epsa-team/Vulcanix-v1.0/SU - Suspension/SU_A1100 (Rear Upright Assy)/Photos/Montage 2.JPG

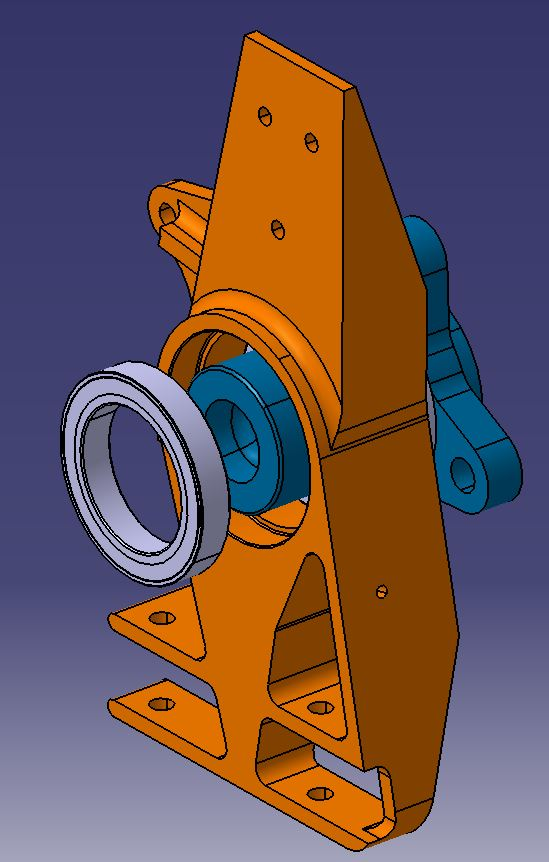
SU - Suspension/SU_A1100 (Rear Upright Assy)/Photos/Montage 2.JPG
