epsa-team/Vulcanix-v1.0/BR - Brake System/readme.txt

Déposez ici vos pièces.
Respectez la nomenclature !!!!!
