epsa-team/Vulcanix-v1.0/ZZ - Autres/Design event - Dossier Monoh/Support documents/Differential support.docx

DIFFERENTIAL

# Drive ratio

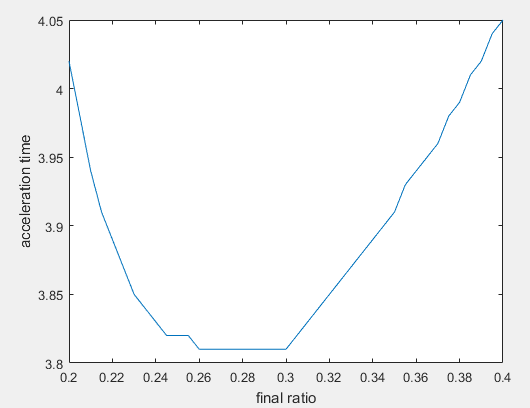
[picture p41: figure]

Figure 1: Acceleration model used to determine the optimum drive ratio

Optimum dive ratio: 0.2955 → Pinion: 13; Cog-Wheel: 44

# Dimensioning

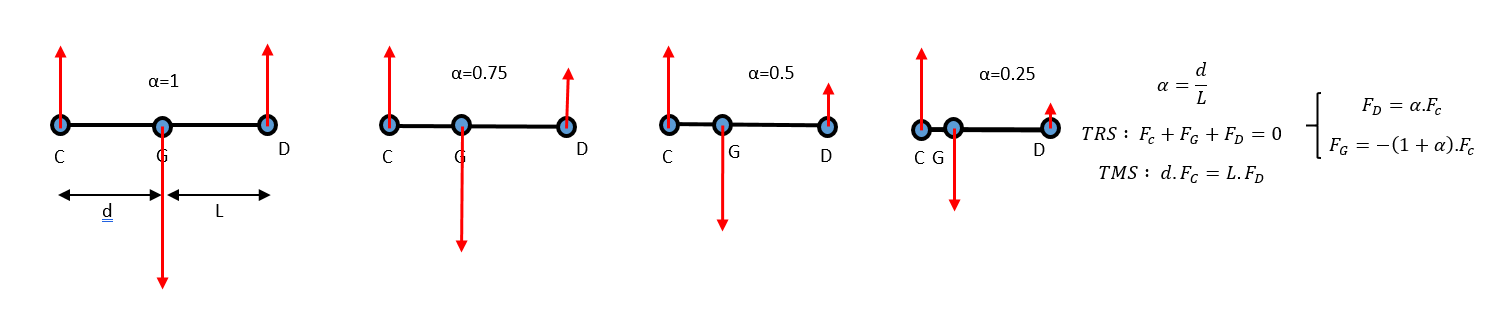
[picture p42: figure]

Figure 2: Influence of the position of the elements of the differential assembly

Load cases :

- Maximum torque load obtained through engine data: 59N.m, 28 000N on the gear.
- Car lift by the push bar

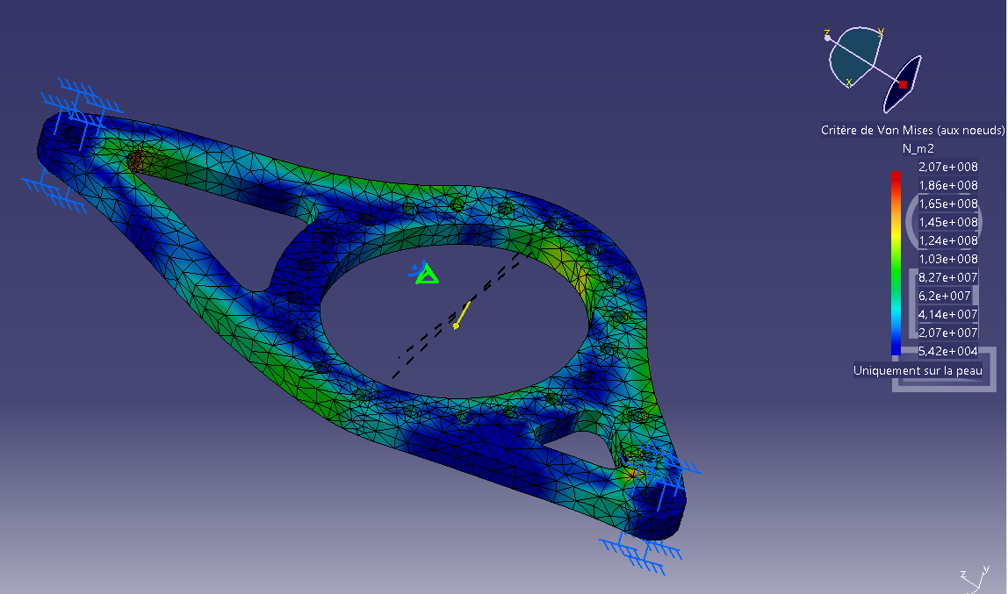
[picture p43: figure]

Figure 3: FEA on left eccentric housing

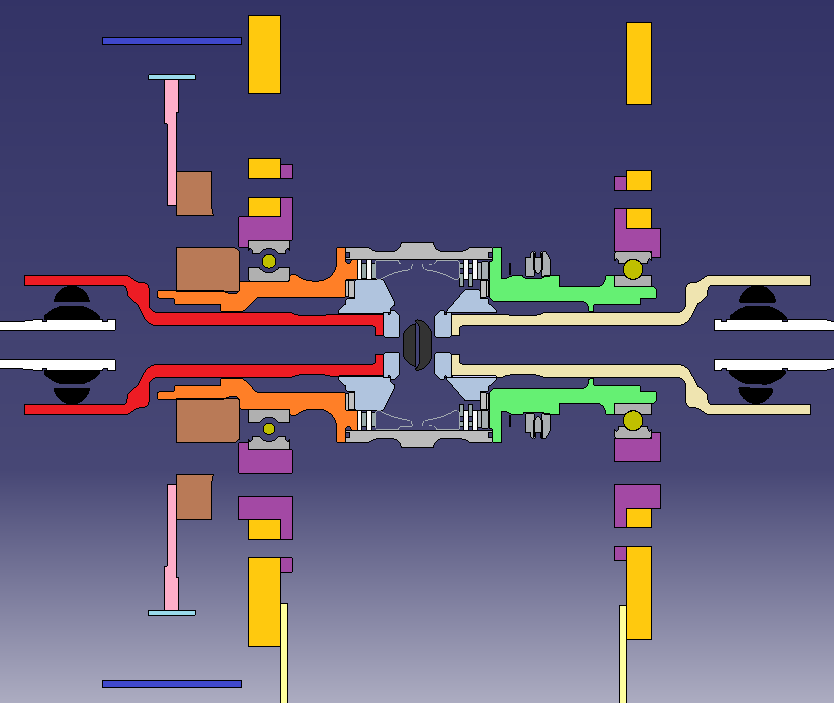
[picture p44: figure]

Figure 4: Section of the differential mounting

# Configurations

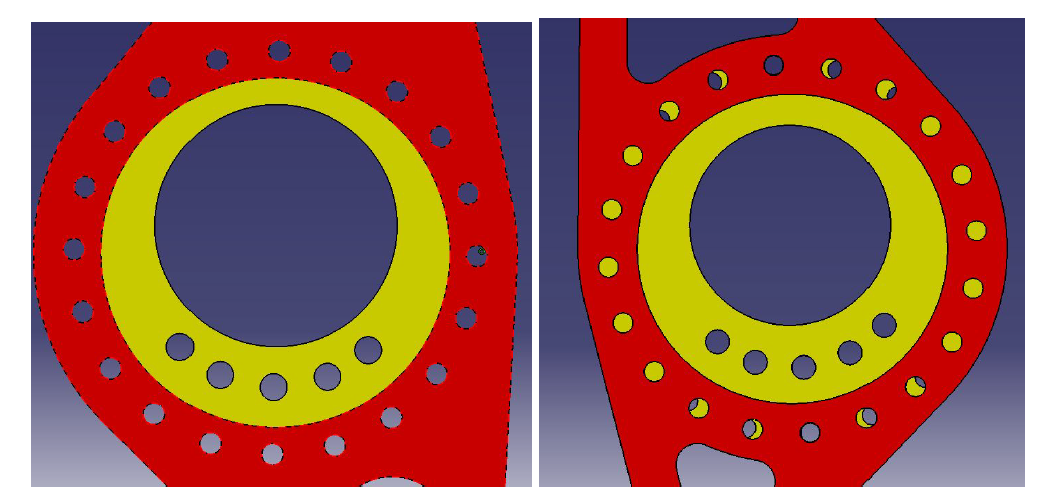
[picture p45: figure]

Figure 1: View of the eccentric in its housing

- This geometry offers 180 configurations

# Appendix

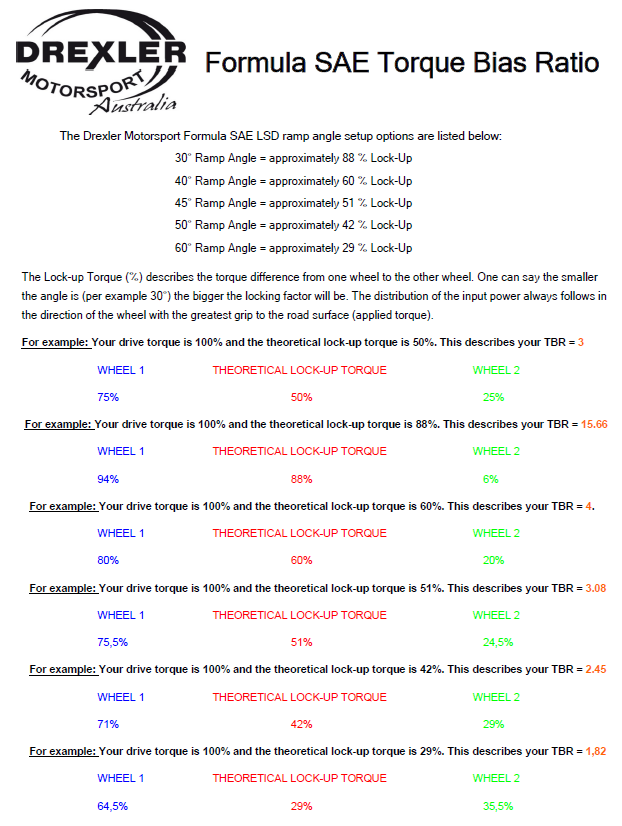
[picture p46: figure]
