epsa-team/Vulcanix-v1.0/ZZ - Autres/Design event - Dossier Monoh/Support documents/Wheel design Support.docx

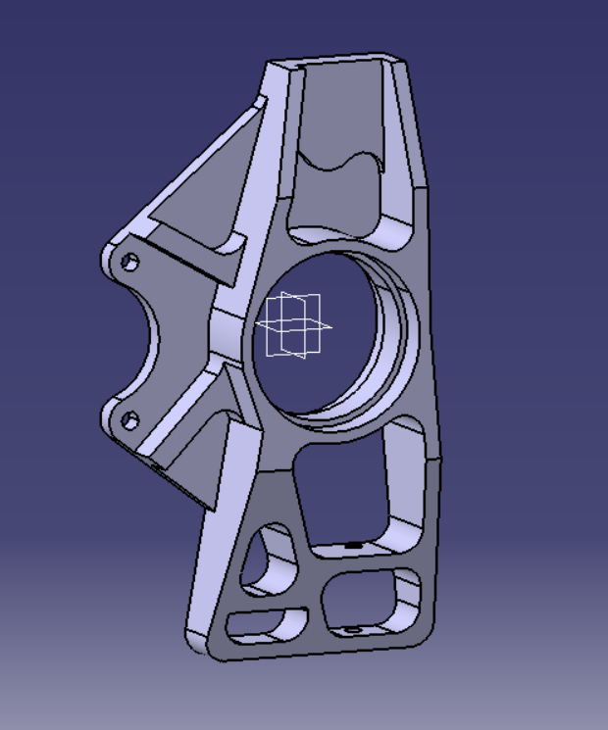
[picture p62: figure]

WHEEL DESIGN

Figure 1: Early design of the wheel assembly

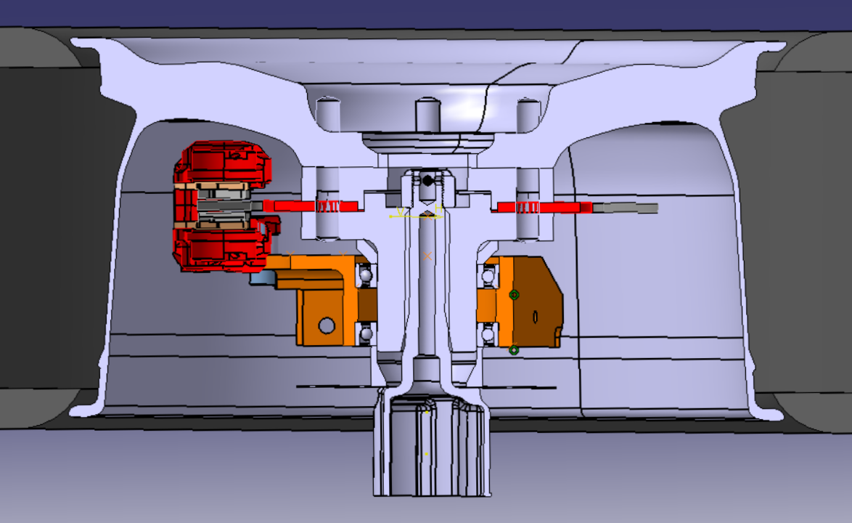
[picture p63: figure]
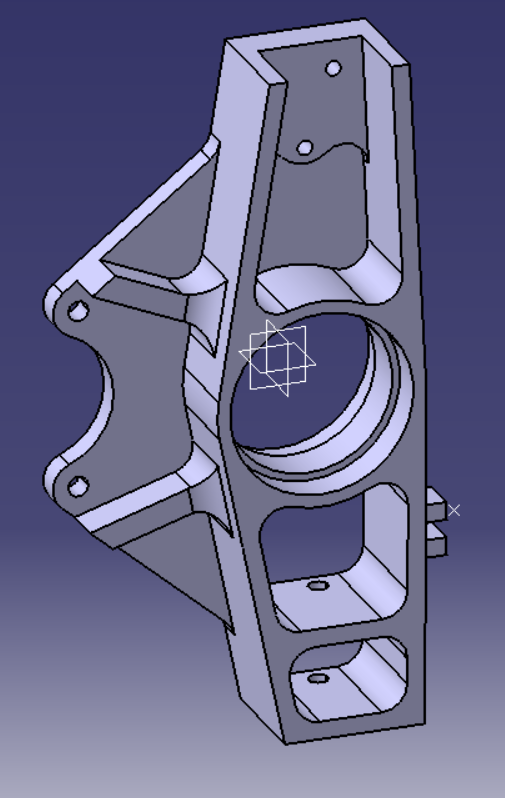
[picture p64: figure]
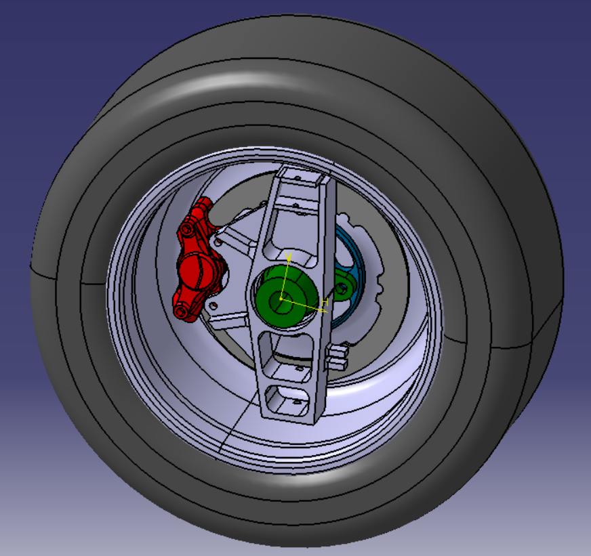
[picture p65: figure]
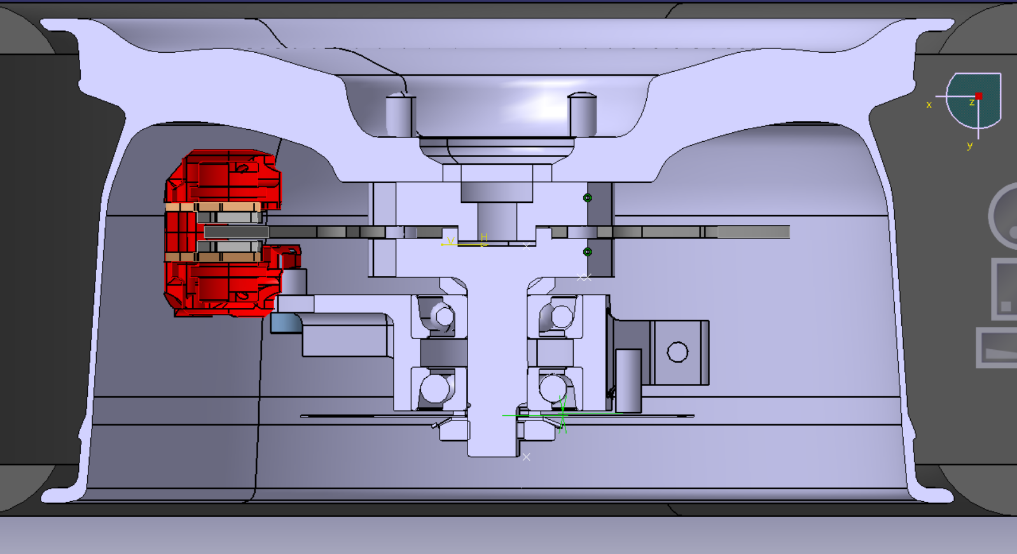
[picture p66: figure]
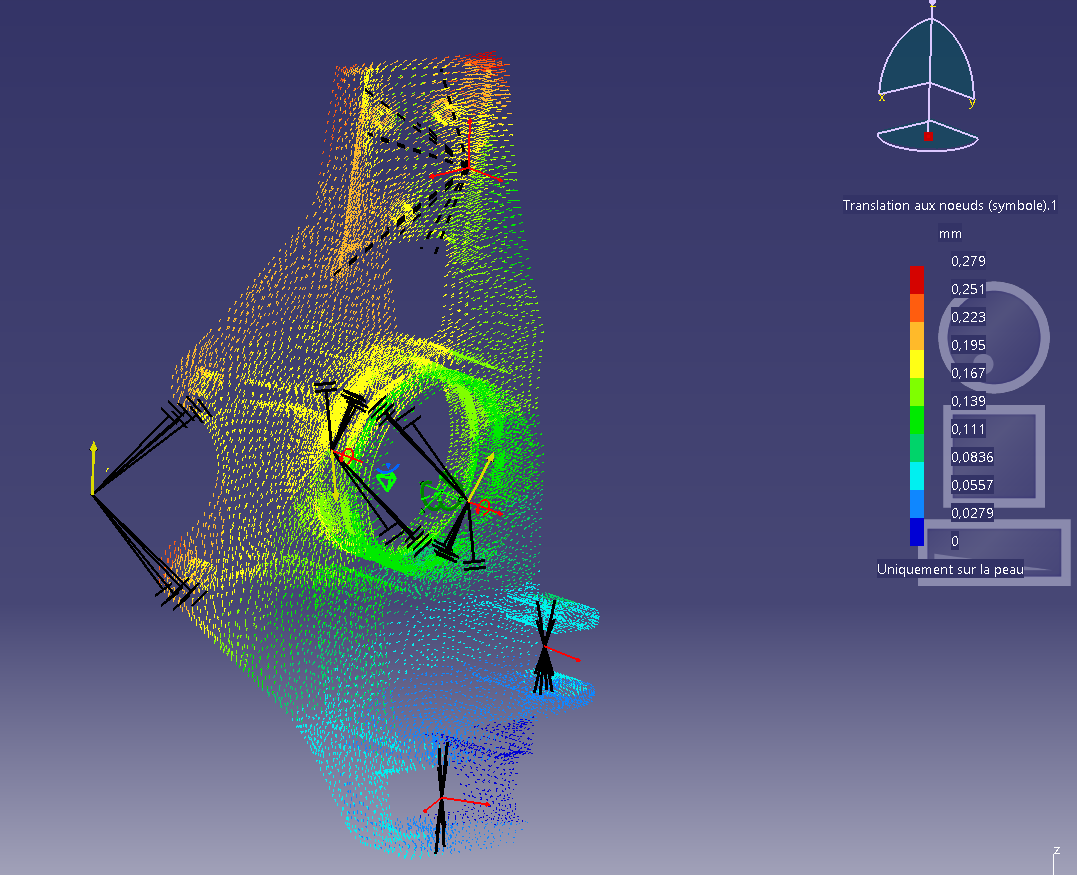
[picture p67: figure]

Figure 3: FEA analysis of front upright – 2G braking

Figure 2: Rear and front wheel section
