epsa-team/Vulcanix-v1.0/ZZ - Autres/Design event - Dossier Monoh/Support documents/Non font work/design-tires.docx

Tire study

1) Gui interface

The data from the TTC (tire test consortium) are studied thanks to a GUI interface:


2) Data treatment with 94” Pacejka formula

This offers more smooth datas, easier to use:
