epsa-team/Vulcanix-v1.0/ZZ - Autres/Design event - Dossier Monoh/Support documents/Non font work/transmission-secondaire-1.docx

Drexler limited slip differential

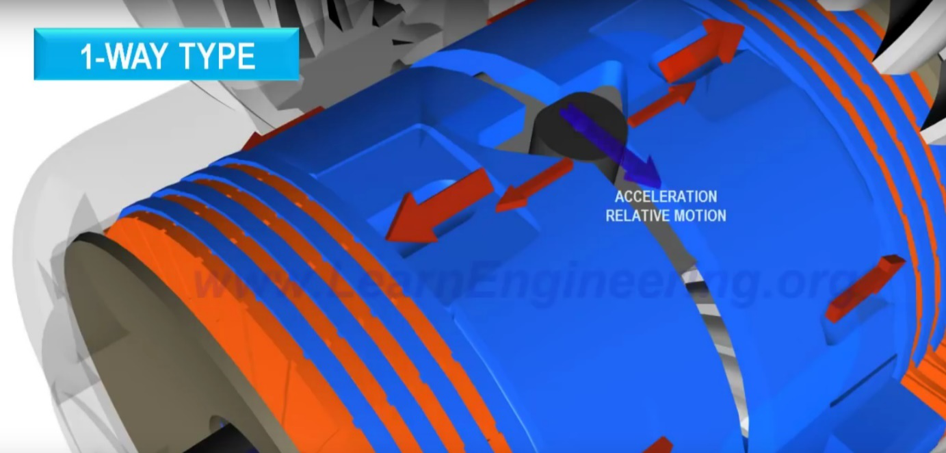
[picture p82: figure]

Efforts on Eccentric carriers

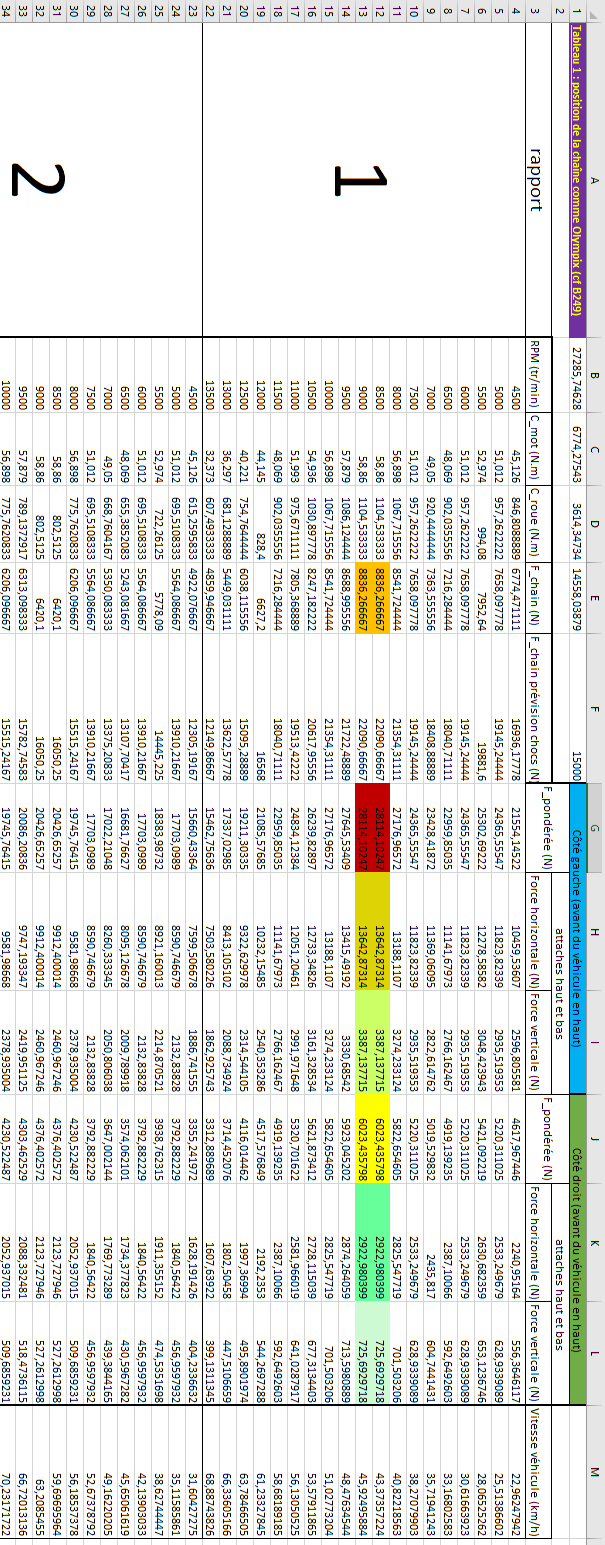
[picture p83: figure]
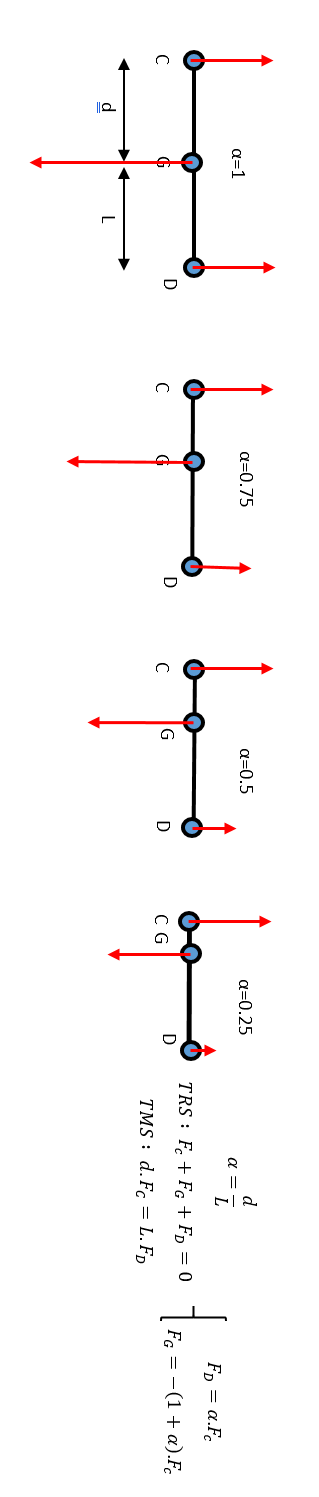
[picture p84: figure]

Finite Elements on left eccentric

Material : aluminium 2017 T4

Re = 260 MPa


Thickness : 14mm

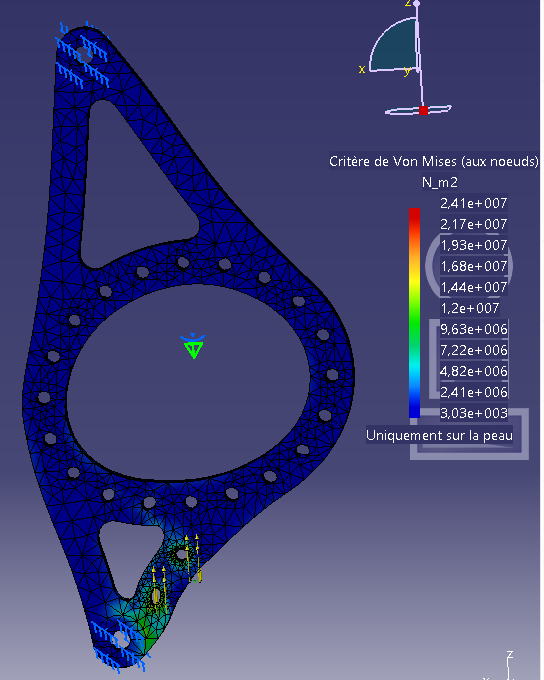
[picture p85: figure]

Carrying the car

Finite Elements on right eccentric

Material : aluminium 2017 T4

Re = 260 MPa

Thickness : 11mm

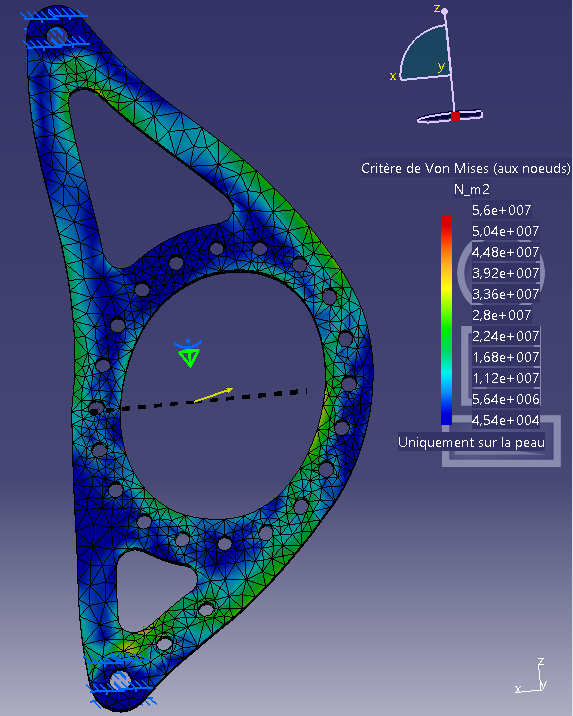
[picture p86: figure]
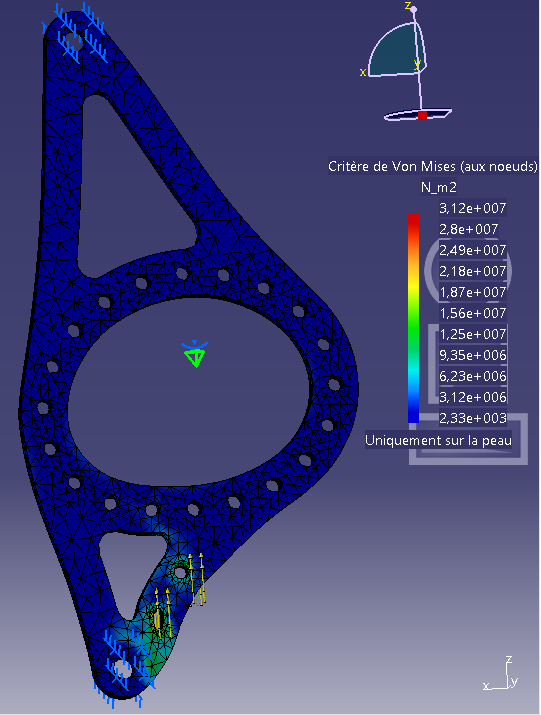
[picture p87: figure]

Carrying the car

Chain tension


Basic configuration Vulcanix configuration

N=(18*20)/(pgcd(18,20))=180

Pgcd (fr) = hcf (eng)

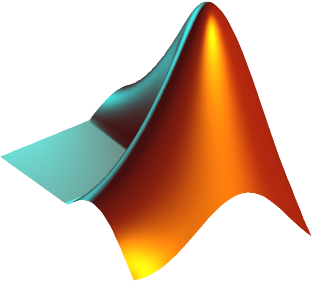
[picture p88: figure]
Résultat de recherche d'images pour "matlab logo"

Final Ratio


0.2955

FR = 13x44 → 0.2955

Axle shafts (length calculation)

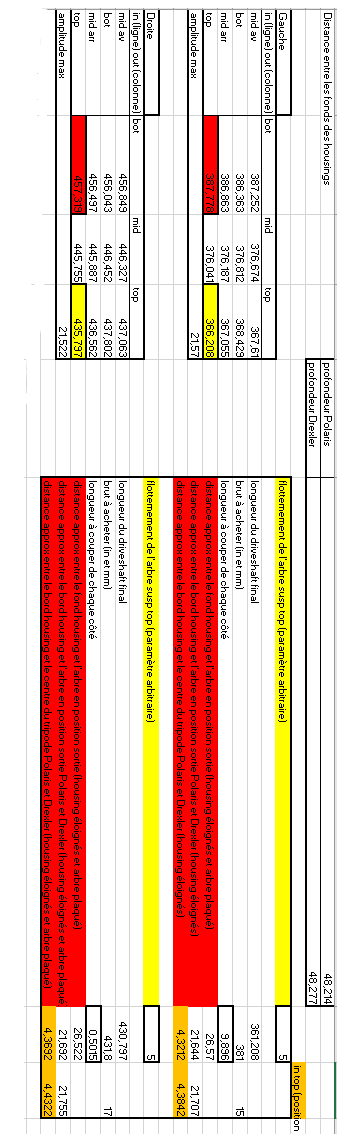
[picture p89: figure]

Axle shafts

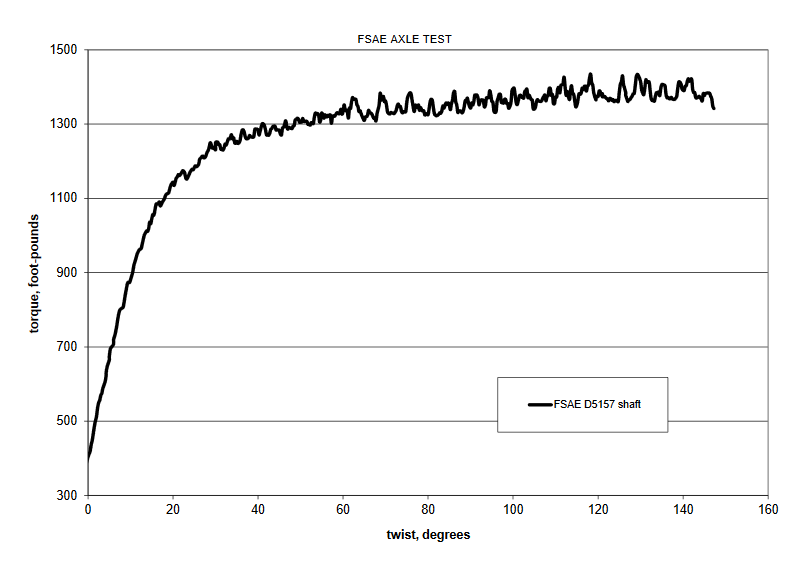
[picture p90: figure]

15in (left)

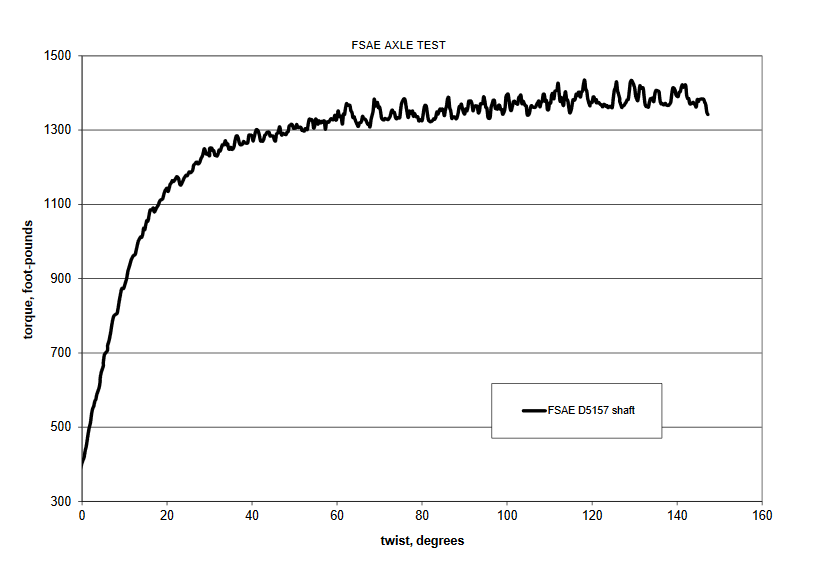
[picture p91: figure]

17in (right)

Left ball bearing (6011-2RS1)

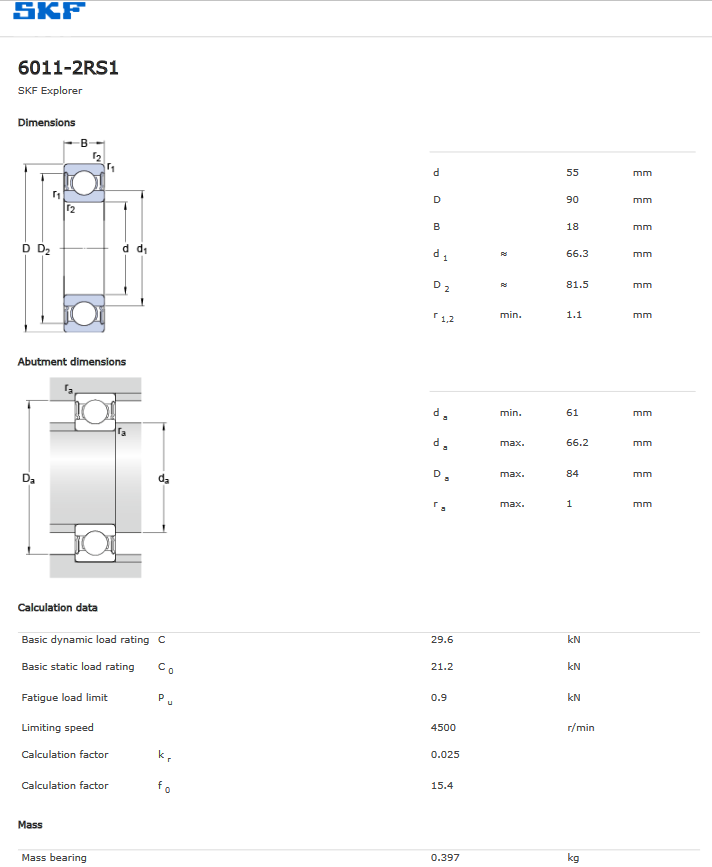
[picture p92: figure]

Right ball bearing (6010-2RS1)

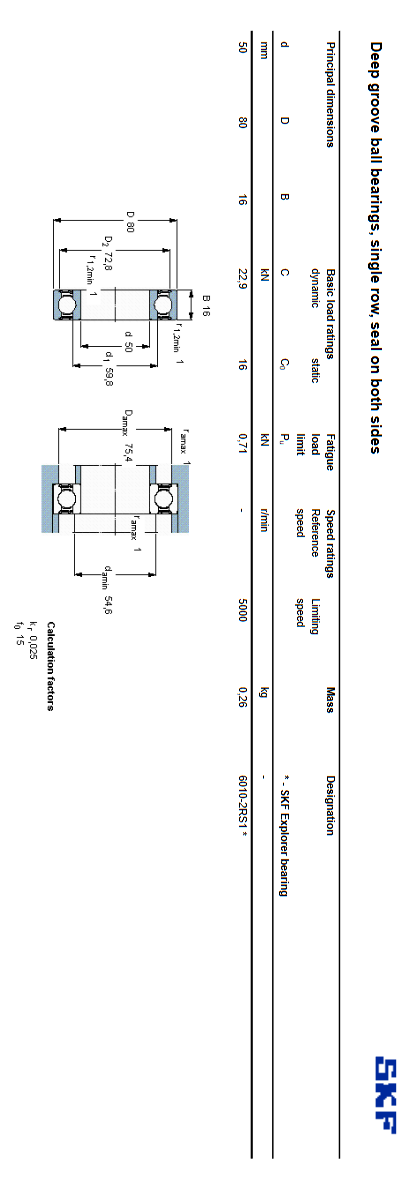
[picture p93: figure]

Sectional view
