epsa-team/Vulcanix-v1.0/ZZ - Autres/Design event - Dossier Monoh/Support documents/Differential support.pdf

## DIFFERENTIAL

## Drive ratio

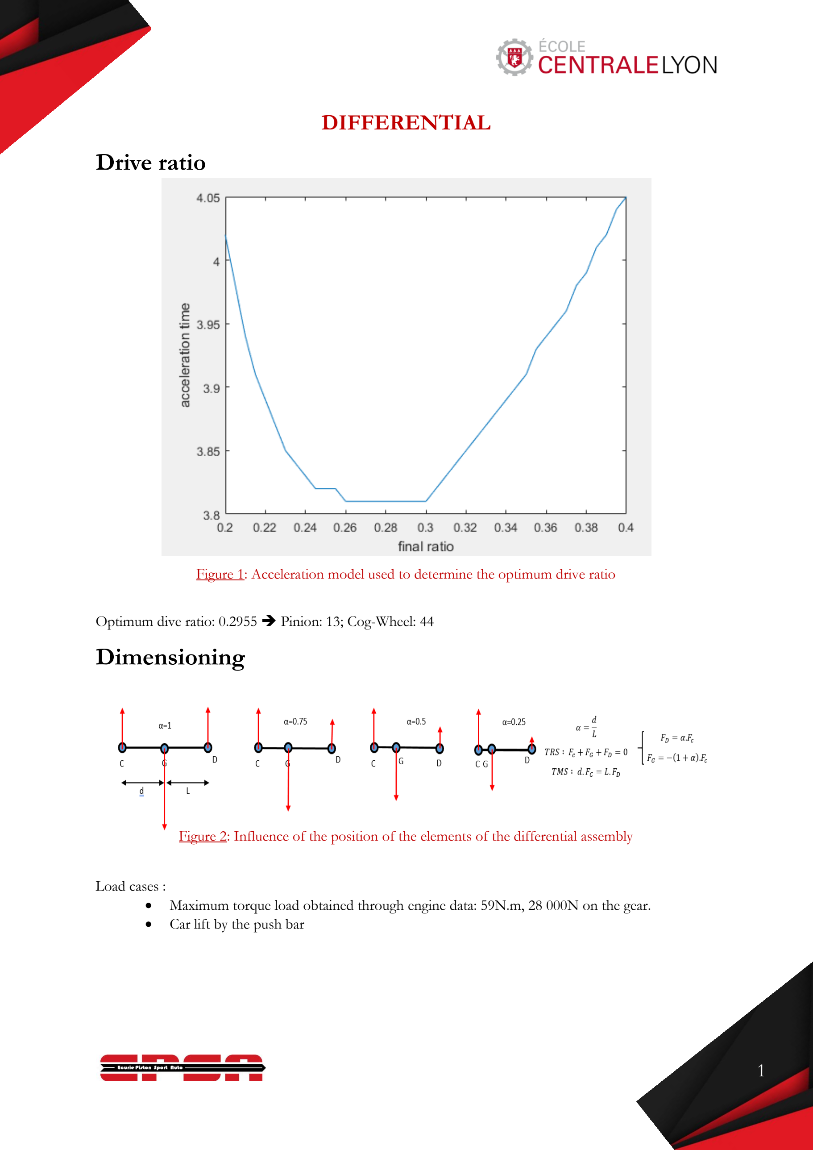
[picture p104: page 1]

Optimum dive ratio: 0.2955 ➔ Pinion: 13; Cog-Wheel: 44

## Dimensioning

Load cases :
- Maximum torque load obtained through engine data: 59N.m, 28 000N on the gear.
- Car lift by the push bar

Figure 2: Influence of the position of the elements of the differential assembly

Figure 1: Acceleration model used to determine the optimum drive ratio

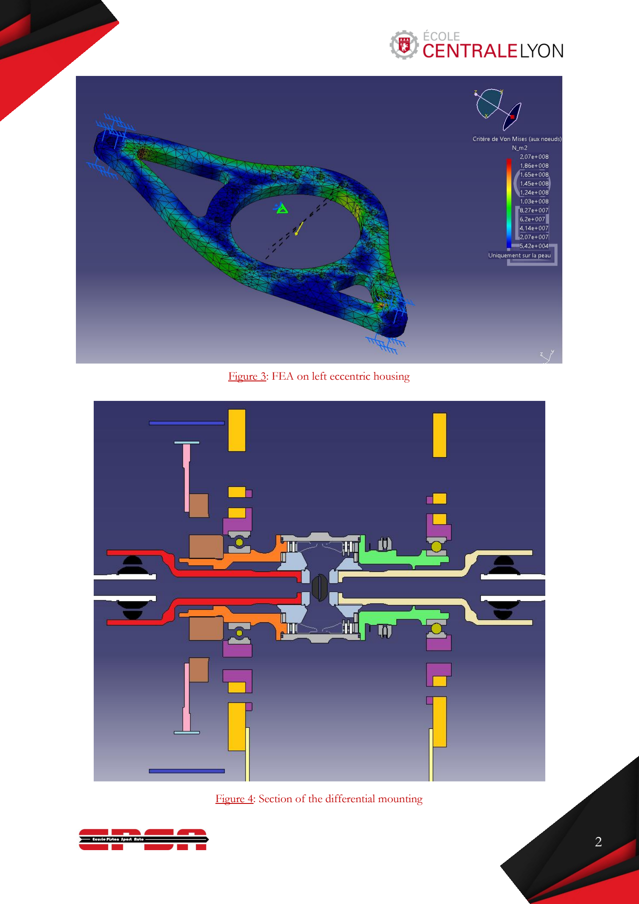
[picture p105: page 2]

Figure 3: FEA on left eccentric housing

Figure 4: Section of the differential mounting

## Configurations

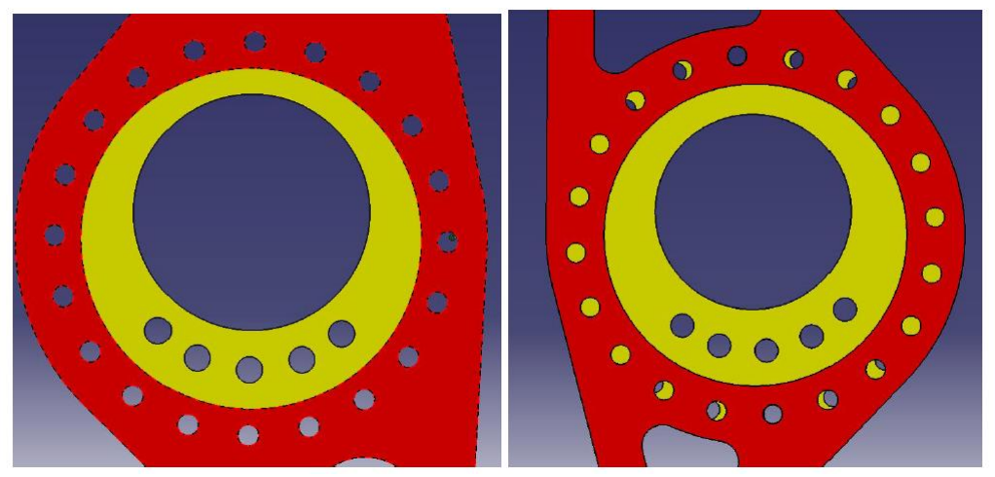
[picture p106: figure]

- This geometry offers 180 configurations

Figure 1: View of the eccentric in its housing

## Appendix

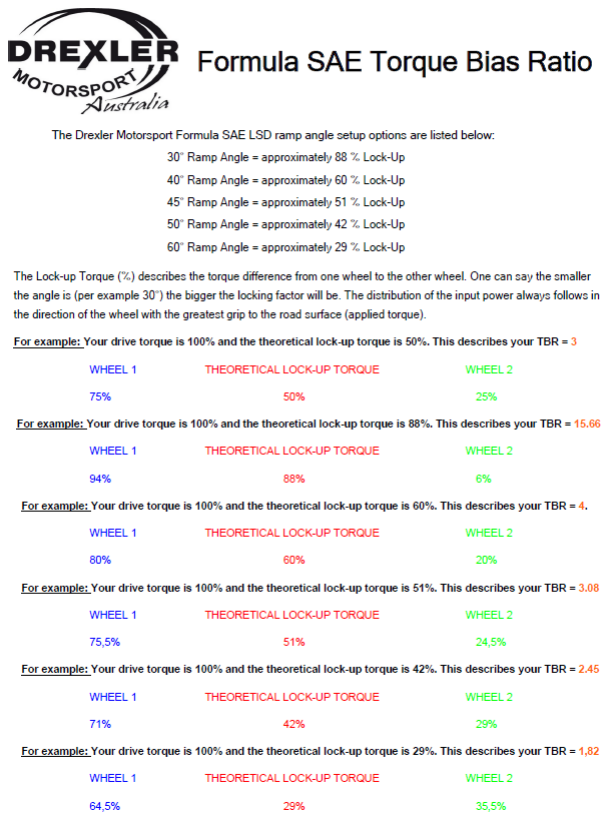
[picture p107: figure]
