epsa-team/Vulcanix-v1.0/ZZ - Autres/Design event - Dossier Monoh/Support documents/Wheel design Support.pdf

## WHEEL DESIGN

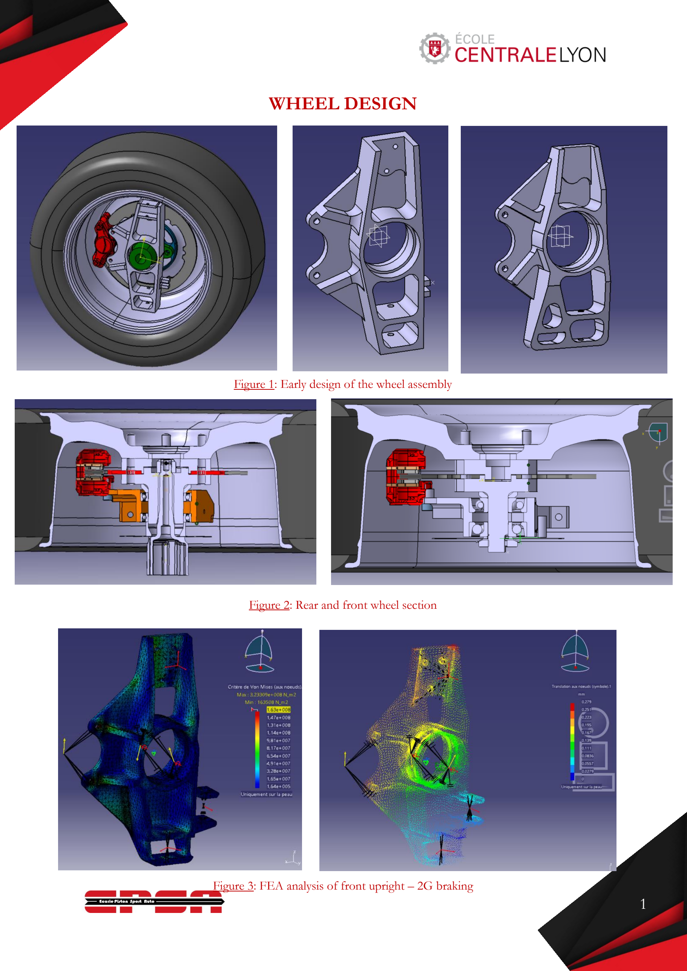
[picture p125: page 1]

1

Figure 1: Early design of the wheel assembly

Figure 2: Rear and front wheel section

Figure 3: FEA analysis of front upright – 2G braking
