epsa-team/Vulcanix-v1.0/ZZ - Autres/Design event - Dossier Monoh/mass repartition.xlsx

Sheet: GLOBAL
BUDGET MASSIQUE GLOBAL
S1 LASMECA | 57.7 | 58
S2 MOTORISATION INSTRUMENTEE | 89 | 89.955
S3 CHASSIS EQUIPEE ET PACK AERO | 53 | 56.765
S4 SEISM | 11.5 | 12
AUTRE | 9 | 15
MASSE TOTALE (kg) | 220.2 | 231.72

Sheet: LASMECA
BUDGET MASSIQUE S1: LASMECA
Amortisseurs | 4 | 4
Barre anti roulis | 2.5
Triangles | 6 | 3
Système de freinage | 4 | 4
Roue équipée | 9 | 10
Pneus | 19.4 | 19.4
Jantes | 9.8 | 13.6
Direction | 3 | 4
MASSE TOTALE (kg) | 57.7 | 58

Sheet: CHASSIS EQUIPE ET AERO
BUDGET MASSIQUE S3: CHASSIS EQUIPE ET PACK AERO
Châssis tubulaire | 35 | 41
Equipements | 5
Paroi pare feu | 3 | 4.765
Fond plat | 3 | 3.5
Plaque anti intrusion | 1 | 1.5
Carrosserie | 6 | 6
MASSE TOTALE (kg) | 53 | 56.765

Sheet: MOTORISATION INSTRUMENTEE
BUDGET MASSIQUE S2: MOTORISATION INSTRUMENTEE
Admission | 3 | 3
Echappement | 5 | 5.955
Moteur | 60 | 60
Système de lubrification | 3 | 3
Circuit de carburant | 3 | 3
Refroidissement | 6 | 6
Différentiel | 2 | 2
Arbres de transmission | 2 | 2
Autres éléments de transmission secondaire | 5 | 5
MASSE TOTALE (kg) | 89 | 89.955
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
