epsa-team/Vulcanix-v1.0/ZZ - Autres/Design event - Dossier Monoh/Support documents/Suspension geometry support.docx

SUSPENSION GEOMETRY

# Model

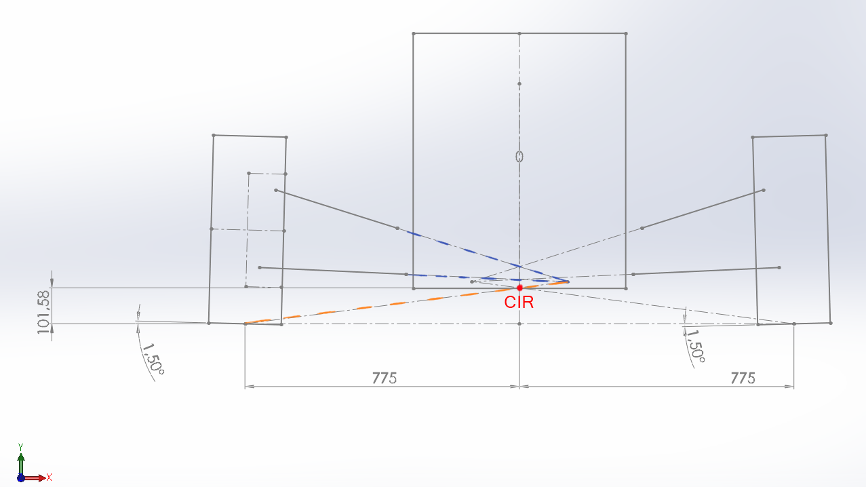
[picture p126: figure]

Figure 1: 2D model for A-Arms geometry early design

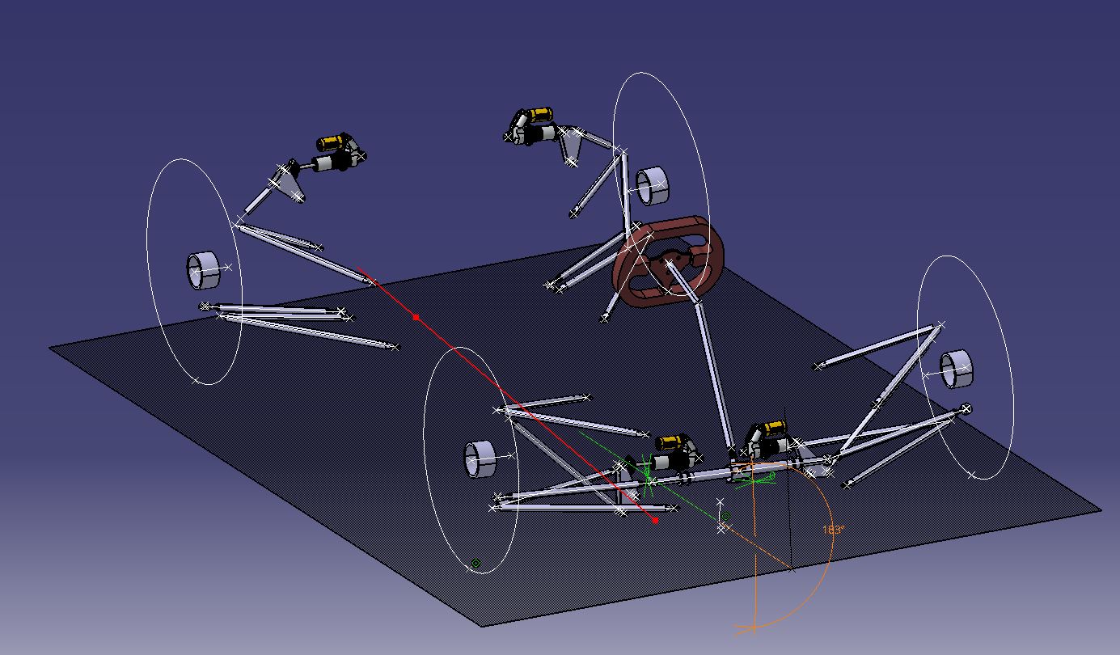
[picture p127: figure]

Figure 2: 3D model for suspension design

# Results

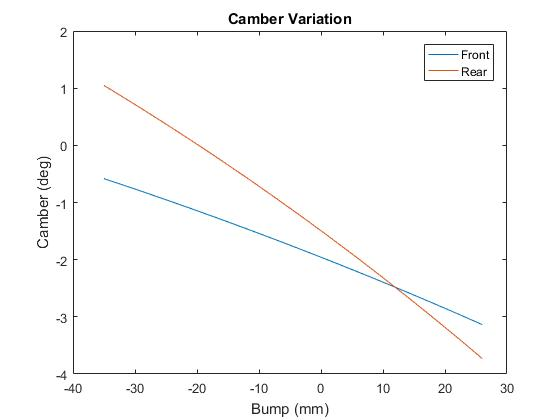
[picture p128: figure]
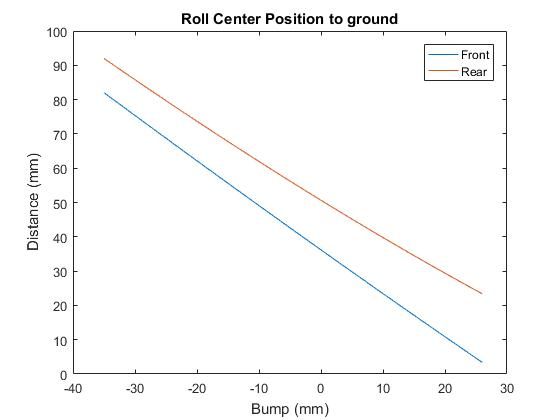
[picture p129: figure]
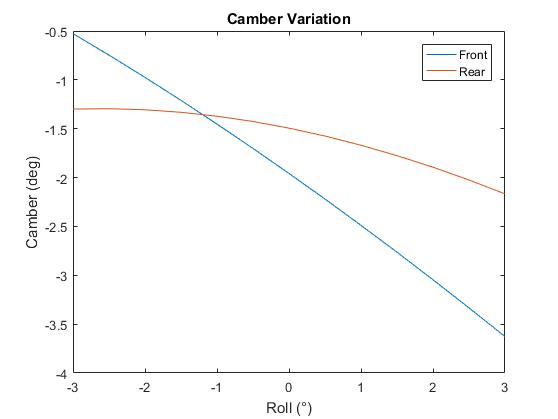
[picture p130: figure]
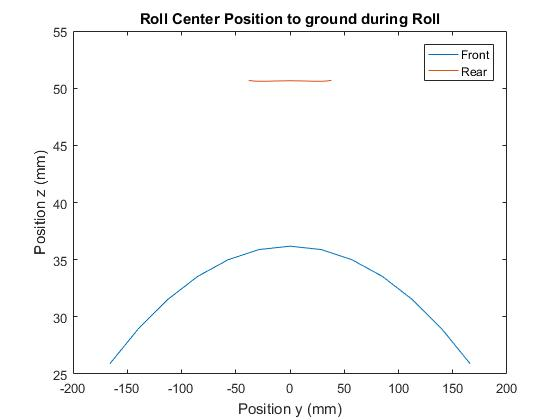
[picture p131: figure]
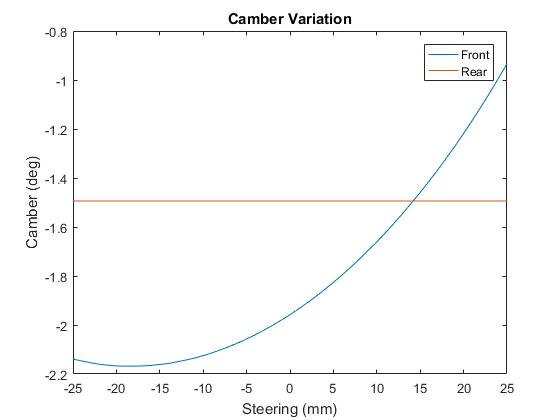
[picture p132: figure]
