epsa-team/Vulcanix-v1.0/BB - Essais/Fiches d'essai/fiche_départ_essai.pptx

Carrossage : …… mm

Raideur : …… lbs/in

Comp | BV
| HV
Rebond | BV
| HV

Comp | BV
| HV
Rebond | BV
| HV

Raideur : …… lbs/in

Carrossage : …… mm

…… cm

…… cm

…… cm

…… cm

Pression : ……. bar

Pression : ……. bar

Pression : ……. bar

Pression : ……. bar

…… cm

…… cm

…… cm

…… cm

Carrossage : …… mm

Carrossage : …… mm
