epsa-team/Vulcanix-v1.0/ZZ - Autres/Design event - Dossier Monoh/Support documents/Suspension geometry support.pdf

## SUSPENSION GEOMETRY

## Model

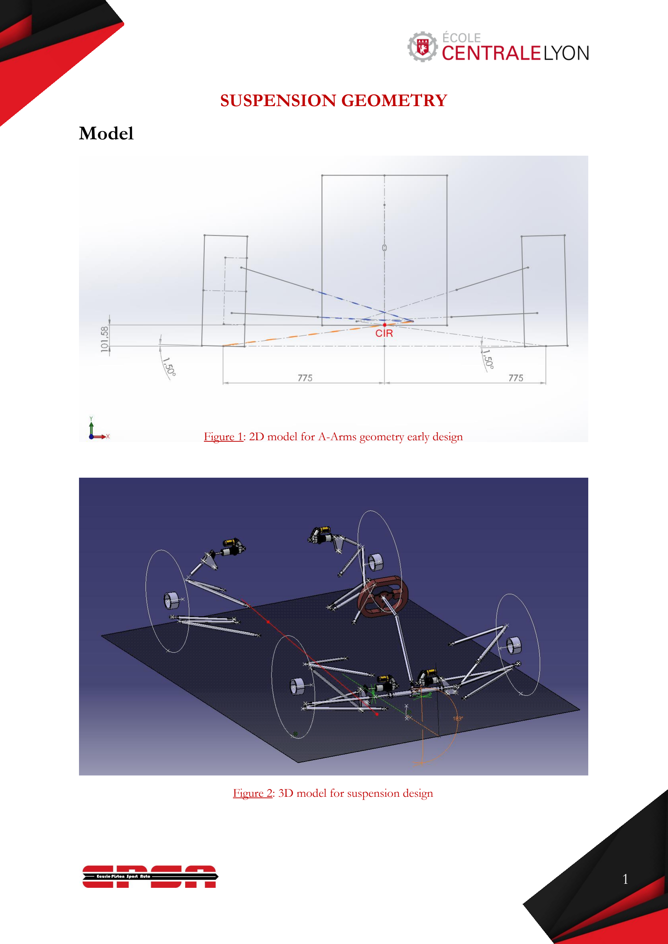
[picture p140: page 1]

Figure 1: 2D model for A-Arms geometry early design

Figure 2: 3D model for suspension design

## Results

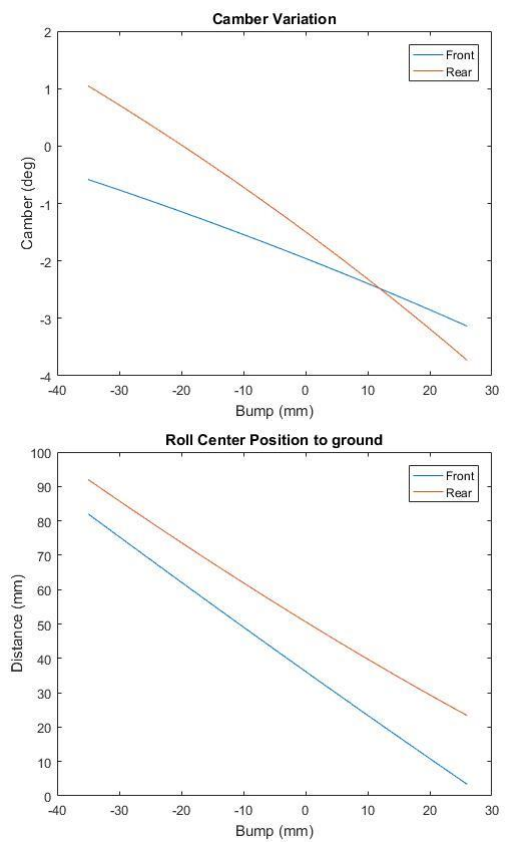
[picture p141: figure]

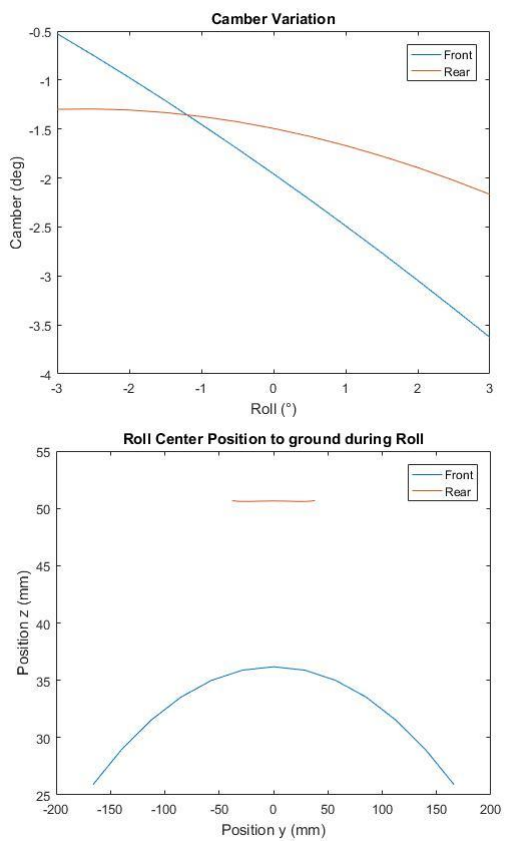
[picture p142: figure]

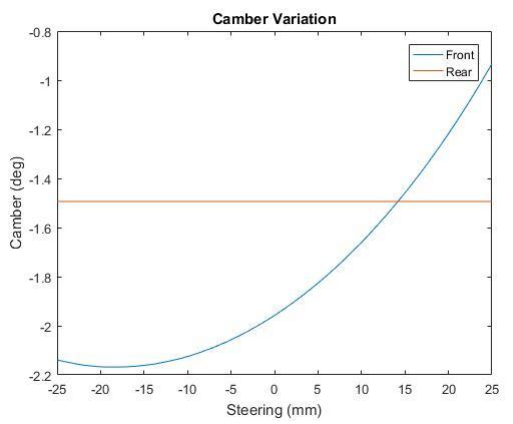
[picture p143: figure]
