epsa-team/Vulcanix-v1.0/EL - Electrical/connecteurs/Connecteur_8pins_boite_avant.png

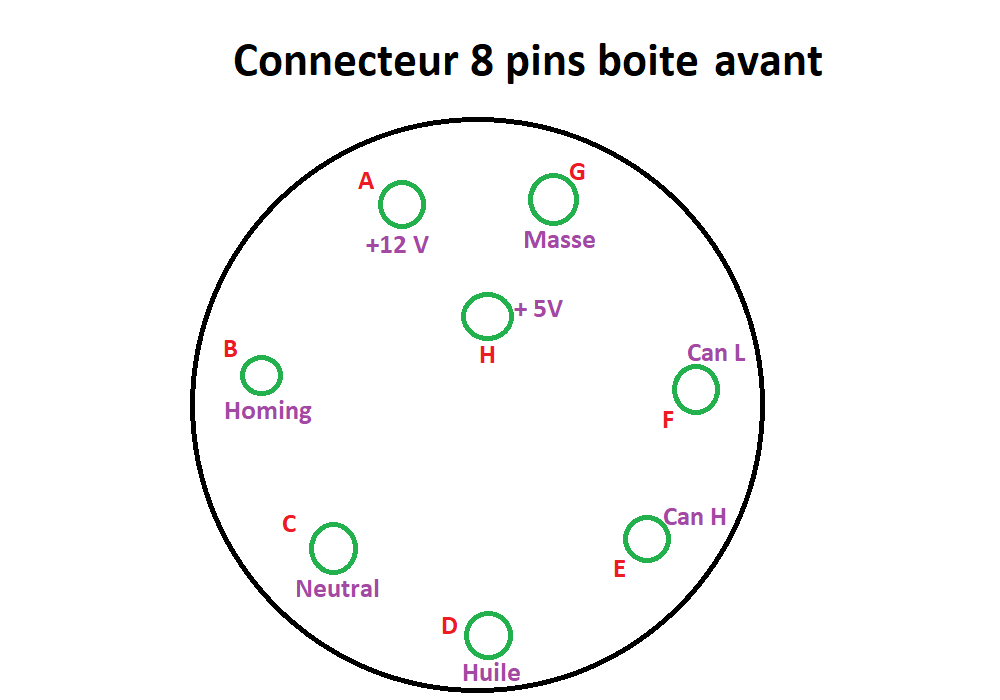
EL - Electrical/connecteurs/Connecteur_8pins_boite_avant.png
