epsa-team/Vulcanix-v1.0/EN - Engine & Powertrain/Carter d'huile/reference_photo/rsz_img_0775.jpg

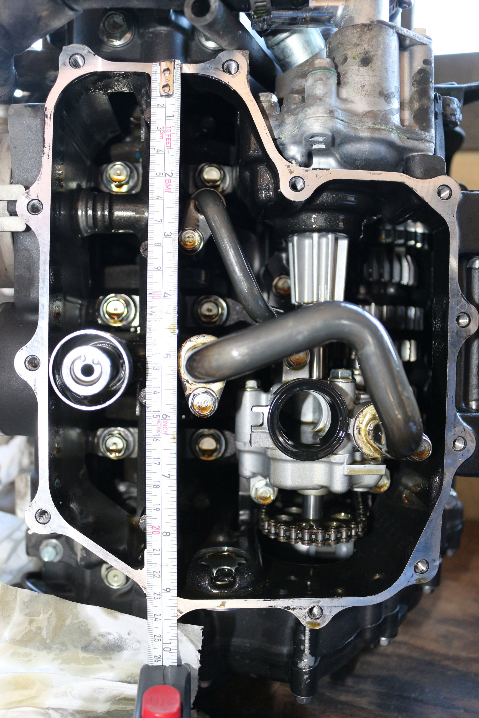
EN - Engine & Powertrain/Carter d'huile/reference_photo/rsz_img_0775.jpg
