epsa-team/Vulcanix-v1.0/EN - Engine & Powertrain/EN_A0900 (Differential Assy)/image porte excentrique droit.png

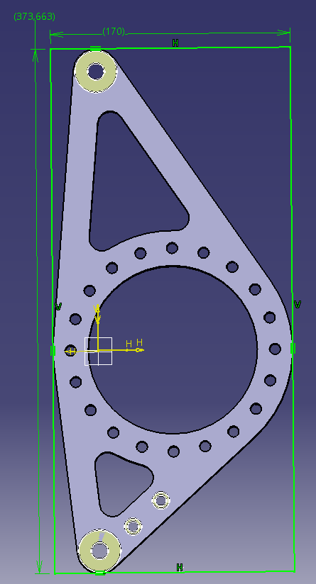
EN - Engine & Powertrain/EN_A0900 (Differential Assy)/image porte excentrique droit.png
