epsa-team/Vulcanix-v1.0/EN - Engine & Powertrain/EN_A0900 (Differential Assy)/image porte excentrique gauche.png

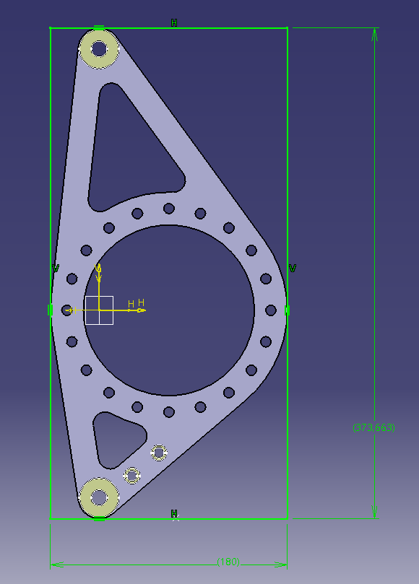
EN - Engine & Powertrain/EN_A0900 (Differential Assy)/image porte excentrique gauche.png
