epsa-team/Vulcanix-v1.0/FR - Frame & Body/FR_A0300 (Pedal Assy)/Images/Position pied bout de course.PNG

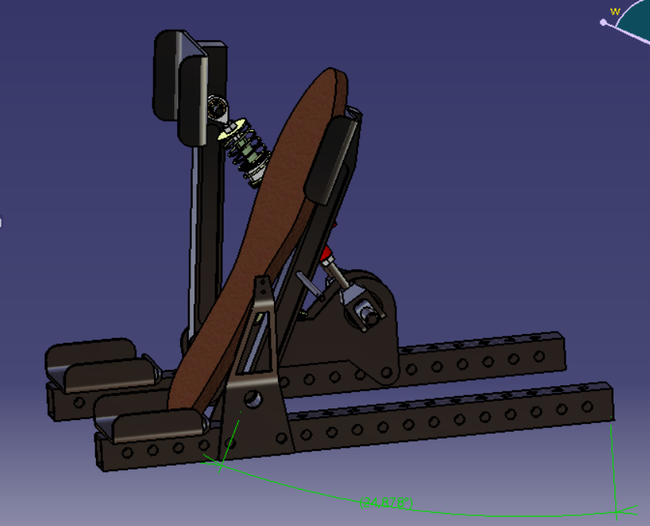
FR - Frame & Body/FR_A0300 (Pedal Assy)/Images/Position pied bout de course.PNG
