epsa-team/Vulcanix-v1.0/FR - Frame & Body/FR_A0300 (Pedal Assy)/Images/Position pied.PNG

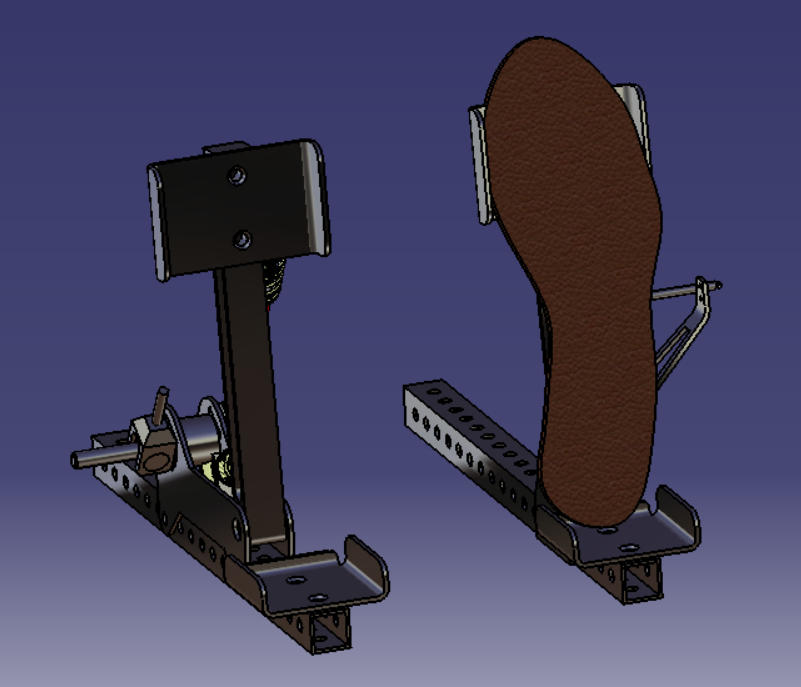
FR - Frame & Body/FR_A0300 (Pedal Assy)/Images/Position pied.PNG
