epsa-team/Vulcanix-v1.0/FR - Frame & Body/FR_A0700 (Body)/Autocollants/81.png

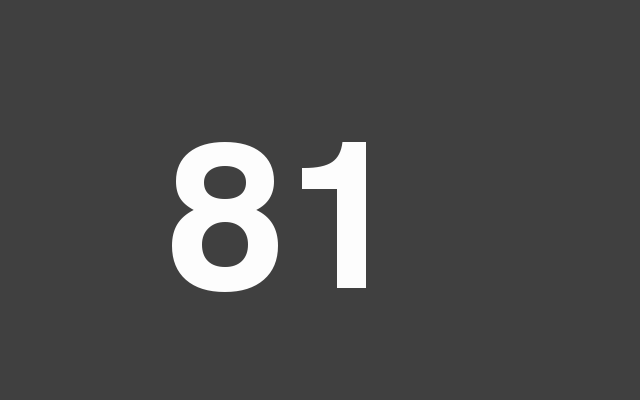
FR - Frame & Body/FR_A0700 (Body)/Autocollants/81.png
