epsa-team/Vulcanix-v1.0/FR - Frame & Body/FR_A0700 (Body)/Autocollants/ECL.png

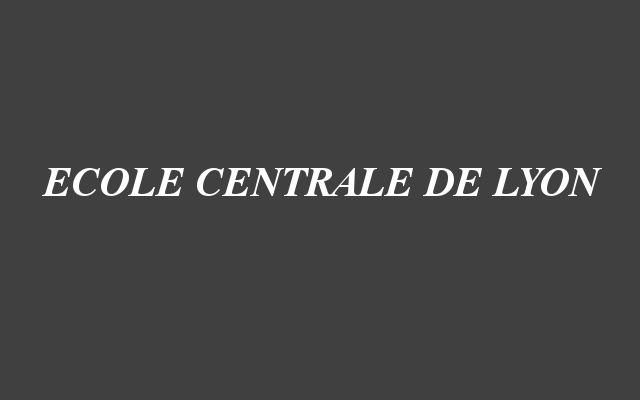
FR - Frame & Body/FR_A0700 (Body)/Autocollants/ECL.png
