epsa-team/Vulcanix-v1.0/FR - Frame & Body/FR_A0700 (Body)/Autocollants/vulcanix.png

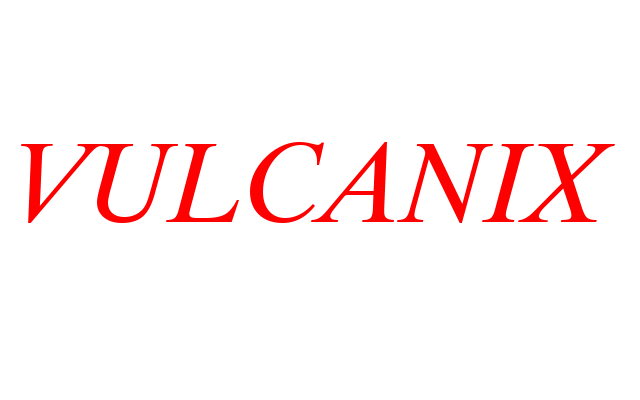
FR - Frame & Body/FR_A0700 (Body)/Autocollants/vulcanix.png
