epsa-team/Vulcanix-v1.0/SU - Suspension/entretoise/entretoise_8x6.jpg

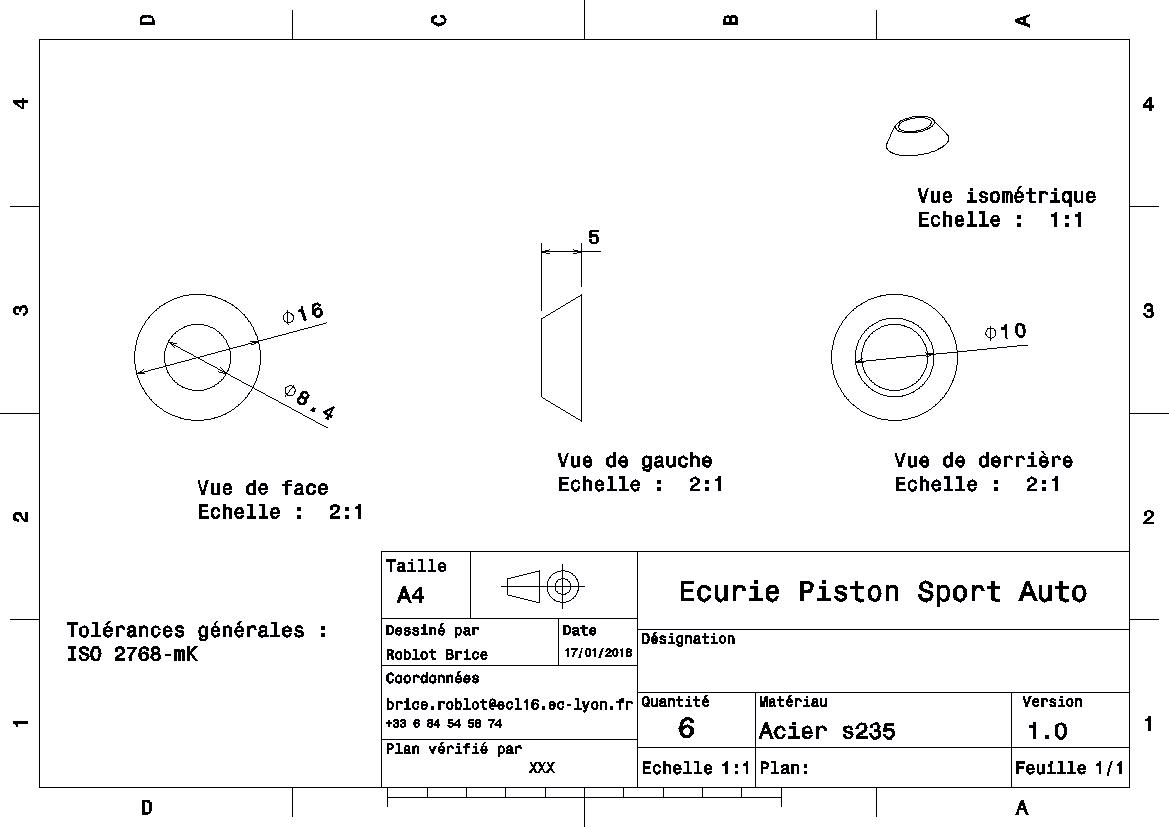
SU - Suspension/entretoise/entretoise_8x6.jpg
