epsa-team/Vulcanix-v1.0/SU - Suspension/SU_A1000 (Front Upright Assy)/FEA/Capture d’écran (78).png

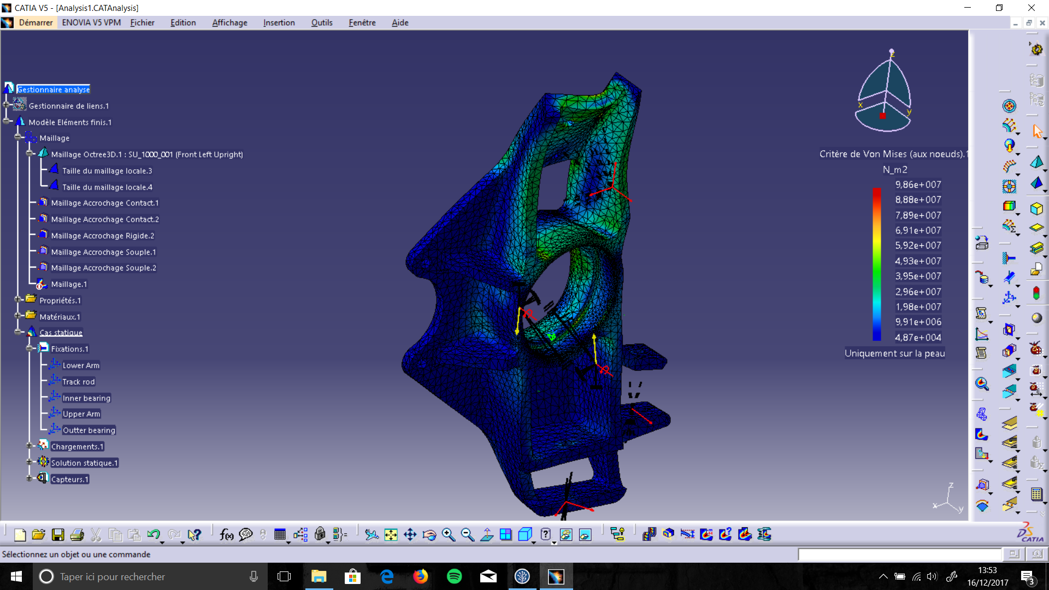
SU - Suspension/SU_A1000 (Front Upright Assy)/FEA/Capture d’écran (78).png
