epsa-team/Vulcanix-v1.0/SU - Suspension/SU_A1000 (Front Upright Assy)/FEA/Freinage 1G+Virage 1G.png

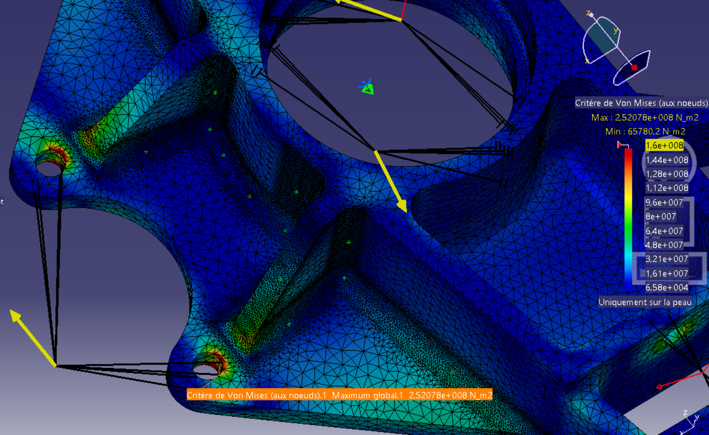
SU - Suspension/SU_A1000 (Front Upright Assy)/FEA/Freinage 1G+Virage 1G.png
