epsa-team/Vulcanix-v1.0/SU - Suspension/SU_A1000 (Front Upright Assy)/FEA/Freinage 2G (2).png

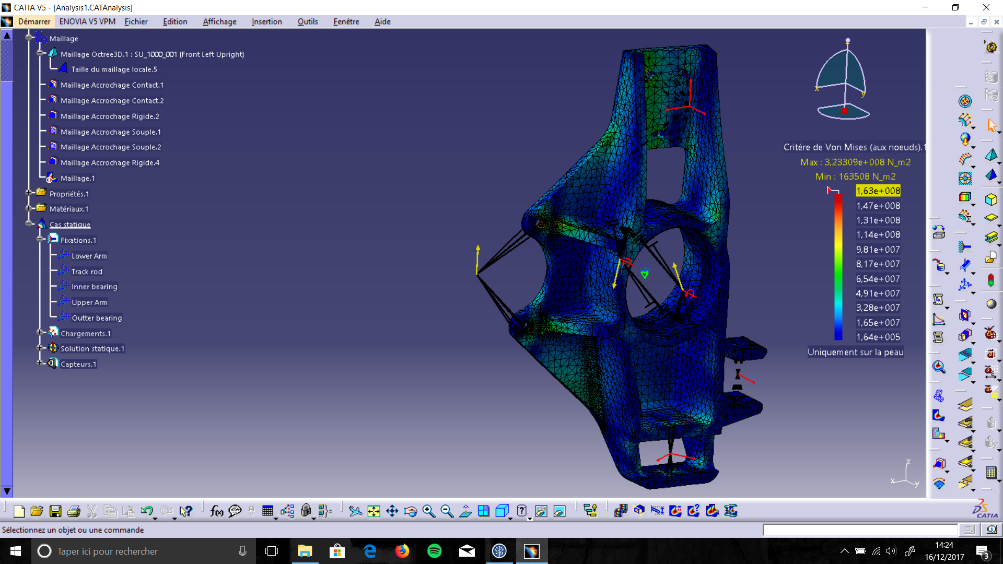
SU - Suspension/SU_A1000 (Front Upright Assy)/FEA/Freinage 2G (2).png
