epsa-team/Vulcanix-v1.0/SU - Suspension/SU_A1000 (Front Upright Assy)/FEA/Virage 2G affiné.png

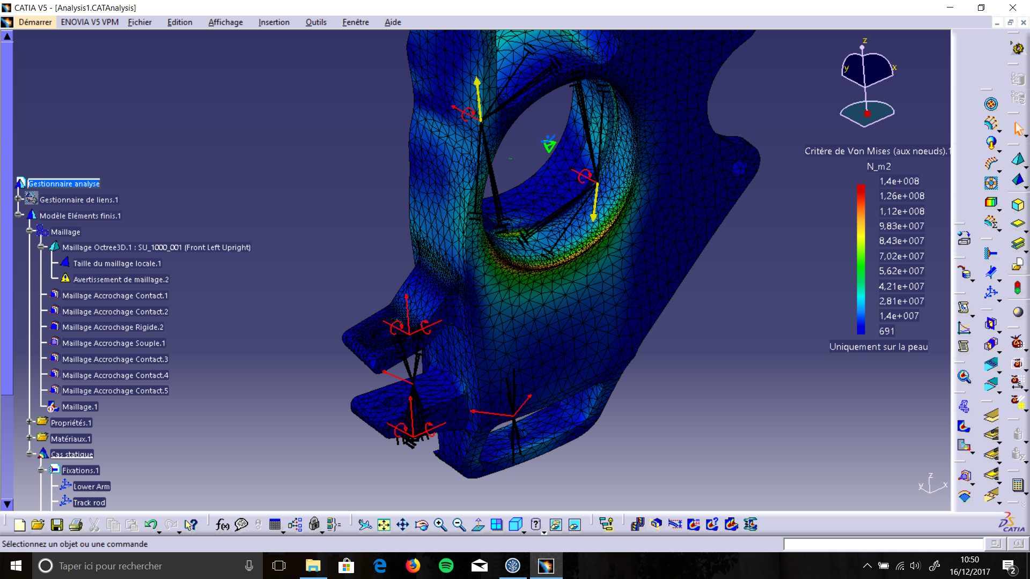
SU - Suspension/SU_A1000 (Front Upright Assy)/FEA/Virage 2G affiné.png
