epsa-team/Vulcanix-v1.0/SU - Suspension/SU_A1000 (Front Upright Assy)/FEA/Virage 2G.png

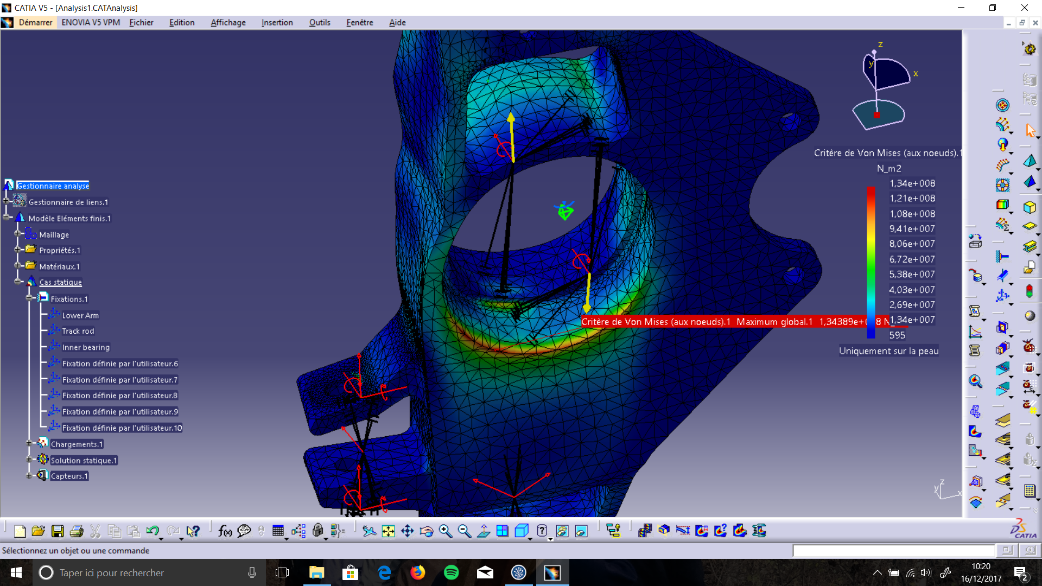
SU - Suspension/SU_A1000 (Front Upright Assy)/FEA/Virage 2G.png
