epsa-team/Vulcanix-v1.0/SU - Suspension/SU_A1100 (Rear Upright Assy)/FEA/Accel 0.77g (2).png

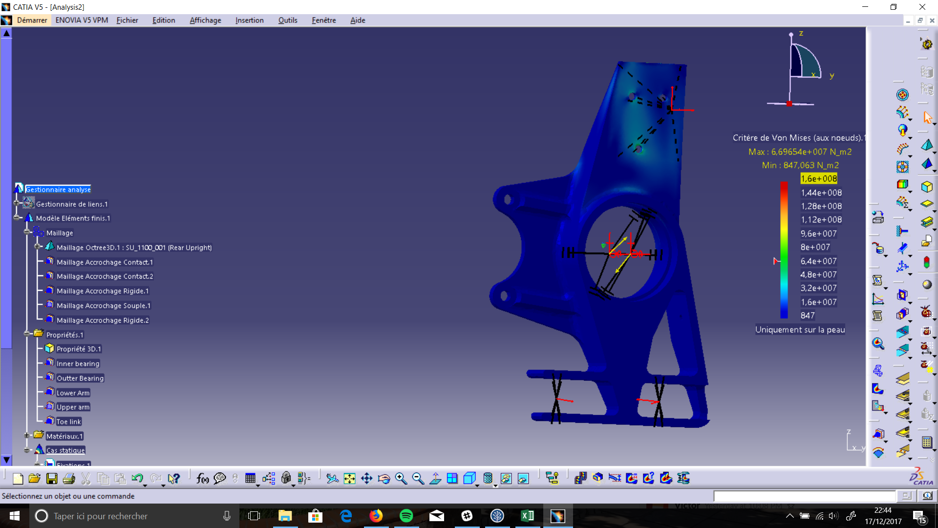
SU - Suspension/SU_A1100 (Rear Upright Assy)/FEA/Accel 0.77g (2).png
