epsa-team/Vulcanix-v1.0/SU - Suspension/SU_A1100 (Rear Upright Assy)/FEA/Entretoise roulement sous précharge 1 tonne.png

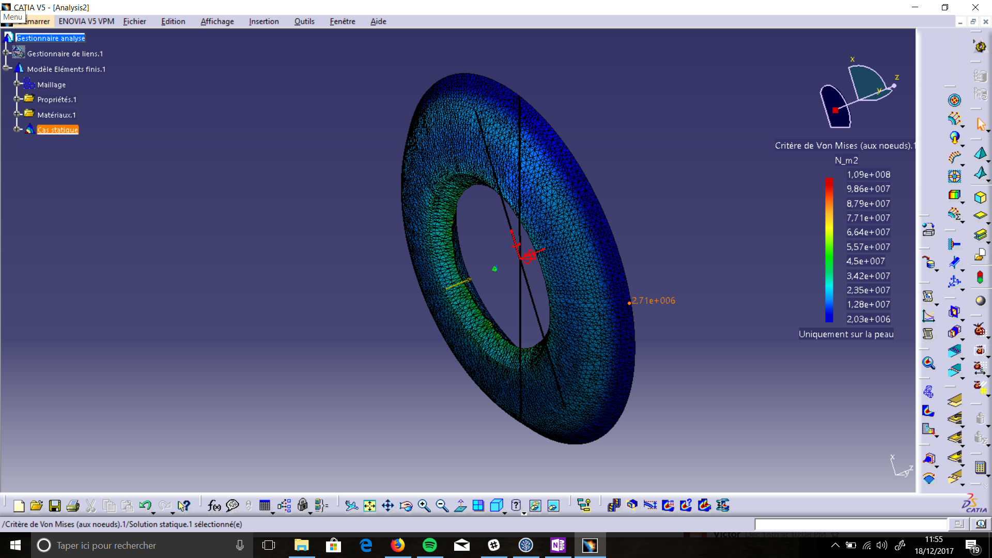
SU - Suspension/SU_A1100 (Rear Upright Assy)/FEA/Entretoise roulement sous précharge 1 tonne.png
