epsa-team/Vulcanix-v1.0/SU - Suspension/SU_A1100 (Rear Upright Assy)/FEA/Freinage 1G + virage 1G (4).png

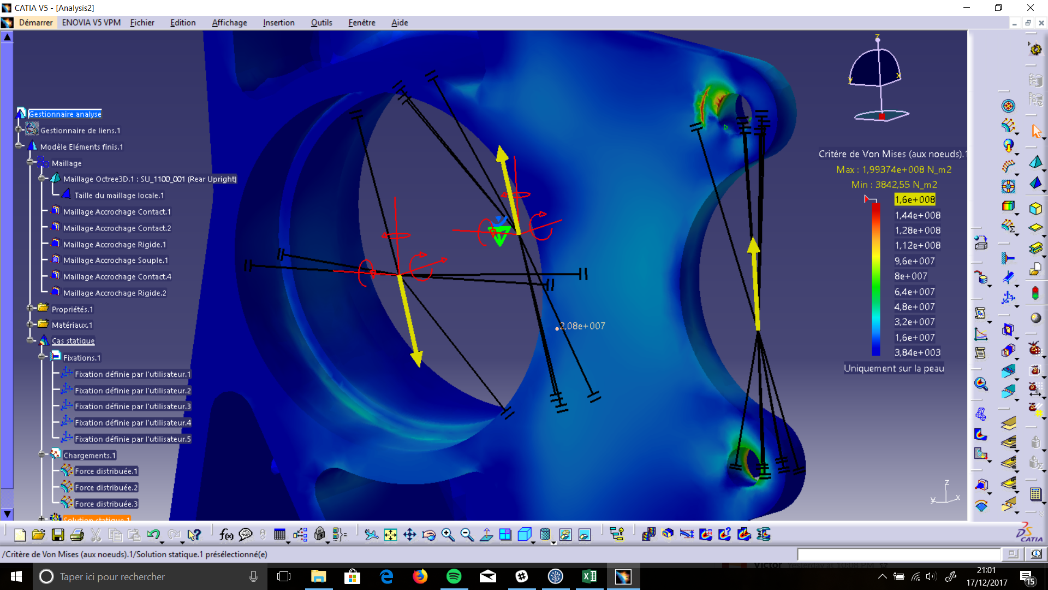
SU - Suspension/SU_A1100 (Rear Upright Assy)/FEA/Freinage 1G + virage 1G (4).png
