epsa-team/Vulcanix-v1.0/SU - Suspension/SU_A1100 (Rear Upright Assy)/FEA/Tripod Housing Spacer précharge 1tonne (2).png

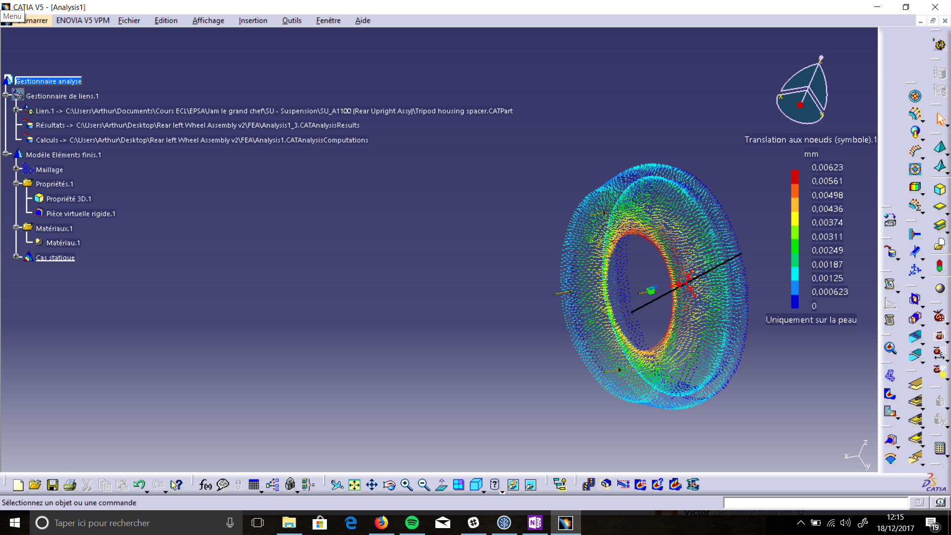
SU - Suspension/SU_A1100 (Rear Upright Assy)/FEA/Tripod Housing Spacer précharge 1tonne (2).png
