epsa-team/Vulcanix-v1.0/SU - Suspension/SU_A1100 (Rear Upright Assy)/FEA/Virage 2G avec roulement rotulé.png

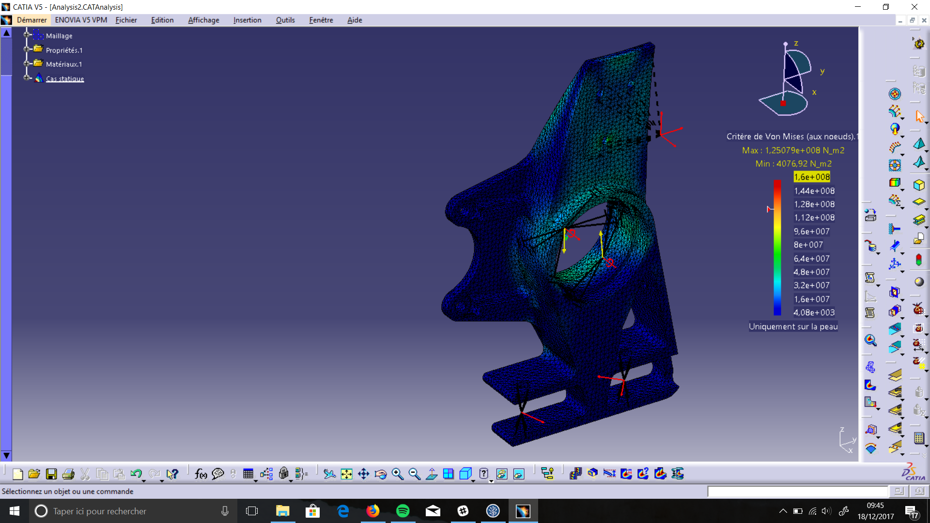
SU - Suspension/SU_A1100 (Rear Upright Assy)/FEA/Virage 2G avec roulement rotulé.png
