epsa-team/Vulcanix-v1.0/ZZ - Autres/Design event - Dossier Monoh/Support documents/Impression/affiche_cycle_en_V.jpg

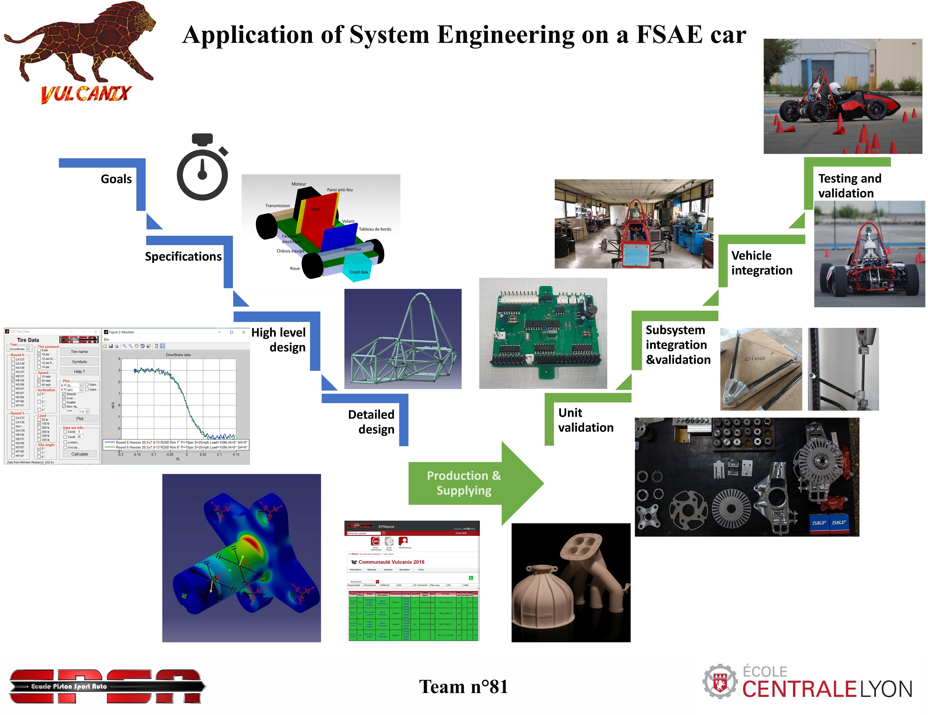
ZZ - Autres/Design event - Dossier Monoh/Support documents/Impression/affiche_cycle_en_V.jpg
