epsa-team/Vulcanix-v1.0/Cost Report/Real case/Cost_avec_modif_steering.xlsx

Sheet: Table of Contents
Table of contents
for: | Ecole Centrale de Lyon
 | Car # 81
Cost Summary
BOM
Brake System
Engine and Drivetrain
Frame & Body
Electrical
Miscellaneous, Finish and Assembly
Steering System
Suspension System
Wheels, Wheel Bearings and Tires

Sheet: Cost Summary
Cost Summary Basics
for: | Ecole Centrale de Lyon
 | #REF!
Area Totals |  | Materials | Processes | Fasteners | Tooling | Total
 | Brake System | #REF! | #REF! | #REF! | #REF! | #REF!
 | Engine & Drivetrain | #REF! | #REF! | #REF! | #REF! | #REF!
 | Frame & Body | #REF! | #REF! | #REF! | #REF! | #REF!
 | Electrical | #REF! | #REF! | #REF! | #REF! | #REF!
 | Miscellaneous, Finish & Assembly | #REF! | #REF! | #REF! | #REF! | #REF!
 | Steering System | #REF! | #REF! | #REF! | #REF! | #REF!
 | Suspension System | #REF! | #REF! | #REF! | #REF! | #REF!
 | Wheels, Wheel Bearings & Tires | #REF! | #REF! | #REF! | #REF! | #REF!
 | Total Vehicle | #REF! | #REF! | #REF! | #REF! | #REF!
Composition for total vehicle:

Sheet: ST 01001
University | Ecole Centrale de Lyon |  |  |  | Back to BOM |  |  |  | Car # | 81 |  | Part Cost | $7.97
System | Steering System |  |  |  |  |  |  |  |  |  |  | Qty | 1
Assembly | Steering Rack |  |  |  |  |  |  |  | FileLink1
Part | Rack pinion |  |  |  |  |  |  |  | FileLink2 |  |  | Extended Cost | $7.97
P/N Base | ST 01001 |  |  |  |  |  |  |  | FileLink3
Suffix | AA
Details | Bought part, cost as made
ItemOrder | Material | Use | UnitCost | Size1 | Unit1 | Size2 | Unit2 | Area Name | Area | Length | Density | Quantity | Sub Total
10 | Steel, Mild (per kg) | Stock for the pinion | $2.25 | 0.462 | kg |  |  | Circular area diam. 31mm | 0.000754385 | 0.078 | 7850 | 1 | $1.04
 |  |  |  |  |  |  |  |  |  |  |  | Sub Total | $1.04
ItemOrder | Process | Use | UnitCost | Unit | Quantity | Multiplier | Mult. Val. | Sub Total
10 | Machining Setup, Install and remove | Installation of the item 10 | $1.30 | Unit | 1 |  |  | $1.30
20 | Machining | Machining the pinion | $0.04 | cm^3 | 14.4957408 | Material - Steel | 3 | $1.74
30 | Broach, External | For the splines | $0.50 | cm | 2.2 |  |  | $1.10
40 | Machining Setup, Change | To machin the other side | $0.65 | Unit | 1 |  |  | $0.65
50 | Machining | Machining of the other side | $0.04 | cm^3 | 5.80 | Material - Steel | 3 | $0.70
60 | Machining Setup, Install and remove | Installation for the water jet cut | $1.30 | Unit | 1 |  |  | $1.30
70 | Waterjet Cut | For the pinion | $0.01 | cm | 14.45 |  |  | $0.14
 |  |  |  |  |  |  | Sub Total | $6.93

Sheet: ST 01002
University | Ecole Centrale de Lyon |  |  |  | Back to BOM |  |  |  | Car # | 81 |  | Part Cost | $6.04
System | Steering System |  |  |  |  |  |  |  |  |  |  | Qty | 1
Assembly | Steering Rack |  |  |  |  |  |  |  | FileLink1
Part | Rack |  |  |  |  |  |  |  | FileLink2 |  |  | Extended Cost | $6.04
P/N Base | ST 01002 |  |  |  |  |  |  |  | FileLink3
Suffix | AA
Details | Bought part, cost as made
ItemOrder | Material | Use | UnitCost | Size1 | Unit1 | Size2 | Unit2 | Area Name | Area | Length | Density | Quantity | Sub Total
10 | Steel, Mild (per kg) | Stock for the rack | $2.25 | 0.544 | kg |  |  | Circular area diam. 31mm | 0.000176625 | 0.392 | 7850 | 1 | $1.22
 |  |  |  |  |  |  |  |  |  |  |  | Sub Total | $1.22
ItemOrder | Process | Use | UnitCost | Unit | Quantity | Multiplier | Mult. Val. | Sub Total
10 | Machining Setup, Install and remove | Installation of the item 10 | $1.30 | Unit | 1 |  |  | $1.30
20 | Machining | Machining one end | $0.04 | cm^3 | 0.9047808 | Material - Steel | 3 | $0.11
30 | Threading, External (machining) | Thread at one end | $0.10 | cm | 2 |  |  | $0.20
40 | Machining Setup, Change | To machin the other end | $0.65 | Unit | 1 |  |  | $0.65
50 | Machining | Machining the other end | $0.04 | cm^3 | 0.9047808 | Material - Steel | 3 | $0.11
60 | Threading, External (machining) | Thread at the other end | $0.10 | cm | 2 |  |  | $0.20
70 | Machining Setup, Install and remove | Installation on a CNC machin for the gear tooth | $1.30 | Unit | 1 |  |  | $1.30
80 | Machining | Machining the gear tooth | $0.04 | cm^3 | 7.9158 | Material - Steel | 3 | $0.95
 |  |  |  |  |  |  | Sub Total | $4.82

Sheet: ST 01003
University | Ecole Centrale de Lyon |  |  |  | Back to BOM |  |  |  | Car # | 81 |  | Part Cost | $2.57
System | Steering System |  |  |  |  |  |  |  |  |  |  | Qty | 1
Assembly | Steering Rack |  |  |  |  |  |  |  | FileLink1
Part | Upper Pinion housing |  |  |  |  |  |  |  | FileLink2 |  |  | Extended Cost | $2.57
P/N Base | ST 01003 |  |  |  |  |  |  |  | FileLink3
Suffix | AA
Details | Bought part, cost as made
ItemOrder | Material | Use | UnitCost | Size1 | Unit1 | Size2 | Unit2 | Area Name | Area | Length | Density | Quantity | Sub Total
10 | Aluminum, Normal | Stock for the part | $4.20 | 0.055 | kg |  |  | Rectangular area | 0.00225 | 0.009 | 2712 | 1 | $0.23
20 | Paint |  | $10.00 | 0.0028 | m^2 |  |  |  |  |  |  |  | $0.03
 |  |  |  |  |  |  |  |  |  |  |  | Sub Total | $0.26
ItemOrder | Process | Use | UnitCost | Unit | Quantity | Multiplier | Mult. Val. | Sub Total
10 | Machining Setup, Install and remove | Installation of the item 10 | $1.30 | Unit | 1 |  |  | $1.30
20 | Machining | Machining of the first face | $0.04 | cm^3 | 7.5 | Material - Aluminium | 1 | $0.30
30 | Machining Setup, Change | To machin the other side | $0.65 | Unit | 1 |  |  | $0.65
40 | Machining | Machining of the second face | $0.04 | cm^3 | 1.5 | Material - Aluminium | 1 | $0.06
50 | Aerosol Apply | To apply black paint | $5.25 | m^2 | 0.0028 |  |  | $0.01
 |  |  |  |  |  |  | Sub Total | $2.31

Sheet: ST 01004
University | Ecole Centrale de Lyon |  |  |  | Back to BOM |  |  |  | Car # | 81 |  | Part Cost | $6.26
System | Steering System |  |  |  |  |  |  |  |  |  |  | Qty | 1
Assembly | Steering Rack |  |  |  |  |  |  |  | FileLink1
Part | Lower Pinion housing |  |  |  |  |  |  |  | FileLink2 |  |  | Extended Cost | $6.26
P/N Base | ST 01004 |  |  |  |  |  |  |  | FileLink3
Suffix | AA
Details | Bought part, cost as made
ItemOrder | Material | Use | UnitCost | Size1 | Unit1 | Size2 | Unit2 | Area Name | Area | Length | Density | Quantity | Sub Total
10 | Aluminum, Normal | Stock for the part | $4.20 | 0.231 | kg |  |  | Rectangular area | 0.0025 | 0.034 | 2712 | 1 | $0.97
20 | Paint |  | $10.00 | 0.01 | m^2 |  |  |  |  |  |  |  | $0.08
 |  |  |  |  |  |  |  |  |  |  |  | Sub Total | $1.05
ItemOrder | Process | Use | UnitCost | Unit | Quantity | Multiplier | Mult. Val. | Sub Total
10 | Machining Setup, Install and remove | Installation of the item 10 | $1.30 | Unit | 1 |  |  | $1.30
20 | Machining | Machining of the first face | $0.04 | cm^3 | 25.0165608 | Material - Aluminium | 1 | $1.00
30 | Threading, Internal (machining) | For the 4 holes | $0.10 | cm | 6 |  |  | $0.60
40 | Machining Setup, Change | To machin the other side | $0.65 | Unit | 1 |  |  | $0.65
50 | Machining | Machining of the second face | $0.04 | cm^3 | 21.3 | Material - Aluminium | 1 | $0.85
60 | Machining Setup, Change | To machin the other side | $0.65 | Unit | 1 |  |  | $0.65
70 | Machining | Machining of a beveal | $0.04 | cm^3 | 3.75 | Material - Aluminium | 1 | $0.15
80 | Aerosol Apply | To apply black paint | $5.25 | m^2 | 0.01 |  |  | $0.04
 |  |  |  |  |  |  | Sub Total | $5.20

Sheet: ST 01005
University | Ecole Centrale de Lyon |  |  |  | Back to BOM |  |  |  | Car # | 81 |  | Part Cost | $2.35
System | Steering System |  |  |  |  |  |  |  |  |  |  | Qty | 2
Assembly | Steering Rack |  |  |  |  |  |  |  | FileLink1
Part | Rack housing support |  |  |  |  |  |  |  | FileLink2 |  |  | Extended Cost | $4.70
P/N Base | ST 01005 |  |  |  |  |  |  |  | FileLink3
Suffix | AA
Details | Bought part, cost as made
ItemOrder | Material | Use | UnitCost | Size1 | Unit1 | Size2 | Unit2 | Area Name | Area | Length | Density | Quantity | Sub Total
10 | Aluminum, Normal | Stock for the part | $4.20 | 0.088 | kg |  |  | Circular area 33mm diameter | 0.0008553006 | 0.038 | 2712 | 1 | $0.37
20 | Paint |  | $10.00 | 0.00494 | m^2 |  |  |  |  |  |  |  | $0.05
 |  |  |  |  |  |  |  |  |  |  |  | Sub Total | $0.42
ItemOrder | Process | Use | UnitCost | Unit | Quantity | Multiplier | Mult. Val. | Sub Total
10 | Machining Setup, Install and remove | Installation of the item 10 | $1.30 | Unit | 1 | 2 parts made from a single setup | 0.5 | $0.65
20 | Machining | First machining | $0.04 | cm^3 | 20.6905776 | Material - Aluminium | 1 | $0.83
30 | Machining Setup, Change | To machin the other side | $0.65 | Unit | 1 | 2 parts made from a single setup | 0.5 | $0.33
40 | Machining | for the other side | $0.04 | cm^3 | 2.565 | Material - Aluminium | 1 | $0.10
50 | Aerosol Apply | To apply black paint | $5.25 | m^2 | 0.00494 |  |  | $0.03
 |  |  |  |  |  |  | Sub Total | $1.93

Sheet: ST 01006
University | Ecole Centrale de Lyon |  |  |  | Back to BOM |  |  |  | Car # | 81 |  | Part Cost | $1.92
System | Steering System |  |  |  |  |  |  |  |  |  |  | Qty | 2
Assembly | Steering Rack |  |  |  |  |  |  |  | FileLink1
Part | Tie rod Braces |  |  |  |  |  |  |  | FileLink2 |  |  | Extended Cost | $3.84
P/N Base | ST 01006 |  |  |  |  |  |  |  | FileLink3
Suffix | AA
Details | Bought part, cost as made
ItemOrder | Material | Use | UnitCost | Size1 | Unit1 | Size2 | Unit2 | Area Name | Area | Length | Density | Quantity | Sub Total
10 | Aluminum, Normal | Stock for the part | $2.25 | 0.038 | kg |  |  | Circular area 26mm diameter | 0.0016 | 0.003 | 7850 | 1 | $0.08
20 | Paint |  | $10.00 | 0.0016 | m^2 |  |  |  |  |  |  |  | $0.02
 |  |  |  |  |  |  |  |  |  |  |  | Sub Total | $0.10
ItemOrder | Process | Use | UnitCost | Unit | Quantity | Multiplier | Mult. Val. | Sub Total
10 | Machining Setup, Install and remove | Installation of the item 10 | $1.30 | Unit | 1 | 2 parts made from a single setup | 0.5 | $0.65
20 | laser cut | First machining | $0.01 | cm | 22 | Material - steel | 3 | $0.66
30 | Sheet metal bends |  | $0.25 | bend | 2 |  |  | $0.50
40 | Aerosol Apply | To apply red paint | $5.25 | m^2 | 0.00128 |  |  | $0.01
 |  |  |  |  |  |  | Sub Total | $1.82

Sheet: ST 01007
University | Ecole Centrale de Lyon |  |  |  | Back to BOM |  |  |  | Car # | 81 |  | Part Cost | $3.85
System | Steering System |  |  |  |  |  |  |  |  |  |  | Qty | 1
Assembly | Steering Rack |  |  |  |  |  |  |  | FileLink1
Part | Rack housing |  |  |  |  |  |  |  | FileLink2 |  |  | Extended Cost | $3.85
P/N Base | ST 01007 |  |  |  |  |  |  |  | FileLink3
Suffix | AA
Details | Bought part, cost as made
ItemOrder | Material | Use | UnitCost | Size1 | Unit1 | Size2 | Unit2 | Area Name | Area | Length | Density | Quantity | Sub Total
10 | Carbon Fiber, 1 Ply | Stock | $4.20 | 0.050 | kg |  |  | Tube diam. 72 x 3 mm | 6.91e-05 | 0.268 | 2712 | 1 | $0.21
20 | Paint |  | $10.00 | 0.00968 | cm^2 |  |  |  |  |  |  |  | $0.10
 |  |  |  |  |  |  |  |  |  |  |  | Sub Total | $0.31
ItemOrder | Process | Use | UnitCost | Unit | Quantity | Multiplier | Mult. Val. | Sub Total
10 | Machining Setup, Install and remove | Installation of the item 10 | $1.30 | Unit |  |  |  | $1.30
20 | Drilled holes < 25.4 mm dia. | For the two holes | $0.35 | hole | 2 |  |  | $0.70
30 | Machining | For the opening | $0.04 | cm^3 | 3.5 | Material - Aluminium | 1 | $0.14
40 | Machining Setup, Change | To drill the last hole | $0.65 | Unit | 1 |  |  | $0.65
50 | Drilled hole < 50.8 mm dia. |  | $0.70 | hole | 1 |  |  | $0.70
60 | Aerosol Apply | To apply black paint | $5.25 | m^2 | 0.00968 |  |  | $0.05
 |  |  |  |  |  |  | Sub Total | $3.54

Sheet: ST 01008
University | Ecole Centrale de Lyon |  |  |  | Back to BOM |  |  |  | Car # | 81 |  | Part Cost | $1.58
System | Steering System | Drawing : | FileLink1 |  |  |  |  |  |  |  |  | Qty | 4
Assembly | Steering Rack |  |  |  |  |  |  |  | FileLink1
Part | Steering Brackets tie |  |  |  |  |  |  |  | FileLink2 |  |  | Extended Cost | $6.34
P/N Base | ST 01008 |  |  |  |  |  |  |  | FileLink3
Suffix | AA
Details | To fix the steering rack
ItemOrder | Material | Use | UnitCost | Size1 | Unit1 | Size2 | Unit2 | Area Name | Area | Length | Density | Quantity | Sub Total
10 | Aluminum, Normal | Stock for the part | $4.20 | 0.031 | kg |  |  | Rectangular area | 0.000256 | 0.045 | 2712 | 1 | $0.13
 |  |  |  |  |  |  |  |  |  |  |  | Sub Total | $0.13
ItemOrder | Process | Use | UnitCost | Unit | Quantity | Multiplier | Mult. Val. | Sub Total
10 | Machining Setup, Install and remove | Installation of the item 10 | $1.30 | Unit | 1 | 4 parts made from a single setup | 0.25 | $0.33
20 | Machining | For the half circule | $0.04 | cm^3 | 6.6476256 | Material - Aluminium | 1 | $0.27
30 | Machining Setup, Change | To machin the two holes | $0.65 | Unit | 1 | 4 parts made from a single setup | 0.25 | $0.16
40 | Drilled holes < 25.4 mm dia. | For the two holes | $0.35 | hole | 2 |  |  | $0.70
 |  |  |  |  |  |  | Sub Total | $1.45

Sheet: ST 01008 Drawing
ST_01008

Sheet: ST 01009
University | Ecole Centrale de Lyon |  |  |  | Back to BOM |  |  |  | Car # | 81 |  | Part Cost | $1.60
System | Steering System | Drawing : | FileLink1 |  |  |  |  |  |  |  |  | Qty | 2
Assembly | Steering Rack |  |  |  |  |  |  |  | FileLink1
Part | Steering Brackets |  |  |  |  |  |  |  | FileLink2 |  |  | Extended Cost | $3.19
P/N Base | ST 01009 |  |  |  |  |  |  |  | FileLink3
Suffix | AA
Details | This part is welded to the frame
ItemOrder | Material | Use | UnitCost | Size1 | Unit1 | Size2 | Unit2 | Area Name | Area | Length | Density | Quantity | Sub Total
10 | Steel, Mild (per kg) | Stock for the part | $2.25 | 0.059 | kg |  |  | Rectangular area | 0.005 | 0.0015 | 7850 | 1 | $0.13
20 | Paint |  | $10.00 | 0.004 | m^2 |  |  |  |  |  |  |  | $0.04
 |  |  |  |  |  |  |  |  |  |  |  | Sub Total | $0.17
ItemOrder | Process | Use | UnitCost | Unit | Quantity | Multiplier | Mult. Val. | Sub Total
10 | Machining Setup, Install and remove | Installation of the item 10 for laser cut | $1.30 | Unit | 1 | 2 parts made from a single setup | 0.5 | $0.65
20 | Laser Cut |  | $0.01 | cm | 25.4 |  |  | $0.25
30 | Sheet metal bends |  | $0.25 | bend | 2 |  |  | $0.50
40 | Aerosol Apply | To apply red paint | $5.25 | m^2 | 0.004 |  |  | $0.02
 |  |  |  |  |  |  | Sub Total | $1.42

Sheet: ST 01009 Drawing
ST_01009

Sheet: ST 01010
University | Ecole Centrale de Lyon |  |  |  | Back to BOM |  |  |  | Car # | 81 |  | Part Cost | $7.62
System | Steering System |  |  |  |  |  |  |  |  |  |  | Qty | 1
Assembly | Steering Rack |  |  |  |  |  |  |  | FileLink1
Part | Rack protection |  |  |  |  |  |  |  | FileLink2 |  |  | Extended Cost | $7.62
P/N Base | ST 01010 |  |  |  |  |  |  |  | FileLink3
Suffix | AA
Details
ItemOrder | Material | Use | UnitCost | Size1 | Unit1 | Size2 | Unit2 | Area Name | Area | Length | Density | Quantity | Sub Total
10 | Aluminum, Normal | Stock for the part | $4.20 | 0.734 | kg |  |  | Rectangular area | 0.1804 | 0.0015 | 2712 | 1 | $3.08
 |  |  |  |  |  |  |  |  |  |  |  | Sub Total | $3.08
ItemOrder | Process | Use | UnitCost | Unit | Quantity | Multiplier | Mult. Val. | Sub Total
10 | Machining Setup, Install and remove | Installation of the item 10 for laser cut | $1.30 | Unit | 1 |  |  | $1.30
20 | Laser Cut |  | $0.01 | cm | 199 |  |  | $1.99
30 | Sheet metal bends |  | $0.25 | bend | 5 |  |  | $1.25
 |  |  |  |  |  |  | Sub Total | $4.54

Sheet: ST 01011
University | Ecole Centrale de Lyon |  |  |  | Back to BOM |  |  |  | Car # | 81 |  | Part Cost | $0.38
System | Steering System | Drawing : | FileLink1 |  |  |  |  |  |  |  |  | Qty | 4
Assembly | Steering Rack |  |  |  |  |  |  |  | FileLink1
Part | Rack protection Brackets |  |  |  |  |  |  |  | FileLink2 |  |  | Extended Cost | $1.52
P/N Base | ST 01011 |  |  |  |  |  |  |  | FileLink3
Suffix | AA
Details | This part is Welded on the frame
ItemOrder | Material | Use | UnitCost | Size1 | Unit1 | Size2 | Unit2 | Area Name | Area | Length | Density | Quantity | Sub Total
10 | Steel, Mild (per kg) | Stock for the part | $2.25 | 0.002 | kg |  |  | Rectangular area | 0.00018 | 0.0015 | 7850 | 1 | $0.004768875
20 | Paint |  | $10.00 | 0.00036 | m^2 |  |  |  |  |  |  |  | $0.0036
 |  |  |  |  |  |  |  |  |  |  |  | Sub Total | $0.01
ItemOrder | Process | Use | UnitCost | Unit | Quantity | Multiplier | Mult. Val. | Sub Total
10 | Machining Setup, Install and remove | Installation of the item 10 for laser cut | $1.30 | Unit | 1 | 4 parts made from a single setup | 0.25 | $0.33
20 | Laser Cut |  | $0.01 | cm | 4.56 |  |  | $0.05
30 | Aerosol Apply | To apply red paint | $5.25 | m^2 | 0.000144 |  |  | $0.000756
 |  |  |  |  |  |  | Sub Total | $0.37

Sheet: ST 01011 Drawing
ST 01011

Sheet: ST A0200
University | Ecole Centrale de Lyon |  |  | Back to BOM |  |  |  |  | Car # | 81 |  | Asm Cost | $75.46
System | Steering System |  |  |  |  |  |  |  |  |  |  | Qty | 1
Assembly | Steering Column assy |  |  |  |  |  |  |  | FileLink1
P/N Base | ST A0200 |  |  |  |  |  |  |  | FileLink2 |  |  | Extended Cost | $75.46
Suffix | AA |  |  |  |  |  |  |  | FileLink3
Details
ItemOrder | Part | Part Cost | Quantity | Sub Total
10 | Spline Coupler | $3.63 | 1 | $3.63
20 | Steering column | $2.11 | 1 | $2.11
30 | Steering Upper Shaft Pivot | $6.13 | 1 | $6.13
40 | Steering Bore | $9.11 | 1 | $9.11
50 | Steering Bore support | $1.46 | 2 | $2.93
 |  |  | Sub Total | $23.91
ItemOrder | Material | Use | UnitCost | Size1 | Unit1 | Size2 | Unit2 | Area Name | Area | Length | Density | Quantity | Sub Total
10 | Steering Column Universal Joint |  | $20.00 |  |  |  |  |  |  |  |  | 1 | $20.00
20 | Bearing, Ball, Radial | To guide part 30 in the part 40 | $9.79 | 37 | mm | 7 | mm |  |  |  |  | 2 | $19.58
 |  |  |  |  |  |  |  |  |  |  |  | Sub Total | $39.58
ItemOrder | Process | Use | UnitCost | Unit | Quantity | Multiplier | Mult. Val. | Sub Total
10 | Machining Setup, Install and remove | Setup for tne material 10 | $1.30 | unit | 1 |  |  | $1.30
20 | Machining | Machining the material 10 | $0.04 | cm^3 | 5.65488 | Material - Steel | 3 | $0.68
30 | Weld | Welding between The part 10 and the part 20 | $0.15 | cm | 6.2 |  |  | $0.93
40 | Weld | Welding between the part 20 and the material 10 | $0.15 | cm | 6.2 |  |  | $0.93
50 | Weld | Welding between the part 30 and the material 10 | $0.15 | cm | 10 |  |  | $1.50
60 | Weld | Welding between the two part 50 and the frame | $0.15 | cm | 6.4 |  |  | $0.96
70 | Weld | Welding between the two part 50 and the part 40 | $0.15 | cm | 6.4 |  |  | $0.96
80 | Weld | Welding between the part 30 and Quick Release | $0.15 | cm | 8 |  |  | $1.20
90 | Assemble, 1 kg, Interference | Assembly of the first material 20 on the part 30 | $0.19 | unit | 1 |  |  | $0.19
100 | Assemble, 1 kg, Line-on-Line | Assembly of the steering column in the part 40 | $0.13 | unit | 1 | Assemble - Length > 0.5m | 1.25 | $0.16
110 | Assemble, 1 kg, Interference | Assembly of the second material 20 in the part 40 | $0.19 | unit | 1 |  |  | $0.19
120 | Assemble, 1 kg, Line-on-Line | To install the fastener 10 | $0.13 | unit | 1 |  |  | $0.13
 |  |  |  |  |  |  | Sub Total | $9.13
ItemOrder | Fastener | Use | UnitCost | Size1 | Unit1 | Size2 | Unit2 | Quantity | Sub Total
10 | Retaining Ring, External | To retain the material 20 on the part 30 | $0.18 | 30 | mm |  |  | 1 | $0.18
 |  |  |  |  |  |  |  | Sub Total | $0.18
ItemOrder | Tooling | Use | UnitCost | Unit | Quantity | PVF | FractionIncluded | Sub Total
10 | Welds - Welding Fixture | For the process 30, 2 point to weld | $500 | 1 | 2 | 3000 | 1 | $0.33
20 | Welds - Welding Fixture | For the process 40, 2 point per weld | $500 | 1 | 2 | 3000 | 1 | $0.33
30 | Welds - Welding Fixture | For the process 50, 2 point per weld | $500 | 1 | 2 | 3000 | 1 | $0.33
40 | Welds - Welding Fixture | For the process 60, 2 point per weld | $500 | 1 | 4 | 3000 | 1 | $0.67
50 | Welds - Welding Fixture | For the process 70, 2 point per weld | $500 | 1 | 4 | 3000 | 1 | $0.67
60 | Welds - Welding Fixture | For the process 80, 2 point per weld | $500 | 1 | 2 | 3000 | 1 | $0.33
 |  |  |  |  |  |  | Sub Total | $2.67

Sheet: ST 02001
University | Ecole Centrale de Lyon |  |  |  | Back to BOM |  |  |  | Car # | 81 |  | Part Cost | $3.63
System | Steering System |  |  |  |  |  |  |  |  |  |  | Qty | 1
Assembly | Steering Column assy |  |  |  |  |  |  |  | FileLink1
Part | Spline coupler |  |  |  |  |  |  |  | FileLink2 |  |  | Extended Cost | $3.63
P/N Base | ST 02001 |  |  |  |  |  |  |  | FileLink3
Suffix | AA
Details | Bought part, cost as made
ItemOrder | Material | Use | UnitCost | Size1 | Unit1 | Size2 | Unit2 | Area Name | Area | Length | Density | Quantity | Sub Total
10 | Steel, alloy (per kg) | Stock for spline coupler | $2.25 | 0.116 | kg |  |  | Circular section : diameter 24 | 0.000490875 | 0.030 | 7850 | 1 | $0.26
 |  |  |  |  |  |  |  |  |  |  |  | Sub Total | $0.26
ItemOrder | Process | Use | UnitCost | Unit | Quantity | Multiplier | Mult. Val. | Sub Total
10 | Machining Setup, Install and remove | Setup for tne material 20 | $1.30 | unit | 1 |  |  | $1.30
20 | Drilled holes < 25.4 mm dia. | Hole before the Broach | $0.35 | hole | 1 |  |  | $0.35
30 | Machining | Machining the spline | $0.04 | cm^3 | 1.8472608 | Material - Steel | 3 | $0.22
40 | Broach, Internal | For the splines in the spline coupler | $0.50 | cm | 1 |  |  | $1.50
 |  |  |  |  |  |  | Sub Total | $3.37

Sheet: ST 02002
University | Ecole Centrale de Lyon |  |  |  | Back to BOM |  |  |  | Car # | 81 |  | Part Cost | $2.11
System | Steering System |  |  |  |  |  |  |  |  |  |  | Qty | 1
Assembly | Steering Column assy |  |  |  |  |  |  |  | FileLink1
Part | Steering Column tube |  |  |  |  |  |  |  | FileLink2 |  |  | Extended Cost | $2.11
P/N Base | ST 02002 |  |  |  |  |  |  |  | FileLink3
Suffix | AA
Details | It is a tube, 20*1.5
ItemOrder | Material | Use | UnitCost | Size1 | Unit1 | Size2 | Unit2 | Area Name | Area | Length | Density | Quantity | Sub Total
10 | Steel, alloy (per kg) | Stock for column tube | $2.25 | 0.225 | kg |  |  | Circular area, diameter 20 | 0.0003487176 | 0.335 | 7850 | 1 | $0.51
 |  |  |  |  |  |  |  |  |  |  |  | Sub Total | $0.51
ItemOrder | Process | Use | UnitCost | Unit | Quantity | Multiplier | Mult. Val. | Sub Total
10 | Machining Setup, Install and remove | Setup | $1.30 | Unit | 1 |  |  | $1.30
20 | Tube cut | To cut the tube to the right lenght | $0.15 | cm | 2 |  |  | $0.30
 |  |  |  |  |  |  | Sub Total | $1.60

Sheet: ST 02003
University | Ecole Centrale de Lyon |  |  |  | Back to BOM |  |  |  | Car # | 81 |  | Part Cost | $6.13
System | Steering System | Drawing : | FileLink1 |  |  |  |  |  |  |  |  | Qty | 1
Assembly | Steering Column assy |  |  |  |  |  |  |  | FileLink1
Part | Steering Upper Shaft Pivot |  |  |  |  |  |  |  | FileLink2 |  |  | Extended Cost | $6.13
P/N Base | ST 02003 |  |  |  |  |  |  |  | FileLink3
Suffix | AA
Details
ItemOrder | Material | Use | UnitCost | Size1 | Unit1 | Size2 | Unit2 | Area Name | Area | Length | Density | Quantity | Sub Total
10 | Steel, alloy (per kg) | Stock the part | $2.25 | 0.360 | kg |  |  | Circular section : diameter 32mm | 0.0008042496 | 0.057 | 7850 | 1 | $0.81
 |  |  |  |  |  |  |  |  |  |  |  | Sub Total | $0.81
ItemOrder | Process | Use | UnitCost | Unit | Quantity | Multiplier | Mult. Val. | Sub Total
10 | Machining Setup, Install and remove | Setup for tne material 10 | $1.30 | unit | 1 |  |  | $1.30
20 | Machining | Machining of the left part | $0.04 | cm^3 | 20.5 | Material - Steel | 3 | $2.46
30 | Machining Setup, Change | To machin the other side | $0.65 | Unit | 1 |  |  | $0.65
40 | Machining | Machining of the right part | $0.04 | cm^3 | 7.6152384 | Material - Steel | 3 | $0.91
 |  |  |  |  |  |  | Sub Total | $5.32

Sheet: ST 02003 Drawing
ST 02003

Sheet: ST 02004
University | Ecole Centrale de Lyon |  |  |  | Back to BOM |  |  |  | Car # | 81 |  | Part Cost | $9.11
System | Steering System | Drawing : | FileLink1 |  |  |  |  |  |  |  |  | Qty | 1
Assembly | Steering Column Assy |  |  |  |  |  |  |  | FileLink1
Part | Steering Bore |  |  |  |  |  |  |  | FileLink2 |  |  | Extended Cost | $9.11
P/N Base | ST 02004 |  |  |  |  |  |  |  | FileLink3
Suffix | AA
Details
ItemOrder | Material | Use | UnitCost | Size1 | Unit1 | Size2 | Unit2 | Area Name | Area | Length | Density | Quantity | Sub Total
10 | Steel, alloy (per kg) | Stock for the part | $2.25 | 0.540 | kg |  |  | Circular section : diameter 48mm | 0.0018095616 | 0.038 | 7850 | 1 | $1.21
20 | Paint |  | $10.00 | 0.006 | m^2 |  |  |  | 0.0057 |  |  |  | $0.06
 |  |  |  |  |  |  |  |  |  |  |  | Sub Total | $1.27
ItemOrder | Process | Use | UnitCost | Unit | Quantity | Multiplier | Mult. Val. | Sub Total
10 | Machining Setup, Install and remove | Setup for tne material 10 | $1.30 | unit | 1 |  |  | $1.30
20 | Machining | Machining of the left shoulder | $0.04 | cm^3 | 33.6 | Material - Steel | 3 | $4.03
30 | Machining Setup, Change | To machin the other shoulder | $0.65 | Unit | 1 |  |  | $0.65
40 | Machining | Machining of the right shoulder | $0.04 | cm^3 | 15.2399016 | Material - Steel | 3 | $1.83
50 | Aerosol Apply | To apply red paint on the exterior | $5.25 | m^2 | 0.006 |  |  | $0.03
 |  |  |  |  |  |  | Sub Total | $7.84

Sheet: ST 02004 Drawing
ST 02004
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
