epsa-team/Vulcanix-v1.0/BR - Brake System/Cost/BR A0001.xlsx

Sheet: Instructions
Petite marche à suivre pour remplir cette merveille qu'est le cost
Etape 1 | Créer l'assemblage
Feuille Br Assembly : Feuille pour 1 assemblage du système BR. Pour un nouvel assemblage, créer un nouveau document à partir du template. 1 document Excel = 1 assemblage
Donner un nom clair à l'assemblage (et en anglais ^^) dans la ligne Assembly
Lui donner un code suivant la règle XX AYYYY dans la ligne P/N Base , avec XX le code de votre partie et YYYY le numéro de l'assemblage (c'est le même code que celui que vous avez dû utiliser sous CATIA)
Renommer l'onglet avec ce même code. Enregistrer le document Excel sous ce même nom.
Donner une brève description (en anglais) de l'assemblage dans la ligne Details
Renommer la zone où le code P/N Base est entré. Pour cela selectionner la cellule par un simple clic, cliquer ensuite dans le menu déroulant en haut à gauche indiquant le nom de la cellule (à côté de la barre de formule)
Renomme cette cellule du nom du code qu'elle comprend mais avec un _ comme séparateur : ex EL_A0001
Cette étape est importante pour créer des hyperliens ensuite
Renommer les cases quantité (cellule N3), et sous-totaux par respectivement code_de_l'assemblage_x avec x = q pour quantité, pa pour part, m pour material, f pour fastener, t pour tooling et p pour process
ex BR_A0001_q, …
Vérifier que la formule dans Asm Cost (cellule N2) renvoie aux noms corrects des cellules prcédentes. Sinon, faire les modifications nécessaires.
Etape 2 | Remplir les données de l'assemblage
Remplir la quantité, Material, Process, Fastener, Tooling. Dans le cas où une table n'est pas concernée (elle est restée vide), la supprimer complètement.
Consulter le tutoriel disponible sur GitHub, dans Vulcanix-v1.0/Cost Report, pour plus d'informations.
Etape 3 | Créer les parts
Feuille Br Part x : Feuille pour 1 part de l'assemblage. Pour faire une nouvelle part, créer un nouvel onglet à partir du template. 1 onglet = 1 part.
Dans la ligne Assembly, indiquer le nom de l'assemblage parent en mettant = puis en sélectionnant le bonne cellule de la page assemblies
Lui donner un nom en clair (et en anglais ^^) dans la ligne Part
Lui donner un code suivant la règle XX YYZZZ dans la ligne P/N Base , avec XX le code de votre partie et YY le numéro de l'assemblage et ZZZ le numéro de la part dans cet assemblage (même code que sous CATIA)
Renommer l'onglet avec ce même code.
Donner une brève description (en anglais) de la Part dans la ligne Details
Renommer la zone où le code P/N Base est entré. Pour cela selectionner la cellule par un simple clic, cliquer ensuite dans le menu déroulant en haut à gauche indiquant le nom de la cellule (à côté de la barre de formule)
Renommer cette cellule du nom du code qu'elle comprend mais avec un _ comme séparateur : ex BR_01001
Créer un lien vers l'assemblage : sélectionner la cellule, faites Ctrl+K, il apparait une fenetre, en référence de la cellule (A1 par défaut) indiquez le nom de la cellule renommé de l'assemblage (par ex BR_A0001)
Renommer les cases quantité (cellule N3), et sous-totaux de chaque part respectivement code_de_la_part_x avec x = q pour quantité, m pour material, f pour fastener, t pour tooling et p pour process
ex : BR_01001_q, …
Vérifier que la formule dans Part Cost (cellule N2) renvoie aux noms corrects des cellules prcédentes. Sinon, faire les modifications nécessaires.
Etape 4 | Remplir les données
Remplir la quantité (nombre d'occurrence de la pièce dans un seul assemblage).
Remplir les tables Material, Fastener, Process et Tooling. Dans le cas où une table n'est pas concernée (elle est restée vide), la supprimer complètement.
Ajouter une illustration de la part (photo propre sur fond blanc si possible, vue CATIA sinon) dans la plus basse définition possible svp, on est limité en taille de fichier
Etape 5 | Ajouter les plans
Faites une capture d'écran du plan de la part en question et coller l'image dans l'onglet "BR Drawing 1"
Au-dessus du plan écrire "Drawing part :" et dans la cellule d'à côté mettre le code de la Part en question
Ajouter un lien pour pouvoir revenir vers le détail de la Part sur cette cellule
Renommer la cellule avec le nouveau lien d_code_de_la_part, ex dBR_01001
Renommer l'onglet avec ce même code
Dans le détail de la part (onglet "BR Part x") écrire à côté de cellule File Link "Drawing" et mettre un lien vers la cellule surplombant le plan ayant le code d_code_de_la_part (ex dBR_01001)
Insérer un lien vers la Part sur le plan par clic droit sur l'image. Cible du lien vers la Part (ex EL_01001)
On peut faire 2 colonnes de plan pour des tailles différentes. La référence reste les plans en paysage.
Etape 6 | Inserer les Parts dans l'assemblage
Remplir dans l'assemblage les cellules nom / part cost et quantity pour chaque parts (toujours en dynamique, ne faites pas de copier coller svp)
Insérer un lien vers la part sur le nom de celle-ci. Pour cela :
sélectionner la cellule, faites Ctrl+K, apparait une fenetre, en référence de la cellule (A1 par défaut) indiquez le nom de la cellule renommé de la Part (par ex BR_01001)
Etape 7 | Remplir la BOM
Il s'agit de faire la nomenclature de votre partie dans l'onglet BOM
De manière générale la colonne description ne sera pas remplie
Commencez par l'assemblage (de couleur plus foncée)
Cellule ASM/PRT# mettre le code de l'assemblage
Laisser la cellule ASM vide
Mettre le nom de l'assemblage dans Component, avec un lien vers l'assemblage en question
Remplir les cellules Quantity, Material, Process, Fastener et Tooling cost. Pour ça :
il suffit de mettre = Code de la pièce _ x avec q pour quantité, m pour material, p pour process, f pour fastener, t pour tooling (vous aviez renommé les cellules avant)
Viennent ensuite les Parts. Pour chaque Part :
Code dans ASM/PRT# aligné à droite, nom de l'assemblage parent dans ASM, Nom de la part dans Component
Mettre un lien vers la part en question sur le nom de cette dernière
Remplir les cellules Quantity, Material, Process, Fastener et Tooling cost. Pour ça :
il suffit de mettre = Code de la pièce _ x avec q pour quantité, m pour material, p pour process, f pour fastener, t pour tooling (vous aviez renommé les cellules avant)
Pour la quantité des parts : mettre la quantité absolue sur la voiture !!! Du coup c'est quantité de l'assemblage * quantité de cette part dans l'assemblage
Pour toute question, contacter Raphaël Mounet ou Clément Marie par Messenger de préférence, par mail sinon.

Sheet: BOM
University | Ecole Centrale de Lyon |  |  |  |  |  |  |  |  |  |  | Total Vehicle Cost |  | #REF!
Competition Code | FSAEI
Year | 2018
Car # | 81 |  | The cost of assemlies on this chart should not include the cost of the parts in the assembly but only the materials, processes, fasteners and tooling in the assembly level.
Line Num. | Area of Commodity | Asm/Prt # | Rev. Lvl. | Asm | Component | Description | Unit Cost | Quantity | Material Cost | Process Cost | Fastener Cost | Tooling Cost | Total Cost | Details Page Number
 | Brake System | BR A0001 | AA |  | Front Brake Rotor |  | $89.74 | 2 | $84.71 | $4.42 | $0.61 | $0.00 | $179.49
 | Brake System | BR 01001 | AA | Front Brake Rotor | Brake Rotor |  | $3.39 | 2 | $1.47 | $1.92 | $0.00 | $0.00 | $6.78
 | Brake System | BR 01002 | AA | Front Brake Rotor | Brake Shrink Disc |  | $6.02 | 2 | $1.89 | $4.13 | $0.00 | $0.00 | $12.04
 | Brake System | BR 01003 | AA | Front Brake Rotor | Brake Bobbin |  | $1.51 | 12 | $0.04 | $1.48 | $0.00 | $0.00 | $18.17
 | Brake System | BR 01004 | AA | Front Brake Rotor | Brake Caliper Spacer |  | $0.28 | 4 | $0.04 | $0.24 | $0.00 | $0.00 | $1.13
 | Brake System |  | AA |  |  |  | $0.00 |  |  |  |  |  | $0.00
 | Brake System |  | AA |  |  |  | $0.00 |  |  |  |  |  | $0.00
 | Brake System |  | AA |  |  |  | $0.00 |  |  |  |  |  | $0.00
 | Brake System |  | AA |  |  |  | $0.00 |  |  |  |  |  | $0.00
 | Brake System |  | AA |  |  |  | $0.00 |  |  |  |  |  | $0.00
 | Brake System |  | AA |  |  |  | $0.00 |  |  |  |  |  | $0.00
 | Brake System |  |  |  | Area Total |  |  |  | $176.72 | $39.66 | $1.23 | $0.00 | $217.60

Sheet: BR A0001
University | Ecole Centrale de Lyon |  |  | Back to BOM |  |  |  |  | Car # | 81 |  | Asm Cost | $108.80
System | Brake System |  |  |  |  |  |  |  |  |  |  | Qty | 2
Assembly | Front Brake Rotor |  |  |  |  |  |  |  | FileLink1
P/N Base | BR A0001 |  |  |  |  |  |  |  | FileLink2 |  |  | Extended Cost | $217.60
Suffix | AA |  |  |  |  |  |  |  | FileLink3
Details | Front Brake Rotor assembly
ItemOrder | Part | Part Cost | Quantity | Sub Total
10 | Brake Rotor | $3.39 | 1 | $3.39
20 | Brake Shrink Disc | $6.02 | 1 | $6.02
30 | Brake Bobbin | $1.51 | 6 | $9.09
40 | Brake Caliper Spacer | $0.28 | 2 | $0.56
 |  |  | Sub Total | $19.06
ItemOrder | Material | Use | UnitCost | Size1 | Unit1 | Size2 | Unit2 | Area Name | Area | Length | Density | Quantity | Sub Total
10 | Brake Caliper, Beringer 2D1 | Brake Caliper (in reality Beringer 2P1A is used) | $83.00 |  | unit |  |  |  |  |  |  | 1.00 | $83.00
20 | Brake Pad, Iron or Steel Rotor | Brake Pad | $0.0002 | 4272.39 | mm^3 |  |  | Circular sector | 0.00142413 | 0.003 |  | 2.00 | $1.71
 |  |  |  |  |  |  |  |  |  |  |  | Sub Total | $84.71
ItemOrder | Process | Use | UnitCost | Unit | Quantity | Multiplier | Mult. Val. | Sub Total
10 | Assemble, 1kg, Line on Line | Line up Pad | $0.13 | unit | 2 |  |  | $0.26
20 | Assemble, 1kg, Loose | Insert Bobbins and Washer | $0.06 | unit | 6 |  |  | $0.36
30 | Assemble, 1kg, Line on Line | Assemble Brake Rotor and Shrink Disc | $0.13 | unit | 1 |  |  | $0.13
40 | Assemble, 1kg, Line on Line | Insert Retaining Ring | $0.13 | unit | 6 |  |  | $0.78
50 | Assemble, 1kg, Line on Line | Assemble Brake Rotor onto Hub | $0.13 | unit | 1 |  |  | $0.13
60 | Assemble, 1kg, Loose | Put Caliper and Spacer in place | $0.06 | unit | 1 |  |  | $0.06
70 | Ratchet <= 25.4 mm | Bolt Caliper and Spacer on Upright | $0.75 | unit | 2 |  |  | $1.50
80 | Safety Wire, Install | For Caliper Bolts locking device | $0.60 | unit | 2 |  |  | $1.20
 |  |  |  |  |  |  | Sub Total | $4.42
ItemOrder | Fastener | Use | UnitCost | Size1 | Unit1 | Size2 | Unit2 | Quantity | Sub Total
10 | Bolt,Grade 8.8 (SAE) | Bolt Caliper on Upright | $0.12 | 8 | mm | 30 | mm | 2 | $0.24
20 | Washer, Grade 8.8 (SAE 5) | Bolt Caliper on Upright | $0.01 | 8 | mm |  |  | 2 | $0.02
30 | Retaining Ring, External | Secure Brake Bobbin on Brake Rotor | $0.04 | 11.5 | mm |  |  | 6 | $0.24
40 | Washer, Grade 8.8 (SAE 5) | Shim between Brake Bobbin and Brake Rotor | $0.01 | 12 | mm |  |  | 12 | $0.12
 |  |  |  |  |  |  |  | Sub Total | $0.61

Sheet: BR 01001
University | Ecole Centrale de Lyon |  |  |  |  | Back to BOM |  |  | Car # | 81 |  | Part Cost | $3.39
System | Brake System |  | FileLink1 |  |  |  |  |  |  |  |  | Qty | 1
Assembly | Front Brake Rotor |  | FileLink2 |  |  |  |  |  | FileLink1
Part | Brake Rotor |  | FileLink3 |  |  |  |  |  | FileLink2 |  |  | Extended Cost | $3.39
P/N Base | BR 01001 |  |  |  |  |  |  |  | FileLink3
Suffix | AA
Details | Bought, cost as made
ItemOrder | Material | Use | UnitCost | Size1 | Unit1 | Size2 | Unit2 | Area Name | Area | Length | Density | Quantity | Sub Total
10 | Cast Iron (per kg) | Stock material for part | $1.00 | 1.467 | kg |  |  | Circle area, 230mm diameter | 0.042 | 0.004 | 7850 | 1.00 | $1.47
 |  |  |  |  |  |  |  |  |  |  |  | Sub Total | $1.47
ItemOrder | Process | Use | UnitCost | Unit | Quantity | Multiplier | Mult. Val. | Sub Total
10 | Machining Setup, Install and remove | Setup for laser cut | $1.30 | unit | 1 | 4 parts cut from a single machine setup | 0.25 | $0.33
20 | Laser Cut | Cutout shape | $0.01 | cm | 63.95 | Material - Cast Iron | 2.5 | $1.60
 |  |  |  |  |  |  | Sub Total | $1.92

Sheet: BR 01002
University | Ecole Centrale de Lyon |  |  |  |  | Back to BOM |  |  | Car # | 81 |  | Part Cost | $6.02
System | Brake System |  | FileLink1 | Drawing |  |  |  |  |  |  |  | Qty | 1
Assembly | Front Brake Rotor |  | FileLink2 |  |  |  |  |  | FileLink1
Part | Brake Shrink Disc |  | FileLink3 |  |  |  |  |  | FileLink2 |  |  | Extended Cost | $6.02
P/N Base | BR 01002 |  |  |  |  |  |  |  | FileLink3
Suffix | AA
Details | Allows brake rotor to be mounted floating
ItemOrder | Material | Use | UnitCost | Size1 | Unit1 | Size2 | Unit2 | Area Name | Area | Length | Density | Quantity | Sub Total
10 | Steel, Mild (per kg) | Stock material for part | $2.25 | 0.839 | kg |  |  | Circle Area, 164.95mm diameter | 0.02136950789 | 0.005 | 7850 | 1.00 | $1.89
 |  |  |  |  |  |  |  |  |  |  |  | Sub Total | $1.89
ItemOrder | Process | Use | UnitCost | Unit | Quantity | Multiplier | Mult. Val. | Sub Total
10 | Machining Setup, Install and remove | Setup for laser cutting | $1.30 | unit | 1 | 4 parts cut from a single machine setup | 0.25 | $0.33
20 | Laser Cut | Cutout shape | $0.01 | cm | 126.9 | Material - Steel | 3 | $3.81
 |  |  |  |  |  |  | Sub Total | $4.13

Sheet: BR 01003
University | Ecole Centrale de Lyon |  |  |  |  | Back to BOM |  |  | Car # | 81 |  | Part Cost | $1.51
System | Brake System |  | FileLink1 |  |  |  |  |  |  |  |  | Qty | 6
Assembly | Front Brake Rotor |  | FileLink2 |  |  |  |  |  | FileLink1
Part | Brake Bobbin |  | FileLink3 |  |  |  |  |  | FileLink2 |  |  | Extended Cost | $9.09
P/N Base | BR 01003 |  |  |  |  |  |  |  | FileLink3
Suffix | AA
Details | Bobbins between Brake Rotor and Brake Shrink Disc
ItemOrder | Material | Use | UnitCost | Size1 | Unit1 | Size2 | Unit2 | Area Name | Area | Length | Density | Quantity | Sub Total
10 | Steel, Mild (per kg) | Material for Bobbin | $2.25 | 0.016 | kg |  |  | Circle Area, 17mm diameter | 0.00022698 | 0.009 | 7850 | 1.00 | $0.04
 |  |  |  |  |  |  |  |  |  |  |  | Sub Total | $0.04
ItemOrder | Process | Use | UnitCost | Unit | Quantity | Multiplier | Mult. Val. | Sub Total
10 | Machining Setup, Install and remove | Setup for machining | $1.30 | unit | 1 |  |  | $1.30
20 | Machining |  | $0.04 | cm^3 | 1.486 | Material - Steel | 3 | $0.18
 |  |  |  |  |  |  | Sub Total | $1.48

Sheet: BR 01004
University | Ecole Centrale de Lyon |  |  |  |  | Back to BOM |  |  | Car # | 81 |  | Part Cost | $0.28
System | Brake System |  | FileLink1 | Drawing |  |  |  |  |  |  |  | Qty | 2
Assembly | Front Brake Rotor |  | FileLink2 |  |  |  |  |  | FileLink1
Part | Brake Caliper Spacer |  | FileLink3 |  |  |  |  |  | FileLink2 |  |  | Extended Cost | $0.56
P/N Base | BR 01004 |  |  |  |  |  |  |  | FileLink3
Suffix | AA
Details | Spacer between Caliper and Upright
ItemOrder | Material | Use | UnitCost | Size1 | Unit1 | Size2 | Unit2 | Area Name | Area | Length | Density | Quantity | Sub Total
10 | Steel, Mild (per kg) | Stock material for caliper spacer | $2.25 | 0.0178 | kg |  |  | Circular, 17mm diameter | 0.0002269800692 | 0.010 | 7850 | 1.00 | $0.04
 |  |  |  |  |  |  |  |  |  |  |  | Sub Total | $0.04
ItemOrder | Process | Use | UnitCost | Unit | Quantity | Multiplier | Mult. Val. | Sub Total
10 | Machining Setup, Install and remove | Setup for laser cut | $1.30 | unit | 1 | 8 parts cut from a single machine setup | 0.125 | $0.16
20 | Laser Cut | Cutout shape | $0.01 | cm | 2.639 | Material - Steel | 3 | $0.08
 |  |  |  |  |  |  | Sub Total | $0.24

Sheet: dBR 01002
Drawing part : | BR 01002

Sheet: dBR 01004
Drawing part : | BR 01004
