epsa-team/Vulcanix-v1.0/BR - Brake System/Cost/BR A0003.xlsx

Sheet: Instructions
Petite marche à suivre pour remplir cette merveille qu'est le cost
Etape 1 | Créer l'assemblage
Feuille Br Assembly : Feuille pour 1 assemblage du système BR. Pour un nouvel assemblage, créer un nouveau document à partir du template. 1 document Excel = 1 assemblage
Donner un nom clair à l'assemblage (et en anglais ^^) dans la ligne Assembly
Lui donner un code suivant la règle XX AYYYY dans la ligne P/N Base , avec XX le code de votre partie et YYYY le numéro de l'assemblage (c'est le même code que celui que vous avez dû utiliser sous CATIA)
Renommer l'onglet avec ce même code. Enregistrer le document Excel sous ce même nom.
Donner une brève description (en anglais) de l'assemblage dans la ligne Details
Renommer la zone où le code P/N Base est entré. Pour cela selectionner la cellule par un simple clic, cliquer ensuite dans le menu déroulant en haut à gauche indiquant le nom de la cellule (à côté de la barre de formule)
Renomme cette cellule du nom du code qu'elle comprend mais avec un _ comme séparateur : ex EL_A0001
Cette étape est importante pour créer des hyperliens ensuite
Renommer les cases quantité (cellule N3), et sous-totaux par respectivement code_de_l'assemblage_x avec x = q pour quantité, pa pour part, m pour material, f pour fastener, t pour tooling et p pour process
ex BR_A0001_q, …
Vérifier que la formule dans Asm Cost (cellule N2) renvoie aux noms corrects des cellules prcédentes. Sinon, faire les modifications nécessaires.
Etape 2 | Remplir les données de l'assemblage
Remplir la quantité, Material, Process, Fastener, Tooling. Dans le cas où une table n'est pas concernée (elle est restée vide), la supprimer complètement.
Consulter le tutoriel disponible sur GitHub, dans Vulcanix-v1.0/Cost Report, pour plus d'informations.
Etape 3 | Créer les parts
Feuille Br Part x : Feuille pour 1 part de l'assemblage. Pour faire une nouvelle part, créer un nouvel onglet à partir du template. 1 onglet = 1 part.
Dans la ligne Assembly, indiquer le nom de l'assemblage parent en mettant = puis en sélectionnant le bonne cellule de la page assemblies
Lui donner un nom en clair (et en anglais ^^) dans la ligne Part
Lui donner un code suivant la règle XX YYZZZ dans la ligne P/N Base , avec XX le code de votre partie et YY le numéro de l'assemblage et ZZZ le numéro de la part dans cet assemblage (même code que sous CATIA)
Renommer l'onglet avec ce même code.
Donner une brève description (en anglais) de la Part dans la ligne Details
Renommer la zone où le code P/N Base est entré. Pour cela selectionner la cellule par un simple clic, cliquer ensuite dans le menu déroulant en haut à gauche indiquant le nom de la cellule (à côté de la barre de formule)
Renommer cette cellule du nom du code qu'elle comprend mais avec un _ comme séparateur : ex BR_01001
Créer un lien vers l'assemblage : sélectionner la cellule, faites Ctrl+K, il apparait une fenetre, en référence de la cellule (A1 par défaut) indiquez le nom de la cellule renommé de l'assemblage (par ex BR_A0001)
Renommer les cases quantité (cellule N3), et sous-totaux de chaque part respectivement code_de_la_part_x avec x = q pour quantité, m pour material, f pour fastener, t pour tooling et p pour process
ex : BR_01001_q, …
Vérifier que la formule dans Part Cost (cellule N2) renvoie aux noms corrects des cellules prcédentes. Sinon, faire les modifications nécessaires.
Etape 4 | Remplir les données
Remplir la quantité (nombre d'occurrence de la pièce dans un seul assemblage).
Remplir les tables Material, Fastener, Process et Tooling. Dans le cas où une table n'est pas concernée (elle est restée vide), la supprimer complètement.
Ajouter une illustration de la part (photo propre sur fond blanc si possible, vue CATIA sinon) dans la plus basse définition possible svp, on est limité en taille de fichier
Etape 5 | Ajouter les plans
Faites une capture d'écran du plan de la part en question et coller l'image dans l'onglet "BR Drawing 1"
Au-dessus du plan écrire "Drawing part :" et dans la cellule d'à côté mettre le code de la Part en question
Ajouter un lien pour pouvoir revenir vers le détail de la Part sur cette cellule
Renommer la cellule avec le nouveau lien d_code_de_la_part, ex dBR_01001
Renommer l'onglet avec ce même code
Dans le détail de la part (onglet "BR Part x") écrire à côté de cellule File Link "Drawing" et mettre un lien vers la cellule surplombant le plan ayant le code d_code_de_la_part (ex dBR_01001)
Insérer un lien vers la Part sur le plan par clic droit sur l'image. Cible du lien vers la Part (ex EL_01001)
On peut faire 2 colonnes de plan pour des tailles différentes. La référence reste les plans en paysage.
Etape 6 | Inserer les Parts dans l'assemblage
Remplir dans l'assemblage les cellules nom / part cost et quantity pour chaque parts (toujours en dynamique, ne faites pas de copier coller svp)
Insérer un lien vers la part sur le nom de celle-ci. Pour cela :
sélectionner la cellule, faites Ctrl+K, apparait une fenetre, en référence de la cellule (A1 par défaut) indiquez le nom de la cellule renommé de la Part (par ex BR_01001)
Etape 7 | Remplir la BOM
Il s'agit de faire la nomenclature de votre partie dans l'onglet BOM
De manière générale la colonne description ne sera pas remplie
Commencez par l'assemblage (de couleur plus foncée)
Cellule ASM/PRT# mettre le code de l'assemblage
Laisser la cellule ASM vide
Mettre le nom de l'assemblage dans Component, avec un lien vers l'assemblage en question
Remplir les cellules Quantity, Material, Process, Fastener et Tooling cost. Pour ça :
il suffit de mettre = Code de la pièce _ x avec q pour quantité, m pour material, p pour process, f pour fastener, t pour tooling (vous aviez renommé les cellules avant)
Viennent ensuite les Parts. Pour chaque Part :
Code dans ASM/PRT# aligné à droite, nom de l'assemblage parent dans ASM, Nom de la part dans Component
Mettre un lien vers la part en question sur le nom de cette dernière
Remplir les cellules Quantity, Material, Process, Fastener et Tooling cost. Pour ça :
il suffit de mettre = Code de la pièce _ x avec q pour quantité, m pour material, p pour process, f pour fastener, t pour tooling (vous aviez renommé les cellules avant)
Pour la quantité des parts : mettre la quantité absolue sur la voiture !!! Du coup c'est quantité de l'assemblage * quantité de cette part dans l'assemblage
Pour toute question, contacter Raphaël Mounet ou Clément Marie par Messenger de préférence, par mail sinon.

Sheet: BOM
University | Ecole Centrale de Lyon |  |  |  |  |  |  |  |  |  |  | Total Vehicle Cost |  | #REF!
Competition Code | FSAEI
Year | 2018
Car # | 81 |  | The cost of assemlies on this chart should not include the cost of the parts in the assembly but only the materials, processes, fasteners and tooling in the assembly level.
Line Num. | Area of Commodity | Asm/Prt # | Rev. Lvl. | Asm | Component | Description | Unit Cost | Quantity | Material Cost | Process Cost | Fastener Cost | Tooling Cost | Total Cost | Details Page Number
 | Brake System | BR A0003 | AA |  | Brake Circuit Assembly |  | $792.11 | 1 | $746.74 | $41.73 | $2.97 | $0.67 | $792.11
 | Brake System | BR 03001 | AA | Brake Circuit Assembly | Hydraulic Fluid Reservoir Mount |  | $1.07 | 1 | $0.03 | $1.03 | $0.00 | $0.00 | $1.07
 | Brake System | BR 03002 | AA | Brake Circuit Assembly | Distribution Tee Mount |  | $1.01 | 1 | $0.03 | $0.98 | $0.00 | $0.00 | $1.01
 | Brake System | BR 03003 | AA | Brake Circuit Assembly | Internal Spacer |  | $0.73 | 2 | $0.02 | $0.70 | $0.00 | $0.00 | $1.45
 | Brake System | BR 03004 | AA | Brake Circuit Assembly | External Spacer |  | $0.67 | 2 | $0.01 | $0.66 | $0.00 | $0.00 | $1.33
 | Brake System |  | AA |  |  |  | $0.00 |  |  |  |  |  | $0.00
 | Brake System |  | AA |  |  |  | $0.00 |  |  |  |  |  | $0.00
 | Brake System |  | AA |  |  |  | $0.00 |  |  |  |  |  | $0.00
 | Brake System |  | AA |  |  |  | $0.00 |  |  |  |  |  | $0.00
 | Brake System |  | AA |  |  |  | $0.00 |  |  |  |  |  | $0.00
 | Brake System |  | AA |  |  |  | $0.00 |  |  |  |  |  | $0.00
 | Brake System |  |  |  | Area Total |  |  |  | $746.86 | $46.47 | $2.97 | $0.67 | $796.97

Sheet: BR A0003
University | Ecole Centrale de Lyon |  |  | Back to BOM |  |  |  |  | Car # | 81 |  | Asm Cost | $796.30
System | Brake System |  |  |  |  |  |  |  |  |  |  | Qty | 1
Assembly | Brake Circuit Assembly |  |  |  |  |  |  |  | FileLink1
P/N Base | BR A0003 |  |  |  |  |  |  |  | FileLink2 |  |  | Extended Cost | $796.30
Suffix | AA |  |  |  |  |  |  |  | FileLink3
Details | Brake line assembly
ItemOrder | Part | Part Cost | Quantity | Sub Total
10 | Hydraulic Fluid Reservoir Mount | $1.07 | 1 | $1.07
20 | Distribution Tee Mount | $1.01 | 1 | $1.01
30 | Internal Spacer | $0.73 | 2 | $1.45
40 | External Spacer | $0.67 | 2 | $1.33
 |  |  | Sub Total | $4.86
ItemOrder | Material | Use | UnitCost | Size1 | Unit1 | Size2 | Unit2 | Area Name | Area | Length | Density | Quantity | Sub Total
10 | Master Cylinder, AP, CP7855 | Master cylinder | $174.50 |  |  |  |  |  |  |  |  | 2.00 | $349.00
20 | Balance Bar, Tilton 72-250 | Balance bar | $30.00 |  |  |  |  |  |  |  |  | 1.00 | $30.00
30 | Hydraulic Fluid Reservoir, Remote (Plastic) | Fluid reservoir | $5.00 |  |  |  |  |  |  |  |  | 2.00 | $10.00
40 | Brake Light Pressure Switch Banjo Bolt | Brake light switch | $8.00 |  |  |  |  |  |  |  |  | 1.00 | $8.00
50 | Hose, Low Pressure, Stainless Steel Baided Outer (per m) | Brake line - GOODRIDGE's braking hose 6003 serie | $17.90 | 6.45 | mm |  |  |  |  |  |  | 6.00 | $107.42
60 | Hose, Rubber (per m) | Brake line - Hose between Master Cylinder and Fluid Reservoir | $2.16 | 12 | mm |  |  |  |  |  |  | 0.50 | $1.08
70 | Adapter/L.P./Union//Aluminum/Anodized | Brake line - AN7 to AN6 | $2.42 | 11.1125 | mm | 9.525 | mm |  |  |  |  | 2.00 | $4.83
80 | Adapter/L.P./Union//Aluminum/Anodized | Brake line - AN6 right to AN6 left | $2.32 | 9.525 | mm | 9.525 | mm |  |  |  |  | 2.00 | $4.64
90 | Fitting/L.P./Straight/Aluminum/Anodized | Brake line - GOODRIDGE's braking hose AN6 end | $6.49 | 9.525 | mm |  |  |  |  |  |  | 6.00 | $38.96
100 | Fitting/L.P./Elbow/45 deg./Aluminum/Anodized | Brake line - GOODRIDGE's braking hose AN6 end | $17.42 | 9.525 | mm |  |  |  |  |  |  | 2.00 | $34.84
110 | Adapter/L.P./Union//Aluminum/Anodized | Brake line - AN6 to 10mm | $2.35 | 9.525 | mm | 10 | mm |  |  |  |  | 6.00 | $14.10
120 | Adapter/L.P./Female Flare Tee//Brass | Brake line - Splitter Tee in 10mm | $4.02 | 10 | mm | 10 | mm |  |  |  |  | 2.00 | $8.04
130 | Banjo Fitting, 45 Deg., Steel | Brake line | $26.25 | 10 | mm |  |  |  |  |  |  | 4.00 | $105.00
140 | Banjo Bolt, Steel | Brake line | $6.80 | 10 | mm |  |  |  |  |  |  | 4.00 | $27.20
150 | Crush Washer | Brake line | $0.28 | 6 | mm |  |  |  |  |  |  | 12.00 | $3.38
160 | Fluid, Oil | Braking fluid | $0.22 | 0.3 | L |  |  |  |  |  |  | 1.00 | $0.22
170 | Paint | Protect steel tab from rust | $0.02 | 0.0024 | m^2 |  |  |  |  |  |  | 1.00 | $0.02
 |  |  |  |  |  |  |  |  |  |  |  | Sub Total | $746.74
ItemOrder | Process | Use | UnitCost | Unit | Quantity | Multiplier | Mult. Val. | Sub Total
10 | Weld | Welding the Hydraulic Fluid Reservoir Mount | $0.15 | cm | 5.6 |  |  | $0.84
20 | Weld | Welding the Distribution Tee Mount | $0.15 | cm | 4.6 |  |  | $0.69
30 | Aerosol Apply | Painting for the Mounts | $5.25 | m^2 | 0.0024 |  |  | $0.01
40 | Assemble, 1kg, Loose | Positioning the Balance Bar on the Brake Pedal Supports | $0.06 | unit | 1 |  |  | $0.06
50 | Hand, Loose <= 6.35mm | Fixing the Master Cylinder on the Balance Bar | $0.25 | unit | 2 |  |  | $0.50
60 | Assemble, 1kg, Loose | Positioning the M6 Bolt through the Master Cylinder bearings, the Internal Spacers, the External Spacers and the Brake Pedal | $0.06 | unit | 1 |  |  | $0.06
70 | Ratchet <= 6,35mm | Fixing the Bolt to the Master Cylinder Bearings (through the Brake Pedal) | $0.50 | unit | 1 |  |  | $0.50
80 | Reaction Tool <= 6.35mm | Fixing the Bolt to the Master Cylinder Bearings (through the Brake Pedal) | $0.25 | unit | 1 |  |  | $0.25
90 | Assemble, 1kg, Loose | Positioning the Hydraulic Fluid Reservoirs on the Hydraulic Fluid Reservoir Mount | $0.06 | unit | 1 |  |  | $0.06
100 | Ratchet <= 6.35mm | Fixing the Hydraulic Fluid Reservoir on the Hydraulic Fluid Reservoir Mount | $0.50 | unit | 2 |  |  | $1.00
110 | Reaction Tool <= 6.35mm | Fixing the Hydraulic Fluid Reservoir on the Hydraulic Fluid Reservoir Mount | $0.25 | unit | 2 |  |  | $0.50
120 | Assemble, 1kg, Loose | Positioning Distribution Tee and Washer on Distribution Tee Mount | $0.06 | unit | 1 |  |  | $0.06
130 | Ratchet <= 6.35mm | Fixing Distribution Tee and Washer on Distribution Tee Mount | $0.50 | unit | 1 |  |  | $0.50
140 | Reaction Tool <= 6.35mm | Fixing Distribution Tee and Washer on Distribution Tee Mount | $0.25 | unit | 1 |  |  | $0.25
150 | Assemble, 1kg, Line-on-Line | Positioning Adapter (AN7 to AN6) on Master Cylinders | $0.13 | unit | 2 |  |  | $0.26
160 | Ratchet <= 25.4mm | Fixing Adapter (AN7 to AN6) on Master Cylinder | $0.75 | unit | 2 |  |  | $1.50
170 | Assemble, 1kg, Line-on-Line | Positioning Adapter (AN6 right to AN6 left) on Master Cylinder | $0.13 | unit | 2 |  |  | $0.26
180 | Ratchet <= 25.4mm | Fixing Adapter (AN6 right to AN6 left) on Master Cylinder | $0.75 | unit | 2 |  |  | $1.50
190 | Cut (scissors, knife) | Cut Rubber Hose between Hydraulic Fluid Reservoir and Master Cylinder | $0.06 | cm | 1.2 | Repeat - 2 | 2 | $0.14
200 | Saw or tubing cuts | Cut Steel Hose between Master Cylinder and Distribution Tee | $0.40 | cm | 0.645 | Repeat - 2 | 2 | $0.52
210 | Saw or tubing cuts | Cut Steel Hose between Distribution Tee and Caliper | $0.40 | cm | 0.645 | Repeat - 4 | 4 | $1.03
220 | Saw or tubing cuts | Cut Steel Hose between Distribution Tees | $0.40 | cm | 0.645 |  |  | $0.26
230 | Hand, Tight <= 6.35mm | Put the hose in the Banjos and in the Adapters | $0.50 | unit | 12 |  |  | $6.00
240 | Wrench <= 25.4mm | Tighten the Banjos and the Adapters | $1.50 | unit | 12 |  |  | $18.00
250 | Reaction Tool <= 25.4mm | Tighten the Banjos and the Adapters | $0.25 | unit | 12 |  |  | $3.00
260 | Hand, Loose <= 25.4mm | Put Hose between Hydraulic Fluid Reservoir and Master Cylinder | $0.50 | unit | 4 |  |  | $2.00
270 | Install Tie Wrap (Zip Tie, Cable Clamp) | Install clamps on the frame and the A-Arms | $0.09 | unit | 22 |  |  | $1.98
 |  |  |  |  |  |  | Sub Total | $41.73
ItemOrder | Fastener | Use | UnitCost | Size1 | Unit1 | Size2 | Unit2 | Quantity | Sub Total
10 | Bolt, Grade 12.9 | Fixing the M6 Bolt to the Master Cylinder Bearings (through the Brake Pedal) | $0.53 | 6 | mm | 110 | mm | 1 | $0.53
20 | Washer, Grade 12.9 | Fixing the M6 Bolt to the Master Cylinder Bearings (through the Brake Pedal) | $0.02 |  |  |  |  | 2 | $0.04
30 | Nut, Grade 12.9 | Fixing the M6 Bolt to the Master Cylinder Bearings (through the Brake Pedal) | $0.05 | 6 | mm |  |  | 1 | $0.05
40 | Bolt, Grade 8,8 (SAE 5) | Fixing Hydraulic Fluid Reservoir to Hydraulic Fluid Reservoir Mount | $0.18 | 6 | mm | 70 | mm | 1 | $0.18
50 | Nut, Grade 8.8 (SAE 5) | Fixing Hydraulic Fluid Reservoir to Hydraulic Fluid Reservoir Mount | $0.03 | 6 | mm |  |  | 3 | $0.09
60 | Bolt, Grade 8.8 (SAE 5) | Fixing Distribution Tee to Distribution Tee Mount | $0.04 | 6 | mm | 20 | mm | 1 | $0.04
70 | Washer, Grade 8.8 (SAE 5) | Fixing Distribution Tee to Distribution Tee Mount | $0.01 |  |  |  |  | 2 | $0.02
80 | Nut, Grade 8.8 (SAE 5) | Fixing Distribution Tee to Distribution Tee Mount | $0.03 | 6 | mm |  |  | 1 | $0.03
90 | Hose Clamp, Worm Drive | Between Hydraulic Fluid Reservoir and Rubber Hose | $0.55 | 13 | mm |  |  | 2 | $1.10
100 | Tie Wrap | Fix the brake line and the Distribution Tee on the frame | $0.04 |  |  |  |  | 22 | $0.88
 |  |  |  |  |  |  |  | Sub Total | $2.97
ItemOrder | Tooling | Use | UnitCost | Unit | Quantity | PVF | FractionIncluded | Sub Total
10 | Welds - Welding Fixture | Weld the Hydraulic Fluid Reservoir Mount and the Distribution Tee Mount to the frame | 500 | point | 4 | 3000 | 1 | $0.67
 |  |  |  |  |  |  | Sub Total | $0.67

Sheet: BR 03001
University | Ecole Centrale de Lyon |  |  |  |  | Back to BOM |  |  | Car # | 81 |  | Part Cost | $1.07
System | Brake System |  | FileLink1 | Drawing |  |  |  |  |  |  |  | Qty | 1
Assembly | Brake Circuit Assembly |  | FileLink2 |  |  |  |  |  | FileLink1
Part | Hydraulic Fluid Reservoir Mount |  | FileLink3 |  |  |  |  |  | FileLink2 |  |  | Extended Cost | $1.07
P/N Base | BR 03001 |  |  |  |  |  |  |  | FileLink3
Suffix | AA
Details
ItemOrder | Material | Use | UnitCost | Size1 | Unit1 | Size2 | Unit2 | Area Name | Area | Length | Density | Quantity | Sub Total
10 | Steel, Mild |  | $2.25 | 0.014 | kg |  |  | Rectangular area, 40x30mm | 0.001 | 0.0015 | 7850 | 1.00 | $0.03
 |  |  |  |  |  |  |  |  |  |  |  | Sub Total | $0.03
ItemOrder | Process | Use | UnitCost | Unit | Quantity | Multiplier | Mult. Val. | Sub Total
10 | Machining Setup, Install and remove | Setup for laser cut | $1.30 | unit | 1 | 2 parts made from a single machine setup | 0.5 | $0.65
20 | Laser Cut |  | $0.01 | cm | 12.795 | Material - Steel | 3 | $0.38
 |  |  |  |  |  |  | Sub Total | $1.03

Sheet: dBR 03001
Drawing part : | BR 03001

Sheet: BR 03002
University | Ecole Centrale de Lyon |  |  |  |  | Back to BOM |  |  | Car # | 81 |  | Part Cost | $1.01
System | Brake System |  | FileLink1 | Drawing |  |  |  |  |  |  |  | Qty | 1
Assembly | Brake Circuit Assembly |  | FileLink2 |  |  |  |  |  | FileLink1
Part | Distribution Tee Mount |  | FileLink3 |  |  |  |  |  | FileLink2 |  |  | Extended Cost | $1.01
P/N Base | BR 03002 |  |  |  |  |  |  |  | FileLink3
Suffix | AA
Details
ItemOrder | Material | Use | UnitCost | Size1 | Unit1 | Size2 | Unit2 | Area Name | Area | Length | Density | Quantity | Sub Total
10 | Steel, Mild |  | $2.25 | 0.012 | kg |  |  | Rectangular area, 40x25mm | 0.001 | 0.0015 | 7850 | 1.00 | $0.03
 |  |  |  |  |  |  |  |  |  |  |  | Sub Total | $0.03
ItemOrder | Process | Use | UnitCost | Unit | Quantity | Multiplier | Mult. Val. | Sub Total
10 | Machining Setup, Install and remove | Setup for laser cut | $1.30 | unit | 1 | 2 parts made from a single machine setup | 0.5 | $0.65
20 | Laser Cut |  | $0.01 | cm | 11.047 | Material - Steel | 3 | $0.33
 |  |  |  |  |  |  | Sub Total | $0.98

Sheet: dBR 03002
Drawing part : | BR 03002

Sheet: BR 03003
University | Ecole Centrale de Lyon |  |  |  |  | Back to BOM |  |  | Car # | 81 |  | Part Cost | $0.73
System | Brake System |  | FileLink1 | Drawing |  |  |  |  |  |  |  | Qty | 2
Assembly | Brake Circuit Assembly |  | FileLink2 |  |  |  |  |  | FileLink1
Part | Internal Spacer |  | FileLink3 |  |  |  |  |  | FileLink2 |  |  | Extended Cost | $1.45
P/N Base | BR 03003 |  |  |  |  |  |  |  | FileLink3
Suffix | AA
Details | Internal Spacer next to the Master Cylinders
ItemOrder | Material | Use | UnitCost | Size1 | Unit1 | Size2 | Unit2 | Area Name | Area | Length | Density | Quantity | Sub Total
10 | Steel, Alloy |  | $2.25 | 0.010 | kg |  |  |  | 9.5e-05 | 0.014 | 7850 | 1.00 | $0.02
 |  |  |  |  |  |  |  |  |  |  |  | Sub Total | $0.02
ItemOrder | Process | Use | UnitCost | Unit | Quantity | Multiplier | Mult. Val. | Sub Total
10 | Machining Setup, Install and remove |  | $1.30 | unit | 1 | 2 parts cut from a single machine setup | 0.5 | $0.65
20 | Machining |  | $0.04 | cm^3 | 0.432 | Material - Steel | 3 | $0.05
 |  |  |  |  |  |  | Sub Total | $0.70

Sheet: dBR 03003
Drawing Part : | BR 03003

Sheet: BR 03004
University | Ecole Centrale de Lyon |  |  |  |  | Back to BOM |  |  | Car # | 81 |  | Part Cost | $0.67
System | Brake System |  | FileLink1 | Drawing |  |  |  |  |  |  |  | Qty | 2
Assembly | Brake Circuit Assembly |  | FileLink2 |  |  |  |  |  | FileLink1
Part | External Spacer |  | FileLink3 |  |  |  |  |  | FileLink2 |  |  | Extended Cost | $1.33
P/N Base | BR 03004 |  |  |  |  |  |  |  | FileLink3
Suffix | AA
Details | External Spacer next to the Master Cylinders
ItemOrder | Material | Use | UnitCost | Size1 | Unit1 | Size2 | Unit2 | Area Name | Area | Length | Density | Quantity | Sub Total
10 | Steel, Alloy |  | $2.25 | 0.00223725 | kg |  |  |  | 9.5e-05 | 0.003 | 7850 | 1.00 | $0.01
 |  |  |  |  |  |  |  |  |  |  |  | Sub Total | $0.01
ItemOrder | Process | Use | UnitCost | Unit | Quantity | Multiplier | Mult. Val. | Sub Total
10 | Machining Setup, Install and remove |  | $1.30 | unit | 1 | 2 parts cut from a single machine setup | 0.5 | $0.65
20 | Machining |  | $0.04 | cm^3 | 0.097 | Material - Steel | 3 | $0.01
 |  |  |  |  |  |  | Sub Total | $0.66

Sheet: dBR 03004
Drawing Part : | BR 03004
