epsa-team/Vulcanix-v1.0/BR - Brake System/Cost/Cost_BR_CME.xlsx

Sheet: BOM
University | Ecole Centrale de Lyon |  |  |  |  |  |  |  |  |  |  | Total Vehicle Cost |  | #REF!
Competition Code | FSAEI
Year | 2018
Car # | 81 |  | The cost of assemlies on this chart should not include the cost of the parts in the assembly but only the materials, processes, fasteners and tooling in the assembly level.
Line Num. | Area of Commodity | Asm/Prt # | Rev. Lvl. | Asm | Component | Description | Unit Cost | Quantity | Material Cost | Process Cost | Fastener Cost | Tooling Cost | Total Cost | Details Page Number
 | Brake System | BR A0100 | AA |  | Front Brake Rotor |  | $89.74 | 2 | $84.71 | $4.42 | $0.61 | $0.00 | $179.49
 | Brake System | BR 01001 | AA | Front Brake Rotor | Brake Rotor |  | $3.39 | 2 | $1.47 | $1.92 | $0.00 | $0.00 | $6.78
 | Brake System | BR 01002 | AA | Front Brake Rotor | Brake Shrink Disc |  | $6.02 | 2 | $1.89 | $4.13 | $0.00 | $0.00 | $12.04
 | Brake System | BR 01003 | AA | Front Brake Rotor | Brake Bobbin |  | $0.27 | 12 | $0.04 | $0.23 | $0.00 | $0.00 | $3.22
 | Brake System | BR 01004 | AA | Front Brake Rotor | Brake Caliper Spacer |  | $0.28 | 4 | $0.04 | $0.24 | $0.00 | $0.00 | $1.13
 | Brake System | BR A0200 | AA |  | Rear Brake Rotor |  | $89.74 | 2 | $84.71 | $4.42 | $0.61 | $0.00 | $179.49
 | Brake System | BR 02001 | AA | Rear Brake Rotor | Brake Rotor |  | $3.39 | 2 | $1.47 | $1.92 | $0.00 | $0.00 | $6.78
 | Brake System | BR 02002 | AA | Rear Brake Rotor | Brake Shrink Disc |  | $6.15 | 2 | $1.89 | $4.27 | $0.00 | $0.00 | $12.31
 | Brake System | BR 02003 | AA | Rear Brake Rotor | Brake Bobbin |  | $0.27 | 12 | $0.04 | $0.23 | $0.00 | $0.00 | $3.22
 | Brake System | BR 02004 | AA | Rear Brake Rotor | Brake Caliper Spacer |  | $0.28 | 4 | $0.04 | $0.24 | $0.00 | $0.00 | $1.13
 | Brake System | BR A0300 | AA |  | Brake Circuit Assembly |  | $699.63 | 1 | $655.03 | $40.97 | $2.97 | $0.67 | $699.63
 | Brake System | BR 03001 | AA | Brake Circuit Assembly | Hydraulic Fluid Reservoir Mount |  | $1.72 | 1 | $0.03 | $1.68 | $0.00 | $0.00 | $1.72
 | Brake System | BR 03002 | AA | Brake Circuit Assembly | Distribution Tee Mount |  | $1.66 | 1 | $0.03 | $1.63 | $0.00 | $0.00 | $1.66
 | Brake System | BR 03003 | AA | Brake Circuit Assembly | Internal Spacer |  | $0.73 | 2 | $0.02 | $0.70 | $0.00 | $0.00 | $1.45
 | Brake System | BR 03004 | AA | Brake Circuit Assembly | External Spacer |  | $0.67 | 2 | $0.01 | $0.66 | $0.00 | $0.00 | $1.33
 | Brake System |  |  |  | Area Total |  |  |  | $1008.59 | $96.70 | $5.42 | $0.67 | $1111.37

Sheet: BR A0001
University | Ecole Centrale de Lyon |  |  | Back to BOM |  |  |  |  | Car # | 81 |  | Asm Cost | $101.33
System | Brake System |  |  |  |  |  |  |  |  |  |  | Qty | 2
Assembly | Front Brake Rotor |  |  |  |  |  |  |  | FileLink1
P/N Base | BR A0100 |  |  |  |  |  |  |  | FileLink2 |  |  | Extended Cost | $202.65
Suffix | AA |  |  |  |  |  |  |  | FileLink3
Details | Front Brake Rotor assembly
ItemOrder | Part | Part Cost | Quantity | Sub Total
10 | Brake Rotor | $3.39 | 1 | $3.39
20 | Brake Shrink Disc | $6.02 | 1 | $6.02
30 | Brake Bobbin | $0.27 | 6 | $1.61
40 | Brake Caliper Spacer | $0.28 | 2 | $0.56
 |  |  | Sub Total | $11.58
ItemOrder | Material | Use | UnitCost | Size1 | Unit1 | Size2 | Unit2 | Area Name | Area | Length | Density | Quantity | Sub Total
10 | Brake Caliper, Beringer 2D1 | Brake Caliper (in reality Beringer 2P1A is used) | $83.00 |  | unit |  |  |  |  |  |  | 1 | $83.00
20 | Brake Pad, Iron or Steel Rotor | Brake Pad | $0.0002 | 4272.39 | mm^3 |  |  | Circular sector | 0.00142413 | 0.003 |  | 2 | $1.71
 |  |  |  |  |  |  |  |  |  |  |  | Sub Total | $84.71
ItemOrder | Process | Use | UnitCost | Unit | Quantity | Multiplier | Mult. Val. | Sub Total
10 | Assemble, 1kg, Line on Line | Line up Pad | $0.13 | unit | 2 |  |  | $0.26
20 | Assemble, 1kg, Loose | Insert Bobbins and Washer | $0.06 | unit | 6 |  |  | $0.36
30 | Assemble, 1kg, Line on Line | Assemble Brake Rotor and Shrink Disc | $0.13 | unit | 1 |  |  | $0.13
40 | Assemble, 1kg, Line on Line | Insert Retaining Ring | $0.13 | unit | 6 |  |  | $0.78
50 | Assemble, 1kg, Line on Line | Assemble Brake Rotor onto Hub | $0.13 | unit | 1 |  |  | $0.13
60 | Assemble, 1kg, Loose | Put Caliper and Spacer in place | $0.06 | unit | 1 |  |  | $0.06
70 | Ratchet <= 25.4 mm | Bolt Caliper and Spacer on Upright | $0.75 | unit | 2 |  |  | $1.50
80 | Safety Wire, Install | For Caliper Bolts locking device | $0.60 | unit | 2 |  |  | $1.20
 |  |  |  |  |  |  | Sub Total | $4.42
ItemOrder | Fastener | Use | UnitCost | Size1 | Unit1 | Size2 | Unit2 | Quantity | Sub Total
10 | Bolt,Grade 8.8 (SAE) | Bolt Caliper on Upright | $0.12 | 8 | mm | 30 | mm | 2 | $0.24
20 | Washer, Grade 8.8 (SAE 5) | Bolt Caliper on Upright | $0.01 | 8 | mm |  |  | 2 | $0.02
30 | Retaining Ring, External | Secure Brake Bobbin on Brake Rotor | $0.04 | 11.5 | mm |  |  | 6 | $0.24
40 | Washer, Grade 8.8 (SAE 5) | Shim between Brake Bobbin and Brake Rotor | $0.01 | 12 | mm |  |  | 12 | $0.12
 |  |  |  |  |  |  |  | Sub Total | $0.61

Sheet: BR 01001
University | Ecole Centrale de Lyon |  |  |  |  | Back to BOM |  |  | Car # | 81 |  | Part Cost | $3.39
System | Brake System |  | FileLink1 |  |  |  |  |  |  |  |  | Qty | 1
Assembly | Front Brake Rotor |  | FileLink2 |  |  |  |  |  | FileLink1
Part | Brake Rotor |  | FileLink3 |  |  |  |  |  | FileLink2 |  |  | Extended Cost | $3.39
P/N Base | BR 01001 |  |  |  |  |  |  |  | FileLink3
Suffix | AA
Details | Bought, cost as made
ItemOrder | Material | Use | UnitCost | Size1 | Unit1 | Size2 | Unit2 | Area Name | Area | Length | Density | Quantity | Sub Total
10 | Cast Iron (per kg) | Stock material for part | $1.00 | 1.467 | kg |  |  | Circle area, 230mm diameter | 0.042 | 0.004 | 7850 | 1 | $1.47
 |  |  |  |  |  |  |  |  |  |  |  | Sub Total | $1.47
ItemOrder | Process | Use | UnitCost | Unit | Quantity | Multiplier | Mult. Val. | Sub Total
10 | Machining Setup, Install and remove | Setup for laser cut | $1.30 | unit | 1 | 4 parts cut from a single machine setup | 0.25 | $0.33
20 | Laser Cut | Cutout shape | $0.01 | cm | 63.95 | Material - Cast Iron | 2.5 | $1.60
 |  |  |  |  |  |  | Sub Total | $1.92

Sheet: BR 01002
University | Ecole Centrale de Lyon |  |  |  |  | Back to BOM |  |  | Car # | 81 |  | Part Cost | $6.02
System | Brake System |  | FileLink1 | Drawing |  |  |  |  |  |  |  | Qty | 1
Assembly | Front Brake Rotor |  | FileLink2 |  |  |  |  |  | FileLink1
Part | Brake Shrink Disc |  | FileLink3 |  |  |  |  |  | FileLink2 |  |  | Extended Cost | $6.02
P/N Base | BR 01002 |  |  |  |  |  |  |  | FileLink3
Suffix | AA
Details | Allows brake rotor to be mounted floating
ItemOrder | Material | Use | UnitCost | Size1 | Unit1 | Size2 | Unit2 | Area Name | Area | Length | Density | Quantity | Sub Total
10 | Steel, Mild (per kg) | Stock material for part | $2.25 | 0.839 | kg |  |  | Circle Area, 164.95mm diameter | 0.02136950789 | 0.005 | 7850 | 1 | $1.89
 |  |  |  |  |  |  |  |  |  |  |  | Sub Total | $1.89
ItemOrder | Process | Use | UnitCost | Unit | Quantity | Multiplier | Mult. Val. | Sub Total
10 | Machining Setup, Install and remove | Setup for laser cutting | $1.30 | unit | 1 | 4 parts cut from a single machine setup | 0.25 | $0.33
20 | Laser Cut | Cutout shape | $0.01 | cm | 126.9 | Material - Steel | 3 | $3.81
 |  |  |  |  |  |  | Sub Total | $4.13

Sheet: dBR 01002
Drawing part : | BR 01002

Sheet: BR 01003
University | Ecole Centrale de Lyon |  |  |  |  | Back to BOM |  |  | Car # | 81 |  | Part Cost | $0.27
System | Brake System |  | FileLink1 |  |  |  |  |  |  |  |  | Qty | 6
Assembly | Front Brake Rotor |  | FileLink2 |  |  |  |  |  | FileLink1
Part | Brake Bobbin |  | FileLink3 |  |  |  |  |  | FileLink2 |  |  | Extended Cost | $1.61
P/N Base | BR 01003 |  |  |  |  |  |  |  | FileLink3
Suffix | AA
Details | Bobbins between Brake Rotor and Brake Shrink Disc
ItemOrder | Material | Use | UnitCost | Size1 | Unit1 | Size2 | Unit2 | Area Name | Area | Length | Density | Quantity | Sub Total
10 | Steel, Mild (per kg) | Material for Bobbin | $2.25 | 0.016 | kg |  |  | Circle Area, 17mm diameter | 0.00022698 | 0.009 | 7850 | 1 | $0.04
 |  |  |  |  |  |  |  |  |  |  |  | Sub Total | $0.04
ItemOrder | Process | Use | UnitCost | Unit | Quantity | Multiplier | Mult. Val. | Sub Total
10 | Machining Setup, Install and remove | Setup for machining | $1.30 | unit | 1 | 24 parts made from one machining setup | 0.04 | $0.05
20 | Machining |  | $0.04 | cm^3 | 1.486 | Material - Steel | 3 | $0.18
 |  |  |  |  |  |  | Sub Total | $0.23

Sheet: BR 01004
University | Ecole Centrale de Lyon |  |  |  |  | Back to BOM |  |  | Car # | 81 |  | Part Cost | $0.28
System | Brake System |  | FileLink1 | Drawing |  |  |  |  |  |  |  | Qty | 2
Assembly | Front Brake Rotor |  | FileLink2 |  |  |  |  |  | FileLink1
Part | Brake Caliper Spacer |  | FileLink3 |  |  |  |  |  | FileLink2 |  |  | Extended Cost | $0.56
P/N Base | BR 01004 |  |  |  |  |  |  |  | FileLink3
Suffix | AA
Details | Spacer between Caliper and Upright
ItemOrder | Material | Use | UnitCost | Size1 | Unit1 | Size2 | Unit2 | Area Name | Area | Length | Density | Quantity | Sub Total
10 | Steel, Mild (per kg) | Stock material for caliper spacer | $2.25 | 0.018 | kg |  |  | Circular, 17mm diameter | 0.0002269800692 | 0.010 | 7850 | 1 | $0.04
 |  |  |  |  |  |  |  |  |  |  |  | Sub Total | $0.04
ItemOrder | Process | Use | UnitCost | Unit | Quantity | Multiplier | Mult. Val. | Sub Total
10 | Machining Setup, Install and remove | Setup for laser cut | $1.30 | unit | 1 | 8 parts cut from a single machine setup | 0.125 | $0.16
20 | Laser Cut | Cutout shape | $0.01 | cm | 2.639 | Material - Steel | 3 | $0.08
 |  |  |  |  |  |  | Sub Total | $0.24

Sheet: dBR 01004
Drawing part : | BR 01004

Sheet: BR A0002
University | Ecole Centrale de Lyon |  |  | Back to BOM |  |  |  |  | Car # | 81 |  | Asm Cost | $101.46
System | Brake System |  |  |  |  |  |  |  |  |  |  | Qty | 2
Assembly | Rear Brake Rotor |  |  |  |  |  |  |  | FileLink1
P/N Base | BR A0200 |  |  |  |  |  |  |  | FileLink2 |  |  | Extended Cost | $202.92
Suffix | AA |  |  |  |  |  |  |  | FileLink3
Details | Rear Brake Rotor assembly
ItemOrder | Part | Part Cost | Quantity | Sub Total
10 | Brake Rotor | $3.39 | 1 | $3.39
20 | Brake Shrink Disc | $6.15 | 1 | $6.15
30 | Brake Bobbin | $0.27 | 6 | $1.61
40 | Brake Caliper Spacer | $0.28 | 2 | $0.56
 |  |  | Sub Total | $11.72
ItemOrder | Material | Use | UnitCost | Size1 | Unit1 | Size2 | Unit2 | Area Name | Area | Length | Density | Quantity | Sub Total
10 | Brake Caliper, Beringer 2D1 | Brake Caliper (in reality Beringer 2P1A is used) | $83.00 |  | unit |  |  |  |  |  |  | 1 | $83.00
20 | Brake Pad, Iron or Steel Rotor | Brake Pad | $0.0002 | 4272.39 | mm^3 |  |  | Circular sector | 0.00142413 | 0.003 |  | 2 | $1.71
 |  |  |  |  |  |  |  |  |  |  |  | Sub Total | $84.71
ItemOrder | Process | Use | UnitCost | Unit | Quantity | Multiplier | Mult. Val. | Sub Total
10 | Assemble, 1kg, Line on Line | Line up Pad | $0.13 | unit | 2 |  |  | $0.26
> | Assemble, 1kg, Loose | Insert Bobbins and Washer | $0.06 | unit | 6 |  |  | $0.36
30 | Assemble, 1kg, Line on Line | Assemble Brake Rotor and Shrink Disc | $0.13 | unit | 1 |  |  | $0.13
40 | Assemble, 1kg, Line on Line | Insert Retaining Ring | $0.13 | unit | 6 |  |  | $0.78
50 | Assemble, 1kg, Line on Line | Assemble Brake Rotor onto Hub | $0.13 | unit | 1 |  |  | $0.13
60 | Assemble, 1kg, Loose | Put Caliper and Spacer in place | $0.06 | unit | 1 |  |  | $0.06
70 | Ratchet <= 25.4 mm | Bolt Caliper and Spacer on Upright | $0.75 | unit | 2 |  |  | $1.50
80 | Safety Wire, Install | For Caliper Bolts locking device | $0.60 | unit | 2 |  |  | $1.20
 |  |  |  |  |  |  | Sub Total | $4.42
ItemOrder | Fastener | Use | UnitCost | Size1 | Unit1 | Size2 | Unit2 | Quantity | Sub Total
10 | Bolt,Grade 8.8 (SAE) | Bolt Caliper on Upright | $0.12 | 8 | mm | 30 | mm | 2 | $0.24
20 | Washer, Grade 8.8 (SAE 5) | Bolt Caliper on Upright | $0.01 | 8 | mm |  |  | 2 | $0.02
30 | Retaining Ring, External | Secure Brake Bobbin on Brake Rotor | $0.04 | 11.5 | mm |  |  | 6 | $0.24
40 | Washer, Grade 8.8 (SAE 5) | Shim between Brake Bobbin and Brake Rotor | $0.01 | 12 | mm |  |  | 12 | $0.12
 |  |  |  |  |  |  |  | Sub Total | $0.61

Sheet: BR 02001
University | Ecole Centrale de Lyon |  |  |  |  | Back to BOM |  |  | Car # | 81 |  | Part Cost | $3.39
System | Brake System |  | FileLink1 |  |  |  |  |  |  |  |  | Qty | 1
Assembly | Rear Brake Rotor |  | FileLink2 |  |  |  |  |  | FileLink1
Part | Brake Rotor |  | FileLink3 |  |  |  |  |  | FileLink2 |  |  | Extended Cost | $3.39
P/N Base | BR 02001 |  |  |  |  |  |  |  | FileLink3
Suffix | AA
Details | Bought, cost as made
ItemOrder | Material | Use | UnitCost | Size1 | Unit1 | Size2 | Unit2 | Area Name | Area | Length | Density | Quantity | Sub Total
10 | Cast Iron (per kg) | Stock material for part | $1.00 | 1.467 | kg |  |  | Circle area, 230mm diameter | 0.042 | 0.004 | 7850 | 1 | $1.47
 |  |  |  |  |  |  |  |  |  |  |  | Sub Total | $1.47
ItemOrder | Process | Use | UnitCost | Unit | Quantity | Multiplier | Mult. Val. | Sub Total
10 | Machining Setup, Install and remove | Setup for laser cut | $1.30 | unit | 1 | 4 parts cut from a single machine setup | 0.25 | $0.33
20 | Laser Cut | Cutout shape | $0.01 | cm | 63.95 | Material - Cast Iron | 2.5 | $1.60
 |  |  |  |  |  |  | Sub Total | $1.92

Sheet: BR 02002
University | Ecole Centrale de Lyon |  |  |  |  | Back to BOM |  |  | Car # | 81 |  | Part Cost | $6.15
System | Brake System |  | FileLink1 | Drawing |  |  |  |  |  |  |  | Qty | 1
Assembly | Rear Brake Rotor |  | FileLink2 |  |  |  |  |  | FileLink1
Part | Brake Shrink Disc |  | FileLink3 |  |  |  |  |  | FileLink2 |  |  | Extended Cost | $6.15
P/N Base | BR 02002 |  |  |  |  |  |  |  | FileLink3
Suffix | AA
Details | Allows brake rotor to be mounted floating
ItemOrder | Material | Use | UnitCost | Size1 | Unit1 | Size2 | Unit2 | Area Name | Area | Length | Density | Quantity | Sub Total
10 | Steel, Mild (per kg) | Stock material for part | $2.25 | 0.839 | kg |  |  | Circle Area, 164.95mm diameter | 0.02136950789 | 0.005 | 7850 | 1 | $1.89
 |  |  |  |  |  |  |  |  |  |  |  | Sub Total | $1.89
ItemOrder | Process | Use | UnitCost | Unit | Quantity | Multiplier | Mult. Val. | Sub Total
10 | Machining Setup, Install and remove | Setup for laser cutting | $1.30 | unit | 1 | 4 parts cut from a single machine setup | 0.25 | $0.33
20 | Laser Cut | Cutout shape | $0.01 | cm | 131.4 | Material - Steel | 3 | $3.94
 |  |  |  |  |  |  | Sub Total | $4.27

Sheet: dBR 02002
Drawing part : | BR 02002

Sheet: BR 02003
University | Ecole Centrale de Lyon |  |  |  |  | Back to BOM |  |  | Car # | 81 |  | Part Cost | $0.27
System | Brake System |  | FileLink1 |  |  |  |  |  |  |  |  | Qty | 6
Assembly | Rear Brake Rotor |  | FileLink2 |  |  |  |  |  | FileLink1
Part | Brake Bobbin |  | FileLink3 |  |  |  |  |  | FileLink2 |  |  | Extended Cost | $1.61
P/N Base | BR 02003 |  |  |  |  |  |  |  | FileLink3
Suffix | AA
Details | Bobbins between Brake Rotor and Brake Shrink Disc
ItemOrder | Material | Use | UnitCost | Size1 | Unit1 | Size2 | Unit2 | Area Name | Area | Length | Density | Quantity | Sub Total
10 | Steel, Mild (per kg) | Material for Bobbin | $2.25 | 0.016 | kg |  |  | Circle Area, 17mm diameter | 0.00022698 | 0.009 | 7850 | 1 | $0.04
 |  |  |  |  |  |  |  |  |  |  |  | Sub Total | $0.04
ItemOrder | Process | Use | UnitCost | Unit | Quantity | Multiplier | Mult. Val. | Sub Total
10 | Machining Setup, Install and remove | Setup for machining | $1.30 | unit | 1 | 24 parts made from one machining setup | 0.04 | $0.05
20 | Machining |  | $0.04 | cm^3 | 1.486 | Material - Steel | 3 | $0.18
 |  |  |  |  |  |  | Sub Total | $0.23

Sheet: BR 02004
University | Ecole Centrale de Lyon |  |  |  |  | Back to BOM |  |  | Car # | 81 |  | Part Cost | $0.28
System | Brake System |  | FileLink1 | Drawing |  |  |  |  |  |  |  | Qty | 2
Assembly | Rear Brake Rotor |  | FileLink2 |  |  |  |  |  | FileLink1
Part | Brake Caliper Spacer |  | FileLink3 |  |  |  |  |  | FileLink2 |  |  | Extended Cost | $0.56
P/N Base | BR 02004 |  |  |  |  |  |  |  | FileLink3
Suffix | AA
Details | Spacer between Caliper and Upright
ItemOrder | Material | Use | UnitCost | Size1 | Unit1 | Size2 | Unit2 | Area Name | Area | Length | Density | Quantity | Sub Total
10 | Steel, Mild (per kg) | Stock material for caliper spacer | $2.25 | 0.018 | kg |  |  | Circular, 17mm diameter | 0.0002269800692 | 0.010 | 7850 | 1 | $0.04
 |  |  |  |  |  |  |  |  |  |  |  | Sub Total | $0.04
ItemOrder | Process | Use | UnitCost | Unit | Quantity | Multiplier | Mult. Val. | Sub Total
10 | Machining Setup, Install and remove | Setup for laser cut | $1.30 | unit | 1 | 8 parts cut from a single machine setup | 0.125 | $0.16
20 | Laser Cut | Cutout shape | $0.01 | cm | 2.639 | Material - Steel | 3 | $0.08
 |  |  |  |  |  |  | Sub Total | $0.24

Sheet: dBR 02004
Drawing part : | BR 02004

Sheet: BR A0003
University | Ecole Centrale de Lyon |  |  | Back to BOM |  |  |  |  | Car # | 81 |  | Asm Cost | $705.13
System | Brake System |  |  |  |  |  |  |  |  |  |  | Qty | 1
Assembly | Brake Circuit Assembly |  |  |  |  |  |  |  | FileLink1
P/N Base | BR A0300 |  |  |  |  |  |  |  | FileLink2 |  |  | Extended Cost | $705.13
Suffix | AA |  |  |  |  |  |  |  | FileLink3
Details | Brake line assembly
ItemOrder | Part | Part Cost | Quantity | Sub Total
10 | Hydraulic Fluid Reservoir Mount | $1.72 | 1 | $1.72
20 | Distribution Tee Mount | $1.66 | 1 | $1.66
30 | Internal Spacer | $0.73 | 2 | $1.45
40 | External Spacer | $0.67 | 2 | $1.33
 |  |  | Sub Total | $6.16
ItemOrder | Material | Use | UnitCost | Size1 | Unit1 | Size2 | Unit2 | Area Name | Area | Length | Density | Quantity | Sub Total
10 | Master Cylinder, AP, CP7855 | Master cylinder | $174.50 |  |  |  |  |  |  |  |  | 2 | $349.00
20 | Balance Bar, Tilton 72-250 | Balance bar | $30.00 |  |  |  |  |  |  |  |  | 1 | $30.00
30 | Hydraulic Fluid Reservoir, Remote (Plastic) | Fluid reservoir | $5.00 |  |  |  |  |  |  |  |  | 2 | $10.00
40 | Brake Light Pressure Switch Banjo Bolt | Brake light switch | $8.00 |  |  |  |  |  |  |  |  | 1 | $8.00
50 | Hose, High Pressure, Stainless Steel Braided Outer | Brake line - GOODRIDGE's braking hose 6003 serie | $13.22 | 6.45 | mm |  |  |  |  |  |  | 4.8 | $63.46
60 | Hose, Rubber (per m) | Brake line - Hose between Master Cylinder and Fluid Reservoir | $2.16 | 12 | mm |  |  |  |  |  |  | 0.5 | $1.08
70 | Adapter/L.P./Union//Aluminum/Anodized | Brake line - AN7 to AN6 | $2.42 | 11.11 | mm | 9.53 | mm |  |  |  |  | 2 | $4.83
80 | Adapter/L.P./Union//Aluminum/Anodized | Brake line - AN6 right to AN6 left | $2.32 | 9.53 | mm | 9.53 | mm |  |  |  |  | 2 | $4.64
90 | Fitting/L.P./Straight/Aluminum/Anodized | Brake line - GOODRIDGE's braking hose AN6 end | $6.49 | 9.53 | mm |  |  |  |  |  |  | 6 | $38.96
100 | Fitting/L.P./Elbow/45 deg./Aluminum/Anodized | Brake line - GOODRIDGE's braking hose AN6 end | $17.42 | 9.53 | mm |  |  |  |  |  |  | 2 | $34.84
110 | Adapter/L.P./Union//Aluminum/Anodized | Brake line - AN6 to 10mm | $2.35 | 9.53 | mm | 10 | mm |  |  |  |  | 6 | $14.10
120 | Adapter/L.P./Female Flare Tee//Brass | Brake line - Splitter Tee | $3.67 | 10 | mm | 6.45 | mm |  |  |  |  | 2 | $7.33
130 | Banjo Fitting, 45 Deg., Steel | Brake line | $16.93 | 6.45 | mm |  |  |  |  |  |  | 4 | $67.73
140 | Banjo Bolt, Steel | Brake line | $4.39 | 6.45 | mm |  |  |  |  |  |  | 4 | $17.54
150 | Crush Washer | Brake line | $0.28 | 6 | mm |  |  |  |  |  |  | 12 | $3.38
160 | Fluid, Oil | Braking fluid | $0.11 | 0.15 | L |  |  |  |  |  |  | 1 | $0.11
170 | Paint | Protect steel tab from rust | $10.00 | 0.0024 | m^2 |  |  |  |  |  |  | 0.0024 | $0.02
 |  |  |  |  |  |  |  |  |  |  |  | Sub Total | $655.03
ItemOrder | Process | Use | UnitCost | Unit | Quantity | Multiplier | Mult. Val. | Sub Total
10 | Weld | Welding the Hydraulic Fluid Reservoir Mount | $0.15 | cm | 2.8 |  |  | $0.42
20 | Weld | Welding the Distribution Tee Mount | $0.15 | cm | 2.3 |  |  | $0.34
30 | Aerosol Apply | Painting for the Mounts | $5.25 | m^2 | 0.0024 |  |  | $0.01
40 | Assemble, 1kg, Loose | Positioning the Balance Bar on the Brake Pedal Supports | $0.06 | unit | 1 |  |  | $0.06
50 | Hand, Loose <= 6.35mm | Fixing the Master Cylinder on the Balance Bar | $0.25 | unit | 2 |  |  | $0.50
60 | Assemble, 1kg, Loose | Positioning the M6 Bolt through the Master Cylinder bearings, the Internal Spacers, the External Spacers and the Brake Pedal | $0.06 | unit | 1 |  |  | $0.06
70 | Ratchet <= 6,35mm | Fixing the Bolt to the Master Cylinder Bearings (through the Brake Pedal) | $0.50 | unit | 1 |  |  | $0.50
80 | Reaction Tool <= 6.35mm | Fixing the Bolt to the Master Cylinder Bearings (through the Brake Pedal) | $0.25 | unit | 1 |  |  | $0.25
90 | Assemble, 1kg, Loose | Positioning the Hydraulic Fluid Reservoirs on the Hydraulic Fluid Reservoir Mount | $0.06 | unit | 1 |  |  | $0.06
100 | Ratchet <= 6.35mm | Fixing the Hydraulic Fluid Reservoir on the Hydraulic Fluid Reservoir Mount | $0.50 | unit | 2 |  |  | $1.00
110 | Reaction Tool <= 6.35mm | Fixing the Hydraulic Fluid Reservoir on the Hydraulic Fluid Reservoir Mount | $0.25 | unit | 2 |  |  | $0.50
120 | Assemble, 1kg, Loose | Positioning Distribution Tee and Washer on Distribution Tee Mount | $0.06 | unit | 1 |  |  | $0.06
130 | Ratchet <= 6.35mm | Fixing Distribution Tee and Washer on Distribution Tee Mount | $0.50 | unit | 1 |  |  | $0.50
140 | Reaction Tool <= 6.35mm | Fixing Distribution Tee and Washer on Distribution Tee Mount | $0.25 | unit | 1 |  |  | $0.25
150 | Assemble, 1kg, Line-on-Line | Positioning Adapter (AN7 to AN6) on Master Cylinders | $0.13 | unit | 2 |  |  | $0.26
160 | Ratchet <= 25.4mm | Fixing Adapter (AN7 to AN6) on Master Cylinder | $0.75 | unit | 2 |  |  | $1.50
170 | Assemble, 1kg, Line-on-Line | Positioning Adapter (AN6 right to AN6 left) on Master Cylinder | $0.13 | unit | 2 |  |  | $0.26
180 | Ratchet <= 25.4mm | Fixing Adapter (AN6 right to AN6 left) on Master Cylinder | $0.75 | unit | 2 |  |  | $1.50
190 | Cut (scissors, knife) | Cut Rubber Hose between Hydraulic Fluid Reservoir and Master Cylinder | $0.06 | cm | 1.2 | Repeat - 2 | 2 | $0.14
200 | Saw or tubing cuts | Cut Steel Hose between Master Cylinder and Distribution Tee | $0.40 | cm | 0.645 | Repeat - 2 | 2 | $0.52
210 | Saw or tubing cuts | Cut Steel Hose between Distribution Tee and Caliper | $0.40 | cm | 0.645 | Repeat - 4 | 4 | $1.03
220 | Saw or tubing cuts | Cut Steel Hose between Distribution Tees | $0.40 | cm | 0.645 |  |  | $0.26
230 | Hand, Tight <= 6.35mm | Put the hose in the Banjos and in the Adapters | $0.50 | unit | 12 |  |  | $6.00
240 | Wrench <= 25.4mm | Tighten the Banjos and the Adapters | $1.50 | unit | 12 |  |  | $18.00
250 | Reaction Tool <= 25.4mm | Tighten the Banjos and the Adapters | $0.25 | unit | 12 |  |  | $3.00
260 | Hand, Loose <= 25.4mm | Put Hose between Hydraulic Fluid Reservoir and Master Cylinder | $0.50 | unit | 4 |  |  | $2.00
270 | Install Tie Wrap (Zip Tie, Cable Clamp) | Install clamps on the frame and the A-Arms | $0.09 | unit | 22 |  |  | $1.98
 |  |  |  |  |  |  | Sub Total | $40.97
ItemOrder | Fastener | Use | UnitCost | Size1 | Unit1 | Size2 | Unit2 | Quantity | Sub Total
10 | Bolt, Grade 12.9 | Fixing the M6 Bolt to the Master Cylinder Bearings (through the Brake Pedal) | $0.53 | 6 | mm | 110 | mm | 1 | $0.53
20 | Washer, Grade 12.9 | Fixing the M6 Bolt to the Master Cylinder Bearings (through the Brake Pedal) | $0.02 |  |  |  |  | 2 | $0.04
30 | Nut, Grade 12.9 | Fixing the M6 Bolt to the Master Cylinder Bearings (through the Brake Pedal) | $0.05 | 6 | mm |  |  | 1 | $0.05
40 | Bolt, Grade 8,8 (SAE 5) | Fixing Hydraulic Fluid Reservoir to Hydraulic Fluid Reservoir Mount | $0.18 | 6 | mm | 70 | mm | 1 | $0.18
50 | Nut, Grade 8.8 (SAE 5) | Fixing Hydraulic Fluid Reservoir to Hydraulic Fluid Reservoir Mount | $0.03 | 6 | mm |  |  | 3 | $0.09
60 | Bolt, Grade 8.8 (SAE 5) | Fixing Distribution Tee to Distribution Tee Mount | $0.04 | 6 | mm | 20 | mm | 1 | $0.04
70 | Washer, Grade 8.8 (SAE 5) | Fixing Distribution Tee to Distribution Tee Mount | $0.01 |  |  |  |  | 2 | $0.02
80 | Nut, Grade 8.8 (SAE 5) | Fixing Distribution Tee to Distribution Tee Mount | $0.03 | 6 | mm |  |  | 1 | $0.03
90 | Hose Clamp, Worm Drive | Between Hydraulic Fluid Reservoir and Rubber Hose | $0.55 | 13 | mm |  |  | 2 | $1.10
100 | Tie Wrap | Fix the brake line and the Distribution Tee on the frame | $0.04 |  |  |  |  | 22 | $0.88
 |  |  |  |  |  |  |  | Sub Total | $2.97
ItemOrder | Tooling | Use | UnitCost | Unit | Quantity | PVF | FractionIncluded | Sub Total
10 | Welds - Welding Fixture | Weld the Hydraulic Fluid Reservoir Mount and the Distribution Tee Mount to the frame | 500 | point | 4 | 3000 | 1 | $0.67
 |  |  |  |  |  |  | Sub Total | $0.67

Sheet: BR 03001
University | Ecole Centrale de Lyon |  |  |  |  | Back to BOM |  |  | Car # | 81 |  | Part Cost | $1.72
System | Brake System |  | FileLink1 | Drawing |  |  |  |  |  |  |  | Qty | 1
Assembly | Brake Circuit Assembly |  | FileLink2 |  |  |  |  |  | FileLink1
Part | Hydraulic Fluid Reservoir Mount |  | FileLink3 |  |  |  |  |  | FileLink2 |  |  | Extended Cost | $1.72
P/N Base | BR 03001 |  |  |  |  |  |  |  | FileLink3
Suffix | AA
Details
ItemOrder | Material | Use | UnitCost | Size1 | Unit1 | Size2 | Unit2 | Area Name | Area | Length | Density | Quantity | Sub Total
10 | Steel, Mild |  | $2.25 | 0.014 | kg |  |  | Rectangular area, 40x30mm | 0.0012 | 0.0015 | 7850 | 1 | $0.03
 |  |  |  |  |  |  |  |  |  |  |  | Sub Total | $0.03
ItemOrder | Process | Use | UnitCost | Unit | Quantity | Multiplier | Mult. Val. | Sub Total
10 | Machining Setup, Install and remove | Setup for laser cut | $1.30 | unit | 1 |  | 1 | $1.30
20 | Laser Cut |  | $0.01 | cm | 12.795 | Material - Steel | 3 | $0.38
 |  |  |  |  |  |  | Sub Total | $1.68

Sheet: dBR 03001
Drawing part : | BR 03001

Sheet: BR 03002
University | Ecole Centrale de Lyon |  |  |  |  | Back to BOM |  |  | Car # | 81 |  | Part Cost | $1.66
System | Brake System |  | FileLink1 | Drawing |  |  |  |  |  |  |  | Qty | 1
Assembly | Brake Circuit Assembly |  | FileLink2 |  |  |  |  |  | FileLink1
Part | Distribution Tee Mount |  | FileLink3 |  |  |  |  |  | FileLink2 |  |  | Extended Cost | $1.66
P/N Base | BR 03002 |  |  |  |  |  |  |  | FileLink3
Suffix | AA
Details
ItemOrder | Material | Use | UnitCost | Size1 | Unit1 | Size2 | Unit2 | Area Name | Area | Length | Density | Quantity | Sub Total
10 | Steel, Mild |  | $2.25 | 0.012 | kg |  |  | Rectangular area, 40x25mm | 0.001 | 0.0015 | 7850 | 1.00 | $0.03
 |  |  |  |  |  |  |  |  |  |  |  | Sub Total | $0.03
ItemOrder | Process | Use | UnitCost | Unit | Quantity | Multiplier | Mult. Val. | Sub Total
10 | Machining Setup, Install and remove | Setup for laser cut | $1.30 | unit | 1 |  | 1 | $1.30
20 | Laser Cut |  | $0.01 | cm | 11.047 | Material - Steel | 3 | $0.33
 |  |  |  |  |  |  | Sub Total | $1.63

Sheet: dBR 03002
Drawing part : | BR 03002

Sheet: BR 03003
University | Ecole Centrale de Lyon |  |  |  |  | Back to BOM |  |  | Car # | 81 |  | Part Cost | $0.73
System | Brake System |  | FileLink1 | Drawing |  |  |  |  |  |  |  | Qty | 2
Assembly | Brake Circuit Assembly |  | FileLink2 |  |  |  |  |  | FileLink1
Part | Internal Spacer |  | FileLink3 |  |  |  |  |  | FileLink2 |  |  | Extended Cost | $1.45
P/N Base | BR 03003 |  |  |  |  |  |  |  | FileLink3
Suffix | AA
Details | Internal Spacer next to the Master Cylinders
ItemOrder | Material | Use | UnitCost | Size1 | Unit1 | Size2 | Unit2 | Area Name | Area | Length | Density | Quantity | Sub Total
10 | Steel, Alloy |  | $2.25 | 0.010 | kg |  |  |  | 9.5e-05 | 0.014 | 7850 | 1 | $0.02
 |  |  |  |  |  |  |  |  |  |  |  | Sub Total | $0.02
ItemOrder | Process | Use | UnitCost | Unit | Quantity | Multiplier | Mult. Val. | Sub Total
10 | Machining Setup, Install and remove |  | $1.30 | unit | 1 | 2 parts cut from a single machine setup | 0.5 | $0.65
20 | Machining |  | $0.04 | cm^3 | 0.432 | Material - Steel | 3 | $0.05
 |  |  |  |  |  |  | Sub Total | $0.70

Sheet: dBR 03003
Drawing Part : | BR 03003

Sheet: BR 03004
University | Ecole Centrale de Lyon |  |  |  |  | Back to BOM |  |  | Car # | 81 |  | Part Cost | $0.67
System | Brake System |  | FileLink1 | Drawing |  |  |  |  |  |  |  | Qty | 2
Assembly | Brake Circuit Assembly |  | FileLink2 |  |  |  |  |  | FileLink1
Part | External Spacer |  | FileLink3 |  |  |  |  |  | FileLink2 |  |  | Extended Cost | $1.33
P/N Base | BR 03004 |  |  |  |  |  |  |  | FileLink3
Suffix | AA
Details | External Spacer next to the Master Cylinders
ItemOrder | Material | Use | UnitCost | Size1 | Unit1 | Size2 | Unit2 | Area Name | Area | Length | Density | Quantity | Sub Total
10 | Steel, Alloy |  | $2.25 | 0.00223725 | kg |  |  |  | 9.5e-05 | 0.003 | 7850 | 1 | $0.01
 |  |  |  |  |  |  |  |  |  |  |  | Sub Total | $0.01
ItemOrder | Process | Use | UnitCost | Unit | Quantity | Multiplier | Mult. Val. | Sub Total
10 | Machining Setup, Install and remove |  | $1.30 | unit | 1 | 2 parts cut from a single machine setup | 0.5 | $0.65
20 | Machining |  | $0.04 | cm^3 | 0.097 | Material - Steel | 3 | $0.01
 |  |  |  |  |  |  | Sub Total | $0.66

Sheet: dBR 03004
Drawing Part : | BR 03004
