epsa-team/Vulcanix-v1.0/Cost Report/Cost final/081_EcoleCentraleDeLyon_FSAEI_CR_BOM.xlsx

Sheet: Table of Contents
Table of contents
for: | Ecole Centrale de Lyon
 | Car # 81
Cost Summary |  | 3
BOM |  | 5
Brake System |  | 11
Engine and Drivetrain |  | 36
Frame & Body |  | 158
Electrical |  | 238
Miscellaneous, Finish and Assembly |  | 268
Steering System |  | 299
Suspension System |  | 339
Wheels, Wheel Bearings and Tires |  | 488

Sheet: Cost Summary
Cost Summary Basics
for: | Ecole Centrale de Lyon
 | 81
Area Totals |  | Materials | Processes | Fasteners | Tooling | Total
 | Brake System | $1008.59 | $96.70 | $5.42 | $0.67 | $1111.37
 | Engine & Drivetrain | $2652.40 | $1465.86 | $54.23 | $32.70 | $4205.19
 | Frame & Body | $476.00 | $1709.98 | $85.03 | $196.21 | $2467.22
 | Electrical | $1603.70 | $320.54 | $2.73 | $5.33 | $1932.30
 | Miscellaneous, Finish & Assembly | $101.75 | $173.21 | $6.95 | $12.53 | $294.44
 | Steering System | $166.39 | $170.60 | $2.20 | $3.33 | $342.53
 | Suspension System | $1865.80 | $924.03 | $12.84 | $14.67 | $2817.33
 | Wheels, Wheel Bearings & Tires | $1636.97 | $306.75 | $23.45 | $0.00 | $1967.17
 | Total Vehicle | $9511.59 | $5167.68 | $192.84 | $265.45 | $15137.55
Composition for total vehicle:

Sheet: BOM
University | Ecole Centrale de Lyon |  |  |  |  |  |  |  |  |  |  | Total Vehicle Cost |  | 15137.55
Competition Code | FSAEI
Year | 2018
Car # | 81 |  | The cost of assemlies on this chart should not include the cost of the parts in the assembly but only the materials, processes, fasteners and tooling in the assembly level.
Line Num. | Area of Commodity | Asm/Prt # | Rev. Lvl. | Asm | Component | Description | Unit Cost | Quantity | Material Cost | Process Cost | Fastener Cost | Tooling Cost | Total Cost | Details Page Number
 | Brake System | BR A0100 | AA |  | Front Brake Rotor |  | $89.74 | 2 | $84.71 | $4.42 | $0.61 | $0.00 | $179.49 | 12
 | Brake System | BR 01001 | AA | Front Brake Rotor | Brake Rotor |  | $3.39 | 2 | $1.47 | $1.92 | $0.00 | $0.00 | $6.78 | 13
 | Brake System | BR 01002 | AA | Front Brake Rotor | Brake Shrink Disc |  | $6.02 | 2 | $1.89 | $4.13 | $0.00 | $0.00 | $12.04 | 14
 | Brake System | BR 01003 | AA | Front Brake Rotor | Brake Bobbin |  | $0.27 | 12 | $0.04 | $0.23 | $0.00 | $0.00 | $3.22 | 16
 | Brake System | BR 01004 | AA | Front Brake Rotor | Brake Caliper Spacer |  | $0.28 | 4 | $0.04 | $0.24 | $0.00 | $0.00 | $1.13 | 17
 | Brake System | BR A0200 | AA |  | Rear Brake Rotor |  | $89.74 | 2 | $84.71 | $4.42 | $0.61 | $0.00 | $179.49 | 19
 | Brake System | BR 02001 | AA | Rear Brake Rotor | Brake Rotor |  | $3.39 | 2 | $1.47 | $1.92 | $0.00 | $0.00 | $6.78 | 20
 | Brake System | BR 02002 | AA | Rear Brake Rotor | Brake Shrink Disc |  | $6.15 | 2 | $1.89 | $4.27 | $0.00 | $0.00 | $12.31 | 21
 | Brake System | BR 02003 | AA | Rear Brake Rotor | Brake Bobbin |  | $0.27 | 12 | $0.04 | $0.23 | $0.00 | $0.00 | $3.22 | 23
 | Brake System | BR 02004 | AA | Rear Brake Rotor | Brake Caliper Spacer |  | $0.28 | 4 | $0.04 | $0.24 | $0.00 | $0.00 | $1.13 | 24
 | Brake System | BR A0300 | AA |  | Brake Circuit Assembly |  | $699.63 | 1 | $655.03 | $40.97 | $2.97 | $0.67 | $699.63 | 26
 | Brake System | BR 03001 | AA | Brake Circuit Assembly | Hydraulic Fluid Reservoir Mount |  | $1.72 | 1 | $0.03 | $1.68 | $0.00 | $0.00 | $1.72 | 28
 | Brake System | BR 03002 | AA | Brake Circuit Assembly | Distribution Tee Mount |  | $1.66 | 1 | $0.03 | $1.63 | $0.00 | $0.00 | $1.66 | 30
 | Brake System | BR 03003 | AA | Brake Circuit Assembly | Internal Spacer |  | $0.73 | 2 | $0.02 | $0.70 | $0.00 | $0.00 | $1.45 | 32
 | Brake System | BR 03004 | AA | Brake Circuit Assembly | External Spacer |  | $0.67 | 2 | $0.01 | $0.66 | $0.00 | $0.00 | $1.33 | 34
 | Brake System |  |  |  | Area Total |  |  |  | $1008.59 | $96.70 | $5.42 | $0.67 | $1111.37
 | Engine & Drivetrain | EN A0100 | AA |  | Engine |  | $1582.99 | 1 | 1500.213344 | 76.37798285 | 5.735020272 | 0.6666666667 | $1582.99 | 37
 | Engine & Drivetrain | EN 01001 | AA | Engine | Flat Sump |  | $38.78 | 1 | $10.57 | $26.04 | $0.00 | $2.17 | $38.78 | 38
 | Engine & Drivetrain | EN 01002 | AA | Engine | Rear tab |  | $1.42 | 2 | $0.20 | $1.21 | $0.00 | $0.00 | $2.83 | 39
 | Engine & Drivetrain | EN 01003 | AA | Engine | Rear tube |  | $1.30 | 2 | $0.14 | $1.15 | $0.00 | $0.00 | $2.59 | 41
 | Engine and Drivetrain | EN A0200 | AA |  | Exhaust System |  | $100.73 | 1 | $6.00 | $92.69 | $1.04 | $1.00 | $100.73 | 43
 | Engine and Drivetrain | EN 02001 | AA | Exhaust System | Exhaust Tip |  | $4.35 | 4 | $0.64 | $3.71 | $0.00 | $0.00 | $17.41 | 45
 | Engine and Drivetrain | EN 02002 | AA | Exhaust System | Exhaust Flange |  | $1.75 | 4 | $0.35 | $1.40 | $0.00 | $0.00 | $7.00 | 47
 | Engine and Drivetrain | EN 02003 | AA | Exhaust System | Exhaust headers |  | $109.43 | 1 | $1.65 | $100.12 | $0.00 | $7.67 | $109.43 | 49
 | Engine and Drivetrain | EN 02004 | AA | Exhaust System | Primary collector |  | $20.23 | 2 | $0.29 | $18.44 | $0.00 | $1.50 | $40.46 | 50
 | Engine and Drivetrain | EN 02005 | AA | Exhaust System | Primary collector tubing |  | $1.22 | 2 | $0.59 | $0.63 | $0.00 | $0.00 | $2.44 | 51
 | Engine and Drivetrain | EN 02006 | AA | Exhaust System | Secondary collector |  | $22.47 | 1 | $0.39 | $20.58 | $0.00 | $1.50 | $22.47 | 52
 | Engine and Drivetrain | EN 02007 | AA | Exhaust System | Secondary collector tubing |  | $12.90 | 1 | $0.51 | $11.72 | $0.00 | $0.67 | $12.90 | 53
 | Engine and Drivetrain | EN 02008 | AA | Exhaust System | Muffler |  | $40.14 | 1 | $24.12 | $16.02 | $0.00 | $0.00 | $40.14 | 54
 | Engine and Drivetrain | EN 02009 | AA | Exhaust System | Muffler Collar |  | $6.21 | 1 | $5.56 | $0.62 | $0.00 | $0.04 | $6.21 | 55
 | Engine and Drivetrain | EN 02010 | AA | Exhaust System | Spacer |  | $2.23 | 1 | $0.15 | $2.08 | $0.00 | $0.00 | $2.23 | 56
 | Engine and Drivetrain | EN A0300 | AA |  | Air Intake System |  | $95.20 | 1 | $26.45 | $62.64 | $5.44 | $0.67 | $95.20 | 57
 | Engine and Drivetrain | EN 03001 | AA | Air Intake System | Upper plenum |  | $12.59 | 1 | $1.15 | $11.43 | $0.00 | $0.00 | $12.59 | 59
 | Engine and Drivetrain | EN 03002 | AA | Air Intake System | Plenum plate |  | $3.68 | 1 | $0.59 | $3.09 | $0.00 | $0.00 | $3.68 | 60
 | Engine and Drivetrain | EN 03003 | AA | Air Intake System | Intake manifold |  | $18.14 | 1 | $1.65 | $16.49 | $0.00 | $0.00 | $18.14 | 62
 | Engine and Drivetrain | EN 03004 | AA | Air Intake System | Left frame bracket |  | $1.69 | 1 | $0.04 | $1.65 | $0.00 | $0.00 | $1.69 | 63
 | Engine and Drivetrain | EN 03005 | AA | Air Intake System | Right frame bracket |  | $1.76 | 1 | $0.05 | $1.71 | $0.00 | $0.00 | $1.76 | 65
 | Engine and Drivetrain | EN 03006 | AA | Air Intake System | PAIR plate |  | $1.32 | 2 | $0.08 | $1.24 | $0.00 | $0.00 | $2.63 | 67
 | Engine and Drivetrain | EN 03007 | AA | Air Intake System | Motor bracket |  | $4.18 | 1 | $0.29 | $3.89 | $0.00 | $0.00 | $4.18 | 69
 | Engine and Drivetrain | EN 03008 | AA | Air Intake System | Intake bracket |  | $0.73 | 2 | $0.004768875 | $0.73 | $0.00 | $0.00 | $1.46 | 71
 | Engine and Drivetrain | EN A0400 | AA |  | Throttle Body |  | $130.01 | 1 | $119.80 | $9.19 | $1.02 | $0.00 | $130.01 | 73
 | Engine and Drivetrain | EN 04001 | AA | Throttle Body | Throttle Frange |  | $5.18 | 1 | $0.73 | $4.45 | $0.00 | $0.00 | $5.18 | 75
 | Engine and Drivetrain | EN 04002 | AA | Throttle Body | Restrictor |  | $5.73 | 1 | $1.58 | $4.15 | $0.00 | $0.00 | $5.73 | 76
 | Engine and Drivetrain | EN 04003 | AA | Throttle Body | Throttle Housing |  | $4.27 | 1 | $0.84 | $3.43 | $0.00 | $0.00 | $4.27 | 77
 | Engine and Drivetrain | EN 04004 | AA | Throttle Body | Throttle Axle |  | $2.73 | 1 | $0.06 | $2.67 | $0.00 | $0.00 | $2.73 | 78
 | Engine and Drivetrain | EN 04005 | AA | Throttle Body | TPS Axle |  | $2.71 | 1 | $0.04 | $2.67 | $0.00 | $0.00 | $2.71 | 79
 | Engine and Drivetrain | EN 04006 | AA | Throttle Body | Cable Housing |  | $3.57 | 1 | $0.17 | $3.40 | $0.00 | $0.00 | $3.57 | 80
 | Engine and Drivetrain | EN 04007 | AA | Throttle Body | Axle Stop |  | $2.04 | 1 | $0.26 | $1.78 | $0.00 | $0.00 | $2.04 | 81
 | Engine and Drivetrain | EN 04008 | AA | Throttle Body | Ram Pipe |  | $12.51 | 1 | $4.01 | $8.50 | $0.00 | $0.00 | $12.51 | 82
 | Engine and Drivetrain | EN 04009 | AA | Throttle Body | Throttle Plate |  | $1.49 | 1 | $0.07 | $1.42 | $0.00 | $0.00 | $1.49 | 83
 | Engine and Drivetrain | EN A0500 | AA |  | Fuel Tank Assembly |  | $38.53 | 1 | $24.86 | $10.46 | $1.88 | $1.33 | $38.53 | 84
 | Engine and Drivetrain | EN 05001 | AA | Fuel Tank Assembly | Fuel Tank (with filler neck) |  | $103.67 | 1 | $19.85 | $82.15 | $0.00 | $1.67 | $103.67 | 85
 | Engine and Drivetrain | EN 05002 | AA | Fuel Tank Assembly | Filler Cap |  | $31.68 | 1 | $24.42 | $7.26 | $0.00 | $0.00 | $31.68 | 87
 | Engine and Drivetrain | EN 05003 | AA | Fuel Tank Assembly | Filler Tube |  | $18.36 | 1 | $4.06 | $10.78 | $2.52 | $1.00 | $18.36 | 88
 | Engine and Drivetrain | EN 05004 | AA | Fuel Tank Assembly | Lateral tab |  | $1.74 | 2 | $0.03 | $1.71 | $0.00 | $0.00 | $3.48 | 89
 | Engine and Drivetrain | EN 05005 | AA | Fuel Tank Assembly | Rear tab |  | $1.88 | 2 | $0.05 | $1.83 | $0.00 | $0.00 | $3.77 | 91
 | Engine and Drivetrain | EN A0600 | AA |  | Fuel System |  | $328.33 | 1 | $283.83 | $43.14 | $0.69 | $0.67 | $328.33 | 93
 | Engine and Drivetrain | EN 06001 | AA | Fuel System | Fuel Rail |  | $7.64 | 1 | $0.47 | $4.84 | $0.00 | $2.33 | $7.64 | 95
 | Engine and Drivetrain | EN 06002 | AA | Fuel System | Fuel Pump Collar |  | $3.35 | 1 | $0.05 | $3.30 | $0.00 | $0.00 | $3.35 | 96
 | Engine and Drivetrain | EN 06003 | AA | Fuel System | Pressure Regulator Tab |  | $1.83 | 1 | $0.04 | $1.79 | $0.00 | $0.00 | $1.83 | 97
 | Engine and Drivetrain | EN 06004 | AA | Fuel System | Fuel Pump Tab |  | $1.55 | 1 | $0.01 | $1.54 | $0.00 | $0.00 | $1.55 | 99
 | Engine and Drivetrain | EN A0700 | AA |  | Overflow Bottles |  | $22.60 | 1 | $11.52 | $9.11 | $1.98 | $0.00 | $22.60 | 101
 | Engine and Drivetrain | EN A0800 | AA |  | Cooling System |  | $49.04 | 1 | $20.04 | $19.44 | $8.55 | $1.00 | $49.04 | 102
 | Engine and Drivetrain | EN 08001 | AA | Cooling System | Radiator |  | $102.86 | 1 | $17.94 | $84.92 | $0.00 | $0.00 | $102.86 | 103
 | Engine and Drivetrain | EN 08002 | AA | Cooling System | Radiator lateral upper tab |  | $1.79 | 1 | $0.05 | $1.74 | $0.00 | $0.00 | $1.79 | 106
 | Engine and Drivetrain | EN 08003 | AA | Cooling System | Radiator lateral lower tab |  | $2.53 | 1 | $0.26 | $2.26 | $0.00 | $0.00 | $2.53 | 108
 | Engine and Drivetrain | EN 08004 | AA | Cooling System | Radiator Back tab |  | $1.61 | 1 | $0.01 | $1.60 | $0.00 | $0.00 | $1.61 | 110
 | Engine and Drivetrain | EN 08005 | AA | Cooling System | Main Coolant Line |  | $38.16 | 1 | $12.26 | $21.10 | $4.80 | $0.00 | $38.16 | 112
 | Engine and Drivetrain | EN 08006 | AA | Cooling System | Fan |  | $30.77 | 1 | $30.00 | $0.37 | $0.40 | $0.00 | $30.77 | 113
 | Engine and Drivetrain | EN 08007 | AA | Cooling System | Expansion Tank |  | $22.73 | 1 | $3.02 | $17.71 | $0.00 | $2.00 | $22.73 | 114
 | Engine and Drivetrain | EN 08008 | AA | Cooling System | Expansion Tank tab |  | $1.54 | 1 | $0.02 | $1.53 | $0.00 | $0.00 | $1.54 | 115
 | Engine and Drivetrain | EN 08009 | AA | Cooling System | Lateral Tube |  | $3.15 | 1 | $1.80 | $1.35 | $0.00 | $0.00 | $3.15 | 117
 | Engine and Drivetrain | EN 08010 | AA | Cooling System | Secondary Coolant Line |  | $15.48 | 1 | $1.33 | $9.36 | $4.80 | $0.00 | $15.48 | 119
 | Engine & Drivetrain | EN A0900 | AA |  | Differential Assembly |  | $203.89 | 1 | $180.47 | $18.49 | $2.27 | $2.67 | $203.89 | 120
 | Engine & Drivetrain | EN 09001 | AA | Differential Assembly | Housing |  | $125.94 | 1 | $21.41 | $101.49 | $3.03 | $0.00 | $125.94 | 122
 | Engine & Drivetrain | EN 09002 | AA | Differential Assembly | Left Eccentric |  | $10.90 | 1 | $2.59 | $8.31 | $0.00 | $0.00 | $10.90 | 123
 | Engine & Drivetrain | EN 09003 | AA | Differential Assembly | Right Eccentric |  | $8.54 | 1 | $2.00 | $6.54 | $0.00 | $0.00 | $8.54 | 125
 | Engine & Drivetrain | EN 09004 | AA | Differential Assembly | Left Eccentric carrier |  | $23.96 | 1 | $7.75 | $16.20 | $0.00 | $0.00 | $23.96 | 127
 | Engine & Drivetrain | EN 09005 | AA | Differential Assembly | Right Eccentric carrier |  | $17.20 | 1 | $5.62 | $11.58 | $0.00 | $0.00 | $17.20 | 129
 | Engine & Drivetrain | EN 09006 | AA | Differential Assembly | Upper Eccentric Carrier bracket |  | $1.00 | 4 | $0.08 | $0.91 | $0.00 | $0.00 | $3.98 | 131
 | Engine & Drivetrain | EN 09007 | AA | Differential Assembly | Lower Eccentric Carrier bracket |  | $0.97 | 4 | $0.07 | $0.90 | $0.00 | $0.00 | $3.88 | 132
 | Engine & Drivetrain | EN 09008 | AA | Differential Assembly | Left Jacking Bar bracket |  | $2.20 | 1 | $0.15 | $2.05 | $0.00 | $0.00 | $2.20 | 135
 | Engine & Drivetrain | EN 09009 | AA | Differential Assembly | Right Jacking Bar bracket |  | $2.21 | 1 | $0.15 | $2.06 | $0.00 | $0.00 | $2.21 | 137
 | Engine & Drivetrain | EN A1000 | AA |  | Driveshaft |  | $223.03 | 1 | $200.00 | $15.54 | $7.49 | $0.00 | $223.03 | 139
 | Engine & Drivetrain | EN 10001 | AA | Driveshaft | Inboard tripod housing |  | $66.55 | 2 | $9.22 | $57.32 | $0.00 | $0.00 | $133.10 | 140
 | Engine & Drivetrain | EN 10002 | AA | Driveshaft | Outboard tripod housing |  | $72.28 | 2 | $9.63 | $62.65 | $0.00 | $0.00 | $144.55 | 141
 | Engine & Drivetrain | EN 10003 | AA | Driveshaft | Left Axle |  | $16.43 | 1 | $2.58 | $13.85 | $0.00 | $0.00 | $16.43 | 142
 | Engine & Drivetrain | EN 10004 | AA | Driveshaft | Right Axle |  | $17.34 | 1 | $2.93 | $14.41 | $0.00 | $0.00 | $17.34 | 144
 | Engine & Drivetrain | EN A1100 | AA |  | Chain Set |  | $25.14 | 1 | $2.18 | $17.71 | $2.58 | $2.67 | $25.14 | 146
 | Engine & Drivetrain | EN 11001 | AA | Chain Set | Front sprocket |  | $24.75 | 1 | $1.52 | $23.23 | $0.00 | $0.00 | $24.75 | 148
 | Engine & Drivetrain | EN 11002 | AA | Chain Set | Rear sprocket |  | $41.80 | 1 | $3.06 | $38.74 | $0.00 | $0.00 | $41.80 | 149
 | Engine & Drivetrain | EN 11003 | AA | Chain Set | Rear sprocket adaptor |  | $29.16 | 1 | $8.72 | $20.44 | $0.00 | $0.00 | $29.16 | 150
 | Engine & Drivetrain | EN 11004 | AA | Chain Set | Chain shield |  | $9.10 | 1 | $3.31 | $5.78 | $0.00 | $0.00 | $9.10 | 152
 | Engine & Drivetrain | EN 11005 | AA | Chain Set | Upper chainshield bracket |  | $1.71 | 1 | $0.04 | $1.67 | $0.00 | $0.00 | $1.71 | 154
 | Engine & Drivetrain | EN 11006 | AA | Chain Set | Lower chainshield bracket |  | $1.71 | 1 | $0.04 | $1.68 | $0.00 | $0.00 | $1.71 | 156
 | Engine and Drivetrain |  |  |  | Area Total |  |  |  | $2652.40 | $1465.86 | $54.23 | $32.70 | $4205.19
 | Frame and Body | FR A0100 | AA |  | Frame |  | $639.85 | 1 | $30.70 | $538.62 | $3.20 | $67.33 | $639.85 | 159
 | Frame and Body | FR 01001 | AA | Frame | Bend Round steel tubing |  | $23.75 | 1 | $12.80 | $10.95 | $0.00 | $0.00 | $23.75 | 160
 | Frame and Body | FR 01002 | AA | Frame | Straight round steel tubing |  | $256.01 | 1 | $70.76 | $185.25 | $0.00 | $0.00 | $256.01 | 161
 | Frame and Body | FR 01003 | AA | Frame | Ant-intrusion plate |  | $9.13 | 1 | $4.03 | $5.10 | $0.00 | $0.00 | $9.13 | 162
 | Frame and Body | FR 01004 | AA | Frame | Sleeved joint |  | $3.92 | 4 | $0.36 | $3.56 | $0.00 | $0.00 | $15.68 | 163
 | Frame and Body | FR A0200 | AA |  | Impact Attenuator |  | $11.52 | 1 | $0.00 | $8.06 | $3.45 | $0.00 | $11.52 | 165
 | Frame and Body | FR 02001 | AA | Impact Attenuator | Impact Attenuator |  | $35.19 | 1 | $7.01 | $28.19 | $0.00 | $0.00 | $35.19 | 166
 | Frame and Body | FR A0300 | AA |  | Pedal box |  | $52.47 | 1 | $18.92 | $25.47 | $5.08 | $3.00 | $52.47 | 167
 | Frame and Body | FR 03001 | AA | Pedal box | Rail |  | $3.11 | 2 | $0.84 | $2.27 | $0.00 | $0.00 | $6.22 | 169
 | Frame and Body | FR 03002 | AA | Pedal box | Brake pedal |  | $5.69 | 1 | $1.14 | $4.55 | $0.00 | $0.00 | $5.69 | 171
 | Frame and Body | FR 03003 | AA | Pedal box | Accelerator Pedal |  | $4.84 | 1 | $1.14 | $3.70 | $0.00 | $0.00 | $4.84 | 173
 | Frame and Body | FR 03004 | AA | Pedal box | Foot Top Support |  | $2.10 | 2 | $0.31 | $1.79 | $0.00 | $0.00 | $4.20 | 175
 | Frame and Body | FR 03005 | AA | Pedal box | Heel Support |  | $2.02 | 2 | $0.27 | $1.74 | $0.00 | $0.00 | $4.03 | 177
 | Frame and Body | FR 03006 | AA | Pedal box | Brake Pedal Support |  | $3.11 | 2 | $0.46 | $2.65 | $0.00 | $0.00 | $6.22 | 179
 | Frame and Body | FR 03007 | AA | Pedal box | Brake over-travel switch support |  | $1.97 | 1 | $0.07 | $1.90 | $0.00 | $0.00 | $1.97 | 181
 | Frame and Body | FR 03008 | AA | Pedal box | Accelerator pedal support |  | $2.00 | 2 | $0.25 | $1.75 | $0.00 | $0.00 | $3.99 | 183
 | Frame and Body | FR 03009 | AA | Pedal box | Cable Support |  | $4.21 | 1 | $0.12 | $4.09 | $0.00 | $0.00 | $4.21 | 185
 | Frame and Body | FR 03010 | AA | Pedal box | Rear Rail Mount |  | $0.86 | 4 | $0.05 | $0.81 | $0.00 | $0.00 | $3.44 | 187
 | Frame and Body | FR 03011 | AA | Pedal box | Front Rail Mount |  | $0.80 | 4 | $0.07 | $0.73 | $0.00 | $0.00 | $3.18 | 189
 | Frame and Body | FR 03012 | AA | Pedal box | Sheath for cable mount |  | $1.86 | 1 | $0.07 | $1.79 | $0.00 | $0.00 | $1.86 | 191
 | Frame and Body | FR A0400 | AA |  | Floor Pan |  | $19.19 | 1 | $0.12 | $15.12 | $0.62 | $3.33 | $19.19 | 193
 | Frame and Body | FR 04001 | AA | Floor Pan | Front Floor Pan Plate |  | $8.18 | 1 | $4.65 | $3.53 | $0.00 | $0.00 | $8.18 | 194
 | Frame and Body | FR 04002 | AA | Floor Pan | Back Floor Pan Plate |  | $20.07 | 1 | $14.85 | $5.22 | $0.00 | $0.00 | $20.07 | 196
 | Frame and Body | FR 04003 | AA | Floor Pan | Floor Pan Bracket |  | $0.51 | 10 | $0.02 | $0.48 | $0.00 | $0.00 | $5.06 | 198
 | Frame and Body | FR A0500 | AA |  | Clutch actuation system |  | $22.05 | 1 | $19.00 | $2.60 | $0.12 | $0.33 | $22.05 | 200
 | Frame and Body | FR 05001 | AA | Clutch actuation system | Lever Handle |  | $4.37 | 1 | $0.93 | $3.44 | $0.00 | $0.00 | $4.37 | 201
 | Frame and Body | FR 05002 | AA | Clutch actuation system | Handle padding |  | $7.40 | 1 | $0.33 | $0.40 | $0.00 | $6.67 | $7.40 | 203
 | Frame and Body | FR 05003 | AA | Clutch actuation system | Clutch mount |  | $2.37 | 1 | $0.10 | $2.28 | $0.00 | $0.00 | $2.37 | 204
 | Frame and Body | FR 05004 | AA | Clutch actuation system | Lever joint |  | $11.77 | 1 | $0.56 | $4.54 | $0.00 | $6.67 | $11.77 | 205
 | Frame and Body | FR 05005 | AA | Clutch actuation system | Actuation lever |  | $10.15 | 1 | $0.63 | $2.85 | $0.00 | $6.67 | $10.15 | 206
 | Frame and Body | FR A0600 | AA |  | Shifter |  | $111.59 | 1 | $42.48 | $26.22 | $0.41 | $42.48 | $111.59 | 207
 | Frame and Body | FR 06001 | AA | Shifter | Engine gear boxx drum gear |  | $12.69 | 1 | $0.54 | $12.15 | $0.00 | $0.00 | $12.69 | 209
 | Frame and Body | FR 06002 | AA | Shifter | Engine gear box shifting pinion shaft |  | $15.88 | 1 | $0.67 | $15.21 | $0.00 | $0.00 | $15.88 | 210
 | Frame and Body | FR 06003 | AA | Shifter | Engine gear box actator tab |  | $1.60 | 1 | $0.02 | $1.58 | $0.00 | $0.00 | $1.60 | 211
 | Frame and Body | FR 06004 | AA | Shifter | Front engine gearbox actuator mount |  | $2.82 | 1 | $0.03 | $2.79 | $0.00 | $0.00 | $2.82 | 212
 | Frame and Body | FR 06005 | AA | Shifter | Rear engine gearbox actuator mount |  | $2.56 | 1 | $0.02 | $2.54 | $0.00 | $0.00 | $2.56 | 214
 | Frame and Body | FR 06006 | AA | Shifter | Engine gearbox actuator coupling |  | $7.49 | 1 | $0.40 | $7.05 | $0.04 | $0.00 | $7.49 | 216
 | Frame and Body | FR A0700 | AA |  | Bodywork |  | $111.69 | 1 | $11.66 | $25.42 | $71.95 | $2.67 | $111.69 | 217
 | Frame and Body | FR 07001 | AA | Bodywork | Nose |  | $261.59 | 1 | $82.80 | $160.92 | $0.00 | $17.87 | $261.59 | 218
 | Frame and Body | FR 07002 | AA | Bodywork | Left Inlet |  | $110.33 | 1 | $28.20 | $76.13 | $0.00 | $6.00 | $110.33 | 220
 | Frame and Body | FR 07003 | AA | Bodywork | Right Inlet |  | $110.33 | 1 | $28.20 | $76.13 | $0.00 | $6.00 | $110.33 | 222
 | Frame and Body | FR 07004 | AA | Bodywork | Front Side plate |  | $86.63 | 2 | $12.96 | $69.40 | $0.00 | $4.27 | $173.25 | 224
 | Frame and Body | FR 07005 | AA | Bodywork | Back Side Plate |  | $150.71 | 2 | $27.00 | $114.38 | $0.00 | $9.33 | $301.43 | 226
 | Frame and Body | FR 07006 | AA | Bodywork | Back Inlet Bracket |  | $1.08 | 2 | $0.02 | $1.06 | $0.00 | $0.00 | $2.15 | 228
 | Frame and Body | FR 07007 | AA | Bodywork | Front Inlet Bracket |  | $1.08 | 2 | $0.02 | $1.06 | $0.00 | $0.00 | $2.16 | 230
 | Frame and Body | FR 07008 | AA | Bodywork | Nose Bracket |  | $0.74 | 4 | $0.02 | $0.72 | $0.00 | $0.00 | $2.95 | 232
 | Frame and Body | FR A0800 | AA |  | Gearshifting paddles |  | $8.84 | 1 | $4.00 | $4.68 | $0.16 | $0.00 | $8.84 | 234
 | Frame and Body | FR 08001 | AA | Gearshifting paddles | Paddles mount main part |  | $6.50 | 1 | $0.69 | $5.81 | $0.00 | $0.00 | $6.50 | 235
 | Frame and Body | FR 08002 | AA | Gearshifting paddles | Paddles rockers |  | $4.63 | 2 | $0.11 | $4.51 | $0.00 | $0.00 | $9.25 | 236
 | Frame and Body | FR 08003 | AA | Gearshifting paddles | Paddles |  | $4.03 | 2 | $0.84 | $3.20 | $0.00 | $0.00 | $8.07 | 237
 | Frame and Body |  |  |  | Area Total |  |  |  | $476.00 | $1709.98 | $85.03 | $196.21 | $2467.22
 | Electrical | EL A0100 | AA |  | Rear firewall instruments and wires |  | $1232.15 | 1 | $1130.85 | $97.45 | $1.85 | $2.00 | $1232.15 | 239
 | Electrical | EL 01001 | AA | Rear firewall instruments and wires | Fuse box bracket |  | $0.88 | 2 | $0.02 | $0.87 | $0.00 | $0.00 | $1.77 | 242
 | Electrical | EL 01002 | AA | Rear firewall instruments and wires | Ground bracket |  | $0.55 | 2 | $0.01 | $0.54 | $0.00 | $0.00 | $1.09 | 244
 | Electrical | EL 01003 | AA | Rear firewall instruments and wires | Break light bracket |  | $0.82 | 2 | $0.01 | $0.82 | $0.00 | $0.00 | $1.64 | 246
 | Electrical | EL 01004 | AA | Rear firewall instruments and wires | Master switch panel |  | $75.94 | 1 | $73.60 | $2.34 | $0.00 | $0.00 | $75.94 | 248
 | Electrical | EL 01005 | AA | Rear firewall instruments and wires | Master switch panel bracket |  | $0.83 | 2 | $0.01 | $0.82 | $0.00 | $0.00 | $1.65 | 249
 | Electrical | EL 01006 | AA | Rear firewall instruments and wires | Crash sensor bracket |  | $2.09 | 1 | $0.07 | $2.02 | $0.00 | $0.00 | $2.09 | 251
 | Electrical | EL A0200 | AA |  | Front vehicule electronics |  | $160.80 | 1 | $112.35 | $47.48 | $0.30 | $0.67 | $160.80 | 253
 | Electrical | EL 02001 | AA | Front vehicule electronics | Dashboard |  | $114.07 | 1 | $65.73 | $46.34 | $0.00 | $2.00 | $114.07 | 255
 | Electrical | EL 02002 | AA | Front vehicule electronics | Dashboard control electronics |  | $234.70 | 1 | $135.00 | $99.30 | $0.40 | $0.00 | $234.70 | 256
 | Electrical | EL 02003 | AA | Front vehicule electronics | Dashboard Tap |  | $1.85 | 1 | $0.01 | $1.84 | $0.00 | $0.00 | $1.85 | 257
 | Electrical | EL 02004 | AA | Front vehicule electronics | Ground bracket |  | $0.55 | 2 | $0.01 | $0.54 | $0.00 | $0.00 | $1.09 | 259
 | Electrical | EL A0300 | AA |  | Battery assembly |  | $89.55 | 1 | $84.52 | $4.19 | $0.18 | $0.67 | $89.55 | 261
 | Electrical | EL 03001 | AA | Battery assembly | Main battery mount |  | $4.83 | 1 | $0.97 | $3.86 | $0.00 | $0.00 | $4.83 | 262
 | Electrical | EL 03002 | AA | Battery assembly | Side battery mount |  | $3.66 | 2 | $0.26 | $3.40 | $0.00 | $0.00 | $7.31 | 264
 | Electrical | EL 03003 | AA | Battery assembly | Battery bracket |  | $0.59 | 3 | $0.01 | $0.58 | $0.00 | $0.00 | $1.76 | 266
 | Electrical |  |  |  | Area Total |  |  |  | $1603.70 | $320.54 | $2.73 | $5.33 | $1932.30
 | Miscellaneous, Finish & Assembly | MS A0100 | AA |  | Firewall |  | $55.47 | 1 | $0.29 | $42.62 | $3.23 | $9.33 | $55.47 | 269
 | Miscellaneous, Finish & Assembly | MS 01001 | AA | Firewall | Firewall Up |  | $9.27 | 1 | $4.95 | $4.31 | $0.00 | $0.00 | $9.27 | 271
 | Miscellaneous, Finish & Assembly | MS 01002 | AA | Firewall | Firewall Middle |  | $7.54 | 1 | $4.30 | $3.25 | $0.00 | $0.00 | $7.54 | 273
 | Miscellaneous, Finish & Assembly | MS 01003 | AA | Firewall | Firewall Bottom |  | $11.14 | 1 | $6.83 | $4.31 | $0.00 | $0.00 | $11.14 | 275
 | Miscellaneous, Finish & Assembly | MS 01004 | AA | Firewall | Firewall Upper Side |  | $3.17 | 2 | $1.24 | $1.93 | $0.00 | $0.00 | $6.34 | 277
 | Miscellaneous, Finish & Assembly | MS 01005 | AA | Firewall | Firewall Middle Side |  | $2.15 | 2 | $0.51 | $1.64 | $0.00 | $0.00 | $4.30 | 279
 | Miscellaneous, Finish & Assembly | MS 01006 | AA | Firewall | Firewall Lower Side |  | $4.08 | 2 | $1.99 | $2.09 | $0.00 | $0.00 | $8.15 | 281
 | Miscellaneous, Finish & Assembly | MS 01007 | AA | Firewall | Firewall Up Bracket |  | $0.62 | 4 | $0.01 | $0.61 | $0.00 | $0.00 | $2.47 | 283
 | Miscellaneous, Finish & Assembly | MS 01008 | AA | Firewall | Firewall Middle, Bottom and Sides Bracket |  | $0.38 | 24 | $0.01 | $0.37 | $0.00 | $0.00 | $9.10 | 285
 | Miscellaneous, Finish & Assembly | MS A0200 | AA |  | Driver's Safety |  | $0.78 | 1 | $0.00 | $0.62 | $0.16 | $0.00 | $0.78 | 287
 | Miscellaneous, Finish & Assembly | MS 02001 | AA | Driver's Safety | Rollbar padding |  | $3.92 | 2 | $1.10 | $2.82 | $0.00 | $0.00 | $7.84 | 288
 | Miscellaneous, Finish & Assembly | MS A0300 | AA |  | Head Restraint |  | $31.54 | 1 | $11.22 | $20.32 | $0.00 | $0.00 | $31.54 | 289
 | Miscellaneous, Finish & Assembly | MS A0400 | AA |  | Driver's seat |  | $4.74 | 1 | $0.04 | $2.80 | $0.56 | $1.33 | $4.74 | 290
 | Miscellaneous, Finish & Assembly | MS 04001 | AA | Driver's seat | Seat |  | $74.60 | 1 | $18.80 | $54.60 | $0.00 | $1.20 | $74.60 | 291
 | Miscellaneous, Finish & Assembly | MS 04002 | AA | Driver's seat | Rear seat bracket |  | $1.32 | 2 | $0.01 | $1.31 | $0.00 | $0.00 | $2.65 | 292
 | Miscellaneous, Finish & Assembly | MS 04003 | AA | Driver's seat | Front seat bracket |  | $1.19 | 2 | $0.02 | $1.17 | $0.00 | $0.00 | $2.37 | 294
 | Miscellaneous, Finish & Assembly | MS A0500 | AA |  | Harness |  | $53.65 | 1 | $45.06 | $4.92 | $3.00 | $0.67 | $53.65 | 296
 | Miscellaneous, Finish & Assembly | MS 05001 | AA | Harness | Harness bracket |  | $1.25 | 2 | $0.09 | $1.16 |  |  | $2.50 | 297
 | Miscellaneous, Finish & Assembly |  |  |  | Area Total |  |  |  | $101.75 | $173.21 | $6.95 | $12.53 | $294.44
 | Steering System | ST A0100 | AA |  | Steering Rack |  | $38.42 | 1 | $19.60 | $17.36 | $0.80 | $0.67 | $38.42 | 300
 | Steering System | ST 01001 | AA | Steering Rack | Rack pinion |  | $7.97 | 1 | $1.04 | $6.93 | $0.00 | $0.00 | $7.97 | 302
 | Steering System | ST 01002 | AA | Steering Rack | Rack |  | $6.04 | 1 | $1.22 | $4.82 | $0.00 | $0.00 | $6.04 | 303
 | Steering System | ST 01003 | AA | Steering Rack | Upper Pinion housing |  | $2.57 | 1 | $0.26 | $2.31 | $0.00 | $0.00 | $2.57 | 304
 | Steering System | ST 01004 | AA | Steering Rack | Lower Pinion housing |  | $6.26 | 1 | $1.05 | $5.20 | $0.00 | $0.00 | $6.26 | 305
 | Steering System | ST 01005 | AA | Steering Rack | Rack housing support |  | $2.35 | 2 | $0.42 | $1.93 | $0.00 | $0.00 | $4.70 | 306
 | Steering System | ST 01006 | AA | Steering Rack | Tie rod Braces |  | $2.39 | 2 | $0.30 | $2.09 | $0.00 | $0.00 | $4.78 | 307
 | Steering System | ST 01007 | AA | Steering Rack | Rack housing |  | $65.59 | 1 | $55.07 | $10.51 | $0.00 | $0.00 | $65.59 | 308
 | Steering System | ST 01008 | AA | Steering Rack | Steering Brackets tie |  | $1.58 | 4 | $0.13 | $1.45 | $0.00 | $0.00 | $6.34 | 309
 | Steering System | ST 01009 | AA | Steering Rack | Steering Brackets |  | $1.60 | 2 | $0.17 | $1.42 | $0.00 | $0.00 | $3.19 | 311
 | Steering System | ST 01010 | AA | Steering Rack | Rack protection |  | $7.62 | 1 | $3.08 | $4.54 | $0.00 | $0.00 | $7.62 | 313
 | Steering System | ST 01011 | AA | Steering Rack | Rack protection Brackets |  | $0.38 | 4 | $0.01 | $0.37 | $0.00 | $0.00 | $1.52 | 314
 | Steering System | ST A0200 | AA |  | Steering Column assy |  | $54.19 | 1 | $42.22 | $9.13 | $0.18 | $2.67 | $54.19 | 316
 | Steering System | ST 02001 | AA | Steering Column Assy | Spline coupler |  | $3.63 | 1 | $0.26 | $3.37 | $0.00 | $0.00 | $3.63 | 318
 | Steering System | ST 02002 | AA | Steering Column Assy | Steering Column tube |  | $2.11 | 1 | $0.51 | $1.60 | $0.00 | $0.00 | $2.11 | 319
 | Steering System | ST 02003 | AA | Steering Column Assy | Steering Upper Shaft Pivot |  | $6.29 | 1 | $0.81 | $5.48 | $0.00 | $0.00 | $6.29 | 320
 | Steering System | ST 02004 | AA | Steering Column Assy | Steering Bore |  | $9.26 | 1 | $1.27 | $7.99 | $0.00 | $0.00 | $9.26 | 322
 | Steering System | ST 02005 | AA | Steering Column Assy | Steering Bore Support |  | $1.46 | 2 | $0.35 | $1.12 | $0.00 | $0.00 | $2.93 | 323
 | Steering System | ST A0300 | AA |  | Quick Release |  | $1.74 | 1 | $1.24 | $0.32 | $0.18 | $0.00 | $1.74 | 325
 | Steering System | ST 03001 | AA | Quick Release | Quick Release Steel Sleeve |  | $12.88 | 1 | $1.08 | $11.80 | $0.00 | $0.00 | $12.88 | 326
 | Steering System | ST 03002 | AA | Quick Release | Quick Release Fixed Part |  | $15.47 | 1 | $2.48 | $12.99 | $0.00 | $0.00 | $15.47 | 327
 | Steering System | ST 03003 | AA | Quick Release | Quick Release Sliding Part |  | $12.94 | 1 | $1.77 | $11.17 | $0.00 | $0.00 | $12.94 | 328
 | Steering System | ST A0400 | AA |  | Steering Wheel Assy |  | $2.69 | 1 | $0.00 | $2.25 | $0.44 | $0.00 | $2.69 | 329
 | Steering System | ST 04001 | AA | Steering Wheel Assy | Steering Wheel |  | $16.34 | 1 | $3.78 | $12.56 | $0.00 | $0.00 | $16.34 | 330
 | Steering System | ST 04002 | AA | Steering Wheel Assy | Aluminium spacer |  | $3.07 | 1 | $0.62 | $2.45 | $0.00 | $0.00 | $3.07 | 331
 | Steering System | ST A0500 | AA |  | Steering rod |  | $8.55 | 2 | $3.88 | $4.37 | $0.31 | $0.00 | $17.10 | 333
 | Steering System | ST 05001 | AA | Steering rod | Steering rod tube |  | $9.79 | 2 | $8.70 | $1.09 | $0.00 | $0.00 | $19.58 | 334
 | Steering System | ST 05002 | AA | Steering rod | Steering rod insert |  | $2.31 | 2 | $0.29 | $2.02 | $0.00 | $0.00 | $4.63 | 335
 | Steering System | ST 05003 | AA | Steering rod | Spacer |  | $0.34 | 8 | $0.03 | $0.31 | $0.00 | $0.00 | $2.69 | 337
 | Steering System |  |  |  | Area Total |  |  |  | $166.39 | $170.60 | $2.20 | $3.33 | $342.53
 | Suspension & Shocks | SU A0100 | AA |  | Upper Front A-arm |  | $38.58 | 2 | $20.76 | $16.03 | $0.45 | $1.33 | $77.16 | 340
 | Suspension & Shocks | SU_01001 | AA | Upper Front A-arm | Upper Front Bearing Support |  | $15.09 | 2 | $2.70 | $12.39 | $0.00 | $0.00 | $30.18 | 342
 | Suspension & Shocks | SU_01002 | AA | Upper Front A-arm | Inner Bearing Support |  | $1.87 | 4 | $0.86 | $1.01 | $0.00 | $0.00 | $7.49 | 344
 | Suspension & Shocks | SU_01003 | AA | Upper Front A-arm | Upper Front A-arm tube (Front) Carbon Fiber Tube |  | $8.88 | 2 | $7.89 | $0.99 | $0.00 | $0.00 | $17.75 | 346
 | Suspension & Shocks | SU_01004 | AA | Upper Front A-arm | Upper Front A-arm tube (Back) Carbon Fiber Tube |  | $7.19 | 2 | $6.39 | $0.80 | $0.00 | $0.00 | $14.38 | 347
 | Suspension & Shocks | SU_01005 | AA | Upper Front A-arm | Spacer 1 |  | $0.99 | 4 | $0.04 | $0.95 | $0.00 | $0.00 | $3.96 | 348
 | Suspension & Shocks | SU_01006 | AA | Upper Front A-arm | Spacer 2 |  | $0.32 | 8 | $0.14 | $0.18 | $0.00 | $0.00 | $2.59 | 350
 | Suspension & Shocks | SU_01007 | AA | Upper Front A-arm | Outboard A-arm Insert |  | $0.48 | 4 | $0.08 | $0.40 | $0.00 | $0.00 | $1.91 | 352
 | Suspension & Shocks | SU_01008 | AA | Upper Front A-arm | Front up bracket |  | $1.39 | 2 | $0.15 | $1.25 | $0.00 | $0.00 | $2.79 | 355
 | Suspension & Shocks | SU_01009 | AA | Upper Front A-arm | Front down bracket |  | $1.36 | 2 | $0.15 | $1.21 | $0.00 | $0.00 | $2.72 | 357
 | Suspension & Shocks | SU_01010 | AA | Upper Front A-arm | Rear up bracket |  | $1.31 | 2 | $0.12 | $1.19 | $0.00 | $0.00 | $2.63 | 359
 | Suspension & Shocks | SU_01011 | AA | Upper Front A-arm | Rear down bracket |  | $1.33 | 2 | $0.14 | $1.19 | $0.00 | $0.00 | $2.66 | 361
 | Suspension & Shocks | SU A0200 | AA |  | Lower Front A-arm |  | $38.58 | 2 | $20.76 | $16.03 | $0.45 | $1.33 | $77.16 | 363
 | Suspension & Shocks | SU 02001 | AA | Lower Front A-arm | Lower Front Bearing Support |  | $9.11 | 2 | $4.20 | $4.91 | $0.00 | $0.00 | $18.23 | 365
 | Suspension & Shocks | SU 02002 | AA | Lower Front A-arm | Inner Bearing Support |  | $1.87 | 4 | $0.86 | $1.01 | $0.00 | $0.00 | $7.49 | 367
 | Suspension & Shocks | SU_02003 | AA | Lower Front A-arm | Lower Front A-arm tube (Front) Carbon Fiber Tube |  | $11.22 | 2 | $9.97 | $1.25 | $0.00 | $0.00 | $22.44 | 369
 | Suspension & Shocks | SU_02004 | AA | Lower Front A-arm | Lower Front A-arm tube (Back) Carbon Fiber Tube |  | $10.00 | 2 | $8.89 | $1.11 | $0.00 | $0.00 | $20.00 | 370
 | Suspension & Shocks | SU_02005 | AA | Lower Front A-arm | Spacer 1 |  | $0.91 | 4 | $0.03 | $0.88 | $0.00 | $0.00 | $3.63 | 371
 | Suspension & Shocks | SU_02006 | AA | Lower Front A-arm | Spacer 2 |  | $0.32 | 8 | $0.14 | $0.18 | $0.00 | $0.00 | $2.59 | 373
 | Suspension & Shocks | SU_02007 | AA | Lower Front A-arm | Outboard A-arm Insert |  | $0.48 | 4 | $0.08 | $0.40 | $0.00 | $0.00 | $1.91 | 375
 | Suspension & Shocks | SU_02008 | AA | Lower Front A-arm | Front up bracket |  | $1.39 | 2 | $0.12 | $1.26 | $0.00 | $0.00 | $2.77 | 377
 | Suspension & Shocks | SU_02009 | AA | Lower Front A-arm | Front down bracket |  | $1.44 | 2 | $0.16 | $1.27 | $0.00 | $0.00 | $2.87 | 379
 | Suspension & Shocks | SU_02010 | AA | Lower Front A-arm | Rear Up bracket |  | $1.33 | 2 | $0.10 | $1.24 | $0.00 | $0.00 | $2.66 | 381
 | Suspension & Shocks | SU_02011 | AA | Lower Front A-arm | Rear down bracket |  | $1.42 | 2 | $0.15 | $1.27 | $0.00 | $0.00 | $2.83 | 383
 | Suspension & Shocks | SU A0300 | AA |  | Upper Back A-arm |  | $38.58 | 2 | $20.76 | $16.03 | $0.45 | $1.33 | $77.16 | 385
 | Suspension & Shocks | SU 03001 | AA | Upper Back A-arm | Upper Back Bearing Support |  | $16.49 | 2 | $2.49 | $13.99 | $0.00 | $0.00 | $32.97 | 387
 | Suspension & Shocks | SU 03002 | AA | Upper Back A-arm | Inner Bearing Support |  | $1.87 | 4 | $0.86 | $1.01 | $0.00 | $0.00 | $7.49 | 389
 | Suspension & Shocks | SU 03003 | AA | Upper Back A-arm | Upper Back A-arm tube (Front) Carbon Fiber Tube |  | $10.88 | 2 | $9.67 | $1.21 | $0.00 | $0.00 | $21.75 | 391
 | Suspension & Shocks | SU 03004 | AA | Upper Back A-arm | Upper Back A-arm tube (Back) Carbon Fiber Tube |  | $4.34 | 2 | $3.86 | $0.48 | $0.00 | $0.00 | $8.69 | 392
 | Suspension & Shocks | SU 03005 | AA | Upper Back A-arm | Spacer 1 |  | $0.72 | 4 | $0.02 | $0.70 | $0.00 | $0.00 | $2.88 | 393
 | Suspension & Shocks | SU 03006 | AA | Upper Back A-arm | Spacer 2 |  | $0.32 | 8 | $0.14 | $0.18 | $0.00 | $0.00 | $2.59 | 395
 | Suspension & Shocks | SU 03007 | AA | Upper Back A-arm | Outboard A-arm Insert |  | $0.48 | 4 | $0.08 | $0.40 | $0.00 | $0.00 | $1.91 | 397
 | Suspension & Shocks | SU 03008 | AA | Upper Back A-arm | Front up bracket |  | $1.50 | 2 | $0.20 | $1.30 | $0.00 | $0.00 | $2.99 | 399
 | Suspension & Shocks | SU 03009 | AA | Upper Back A-arm | Front down bracket |  | $1.49 | 2 | $0.19 | $1.30 | $0.00 | $0.00 | $2.98 | 401
 | Suspension & Shocks | SU 03010 | AA | Upper Back A-arm | Rear up bracket |  | $1.27 | 2 | $0.07 | $1.19 | $0.00 | $0.00 | $2.54 | 403
 | Suspension & Shocks | SU 03011 | AA | Upper Back A-arm | Rear down bracket |  | $1.38 | 2 | $0.13 | $1.25 | $0.00 | $0.00 | $2.76 | 405
 | Suspension & Shocks | SU A0400 | AA |  | Lower Back A-arm |  | $38.58 | 2 | $20.76 | $16.03 | $0.45 | $1.33 | $77.16 | 407
 | Suspension & Shocks | SU 04001 | AA | Lower Back A-arm | Lower Back Bearing Support |  | $8.95 | 2 | $4.20 | $4.75 | $0.00 | $0.00 | $17.91 | 409
 | Suspension & Shocks | SU_04002 | AA | Lower Back A-arm | Inner Bearing Support |  | $1.87 | 4 | $0.86 | $1.01 | $0.00 | $0.00 | $7.49 | 411
 | Suspension & Shocks | SU_04003 | AA | Lower Back A-arm | Lower Back A-arm tube (Front) Carbon Fiber Tube |  | $12.03 | 2 | $10.70 | $1.34 | $0.00 | $0.00 | $24.07 | 413
 | Suspension & Shocks | SU_04004 | AA | Lower Back A-arm | Lower Back A-arm tube (Back) Carbon Fiber Tube |  | $7.41 | 2 | $6.58 | $0.82 | $0.00 | $0.00 | $14.82 | 414
 | Suspension & Shocks | SU_04005 | AA | Lower Back A-arm | Spacer 1 |  | $1.63 | 4 | $0.03 | $1.60 | $0.00 | $0.00 | $6.51 | 415
 | Suspension & Shocks | SU_04006 | AA | Lower Back A-arm | Spacer 2 |  | $0.81 | 8 | $0.14 | $0.66 | $0.00 | $0.00 | $6.44 | 417
 | Suspension & Shocks | SU_04007 | AA | Lower Back A-arm | Outboard A-arm Insert |  | $0.48 | 4 | $0.08 | $0.40 | $0.00 | $0.00 | $1.91 | 419
 | Suspension & Shocks | SU 04008 | AA | Lower Back A-arm | Front up bracket |  | $1.39 | 2 | $0.13 | $1.26 | $0.00 | $0.00 | $2.78 | 421
 | Suspension & Shocks | SU 04009 | AA | Lower Back A-arm | Front down bracket |  | $1.38 | 2 | $0.13 | $1.25 | $0.00 | $0.00 | $2.76 | 423
 | Suspension & Shocks | SU 04010 | AA | Lower Back A-arm | Rear up bracket |  | $1.81 | 2 | $0.30 | $1.52 | $0.00 | $0.00 | $3.63 | 425
 | Suspension & Shocks | SU 04011 | AA | Lower Back A-arm | Rear down bracket |  | $1.90 | 2 | $0.36 | $1.54 | $0.00 | $0.00 | $3.80 | 427
 | Suspension & Shocks | SU A0500 | AA |  | Front suspension |  | $332.70 | 2 | $330.04 | $2.12 | $0.20 | $0.33 | $665.39 | 429
 | Suspension & Shocks | SU 05001 | AA | Front suspension | Shock Front Bracket |  | $5.92 | 2 | $0.39 | $5.54 | $0.00 | $0.00 | $11.85 | 430
 | Suspension & Shocks | SU A0600 | AA |  | Front Bell Crank |  | $2.27 | 2 | $0.09 | $1.59 | $0.25 | $0.33 | $4.54 | 432
 | Suspension & Shocks | SU 06001 | AA | Front Bell Cranck | Rocker bushing |  | $1.37 | 4 | $0.05 | $1.32 | $0.00 | $0.00 | $5.48 | 433
 | Suspension & Shocks | SU 06002 | AA | Front Bell Cranck | Rocker spacer |  | $1.54 | 2 | $0.05 | $1.49 | $0.00 | $0.00 | $3.09 | 434
 | Suspension & Shocks | SU 06003 | AA | Front Bell Cranck | Sheets of metal for rocker |  | $0.88 | 4 | $0.40 | $0.48 | $0.00 | $0.00 | $3.53 | 435
 | Suspension & Shocks | SU 06004 | AA | Front Bell Cranck | Front rocker mount |  | $2.27 | 4 | $0.11 | $2.16 | $0.00 | $0.00 | $9.08 | 437
 | Suspension & Shocks | SU A0700 | AA |  | Rear suspension |  | $335.02 | 2 | $330.04 | $4.24 | $0.41 | $0.33 | $670.04 | 439
 | Suspension & Shocks | SU 07001 | AA | Rear suspension | Shock rear Bracket |  | $5.92 | 2 | $0.39 | $5.54 | $0.00 | $0.00 | $11.85 | 441
 | Suspension & Shocks | SU A0800 | AA |  | Rear Bell Cranck |  | $4.82 | 2 | $0.20 | $3.50 | $0.12 | $1.00 | $9.64 | 441
 | Suspension & Shocks | SU 08001 | AA | Rear Bell Cranck | Rocker bushing |  | $1.37 | 4 | $0.05 | $1.32 | $0.00 | $0.00 | $5.48 | 442
 | Suspension & Shocks | SU 08002 | AA | Rear Bell Cranck | Sheets of metal for rocker |  | $2.06 | 4 | $0.34 | $1.72 | $0.00 | $0.00 | $8.26 | 443
 | Suspension & Shocks | SU 08003 | AA | Rear Bell Cranck | Rear rocker mount |  | $3.38 | 2 | $0.82 | $2.56 | $0.00 | $0.00 | $6.76 | 444
 | Suspension & Shocks | SU A0900 | AA |  | Rear Tie rod |  | $13.66 | 2 | $5.00 | $8.10 | $0.56 | $0.00 | $27.31 | 446
 | Suspension & Shocks | SU 09001 | AA | Rear Tie rod | Tie rod tube |  | $9.07 | 2 | $8.06 | $1.01 | $0.00 | $0.00 | $18.14 | 447
 | Suspension & Shocks | SU 09002 | AA | Rear Tie rod | Tie rod insert |  | $1.58 | 4 | $0.29 | $1.29 | $0.00 | $0.00 | $6.33 | 448
 | Suspension & Shocks | SU 09003 | AA | Rear Tie rod | Spacer 1 |  | $0.24 | 4 | $0.06 | $0.18 | $0.00 | $0.00 | $0.96 | 450
 | Suspension & Shocks | SU 09004 | AA | Rear Tie rod | Spacer 2 |  | $1.06 | 4 | $0.11 | $0.95 | $0.00 | $0.00 | $4.25 | 452
 | Suspension & Shocks | SU A1000 | AA |  | Front Uprights |  | $16.48 | 2 | $0.00 | $15.46 | $1.02 | $0.00 | $32.96 | 454
 | Suspension & Shocks | SU 10001 | AA | Front Uprights | Front Upright |  | $106.19 | 2 | $28.70 | $77.48 | $0.00 | $0.00 | $212.37 | 455
 | Suspension & Shocks | SU 10002 | AA | Front Uprights | Upper Arm Wedge |  | $2.51 | 2 | $0.22 | $2.29 | $0.00 | $0.00 | $5.01 | 457
 | Suspension & Shocks | SU 10003 | AA | Front Uprights | Upper Arm Bracket |  | $18.68 | 2 | $2.78 | $15.90 | $0.00 | $0.00 | $37.36 | 459
 | Suspension & Shocks | SU 10004 | AA | Front Uprights | Speed Sensor Bracket |  | $0.84 | 2 | $0.02 | $0.81 | $0.00 | $0.00 | $1.67 | 461
 | Suspension & Shocks | SU 10005 | AA | Front Uprights | Camber adjustment shim |  | $0.43 | 30 | $0.06 | $0.36 | $0.00 | $0.00 | $12.81 | 463
 | Suspension & Shocks | SU A1100 | AA |  | Rear Uprights |  | $17.41 | 2 | $0.00 | $16.33 | $1.08 | $0.00 | $34.82 | 465
 | Suspension & Shocks | SU 11001 | AA | Rear Uprights | Rear Upright |  | $106.52 | 2 | $25.84 | $80.68 | $0.00 | $0.00 | $213.04 | 466
 | Suspension & Shocks | SU 11002 | AA | Rear Uprights | Upper Arm Bracket |  | $21.19 | 2 | $3.31 | $17.89 | $0.00 | $0.00 | $42.39 | 469
 | Suspension & Shocks | SU 11003 | AA | Rear Uprights | Speed Sensor Bracket |  | $0.83 | 2 | $0.02 | $0.80 | $0.00 | $0.00 | $1.65 | 471
 | Suspension & Shocks | SU 11004 | AA | Rear Uprights | Camber adjustment shim |  | $0.42 | 30 | $0.07 | $0.35 | $0.00 | $0.00 | $12.74 | 473
 | Suspension & Shocks | SU A1200 | AA |  | Front Pullrod |  | $9.85 | 2 | $5.00 | $4.37 | $0.49 | $0.00 | $19.70 | 475
 | Suspension & Shocks | SU 12001 | AA | Front Pullrod | Pullrod tube |  | $9.07 | 2 | $8.06 | $1.01 | $0.00 | $0.00 | $18.14 | 476
 | Suspension & Shocks | SU 12002 | AA | Front Pullrod | Pullrod insert |  | $1.58 | 4 | $0.29 | $1.29 | $0.00 | $0.00 | $6.33 | 477
 | Suspension & Shocks | SU 12003 | AA | Front Pullrod | Spacer 1 |  | $0.35 | 4 | $0.02 | $0.33 | $0.00 | $0.00 | $1.39 | 479
 | Suspension & Shocks | SU 12004 | AA | Front Pullrod | Spacer 2 |  | $0.36 | 4 | $0.02 | $0.34 | $0.00 | $0.00 | $1.46 | 481
 | Suspension & Shocks | SU A1300 | AA |  | Rear Pushrod |  | $9.46 | 2 | $5.00 | $3.97 | $0.49 | $0.00 | $18.91 | 483
 | Suspension & Shocks | SU 13001 | AA | Rear Pushrod | Steel cylinder for pushrod |  | $1.45 | 2 | $0.10 | $1.35 | $0.00 | $0.00 | $2.90 | 484
 | Suspension & Shocks | SU 13002 | AA | Rear Pushrod | Spacer |  | $0.36 | 8 | $0.02 | $0.34 | $0.00 | $0.00 | $2.91 | 486
 | Suspension & Shocks |  |  |  | Area Total |  |  |  | $1865.80 | $924.03 | $12.84 | $14.67 | $2817.33
 | Wheels, Wheel Bearings and Tires | WT A0100 | AA |  | Wheel Assembly |  | $175.23 | 4 | $170.00 | $3.63 | $1.60 | $0.00 | $700.92 | 489
 | Wheels, Wheel Bearings and Tires | WT A0200 | AA |  | Front Hubs |  | $249.36 | 2 | $243.47 | $1.63 | $4.26 | $0.00 | $498.73 | 490
 | Wheels, Wheel Bearings and Tires | WT 02001 | AA | Front Hubs | Front Hub |  | $64.16 | 2 | $13.75 | $50.41 | $0.00 | $0.00 | $128.32 | 491
 | Wheels, Wheel Bearings and Tires | WT 02002 | AA | Front Hubs | Wheel bearing spacer |  | $2.62 | 2 | $0.24 | $2.38 | $0.00 | $0.00 | $5.24 | 493
 | Wheels, Wheel Bearings and Tires | WT 02003 | AA | Front Hubs | Front Wheel Spacer |  | $20.68 | 2 | $3.63 | $17.05 | $0.00 | $0.00 | $41.35 | 495
 | Wheels, Wheel Bearings and Tires | WT 02004 | AA | Front Hubs | Speed sensor spacer |  | $0.95 | 2 | $0.05 | $0.90 | $0.00 | $0.00 | $1.90 | 497
 | Wheels, Wheel Bearings and Tires | WT 02005 | AA | Front Hubs | Speed Sensor Disc |  | $3.97 | 2 | $0.45 | $3.52 | $0.00 | $0.00 | $7.94 | 499
 | Wheels, Wheel Bearings and Tires | WT A0300 | AA |  | Rear Hubs |  | $205.24 | 2 | $199.53 | $1.44 | $4.26 | $0.00 | $410.47 | 501
 | Wheels, Wheel Bearings and Tires | WT 03001 | AA | Rear Hubs | Rear Hub |  | $52.73 | 2 | $12.06 | $40.67 | $0.00 | $0.00 | $105.46 | 502
 | Wheels, Wheel Bearings and Tires | WT 03002 | AA | Rear Hubs | Wheel bearing spacer |  | $3.97 | 2 | $0.67 | $3.30 | $0.00 | $0.00 | $7.94 | 504
 | Wheels, Wheel Bearings and Tires | WT 03003 | AA | Rear Hubs | Rear Wheel Spacer |  | $22.32 | 2 | $3.63 | $18.69 | $0.00 | $0.00 | $44.63 | 506
 | Wheels, Wheel Bearings and Tires | WT 03004 | AA | Rear Hubs | Tripod housing spacer |  | $3.90 | 2 | $0.66 | $3.24 | $0.00 | $0.00 | $7.81 | 508
 | Wheels, Wheel Bearings and Tires | WT 03005 | AA | Rear Hubs | Speed Sensor Disc |  | $3.23 | 2 | $0.35 | $2.88 | $0.00 | $0.00 | $6.45 | 510
 | Wheels, Wheel Bearings and Tires |  |  |  | Area Total |  |  |  | $1636.97 | $306.75 | $23.45 | $0.00 | $1967.17
