epsa-team/Vulcanix-v1.0/Cost Report/Cost final/FSAE_Cost_eBOM_Template.xls

Sheet: Cost Summary
Cost Summary Basics
for: | Ecole Centrale de Lyon
 | Car # 027
Area Totals |  | Materials | Processes | Fasteners | Tooling | Total
 | Brake System | $0.00 | $0.00 | $0.00 | $0.00 | $0.00
 | Engine & Drivetrain | $0.00 | $0.00 | $0.00 | $0.00 | $0.00
 | Frame & Body | $0.00 | $0.00 | $0.00 | $0.00 | $0.00
 | Instruments & Wiring | $0.00 | $0.00 | $0.00 | $0.00 | $0.00
 | Miscellaneous, Fit & Finish | $0.00 | $0.00 | $0.00 | $0.00 | $0.00
 | Steering System | $0.00 | $0.00 | $0.00 | $0.00 | $0.00
 | Suspension & Shocks | $0.00 | $0.00 | $0.00 | $0.00 | $0.00
 | Wheels & Tires | $0.00 | $0.00 | $0.00 | $0.00 | $0.00
 | Total Vehicle | $0.00 | $0.00 | $0.00 | $0.00 | $0.00
Composition for total vehicle:

Sheet: BOM
University | Ecole Centrale de Lyon |  |  |  |  |  |  |  |  |  |  | Total Vehicle Cost |  | 0.00
Competition Code | FSAEM
Year | 10
Car # | 027 |  | The cost of assemlies on this chart should not include the cost of the parts in the assembly but only the materials, processes, fasteners and tooling in the assembly level.
Line Num. | Area of Commodity | Asm/Prt # | Rev. Lvl. | Asm | Component | Description | Unit Cost | Quantity | Material Cost | Process Cost | Fastener Cost | Tooling Cost | Total Cost | Details Page Number
1 | Brake System | A0001 | AA |  | Brake Discs |  | 0.00 |  |  |  |  |  | 0.00
2 | Brake System | 00004 | AA | Brake Discs | Disks |  | 0.00 |  |  |  |  |  | 0.00
3 | Brake System | 00002 | AA | Brake Discs | Keys |  | 0.00 |  |  |  |  |  | 0.00
4 | Brake System | A0002 | AA |  | Brake Fluid |  | 0.00 |  |  |  |  |  | 0.00
5 | Brake System | 00003 | AA | Brake Fluid | Brake Fluid |  | 0.00 |  |  |  |  |  | 0.00
6 | Brake System | A0003 | AA |  | Brake Line |  | 0.00 |  |  |  |  |  | 0.00
7 | Brake System | 00004 | AA | Brake Line | Brake Line - Flexible |  | 0.00 |  |  |  |  |  | 0.00
8 | Brake System | 00005 | AA | Brake Line | Brake Line - Rigid |  | 0.00 |  |  |  |  |  | 0.00
9 | Brake System | A0004 | AA |  | Brake Master Cylinder |  | 0.00 |  |  |  |  |  | 0.00
10 | Brake System | 00006 | AA | Brake Master Cylinder | Brake Master Cylinder |  | 0.00 |  |  |  |  |  | 0.00
11 | Brake System | A0005 | AA |  | Proportioning Valve |  | 0.00 |  |  |  |  |  | 0.00
12 | Brake System | 00007 | AA | Proportioning Valve | Proportioning Valve |  | 0.00 |  |  |  |  |  | 0.00
13 | Brake System | A0006 | AA |  | Balance Bar |  | 0.00 |  |  |  |  |  | 0.00
14 | Brake System | 00008 | AA | Balance Bar | Balance Bar |  | 0.00 |  |  |  |  |  | 0.00
15 | Brake System | A0007 | AA |  | Brake Pads |  | 0.00 |  |  |  |  |  | 0.00
16 | Brake System | 00009 | AA | Brake Pads | Brake Pads |  | 0.00 |  |  |  |  |  | 0.00
17 | Brake System | A0008 | AA |  | Calipers |  | 0.00 |  |  |  |  |  | 0.00
 | Brake System |  |  |  | Area Total |  |  |  | 0.00 | 0.00 | 0.00 | 0.00 | 0.00
 | Engine & Drivetrain | A0001 | AA |  | Engine |  | 0.00 |  |  |  |  |  | 0.00
 | Engine & Drivetrain | A0004 | AA |  | Exhaust Manifold |  | 0.00 |  |  |  |  |  | 0.00
 | Engine & Drivetrain | A0005 | AA |  | Muffler |  | 0.00 |  |  |  |  |  | 0.00
 | Engine & Drivetrain | A0006 | AA |  | Intake Manifold |  | 0.00 |  |  |  |  |  | 0.00
 | Engine & Drivetrain | A0007 | AA |  | Restrictor |  | 0.00 |  |  |  |  |  | 0.00
 | Engine & Drivetrain | A0008 | AA |  | Air Filter |  | 0.00 |  |  |  |  |  | 0.00
 | Engine & Drivetrain | A0009 | AA |  | Turbo/Supercharger |  | 0.00 |  |  |  |  |  | 0.00
 | Engine & Drivetrain | A0010 | AA |  | Carburetor / Throttle Body |  | 0.00 |  |  |  |  |  | 0.00
 | Engine & Drivetrain | A0011 | AA |  | Engine Mounts |  | 0.00 |  |  |  |  |  | 0.00
 | Engine & Drivetrain | A0014 | AA |  | Fuel Injectors |  | 0.00 |  |  |  |  |  | 0.00
 | Engine & Drivetrain | A0015 | AA |  | Fuel Tank |  | 0.00 |  |  |  |  |  | 0.00
 | Engine & Drivetrain | A0016 | AA |  | Fuel Pump |  | 0.00 |  |  |  |  |  | 0.00
 | Engine & Drivetrain | A0017 | AA |  | Fuel Pressure Regulator |  | 0.00 |  |  |  |  |  | 0.00
 | Engine & Drivetrain | A0018 | AA |  | Fuel Filter |  | 0.00 |  |  |  |  |  | 0.00
 | Engine & Drivetrain | 00001 | AA | Fuel Filter | Filter |  | 0.00 |  |  |  |  |  | 0.00
 | Engine & Drivetrain | 00002 | AA | Fuel Filter | Filter Mount |  | 0.00 |  |  |  |  |  | 0.00
 | Engine & Drivetrain | 00003 | AA | Fuel Filter | Fittings |  | 0.00 |  |  |  |  |  | 0.00
 | Engine & Drivetrain | A0019 | AA |  | Fuel Lines / Rails |  | 0.00 |  |  |  |  |  | 0.00
 | Engine & Drivetrain | A0020 | AA |  | Fuel Vent / Check Valve |  | 0.00 |  |  |  |  |  | 0.00
 | Engine & Drivetrain | A0021 | AA |  | Radiator |  | 0.00 |  |  |  |  |  | 0.00
 | Engine & Drivetrain | A0022 | AA |  | Coolant |  | 0.00 |  |  |  |  |  | 0.00
 | Engine & Drivetrain | A0023 | AA |  | Overflow Bottles |  | 0.00 |  |  |  |  |  | 0.00
 | Engine & Drivetrain | A0024 | AA |  | Coolant Lines |  | 0.00 |  |  |  |  |  | 0.00
 | Engine & Drivetrain | A0025 | AA |  | Radiator Fans |  | 0.00 |  |  |  |  |  | 0.00
 | Engine & Drivetrain | A0026 | AA |  | Hose Clamps |  | 0.00 |  |  |  |  |  | 0.00
 | Engine & Drivetrain | A0027 | AA |  | Oil Cooler |  | 0.00 |  |  |  |  |  | 0.00
 | Engine & Drivetrain | A0028 | AA |  | Chain / Belt |  | 0.00 |  |  |  |  |  | 0.00
 | Engine & Drivetrain | A0029 | AA |  | Ignition Coil / Wires |  | 0.00 |  |  |  |  |  | 0.00
 | Engine & Drivetrain | A0030 | AA |  | Axles |  | 0.00 |  |  |  |  |  | 0.00
 | Engine & Drivetrain | A0031 | AA |  | Differential Mounts |  | 0.00 |  |  |  |  |  | 0.00
 | Engine & Drivetrain | A0032 | AA |  | Sprocket / Pulleys |  | 0.00 |  |  |  |  |  | 0.00
 | Engine & Drivetrain | A0034 | AA |  | Differential |  | 0.00 |  |  |  |  |  | 0.00
 | Engine & Drivetrain | 00008 | AA | Differential | Differential Bearings |  | 0.00 |  |  |  |  |  | 0.00
 | Engine & Drivetrain | 00009 | AA | Differential | Differential Internals |  | 0.00 |  |  |  |  |  | 0.00
 | Engine & Drivetrain | 00010 | AA | Differential | Differential End Cap -LH |  | 0.00 |  |  |  |  |  | 0.00
 | Engine & Drivetrain | 00011 | AA | Differential | Differential End Cap - RH |  | 0.00 |  |  |  |  |  | 0.00
 | Engine & Drivetrain | 00012 | AA | Differential | Differential Housing |  | 0.00 |  |  |  |  |  | 0.00
 | Engine & Drivetrain | A0035 | AA |  | CV Joints / U Joints |  | 0.00 |  |  |  |  |  | 0.00
 | Engine & Drivetrain | A0036 | AA |  | Shields |  | 0.00 |  |  |  |  |  | 0.00
 | Engine & Drivetrain | A0037 | AA |  | Engine and Diff Oil |  | 0.00 |  |  |  |  |  | 0.00
 | Engine & Drivetrain |  |  |  | Area Total |  |  |  | 0.00 | 0.00 | 0.00 | 0.00 | 0.00
 | Frame & Body | A0001 | AA |  | Pedals |  | 0.00 |  |  |  |  |  | 0.00
 | Frame & Body | A0002 | AA |  | Shifter |  | 0.00 |  |  |  |  |  | 0.00
 | Frame & Body | A0003 | AA |  | Thottle Controls |  | 0.00 |  |  |  |  |  | 0.00
 | Frame & Body | A0004 | AA |  | Frame |  | 0.00 |  |  |  |  |  | 0.00
 | Frame & Body | A0007 | AA |  | Body |  | 0.00 |  |  |  |  |  | 0.00
 | Frame & Body | A0011 | AA |  | Floor Pan |  | 0.00 |  |  |  |  |  | 0.00
 | Frame & Body | A0012 | AA |  | Clutch |  | 0.00 |  |  |  |  |  | 0.00
 | Frame & Body | A0013 | AA |  | Aerodynamic Wing (if used) |  | 0.00 |  |  |  |  |  | 0.00
 | Frame & Body | A0014 | AA |  | Shifter Cable / Linkage |  | 0.00 |  |  |  |  |  | 0.00
 | Frame & Body |  |  |  | Area Total |  |  |  | 0.00 | 0.00 | 0.00 | 0.00 | 0.00
 | Electrical | A0001 | AA |  | Tachometer |  | 0.00 |  |  |  |  |  | 0.00
 | Electrical | A0002 | AA |  | ECM / Engine Electronics |  | 0.00 |  |  |  |  |  | 0.00
 | Electrical | A0003 | AA |  | Wire Harness / Connectors |  | 0.00 |  |  |  |  |  | 0.00
 | Electrical | A0004 | AA |  | Oil Pressure Gage / Light |  | 0.00 |  |  |  |  |  | 0.00
 | Electrical | A0005 | AA |  | Dash Panel |  | 0.00 |  |  |  |  |  | 0.00
 | Electrical | A0006 | AA |  | Kill Switch |  | 0.00 |  |  |  |  |  | 0.00
 | Electrical | A0007 | AA |  | Fuses |  | 0.00 |  |  |  |  |  | 0.00
 | Electrical | A0008 | AA |  | Water Temperature Gage |  | 0.00 |  |  |  |  |  | 0.00
 | Electrical | A0009 | AA |  | Brake Light Bulb |  | 0.00 |  |  |  |  |  | 0.00
 | Electrical | A0010 | AA |  | Solenoids |  | 0.00 |  |  |  |  |  | 0.00
 | Electrical | A0011 | AA |  | Indicator Lights |  | 0.00 |  |  |  |  |  | 0.00
 | Electrical | A0012 | AA |  | Battery |  | 0.00 |  |  |  |  |  | 0.00
 | Electrical | A0013 | AA |  | Relays |  | 0.00 |  |  |  |  |  | 0.00
 | Electrical | A0014 | AA |  | Starter Button |  | 0.00 |  |  |  |  |  | 0.00
 | Instruments & Wiring |  |  |  | Area Total |  |  |  | 0.00 | 0.00 | 0.00 | 0.00 | 0.00
 | Miscellaneous, Fit & Finish | A0001 | AA |  | Seats |  | 0.00 |  |  |  |  |  | 0.00
 | Miscellaneous, Fit & Finish | A0002 | AA |  | On-Board Fire Suppression Sys. |  | 0.00 |  |  |  |  |  | 0.00
 | Miscellaneous, Fit & Finish | A0003 | AA |  | Safety Harness |  | 0.00 |  |  |  |  |  | 0.00
 | Miscellaneous, Fit & Finish | A0004 | AA |  | Paint - Frame |  | 0.00 |  |  |  |  |  | 0.00
 | Miscellaneous, Fit & Finish | A0005 | AA |  | Paint - Body |  | 0.00 |  |  |  |  |  | 0.00
 | Miscellaneous, Fit & Finish | A0006 | AA |  | Brake Light Housing |  | 0.00 |  |  |  |  |  | 0.00
 | Miscellaneous, Fit & Finish | A0007 | AA |  | Fire Wall |  | 0.00 |  |  |  |  |  | 0.00
 | Miscellaneous, Fit & Finish | A0008 | AA |  | Mirrors (See 3.4.3.2) |  | 0.00 |  |  |  |  |  | 0.00
 | Miscellaneous, Fit & Finish | A0009 | AA |  | Safety Shields |  | 0.00 |  |  |  |  |  | 0.00
 | Miscellaneous, Fit & Finish | A0010 | AA |  | Headrest / Restraints |  | 0.00 |  |  |  |  |  | 0.00
 | Miscellaneous, Fit & Finish |  |  |  | Area Total |  |  |  | 0.00 | 0.00 | 0.00 | 0.00 | 0.00
 | Steering System | A0001 | AA |  | Steering Rack & Pinion |  | 0.00 |  |  |  |  |  | 0.00
 | Steering System | A0002 | AA |  | Tie Rods |  | 0.00 |  |  |  |  |  | 0.00
 | Steering System | A0003 | AA |  | Steering Column & Shaft |  | 0.00 |  |  |  |  |  | 0.00
 | Steering System | A0004 | AA |  | Steering Wheel |  | 0.00 |  |  |  |  |  | 0.00
 | Steering System | A0005 | AA |  | Steering Wheel Quick Release |  | 0.00 |  |  |  |  |  | 0.00
 | Steering System | A0006 | AA |  | Steering Rod Ends & Clevis |  | 0.00 |  |  |  |  |  | 0.00
 | Steering System |  |  |  | Area Total |  |  |  | 0.00 | 0.00 | 0.00 | 0.00 | 0.00
 | Suspension | A0001 | AA |  | Dampers |  | 0.00 |  |  |  |  |  | 0.00
 | Suspension | A0002 | AA |  | Springs |  | 0.00 |  |  |  |  |  | 0.00
 | Suspension | A0003 | AA |  | Suspension Mechanism |  | 0.00 |  |  |  |  |  | 0.00
 | Suspension | A0004 | AA |  | Pushrods / Pullrods |  | 0.00 |  |  |  |  |  | 0.00
 | Suspension | A0005 | AA |  | Front A-Arms or Equivalent |  | 0.00 |  |  |  |  |  | 0.00
 | Suspension | A0006 | AA |  | Rear A-Arms or Equivalent |  | 0.00 |  |  |  |  |  | 0.00
 | Suspension | A0007 | AA |  | Bell Cranks |  | 0.00 |  |  |  |  |  | 0.00
 | Suspension | A0008 | AA |  | Front Uprights |  | 0.00 |  |  |  |  |  | 0.00
 | Suspension | A0009 | AA |  | Rear Uprights |  | 0.00 |  |  |  |  |  | 0.00
 | Suspension | A0010 | AA |  | Rod Ends |  | 0.00 |  |  |  |  |  | 0.00
 | Suspension & Shocks |  |  |  | Area Total |  |  |  | 0.00 | 0.00 | 0.00 | 0.00 | 0.00
 | Wheels & Tires | A0001 | AA |  | Wheels |  | 0.00 |  |  |  |  |  | 0.00
 | Wheels & Tires | A0002 | AA |  | Lug Nuts |  | 0.00 |  |  |  |  |  | 0.00
 | Wheels & Tires | A0003 | AA |  | Tires |  | 0.00 |  |  |  |  |  | 0.00
 | Wheels & Tires | A0004 | AA |  | Valve Stems |  | 0.00 |  |  |  |  |  | 0.00
 | Wheels & Tires | A0005 | AA |  | Wheel Weights |  | 0.00 |  |  |  |  |  | 0.00
 | Wheels & Tires | A0006 | AA |  | Wheel Bearings |  | 0.00 |  |  |  |  |  | 0.00
 | Wheels & Tires | A0007 | AA |  | Wheel Studs |  | 0.00 |  |  |  |  |  | 0.00
 | Wheels & Tires | A0008 | AA |  | Rear Hubs |  | 0.00 |  |  |  |  |  | 0.00
 | Wheels & Tires | A0009 | AA |  | Front Hubs |  | 0.00 |  |  |  |  |  | 0.00
 | Wheels & Tires |  |  |  | Area Total |  |  |  | 0.00 | 0.00 | 0.00 | 0.00 | 0.00
 | Vehicle Total |  |  |  | Total |  |  |  | 0.00 | 0.00 | 0.00 | 0.00 | 0.00
