epsa-team/Vulcanix-v1.0/EL - Electrical/Cost/Cost_EL.xlsx

Sheet: BOM
University | Ecole Centrale de Lyon |  |  |  |  |  |  |  |  |  |  | Total Vehicle Cost |  | #REF!
Competition Code | FSAEI
Year | 2018
Car # | 81 |  | The cost of assemlies on this chart should not include the cost of the parts in the assembly but only the materials, processes, fasteners and tooling in the assembly level.
Line Num. | Area of Commodity | Asm/Prt # | Rev. Lvl. | Asm | Component | Description | Unit Cost | Quantity | Material Cost | Process Cost | Fastener Cost | Tooling Cost | Total Cost | Details Page Number
 | Electrical | EL A0100 | AA |  | Rear firewall instruments and wires |  | $1232.15 | 1 | $1130.85 | $97.45 | $1.85 | $2.00 | $1232.15
 | Electrical | EL 01001 | AA | Rear firewall instruments and wires | Fuse box bracket |  | $0.88 | 2 | $0.02 | $0.87 | $0.00 | $0.00 | $1.77
 | Electrical | EL 01002 | AA | Rear firewall instruments and wires | Ground bracket |  | $0.55 | 2 | $0.01 | $0.54 | $0.00 | $0.00 | $1.09
 | Electrical | EL 01003 | AA | Rear firewall instruments and wires | Break light bracket |  | $0.82 | 2 | $0.01 | $0.82 | $0.00 | $0.00 | $1.64
 | Electrical | EL 01004 | AA | Rear firewall instruments and wires | Master switch panel |  | $75.94 | 1 | $73.60 | $2.34 | $0.00 | $0.00 | $75.94
 | Electrical | EL 01005 | AA | Rear firewall instruments and wires | Master switch panel bracket |  | $0.83 | 2 | $0.01 | $0.82 | $0.00 | $0.00 | $1.65
 | Electrical | EL 01006 | AA | Rear firewall instruments and wires | Crash sensor bracket |  | $2.09 | 1 | $0.07 | $2.02 | $0.00 | $0.00 | $2.09
 | Electrical | EL A0200 | AA |  | Front vehicule electronics |  | $160.80 | 1 | $112.35 | $47.48 | $0.30 | $0.67 | $160.80
 | Electrical | EL 02001 | AA | Front vehicule electronics | Dashboard |  | $114.07 | 1 | $65.73 | $46.34 | $0.00 | $2.00 | $114.07
 | Electrical | EL 02002 | AA | Front vehicule electronics | Dashboard control electronics |  | $234.70 | 1 | $135.00 | $99.30 | $0.40 | $0.00 | $234.70
 | Electrical | EL 02003 | AA | Front vehicule electronics | Dashboard Tap |  | $1.85 | 1 | $0.01 | $1.84 | $0.00 | $0.00 | $1.85
 | Electrical | EL 02004 | AA | Front vehicule electronics | Ground bracket |  | $0.55 | 2 | $0.01 | $0.54 | $0.00 | $0.00 | $1.09
 | Electrical | EL A0300 | AA |  | Battery assembly |  | $89.55 | 1 | $84.52 | $4.19 | $0.18 | $0.67 | $89.55
 | Electrical | EL 03001 | AA | Battery assembly | Main battery mount |  | $4.83 | 1 | $0.97 | $3.86 | $0.00 | $0.00 | $4.83
 | Electrical | EL 03002 | AA | Battery assembly | Side battery mount |  | $3.66 | 2 | $0.26 | $3.40 | $0.00 | $0.00 | $7.31
 | Electrical | EL 03003 | AA | Battery assembly | Battery bracket |  | $0.59 | 3 | $0.01 | $0.58 | $0.00 | $0.00 | $1.76
 | Electrical |  |  |  | Area Total |  |  |  | $1603.70 | $320.54 | $2.73 | $5.33 | $1932.30

Sheet: EL_A0100
University | Ecole Centrale de Lyon |  |  | Back to BOM |  |  |  |  | Car # | 81 |  | Asm Cost | $1316.34
System | Electrical |  |  |  |  |  |  |  |  |  |  | Qty | 1
Assembly | Rear firewall instruments and wires |  |  |  |  |  |  |  | FileLink1
P/N Base | EL A0100 |  |  |  |  |  |  |  | FileLink2 |  |  | Extended Cost | $1316.34
Suffix | AA |  |  |  |  |  |  |  | FileLink3
Details
ItemOrder | Part | Part Cost | Quantity | Sub Total
10 | Fuse box bracket | $0.88 | 2 | $1.77
20 | Ground bracket | $0.55 | 2 | $1.09
30 | Break light bracket | $0.82 | 2 | $1.64
40 | Master switch panel | $75.94 | 1 | $75.94
50 | Master switch panel bracket | $0.83 | 2 | $1.65
60 | Crash sensor bracket | $2.09 | 1 | $2.09
 |  |  | Sub Total | $84.18
ItemOrder | Material | Use | UnitCost | Size1 | Unit1 | Size2 | Unit2 | Area Name | Area | Length | Density | Quantity | Sub Total
10 | ECU, DTA, S80 Pro | DTA | $850.00 |  | unit |  |  |  |  |  |  | 1.00 | $850.00
20 | Sensor, Air Temperature | IAT sensor | $4.00 |  | unit |  |  |  |  |  |  | 1.00 | $4.00
30 | Sensor, Angular position | TPS | $4.00 |  | unit |  |  |  |  |  |  | 1.00 | $4.00
40 | Sensor, Hall effect | Rear wheels speed sensors | $4.00 |  | unit |  |  |  |  |  |  | 2.00 | $8.00
50 | Sensor, Hall effect | Camshaft position sensor | $4.00 |  | unit |  |  |  |  |  |  | 1.00 | $4.00
60 | Sensor, Hall effect | Crankshaft position sensor | $4.00 |  | unit |  |  |  |  |  |  | 1.00 | $4.00
70 | Sensor, Manifold Absolute Pressure (MAP) |  | $4.00 |  | unit |  |  |  |  |  |  | 1.00 | $4.00
80 | Sensor, Temperature | ECT | $8.00 |  | unit |  |  |  |  |  |  | 1.00 | $8.00
90 | Sensor, Two state position | Neutral switch | $4.00 |  | unit |  |  |  |  |  |  | 1.00 | $4.00
100 | Sensor, Two state position | Crash sensor | $4.00 |  | unit |  |  |  |  |  |  | 1.00 | $4.00
110 | Sensor, Fluid pressure | Oil pressure sensor | $4.00 |  | unit |  |  |  |  |  |  | 1.00 | $4.00
120 | Sensor, Wide band air fuel ratio |  | $35.00 |  | unit |  |  |  |  |  |  | 1.00 | $35.00
130 | Connector, Aerospace quality | gearmotor box control | $1.00 |  | pin |  |  |  |  |  |  | 8.00 | $8.00
140 | Connector, Aerospace quality | Firewall interface - 22 pins | $1.00 |  | pin |  |  |  |  |  |  | 22.00 | $22.00
150 | Connector, Computer Type | DB-9 connector for ECU control | $1.00 |  | pin |  |  |  |  |  |  | 9.00 | $9.00
160 | Connector, OEM Quality | TPS - 3 wires | $0.05 |  | pin |  |  |  |  |  |  | 3.00 | $0.15
170 | Connector, OEM Quality | Oil pressure sensor - 2 wires | $0.05 |  | pin |  |  |  |  |  |  | 2.00 | $0.10
180 | Connector, OEM Quality | Neutral switch - 1 wire | $0.05 |  | pin |  |  |  |  |  |  | 1.00 | $0.05
190 | Connector, OEM Quality | ECT - 2 wires | $0.05 |  | pin |  |  |  |  |  |  | 2.00 | $0.10
200 | Connector, OEM Quality | Lambda sensor - 2x3 wires | $0.05 |  | pin |  |  |  |  |  |  | 6.00 | $0.30
210 | Connector, OEM Quality | Camshaft position sensor - 2 wires | $0.05 |  | pin |  |  |  |  |  |  | 2.00 | $0.10
220 | Connector, OEM Quality | Crankshaft position sensor - 2 wires | $0.05 |  | pin |  |  |  |  |  |  | 2.00 | $0.10
230 | Connector, OEM Quality | ECU - 38 wires | $0.05 |  | pin |  |  |  |  |  |  | 38.00 | $1.90
240 | Connector, OEM Quality | Fan - 2 wires | $0.05 |  | pin |  |  |  |  |  |  | 2.00 | $0.10
250 | Connector, OEM Quality | Ignition coils - 2x4 wires | $0.05 |  | pin |  |  |  |  |  |  | 8.00 | $0.40
260 | Connector, OEM Quality | Fuel injection - 2x4 wires | $0.05 |  | pin |  |  |  |  |  |  | 8.00 | $0.40
270 | Connector, OEM Quality | Crash sensor - 2 wires | $0.05 |  | pin |  |  |  |  |  |  | 2.00 | $0.10
280 | Connector, OEM Quality | MAP & IAT - 4 wires | $0.05 |  | pin |  |  |  |  |  |  | 4.00 | $0.20
290 | Connector, High Power, >2Amps | Regulator input - 3 wires | $2.00 |  | pin |  |  |  |  |  |  | 3.00 | $6.00
300 | Connector, High Power, >2Amps | Regulator output - 2 wires | $2.00 |  | pin |  |  |  |  |  |  | 2.00 | $4.00
310 | Connector, High Power, >2Amps | Starter motor - 1 wire | $2.00 |  | pin |  |  |  |  |  |  | 1.00 | $2.00
320 | Connector, High Power, >2Amps | Gearmotor box supply - 2 wires | $2.00 |  | pin |  |  |  |  |  |  | 2.00 | $4.00
330 | Connector, Single wire | Fuel pump | $0.05 |  | wire |  |  |  |  |  |  | 2.00 | $0.10
340 | Connector, Single wire | Break light | $0.05 |  | wire |  |  |  |  |  |  | 6.00 | $0.30
350 | Connector, Single wire | Connection to frame's ground | $0.05 |  | wire |  |  |  |  |  |  | 4.00 | $0.20
360 | Fuse box | 4 relays, 8 fuses -> 32 pins | $0.25 |  | pin |  |  |  |  |  |  | 32.00 | $8.00
370 | Relay, power | Starter motor, ECU, fuel pump, fan, gearmotor | $4.00 |  | unit |  |  |  |  |  |  | 5.00 | $20.00
380 | Fuse, power |  | $1.00 |  | unit |  |  |  |  |  |  | 8.00 | $8.00
390 | Fuse box | 250A fuse handler | $0.25 |  | unit |  |  |  |  |  |  | 2.00 | $0.50
400 | Fuse, power | 250A fuse | $1.00 |  | unit |  |  |  |  |  |  | 1.00 | $1.00
410 | Wire, signal |  | $1.00 |  | m |  |  |  |  |  |  | 35.00 | $35.00
420 | Wire sleeving, split |  | $0.50 |  | m |  |  |  |  |  |  | 1.50 | $0.75
430 | Wire, Power |  | $3.00 |  | m |  |  |  |  |  |  | 10.00 | $30.00
440 | Heat Shrink Tubing |  | $0.50 |  | m |  |  |  |  |  |  | 4.00 | $2.00
450 | Switch, Kill | Master switch | $3.00 |  | unit |  |  |  |  |  |  | 1.00 | $3.00
460 | Chassis Control Module, Baseline Enclosure | Gearmotor box | $25.00 |  | unit |  |  |  |  |  |  | 1.00 | $25.00
470 | Chassis Control Module, +Automatic Shifter | Gearmotor box | $5.00 |  | unit |  |  |  |  |  |  | 1.00 | $5.00
 |  |  |  |  |  |  |  |  |  |  |  | Sub Total | $1130.85
ItemOrder | Process | Use | UnitCost | Unit | Quantity | Multiplier | Mult. Val. | Sub Total
10 | Weld | Brackets welding | $0.15 | cm | 15 |  |  | $2.25
20 | Aerosol apply | Brackets painting | $5.25 | m^2 | 0.00838 |  |  | $0.04
30 | Aerosol apply | Gearmotor box painting | $5.25 | m^2 | 7.92e-05 |  |  | $0.0004158
40 | Assemble, 1kg, Loose | Assemble Master switch panel on brackets | $0.06 | unit | 1 |  |  | $0.06
50 | Assemble, 3kg, Loose | Assemble ECU on vehicle | $0.19 | unit | 1 |  |  | $0.19
60 | Assemble, 1kg, Loose | Lambda sensor | $0.06 | unit | 1 |  |  | $0.06
70 | Assemble, 1kg, Loose | Assemble fuse box on fuse box brackets | $0.06 | unit | 1 |  |  | $0.06
80 | Cut wire | Cut sensor to appropriate length | $0.08 | unit | 104 |  |  | $8.32
90 | Strip wire | Strip wire ends | $0.08 | unit | 208 |  |  | $16.64
100 | Cut (scissors, knife) | Cut heat shrink tubing | $0.06 | cm | 1 | repeat 15 | 15 | $0.90
110 | Shrink tube | Install and route wiring harness | $0.15 | cm | 30 |  |  | $4.50
120 | Connector assembly, crimp |  | $0.36 | contact | 108 |  |  | $38.88
130 | Connector Install, Circular, Bayonet |  | $0.11 | unit | 5 |  |  | $0.55
140 | Taping Wire Bundle |  | $0.04 | cm | 300 |  |  | $12.00
150 | Wire Dressing (install and route) |  | $1.00 | m | 4 |  |  | $4.00
160 | Ratchet <= 6.35 mm |  | $0.50 | unit | 12 |  |  | $6.00
170 | Reaction Tool <= 6.35 mm |  | $0.25 | unit | 12 |  |  | $3.00
 |  |  |  |  |  |  | Sub Total | $97.45
ItemOrder | Fastener | Use | UnitCost | Size1 | Unit1 | Size2 | Unit2 | Quantity | Sub Total
10 | Bolt,Grade 8.8 (SAE) | Regulator redressor | $0.04 | 3 | mm | 15 | mm | 3 | $0.12
20 | Washer, Grade 8.8 (SAE 5) | Regulator redressor | $0.01 | 3 | mm |  |  | 3 | $0.03
30 | Nut, Grade 8.8 (SAE 5) | Regulator redressor | $0.01 | 3 | mm |  |  | 3 | $0.03
40 | Bolt,Grade 8.8 (SAE) | Fuse box | $0.04 | 4 | mm | 15 | mm | 2 | $0.08
50 | Washer, Grade 8.8 (SAE 5) | Fuse box | $0.02 | 4 | mm |  |  | 2 | $0.04
60 | Nut, Grade 8.8 (SAE 5) | Fuse box | $0.01 | 4 | mm |  |  | 2 | $0.02
70 | Bolt,Grade 8.8 (SAE) | Master switch brackets | $0.04 | 4 | mm | 15 | mm | 2 | $0.08
80 | Washer, Grade 8.8 (SAE 5) | Master switch brackets | $0.02 | 4 | mm |  |  | 2 | $0.04
90 | Nut, Grade 8.8 (SAE 5) | Master switch brackets | $0.01 | 4 | mm |  |  | 2 | $0.02
100 | Bolt,Grade 8.8 (SAE) | Master switch | $0.04 | 4 | mm | 15 | mm | 2 | $0.08
110 | Washer, Grade 8.8 (SAE 5) | Master switch | $0.02 | 4 | mm |  |  | 2 | $0.04
120 | Nut, Grade 8.8 (SAE 5) | Master switch | $0.01 | 4 | mm |  |  | 2 | $0.02
130 | Bolt,Grade 8.8 (SAE) | M3 on ground brackets | $0.04 | 4 | mm | 15 | mm | 3 | $0.12
140 | Washer, Grade 8.8 (SAE 5) | M3 on ground brackets | $0.02 | 4 | mm |  |  | 3 | $0.06
150 | Nut, Grade 8.8 (SAE 5) | M3 on ground brackets | $0.01 | 4 | mm |  |  | 3 | $0.03
160 | Bolt,Grade 8.8 (SAE) | Crash sensor | $0.04 | 3 | mm | 15 | mm | 2 | $0.08
170 | Washer, Grade 8.8 (SAE 5) | Crash sensor | $0.02 | 3 | mm |  |  | 2 | $0.04
180 | Nut, Grade 8.8 (SAE 5) | Crash sensor | $0.01 | 3 | mm |  |  | 2 | $0.02
190 | Hook and Loop, Hook Side (Velcro) | For ECU and motogear box | $0.003 | 60 | cm^2 |  |  | 1 | $0.18
200 | Hook and Loop, Loop Side (Velcro) | For ECU and motogear box | $0.002 | 60 | cm^2 |  |  | 1 | $0.12
210 | Tie wrap | For harness routing | $0.04 | 1 | unit |  |  | 15 | $0.60
 |  |  |  |  |  |  |  | Sub Total | $1.85
ItemOrder | Tooling | Use | UnitCost | Unit | Quantity | PVF | FractionIncluded | Sub Total
10 | Welds - Welding Fixture | Brackets welding | $500.00 | point | 12 | 3000 | 1 | $2.00
 |  |  |  |  |  |  | Sub Total | $2.00

Sheet: EL_01001
University | Ecole Centrale de Lyon |  |  |  |  | Back to BOM |  |  | Car # | 81 |  | Part Cost | $0.88
System | Electrical |  | FileLink1 | Drawing |  |  |  |  |  |  |  | Qty | 2
Assembly | Rear firewall instruments and wires |  | FileLink2 |  |  |  |  |  | FileLink1
Part | Fuse box bracket |  | FileLink3 |  |  |  |  |  | FileLink2 |  |  | Extended Cost | $1.77
P/N Base | EL 01001 |  |  |  |  |  |  |  | FileLink3
Suffix | AA
Details
ItemOrder | Material | Use | UnitCost | Size1 | Unit1 | Size2 | Unit2 | Area Name | Area | Length | Density | Quantity | Sub Total
10 | Steel, mild | Stock material for part | $2.25 | 0.007 | kg |  |  | Rectangular | 0.000312 | 0.003 | 7850 | 1 | $0.02
 |  |  |  |  |  |  |  |  |  |  |  | Sub Total | $0.02
ItemOrder | Process | Use | UnitCost | Unit | Quantity | Multiplier | Mult. Val. | Sub Total
10 | Machining Setup, Install and remove | Setup for laser cutting | $1.30 | unit | 1 | 2 parts cut from a single machine setup | 0.5 | $0.65
20 | Laser Cut | Cutout shape | $0.01 | cm | 7.23 | Material - Steel | 3 | $0.22
 |  |  |  |  |  |  | Sub Total | $0.87

Sheet: dEL_01001
Drawing part : | EL 01001

Sheet: EL_01002
University | Ecole Centrale de Lyon |  |  |  |  | Back to BOM |  |  | Car # | 81 |  | Part Cost | $0.55
System | Electrical |  | FileLink1 | Drawing |  |  |  |  |  |  |  | Qty | 2
Assembly | Rear firewall instruments and wires |  | FileLink2 |  |  |  |  |  | FileLink1
Part | Ground bracket |  | FileLink3 |  |  |  |  |  | FileLink2 |  |  | Extended Cost | $1.09
P/N Base | EL 01002 |  |  |  |  |  |  |  | FileLink3
Suffix | AA
Details
ItemOrder | Material | Use | UnitCost | Size1 | Unit1 | Size2 | Unit2 | Area Name | Area | Length | Density | Quantity | Sub Total
10 | Steel, mild | Stock material for part | $2.25 | 0.002 | kg |  |  | Rectangular | 0.000195 | 0.002 | 7850 | 1 | $0.01
 |  |  |  |  |  |  |  |  |  |  |  | Sub Total | $0.01
ItemOrder | Process | Use | UnitCost | Unit | Quantity | Multiplier | Mult. Val. | Sub Total
10 | Machining Setup, Install and remove | Setup for laser cutting | $1.30 | unit | 1 | 3 parts cut from a single machine setup | 0.33 | $0.43
20 | Laser Cut | Cutout shape | $0.01 | cm | 3.6 | Material - Steel | 3 | $0.11
 |  |  |  |  |  |  | Sub Total | $0.54

Sheet: dEL_01002
Drawing part : | EL 01002

Sheet: EL_01003
University | Ecole Centrale de Lyon |  |  |  |  | Back to BOM |  |  | Car # | 81 |  | Part Cost | $0.82
System | Electrical |  | FileLink1 | Drawing |  |  |  |  |  |  |  | Qty | 2
Assembly | Rear firewall instruments and wires |  | FileLink2 |  |  |  |  |  | FileLink1
Part | Break light bracket |  | FileLink3 |  |  |  |  |  | FileLink2 |  |  | Extended Cost | $1.64
P/N Base | EL 01003 |  |  |  |  |  |  |  | FileLink3
Suffix | AA
Details
ItemOrder | Material | Use | UnitCost | Size1 | Unit1 | Size2 | Unit2 | Area Name | Area | Length | Density | Quantity | Sub Total
10 | Steel, mild | Stock material for part | $2.25 | 0.002531625 | kg |  |  | Rectangular | 0.000215 | 0.002 | 7850 | 1 | $0.01
 |  |  |  |  |  |  |  |  |  |  |  | Sub Total | $0.01
ItemOrder | Process | Use | UnitCost | Unit | Quantity | Multiplier | Mult. Val. | Sub Total
10 | Machining Setup, Install and remove | Setup for laser cutting | $1.30 | unit | 1 | 2 parts cut from a single machine setup | 0.5 | $0.65
20 | Laser Cut | Cutout shape | $0.01 | cm | 5.5 | Material - Steel | 3 | $0.17
 |  |  |  |  |  |  | Sub Total | $0.82

Sheet: dEL_01003
Drawing part : | EL 01003

Sheet: EL_01004
University | Ecole Centrale de Lyon |  |  |  |  | Back to BOM |  |  | Car # | 81 |  | Part Cost | $75.94
System | Electrical |  | FileLink1 |  |  |  |  |  |  |  |  | Qty | 1
Assembly | Rear firewall instruments and wires |  | FileLink2 |  |  |  |  |  | FileLink1
Part | Master switch panel |  | FileLink3 |  |  |  |  |  | FileLink2 |  |  | Extended Cost | $75.94
P/N Base | EL 01004 |  |  |  |  |  |  |  | FileLink3
Suffix | AA
Details
ItemOrder | Material | Use | UnitCost | Size1 | Unit1 | Size2 | Unit2 | Area Name | Area | Length | Density | Quantity | Sub Total
10 | Carbon Fiber Reinf Carbon | Stock material for part | $0.0092 | 8000 | mm^3 |  |  |  |  |  |  | 1 | $73.60
 |  |  |  |  |  |  |  |  |  |  |  | Sub Total | $73.60
ItemOrder | Process | Use | UnitCost | Unit | Quantity | Multiplier | Mult. Val. | Sub Total
10 | Machining Setup, Install and remove | Setup for laser cutting | $1.30 | unit | 1 |  |  | $1.30
20 | Laser Cut | Cutout shape | $0.01 | cm | 52.2 | Material - Composite | 2 | $1.04
 |  |  |  |  |  |  | Sub Total | $2.34

Sheet: EL_01005
University | Ecole Centrale de Lyon |  |  |  |  | Back to BOM |  |  | Car # | 81 |  | Part Cost | $0.83
System | Electrical |  | FileLink1 | Drawing |  |  |  |  |  |  |  | Qty | 2
Assembly | Rear firewall instruments and wires |  | FileLink2 |  |  |  |  |  | FileLink1
Part | Master switch panel bracket |  | FileLink3 |  |  |  |  |  | FileLink2 |  |  | Extended Cost | $1.65
P/N Base | EL 01005 |  |  |  |  |  |  |  | FileLink3
Suffix | AA
Details
ItemOrder | Material | Use | UnitCost | Size1 | Unit1 | Size2 | Unit2 | Area Name | Area | Length | Density | Quantity | Sub Total
10 | Steel, mild | Stock material for part | $2.25 | 0.003 | kg |  |  | Rectangular | 0.000216 | 0.002 | 7850 | 1 | $0.01
 |  |  |  |  |  |  |  |  |  |  |  | Sub Total | $0.01
ItemOrder | Process | Use | UnitCost | Unit | Quantity | Multiplier | Mult. Val. | Sub Total
10 | Machining Setup, Install and remove | Setup for laser cutting | $1.30 | unit | 1 | 2 parts cut from a single machine setup | 0.5 | $0.65
20 | Laser Cut | Cutout shape | $0.01 | cm | 5.66 | Material - Steel | 3 | $0.17
 |  |  |  |  |  |  | Sub Total | $0.82

Sheet: dEL_01005
Drawing part : | EL 01005

Sheet: EL_01006
University | Ecole Centrale de Lyon |  |  |  |  | Back to BOM |  |  | Car # | 81 |  | Part Cost | $2.09
System | Electrical |  | FileLink1 | Drawing |  |  |  |  |  |  |  | Qty | 1
Assembly | Rear firewall instruments and wires |  | FileLink2 |  |  |  |  |  | FileLink1
Part | Crash sensor bracket |  | FileLink3 |  |  |  |  |  | FileLink2 |  |  | Extended Cost | $2.09
P/N Base | EL 01006 |  |  |  |  |  |  |  | FileLink3
Suffix | AA
Details
ItemOrder | Material | Use | UnitCost | Size1 | Unit1 | Size2 | Unit2 | Area Name | Area | Length | Density | Quantity | Sub Total
10 | Steel, mild | Stock material for part | $2.25 | 0.03 | kg |  |  | Rectangular | 0.002538 | 0.002 | 7850 | 1 | $0.07
 |  |  |  |  |  |  |  |  |  |  |  | Sub Total | $0.07
ItemOrder | Process | Use | UnitCost | Unit | Quantity | Multiplier | Mult. Val. | Sub Total
10 | Machining Setup, Install and remove | Setup for laser cutting | $1.30 | unit | 1 |  |  | $1.30
20 | Laser Cut | Cutout shape | $0.01 | cm | 24 | Material - Steel | 3 | $0.72
 |  |  |  |  |  |  | Sub Total | $2.02

Sheet: dEL_01006
Drawing part : | EL 01006

Sheet: EL A0200
University | Ecole Centrale de Lyon |  |  | Back to BOM |  |  |  |  | Car # | 81 |  | Asm Cost | $512.51
System | Electrical |  |  |  |  |  |  |  |  |  |  | Qty | 1
Assembly | Front vehicule electronics |  |  |  |  |  |  |  | FileLink1
P/N Base | EL A0200 |  |  |  |  |  |  |  | FileLink2 |  |  | Extended Cost | $512.51
Suffix | AA |  |  |  |  |  |  |  | FileLink3
Details | Dashboard assembly, dashboard control electronics and front harness
ItemOrder | Part | Part Cost | Quantity | Sub Total
10 | Dashboard | $114.07 | 1 | $114.07
20 | Dashboard control electronics | $234.70 | 1 | $234.70
30 | Dashboard Tap | $1.85 | 1 | $1.85
40 | Ground bracket | $0.55 | 2 | $1.09
 |  |  | Sub Total | $351.71
ItemOrder | Material | Use | UnitCost | Size1 | Unit1 | Size2 | Unit2 | Area Name | Area | Length | Density | Quantity | Sub Total
10 | Lamp, LED | RPM counter | $0.50 | 1 | unit |  |  |  |  |  |  | 10.00 | $5.00
20 | Display, 7 Segment | Water temperature | $1.00 | 1 | unit |  |  |  |  |  |  | 3.00 | $3.00
30 | Display, 7 Segment | Gear | $1.00 | 1 | unit |  |  |  |  |  |  | 1.00 | $1.00
40 | Lamp, LED | Oil temperature alert | $1.00 | 1 | unit |  |  |  |  |  |  | 1.00 | $1.00
50 | Lamp, LED | Shift light | $1.00 | 1 | unit |  |  |  |  |  |  | 1.00 | $1.00
60 | Lamp, LED | Fan light | $1.00 | 1 | unit |  |  |  |  |  |  | 1.00 | $1.00
70 | Lamp, LED | Neutral light | $1.00 | 1 | unit |  |  |  |  |  |  | 1.00 | $1.00
80 | Lamp, LED | Contact light | $1.00 | 1 | unit |  |  |  |  |  |  | 1.00 | $1.00
90 | Switch, Toggle | Data logger switch | $1.00 | 1 | unit |  |  |  |  |  |  | 1.00 | $1.00
100 | Switch, Pushbutton | Launch control button | $1.00 | 1 | unit |  |  |  |  |  |  | 1.00 | $1.00
110 | Switch, Toggle | Wet/Dry switch | $1.00 | 1 | unit |  |  |  |  |  |  | 1.00 | $1.00
120 | Switch, Toggle | Traction control switch | $1.00 | 1 | unit |  |  |  |  |  |  | 1.00 | $1.00
130 | Switch, Pushbutton | Homing shifter | $1.00 | 1 | unit |  |  |  |  |  |  | 1.00 | $1.00
140 | Switch, Toggle | Fan switch | $1.00 | 1 | unit |  |  |  |  |  |  | 1.00 | $1.00
150 | Switch, Toggle | Contact switch | $1.00 | 1 | unit |  |  |  |  |  |  | 1.00 | $1.00
160 | Switch, Pushbutton | Start button | $1.00 | 1 | unit |  |  |  |  |  |  | 1.00 | $1.00
170 | Switch, Kill | Circuit breaker | $3.00 | 1 | unit |  |  |  |  |  |  | 1.00 | $3.00
180 | Connector, Aerospace Quality | Firewall connexion 1 | $1.00 | 1 | pin |  |  |  |  |  |  | 16.00 | $16.00
190 | Connector, Aerospace Quality | Firewall connexion 2 | $1.00 | 1 | pin |  |  |  |  |  |  | 5.00 | $5.00
200 | Connector, Single Wire | Ground ring | $0.05 | 1 | unit |  |  |  |  |  |  | 2.00 | $0.10
210 | Connector, Single Wire | Break over travel switch spades | $0.05 | 1 | unit |  |  |  |  |  |  | 2.00 | $0.10
220 | Wire, Signal |  | $1.00 | 1 | m |  |  |  |  |  |  | 46.00 | $46.00
230 | Wire, Power |  | $3.00 | 1 | m |  |  |  |  |  |  | 3.00 | $9.00
240 | Connector, OEM quality | Shift pads | $0.05 | 1 | pin |  |  |  |  |  |  | 3.00 | $0.15
250 | Switch, Kill | Break over travel switch | $3.00 | 1 | unit |  |  |  |  |  |  | 1.00 | $3.00
260 | Sensor, Hall effect | Front wheels speed sensors | $4.00 | 1 | unit |  |  |  |  |  |  | 2.00 | $8.00
 |  |  |  |  |  |  |  |  |  |  |  | Sub Total | $112.35
ItemOrder | Process | Use | UnitCost | Unit | Quantity | Multiplier | Mult. Val. | Sub Total
10 | Weld | Weld taps in frame | $0.15 | cm | 1.8 |  |  | $0.27
 | Cut wire |  | $0.08 | unit | 53 |  |  | $4.24
 | Strip wire |  | $0.08 | unit | 106 |  |  | $8.48
 | Connector assembly, crimp | Firewall connexion | $0.36 | contact | 21 |  |  | $7.56
 | Connector Install, Circular, Bayonet |  | $0.11 | unit | 3 |  |  | $0.33
 | Wire Dressing (install and route) |  | $1.00 | m | 4 |  |  | $4.00
 | Cut (scissors, knife) | Cut heat shrink tubing | $0.06 | cm | 1 | repeat 35 | 35 | $2.10
 | Shrink tube |  | $0.15 | cm | 30 |  |  | $4.50
 | Taping wire bundle |  | $0.04 | cm | 400 |  |  | $16.00
 |  |  |  |  |  |  | Sub Total | $47.48
ItemOrder | Fastener | Use | UnitCost | Size1 | Unit1 | Size2 | Unit2 | Quantity | Sub Total
10 | Bolt, Grade 8.8 (SAE 5) | Bolts to fix the dislays and leds | $0.03 | 3 | mm |  |  | 6 | $0.18
20 | Nut, Grade 8.8 (SAE 5) | Nuts to fix the dislays and leds | $0.02 | 3 | mm |  |  | 6 | $0.12
 |  |  |  |  |  |  |  | Sub Total | $0.30
ItemOrder | Tooling | Use | UnitCost | Unit | Quantity | PVF | FractionIncluded | Sub Total
10 | Welds - Welding fixture | Material to weld the tabs | $500.00 | point | 4 | 3000 | 1 | $0.67
 |  |  |  |  |  |  | Sub Total | $0.67

Sheet: EL 02001
University | Ecole Centrale de Lyon |  |  |  |  | Back to BOM |  |  | Car # | 81 |  | Part Cost | $114.07
System | Electrical |  | FileLink1 |  |  |  |  |  |  |  |  | Qty | 1
Assembly | Front vehicule electronics |  | FileLink2 |  |  |  |  |  | FileLink1
Part | Dashboard |  | FileLink3 |  |  |  |  |  | FileLink2 |  |  | Extended Cost | $114.07
P/N Base | EL 02001 |  |  |  |  |  |  |  | FileLink3
Suffix | AA
Details | Dashboard support
ItemOrder | Material | Use | UnitCost | Size1 | Unit1 | Size2 | Unit2 | Area Name | Area | Length | Density | Quantity | Sub Total
10 | Carbon Fiber, 1 Ply | Dashboard composite | $200.00 | 0.33 | kg |  |  | rectangle | 0.052 | 0.004 | 1580 | 1.00 | $65.73
 |  |  |  |  |  |  |  |  |  |  |  | Sub Total | $65.73
ItemOrder | Process | Use | UnitCost | Unit | Quantity | Multiplier | Mult. Val. | Sub Total
10 | Cut (sicssors, knife) | Carbon fiber cutting | $0.06 | cm | 218 | Material - Composite | 2 | $26.16
20 | Lamination, Manual | Lamination of the ply | $35.00 | m² | 0.041 | Material - Composite | 2 | $2.87
30 | Resin application, Manual | Resin application on the ply | $5.00 | m² | 0.041 |  | 2 | $0.41
40 | Vacuum form |  | $10.00 | m² | 0.041 |  |  | $0.41
50 | Cure, Room Temperature | Curing | $10.00 | m² | 0.041 |  |  | $0.41
60 | Machining Setup, Install and remove | Setup for dashboard cuting | $1.30 | Unit | 1 |  |  | $1.30
70 | Waterjet Cut | Cutting the outer profile and the holes | $0.01 | cm | 218 |  |  | $2.18
80 | Drilled hols <25,4mm dia. | Drilling fasteners hole | $0.35 | hole | 36 |  |  | $12.60
 |  |  |  |  |  |  | Sub Total | $46.34
ItemOrder | Tooling | Use | UnitCost | Unit | Quantity | PVF | FracIncld | Sub Total
10 | Lamination - Flat Panel Tool | Mold for all plates | $1500.00 | m² | 4 | 3000 | 1 | $2.00
 |  |  |  |  |  |  | Sub Total | $2.00

Sheet: EL 02002
University | Ecole Centrale de Lyon |  |  |  |  | Back to BOM |  |  | Car # | 81 |  | Part Cost | $234.70
System | Electrical |  | FileLink1 |  |  |  |  |  |  |  |  | Qty | 1
Assembly | Front vehicule electronics |  | FileLink2 |  |  |  |  |  | FileLink1
Part | Dashboard control electronics |  | FileLink3 |  |  |  |  |  | FileLink2 |  |  | Extended Cost | $234.70
P/N Base | EL 02002 |  |  |  |  |  |  |  | FileLink3
Suffix | AA
Details | Embedded electronics and wire connections to dashboard control
ItemOrder | Material | Use | UnitCost | Size1 | Unit1 | Size2 | Unit2 | Area Name | Area | Length | Density | Quantity | Sub Total
10 | Wire, Signal | Electronic board communication | $1.00 | 1 | m |  |  |  |  |  |  | 32.00 | $32.00
20 | Wire, Power | Electronic board power | $3.00 | 1 | m |  |  |  |  |  |  | 2.00 | $6.00
30 | Chassis Control Module, +Dashboard | Student made electronic board | $20.00 |  | unit |  |  |  |  |  |  | 1.00 | $20.00
40 | Connector, Aerospace Quality | Signal connection with dashboard | $1.00 |  | pin |  |  |  |  |  |  | 32.00 | $32.00
50 | Connector, Aerospace Quality | Power connection with dashboard | $1.00 |  | pin |  |  |  |  |  |  | 2.00 | $2.00
60 | Connector, Aerospace Quality | Signal connection with rear vehicle electronics | $1.00 |  | pin |  |  |  |  |  |  | 8.00 | $8.00
70 | Connector, Aerospace Quality | Power connection with rear vehicle electronics | $1.00 |  | pin |  |  |  |  |  |  | 8.00 | $8.00
80 | Connector, Aerospace Quality | Connection with Break Over Travel switch | $1.00 |  | pin |  |  |  |  |  |  | 2.00 | $2.00
90 | Chassis Control Module, Baseline Enclosure | Electronic board box | $25.00 |  | unit |  |  |  |  |  |  | 1.00 | $25.00
 |  |  |  |  |  |  |  |  |  |  |  | Sub Total | $135.00
ItemOrder | Process | Use | UnitCost | Unit | Quantity | Multiplier | Mult. Val. | Sub Total
10 | Cut Wire | Cut wires in correct size | $0.08 | unit | 40 |  |  | $3.20
20 | Strip Wire | Strip wire ends | $0.08 | unit | 80 |  |  | $6.40
30 | Crimp Wire | Crip wires | $0.17 | unit | 80 |  |  | $13.60
40 | Connector Assembly, Crimp | Crimp Molex and Souriau connectors | $0.36 | unit | 80 |  |  | $28.80
50 | Lay Wire - Control | Lay control wires | $0.02 | m | 40 |  |  | $0.80
60 | Connector Install, Square, Friction | Molex connector install | $0.14 | unit | 40 |  |  | $5.60
70 | Wire Dressing (Install and route) | Wires instalation | $1.00 | m | 40 |  |  | $40.00
80 | Install Tie Wrap (Zip Tie, Cable Clamp) | Tie wrap instalation | $0.09 | unit | 10 |  |  | $0.90
 |  |  |  |  |  |  | Sub Total | $99.30
ItemOrder | Fastener | Use | UnitCost | Size1 | Unit1 | Size2 | Unit2 | Quantity | Sub Total
10 | Install Tie Wrap (Zip Tie, Cable Clamp) | Wires | $0.04 |  |  |  |  | 10 | $0.40
 |  |  |  |  |  |  |  | Sub Total | $0.40

Sheet: EL 02003
University | Ecole Centrale de Lyon |  |  |  |  | Back to BOM |  |  | Car # | 81 |  | Part Cost | $1.85
System | Electrical |  | FileLink1 | Drawing |  |  |  |  |  |  |  | Qty | 1
Assembly | Front vehicule electronics |  | FileLink2 |  |  |  |  |  | FileLink1
Part | Dashboard Tap |  | FileLink3 |  |  |  |  |  | FileLink2 |  |  | Extended Cost | $1.85
P/N Base | EL 02003 |  |  |  |  |  |  |  | FileLink3
Suffix | AA
Details | Attachement to frame tap
ItemOrder | Material | Use | UnitCost | Size1 | Unit1 | Size2 | Unit2 | Area Name | Area | Length | Density | Quantity | Sub Total
10 | Steel, Mild | Material for part | $2.25 | 0.004 | kg |  |  | rectangle | 0.052 | 0.004 | 1580 | 1.00 | $0.01
 |  |  |  |  |  |  |  |  |  |  |  | Sub Total | $0.01
ItemOrder | Process | Use | UnitCost | Unit | Quantity | Multiplier | Mult. Val. | Sub Total
10 | Machining Setup, Install and remove | Laser cut setup | $1.30 | unit | 1 |  | 1 | $1.30
20 | Laser Cut | Cutout shape | $0.01 | cm | 29.5 |  | 1 | $0.29
20 | Sheet metal bends | Part bend | $0.25 | unit | 1.0 |  | 1 | $0.25
 |  |  |  |  |  |  | Sub Total | $1.84

Sheet: dEL 02003
Drawing part : | EL 02003

Sheet: EL_02004
University | Ecole Centrale de Lyon |  |  |  |  | Back to BOM |  |  | Car # | 81 |  | Part Cost | $0.55
System | Electrical |  | FileLink1 | Drawing |  |  |  |  |  |  |  | Qty | 2
Assembly | Front vehicule electronics |  | FileLink2 |  |  |  |  |  | FileLink1
Part | Ground bracket |  | FileLink3 |  |  |  |  |  | FileLink2 |  |  | Extended Cost | $1.09
P/N Base | EL 02004 |  |  |  |  |  |  |  | FileLink3
Suffix | AA
Details
ItemOrder | Material | Use | UnitCost | Size1 | Unit1 | Size2 | Unit2 | Area Name | Area | Length | Density | Quantity | Sub Total
10 | Steel, mild | Stock material for part | $2.25 | 0.002 | kg |  |  | Rectangular | 0.000195 | 0.002 | 7850 | 1 | $0.01
 |  |  |  |  |  |  |  |  |  |  |  | Sub Total | $0.01
ItemOrder | Process | Use | UnitCost | Unit | Quantity | Multiplier | Mult. Val. | Sub Total
10 | Machining Setup, Install and remove | Setup for laser cutting | $1.30 | unit | 1 | 3 parts cut from a single machine setup | 0.33 | $0.43
20 | Laser Cut | Cutout shape | $0.01 | cm | 3.6 | Material - Steel | 3 | $0.11
 |  |  |  |  |  |  | Sub Total | $0.54

Sheet: dEL 02004
Drawing part : | EL 02004

Sheet: EL_A0300
University | Ecole Centrale de Lyon |  |  | Back to BOM |  |  |  |  | Car # | 81 |  | Asm Cost | $103.45
System | Electrical |  |  |  |  |  |  |  |  |  |  | Qty | 1
Assembly | Battery assembly |  |  |  |  |  |  |  | FileLink1
P/N Base | EL A0300 |  |  |  |  |  |  |  | FileLink2 |  |  | Extended Cost | $103.45
Suffix | AA |  |  |  |  |  |  |  | FileLink3
Details | Li-Ion battery assembly
ItemOrder | Part | Part Cost | Quantity | Sub Total
10 | Main battery mount | $4.83 | 1 | $4.83
20 | Side battery mount | $3.66 | 2 | $7.31
30 | Battery bracket | $0.59 | 3 | $1.76
 |  |  | Sub Total | $13.90
ItemOrder | Material | Use | UnitCost | Size1 | Unit1 | Size2 | Unit2 | Area Name | Area | Length | Density | Quantity | Sub Total
10 | Battery, Advanced chemistry (Li-Ion) | Starter battery LiFePo4 | $65.00 | 1.3 | kg |  |  |  |  |  |  | 1.00 | $84.50
20 | Paint | Brackets painting | $10.00 | 0.0005 | m^2 |  |  |  |  |  |  | 3.00 | $0.01
 |  |  |  |  |  |  |  |  |  |  |  | Sub Total | $84.52
ItemOrder | Process | Use | UnitCost | Unit | Quantity | Multiplier | Mult. Val. | Sub Total
10 | Weld | Tabs welding on frame | $0.15 | cm |  |  |  | $0.00
20 | Aerosol apply | Tabs painting | $5.25 | m^2 |  |  |  | $0.00
30 | Assemble, 1kg, Loose | Side to main battery mount | $0.25 | unit | 2 |  |  | $0.50
40 | Riveting | Side mounts to main mount | $0.25 | unit | 8 |  |  | $2.00
50 | Assemble, 1kg, Line-on-line | Insert Battery in bracket | $0.13 | unit | 1 |  |  | $0.13
60 | Assemble, 1kg, Loose | Insert battery mount on backet | $0.06 | unit | 1 |  |  | $0.06
70 | Ratchet <= 6.35 mm | Insert battery mount on bracket | $0.50 |  | 2 |  |  | $1.00
80 | Reaction tool <= 6.35mm | Insert battery mount on bracket | $0.25 |  | 2 |  |  | $0.50
 |  |  |  |  |  |  | Sub Total | $4.19
ItemOrder | Fastener | Use | UnitCost | Size1 | Unit1 | Size2 | Unit2 | Quantity | Sub Total
10 | Bolt,Grade 8.8 (SAE 5) | M6 for battery mount on tab | $0.04 | 6 | mm | 20 | mm | 2 | $0.08
20 | Nut, Grade 8.8 (SAE 5) | M6 for battery mount on tab | $0.03 | 6 | mm |  |  | 2 | $0.06
30 | Washer, Grade 8.8 (SAE 5) | M6 for battery mount on tab | $0.01 | 6 | mm |  |  | 4 | $0.04
 |  |  |  |  |  |  |  | Sub Total | $0.18
ItemOrder | Tooling | Use | UnitCost | Unit | Quantity | PVF | FractionIncluded | Sub Total
10 | Welds - Welding Fixture | Brackets welding on frame | $500.00 | point | 4 | 3000 | 1 | $0.67
 |  |  |  |  |  |  | Sub Total | $0.67

Sheet: EL_03001
University | Ecole Centrale de Lyon |  |  |  |  | Back to BOM |  |  | Car # | 81 |  | Part Cost | $4.83
System | Electrical |  | FileLink1 | Drawing |  |  |  |  |  |  |  | Qty | 1
Assembly | Battery assembly |  | FileLink2 |  |  |  |  |  | FileLink1
Part | Main battery mount |  | FileLink3 |  |  |  |  |  | FileLink2 |  |  | Extended Cost | $4.83
P/N Base | EL 03001 |  |  |  |  |  |  |  | FileLink3
Suffix | AA
Details | To carry the battery
ItemOrder | Material | Use | UnitCost | Size1 | Unit1 | Size2 | Unit2 | Area Name | Area | Length | Density | Quantity | Sub Total
10 | Aluminium, Normal |  | $4.20 | 0.231 | kg |  |  | Rectangular area, 265x161mm | 0.0427 | 0.002 | 2712 | 1.00 | $0.97
 |  |  |  |  |  |  |  |  |  |  |  | Sub Total | $0.97
ItemOrder | Process | Use | UnitCost | Unit | Quantity | Multiplier | Mult. Val. | Sub Total
10 | Machining Setup, Install and remove | Setup for laser cutting | $1.30 | unit | 1 |  | 1 | $1.30
20 | Laser Cut | Cutout shape | $0.01 | cm | 185.68 |  | 1 | $1.86
30 | Sheet metal bends |  | $0.35 | bend | 2 |  | 1 | $0.70
 |  |  |  |  |  |  | Sub Total | $3.86

Sheet: dEL_03001
Drawing part : | EL 03001

Sheet: EL_03002
University | Ecole Centrale de Lyon |  |  |  |  | Back to BOM |  |  | Car # | 81 |  | Part Cost | $3.66
System | Electrical |  | FileLink1 | Drawing |  |  |  |  |  |  |  | Qty | 2
Assembly | Battery assembly |  | FileLink2 |  |  |  |  |  | FileLink1
Part | Side battery mount |  | FileLink3 |  |  |  |  |  | FileLink2 |  |  | Extended Cost | $7.31
P/N Base | EL 03002 |  |  |  |  |  |  |  | FileLink3
Suffix | AA
Details | To carry the battery
ItemOrder | Material | Use | UnitCost | Size1 | Unit1 | Size2 | Unit2 | Area Name | Area | Length | Density | Quantity | Sub Total
10 | Aluminium, Normal |  | $4.20 | 0.061 | kg |  |  | Rectangular area, 112x100mm | 0.0112 | 0.002 | 2712 | 1.00 | $0.26
 |  |  |  |  |  |  |  |  |  |  |  | Sub Total | $0.26
ItemOrder | Process | Use | UnitCost | Unit | Quantity | Multiplier | Mult. Val. | Sub Total
10 | Machining Setup, Install and remove |  | $1.30 | unit | 1 |  |  | $1.30
20 | Laser Cut | Cutout shape | $0.01 | cm | 70.02 |  |  | $0.70
30 | Sheet metal design |  | $0.35 | bend | 4 |  |  | $1.40
 |  |  |  |  |  |  | Sub Total | $3.40
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
