epsa-team/Vulcanix-v1.0/EN - Engine & Powertrain/Cost/cost_drivetrain.xlsx

Sheet: Instructions
Petite marche à suivre pour remplir cette merveille qu'est le cost
Etape 1 | Créer l'assemblage
Feuille EN Assembly : Feuille pour 1 assemblage du système EN. Pour un nouvel assemblage, créer un nouveau document à partir du template. 1 document Excel = 1 assemblage
Donner un nom clair à l'assemblage (et en anglais ^^) dans la ligne Assembly
Lui donner un code suivant la règle XX AYYYY dans la ligne P/N Base , avec XX le code de votre partie et YYYY le numéro de l'assemblage (c'est le même code que celui que vous avez dû utiliser sous CATIA)
Renommer l'onglet avec ce même code. Enregistrer le document Excel sous ce même nom.
Donner une brève description (en anglais) de l'assemblage dans la ligne Details
Renommer la zone où le code P/N Base est entré. Pour cela selectionner la cellule par un simple clic, cliquer ensuite dans le menu déroulant en haut à gauche indiquant le nom de la cellule (à côté de la barre de formule)
Renomme cette cellule du nom du code qu'elle comprend mais avec un _ comme séparateur : ex EN_A0001
Cette étape est importante pour créer des hyperliens ensuite
Renommer les cases quantité (cellule N3), et sous-totaux par respectivement code_de_l'assemblage_x avec x = q pour quantité, pa pour part, m pour material, f pour fastener, t pour tooling et p pour process
ex EN_A0001_q, …
Vérifier que la formule dans Asm Cost (cellule N2) renvoie aux noms corrects des cellules prcédentes. Sinon, faire les modifications nécessaires.
Etape 2 | Remplir les données de l'assemblage
Remplir la quantité, Material, Process, Fastener, Tooling. Dans le cas où une table n'est pas concernée (elle est restée vide), la supprimer complètement.
Consulter le tutoriel disponible sur GitHub, dans Vulcanix-v1.0/Cost Report, pour plus d'informations sur cette étape.
Etape 3 | Créer les parts
Feuille EN Part x : Feuille pour 1 part de l'assemblage. Pour faire une nouvelle part, créer un nouvel onglet à partir du template. 1 onglet = 1 part.
Dans la ligne Assembly, indiquer le nom de l'assemblage parent en mettant = puis en sélectionnant le bonne cellule de la page assemblies
Lui donner un nom en clair (et en anglais ^^) dans la ligne Part
Lui donner un code suivant la règle XX YYZZZ dans la ligne P/N Base , avec XX le code de votre partie et YY le numéro de l'assemblage et ZZZ le numéro de la part dans cet assemblage (même code que sous CATIA)
Renommer l'onglet avec ce même code.
Donner une brève description (en anglais) de la Part dans la ligne Details
Renommer la zone où le code P/N Base est entré. Pour cela selectionner la cellule par un simple clic, cliquer ensuite dans le menu déroulant en haut à gauche indiquant le nom de la cellule (à côté de la barre de formule)
Renommer cette cellule du nom du code qu'elle comprend mais avec un _ comme séparateur : ex EN_01001
Créer un lien vers l'assemblage : sélectionner la cellule, faites Ctrl+K, il apparait une fenetre, en référence de la cellule (A1 par défaut) indiquez le nom de la cellule renommé de l'assemblage (par ex EN_A0001)
Renommer les cases quantité (cellule N3), et sous-totaux de chaque part respectivement code_de_la_part_x avec x = q pour quantité, m pour material, f pour fastener, t pour tooling et p pour process
ex : EN_01001_q, …
Vérifier que la formule dans Part Cost (cellule N2) renvoie aux noms corrects des cellules prcédentes. Sinon, faire les modifications nécessaires.
Etape 4 | Remplir les données
Remplir la quantité (nombre d'occurrence de la pièce dans un seul assemblage).
Remplir les tables Material, Fastener, Process et Tooling. Dans le cas où une table n'est pas concernée (elle est restée vide), la supprimer complètement.
Ajouter une illustration de la part (photo propre sur fond blanc si possible, vue CATIA sinon) dans la plus basse définition possible svp, on est limité en taille de fichier
Etape 5 | Ajouter les plans
Faites une capture d'écran du plan de la part en question et coller l'image dans l'onglet "EN Drawing 1"
Au-dessus du plan écrire "Drawing part :" et dans la cellule d'à côté mettre le code de la Part en question
Ajouter un lien pour pouvoir revenir vers le détail de la Part sur cette cellule
Renommer la cellule avec le nouveau lien d_code_de_la_part, ex dEN_01001
Renommer l'onglet avec ce même code
Dans le détail de la part (onglet "EN Part x") écrire à côté de cellule File Link "Drawing" et mettre un lien vers la cellule surplombant le plan ayant le code d_code_de_la_part (ex dEN_01001)
Insérer un lien vers la Part sur le plan par clic droit sur l'image. Cible du lien vers la Part (ex EN_01001)
On peut faire 2 colonnes de plan pour des tailles différentes. La référence reste les plans en paysage.
Etape 6 | Inserer les Parts dans l'assemblage
Remplir dans l'assemblage les cellules nom / part cost et quantity pour chaque parts (toujours en dynamique, ne faites pas de copier coller svp)
Insérer un lien vers la part sur le nom de celle-ci. Pour cela :
sélectionner la cellule, faites Ctrl+K, apparait une fenetre, en référence de la cellule (A1 par défaut) indiquez le nom de la cellule renommé de la Part (par ex EN_01001)
Etape 7 | Remplir la BOM
Il s'agit de faire la nomenclature de votre partie dans l'onglet BOM
De manière générale la colonne description ne sera pas remplie
Commencez par l'assemblage (de couleur plus foncée)
Cellule ASM/PRT# mettre le code de l'assemblage
Laisser la cellule ASM vide
Mettre le nom de l'assemblage dans Component, avec un lien vers l'assemblage en question
Remplir les cellules Quantity, Material, Process, Fastener et Tooling cost. Pour ça :
il suffit de mettre = Code de la pièce _ x avec q pour quantité, m pour material, p pour process, f pour fastener, t pour tooling (vous aviez renommé les cellules avant)
Viennent ensuite les Parts. Pour chaque Part :
Code dans ASM/PRT# aligné à droite, nom de l'assemblage parent dans ASM, Nom de la part dans Component
Mettre un lien vers la part en question sur le nom de cette dernière
Remplir les cellules Quantity, Material, Process, Fastener et Tooling cost. Pour ça :
il suffit de mettre = Code de la pièce _ x avec q pour quantité, m pour material, p pour process, f pour fastener, t pour tooling (vous aviez renommé les cellules avant)
Pour la quantité des parts : mettre la quantité absolue sur la voiture !!! Du coup c'est quantité de l'assemblage * quantité de cette part dans l'assemblage
Pour toute question, contacter Raphaël Mounet ou Clément Marie par Messenger de préférence, par mail sinon.

Sheet: BOM
University | Ecole Centrale de Lyon |  |  |  |  |  |  |  |  |  |  | Total Vehicle Cost |  | #REF!
Competition Code | FSAEI
Year | 2018
Car # | 81 |  | The cost of assemlies on this chart should not include the cost of the parts in the assembly but only the materials, processes, fasteners and tooling in the assembly level.
Line Num. | Area of Commodity | Asm/Prt # | Rev. Lvl. | Asm | Component | Description | Unit Cost | Quantity | Material Cost | Process Cost | Fastener Cost | Tooling Cost | Total Cost | Details Page Number
 | Engine & Drivetrain | #NAME? | AA |  | Nom de l'assemblage 1 |  | #NAME? | #NAME? | #NAME? | #NAME? | #NAME? | #NAME? | #NAME?
 | Engine & Drivetrain | #NAME? | AA | Nom de l'assemblage 1 | Housing |  | #NAME? | #NAME? | #NAME? | #NAME? | #NAME? | #NAME? | #NAME?
 | Engine & Drivetrain |  | AA |  |  |  | $0.00 |  |  |  |  |  | $0.00
 | Engine & Drivetrain |  | AA |  |  |  | $0.00 |  |  |  |  |  | $0.00
 | Engine & Drivetrain |  | AA |  |  |  | $0.00 |  |  |  |  |  | $0.00
 | Engine & Drivetrain |  | AA |  |  |  | $0.00 |  |  |  |  |  | $0.00
 | Engine & Drivetrain |  | AA |  |  |  | $0.00 |  |  |  |  |  | $0.00
 | Engine & Drivetrain |  | AA |  |  |  | $0.00 |  |  |  |  |  | $0.00
 | Engine & Drivetrain |  | AA |  |  |  | $0.00 |  |  |  |  |  | $0.00
 | Engine & Drivetrain |  | AA |  |  |  | $0.00 |  |  |  |  |  | $0.00
 | Engine & Drivetrain |  | AA |  |  |  | $0.00 |  |  |  |  |  | $0.00
 | Engine & Drivetrain |  |  |  | Area Total |  |  |  | #NAME? | #NAME? | #NAME? | #NAME? | #NAME?

Sheet: EN_A0900
University | Ecole Centrale de Lyon |  |  | Back to BOM |  |  |  |  | Car # | 81 |  | Asm Cost | $402.70
System | Engine & Drivetrain |  |  |  |  |  |  |  |  |  |  | Qty | 1
Assembly | Differential Assembly |  |  |  |  |  |  |  | FileLink1
P/N Base | EN_A0900 |  |  |  |  |  |  |  | FileLink2 |  |  | Extended Cost | $402.70
Suffix | AA |  |  |  |  |  |  |  | FileLink3
Details | Differential housing and mounting assembly
ItemOrder | Part | Part Cost | Quantity | Sub Total
10 | Housing | $125.94 | 1 | $125.94
20 | Left Eccentric | $10.90 | 1 | $10.90
30 | Right Eccentric | $8.54 | 1 | $8.54
40 | Left Eccentric Carrier | $23.96 | 1 | $23.96
50 | Right Eccentric Carrier | $17.20 | 1 | $17.20
60 | Upper Eccentric Carrier bracket | $1.00 | 4 | $3.98
70 | Lower Eccentric Carrier bracket | $0.97 | 4 | $3.88
80 | Left Jacking Bar bracket | $2.20 | 1 | $2.20
90 | Right Jacking Bar bracket | $2.21 | 1 | $2.21
 |  |  | Sub Total | $198.81
ItemOrder | Material | Use | UnitCost | Size1 | Unit1 | Size2 | Unit2 | Area Name | Area | Length | Density | Quantity | Sub Total
20 | Bearing, Ball, Deep groove | Left differential bearing | $38.18 | 90 | mm | 18 | mm |  |  |  |  | 1 | $38.18
10 | Bearing, Ball, Deep groove | Right differential bearing | $32.00 | 80 | mm | 16 | mm |  |  |  |  | 1 | $32.00
30 | Paint | Paint the brackets | $10.00 | 0.024 | m^2 |  |  |  |  |  |  | 1 | $0.24
40 | Fluid, Oil | Differential oil | $0.75 | 0.06 | litre |  |  |  |  |  |  | 1 | $0.04
50 | Differential Internals, Limited Slip, Salisbury or Powerflow or Clutch Style |  | $110.00 | 1 | unit |  |  |  |  |  |  | 1 | $110.00
 |  |  |  |  |  |  |  |  |  |  |  | Sub Total | $180.47
ItemOrder | Process | Use | UnitCost | Unit | Quantity | Multiplier | Mult. Val. | Sub Total
10 | Weld | Weld tabs to frame | $0.15 | cm | 56.54 |  | 1 | $8.48
20 | Aerosol apply | Paint the tabs | $5.25 | m^2 | 0.024 |  | 1 | $0.13
30 | Assemble, 3 kg, Interference | Assemble the housing | $0.56 | unit | 2 |  | 1 | $1.12
40 | Assemble, 1 kg, Interference | Assemble the right bearing and eccentric | $0.19 | unit | 1 |  | 1 | $0.19
50 | Assemble, 1 kg, Interference | Assemble the left bearing and eccentric | $0.19 | unit | 1 |  | 1 | $0.19
60 | Assemble, 1 kg, Interference | Assemble the bearing carriers and the bearings | $0.19 | unit | 2 |  | 1 | $0.38
70 | Ratchet <= 6,35mm | Bolt the bearing carriers to eccentric | $0.50 | unit | 4 |  | 1 | $2.00
80 | Reaction Tool <=6,35mm | Bolt the bearing carriers to eccentric | $0.25 | unit | 4 |  | 1 | $1.00
90 | Assemble, 3kg, Line-on-Line | Put the bearing carriers and tabs in place | $0.38 | unit | 2 |  | 1 | $0.76
100 | Assemble, 1kg, Loose | Put two washers on bolt | $0.06 | unit | 4 |  | 1 | $0.24
110 | Ratchet <=25,4mm | Bolt the left bearing carrier to tabs | $0.75 | unit | 2 |  | 1 | $1.50
120 | Reaction Tool <=25,4mm | Bolt the left bearing carrier to tabs | $0.25 | unit | 2 |  | 1 | $0.50
130 | Ratchet <=25,4mm | Bolt the right bearing carrier to tabs | $0.75 | unit | 2 |  | 1 | $1.50
140 | Reaction Tool <=25,4mm | Bolt the right bearing carrier to tabs | $0.25 | unit | 2 |  | 1 | $0.50
 |  |  |  |  |  |  | Sub Total | $18.49
ItemOrder | Fastener | Use | UnitCost | Size1 | Unit1 | Size2 | Unit2 | Quantity | Sub Total
10 | Bolt, Grade 8,8 (SAE 5) | Assemble left bearing carrier and tabs | $0.53 | 12 | mm | 50 | mm | 2 | $1.05
20 | Nut, Grade 8,8 (SAE 5) | Assemble left bearing carrier and tabs | $0.10 | 12 | mm |  |  | 2 | $0.20
30 | Bolt, Grade 8,8 (SAE 5) | Blocking left bearing carrier and left eccentric | $0.12 | 8 | mm | 30 | mm | 2 | $0.24
40 | Nut, Grade 8,8 (SAE 5) | Blocking left bearing carrier and left eccentric | $0.04 | 8 | mm |  |  | 2 | $0.09
50 | Washer, Grade 8,8 (SAE 5) | Blocking eccentric | $0.01 |  | unit |  |  | 4 | $0.04
60 | Bolt, Grade 8,8 (SAE 5) | Assemble right bearing carrier and tabs | $0.12 | 8 | mm | 30 | mm | 2 | $0.24
70 | Nut, Grade 8,8 (SAE 5) | Assemble right bearing carrier and tabs | $0.04 | 8 | mm |  |  | 2 | $0.09
80 | Bolt, Grade 8,8 (SAE 5) | Blocking right bearing carrier and right eccentric | $0.12 | 8 | mm | 30 | mm | 2 | $0.24
90 | Nut, Grade 8,8 (SAE 5) | Blocking right bearing carrier and right eccentric | $0.04 | 8 | mm |  |  | 2 | $0.09
 |  |  |  |  |  |  |  | Sub Total | $2.27
ItemOrder | Tooling | Use | UnitCost | Unit | Quantity | PVF | FractionIncluded | Sub Total
10 | Welds - Welding Fixture | Weld tabs to frame | $500.00 | point | 16 | 3000 | 1 | $2.67
 |  |  |  |  |  |  | Sub Total | $2.67

Sheet: EN_0900_001
University | Ecole Centrale de Lyon |  |  |  |  | Back to BOM |  |  | Car # | 81 |  | Part Cost | $125.94
System | Engine & Drivetrain |  | FileLink1 | Drawing |  |  |  |  |  |  |  | Qty | 1
Assembly | Differential |  | FileLink2 |  |  |  |  |  | FileLink1
Part | Housing |  | FileLink3 |  |  |  |  |  | FileLink2 |  |  | Extended Cost | $125.94
P/N Base | EN_0900_001 |  |  |  |  |  |  |  | FileLink3
Suffix | AA
Details | Bought, cost as made
ItemOrder | Material | Use | UnitCost | Size1 | Unit1 | Size2 | Unit2 | Area Name | Area | Length | Density | Quantity | Sub Total
10 | Aluminium, Premium |  | $4.20 | 1.906 | kg |  |  | Round 102mm diam. | 0.008171282492 | 0.086 | 2712 | 1 | $8.00
20 | Aluminium, Premium |  | $4.20 | 1.396 | kg |  |  | Round 102mm diam. | 0.008171282492 | 0.063 | 2712 | 1 | $5.86
30 | Aluminium, Premium |  | $4.20 | 1.773 | kg |  |  | Round 102mm diam. | 0.008171282492 | 0.080 | 2712 | 1 | $7.45
40 | Seal, O-Ring, Elastomer |  | $0.05 |  | unit |  |  |  |  |  |  | 2 | $0.10
 |  |  |  |  |  |  |  |  |  |  |  | Sub Total | $21.41
ItemOrder | Process | Use | UnitCost | Unit | Quantity | Multiplier | Mult. Val. | Sub Total
10 | Machining Setup, Install and remove | Setup and removal | $1.30 | unit | 1 |  | 1 | $1.30
20 | Machining | Machining | $0.04 | cm^3 | 623 | Material-Aluminium | 1 | $24.92
30 | Tapping holes | Tapping lateral holes | $0.35 | hole | 24 |  | 1 | $8.40
40 | Tapping holes | Tapping central holes | $0.35 | hole | 3 |  | 1 | $1.05
50 | Machining Setup, Install and remove | Setup and removal | $1.30 | unit | 1 |  | 1 | $1.30
60 | Machining | Machining | $0.04 | cm^3 | 426 | Material-Aluminium | 1 | $17.04
70 | Drilled holes < 25.4 mm dia. | Hole for the diff. Housing | $0.35 | hole | 12 |  | 1 | $4.20
80 | Broach, External | Broach the housing cover | $0.50 | cm | 3.5 |  | 1 | $1.75
90 | Machining Setup, Install and remove | Setup and removal | $1.30 | unit | 1 |  | 1 | $1.30
100 | Machining | Machining | $0.04 | cm^3 | 538 | Material-Aluminium | 1 | $21.52
110 | Drilled holes < 25.4 mm dia. | Hole for the diff. Cover | $0.35 | hole | 12 |  | 1 | $4.20
120 | Assemble, 1 kg, Line-on-Line | Assemble the three parts | $0.13 | unit | 2 |  | 1 | $0.26
130 | Ratchet <= 6.35 mm | Assemble the three parts | $0.50 | unit | 24 |  | 1 | $12.00
140 | Ratchet <= 25.4 mm | Bolt the drain | $0.75 | unit | 3 |  | 1 | $2.25
 |  |  |  |  |  |  | Sub Total | $101.49
ItemOrder | Fastener | Use | UnitCost | Size1 | Unit1 | Size2 | Unit2 | Quantity | Sub Total
10 | Bolt, Grade 12.9 | Assembly of the three parts | $0.06 | 6 | mm | 14 | mm | 24 | $1.35
20 | Washer, Grade 12.9 |  | $0.02 |  | unit |  |  | 24 | $0.48
30 | Bolt, Grade 10.9 (SAE 8) |  | $0.07 | 8 | mm | 8 | mm | 3 | $0.20
40 | Washer, Crush |  | $0.34 | 8 | mm |  |  | 3 | $1.01
 |  |  |  |  |  |  |  | Sub Total | $3.03

Sheet: EN_0900_002
University | Ecole Centrale de Lyon |  |  |  |  | Back to BOM |  |  | Car # | 81 |  | Part Cost | $10.90
System | Engine & Drivetrain |  | FileLink1 | Drawing |  |  |  |  |  |  |  | Qty | 1
Assembly | Differential |  | FileLink2 |  |  |  |  |  | FileLink1
Part | Left Eccentric |  | FileLink3 |  |  |  |  |  | FileLink2 |  |  | Extended Cost | $10.90
P/N Base | EN_0900_002 |  |  |  |  |  |  |  | FileLink3
Suffix | AA
Details
ItemOrder | Material | Use | UnitCost | Size1 | Unit1 | Size2 | Unit2 | Area Name | Area | Length | Density | Quantity | Sub Total
10 | Plastic, Polyoxymethylene (POM) |  | $3.30 | 0.786 | kg |  |  | 175mm diam | 0.02405281875 | 0.023 | 1420 | 1 | $2.59
 |  |  |  |  |  |  |  |  |  |  |  | Sub Total | $2.59
ItemOrder | Process | Use | UnitCost | Unit | Quantity | Multiplier | Mult. Val. | Sub Total
10 | Machining Setup, Install and remove | Setup for machining | $1.30 | Unit | 1 |  |  | $1.30
20 | Machining | Holes | $0.04 | cm^3 | 350.61 | Material - Plastic | 0.5 | $7.01
 |  |  |  |  |  |  | Sub Total | $8.31

Sheet: EN_0900_002 Drawing
EN_0900_002

Sheet: EN_0900_003
University | Ecole Centrale de Lyon |  |  |  |  | Back to BOM |  |  | Car # | 81 |  | Part Cost | $8.54
System | Engine & Drivetrain |  | FileLink1 | Drawing |  |  |  |  |  |  |  | Qty | 1
Assembly | Differential |  | FileLink2 |  |  |  |  |  | FileLink1
Part | Right Eccentric |  | FileLink3 |  |  |  |  |  | FileLink2 |  |  | Extended Cost | $8.54
P/N Base | EN_0900_003 |  |  |  |  |  |  |  | FileLink3
Suffix | AA
Details
ItemOrder | Material | Use | UnitCost | Size1 | Unit1 | Size2 | Unit2 | Area Name | Area | Length | Density | Quantity | Sub Total
10 | Plastic, Polyoxymethylene (POM) |  | $3.30 | 0.607 | kg |  |  | 165mm diam | 0.021382465 | 0.020 | 1420 | 1 | $2.00
 |  |  |  |  |  |  |  |  |  |  |  | Sub Total | $2.00
ItemOrder | Process | Use | UnitCost | Unit | Quantity | Multiplier | Mult. Val. | Sub Total
10 | Machining Setup, Install and remove | Setup for machining | $1.30 | Unit | 1 |  |  | $1.30
20 | Machining | Holes | $0.04 | cm^3 | 261.75 | Material - Plastic | 0.5 | $5.24
 |  |  |  |  |  |  | Sub Total | $6.54

Sheet: EN_0900_003 Drawing
EN_0900_003

Sheet: EN_0900_004
University | Ecole Centrale de Lyon |  |  |  |  | Back to BOM |  |  | Car # | 81 |  | Part Cost | $23.96
System | Engine & Drivetrain |  | FileLink1 | Drawing |  |  |  |  |  |  |  | Qty | 1
Assembly | Differential |  | FileLink2 |  |  |  |  |  | FileLink1
Part | Left Eccentric carrier |  | FileLink3 |  |  |  |  |  | FileLink2 |  |  | Extended Cost | $23.96
P/N Base | EN_0900_004 |  |  |  |  |  |  |  | FileLink3
Suffix | AA |  |  |  |  |  |  |  |  |  |  |  |  | 373.663
Details
ItemOrder | Material | Use | UnitCost | Size1 | Unit1 | Size2 | Unit2 | Area Name | Area | Length | Density | Quantity | Sub Total
10 | Aluminium, Premium | Material for the left bearing carrier | $4.20 | 1.846 | kg |  |  | Rectangular area 374x130 mm | 0.04862 | 0.014 | 2712 | 1 | $7.75
 |  |  |  |  |  |  |  |  |  |  |  | Sub Total | $7.75
ItemOrder | Process | Use | UnitCost | Unit | Quantity | Multiplier | Mult. Val. | Sub Total
10 | Machining Setup, Install and remove | Setup and removal of the machining of the right bearing carrier | $1.30 | Unit | 1 |  |  | $1.30
20 | Machining | Shaping of the differential bearing carrier | $0.04 | cm^3 | 372.58 | Material - Aluminium | 1 | $14.90
 |  |  |  |  |  |  | Sub Total | $16.20

Sheet: EN_0900_004 Drawing
EN_0900_004

Sheet: EN_0900_005
University | Ecole Centrale de Lyon |  |  |  |  | Back to BOM |  |  | Car # | 81 |  | Part Cost | $17.20
System | Engine & Drivetrain |  | FileLink1 | Drawing |  |  |  |  |  |  |  | Qty | 1
Assembly | Differential |  | FileLink2 |  |  |  |  |  | FileLink1
Part | Right Eccentric carrier |  | FileLink3 |  |  |  |  |  | FileLink2 |  |  | Extended Cost | $17.20
P/N Base | EN_0900_005 |  |  |  |  |  |  |  | FileLink3
Suffix | AA
Details
ItemOrder | Material | Use | UnitCost | Size1 | Unit1 | Size2 | Unit2 | Area Name | Area | Length | Density | Quantity | Sub Total
10 | Aluminium, Premium | Material for the left bearing carrier | $4.20 | 1.339 | kg |  |  | Rectangular area 374x120 mm | 0.04488 | 0.011 | 2712 | 1 | $5.62
 |  |  |  |  |  |  |  |  |  |  |  | Sub Total | $5.62
ItemOrder | Process | Use | UnitCost | Unit | Quantity | Multiplier | Mult. Val. | Sub Total
10 | Machining Setup, Install and remove | Setup and removal of the machining of the right bearing carrier | $1.30 | Unit | 1 |  |  | $1.30
20 | Machining | Shaping of the differential bearing carrier | $0.04 | cm^3 | 256.88 | Material - Aluminium | 1 | $10.28
 |  |  |  |  |  |  | Sub Total | $11.58

Sheet: EN_0900_005 Drawing
EN_0900_005

Sheet: EN_0900_006
University | Ecole Centrale de Lyon |  |  |  |  | Back to BOM |  |  | Car # | 81 |  | Part Cost | $1.00
System | Engine & Drivetrain |  | FileLink1 | Drawing |  |  |  |  |  |  |  | Qty | 4
Assembly | Differential |  | FileLink2 |  |  |  |  |  | FileLink1
Part | Upper Eccentric Carrier bracket |  | FileLink3 |  |  |  |  |  | FileLink2 |  |  | Extended Cost | $3.98
P/N Base | EN_0900_006 |  |  |  |  |  |  |  | FileLink3
Suffix | AA
Details
ItemOrder | Material | Use | UnitCost | Size1 | Unit1 | Size2 | Unit2 | Area Name | Area | Length | Density | Quantity | Sub Total
10 | Steel, Mild | Material for the bracket | $2.25 | 0.037 | kg |  |  | Rectangular area 46x34 mm | 0.001564 | 0.003 | 7850 | 1 | $0.08
 |  |  |  |  |  |  |  |  |  |  |  | Sub Total | $0.08
ItemOrder | Process | Use | UnitCost | Unit | Quantity | Multiplier | Mult. Val. | Sub Total
10 | Machining Setup, Install and remove | Setup for machining | $1.30 | Unit | 1 | 4 parts cut from a single machine setup | 0.25 | $0.33
20 | Laser Cut | Shaping of the brackets and holes | $0.01 | cm | 19.6 | Material, Steel | 3 | $0.59
 |  |  |  |  |  |  | Sub Total | $0.91

Sheet: EN_0900_006 Drawing
EN_0900_006

Sheet: EN_0900_007
University | Ecole Centrale de Lyon |  |  |  |  | Back to BOM |  |  | Car # | 81 |  | Part Cost | $0.97
System | Engine & Drivetrain |  | FileLink1 | Drawing |  |  |  |  |  |  |  | Qty | 4
Assembly | Differential |  | FileLink2 |  |  |  |  |  | FileLink1
Part | Lower Eccentric Carrier bracket |  | FileLink3 |  |  |  |  |  | FileLink2 |  |  | Extended Cost | $3.88
P/N Base | EN_0900_007 |  |  |  |  |  |  |  | FileLink3
Suffix | AA
Details
ItemOrder | Material | Use | UnitCost | Size1 | Unit1 | Size2 | Unit2 | Area Name | Area | Length | Density | Quantity | Sub Total
10 | Steel, Mild | Material for the bracket | $2.25 | 0.031 | kg |  |  | Rectangular area 46x29 mm | 0.001334 | 0.003 | 7850 | 1 | $0.07
 |  |  |  |  |  |  |  |  |  |  |  | Sub Total | $0.07
ItemOrder | Process | Use | UnitCost | Unit | Quantity | Multiplier | Mult. Val. | Sub Total
10 | Machining Setup, Install and remove | Setup for machining | $1.30 | Unit | 1 | 4 parts cut from a single machine setup | 0.25 | $0.33
20 | Laser Cut | Shaping of the brackets and holes | $0.01 | cm | 19.12 | Material, Steel | 3 | $0.57
 |  |  |  |  |  |  | Sub Total | $0.90

Sheet: EN_0900_007 Drawing
EN_0900_007

Sheet: EN_0900_008
University | Ecole Centrale de Lyon |  |  |  |  | Back to BOM |  |  | Car # | 81 |  | Part Cost | $2.20
System | Engine & Drivetrain |  | FileLink1 | Drawing |  |  |  |  |  |  |  | Qty | 1
Assembly | Differential |  | FileLink2 |  |  |  |  |  | FileLink1
Part | Left Jacking Bar bracket |  | FileLink3 |  |  |  |  |  | FileLink2 |  |  | Extended Cost | $2.20
P/N Base | EN_0900_008 |  |  |  |  |  |  |  | FileLink3
Suffix | AA
Details
ItemOrder | Material | Use | UnitCost | Size1 | Unit1 | Size2 | Unit2 | Area Name | Area | Length | Density | Quantity | Sub Total
10 | Steel, Mild | Material for the bracket | $2.25 | 0.066 | kg |  |  | Rectangular area 60x47 mm | 0.00282 | 0.003 | 7850 | 1 | $0.15
 |  |  |  |  |  |  |  |  |  |  |  | Sub Total | $0.15
ItemOrder | Process | Use | UnitCost | Unit | Quantity | Multiplier | Mult. Val. | Sub Total
10 | Machining Setup, Install and remove | Setup for machining | $1.30 | Unit | 1 |  |  | $1.30
20 | Laser Cut | Shaping of the brackets and holes | $0.01 | cm | 25.09 | Material, Steel | 3 | $0.75
 |  |  |  |  |  |  | Sub Total | $2.05

Sheet: EN_0900_008 Drawing
EN_0900_008

Sheet: EN_0900_009
University | Ecole Centrale de Lyon |  |  |  |  | Back to BOM |  |  | Car # | 81 |  | Part Cost | $2.21
System | Engine & Drivetrain |  | FileLink1 | Drawing |  |  |  |  |  |  |  | Qty | 1
Assembly | Differential |  | FileLink2 |  |  |  |  |  | FileLink1
Part | Right Jacking Bar bracket |  | FileLink3 |  |  |  |  |  | FileLink2 |  |  | Extended Cost | $2.21
P/N Base | EN_0900_009 |  |  |  |  |  |  |  | FileLink3
Suffix | AA
Details
ItemOrder | Material | Use | UnitCost | Size1 | Unit1 | Size2 | Unit2 | Area Name | Area | Length | Density | Quantity | Sub Total
10 | Steel, Mild | Material for the bracket | $2.25 | 0.068 | kg |  |  | Rectangular area 61x47 mm | 0.002867 | 0.003 | 7850 | 1 | $0.15
 |  |  |  |  |  |  |  |  |  |  |  | Sub Total | $0.15
ItemOrder | Process | Use | UnitCost | Unit | Quantity | Multiplier | Mult. Val. | Sub Total
10 | Machining Setup, Install and remove | Setup for machining | $1.30 | Unit | 1 |  |  | $1.30
20 | Laser Cut | Shaping of the brackets and holes | $0.01 | cm | 25.37 | Material, Steel | 3 | $0.76
 |  |  |  |  |  |  | Sub Total | $2.06

Sheet: EN_0900_009 Drawing
EN_0900_009

Sheet: EN_A1000
University | Ecole Centrale de Lyon |  |  | Back to BOM |  |  |  |  | Car # | 81 |  | Asm Cost | $534.45
System | Engine & Drivetrain |  |  |  |  |  |  |  |  |  |  | Qty | 1
Assembly | Differential Assembly |  |  |  |  |  |  |  | FileLink1
P/N Base | EN_A1000 |  |  |  |  |  |  |  | FileLink2 |  |  | Extended Cost | $534.45
Suffix | AA |  |  |  |  |  |  |  | FileLink3
Details | Driveshaft
ItemOrder | Part | Part Cost | Quantity | Sub Total
10 | Inboard tripod housing | $66.55 | 2 | $133.10
20 | Outboard tripod housing | $72.28 | 2 | $144.55
30 | Left axle | $16.43 | 1 | $16.43
40 | Right axle | $17.34 | 1 | $17.34
 |  |  | Sub Total | $311.42
ItemOrder | Material | Use | UnitCost | Size1 | Unit1 | Size2 | Unit2 | Area Name | Area | Length | Density | Quantity | Sub Total
10 | Constant Velocity Joint, Tripod | Tripods | $45.00 |  | unit |  |  |  |  |  |  | 4 | $180.00
20 | Constant Velocity Joint, Boot | Boots for driveshatfts | $5.00 |  | unit |  |  |  |  |  |  | 4 | $20.00
 |  |  |  |  |  |  |  |  |  |  |  | Sub Total | $200.00
ItemOrder | Process | Use | UnitCost | Unit | Quantity | Multiplier | Mult. Val. | Sub Total
10 | Assemble, 3 kg, Interference | Assemble a tripod housing and the differential | $0.56 | unit | 2 |  | 1 | $1.12
20 | Wrench <= 25,4 mm | Fasten the differential and the tripod housing | $1.50 | unit | 2 |  | 1 | $3.00
30 | Assemble, 1 kg, Interference | Assemble a boot and an axle | $0.19 | unit | 4 |  | 1 | $0.76
40 | Assemble, 1 kg, Interference | Assemble an axle and a snap ring | $0.19 | unit | 4 |  | 1 | $0.76
50 | Assemble, 1 kg, Line-on-Line | Assemble a tripod and an axle | $0.13 | unit | 4 |  | 1 | $0.52
60 | Assemble, 1 kg, Interference | Assemble an axle and a snap ring | $0.19 | unit | 4 |  | 1 | $0.76
70 | Assemble, 3 kg, Loose | Assemble an axle and a tripod housing | $0.19 | unit | 4 |  | 1 | $0.76
80 | Assemble, 1 kg, Interference | Assemble a boot and a tripod housing | $0.19 | unit | 4 |  | 1 | $0.76
90 | Assemble, 3 kg, Interference | Assemble a tripod housing and a hub | $0.56 | unit | 2 |  | 1 | $1.12
100 | Assemble, 3 kg, Interference | Assemble a hose clamp and an axle | $0.56 | unit | 4 |  | 1 | $2.24
110 | Assemble, 3 kg, Interference | Assemble a hose clamp and a tripod housing | $0.56 | unit | 4 |  | 1 | $2.24
120 | Ratchet <= 25,4 mm | Bolt tripod housing to hub | $0.75 | unit | 2 |  | 1 | $1.50
 |  |  |  |  |  |  | Sub Total | $15.54
ItemOrder | Fastener | Use | UnitCost | Size1 | Unit1 | Size2 | Unit2 | Quantity | Sub Total
10 | Retaining Ring, External | Snap ring for retaining the tripods | $0.09 | 20 | mm |  |  | 8 | $0.74
20 | Hose Clamp, Worm Drive | Fasten the boot | $0.79 | 72.466 | mm |  |  | 4 | $3.16
30 | Hose Clamp, Worm Drive | Fasten the boot | $0.61 | 27.788 | mm |  |  | 4 | $2.44
40 | Bolt, Grade 8,8 (SAE 5) | Assemble the tripod housing to the differential | $0.08 | 8 | mm | 20 | mm | 2 | $0.16
50 | Nut, Grade 8.8 (SAE 5) | Fasten the tripod housing and the hub | $0.49 | 20 | mm |  |  | 2 | $0.98
 |  |  |  |  |  |  |  | Sub Total | $7.49

Sheet: EN_1000_001
University | Ecole Centrale de Lyon |  |  |  |  | Back to BOM |  |  | Car # | 81 |  | Part Cost | $66.55
System | Engine & Drivetrain |  | FileLink1 | Drawing |  |  |  |  |  |  |  | Qty | 2
Assembly | Driveshaft |  | FileLink2 |  |  |  |  |  | FileLink1
Part | Inboard tripod housing |  | FileLink3 |  |  |  |  |  | FileLink2 |  |  | Extended Cost | $133.10
P/N Base | EN_1000_001 |  |  |  |  |  |  |  | FileLink3
Suffix | AA
Details | Bought, cost as made
ItemOrder | Material | Use | UnitCost | Size1 | Unit1 | Size2 | Unit2 | Area Name | Area | Length | Density | Quantity | Sub Total
10 | Steel, Alloy | Material for the housing | $2.25 | 4.100 | kg |  |  | Round 65.5 mm diam. | 0.003369554471 | 0.155 | 7850 | 1 | $9.22
 |  |  |  |  |  |  |  |  |  |  |  | Sub Total | $9.22
ItemOrder | Process | Use | UnitCost | Unit | Quantity | Multiplier | Mult. Val. | Sub Total
10 | Machining Setup, Install and remove | Setup and removal of the machining of the tripod housing | $1.30 | Unit | 1 |  |  | $1.30
20 | Machining | Machining the ext shape of the tripod housing (turning) | $0.04 | cm^3 | 269.90 | Material - Steel | 3 | $32.39
30 | Machining Setup, Change | Changing of the machining of the tripod housing | $0.65 | Unit | 1 |  |  | $0.65
40 | Machining | Machining the int shape of the tripod housing (milling) | $0.04 | cm^3 | 175.85 | Material - Steel | 3 | $21.10
50 | Machining Setup, Change | Changing of the broach of the tripod housing | $0.65 | Unit | 1 |  |  | $0.65
60 | Broach, External | Broach of the tripod housing | $0.50 | cm | 2.47 |  |  | $1.24
 |  |  |  |  |  |  | Sub Total | $57.32

Sheet: EN_1000_002
University | Ecole Centrale de Lyon |  |  |  |  | Back to BOM |  |  | Car # | 81 |  | Part Cost | $72.28
System | Engine & Drivetrain |  | FileLink1 | Drawing |  |  |  |  |  |  |  | Qty | 2
Assembly | Driveshaft |  | FileLink2 |  |  |  |  |  | FileLink1
Part | Outboard tripod housing |  | FileLink3 |  |  |  |  |  | FileLink2 |  |  | Extended Cost | $144.55
P/N Base | EN_1000_002 |  |  |  |  |  |  |  | FileLink3
Suffix | AA
Details | Bought, cost as made
ItemOrder | Material | Use | UnitCost | Size1 | Unit1 | Size2 | Unit2 | Area Name | Area | Length | Density | Quantity | Sub Total
10 | Steel, Alloy | Material for the housing | $2.25 | 4.279 | kg |  |  | Round 65.5 mm diam. | 0.003369554471 | 0.162 | 7850 | 1 | $9.63
 |  |  |  |  |  |  |  |  |  |  |  | Sub Total | $9.63
ItemOrder | Process | Use | UnitCost | Unit | Quantity | Multiplier | Mult. Val. | Sub Total
10 | Machining Setup, Install and remove | Setup and removal of the machining of the tripod housing | $1.30 | Unit | 1 |  |  | $1.30
20 | Machining | Machining the ext shape of the tripod housing (turning) | $0.04 | cm^3 | 313.90 | Material - Steel | 3 | $37.67
30 | Machining Setup, Change | Changing of the machining of the tripod housing | $0.65 | Unit | 1 |  |  | $0.65
40 | Machining | Machining the int shape of the tripod housing (milling) | $0.04 | cm^3 | 161.94 | Material - Steel | 3 | $19.43
50 | Machining Setup, Change | Changing of the broach of the tripod housing | $0.65 | Unit | 1 |  |  | $0.65
60 | Broach, External | Broach of the tripod housing | $0.50 | cm | 5.89 |  |  | $2.95
70 | Machining Setup, Change | Setup and removal of the threading of the tripod housing | $0.65 | Unit | 1 |  |  | $0.65
80 | Threading, External (machining) | Threading of the tripod housing | $0.10 | cm | 1.8453 |  |  | $0.18
 |  |  |  |  |  |  | Sub Total | $62.65

Sheet: EN_1000_003
University | Ecole Centrale de Lyon |  |  |  |  | Back to BOM |  |  | Car # | 81 |  | Part Cost | $16.43
System | Engine & Drivetrain |  | FileLink1 | Drawing of the cut |  |  |  |  |  |  |  | Qty | 1
Assembly | Driveshaft |  | FileLink2 |  |  |  |  |  | FileLink1
Part | Left Axle |  | FileLink3 |  |  |  |  |  | FileLink2 |  |  | Extended Cost | $16.43
P/N Base | EN_1000_003 |  |  |  |  |  |  |  | FileLink3
Suffix | AA
Details | Bought, cost as made
ItemOrder | Material | Use | UnitCost | Size1 | Unit1 | Size2 | Unit2 | Area Name | Area | Length | Density | Quantity | Sub Total
10 | Steel, Alloy | Material for driveshaft | $2.25 | 1.147 | kg |  |  | Round 22,1 mm diam. | 0.000383596317 | 0.381 | 7850 | 1 | $2.58
 |  |  |  |  |  |  |  |  |  |  |  | Sub Total | $2.58
ItemOrder | Process | Use | UnitCost | Unit | Quantity | Multiplier | Mult. Val. | Sub Total
10 | Machining Setup, Install and remove | Setup and removal of the machining of the axle | $1.30 | Unit | 1 |  |  | $1.30
20 | Machining | Cut of the edge of the axle | $0.04 | cm^3 | 7.6 | Material-Steel | 3 | $0.91
30 | Machining Setup, Change | Setup and removal of the broach of the axle | $0.65 | Unit | 1 |  |  | $0.65
40 | Machining | Shaping of the int of the axle | $0.04 | cm^3 | 45.8 | Material-Steel | 3 | $5.49
50 | Machining Setup, Change | Setup and removal of the broach of the axle | $0.65 | Unit | 1 |  |  | $0.65
60 | Broach, External | Broach of the axle | $0.50 | cm | 9.6998 |  |  | $4.85
 |  |  |  |  |  |  | Sub Total | $13.85
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
