epsa-team/Vulcanix-v1.0/EN - Engine & Powertrain/Cost/Cost_EN_v2_CME.xlsx

Sheet: BOM
University | Ecole Centrale de Lyon |  |  |  |  |  |  |  |  |  |  | Total Vehicle Cost |  | #REF!
Competition Code | FSAEI
Year | 2018
Car # | 81 |  | The cost of assemlies on this chart should not include the cost of the parts in the assembly but only the materials, processes, fasteners and tooling in the assembly level.
Line Num. | Area of Commodity | Asm/Prt # | Rev. Lvl. | Asm | Component | Description | Unit Cost | Quantity | Material Cost | Process Cost | Fastener Cost | Tooling Cost | Total Cost | Details Page Number
 | Engine & Drivetrain | EN A0100 | AA |  | Engine |  | $1582.99 | 1 | 1500.213344 | 76.37798285 | 5.735020272 | 0.6666666667 | $1582.99
 | Engine & Drivetrain | EN 01001 | AA | Engine | Flat Sump |  | $38.78 | 1 | $10.57 | $26.04 | $0.00 | $2.17 | $38.78
 | Engine & Drivetrain | EN 01002 | AA | Engine | Rear tab |  | $1.42 | 2 | $0.20 | $1.21 | $0.00 | $0.00 | $2.83
 | Engine & Drivetrain | EN 01003 | AA | Engine | Rear tube |  | $1.30 | 2 | $0.14 | $1.15 | $0.00 | $0.00 | $2.59
 | Engine and Drivetrain | EN A0200 | AA |  | Exhaust System |  | $100.73 | 1 | $6.00 | $92.69 | $1.04 | $1.00 | $100.73
 | Engine and Drivetrain | EN 02001 | AA | Exhaust System | Exhaust Tip |  | $4.35 | 4 | $0.64 | $3.71 | $0.00 | $0.00 | $17.41
 | Engine and Drivetrain | EN 02002 | AA | Exhaust System | Exhaust Flange |  | $1.75 | 4 | $0.35 | $1.40 | $0.00 | $0.00 | $7.00
 | Engine and Drivetrain | EN 02003 | AA | Exhaust System | Exhaust headers |  | $109.43 | 1 | $1.65 | $100.12 | $0.00 | $7.67 | $109.43
 | Engine and Drivetrain | EN 02004 | AA | Exhaust System | Primary collector |  | $20.23 | 2 | $0.29 | $18.44 | $0.00 | $1.50 | $40.46
 | Engine and Drivetrain | EN 02005 | AA | Exhaust System | Primary collector tubing |  | $1.22 | 2 | $0.59 | $0.63 | $0.00 | $0.00 | $2.44
 | Engine and Drivetrain | EN 02006 | AA | Exhaust System | Secondary collector |  | $22.47 | 1 | $0.39 | $20.58 | $0.00 | $1.50 | $22.47
 | Engine and Drivetrain | EN 02007 | AA | Exhaust System | Secondary collector tubing |  | $12.90 | 1 | $0.51 | $11.72 | $0.00 | $0.67 | $12.90
 | Engine and Drivetrain | EN 02008 | AA | Exhaust System | Muffler |  | $40.14 | 1 | $24.12 | $16.02 | $0.00 | $0.00 | $40.14
 | Engine and Drivetrain | EN 02009 | AA | Exhaust System | Muffler Collar |  | $6.21 | 1 | $5.56 | $0.62 | $0.00 | $0.04 | $6.21
 | Engine and Drivetrain | EN 02010 | AA | Exhaust System | Spacer |  | $2.23 | 1 | $0.15 | $2.08 | $0.00 | $0.00 | $2.23
 | Engine and Drivetrain | EN A0300 | AA |  | Air Intake System |  | $95.20 | 1 | $26.45 | $62.64 | $5.44 | $0.67 | $95.20
 | Engine and Drivetrain | EN 03001 | AA | Air Intake System | Upper plenum |  | $12.59 | 1 | $1.15 | $11.43 | $0.00 | $0.00 | $12.59
 | Engine and Drivetrain | EN 03002 | AA | Air Intake System | Plenum plate |  | $3.68 | 1 | $0.59 | $3.09 | $0.00 | $0.00 | $3.68
 | Engine and Drivetrain | EN 03003 | AA | Air Intake System | Intake manifold |  | $18.14 | 1 | $1.65 | $16.49 | $0.00 | $0.00 | $18.14
 | Engine and Drivetrain | EN 03004 | AA | Air Intake System | Left frame bracket |  | $1.69 | 1 | $0.04 | $1.65 | $0.00 | $0.00 | $1.69
 | Engine and Drivetrain | EN 03005 | AA | Air Intake System | Right frame bracket |  | $1.76 | 1 | $0.05 | $1.71 | $0.00 | $0.00 | $1.76
 | Engine and Drivetrain | EN 03006 | AA | Air Intake System | PAIR plate |  | $1.32 | 2 | $0.08 | $1.24 | $0.00 | $0.00 | $2.63
 | Engine and Drivetrain | EN 03007 | AA | Air Intake System | Motor bracket |  | $4.18 | 1 | $0.29 | $3.89 | $0.00 | $0.00 | $4.18
 | Engine and Drivetrain | EN 03008 | AA | Air Intake System | Intake bracket |  | $0.73 | 2 | $0.004768875 | $0.73 | $0.00 | $0.00 | $1.46
 | Engine and Drivetrain | EN A0400 | AA |  | Throttle Body |  | $130.01 | 1 | $119.80 | $9.19 | $1.02 | $0.00 | $130.01
 | Engine and Drivetrain | EN 04001 | AA | Throttle Body | Throttle Frange |  | $5.18 | 1 | $0.73 | $4.45 | $0.00 | $0.00 | $5.18
 | Engine and Drivetrain | EN 04002 | AA | Throttle Body | Restrictor |  | $5.73 | 1 | $1.58 | $4.15 | $0.00 | $0.00 | $5.73
 | Engine and Drivetrain | EN 04003 | AA | Throttle Body | Throttle Housing |  | $4.27 | 1 | $0.84 | $3.43 | $0.00 | $0.00 | $4.27
 | Engine and Drivetrain | EN 04004 | AA | Throttle Body | Throttle Axle |  | $2.73 | 1 | $0.06 | $2.67 | $0.00 | $0.00 | $2.73
 | Engine and Drivetrain | EN 04005 | AA | Throttle Body | TPS Axle |  | $2.71 | 1 | $0.04 | $2.67 | $0.00 | $0.00 | $2.71
 | Engine and Drivetrain | EN 04006 | AA | Throttle Body | Cable Housing |  | $3.57 | 1 | $0.17 | $3.40 | $0.00 | $0.00 | $3.57
 | Engine and Drivetrain | EN 04007 | AA | Throttle Body | Axle Stop |  | $2.04 | 1 | $0.26 | $1.78 | $0.00 | $0.00 | $2.04
 | Engine and Drivetrain | EN 04008 | AA | Throttle Body | Ram Pipe |  | $12.51 | 1 | $4.01 | $8.50 | $0.00 | $0.00 | $12.51
 | Engine and Drivetrain | EN 04009 | AA | Throttle Body | Throttle Plate |  | $1.49 | 1 | $0.07 | $1.42 | $0.00 | $0.00 | $1.49
 | Engine and Drivetrain | EN A0500 | AA |  | Fuel Tank Assembly |  | $38.53 | 1 | $24.86 | $10.46 | $1.88 | $1.33 | $38.53
 | Engine and Drivetrain | EN 05001 | AA | Fuel Tank Assembly | Fuel Tank (with filler neck) |  | $103.67 | 1 | $19.85 | $82.15 | $0.00 | $1.67 | $103.67
 | Engine and Drivetrain | EN 05002 | AA | Fuel Tank Assembly | Filler Cap |  | $31.68 | 1 | $24.42 | $7.26 | $0.00 | $0.00 | $31.68
 | Engine and Drivetrain | EN 05003 | AA | Fuel Tank Assembly | Filler Tube |  | $18.36 | 1 | $4.06 | $10.78 | $2.52 | $1.00 | $18.36
 | Engine and Drivetrain | EN 05004 | AA | Fuel Tank Assembly | Lateral tab |  | $1.74 | 2 | $0.03 | $1.71 | $0.00 | $0.00 | $3.48
 | Engine and Drivetrain | EN 05005 | AA | Fuel Tank Assembly | Rear tab |  | $1.88 | 2 | $0.05 | $1.83 | $0.00 | $0.00 | $3.77
 | Engine and Drivetrain | EN A0600 | AA |  | Fuel System |  | $328.33 | 1 | $283.83 | $43.14 | $0.69 | $0.67 | $328.33
 | Engine and Drivetrain | EN 06001 | AA | Fuel System | Fuel Rail |  | $7.64 | 1 | $0.47 | $4.84 | $0.00 | $2.33 | $7.64
 | Engine and Drivetrain | EN 06002 | AA | Fuel System | Fuel Pump Collar |  | $3.35 | 1 | $0.05 | $3.30 | $0.00 | $0.00 | $3.35
 | Engine and Drivetrain | EN 06003 | AA | Fuel System | Pressure Regulator Tab |  | $1.83 | 1 | $0.04 | $1.79 | $0.00 | $0.00 | $1.83
 | Engine and Drivetrain | EN 06004 | AA | Fuel System | Fuel Pump Tab |  | $1.55 | 1 | $0.01 | $1.54 | $0.00 | $0.00 | $1.55
 | Engine and Drivetrain | EN A0700 | AA |  | Overflow Bottles |  | $22.60 | 1 | $11.52 | $9.11 | $1.98 | $0.00 | $22.60
 | Engine and Drivetrain | EN A0800 | AA |  | Cooling System |  | $49.04 | 1 | $20.04 | $19.44 | $8.55 | $1.00 | $49.04
 | Engine and Drivetrain | EN 08001 | AA | Cooling System | Radiator |  | $102.86 | 1 | $17.94 | $84.92 | $0.00 | $0.00 | $102.86
 | Engine and Drivetrain | EN 08002 | AA | Cooling System | Radiator lateral upper tab |  | $1.79 | 1 | $0.05 | $1.74 | $0.00 | $0.00 | $1.79
 | Engine and Drivetrain | EN 08003 | AA | Cooling System | Radiator lateral lower tab |  | $2.53 | 1 | $0.26 | $2.26 | $0.00 | $0.00 | $2.53
 | Engine and Drivetrain | EN 08004 | AA | Cooling System | Radiator Back tab |  | $1.61 | 1 | $0.01 | $1.60 | $0.00 | $0.00 | $1.61
 | Engine and Drivetrain | EN 08005 | AA | Cooling System | Main Coolant Line |  | $38.16 | 1 | $12.26 | $21.10 | $4.80 | $0.00 | $38.16
 | Engine and Drivetrain | EN 08006 | AA | Cooling System | Fan |  | $30.77 | 1 | $30.00 | $0.37 | $0.40 | $0.00 | $30.77
 | Engine and Drivetrain | EN 08007 | AA | Cooling System | Expansion Tank |  | $22.73 | 1 | $3.02 | $17.71 | $0.00 | $2.00 | $22.73
 | Engine and Drivetrain | EN 08008 | AA | Cooling System | Expansion Tank tab |  | $1.54 | 1 | $0.02 | $1.53 | $0.00 | $0.00 | $1.54
 | Engine and Drivetrain | EN 08009 | AA | Cooling System | Lateral Tube |  | $3.15 | 1 | $1.80 | $1.35 | $0.00 | $0.00 | $3.15
 | Engine and Drivetrain | EN 08010 | AA | Cooling System | Secondary Coolant Line |  | $15.48 | 1 | $1.33 | $9.36 | $4.80 | $0.00 | $15.48
 | Engine & Drivetrain | EN A0900 | AA |  | Differential Assembly |  | $203.89 | 1 | $180.47 | $18.49 | $2.27 | $2.67 | $203.89
 | Engine & Drivetrain | EN 09001 | AA | Differential Assembly | Housing |  | $125.94 | 1 | $21.41 | $101.49 | $3.03 | $0.00 | $125.94
 | Engine & Drivetrain | EN 09002 | AA | Differential Assembly | Left Eccentric |  | $10.90 | 1 | $2.59 | $8.31 | $0.00 | $0.00 | $10.90
 | Engine & Drivetrain | EN 09003 | AA | Differential Assembly | Right Eccentric |  | $8.54 | 1 | $2.00 | $6.54 | $0.00 | $0.00 | $8.54
 | Engine & Drivetrain | EN 09004 | AA | Differential Assembly | Left Eccentric carrier |  | $23.96 | 1 | $7.75 | $16.20 | $0.00 | $0.00 | $23.96
 | Engine & Drivetrain | EN 09005 | AA | Differential Assembly | Right Eccentric carrier |  | $17.20 | 1 | $5.62 | $11.58 | $0.00 | $0.00 | $17.20
 | Engine & Drivetrain | EN 09006 | AA | Differential Assembly | Upper Eccentric Carrier bracket |  | $1.00 | 4 | $0.08 | $0.91 | $0.00 | $0.00 | $3.98
 | Engine & Drivetrain | EN 09007 | AA | Differential Assembly | Lower Eccentric Carrier bracket |  | $0.97 | 4 | $0.07 | $0.90 | $0.00 | $0.00 | $3.88
 | Engine & Drivetrain | EN 09008 | AA | Differential Assembly | Left Jacking Bar bracket |  | $2.20 | 1 | $0.15 | $2.05 | $0.00 | $0.00 | $2.20
 | Engine & Drivetrain | EN 09009 | AA | Differential Assembly | Right Jacking Bar bracket |  | $2.21 | 1 | $0.15 | $2.06 | $0.00 | $0.00 | $2.21
 | Engine & Drivetrain | EN A1000 | AA |  | Driveshaft |  | $223.03 | 1 | $200.00 | $15.54 | $7.49 | $0.00 | $223.03
 | Engine & Drivetrain | EN 10001 | AA | Driveshaft | Inboard tripod housing |  | $66.55 | 2 | $9.22 | $57.32 | $0.00 | $0.00 | $133.10
 | Engine & Drivetrain | EN 10002 | AA | Driveshaft | Outboard tripod housing |  | $72.28 | 2 | $9.63 | $62.65 | $0.00 | $0.00 | $144.55
 | Engine & Drivetrain | EN 10003 | AA | Driveshaft | Left Axle |  | $16.43 | 1 | $2.58 | $13.85 | $0.00 | $0.00 | $16.43
 | Engine & Drivetrain | EN 10004 | AA | Driveshaft | Right Axle |  | $17.34 | 1 | $2.93 | $14.41 | $0.00 | $0.00 | $17.34
 | Engine & Drivetrain | EN A1100 | AA |  | Chain Set |  | $25.14 | 1 | $2.18 | $17.71 | $2.58 | $2.67 | $25.14
 | Engine & Drivetrain | EN 11001 | AA | Chain Set | Front sprocket |  | $24.75 | 1 | $1.52 | $23.23 | $0.00 | $0.00 | $24.75
 | Engine & Drivetrain | EN 11002 | AA | Chain Set | Rear sprocket |  | $41.80 | 1 | $3.06 | $38.74 | $0.00 | $0.00 | $41.80
 | Engine & Drivetrain | EN 11003 | AA | Chain Set | Rear sprocket adaptor |  | $29.16 | 1 | $8.72 | $20.44 | $0.00 | $0.00 | $29.16
 | Engine & Drivetrain | EN 11004 | AA | Chain Set | Chain shield |  | $9.10 | 1 | $3.31 | $5.78 | $0.00 | $0.00 | $9.10
 | Engine & Drivetrain | EN 11005 | AA | Chain Set | Upper chainshield bracket |  | $1.71 | 1 | $0.04 | $1.67 | $0.00 | $0.00 | $1.71
 | Engine & Drivetrain | EN 11006 | AA | Chain Set | Lower chainshield bracket |  | $1.71 | 1 | $0.04 | $1.68 | $0.00 | $0.00 | $1.71
 | Engine and Drivetrain |  |  |  | Area Total |  |  |  | $2652.40 | $1465.86 | $54.23 | $32.70 | $4205.19

Sheet: EN A0100
University | Ecole Centrale de Lyon |  | Back to BOM |  |  |  |  |  | Car # | 81 |  | Asm Cost | $1627.20
System | Engine & Drivetrain |  |  |  |  |  |  |  |  |  |  | Qty | 1
Assembly | Engine |  |  |  |  |  |  |  | FileLink1
P/N Base | EN A0100 |  |  |  |  |  |  |  | FileLink2 |  |  | Extended Cost | $1627.20
Suffix | AA |  |  |  |  |  |  |  | FileLink3
Details | Honda CBR 600 RR type PC40
ItemOrder | Part | Part Cost | Quantity | Sub Total
10 | Flat sump | $38.78 | 1 | $38.78
20 | Rear tab | $1.42 | 2 | $2.83
30 | Rear tube | $1.30 | 2 | $2.59
 |  |  | Sub Total | $44.21
ItemOrder | Material | Use | UnitCost | Size1 | Unit1 | Size2 | Unit2 | Area Name | Area | Length | Density | Quantity | Sub Total
10 | Engine and Transmission, Ultra High Performance (>10 HP/100 cc) | Honda CBR 600 RR - type PC40 | $2.50 | 599 | cc |  |  |  |  |  |  | 1 | 1497.50
20 | Fluid, oil | Engine Oil | $0.75 | 3.5 | L |  |  |  |  |  |  | 3.5 | $2.62
30 | Paint | Paint of the rear tabs | $10.00 | 0.003 | m^2 |  |  |  |  |  |  | 0.003 | $0.03
40 | Rubber | Sealing between oil sump and engine | $3.30 | 0.019 | kg |  |  |  | 0.017 | 0.001 | 1100 | 1 | $0.06
 |  |  |  |  |  |  |  |  |  |  |  | Sub Total | $1500.21
ItemOrder | Process | Use | UnitCost | Unit | Quantity | Multiplier | Mult. Val. | Sub Total
10 | Weld | Weld rear tabs to the frame | $0.15 | cm | 5.96 |  | 1 | $0.89
20 | Aerosol apply | Paint of the rear tabs | $5.25 | m^2 | 0.003 |  | 1 | $0.01
 | Cut (scissors, knife) | Sump seal rubber | $0.06 | cm | 166 |  | 1 | $9.96
30 | Assemble, >20 kg, Interference | Assemble engine in frame | $5.63 | Unit | 1 |  | 1 | $5.63
40 | Assemble, 1kg, Line-on-Line | Positioning of the rear tube | $0.13 | Unit | 1 |  | 1 | $0.13
50 | Ratchet <= 25,4mm | Tighten M12 rear bolts | $0.75 | Unit | 2 |  | 1 | $1.50
60 | Ratchet <= 25,4mm | Tighten M12 front bolts | $0.75 | Unit | 2 |  | 1 | $1.50
70 | Reaction tool, <=25,4mm | Tighten M12 front bolts | $0.25 | Unit | 2 |  | 1 | $0.50
80 | Assemble, 1 kg, Line-on-Line | Assemble Flat sump + rubber sealing | $0.12 | unit | 2 |  | 1 | $0.25
90 | Ratchet <= 6.35 mm | Tighten flat sump blots | $0.50 | unit | 12 |  | 1 | $6.00
100 | Engine first start, includes fuel |  | $50.00 | unit | 1 |  | 1 | $50.00
 |  |  |  |  |  |  | Sub Total | $76.38
ItemOrder | Fastener | Use | UnitCost | Size1 | Unit1 | Size2 | Unit2 | Quantity | Sub Total
10 | Bolt, Grade 8.8 (SAE 5) | Bolt engine to the rear tab | $1.05 | 12 | mm | 80 | mm | 2 | $2.10
20 | Washer, Grade 8.8 (SAE 5) | Bolt engine to the rear tab | $0.01 |  | unit |  |  | 2 | $0.02
20 | Bolt, Grade 8.8 (SAE 5) | Bolt engine to the front tubes | $1.40 | 12 | mm | 100 | mm | 2 | $2.80
30 | Nut, Grade 8.8 (SAE 5) | Bolt engine to the front tubes | $0.10 | 12 | mm |  |  | 2 | $0.20
40 | Washer, Grade 8.8 (SAE 5) | Bolt engine to the frame | $0.01 |  | unit |  |  | 6 | $0.06
50 | Bolt, Grade 8.8 (SAE 5) | Bolt the flat sump | $0.04 | 6 | mm | 15 | mm | 12 | $0.44
40 | Washer, Grade 8.8 (SAE 5) | Washer for the flat sump | $0.01 |  | unit |  |  | 12 | $0.12
 |  |  |  |  |  |  |  | Sub Total | $5.74
ItemOrder | Tooling | Use | UnitCost | Unit | Quantity | PVF | FractionIncluded | Sub Total
10 | Welds - Welding Fixture | Rear tabs welding | $500.00 | point | 4 | 3000 | 1 | $0.67
 |  |  |  |  |  |  | Sub Total | $0.67

Sheet: EN 01001
University | Ecole Centrale de Lyon |  |  |  | Back to BOM |  |  |  | Car # | 81 |  | Part Cost | $38.78
System | Engine & Drivetrain |  | FileLink1 |  |  |  |  |  |  |  |  | Qty | 1
Assembly | Engine |  | FileLink2 |  |  |  |  |  | FileLink1
Part | Flat Sump |  | FileLink3 |  |  |  |  |  | FileLink2 |  |  | Extended Cost | $38.78
P/N Base | EN 01001 |  |  |  |  |  |  |  | FileLink3
Suffix | AA
Details | Flat Sump, custom made
ItemOrder | Material | Use | UnitCost | Size1 | Unit1 | Size2 | Unit2 | Area Name | Area | Length | Density | Quantity | Sub Total
10 | Aluminum, Normal | Folded base - 5754 | $4.20 | 233 | mm | 276 | mm | Rectangular area, 233x276 mm | 0.064308 | 0.0025 | 2712 | 1 | $1.83
20 | Aluminum, Normal | Upper plate - 5754 | $4.20 | 250 | mm | 200 | mm | Rectangular area, 250x200 mm | 0.05 | 0.015 | 2712 | 1 | $8.54
30 | Aluminum, Normal | Transversal wall - 5754 | $4.20 | 168 | mm | 42 | mm | Rectangular area, 168x42 mm | 0.007056 | 0.0025 | 2712 | 1 | $0.20
40 | Aluminum, Normal | Upper rectangular plate - 5754 | $4.20 | 50 | mm | 30 | mm | Rectangular area, 60x30 mm | 0.0015 | 0.0025 | 2712 | 1 | $0.04
50 | Fitting, Weld-in, Male, Aluminum | For Dash6 connection | $1.85 | 8 | mm |  |  |  |  |  |  | 1 | $1.85
 |  |  |  |  |  |  |  |  |  |  |  | Sub Total | $10.57
ItemOrder | Process | Use | UnitCost | Unit | Quantity | Multiplier | Mult. Val. | Sub Total
10 | Machining Setup, installation and remove | Laser cut, upper plate | $1.30 | Unit | 1 |  |  | $1.30
20 | Laser cut | Upper plate | $0.01 | cm | 166 |  |  | $1.66
30 | Machining Setup, installation and remove | Laser cut folded base-wall | $1.30 | Unit | 1 |  |  | $1.30
40 | Laser cut | Laser cut folded base-wall | $0.01 | cm | 155 |  |  | $1.55
50 | Machining Setup, installation and remove | Laser cut transversal wall | $1.30 | Unit | 1 |  |  | $1.30
60 | Laser cut | Laser cut transversal wall | $0.01 | cm | 42 |  |  | $0.42
70 | Machining Setup, installation and remove | Laser cut upper rectangular plate | $1.30 | Unit | 1 |  |  | $1.30
80 | Laser cut | Laser cut upper rectangular plate | $0.01 | cm | 16 |  |  | $0.16
90 | Sheet metal bends | Fold base | $0.25 | Unit | 4 |  |  | $1.00
100 | Machining Setup, installation and remove | Install upper rectangular plate in drill | $1.30 | Unit | 1 |  |  | $1.30
110 | Drilled holes < 25.4 mm dia. | Drain valve hole - upper rectangular plate | $0.35 | Unit | 1 |  |  | $0.35
120 | Weld | Weld the 4 plates together + Dash 6 connection | $0.15 | cm | 96 |  |  | $14.40
 |  |  |  |  |  |  | Sub Total | $26.04
ItemOrder | Tooling | Use | UnitCost | Unit | Quantity | PVF | FracIncld | Sub Total
10 | Welds- Welding Fixture | Mounts Welding | $500.00 | point | 13 | 3000 | 1 | $2.17
 |  |  |  |  |  |  | Sub Total | $2.17

Sheet: EN 01002
University | Ecole Centrale de Lyon |  |  |  | Back to BOM |  |  |  | Car # | 81 |  | Part Cost | $1.42
System | Engine & Drivetrain |  | FileLink1 | Drawing |  |  |  |  |  |  |  | Qty | 2
Assembly | Engine |  | FileLink2 |  |  |  |  |  | FileLink1
Part | Rear tab |  | FileLink3 |  |  |  |  |  | FileLink2 |  |  | Extended Cost | $2.83
P/N Base | EN 01002 |  |  |  |  |  |  |  | FileLink3
Suffix | AA
Details | To attach the engine to the frame
ItemOrder | Material | Use | UnitCost | Size1 | Unit1 | Size2 | Unit2 | Area Name | Area | Length | Density | Quantity | Sub Total
10 | Steel, Mild |  | $2.25 | 0.090 | kg |  |  | Rectangular area, 60x32 mm | 0.00192 | 0.006 | 7850 | 1 | $0.20
 |  |  |  |  |  |  |  |  |  |  |  | Sub Total | $0.20
ItemOrder | Process | Use | UnitCost | Unit | Quantity | Multiplier | Mult. Val. | Sub Total
10 | Machining Setup, installation and remove | Setup for laser cut | $1.30 | Unit | 1 | 2 parts made from a single machine setup | 0.5 | $0.65
20 | Laser cut |  | $0.01 | cm | 18.8 | Material - Steel | 3 | $0.56
 |  |  |  |  |  |  | Sub Total | $1.21

Sheet: dEN 01002
Drawing Part : | EN 01002

Sheet: EN 01003
University | Ecole Centrale de Lyon |  |  |  | Back to BOM |  |  |  | Car # | 81 |  | Part Cost | $1.30
System | Engine & Drivetrain |  | FileLink1 | Drawing |  |  |  |  |  |  |  | Qty | 2
Assembly | Engine |  | FileLink2 |  |  |  |  |  | FileLink1
Part | Rear tube |  | FileLink3 |  |  |  |  |  | FileLink2 |  |  | Extended Cost | $2.59
P/N Base | EN 01003 |  |  |  |  |  |  |  | FileLink3
Suffix | AA
Details | To attach the engine to the frame
ItemOrder | Material | Use | UnitCost | Size1 | Unit1 | Size2 | Unit2 | Area Name | Area | Length | Density | Quantity | Sub Total
10 | Steel, Alloy |  | $2.25 | 0.063 | kg |  |  | Round area, 20mm diam. | 0.0002010619298 | 0.040 | 7850 | 1 | $0.14
 |  |  |  |  |  |  |  |  |  |  |  | Sub Total | $0.14
ItemOrder | Process | Use | UnitCost | Unit | Quantity | Multiplier | Mult. Val. | Sub Total
10 | Machining Setup, installation and remove |  | $1.30 | Unit | 1 | 2 parts made from a single machine setup | 0.5 | $0.65
20 | Machining | To 13mm diam. | $0.04 | cm^3 | 4.2 | Material - Steel | 3 | $0.50
 |  |  |  |  |  |  | Sub Total | $1.15

Sheet: dEN 01003
Drawing Part : | EN 01003

Sheet: EN A0200
University | Ecole Centrale de Lyon |  |  | Back to BOM |  |  |  |  | Car # | 81 |  | Asm Cost | $361.43
System | Engine and Drivetrain |  |  |  |  |  |  |  |  |  |  | Qty | 1
Assembly | Exhaust System |  |  |  |  |  |  |  | FileLink1
P/N Base | EN A0200 |  |  |  |  |  |  |  | FileLink2 |  |  | Extended Cost | $361.43
Suffix | AA |  |  |  |  |  |  |  | FileLink3
Details
ItemOrder | Part | Part Cost | Quantity | Sub Total
10 | Exhaust Tip | $4.35 | 4 | $17.41
20 | Exhaust Flange | $1.75 | 4 | $7.00
30 | Exhaust headers | $109.43 | 1 | $109.43
40 | Primary collector | $20.23 | 2 | $40.46
50 | Primary collector tubing | $1.22 | 2 | $2.44
60 | Secondary collector | $22.47 | 1 | $22.47
70 | Secondary collector tubing | $12.90 | 1 | $12.90
80 | Muffler | $40.14 | 1 | $40.14
90 | Muffler Collar | $6.21 | 1 | $6.21
100 | Spacer | $2.23 | 1 | $2.23
 |  |  | Sub Total | $260.70
ItemOrder | Material | Use | UnitCost | Size1 | Unit1 | Size2 | Unit2 | Area Name | Area | Length | Density | Quantity | Sub Total
10 | Spring, Compression (General) |  | $1.00 |  |  |  |  |  |  |  |  | 6 | $6.00
 |  |  |  |  |  |  |  |  |  |  |  | Sub Total | $6.00
ItemOrder | Process | Use | UnitCost | Unit | Quantity | Multiplier | Mult. Val. | Sub Total
10 | Assemble, 1 kg, Loose | Assemble flanges to primary collector | $0.06 | unit | 4 |  |  | $0.24
20 | Weld | Tips welding on headers | $0.15 | cm | 42.7 |  |  | $6.41
30 | Assemble, 1kg, Interference | Assemble headers to engine | $0.19 | unit | 1 |  |  | $0.19
40 | Ratchet <=25,4mm | Tighten header's nut | $0.75 | unit | 8 |  |  | $6.00
50 | Tube end preperation for welding | Preperation for primary collector welding | $0.75 | end | 4 |  |  | $3.00
60 | Weld - Round Tubing | Primary collector tubing welding on primary collector | $0.50 | cm | 8.4 |  |  | $4.21
70 | Assemble,1kg, Interference | Assemble primary collector to headers | $0.19 | unit | 2 |  |  | $0.38
80 | Tube end preperation for welding | Preperation for secondary collector welding | $0.75 | end | 2 |  |  | $1.50
90 | Weld - Round Tubing | Secondary collector tubing welding on collector | $0.50 | cm | 5.0 |  |  | $2.49
100 | Assemble, 1kg, Interference | Assemble secondary collector to primary tubing | $0.19 | unit | 1 |  |  | $0.19
110 | Assemble, 3kg, Line-on-Line | Assemble muffler to tubing | $0.38 | unit | 1 |  |  | $0.38
120 | Assemble, 1 kg, Loose | Assemble muffler mount | $0.06 | unit | 1 |  |  | $0.06
130 | Reaction Tool <= 6.35 mm | Tighten muffler mount nut | $0.25 | unit | 1 |  |  | $0.25
140 | Assemble, 1 kg, Line-on-Line | Assemble muffler collar, washers and spacer | $0.13 | unit | 3 |  |  | $0.39
160 | Ratchet <= 25.4 mm | Tighten muffler collar bolt | $0.75 | unit | 1 |  |  | $0.75
170 | Exhaust System Ceramic Coating |  | $25.00 | m | 2.65 |  |  | $66.25
 |  |  |  |  |  |  | Sub Total | $92.69
ItemOrder | Fastener | Use | UnitCost | Size1 | Unit1 | Size2 | Unit2 | Quantity | Sub Total
10 | Nut, Grade 8.8 (SAE 5) | Headers nuts | $0.04 | 8 | mm |  |  | 8 | $0.32
20 | Washer, Grade 8.8 (SAE 5) | Engine washers | $0.01 | 40 | mm |  |  | 4 | $0.04
30 | Steel Loop Straps, Rubber-Cushioned | Muffler mount on the frame tube | $0.31 | 30 | mm |  |  | 1 | $0.31
40 | Washer, Grade 8.8 (SAE 5) | Muffler collar washers | $0.01 | 8 | mm |  |  | 2 | $0.02
50 | Bolt, Grade 8.8 (SAE 5) | Muffler collar bolt | $0.32 | 8 | mm | 70 | mm | 1 | $0.32
60 | Nut, Grade 8.8 (SAE 5) | Muffler mount nut | $0.01 | 2 | mm |  |  | 1 | $0.01
70 | Bolt, Grade 8.8 (SAE 5) | Muffler mount bolt | $0.01 | 2 | mm | 30 | mm | 1 | $0.01
 |  |  |  |  |  |  |  | Sub Total | $1.04
ItemOrder | Tooling | Use | UnitCost | Unit | Quantity | PVF | FractionIncluded | Sub Total
10 | Welds - Welding Fixture |  | $500.00 | point | 6 | 3000 | 1 | $1.00
 |  |  |  |  |  |  | Sub Total | $1.00

Sheet: EN_02001
University | Ecole Centrale de Lyon |  |  |  |  | Back to BOM |  |  | Car # | 81 |  | Part Cost | $4.35
System | Engine and Drivetrain |  | FileLink1 | Drawing |  |  |  |  |  |  |  | Qty | 4
Assembly | Exhaust System |  | FileLink2 |  |  |  |  |  | FileLink1
Part | Exhaust Tip |  | FileLink3 |  |  |  |  |  | FileLink2 |  |  | Extended Cost | $17.41
P/N Base | EN 02001 |  |  |  |  |  |  |  | FileLink3
Suffix | AA
Details
ItemOrder | Material | Use | UnitCost | Size1 | Unit1 | Size2 | Unit2 | Area Name | Area | Length | Density | Quantity | Sub Total
10 | Steel, Mild (per kg) | Raw material | $2.25 | 0.285 | kg |  |  | Round 43mm diam. | 0.001452201204 | 0.025 | 7850 | 1 | $0.64
 |  |  |  |  |  |  |  |  |  |  |  | Sub Total | $0.64
ItemOrder | Process | Use | UnitCost | Unit | Quantity | Multiplier | Mult. Val. | Sub Total
10 | Machining Setup, Install and remove |  | $1.30 | unit | 0.25 | 4 parts made from a single machining setup |  | $0.33
20 | Machining | Inner machining | $0.04 | cm^3 | 20.5 | Material - Steel | 3 | $2.46
30 | Machining Setup, Change |  | $0.65 | unit | 0.25 | 4 parts made from a single machining change |  | $0.16
40 | Machining | Outside machining | $0.04 | cm^3 | 6.38 | Material - Steel | 3 | $0.77
 |  |  |  |  |  |  | Sub Total | $3.71

Sheet: dEN_02001
Drawing part : | EN 02001

Sheet: EN_02002
University | Ecole Centrale de Lyon |  |  |  |  | Back to BOM |  |  | Car # | 81 |  | Part Cost | $1.75
System | Engine and Drivetrain |  | FileLink1 | Drawing |  |  |  |  |  |  |  | Qty | 4
Assembly | Exhaust System |  | FileLink2 |  |  |  |  |  | FileLink1
Part | Exhaust Flange |  | FileLink3 |  |  |  |  |  | FileLink2 |  |  | Extended Cost | $7.00
P/N Base | EN 02002 |  |  |  |  |  |  |  | FileLink3
Suffix | AA
Details
ItemOrder | Material | Use | UnitCost | Size1 | Unit1 | Size2 | Unit2 | Area Name | Area | Length | Density | Quantity | Sub Total
10 | Steel, Mild (per kg) | Raw material | $2.25 | 0.157 | kg |  |  | Rectangular area 80 x 50mm | 0.004 | 0.005 | 7850 | 1 | $0.35
 |  |  |  |  |  |  |  |  |  |  |  | Sub Total | $0.35
ItemOrder | Process | Use | UnitCost | Unit | Quantity | Multiplier | Mult. Val. | Sub Total
10 | Machining Setup, Install and remove |  | $1.30 | unit | 0.25 | 4 parts made from a single machining setup |  | $0.33
20 | Laser Cut | Flange cut | $0.01 | cm | 35.8 | Material - Steel | 3 | $1.07
 |  |  |  |  |  |  | Sub Total | $1.40

Sheet: dEN_02002
Drawing part : | EN 02002

Sheet: EN_02003
University | Ecole Centrale de Lyon |  |  |  |  | Back to BOM |  |  | Car # | 81 |  | Part Cost | $109.43
System | Engine and Drivetrain |  | FileLink1 |  |  |  |  |  |  |  |  | Qty | 1
Assembly | Exhaust System |  | FileLink2 |  |  |  |  |  | FileLink1
Part | Exhaust headers |  | FileLink3 |  |  |  |  |  | FileLink2 |  |  | Extended Cost | $109.43
P/N Base | EN 02003 |  |  |  |  |  |  |  | FileLink3
Suffix | AA
Details | 4 headers in one part
ItemOrder | Material | Use | UnitCost | Size1 | Unit1 | Size2 | Unit2 | Area Name | Area | Length | Density | Quantity | Sub Total
10 | Steel, Stainless | Header material | $2.25 |  | kg |  |  | Round 34mm*1,2mm | 6.521946349e-05 | 1.430 | 7850 | 1 | $1.65
 |  |  |  |  |  |  |  |  |  |  |  | Sub Total | $1.65
ItemOrder | Process | Use | UnitCost | Unit | Quantity | Multiplier | Mult. Val. | Sub Total
10 | Tube cut |  | $0.15 | cm | 91.8 |  |  | $13.77
20 | Tube bends |  | $0.75 | bend | 17 |  |  | $12.75
30 | Tube end preperation for welding |  | $0.75 | end | 46 |  |  | $34.50
40 | Weld - Round Tubing |  | $0.50 | cm | 78.2 |  |  | $39.10
 |  |  |  |  |  |  | Sub Total | $100.12
ItemOrder | Tooling | Use | UnitCost | Unit | Quantity | PVF | FracIncld | Sub Total
10 | Welds - Welding Fixture |  | $500 | point | 46 | 3000 | 1 | $7.67
 |  |  |  |  |  |  | Sub Total | $7.67

Sheet: EN_02004
University | Ecole Centrale de Lyon |  |  |  |  | Back to BOM |  |  | Car # | 81 |  | Part Cost | $20.23
System | Engine and Drivetrain |  | FileLink1 |  |  |  |  |  |  |  |  | Qty | 2
Assembly | Exhaust System |  | FileLink2 |  |  |  |  |  | FileLink1
Part | Primary collector |  | FileLink3 |  |  |  |  |  | FileLink2 |  |  | Extended Cost | $40.46
P/N Base | EN 02004 |  |  |  |  |  |  |  | FileLink3
Suffix | AA
Details | 1 connector for each pair of headers
ItemOrder | Material | Use | UnitCost | Size1 | Unit1 | Size2 | Unit2 | Area Name | Area | Length | Density | Quantity | Sub Total
10 | Steel, Stainless | Collector material | $2.25 |  | kg |  |  | Round 34mm*1,2mm | 6.521946349e-05 | 0.205 | 7850 | 1 | $0.24
20 | Steel, Stainless | Collector material | $2.25 |  | kg |  |  | Round 42,1mm*1,5mm | 0.0001009629339 | 0.030 | 7850 | 1 | $0.05
 |  |  |  |  |  |  |  |  |  |  |  | Sub Total | $0.29
ItemOrder | Process | Use | UnitCost | Unit | Quantity | Multiplier | Mult. Val. | Sub Total
10 | Tube cut |  | $0.15 | cm | 24.6 |  |  | $3.69
20 | Tube end preperation for welding |  | $0.75 | end | 9 |  |  | $6.75
30 | Weld - Round Tubing |  | $0.50 | cm | 15.99746521 |  |  | $8.00
 |  |  |  |  |  |  | Sub Total | $18.44
ItemOrder | Tooling | Use | UnitCost | Unit | Quantity | PVF | FracIncld | Sub Total
10 | Welds - Welding Fixture |  | $500.00 | point | 9 | 3000 | 1 | $1.50
 |  |  |  |  |  |  | Sub Total | $1.50

Sheet: EN_02005
University | Ecole Centrale de Lyon |  |  |  |  | Back to BOM |  |  | Car # | 81 |  | Part Cost | $1.22
System | Engine and Drivetrain |  | FileLink1 |  |  |  |  |  |  |  |  | Qty | 2
Assembly | Exhaust System |  | FileLink2 |  |  |  |  |  | FileLink1
Part | Primary collector tubing |  | FileLink3 |  |  |  |  |  | FileLink2 |  |  | Extended Cost | $2.44
P/N Base | EN 02005 |  |  |  |  |  |  |  | FileLink3
Suffix | AA
Details | 2 primary collectors in 1 part
ItemOrder | Material | Use | UnitCost | Size1 | Unit1 | Size2 | Unit2 | Area Name | Area | Length | Density | Quantity | Sub Total
10 | Steel, Stainless | Tubing material | $2.25 |  | kg |  |  | Round 42,1mm*1,5mm | 0.0001009629339 | 0.33 | 7850 | 1 | $0.59
 |  |  |  |  |  |  |  |  |  |  |  | Sub Total | $0.59
ItemOrder | Process | Use | UnitCost | Unit | Quantity | Multiplier | Mult. Val. | Sub Total
10 | Tube cut |  | $0.15 | cm | 4.2 |  |  | $0.63
 |  |  |  |  |  |  | Sub Total | $0.63

Sheet: EN_02006
University | Ecole Centrale de Lyon |  |  |  |  | Back to BOM |  |  | Car # | 81 |  | Part Cost | $22.47
System | Engine and Drivetrain |  | FileLink1 |  |  |  |  |  |  |  |  | Qty | 1
Assembly | Exhaust System |  | FileLink2 |  |  |  |  |  | FileLink1
Part | Secondary collector |  | FileLink3 |  |  |  |  |  | FileLink2 |  |  | Extended Cost | $22.47
P/N Base | EN 02006 |  |  |  |  |  |  |  | FileLink3
Suffix | AA
Details
ItemOrder | Material | Use | UnitCost | Size1 | Unit1 | Size2 | Unit2 | Area Name | Area | Length | Density | Quantity | Sub Total
10 | Steel, Stainless | Collector material | $2.25 |  | kg |  |  | Round 42,1mm*1,5mm | 0.0001009629339 | 0.207 | 7850 | 1 | $0.37
20 | Steel, Stainless | Collector material | $2.25 |  | kg |  |  | Round 49,8mm*1,2mm | 9.500176184e-05 | 0.010 | 7850 | 1 | $0.02
 |  |  |  |  |  |  |  |  |  |  |  | Sub Total | $0.39
ItemOrder | Process | Use | UnitCost | Unit | Quantity | Multiplier | Mult. Val. | Sub Total
10 | Tube cut |  | $0.15 | cm | 30.24 |  |  | $4.54
20 | Tube end preperation for welding |  | $0.75 | end | 9 |  |  | $6.75
30 | Weld - Round Tubing |  | $0.50 | cm | 18.58845114 |  |  | $9.29
 |  |  |  |  |  |  | Sub Total | $20.58
ItemOrder | Tooling | Use | UnitCost | Unit | Quantity | PVF | FracIncld | Sub Total
10 | Welds - Welding Fixture |  | $500.00 | point | 9 | 3000 | 1 | $1.50
 |  |  |  |  |  |  | Sub Total | $1.50

Sheet: EN_02007
University | Ecole Centrale de Lyon |  |  |  |  | Back to BOM |  |  | Car # | 81 |  | Part Cost | $12.90
System | Engine and Drivetrain |  | FileLink1 |  |  |  |  |  |  |  |  | Qty | 1
Assembly | Exhaust System |  | FileLink2 |  |  |  |  |  | FileLink1
Part | Secondary collector tubing |  | FileLink3 |  |  |  |  |  | FileLink2 |  |  | Extended Cost | $12.90
P/N Base | EN 02007 |  |  |  |  |  |  |  | FileLink3
Suffix | AA
Details
ItemOrder | Material | Use | UnitCost | Size1 | Unit1 | Size2 | Unit2 | Area Name | Area | Length | Density | Quantity | Sub Total
10 | Steel, Stainless | Tubing material | $2.25 |  | kg |  |  | Round 49,8mm*1,2mm | 9.500176184e-05 | 0.306 | 7850 | 1 | $0.51
 |  |  |  |  |  |  |  |  |  |  |  | Sub Total | $0.51
ItemOrder | Process | Use | UnitCost | Unit | Quantity | Multiplier | Mult. Val. | Sub Total
10 | Tube cut |  | $0.15 | cut | 14.94 |  |  | $2.24
20 | Tube bends |  | $0.75 | bend | 2 |  |  | $1.50
30 | Tube end preperation for welding |  | $0.75 | end | 4 |  |  | $3.00
40 | Weld - Round Tubing |  | $0.50 | cm | 9.96 |  |  | $4.98
 |  |  |  |  |  |  | Sub Total | $11.72
ItemOrder | Tooling | Use | UnitCost | Unit | Quantity | PVF | FracIncld | Sub Total
10 | Welds - Welding Fixture |  | $500.00 | point | 4 | 3000 | 1 | $0.67
 |  |  |  |  |  |  | Sub Total | $0.67

Sheet: EN_02008
University | Ecole Centrale de Lyon |  |  |  |  | Back to BOM |  |  | Car # | 81 |  | Part Cost | $40.14
System | Engine and Drivetrain |  | FileLink1 |  |  |  |  |  |  |  |  | Qty | 1
Assembly | Exhaust System |  | FileLink2 |  |  |  |  |  | FileLink1
Part | Muffler |  | FileLink3 |  |  |  |  |  | FileLink2 |  |  | Extended Cost | $40.14
P/N Base | EN 02008 |  |  |  |  |  |  |  | FileLink3
Suffix | AA
Details | Cost as made
ItemOrder | Material | Use | UnitCost | Size1 | Unit1 | Size2 | Unit2 | Area Name | Area | Length | Density | Quantity | Sub Total
10 | Titanium (per kg) | Material for muffler body | $22.00 | 0.500 | kg |  |  | Rectangular area 0.5 x 0.4m | 0.200 |  | 4500 | 1 | $11.00
20 | Steel, Mild (per kg) |  | $2.25 | 0.500 | kg |  |  | Rectangular area 0.5 x 0.15m | 0.075 |  | 7850 | 1 | $1.12
30 | Muffler Batting |  | $0.003 | 4000 | cm^3 |  |  |  |  |  |  | 1 | $12.00
 |  |  |  |  |  |  |  |  |  |  |  | Sub Total | $24.12
ItemOrder | Process | Use | UnitCost | Unit | Quantity | Multiplier | Mult. Val. | Sub Total
10 | Sheet metal bends |  | $0.25 | bend | 2 |  |  | $0.50
20 | Sheet metal punching |  | $0.03 | cm^2 | 300 |  |  | $9.00
30 | Sheet metal stamping |  | $0.03 | cm^2 | 100 |  |  | $3.00
40 | Assemble, 1 kg, Line-on-Line |  | $0.13 | unit | 4 |  |  | $0.52
50 | Riveting |  | $0.25 | unit | 12 |  |  | $3.00
 |  |  |  |  |  |  | Sub Total | $16.02

Sheet: EN_02009
University | Ecole Centrale de Lyon |  |  |  |  | Back to BOM |  |  | Car # | 81 |  | Part Cost | $6.21
System | Engine and Drivetrain |  | FileLink1 |  |  |  |  |  |  |  |  | Qty | 1
Assembly | Exhaust System |  | FileLink2 |  |  |  |  |  | FileLink1
Part | Muffler Collar |  | FileLink3 |  |  |  |  |  | FileLink2 |  |  | Extended Cost | $6.21
P/N Base | EN 02009 |  |  |  |  |  |  |  | FileLink3
Suffix | AA
Details
ItemOrder | Material | Use | UnitCost | Size1 | Unit1 | Size2 | Unit2 | Area Name | Area | Length | Density | Quantity | Sub Total
10 | Carbon Fiber, 1 Ply | Collar material | $200.00 | 0.028 | kg |  |  |  |  |  | 1580 | 1 | $5.56
 |  |  |  |  |  |  |  |  |  |  |  | Sub Total | $5.56
ItemOrder | Process | Use | UnitCost | Unit | Quantity | Multiplier | Mult. Val. | Sub Total
10 | Lamination, Manual |  | $35.00 | m^2 | 0.0112 |  |  | $0.39
20 | Cure, Oven |  | $20.00 | m^2 | 0.0112 |  |  | $0.22
 |  |  |  |  |  |  | Sub Total | $0.62
ItemOrder | Tooling | Use | UnitCost | Unit | Quantity | PVF | FracIncld | Sub Total
10 | Lamination - Composite Tool |  | $10000 | m^2 | 0.0112 | 3000 | 1 | $0.04
 |  |  |  |  |  |  | Sub Total | $0.04

Sheet: EN_02010
University | Ecole Centrale de Lyon |  |  |  |  | Back to BOM |  |  | Car # | 81 |  | Part Cost | $2.23
System | Engine and Drivetrain |  | FileLink1 |  |  |  |  |  |  |  |  | Qty | 1
Assembly | Exhaust System |  | FileLink2 |  |  |  |  |  | FileLink1
Part | Spacer |  | FileLink3 |  |  |  |  |  | FileLink2 |  |  | Extended Cost | $2.23
P/N Base | EN 02010 |  |  |  |  |  |  |  | FileLink3
Suffix | AA
Details | Spacer between the muffler collar and the mount
ItemOrder | Material | Use | UnitCost | Size1 | Unit1 | Size2 | Unit2 | Area Name | Area | Length | Density | Quantity | Sub Total
10 | Steel, Mild | Spacer material | $2.25 | 0.066 | kg |  |  | Round 16mm diameter | 0.0002010619298 | 0.042 | 7850 | 1 | $0.15
 |  |  |  |  |  |  |  |  |  |  |  | Sub Total | $0.15
ItemOrder | Process | Use | UnitCost | Unit | Quantity | Multiplier | Mult. Val. | Sub Total
10 | Machining Setup, Install and remove |  | $1.30 | unit | 1 |  |  | $1.30
20 | Machining |  | $0.04 | cm^3 | 6.47 | Material - Steel | 3 | $0.78
 |  |  |  |  |  |  | Sub Total | $2.08

Sheet: EN_A0300
University | Ecole Centrale de Lyon |  |  | Back to BOM |  |  |  |  | Car # | 81 |  | Asm Cost | $141.32
System | Engine and Drivetrain |  |  |  |  |  |  |  |  |  |  | Qty | 1
Assembly | Air Intake System |  |  |  |  |  |  |  | FileLink1
P/N Base | EN A0300 |  |  |  |  |  |  |  | FileLink2 |  |  | Extended Cost | $141.32
Suffix | AA |  |  |  |  |  |  |  | FileLink3
Details | Air Intake Assembly
ItemOrder | Part | Part Cost | Quantity | Sub Total
10 | Upper plenum | $12.59 | 1 | $12.59
20 | Plenum plate | $3.68 | 1 | $3.68
30 | Intake manifold | $18.14 | 1 | $18.14
40 | Left frame bracket | $1.69 | 1 | $1.69
50 | Right frame bracket | $1.76 | 1 | $1.76
60 | PAIR plate | $1.32 | 2 | $2.63
70 | Motor bracket | $4.18 | 1 | $4.18
80 | Intake bracket | $0.73 | 2 | $1.46
 |  |  | Sub Total | $46.13
ItemOrder | Material | Use | UnitCost | Size1 | Unit1 | Size2 | Unit2 | Area Name | Area | Length | Density | Quantity | Sub Total
10 | Mount, Vibration-Damping, Sandwich | Isolation between throttle and chassis | $8.10 | 30 | mm |  |  |  |  |  |  | 2.00 | $16.20
20 | Sensor, Fluid Pressure & Temperature | Measure pressure and temperature inside of the plenum | $10.00 |  |  |  |  |  |  |  |  | 1.00 | $10.00
30 | Paint | Material for painting | $10.00 | 0.015 | m^2 |  |  |  |  |  |  | 1.00 | $0.15
30 | Seal, O-ring, Elastomer | Sealing between upper plenum and plenum plate | $0.05 |  |  |  |  |  |  |  |  | 1.00 | $0.05
40 | Seal, O-ring, Elastomer | Sealing between intake manifold and plenum plate | $0.05 |  |  |  |  |  |  |  |  | 1.00 | $0.05
 |  |  |  |  |  |  |  |  |  |  |  | Sub Total | $26.45
ItemOrder | Process | Use | UnitCost | Unit | Quantity | Multiplier | Mult. Val. | Sub Total
10 | Weld | Welding the intake brackets on the frame | $0.15 | cm | 7.1 |  |  | $1.06
20 | Aerosol apply | Paint the intake and frame brackets | $5.25 | m^2 | 0.015 |  |  | $0.08
30 | Assemble, 1 kg, Loose | Positionning the manifold seal on the manifold | $0.06 | unit | 1 |  |  | $0.06
40 | Assemble, 1 kg, Loose | Positionning the plenum plate on the manifold seal | $0.06 | unit | 1 |  |  | $0.06
50 | Wrench <= 6,35 mm | Fixing the plenum plate to the intake manifold | $1.00 | unit | 12 |  |  | $12.00
60 | Reaction Tool <= 6,35 mm | Fixing the plenum plate to the intake manifold | $0.25 | unit | 12 |  |  | $3.00
70 | Assemble, 1 kg, Loose | Inserting the pressure and temperature sensor | $0.01 | unit | 1 |  |  | $0.01
80 | Assemble, 1 kg, Loose | Positionning the plenum seal on the plenum plate | $0.01 | unit | 1 |  |  | $0.01
90 | Assemble, 1 kg, Loose | Positionning the plenum on the plenum seal | $0.01 | unit | 1 |  |  | $0.01
100 | Wrench <= 6,35 mm | Fixing the plenum to the plenum plate | $1.50 | unit | 12 |  |  | $18.00
110 | Reaction Tool <= 6,35 mm | Fixing the plenum to the plenum plate | $0.25 | unit | 12 |  |  | $3.00
120 | Assemble, 1 kg, Loose | Positionning the left and right frame bracket | $0.06 | unit | 2 |  |  | $0.12
130 | Wrench <= 25,4 mm | Fixing the left and right frame bracket on the plenum | $1.50 | unit | 2 |  |  | $3.00
140 | Reaction Tool <= 25,4 mm | Fixing the left and right frame bracket on the plenum | $0.25 | unit | 2 |  |  | $0.50
150 | Assemble, 1 kg, Loose | Positionning the motor bracket on the plenum plate | $0.06 | unit | 1 |  |  | $0.06
160 | Wrench <= 25,4 mm | Fixing the motor bracket to the plenum plate | $1.50 | unit | 2 |  |  | $3.00
170 | Reaction Tool <= 25,4 mm | Fixing the motor bracket to the plenum plate | $0.25 | unit | 2 |  |  | $0.50
180 | Assemble, 1 kg, Loose | Positionning the PAIR plates on the motor | $0.06 | unit | 2 |  |  | $0.12
190 | Assemble, 3 kg, Loose | Positionning the intake assembly on the motor | $0.19 | unit | 1 |  |  | $0.19
200 | Drilled holes < 25,4 mm dia. | Drilling holes inside the PAIR plates | $0.35 | unit | 2 |  |  | $0.70
210 | Assemble, 1 kg, Line-onLine | Positionning the PAIR plates on the motor bracket | $0.13 | unit | 2 |  |  | $0.26
220 | Wrench <= 25,4 mm | Fixing the PAIR plates to the motor bracket | $1.50 | unit | 2 |  |  | $3.00
230 | Reaction Tool <= 25,4 mm | Fixing the PAIR plates to the motor bracket | $0.25 | unit | 2 |  |  | $0.50
240 | Assemble, 3 kg, Loose | Positionning the intake assembly on the motor | $0.19 | unit | 1 |  |  | $0.19
250 | Wrench <= 25,4 mm | Fixing the PAIR plates to the motor | $1.50 | unit | 4 |  |  | $6.00
260 | Screwdriver > 1 Turn | Tightening the hose clamps on the intake manifold and the motor | $0.50 | unit | 4 |  |  | $2.00
270 | Assemble, 1 kg, Line-onLine | Positionning the frame brackets on the frame | $0.13 | unit | 2 |  |  | $0.26
280 | Sheet metal bends | Bending the frame brackets to align with the intake brackets | $0.25 | bend | 2 |  |  | $0.50
290 | Drilled holes < 25,4 mm dia. | Drilling holes inside the frame brackets | $0.35 | unit | 2 |  |  | $0.70
300 | Assemble, 1 kg, Line-onLine | Positionning Mount, Vibration-Damping, Sandwich | $0.13 | unit | 2 |  |  | $0.26
310 | Wrench <= 25,4 mm | Fixing the frame brackets on the frame | $1.50 | unit | 2 |  |  | $3.00
320 | Reaction Tool <= 25,4 mm | Fixing the frame brackets on the frame | $0.25 | unit | 2 |  |  | $0.50
 |  |  |  |  |  |  | Sub Total | $62.64
ItemOrder | Fastener | Use | UnitCost | Size1 | Unit1 | Size2 | Unit2 | Quantity | Sub Total
10 | Hose Clamp, Worm Drive | Tightening the intake pipes with the intake manifold | $0.69 | 48.5 | mm |  |  | 4 | $2.78
20 | Bolt, Grade 8.8 (SAE 5) | Fastening brackets and sensor | $0.05 | 6 | mm | 20 | mm | 9 | $0.43
30 | Bolt, Grade 8.8 (SAE 5) | Fastening plenum, plenum plate and intake manifold | $0.02 | 4 | mm | 16 | mm | 23 | $0.45
40 | Washer, Grade 8,8 (SAE 5) | Fastening brackets and sensor | $0.01 | 6 | mm |  |  | 9 | $0.09
50 | Washer, Grade 8,8 (SAE 5) | Fastening plenum, plenum plate and intake manifold | $0.01 | 4 | mm |  |  | 23 | $0.23
60 | Nut, Grade 8.8 (SAE 5) | Fastening brackets and sensor | $0.03 | 6 | mm |  |  | 18 | $0.54
70 | Nut, Grade 8.8 (SAE 5) | Fastening plenum, plenum plate and intake manifold | $0.02 | 4 | mm |  |  | 46 | $0.92
 |  |  |  |  |  |  |  | Sub Total | $5.44
ItemOrder | Tooling | Use | UnitCost | Unit | Quantity | PVF | FractionIncluded | Sub Total
10 | Welds - Welding Fixture | Intake brackets welding | $500.00 | point | 4 | 3000 | 1 | $0.67
 |  |  |  |  |  |  | Sub Total | $0.67

Sheet: EN_03001
University | Ecole Centrale de Lyon |  |  |  |  | Back to BOM |  |  | Car # | 81 |  | Part Cost | $12.59
System | Engine and Drivetrain |  | FileLink1 |  |  |  |  |  |  |  |  | Qty | 1
Assembly | Air Intake System |  | FileLink2 |  |  |  |  |  | FileLink1
Part | Upper plenum |  | FileLink3 |  |  |  |  |  | FileLink2 |  |  | Extended Cost | $12.59
P/N Base | EN 03001 |  |  |  |  |  |  |  | FileLink3
Suffix | AA
Details | Made by 3D printing
ItemOrder | Material | Use | UnitCost | Size1 | Unit1 | Size2 | Unit2 | Area Name | Area | Length | Density | Quantity | Sub Total
10 | Plastic, Nylon | Material for part | $3.30 | 0.35 | kg |  |  |  |  |  | 1140 | 1 | $1.15
 |  |  |  |  |  |  |  |  |  |  |  | Sub Total | $1.15
ItemOrder | Process | Use | UnitCost | Unit | Quantity | Multiplier | Mult. Val. | Sub Total
10 | Rapid Prototype - Plastic | Printing the upper plenum | $32.00 | kg | 0.345 |  |  | $11.04
20 | Aerosol Apply | Applying varnish inside the upper plenum | $5.25 | m^2 | 0.075 |  |  | $0.39
 |  |  |  |  |  |  | Sub Total | $11.43

Sheet: EN_03002
University | Ecole Centrale de Lyon |  |  |  |  | Back to BOM |  |  | Car # | 81 |  | Part Cost | $3.68
System | Engine and Drivetrain |  | FileLink1 | Drawing |  |  |  |  |  |  |  | Qty | 1
Assembly | Air Intake System |  | FileLink2 |  |  |  |  |  | FileLink1
Part | Plenum plate |  | FileLink3 |  |  |  |  |  | FileLink2 |  |  | Extended Cost | $3.68
P/N Base | EN 03002 |  |  |  |  |  |  |  | FileLink3
Suffix | AA
Details | Made by laser cutting
ItemOrder | Material | Use | UnitCost | Size1 | Unit1 | Size2 | Unit2 | Area Name | Area | Length | Density | Quantity | Sub Total
10 | Aluminium, Normal | Material for part | $4.20 | 0.140 | kg |  |  | Rectangular area 200x215 mm | 0.043 | 0.002 | 2712 | 1 | $0.59
 |  |  |  |  |  |  |  |  |  |  |  | Sub Total | $0.59
ItemOrder | Process | Use | UnitCost | Unit | Quantity | Multiplier | Mult. Val. | Sub Total
10 | Machinnig Setup, Install and remove | Setup for laser cutting | $1.30 | unit | 1 |  |  | $1.30
20 | Laser Cut | Producing the plenum plate | $0.01 | cm | 179.2 |  |  | $1.79
 |  |  |  |  |  |  | Sub Total | $3.09

Sheet: dEN_03002
Drawing part : | EN 03002
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
