epsa-team/Vulcanix-v1.0/EN - Engine & Powertrain/Cost/EN_A0300.xlsx

Sheet: Instructions
Petite marche à suivre pour remplir cette merveille qu'est le cost
Etape 1 | Créer l'assemblage
Feuille EN Assembly : Feuille pour 1 assemblage du système EN. Pour un nouvel assemblage, créer un nouveau document à partir du template. 1 document Excel = 1 assemblage
Donner un nom clair à l'assemblage (et en anglais ^^) dans la ligne Assembly
Lui donner un code suivant la règle XX AYYYY dans la ligne P/N Base , avec XX le code de votre partie et YYYY le numéro de l'assemblage (c'est le même code que celui que vous avez dû utiliser sous CATIA)
Renommer l'onglet avec ce même code. Enregistrer le document Excel sous ce même nom.
Donner une brève description (en anglais) de l'assemblage dans la ligne Details
Renommer la zone où le code P/N Base est entré. Pour cela selectionner la cellule par un simple clic, cliquer ensuite dans le menu déroulant en haut à gauche indiquant le nom de la cellule (à côté de la barre de formule)
Renomme cette cellule du nom du code qu'elle comprend mais avec un _ comme séparateur : ex EN_A0001
Cette étape est importante pour créer des hyperliens ensuite
Renommer les cases quantité (cellule N3), et sous-totaux par respectivement code_de_l'assemblage_x avec x = q pour quantité, pa pour part, m pour material, f pour fastener, t pour tooling et p pour process
ex EN_A0001_q, …
Vérifier que la formule dans Asm Cost (cellule N2) renvoie aux noms corrects des cellules prcédentes. Sinon, faire les modifications nécessaires.
Etape 2 | Remplir les données de l'assemblage
Remplir la quantité, Material, Process, Fastener, Tooling. Dans le cas où une table n'est pas concernée (elle est restée vide), la supprimer complètement.
Consulter le tutoriel disponible sur GitHub, dans Vulcanix-v1.0/Cost Report, pour plus d'informations sur cette étape.
Etape 3 | Créer les parts
Feuille EN Part x : Feuille pour 1 part de l'assemblage. Pour faire une nouvelle part, créer un nouvel onglet à partir du template. 1 onglet = 1 part.
Dans la ligne Assembly, indiquer le nom de l'assemblage parent en mettant = puis en sélectionnant le bonne cellule de la page assemblies
Lui donner un nom en clair (et en anglais ^^) dans la ligne Part
Lui donner un code suivant la règle XX YYZZZ dans la ligne P/N Base , avec XX le code de votre partie et YY le numéro de l'assemblage et ZZZ le numéro de la part dans cet assemblage (même code que sous CATIA)
Renommer l'onglet avec ce même code.
Donner une brève description (en anglais) de la Part dans la ligne Details
Renommer la zone où le code P/N Base est entré. Pour cela selectionner la cellule par un simple clic, cliquer ensuite dans le menu déroulant en haut à gauche indiquant le nom de la cellule (à côté de la barre de formule)
Renommer cette cellule du nom du code qu'elle comprend mais avec un _ comme séparateur : ex EN_01001
Créer un lien vers l'assemblage : sélectionner la cellule, faites Ctrl+K, il apparait une fenetre, en référence de la cellule (A1 par défaut) indiquez le nom de la cellule renommé de l'assemblage (par ex EN_A0001)
Renommer les cases quantité (cellule N3), et sous-totaux de chaque part respectivement code_de_la_part_x avec x = q pour quantité, m pour material, f pour fastener, t pour tooling et p pour process
ex : EN_01001_q, …
Vérifier que la formule dans Part Cost (cellule N2) renvoie aux noms corrects des cellules prcédentes. Sinon, faire les modifications nécessaires.
Etape 4 | Remplir les données
Remplir la quantité (nombre d'occurrence de la pièce dans un seul assemblage).
Remplir les tables Material, Fastener, Process et Tooling. Dans le cas où une table n'est pas concernée (elle est restée vide), la supprimer complètement.
Ajouter une illustration de la part (photo propre sur fond blanc si possible, vue CATIA sinon) dans la plus basse définition possible svp, on est limité en taille de fichier
Etape 5 | Ajouter les plans
Faites une capture d'écran du plan de la part en question et coller l'image dans l'onglet "EN Drawing 1"
Au-dessus du plan écrire "Drawing part :" et dans la cellule d'à côté mettre le code de la Part en question
Ajouter un lien pour pouvoir revenir vers le détail de la Part sur cette cellule
Renommer la cellule avec le nouveau lien d_code_de_la_part, ex dEN_01001
Renommer l'onglet avec ce même code
Dans le détail de la part (onglet "EN Part x") écrire à côté de cellule File Link "Drawing" et mettre un lien vers la cellule surplombant le plan ayant le code d_code_de_la_part (ex dEN_01001)
Insérer un lien vers la Part sur le plan par clic droit sur l'image. Cible du lien vers la Part (ex EN_01001)
On peut faire 2 colonnes de plan pour des tailles différentes. La référence reste les plans en paysage.
Etape 6 | Inserer les Parts dans l'assemblage
Remplir dans l'assemblage les cellules nom / part cost et quantity pour chaque parts (toujours en dynamique, ne faites pas de copier coller svp)
Insérer un lien vers la part sur le nom de celle-ci. Pour cela :
sélectionner la cellule, faites Ctrl+K, apparait une fenetre, en référence de la cellule (A1 par défaut) indiquez le nom de la cellule renommé de la Part (par ex EN_01001)
Etape 7 | Remplir la BOM
Il s'agit de faire la nomenclature de votre partie dans l'onglet BOM
De manière générale la colonne description ne sera pas remplie
Commencez par l'assemblage (de couleur plus foncée)
Cellule ASM/PRT# mettre le code de l'assemblage
Laisser la cellule ASM vide
Mettre le nom de l'assemblage dans Component, avec un lien vers l'assemblage en question
Remplir les cellules Quantity, Material, Process, Fastener et Tooling cost. Pour ça :
il suffit de mettre = Code de la pièce _ x avec q pour quantité, m pour material, p pour process, f pour fastener, t pour tooling (vous aviez renommé les cellules avant)
Viennent ensuite les Parts. Pour chaque Part :
Code dans ASM/PRT# aligné à droite, nom de l'assemblage parent dans ASM, Nom de la part dans Component
Mettre un lien vers la part en question sur le nom de cette dernière
Remplir les cellules Quantity, Material, Process, Fastener et Tooling cost. Pour ça :
il suffit de mettre = Code de la pièce _ x avec q pour quantité, m pour material, p pour process, f pour fastener, t pour tooling (vous aviez renommé les cellules avant)
Pour la quantité des parts : mettre la quantité absolue sur la voiture !!! Du coup c'est quantité de l'assemblage * quantité de cette part dans l'assemblage
Pour toute question, contacter Raphaël Mounet ou Clément Marie par Messenger de préférence, par mail sinon.

Sheet: BOM
University | Ecole Centrale de Lyon |  |  |  |  |  |  |  |  |  |  | Total Vehicle Cost |  | #REF!
Competition Code | FSAEI
Year | 2018
Car # | 81 |  | The cost of assemlies on this chart should not include the cost of the parts in the assembly but only the materials, processes, fasteners and tooling in the assembly level.
Line Num. | Area of Commodity | Asm/Prt # | Rev. Lvl. | Asm | Component | Description | Unit Cost | Quantity | Material Cost | Process Cost | Fastener Cost | Tooling Cost | Total Cost | Details Page Number
 | Engine and Drivetrain | EN_A0300 | AA |  | Air Intake System |  | $84.19 | 1 | $16.30 | $62.56 | $4.67 | $0.67 | $84.19
 | Engine and Drivetrain | EN_0300_001 | AA | Air Intake System | Upper plenum |  | $12.57 | 1 | $1.14 | $11.43 | $0.00 | $0.00 | $12.57
 | Engine and Drivetrain | EN_0300_002 | AA | Air Intake System | Plenum plate |  | $3.68 | 1 | $0.59 | $3.09 | $0.00 | $0.00 | $3.68
 | Engine and Drivetrain | EN_0300_003 | AA | Air Intake System | Intake manifold |  | $18.12 | 1 | $1.63 | $16.49 | $0.00 | $0.00 | $18.12
 | Engine and Drivetrain | EN_0300_009 | AA | Air Intake System | Left frame bracket |  | $1.69 | 1 | $0.04 | $1.65 | $0.00 | $0.00 | $1.69
 | Engine and Drivetrain | EN_0300_010 | AA | Air Intake System | Right frame bracket |  | $1.76 | 1 | $0.05 | $1.71 | $0.00 | $0.00 | $1.76
 | Engine and Drivetrain | EN_0300_011 | AA | Air Intake System | PAIR plate |  | $1.97 | 2 | $0.08 | $1.89 | $0.00 | $0.00 | $3.93
 | Engine and Drivetrain | EN_0300_012 | AA | Air Intake System | Motor bracket |  | $4.18 | 1 | $0.29 | $3.89 | $0.00 | $0.00 | $4.18
 | Engine and Drivetrain | EN_0300_013 | AA | Air Intake System | Intake bracket |  | $1.38 | 2 | $0.01 | $1.38 | $0.00 | $0.00 | $2.77
 | Engine and Drivetrain |  |  |  | Area Total |  |  |  | $20.20 | $107.35 | $4.67 | $0.67 | $132.89

Sheet: EN_A0300
University | Ecole Centrale de Lyon |  |  | Back to BOM |  |  |  |  | Car # | 81 |  | Asm Cost | $132.89
System | Engine and Drivetrain |  |  |  |  |  |  |  |  |  |  | Qty | 1
Assembly | Air Intake System |  |  |  |  |  |  |  | FileLink1
P/N Base | EN_A0300 |  |  |  |  |  |  |  | FileLink2 |  |  | Extended Cost | $132.89
Suffix | AA |  |  |  |  |  |  |  | FileLink3
Details | Air Intake Assembly
ItemOrder | Part | Part Cost | Quantity | Sub Total
10 | Upper plenum | $12.57 | 1 | $12.57
20 | Plenum plate | $3.68 | 1 | $3.68
30 | Intake manifold | $18.12 | 1 | $18.12
40 | Left frame bracket | $1.69 | 1 | $1.69
50 | Right frame bracket | $1.76 | 1 | $1.76
60 | PAIR plate | $1.97 | 2 | $3.93
70 | Motor bracket | $4.18 | 1 | $4.18
80 | Intake bracket | $1.38 | 2 | $2.77
 |  |  | Sub Total | $48.70
ItemOrder | Material | Use | UnitCost | Size1 | Unit1 | Size2 | Unit2 | Area Name | Area | Length | Density | Quantity | Sub Total
10 | Mount, Vibration-Damping, Sandwich | Isolation between throttle and chassis | $8.10 | 30 | mm |  |  |  |  |  |  | 2.00 | $16.20
20 | Seal, O-ring, Elastomer | Sealing between upper plenum and plenum plate | $0.05 |  |  |  |  |  |  |  |  | 1.00 | $0.05
30 | Seal, O-ring, Elastomer | Sealing between intake manifold and plenum plate | $0.05 |  |  |  |  |  |  |  |  | 1.00 | $0.05
 |  |  |  |  |  |  |  |  |  |  |  | Sub Total | $16.30
ItemOrder | Process | Use | UnitCost | Unit | Quantity | Multiplier | Mult. Val. | Sub Total
10 | Weld | Welding the intake brackets on the frame | $0.15 | cm | 7.1 |  |  | $1.06
20 | Asemble, 1 kg, Loose | Positionning the manifold seal on the manifold | $0.06 | unit | 1 |  |  | $0.06
30 | Asemble, 1 kg, Loose | Positionning the plenum plate on the manifold seal | $0.06 | unit | 1 |  |  | $0.06
40 | Wrench <= 6,35 mm | Fixing the plenum plate to the intake manifold | $1.00 | unit | 12 |  |  | $12.00
50 | Reaction Tool <= 6,35 mm | Fixing the plenum plate to the intake manifold | $0.25 | unit | 12 |  |  | $3.00
60 | Asemble, 1 kg, Loose | Positionning the plenum seal on the plenum plate | $0.01 | unit | 1 |  |  | $0.01
70 | Asemble, 1 kg, Loose | Positionning the plenum on the plenum seal | $0.01 | unit | 1 |  |  | $0.01
80 | Wrench <= 6,35 mm | Fixing the plenum to the plenum plate | $1.50 | unit | 12 |  |  | $18.00
90 | Reaction Tool <= 6,35 mm | Fixing the plenum to the plenum plate | $0.25 | unit | 12 |  |  | $3.00
100 | Asemble, 1 kg, Loose | Positionning the left and right frame bracket | $0.06 | unit | 2 |  |  | $0.12
110 | Wrench <= 25,4 mm | Fixing the left and right frame bracket on the plenum | $1.50 | unit | 2 |  |  | $3.00
120 | Reaction Tool <= 25,4 mm | Fixing the left and right frame bracket on the plenum | $0.25 | unit | 2 |  |  | $0.50
130 | Asemble, 1 kg, Loose | Positionning the motor bracket on the plenum plate | $0.06 | unit | 1 |  |  | $0.06
140 | Wrench <= 25,4 mm | Fixing the motor bracket to the plenum plate | $1.50 | unit | 2 |  |  | $3.00
150 | Reaction Tool <= 25,4 mm | Fixing the motor bracket to the plenum plate | $0.25 | unit | 2 |  |  | $0.50
160 | Asemble, 1 kg, Loose | Positionning the PAIR plates on the motor | $0.06 | unit | 2 |  |  | $0.12
170 | Asemble, 3 kg, Loose | Positionning the intake assembly on the motor | $0.19 | unit | 1 |  |  | $0.19
180 | Drilled holes < 25,4 mm dia. | Drilling holes inside the PAIR plates | $0.35 | unit | 2 |  |  | $0.70
190 | Asemble, 1 kg, Line-onLine | Positionning the PAIR plates on the motor bracket | $0.13 | unit | 2 |  |  | $0.26
200 | Wrench <= 25,4 mm | Fixing the PAIR plates to the motor bracket | $1.50 | unit | 2 |  |  | $3.00
210 | Reaction Tool <= 25,4 mm | Fixing the PAIR plates to the motor bracket | $0.25 | unit | 2 |  |  | $0.50
220 | Asemble, 3 kg, Loose | Positionning the intake assembly on the motor | $0.19 | unit | 1 |  |  | $0.19
230 | Wrench <= 25,4 mm | Fixing the PAIR plates to the motor | $1.50 | unit | 4 |  |  | $6.00
240 | Screwdriver > 1 Turn | Tightening the hose clamps on the intake manifold and the motor | $0.50 | unit | 4 |  |  | $2.00
250 | Asemble, 1 kg, Line-onLine | Positionning the frame brackets on the frame | $0.13 | unit | 2 |  |  | $0.26
260 | Sheet metal bends | Bending the frame brackets to align with the intake brackets | $0.25 | bend | 2 |  |  | $0.50
270 | Drilled holes < 25,4 mm dia. | Drilling holes inside the frame brackets | $0.35 | unit | 2 |  |  | $0.70
280 | Asemble, 1 kg, Line-onLine | Positionning Mount, Vibration-Damping, Sandwich | $0.13 | unit | 2 |  |  | $0.26
290 | Wrench <= 25,4 mm | Fixing the frame brackets on the frame | $1.50 | unit | 2 |  |  | $3.00
300 | Reaction Tool <= 25,4 mm | Fixing the frame brackets on the frame | $0.25 | unit | 2 |  |  | $0.50
 |  |  |  |  |  |  | Sub Total | $62.56
ItemOrder | Fastener | Use | UnitCost | Size1 | Unit1 | Size2 | Unit2 | Quantity | Sub Total
10 | Hose Clamp, Worm Drive | Tightening the intake pipes with the intake manifold | $0.69 | 48.5 | mm |  |  | 4 | $2.78
20 | Bolt, Grade 8.8 (SAE 5) | Fastening brackets | $0.05 | 6 | mm | 20 | mm | 8 | $0.39
30 | Bolt, Grade 8.8 (SAE 5) | Fastening plenum, plenum plate and intake manifold | $0.02 | 4 | mm | 16 | mm | 24 | $0.47
40 | Washer, Grade 8,8 (SAE 5) | Fastening brackets | $0.01 | 6 | mm |  |  | 8 | $0.08
50 | Washer, Grade 8,8 (SAE 5) | Fastening plenum, plenum plate and intake manifold | $0.01 | 4 | mm |  |  | 24 | $0.24
60 | Nut, Grade 8.8 (SAE 5) | Fastening brackets | $0.03 | 6 | mm |  |  | 8 | $0.24
70 | Nut, Grade 8.8 (SAE 5) | Fastening plenum, plenum plate and intake manifold | $0.02 | 4 | mm |  |  | 24 | $0.48
 |  |  |  |  |  |  |  | Sub Total | $4.67
ItemOrder | Tooling | Use | UnitCost | Unit | Quantity | PVF | FractionIncluded | Sub Total
10 | Welds - Welding Fixture | Intake brackets welding | $500.00 | point | 4 | 3000 | 1 | $0.67
 |  |  |  |  |  |  | Sub Total | $0.67

Sheet: EN_0300_001
University | Ecole Centrale de Lyon |  |  |  |  | Back to BOM |  |  | Car # | 81 |  | Part Cost | $12.57
System | Engine and Drivetrain |  | FileLink1 | Drawing |  |  |  |  |  |  |  | Qty | 1
Assembly | Air Intake System |  | FileLink2 |  |  |  |  |  | FileLink1
Part | Upper plenum |  | FileLink3 |  |  |  |  |  | FileLink2 |  |  | Extended Cost | $12.57
P/N Base | EN_0300_001 |  |  |  |  |  |  |  | FileLink3
Suffix | CD
Details | Made by 3D printing
ItemOrder | Material | Use | UnitCost | Size1 | Unit1 | Size2 | Unit2 | Area Name | Area | Length | Density | Quantity | Sub Total
10 | Plasti, Nylon | Material for part | $3.30 |  | kg |  |  |  |  |  | 1140 | 0.34 | $1.14
 |  |  |  |  |  |  |  |  |  |  |  | Sub Total | $1.14
ItemOrder | Process | Use | UnitCost | Unit | Quantity | Multiplier | Mult. Val. | Sub Total
10 | Rapid Prototype - Plastic | Printing the upper plenum | $32.00 | kg | 0.345 |  |  | $11.04
 | Aerosol Aplly | Applying varnish inside the upper plenum | $5.25 | m^2 | 0.075 |  |  | $0.39
 |  |  |  |  |  |  | Sub Total | $11.43

Sheet: EN_0300_002
University | Ecole Centrale de Lyon |  |  |  |  | Back to BOM |  |  | Car # | 81 |  | Part Cost | $3.68
System | Engine and Drivetrain |  | FileLink1 | Drawing |  |  |  |  |  |  |  | Qty | 1
Assembly | Air Intake System |  | FileLink2 |  |  |  |  |  | FileLink1
Part | Plenum plate |  | FileLink3 |  |  |  |  |  | FileLink2 |  |  | Extended Cost | $3.68
P/N Base | EN_0300_002 |  |  |  |  |  |  |  | FileLink3
Suffix | BA
Details | Made by laser cutting
ItemOrder | Material | Use | UnitCost | Size1 | Unit1 | Size2 | Unit2 | Area Name | Area | Length | Density | Quantity | Sub Total
10 | Aluminium, Normal | Material for part | $4.20 | 0.14 | kg |  |  | Rectangular area 200x215 mm | 0.043 | 0.002 | 2712 | 1.00 | $0.59
 |  |  |  |  |  |  |  |  |  |  |  | Sub Total | $0.59
ItemOrder | Process | Use | UnitCost | Unit | Quantity | Multiplier | Mult. Val. | Sub Total
10 | Machinnig Setup, Install and remove | Setup for laser cutting | $1.30 | unit | 1 |  |  | $1.30
20 | Laser Cut | Producing the plenum plate | $0.01 | cm | 179.1 |  |  | $1.79
 |  |  |  |  |  |  | Sub Total | $3.09
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
