epsa-team/Vulcanix-v1.0/EN - Engine & Powertrain/EN_A0400 (Fuel Tank)/mise en plan/FuelTankMain.igs

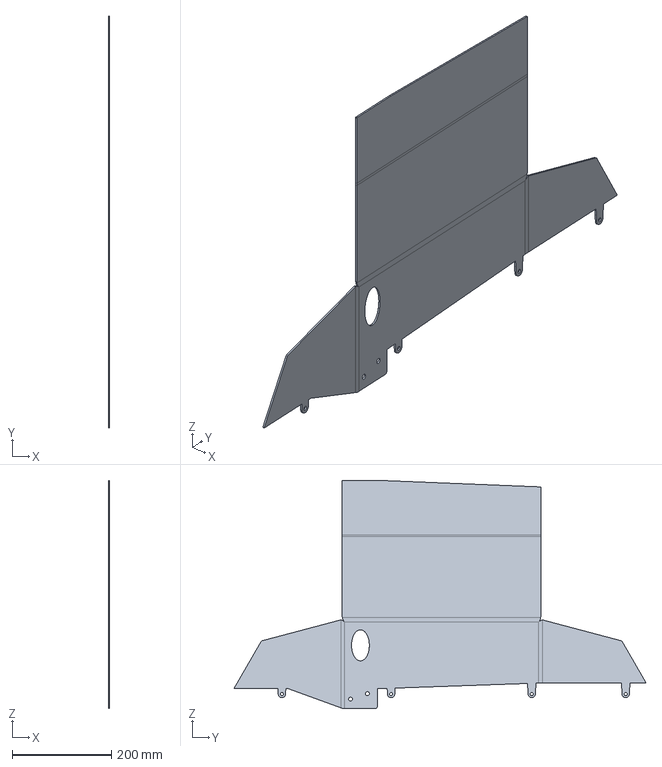
[picture p224: CAD file, 2018-03-07]
EN - Engine & Powertrain/EN_A0400 (Fuel Tank)/mise en plan/FuelTankMain.igs
2.50 x 832.1 x 460.6 mm
