epsa-team/Vulcanix-v1.0/FR - Frame & Body/FR_A0100 (Frame)/Prod/Tubes step/nouveau nom/201 (Main Hoop).stp

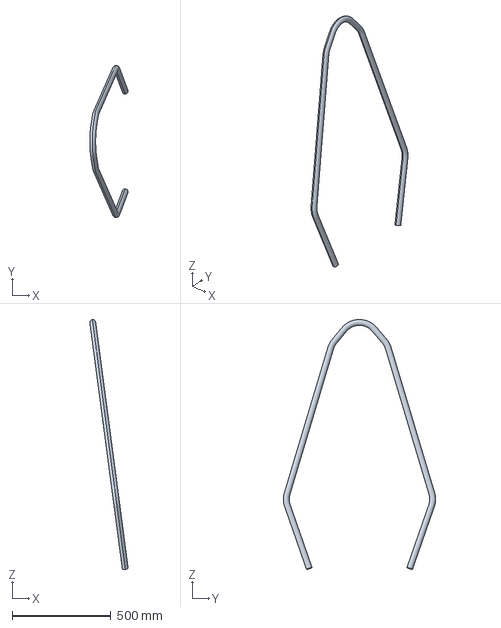
[picture p225: CAD file, 2018-01-11]
FR - Frame & Body/FR_A0100 (Frame)/Prod/Tubes step/nouveau nom/201 (Main Hoop).stp
193.9 x 769.9 x 1263.9 mm
