epsa-team/Vulcanix-v1.0/ZZ - Autres/Chapes/3mm/IGS/Bracket 105- Differential assy tube inf.igs

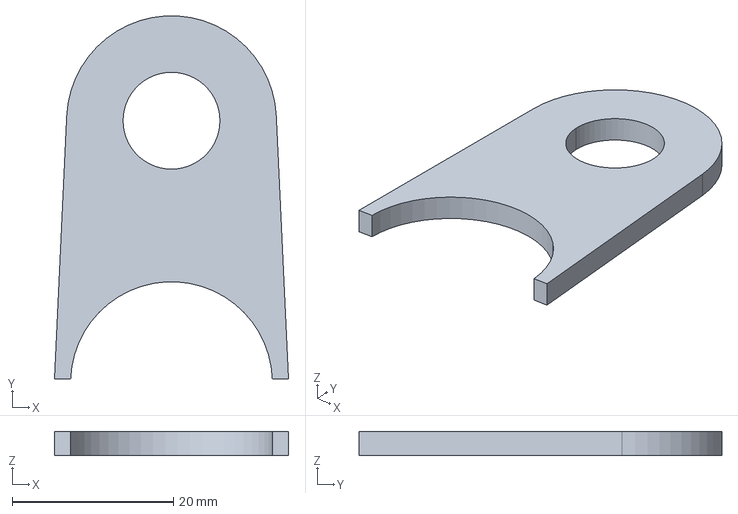
[picture p226: CAD file, 2018-01-14]
ZZ - Autres/Chapes/3mm/IGS/Bracket 105- Differential assy tube inf.igs
29.0 x 45.0 x 3.00 mm
