epsa-team/Vulcanix-v1.0/AA. Mise en plan/A verifier/AMS Expansion Tank/Fond Expansion Tank.igs

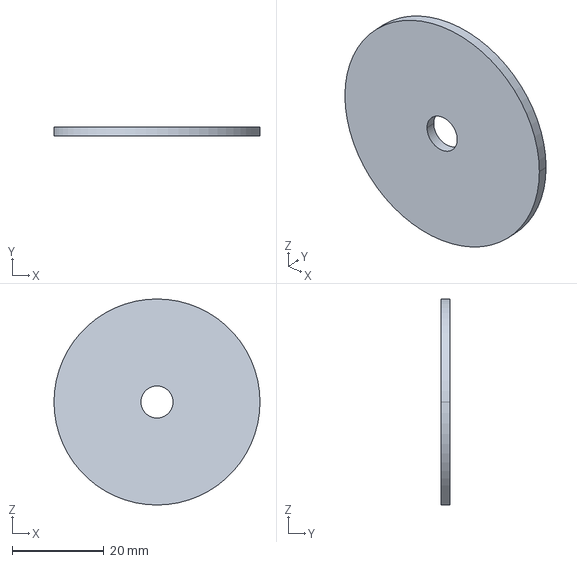
[picture p227: CAD file, 2018-03-11]
AA. Mise en plan/A verifier/AMS Expansion Tank/Fond Expansion Tank.igs
45.0 x 2.00 x 45.0 mm
