epsa-team/Vulcanix-v1.0/AA. Mise en plan/A verifier/Benjamin Fond plat/FR_0400_001_BA.igs

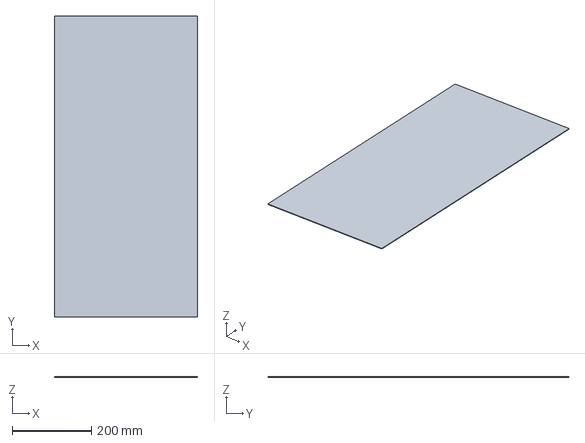
[picture p228: CAD file, 2018-06-12]
AA. Mise en plan/A verifier/Benjamin Fond plat/FR_0400_001_BA.igs
360.0 x 757.0 x 1.50 mm
