epsa-team/Vulcanix-v1.0/AA. Mise en plan/A verifier/Benjamin Pare-feu V2/Firewall BackTube.igs

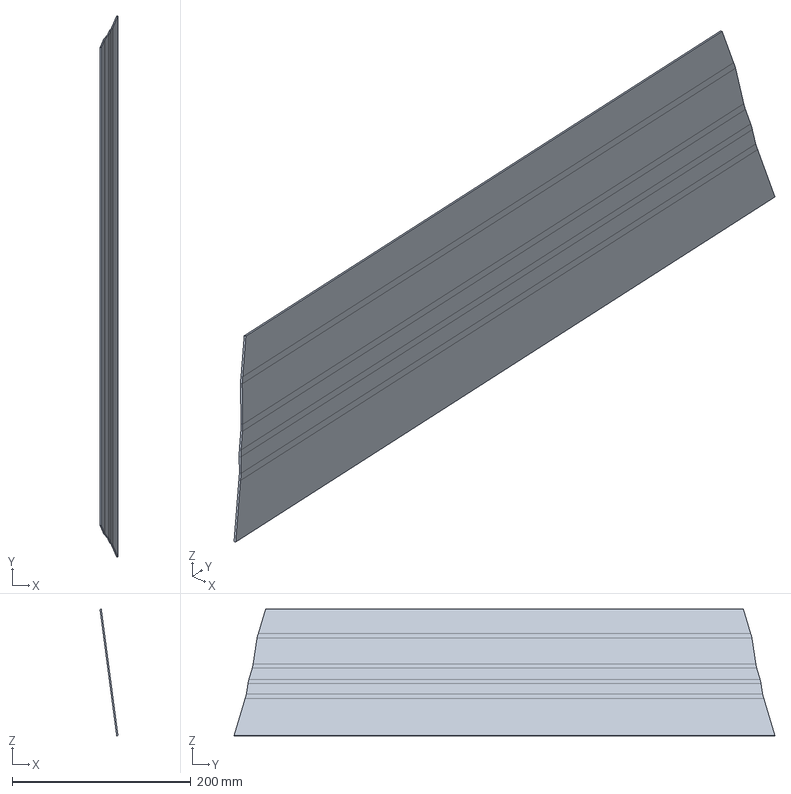
[picture p229: CAD file, 2018-06-13]
AA. Mise en plan/A verifier/Benjamin Pare-feu V2/Firewall BackTube.igs
20.1 x 604.5 x 141.5 mm
