epsa-team/Vulcanix-v1.0/AA. Mise en plan/A verifier/Benjamin Pédalier/FR_0300_009_BA.igs

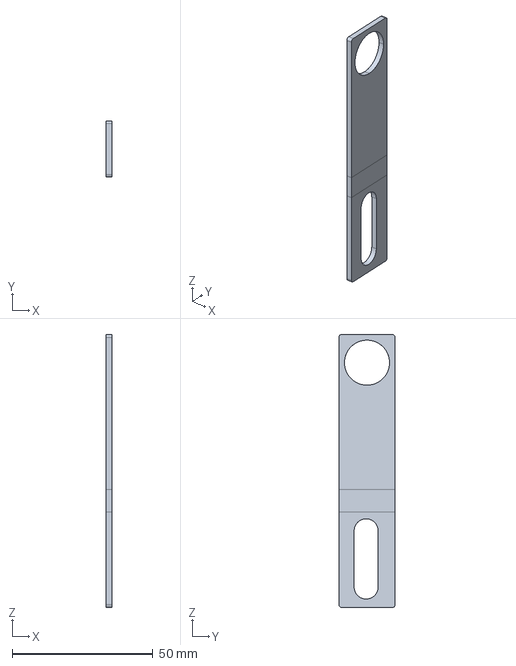
[picture p230: CAD file, 2018-03-11]
AA. Mise en plan/A verifier/Benjamin Pédalier/FR_0300_009_BA.igs
2.00 x 20.0 x 97.0 mm
