epsa-team/Vulcanix-v1.0/AA. Mise en plan/A verifier/Chainshield ADE/EN_1100_005 roule.igs

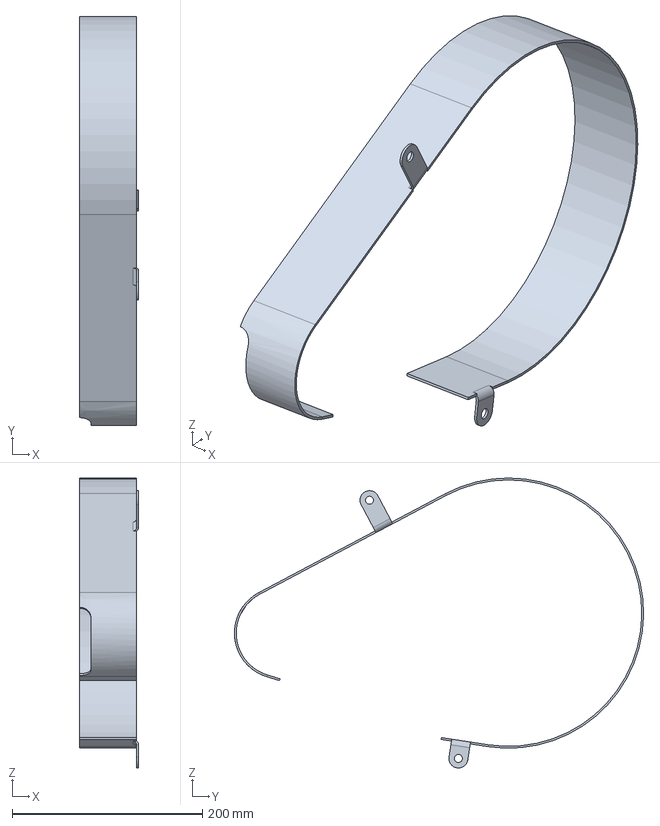
[picture p231: CAD file, 2018-03-22]
AA. Mise en plan/A verifier/Chainshield ADE/EN_1100_005 roule.igs
62.0 x 430.1 x 304.8 mm
