epsa-team/Vulcanix-v1.0/AA. Mise en plan/A verifier/VBS/a verifier/cache_cremaillere_grand_plie.igs

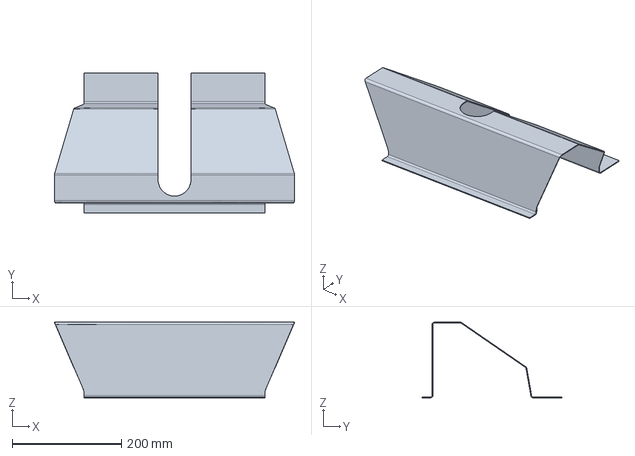
[picture p232: CAD file, 2018-06-25]
AA. Mise en plan/A verifier/VBS/a verifier/cache_cremaillere_grand_plie.igs
438.8 x 256.0 x 138.5 mm
