epsa-team/Vulcanix-v1.0/AA. Mise en plan/suivi commande/Alpentech/Insert_PM_Up_Rear.stp

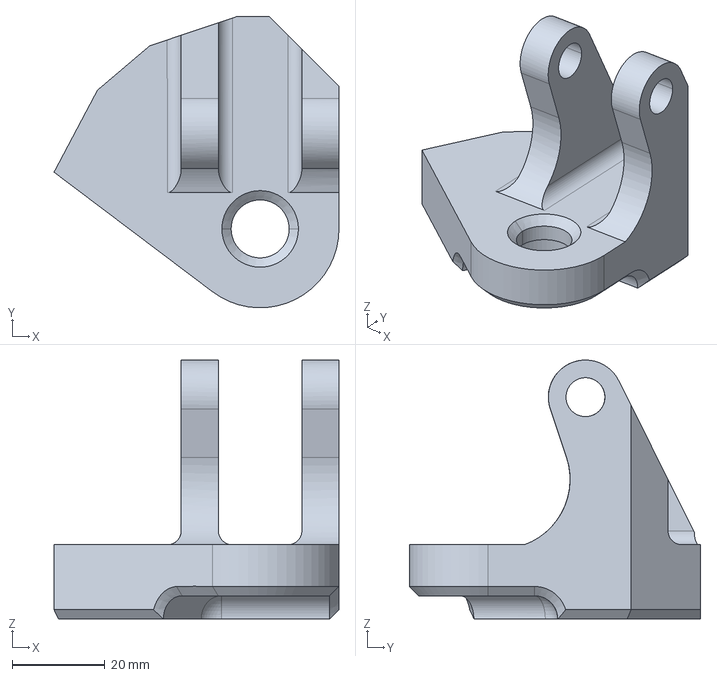
[picture p233: CAD file, 2018-03-12]
AA. Mise en plan/suivi commande/Alpentech/Insert_PM_Up_Rear.stp
61.4 x 62.8 x 55.8 mm
