epsa-team/Vulcanix-v1.0/AA. Mise en plan/suivi commande/La mache/usinage/EPSA usinage La Mache 1/18M_SU_0700_003.igs

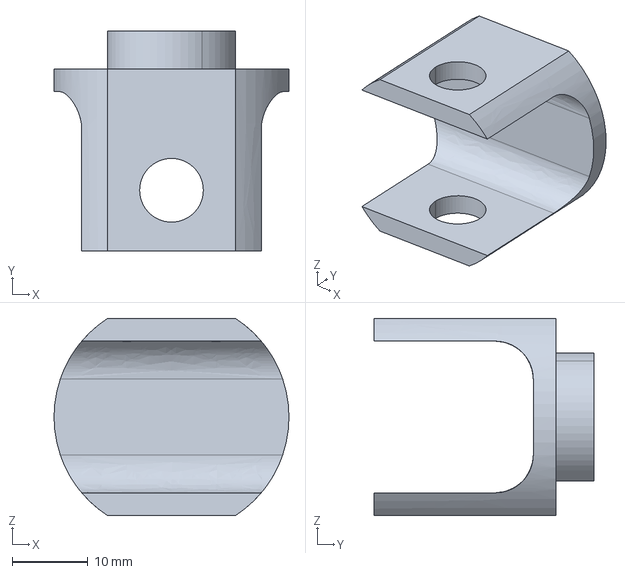
[picture p234: CAD file, 2018-03-02]
AA. Mise en plan/suivi commande/La mache/usinage/EPSA usinage La Mache 1/18M_SU_0700_003.igs
31.0 x 29.0 x 26.0 mm
