epsa-team/Vulcanix-v1.0/AA. Mise en plan/Verifie/Prod Boisard/Châssis/18B_FR_0100_002_AC (Sleeve Joint).igs

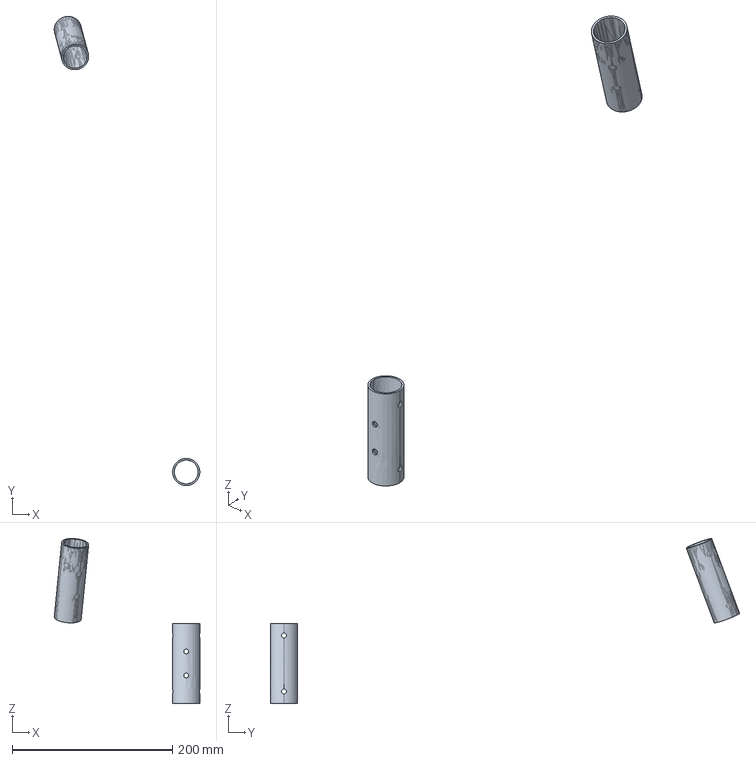
[picture p235: CAD file, 2018-03-11]
AA. Mise en plan/Verifie/Prod Boisard/Châssis/18B_FR_0100_002_AC (Sleeve Joint).igs
182.0 x 586.5 x 206.2 mm
