epsa-team/Vulcanix-v1.0/AA. Mise en plan/Verifie/Prod Boisard/Direction/SU_0900_002 (Inserts direction).igs

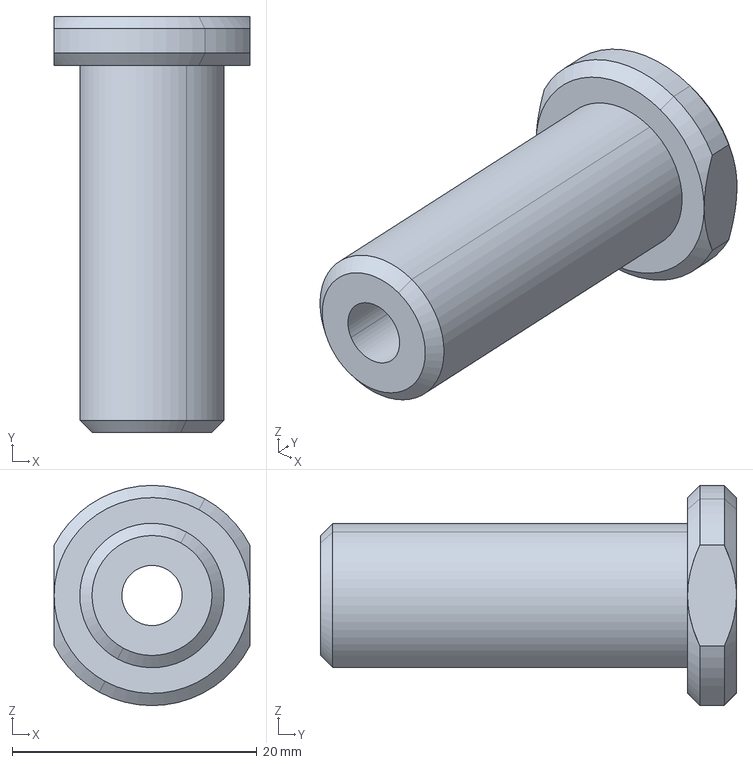
[picture p236: CAD file, 2018-05-24]
AA. Mise en plan/Verifie/Prod Boisard/Direction/SU_0900_002 (Inserts direction).igs
16.0 x 34.0 x 18.0 mm
