epsa-team/Vulcanix-v1.0/AA. Mise en plan/Verifie/Prod Boisard/Roues équipés/Coordonnées portes-moyeux/SU_1100_001 (Rear Upright).SLDPRT

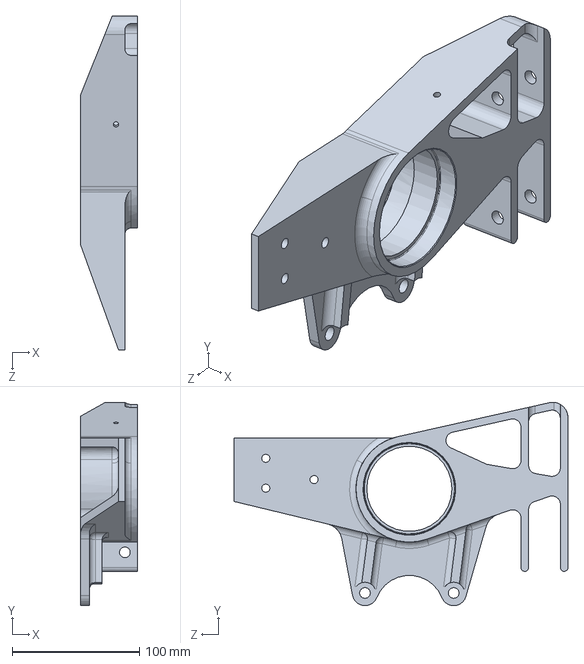
[picture p237: CAD file, 2018-05-24]
AA. Mise en plan/Verifie/Prod Boisard/Roues équipés/Coordonnées portes-moyeux/SU_1100_001 (Rear Upright).SLDPRT
45.0 x 160.0 x 262.9 mm
