epsa-team/Vulcanix-v1.0/AA. Mise en plan/Verifie/Prod Boisard/Roues équipés/WT_0300_005 (Tripod Housing Spacer).igs

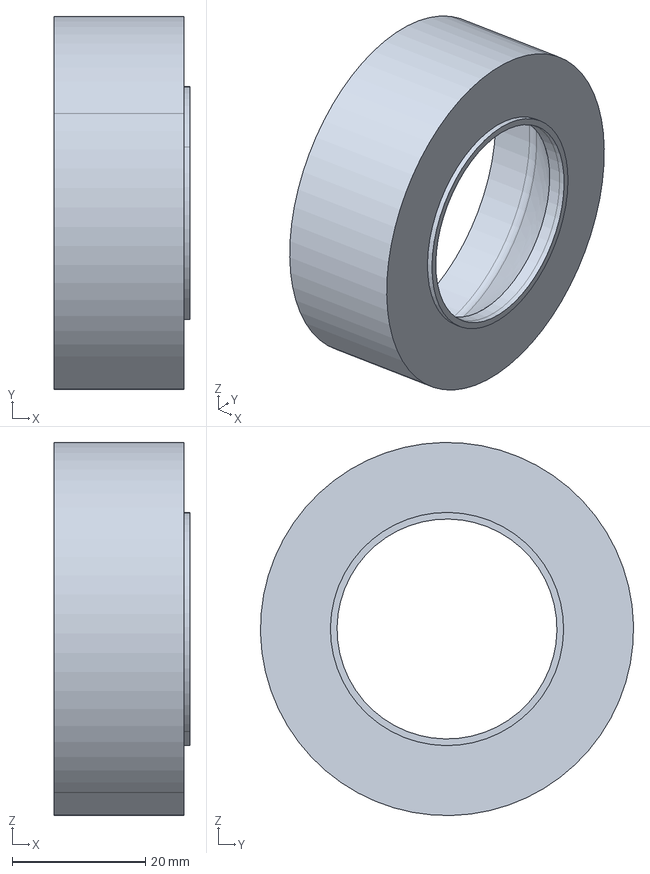
[picture p238: CAD file, 2018-02-07]
AA. Mise en plan/Verifie/Prod Boisard/Roues équipés/WT_0300_005 (Tripod Housing Spacer).igs
20.4 x 56.0 x 56.0 mm
