epsa-team/Vulcanix-v1.0/AA. Mise en plan/Verifie/Prod Boisard/Suspension/SU_1500_001 (Rear Pushrod).igs

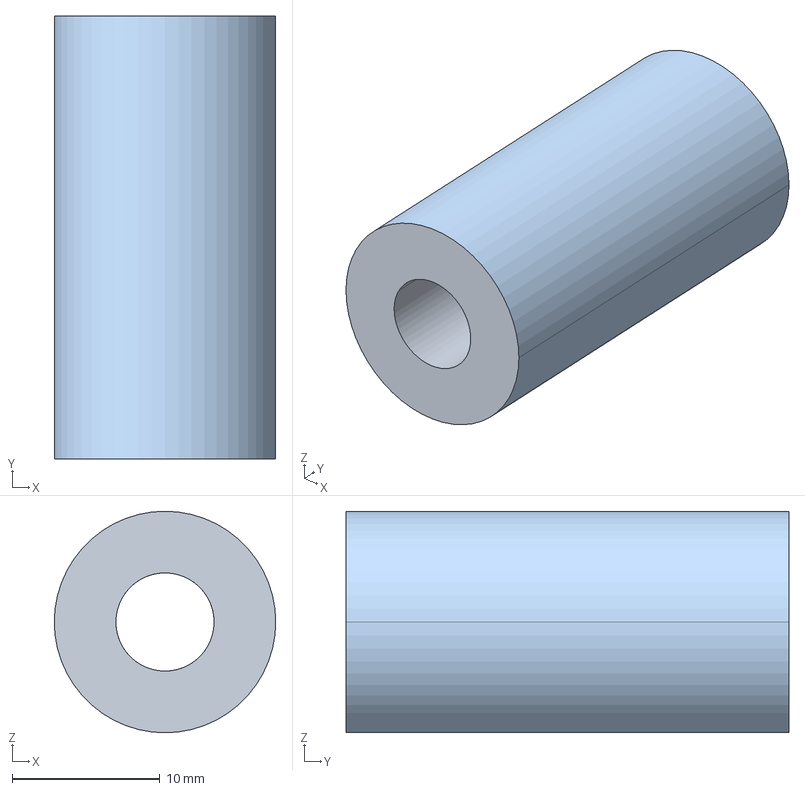
[picture p239: CAD file, 2018-03-12]
AA. Mise en plan/Verifie/Prod Boisard/Suspension/SU_1500_001 (Rear Pushrod).igs
15.0 x 30.0 x 15.0 mm
