epsa-team/Vulcanix-v1.0/AA. Mise en plan/Verifie/Prod Boisard/Transmission secondaire/EN_0900_006_AB (Porte excentrique gauche).igs

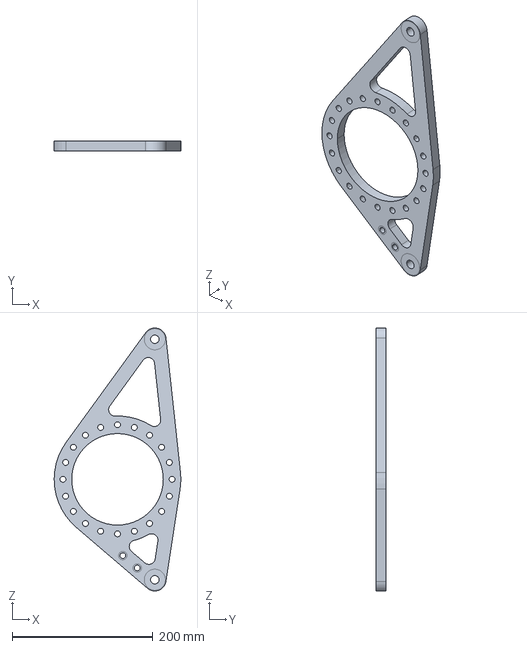
[picture p240: CAD file, 2018-03-11]
AA. Mise en plan/Verifie/Prod Boisard/Transmission secondaire/EN_0900_006_AB (Porte excentrique gauche).igs
180.0 x 14.0 x 373.7 mm
