epsa-team/Vulcanix-v1.0/AA. Mise en plan/Verifie/Prod Boisard/Triangles/SU_0100_020 (Insert Frame Side).igs

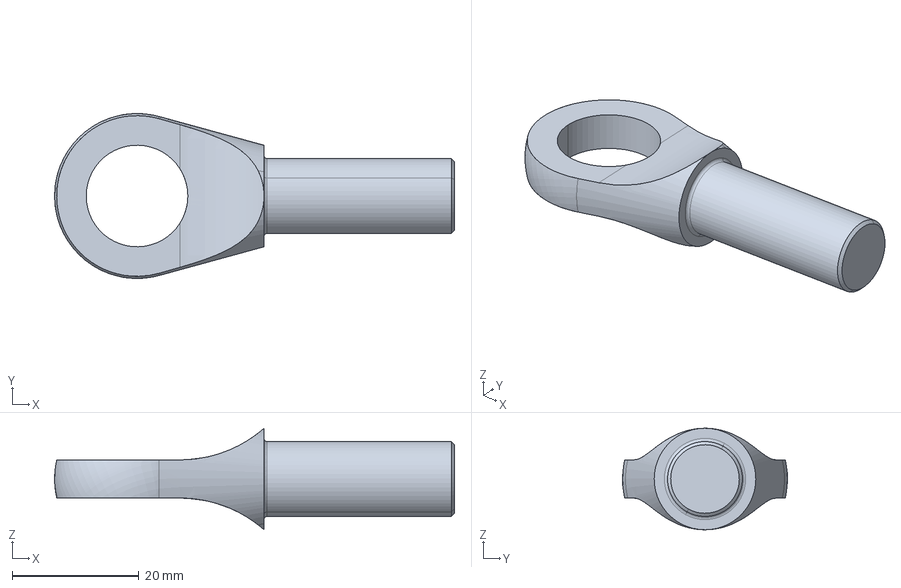
[picture p241: CAD file, 2018-03-11]
AA. Mise en plan/Verifie/Prod Boisard/Triangles/SU_0100_020 (Insert Frame Side).igs
63.0 x 26.0 x 16.0 mm
