epsa-team/Vulcanix-v1.0/EN - Engine & Powertrain/Carter d'huile/Cloison_Courte_carter_taraudee.igs

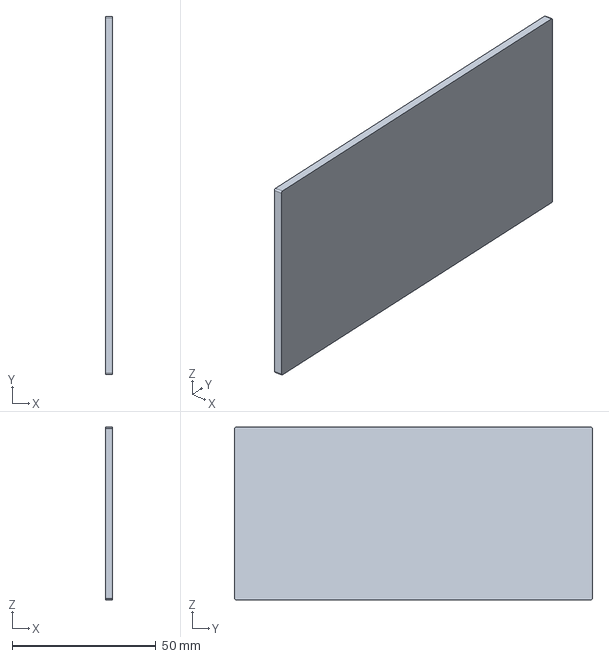
[picture p242: CAD file, 2018-03-07]
EN - Engine & Powertrain/Carter d'huile/Cloison_Courte_carter_taraudee.igs
2.50 x 124.5 x 60.0 mm
