epsa-team/Vulcanix-v1.0/EN - Engine & Powertrain/Carter d'huile/mise en plan/Plaque Soupape Secu.igs

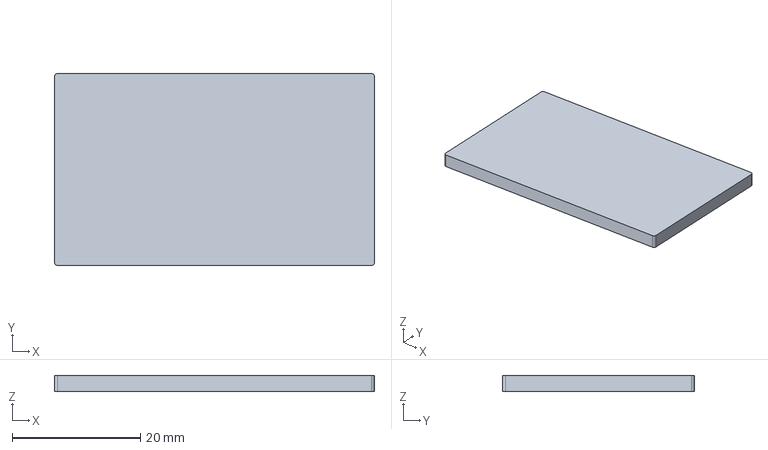
[picture p243: CAD file, 2018-03-11]
EN - Engine & Powertrain/Carter d'huile/mise en plan/Plaque Soupape Secu.igs
50.0 x 30.0 x 2.50 mm
