epsa-team/Vulcanix-v1.0/EN - Engine & Powertrain/carter/carter_v7.2/carter.igs

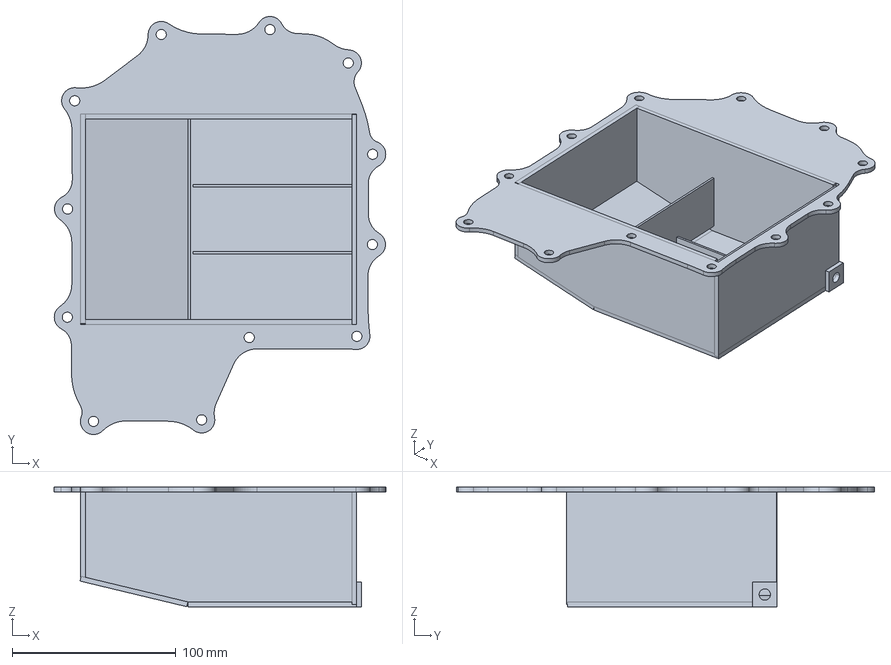
[picture p244: CAD file, 2017-12-11]
EN - Engine & Powertrain/carter/carter_v7.2/carter.igs
202.3 x 255.1 x 73.0 mm
