epsa-team/Vulcanix-v1.0/EN - Engine & Powertrain/EN_A0200 (Exhaust)/mise en plan/18M_EN_0200_009.igs

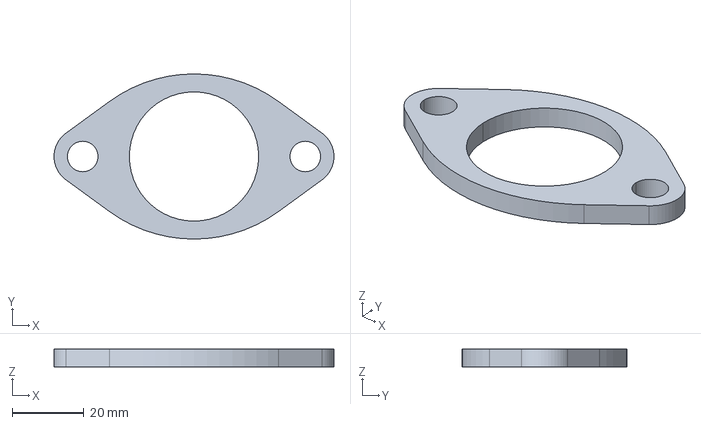
[picture p245: CAD file, 2018-02-08]
EN - Engine & Powertrain/EN_A0200 (Exhaust)/mise en plan/18M_EN_0200_009.igs
78.0 x 46.0 x 5.00 mm
