epsa-team/Vulcanix-v1.0/EN - Engine & Powertrain/EN_A0300 (Air intake)/Fichiers ARRK/Boite à air.stp

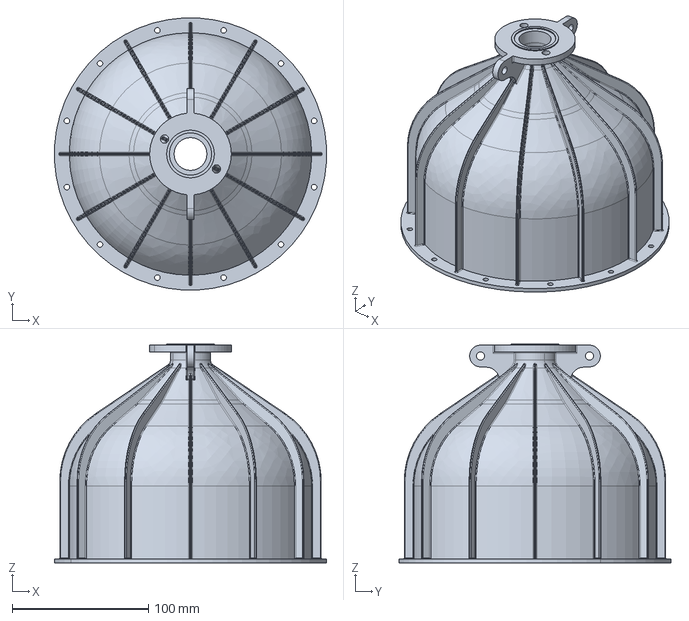
[picture p246: CAD file, 2018-02-07]
EN - Engine & Powertrain/EN_A0300 (Air intake)/Fichiers ARRK/Boite à air.stp
199.7 x 199.7 x 160.8 mm
