epsa-team/Vulcanix-v1.0/EN - Engine & Powertrain/EN_A0300 (Air intake)/Pièces fabriquées ou récupérées/EN_0300_010_AA.igs

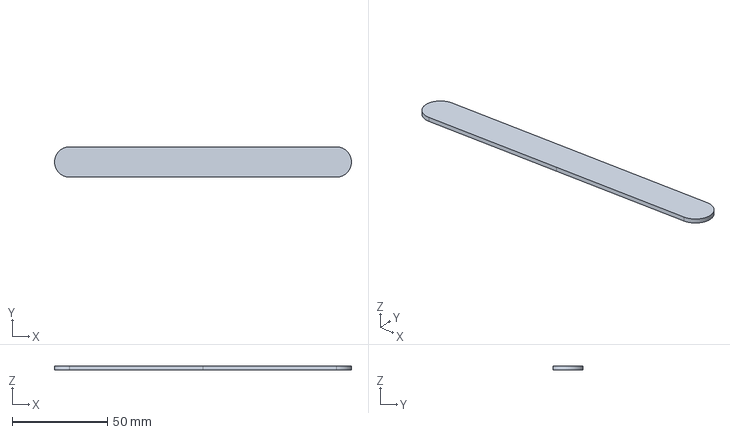
[picture p247: CAD file, 2018-02-08]
EN - Engine & Powertrain/EN_A0300 (Air intake)/Pièces fabriquées ou récupérées/EN_0300_010_AA.igs
156.0 x 16.0 x 2.00 mm
