epsa-team/Vulcanix-v1.0/EN - Engine & Powertrain/EN_A0400 (Fuel Tank)/mise en plan/fond de reservoir.igs

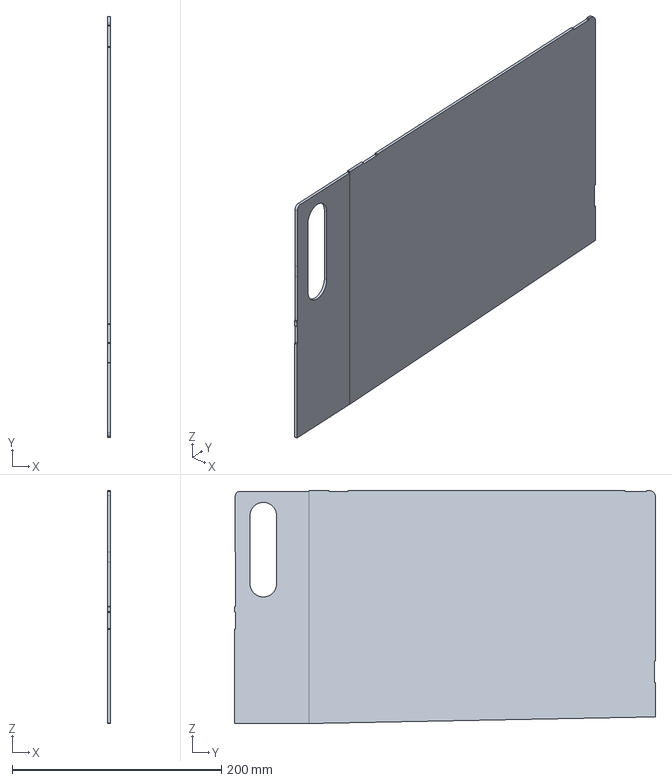
[picture p248: CAD file, 2018-03-11]
EN - Engine & Powertrain/EN_A0400 (Fuel Tank)/mise en plan/fond de reservoir.igs
2.50 x 402.4 x 222.5 mm
