epsa-team/Vulcanix-v1.0/EN - Engine & Powertrain/EN_A0900 (Differential Assy)/mise en plan/EN_0900_005.igs

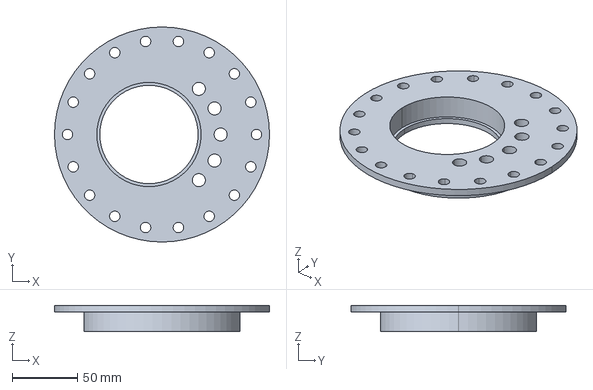
[picture p249: CAD file, 2018-02-04]
EN - Engine & Powertrain/EN_A0900 (Differential Assy)/mise en plan/EN_0900_005.igs
165.0 x 165.0 x 20.0 mm
