epsa-team/Vulcanix-v1.0/EN - Engine & Powertrain/EN_A0900 (Differential Assy)/porte excentrique gauche.igs

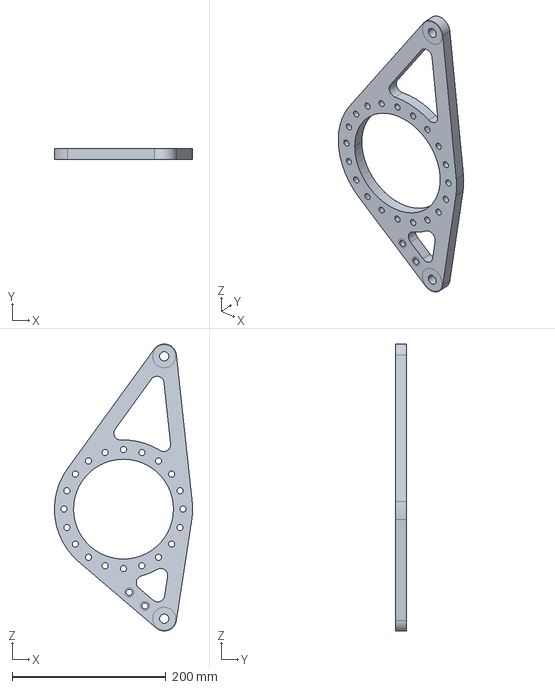
[picture p250: CAD file, 2017-12-20]
EN - Engine & Powertrain/EN_A0900 (Differential Assy)/porte excentrique gauche.igs
180.0 x 14.0 x 373.7 mm
