epsa-team/Vulcanix-v1.0/FR - Frame & Body/FR_A0100 (Frame)/Firewall V2/Firewall BackTube plie.igs

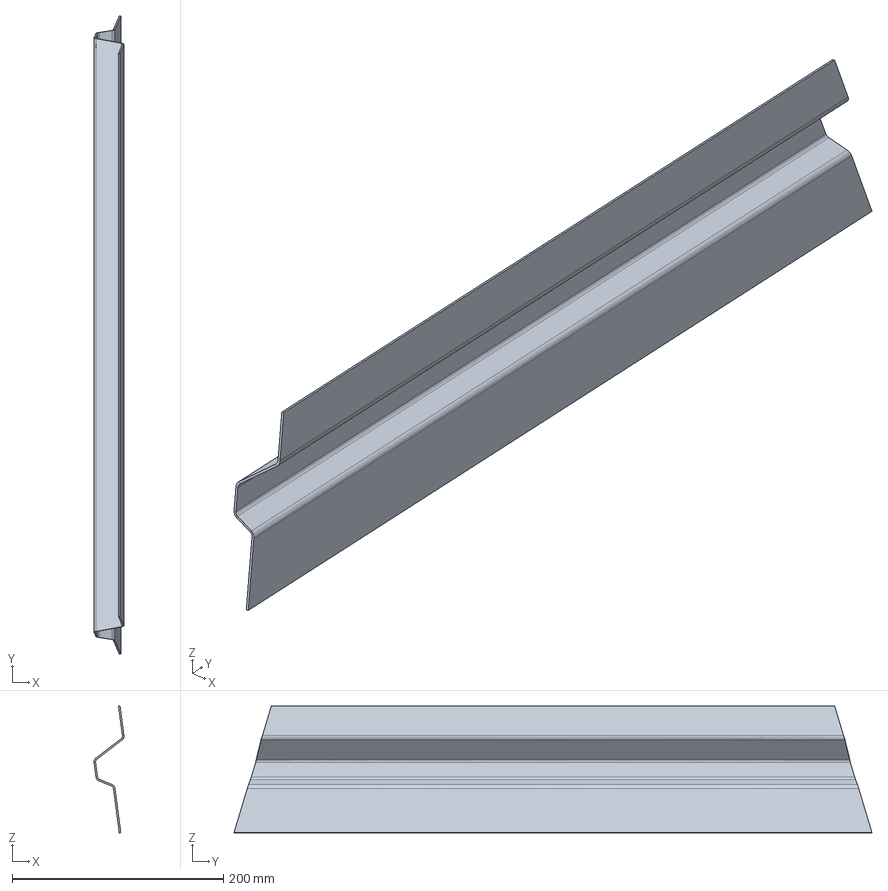
[picture p251: CAD file, 2018-06-25]
FR - Frame & Body/FR_A0100 (Frame)/Firewall V2/Firewall BackTube plie.igs
28.5 x 604.5 x 120.2 mm
