epsa-team/Vulcanix-v1.0/FR - Frame & Body/FR_A0100 (Frame)/Firewall V2/igs/Firewall Middle back.igs

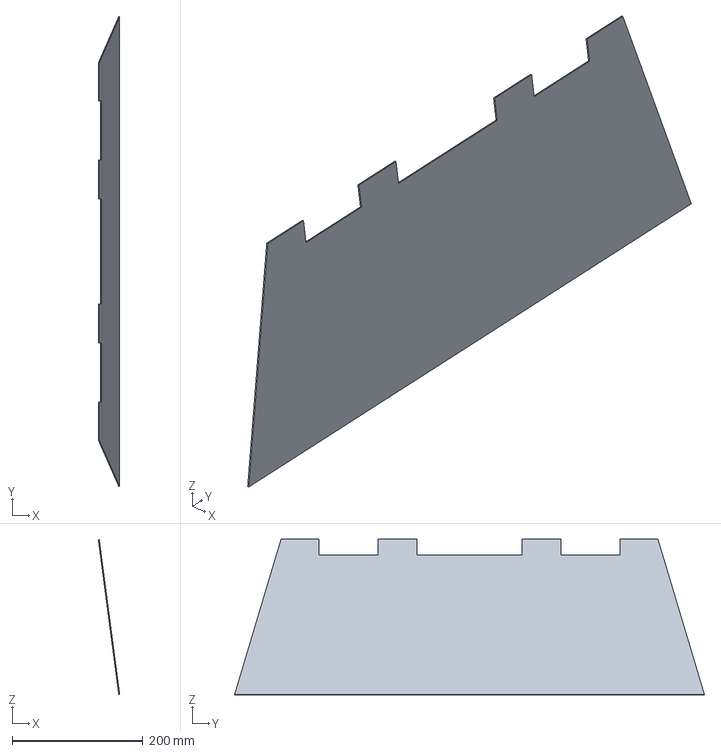
[picture p252: CAD file, 2018-06-12]
FR - Frame & Body/FR_A0100 (Frame)/Firewall V2/igs/Firewall Middle back.igs
32.8 x 717.7 x 237.6 mm
