epsa-team/Vulcanix-v1.0/FR - Frame & Body/FR_A0100 (Frame)/Mise en plan Firewall/Firewall bottom.igs

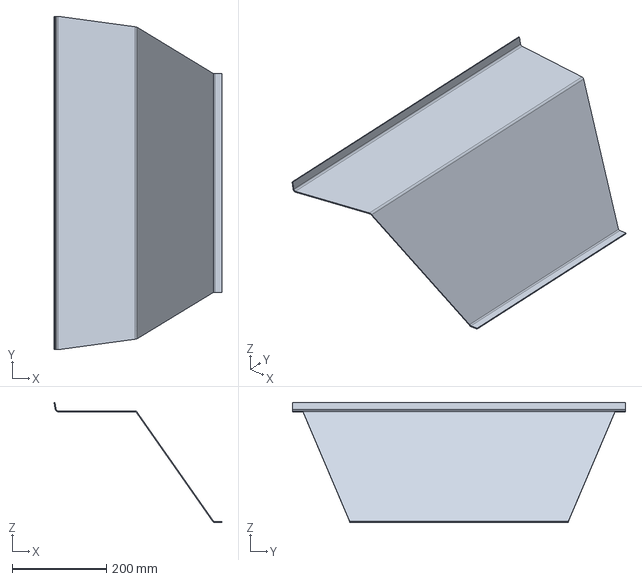
[picture p253: CAD file, 2018-01-31]
FR - Frame & Body/FR_A0100 (Frame)/Mise en plan Firewall/Firewall bottom.igs
356.2 x 707.0 x 255.1 mm
