epsa-team/Vulcanix-v1.0/FR - Frame & Body/FR_A0100 (Frame)/Prod/112.stp

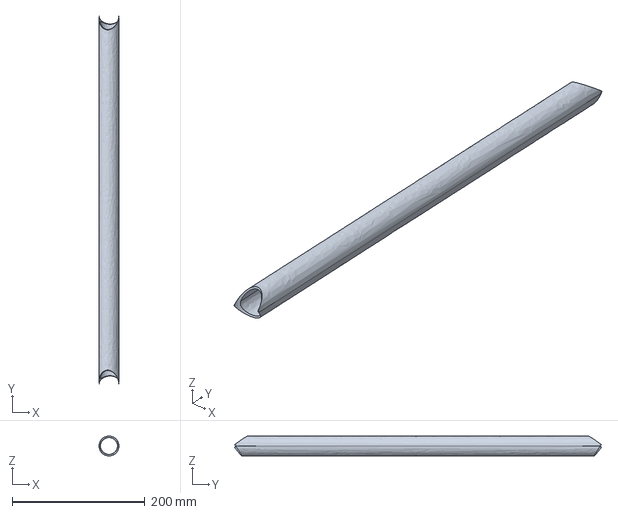
[picture p254: CAD file, 2018-02-08]
FR - Frame & Body/FR_A0100 (Frame)/Prod/112.stp
30.0 x 552.4 x 30.0 mm
