epsa-team/Vulcanix-v1.0/FR - Frame & Body/FR_A0100 (Frame)/Prod/Tubes step/direction/ST_1.stp

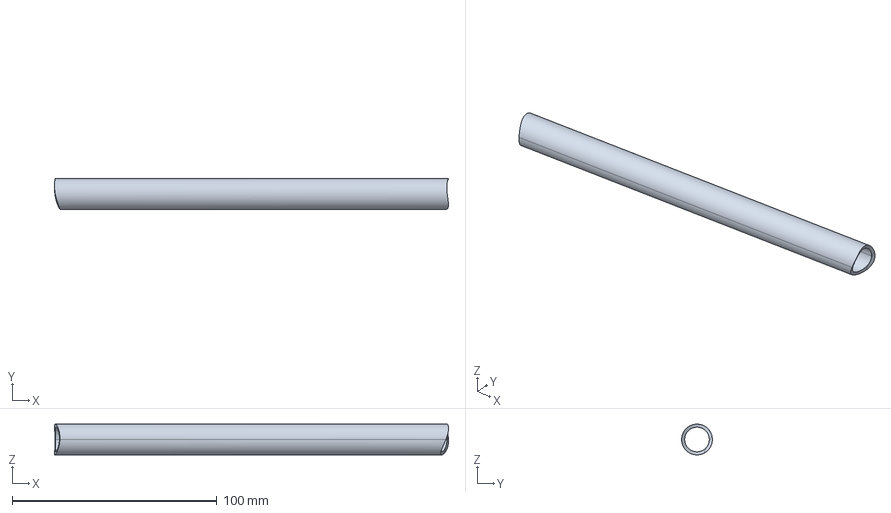
[picture p255: CAD file, 2017-12-21]
FR - Frame & Body/FR_A0100 (Frame)/Prod/Tubes step/direction/ST_1.stp
192.2 x 15.0 x 15.0 mm
