epsa-team/Vulcanix-v1.0/FR - Frame & Body/FR_A0100 (Frame)/Prod/Tubes step/HARNAIS.stp

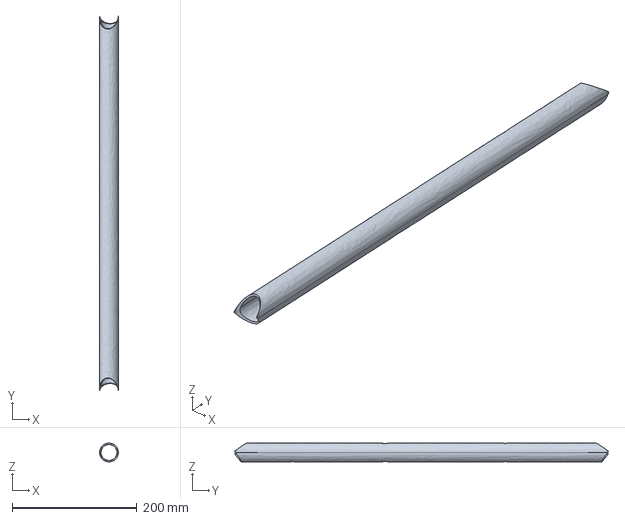
[picture p256: CAD file, 2018-05-24]
FR - Frame & Body/FR_A0100 (Frame)/Prod/Tubes step/HARNAIS.stp
30.0 x 598.8 x 30.0 mm
