epsa-team/Vulcanix-v1.0/FR - Frame & Body/FR_A0100 (Frame)/Prod/Tubes step/nouveau nom/15x1.5repare/114.stp

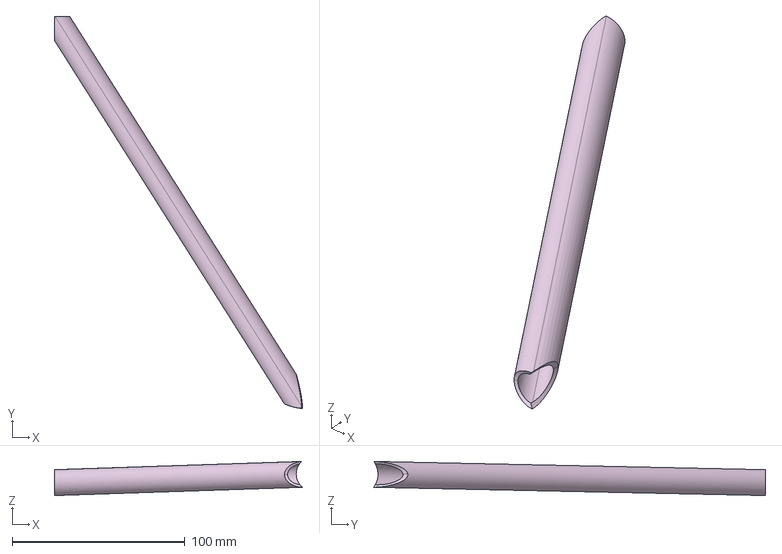
[picture p257: CAD file, 2018-02-08]
FR - Frame & Body/FR_A0100 (Frame)/Prod/Tubes step/nouveau nom/15x1.5repare/114.stp
143.7 x 227.1 x 19.8 mm
