epsa-team/Vulcanix-v1.0/FR - Frame & Body/FR_A0100 (Frame)/Prod/Tubes step/nouveau nom/202 biseau.stp

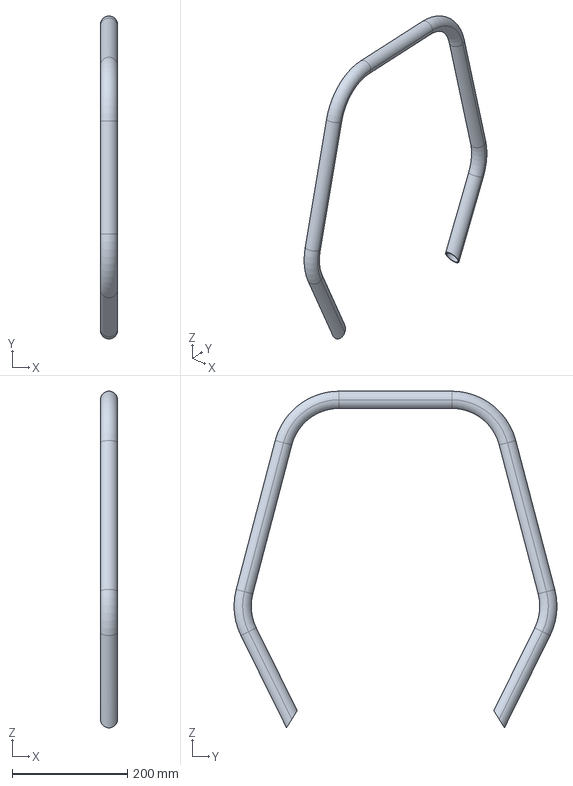
[picture p258: CAD file, 2018-01-17]
FR - Frame & Body/FR_A0100 (Frame)/Prod/Tubes step/nouveau nom/202 biseau.stp
30.0 x 561.1 x 585.0 mm
