epsa-team/Vulcanix-v1.0/FR - Frame & Body/FR_A0100 (Frame)/Prod/Tubes step/nouveau nom/20x1.5repare/55.stp

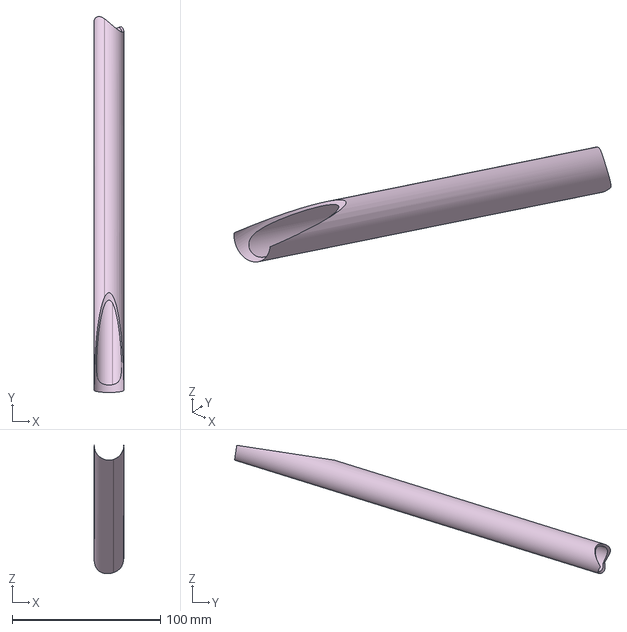
[picture p259: CAD file, 2018-02-08]
FR - Frame & Body/FR_A0100 (Frame)/Prod/Tubes step/nouveau nom/20x1.5repare/55.stp
20.0 x 253.3 x 86.5 mm
