epsa-team/Vulcanix-v1.0/FR - Frame & Body/FR_A0100 (Frame)/Prod/Tubes step/nouveau nom/25x1.5repare/59.stp

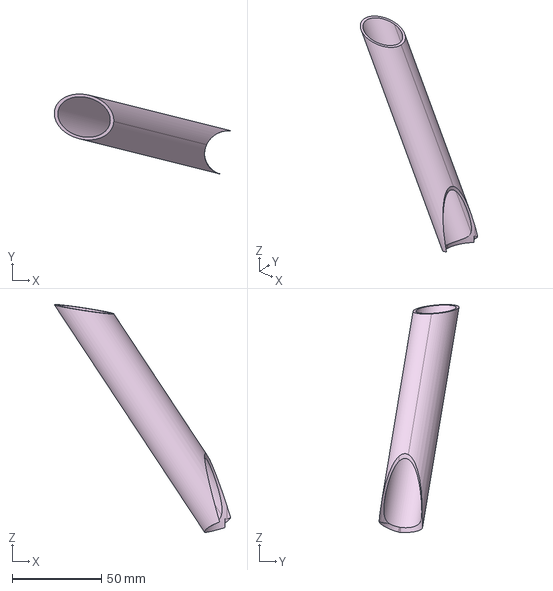
[picture p260: CAD file, 2018-02-08]
FR - Frame & Body/FR_A0100 (Frame)/Prod/Tubes step/nouveau nom/25x1.5repare/59.stp
98.7 x 44.7 x 127.5 mm
