epsa-team/Vulcanix-v1.0/FR - Frame & Body/FR_A0100 (Frame)/Prod/Tubes step/nouveau nom/30x1.5/106.stp

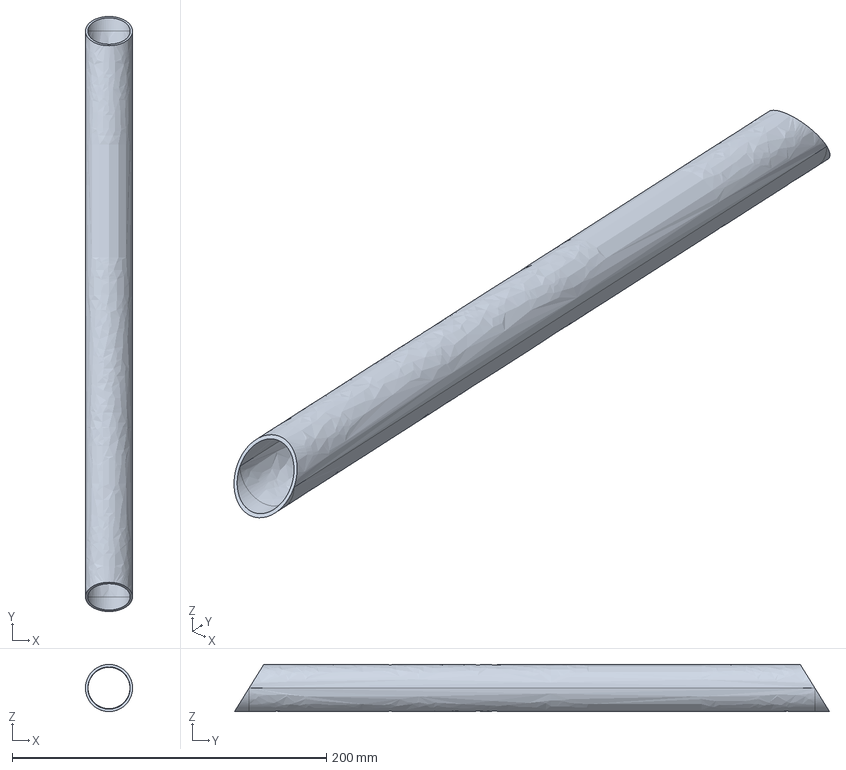
[picture p261: CAD file, 2018-01-17]
FR - Frame & Body/FR_A0100 (Frame)/Prod/Tubes step/nouveau nom/30x1.5/106.stp
30.0 x 378.6 x 30.0 mm
