epsa-team/Vulcanix-v1.0/FR - Frame & Body/FR_A0100 (Frame)/Prod/Tubes step/nouveau nom/30x1.5repare/25.stp

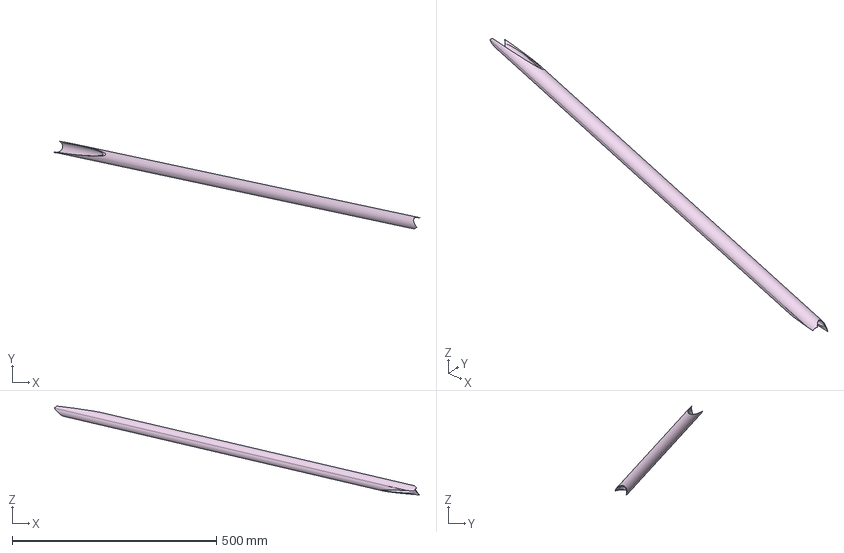
[picture p262: CAD file, 2018-02-08]
FR - Frame & Body/FR_A0100 (Frame)/Prod/Tubes step/nouveau nom/30x1.5repare/25.stp
892.8 x 214.7 x 217.6 mm
