epsa-team/Vulcanix-v1.0/FR - Frame & Body/FR_A0100 (Frame)/Prod/Tubes step/nouveau nom/Tube step EPSA v3.0/15x1.5repare/117.stp

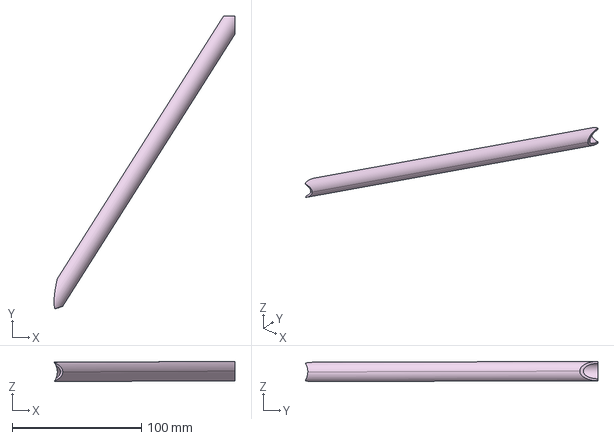
[picture p263: CAD file, 2018-02-08]
FR - Frame & Body/FR_A0100 (Frame)/Prod/Tubes step/nouveau nom/Tube step EPSA v3.0/15x1.5repare/117.stp
140.1 x 226.6 x 15.6 mm
