epsa-team/Vulcanix-v1.0/FR - Frame & Body/FR_A0100 (Frame)/Prod/Tubes step/nouveau nom/Tube step EPSA v3.0/20x1.5repare/SU_0510_002.stp

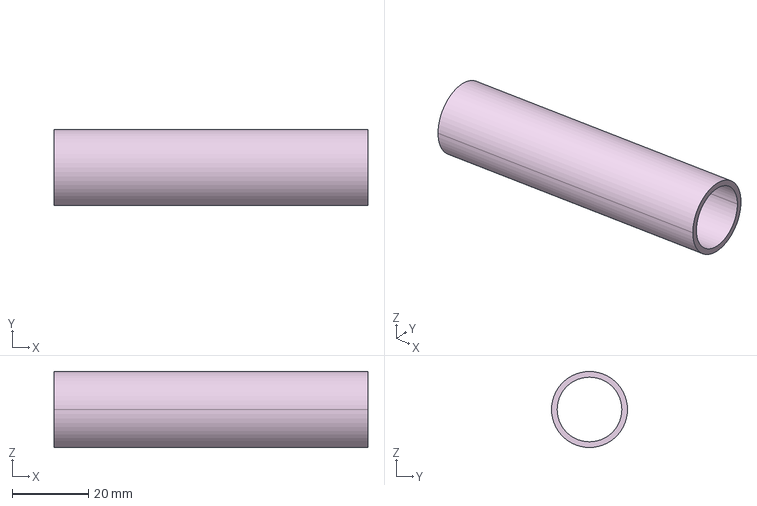
[picture p264: CAD file, 2018-02-08]
FR - Frame & Body/FR_A0100 (Frame)/Prod/Tubes step/nouveau nom/Tube step EPSA v3.0/20x1.5repare/SU_0510_002.stp
82.6 x 20.0 x 20.0 mm
