epsa-team/Vulcanix-v1.0/FR - Frame & Body/FR_A0100 (Frame)/Prod/Tubes step/nouveau nom/Tube step EPSA v3.0/25x1.5repare/41.stp

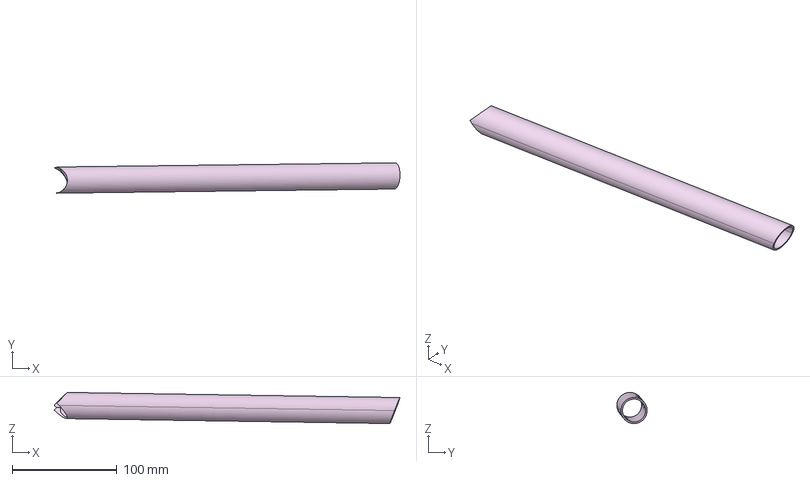
[picture p265: CAD file, 2018-02-08]
FR - Frame & Body/FR_A0100 (Frame)/Prod/Tubes step/nouveau nom/Tube step EPSA v3.0/25x1.5repare/41.stp
330.1 x 28.9 x 29.7 mm
