epsa-team/Vulcanix-v1.0/FR - Frame & Body/FR_A0100 (Frame)/Prod/Tubes step/nouveau nom/Tube step EPSA v3.0/30x1.5repare/27.stp

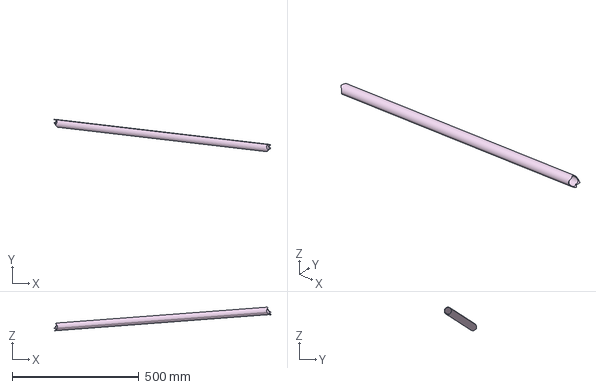
[picture p266: CAD file, 2018-02-08]
FR - Frame & Body/FR_A0100 (Frame)/Prod/Tubes step/nouveau nom/Tube step EPSA v3.0/30x1.5repare/27.stp
855.9 x 127.8 x 93.4 mm
