epsa-team/Vulcanix-v1.0/FR - Frame & Body/FR_A0200 (Impact Attenuator)/Standard Impact attenuator.stp

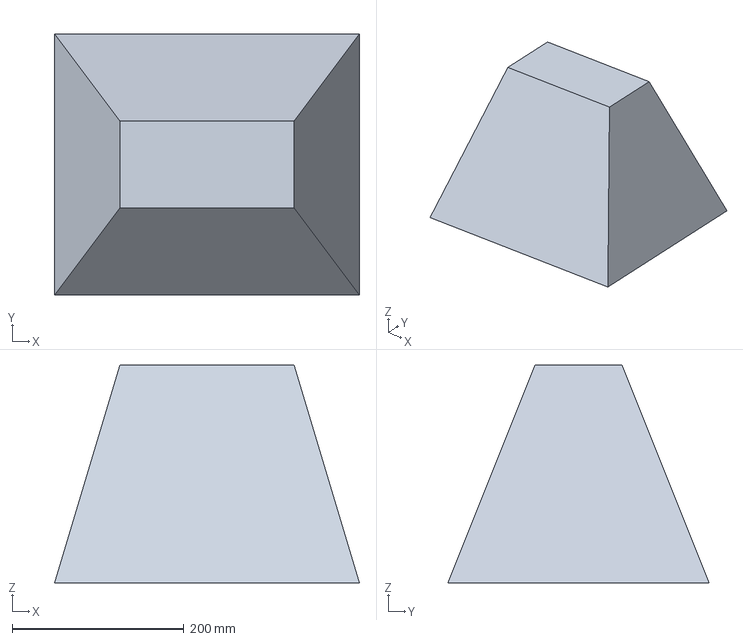
[picture p267: CAD file, 2017-11-16]
FR - Frame & Body/FR_A0200 (Impact Attenuator)/Standard Impact attenuator.stp
355.6 x 304.8 x 254.0 mm
