epsa-team/Vulcanix-v1.0/FR - Frame & Body/FR_A0300 (Pedal Assy)/Mise en plan/1 Usinage/FR_0300_000_BA.igs

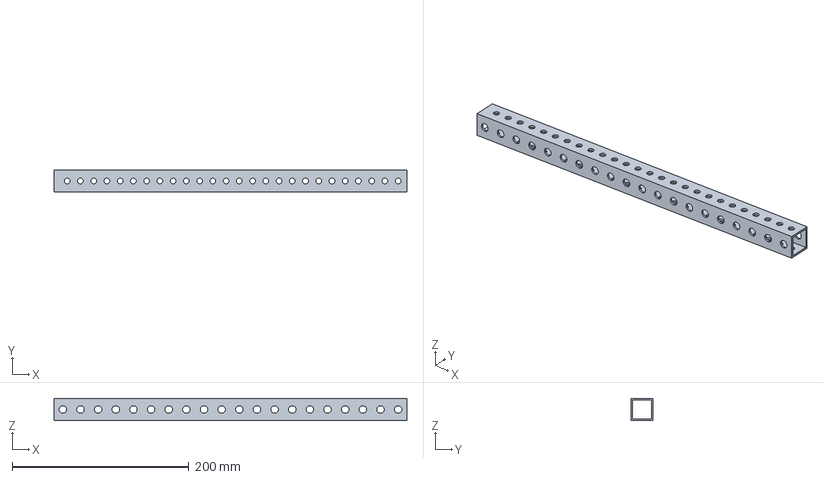
[picture p268: CAD file, 2018-02-04]
FR - Frame & Body/FR_A0300 (Pedal Assy)/Mise en plan/1 Usinage/FR_0300_000_BA.igs
400.0 x 25.0 x 25.0 mm
