epsa-team/Vulcanix-v1.0/FR - Frame & Body/FR_A0300 (Pedal Assy)/Mise en plan/2 Decoupe laser et pliage/FR_0300_003_BA.igs

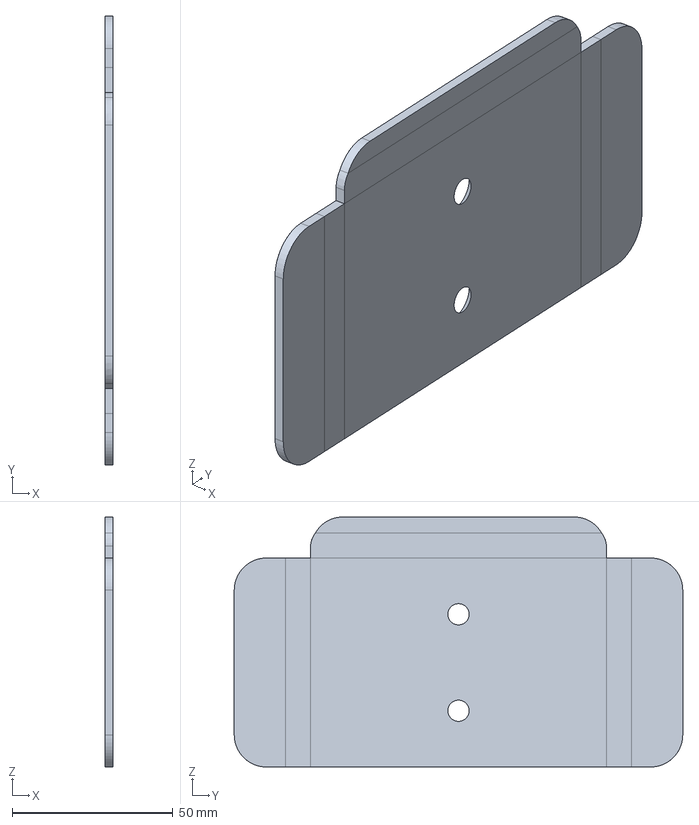
[picture p269: CAD file, 2018-03-11]
FR - Frame & Body/FR_A0300 (Pedal Assy)/Mise en plan/2 Decoupe laser et pliage/FR_0300_003_BA.igs
2.50 x 139.5 x 77.8 mm
