epsa-team/Vulcanix-v1.0/FR - Frame & Body/FR_A0700 (Body)/Fichiers step/ouie gauche.stp

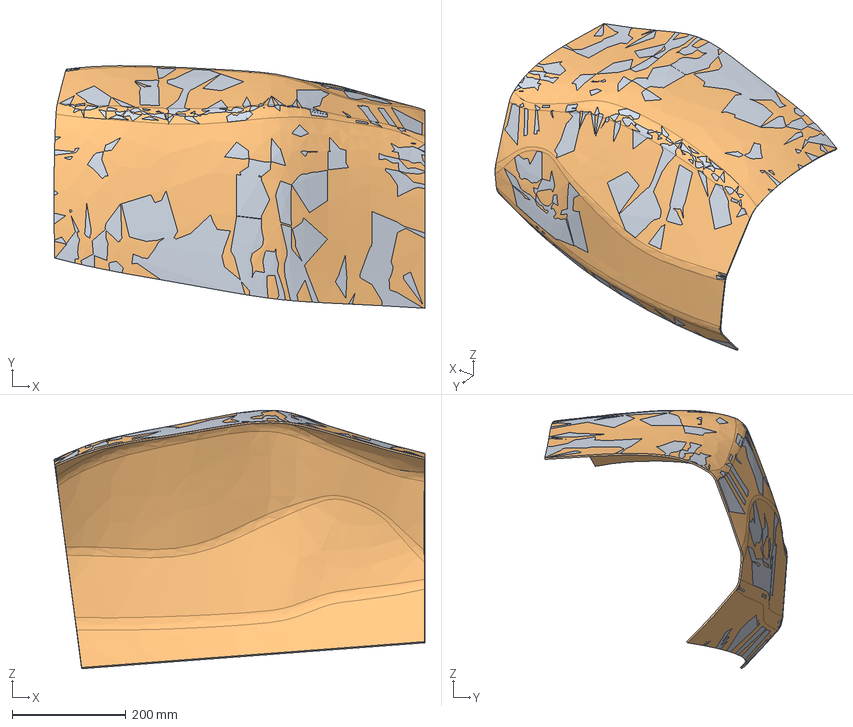
[picture p270: CAD file, 2018-03-26]
FR - Frame & Body/FR_A0700 (Body)/Fichiers step/ouie gauche.stp
651.5 x 425.9 x 453.9 mm
