epsa-team/Vulcanix-v1.0/Shape_952.stp

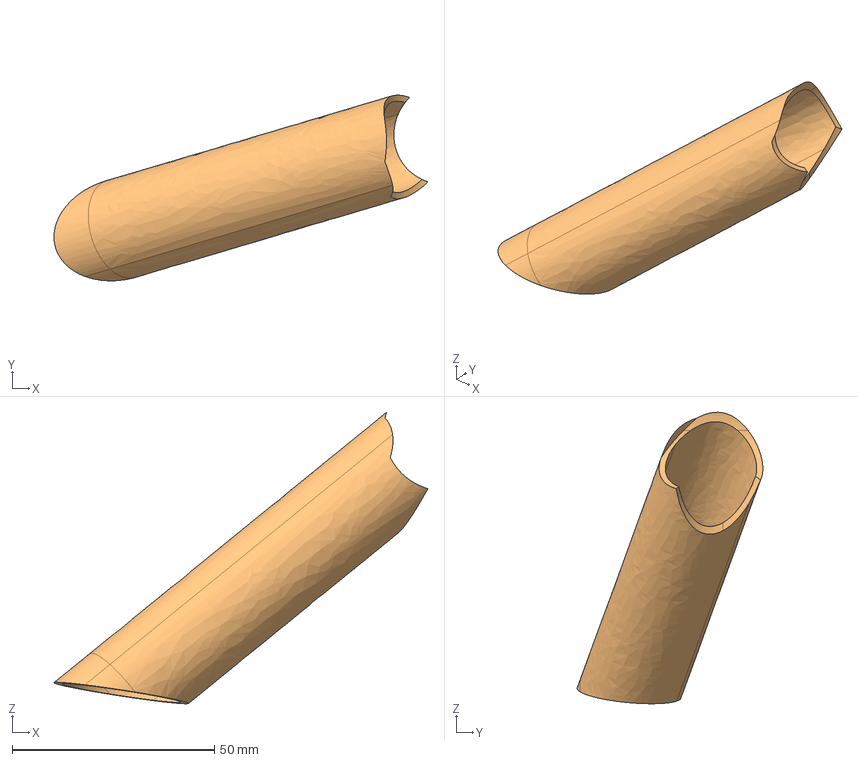
[picture p271: CAD file, 2018-02-08]
Shape_952.stp
92.5 x 45.9 x 72.1 mm
