epsa-team/Vulcanix-v1.0/ST - Steering System/ST_A0700 (Steering shaft pivot)/BEARING SKF/QR Shaft.STEP

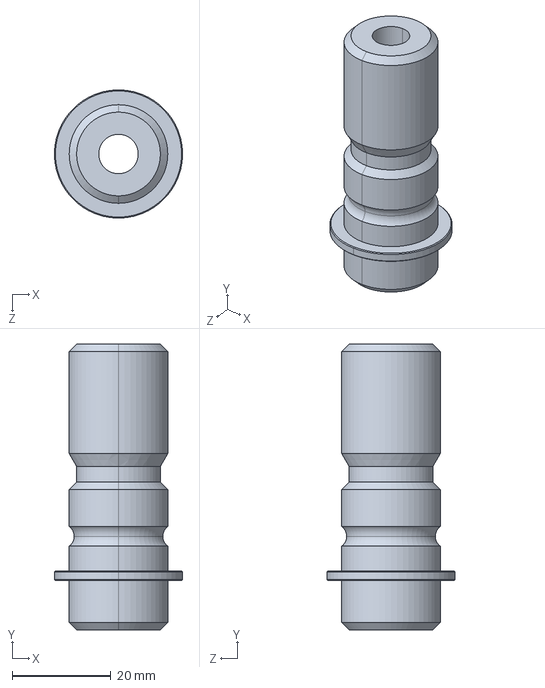
[picture p272: CAD file, 2017-12-05]
ST - Steering System/ST_A0700 (Steering shaft pivot)/BEARING SKF/QR Shaft.STEP
26.0 x 58.0 x 26.0 mm
