epsa-team/Vulcanix-v1.0/SU - Suspension/04 - 3D Printing/Front Left Upright.stl

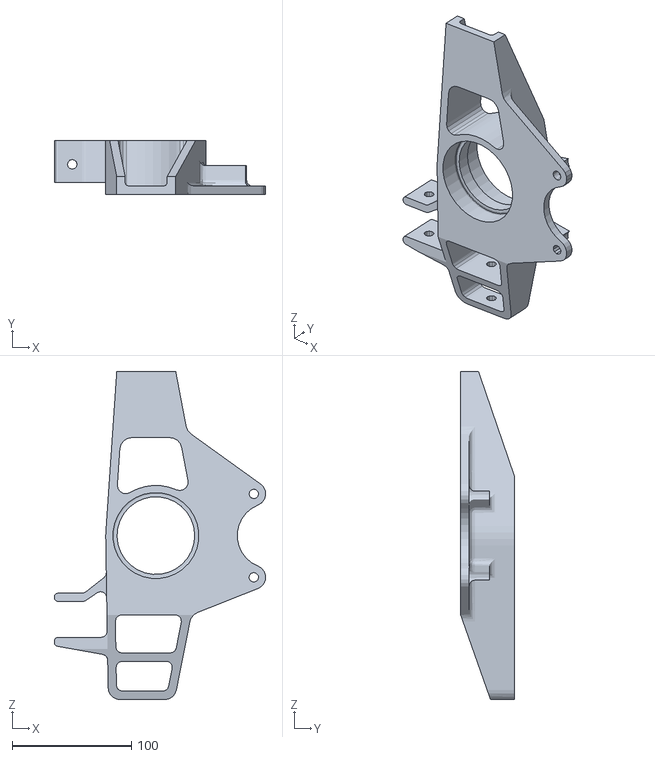
[picture p273: CAD file, 2017-12-07]
SU - Suspension/04 - 3D Printing/Front Left Upright.stl
176.9 x 45.0 x 274.6
