epsa-team/Vulcanix-v1.0/SU - Suspension/Chappe de LAS/Chape Liason au Sol EPSA/SU_0100 (Avant Sup)/IGS/SU_0100_009 (Avant Sup Arriere Inf).igs

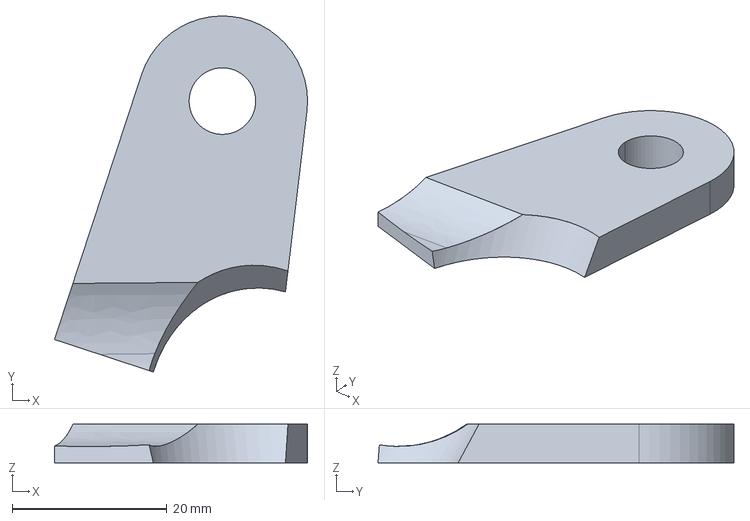
[picture p274: CAD file, 2018-02-12]
SU - Suspension/Chappe de LAS/Chape Liason au Sol EPSA/SU_0100 (Avant Sup)/IGS/SU_0100_009 (Avant Sup Arriere Inf).igs
32.7 x 46.0 x 5.00 mm
