epsa-team/Vulcanix-v1.0/SU - Suspension/Chappe de LAS/Chape Liason au Sol EPSA/SU_0200 (Avant Inf)/IGS/SU_0200_007 (Avant Inf Avant Inf).igs

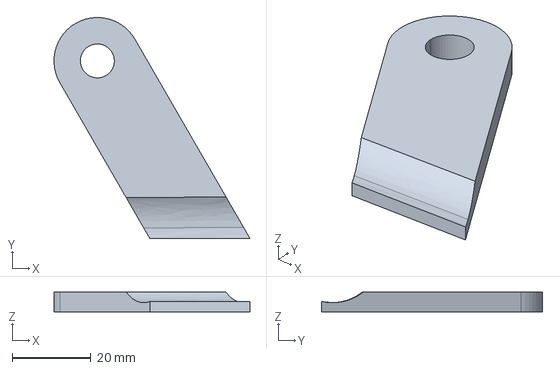
[picture p275: CAD file, 2018-02-12]
SU - Suspension/Chappe de LAS/Chape Liason au Sol EPSA/SU_0200 (Avant Inf)/IGS/SU_0200_007 (Avant Inf Avant Inf).igs
49.7 x 56.0 x 5.00 mm
