epsa-team/Vulcanix-v1.0/SU - Suspension/Chappe de LAS/Chape Liason au Sol EPSA/SU_0300 (Arriere Sup)/IGS/SU_0300_008 (Arriere Sup Avant Sup).igs

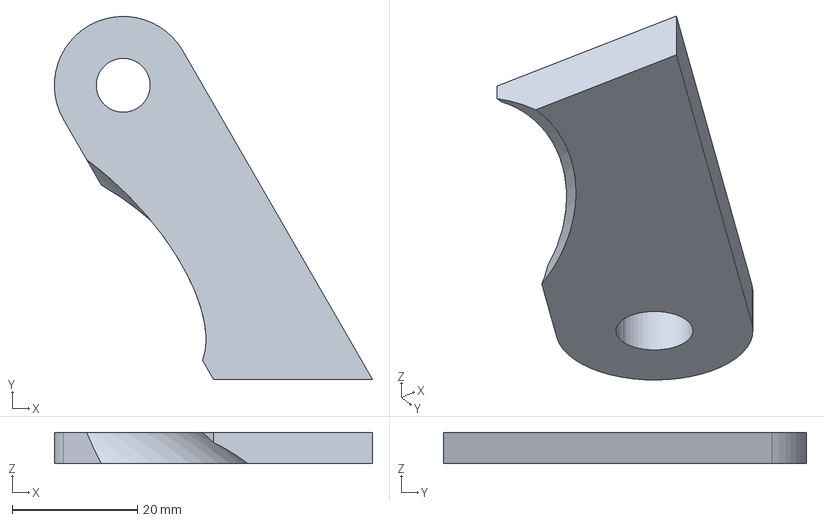
[picture p276: CAD file, 2018-02-12]
SU - Suspension/Chappe de LAS/Chape Liason au Sol EPSA/SU_0300 (Arriere Sup)/IGS/SU_0300_008 (Arriere Sup Avant Sup).igs
50.8 x 58.0 x 5.00 mm
