epsa-team/Vulcanix-v1.0/SU - Suspension/Chappe de LAS/Chape Liason au Sol EPSA/SU_0400 (Arriere Inf)/IGS/SU_0400_010 (Arriere Inf Arriere Sup).igs

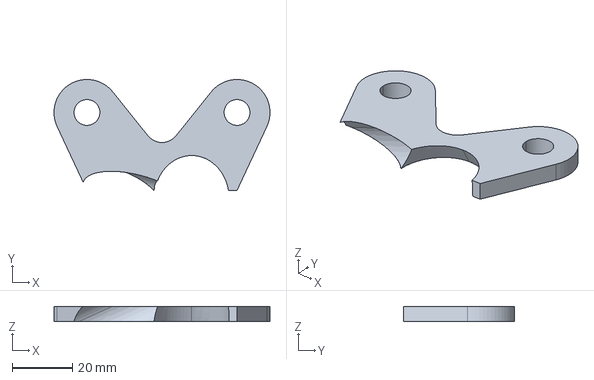
[picture p277: CAD file, 2018-02-12]
SU - Suspension/Chappe de LAS/Chape Liason au Sol EPSA/SU_0400 (Arriere Inf)/IGS/SU_0400_010 (Arriere Inf Arriere Sup).igs
72.0 x 37.0 x 5.00 mm
