epsa-team/Vulcanix-v1.0/SU - Suspension/Chappe de LAS/IGS/SU_0100 (Avant Sup)/SU_0100_012 (Avant Sup Avant SupD).igs

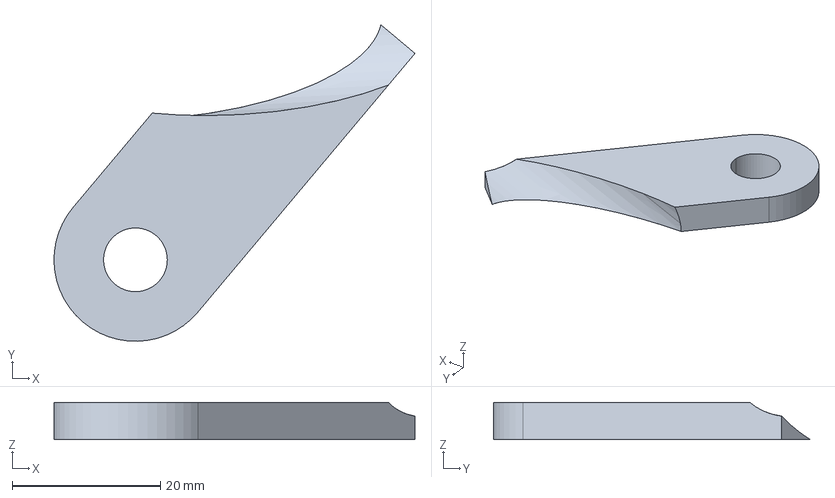
[picture p278: CAD file, 2018-03-05]
SU - Suspension/Chappe de LAS/IGS/SU_0100 (Avant Sup)/SU_0100_012 (Avant Sup Avant SupD).igs
48.7 x 42.7 x 5.00 mm
