epsa-team/Vulcanix-v1.0/SU - Suspension/Chappe de LAS/IGS/SU_0200 (Avant Inf)/SU_0200_013 (Avant inf Arriere InfD).igs

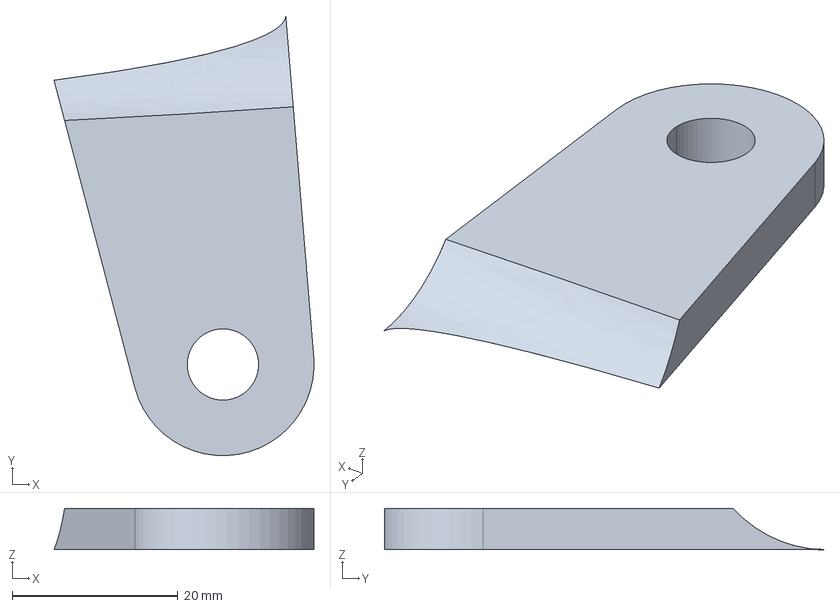
[picture p279: CAD file, 2018-03-05]
SU - Suspension/Chappe de LAS/IGS/SU_0200 (Avant Inf)/SU_0200_013 (Avant inf Arriere InfD).igs
31.4 x 53.0 x 5.00 mm
