epsa-team/Vulcanix-v1.0/SU - Suspension/Chappe de LAS/IGS/SU_0200_007 (Avant Inf Avant Inf).igs

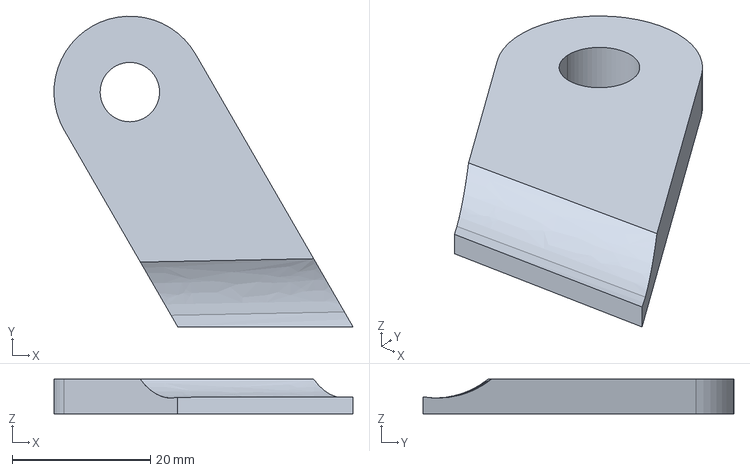
[picture p280: CAD file, 2018-02-09]
SU - Suspension/Chappe de LAS/IGS/SU_0200_007 (Avant Inf Avant Inf).igs
43.3 x 45.0 x 5.00 mm
