epsa-team/Vulcanix-v1.0/SU - Suspension/Chappe de LAS/IGS/SU_0300 (Arriere Sup)/SU_0300_011 (Arriere Sup Avant InfD).igs

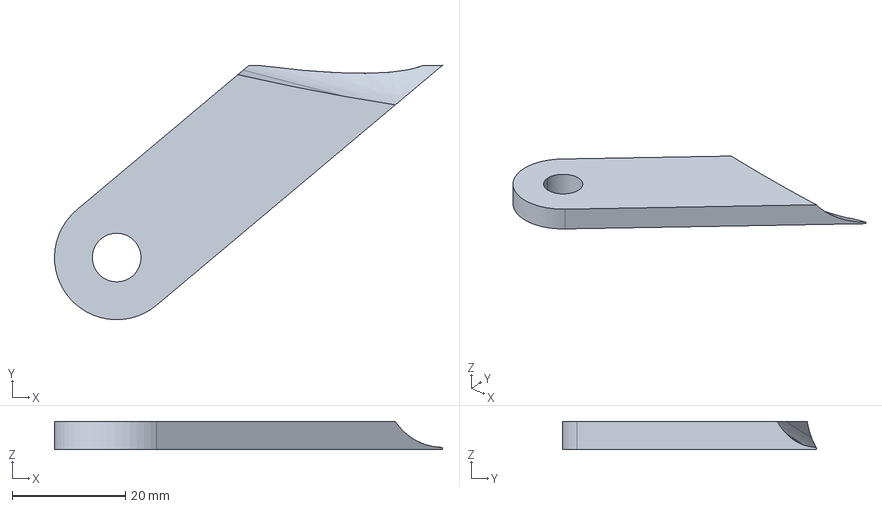
[picture p281: CAD file, 2018-03-05]
SU - Suspension/Chappe de LAS/IGS/SU_0300 (Arriere Sup)/SU_0300_011 (Arriere Sup Avant InfD).igs
68.6 x 45.0 x 5.00 mm
