epsa-team/Vulcanix-v1.0/SU - Suspension/Chappe de LAS/IGS/SU_0400 (Arriere Inf)/SU_0400_012 (Arriere Inf Avant SupD).igs

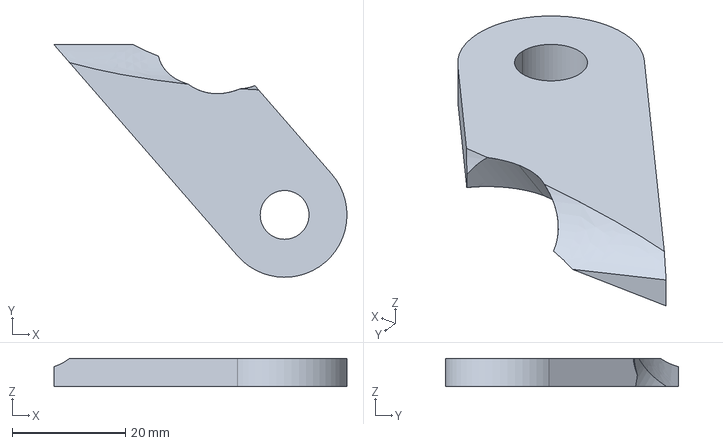
[picture p282: CAD file, 2018-03-05]
SU - Suspension/Chappe de LAS/IGS/SU_0400 (Arriere Inf)/SU_0400_012 (Arriere Inf Avant SupD).igs
51.7 x 41.0 x 5.00 mm
