epsa-team/Vulcanix-v1.0/SU - Suspension/Chappe de LAS/IGS/SU_0600 (Front Bell Crank)/SU_0600_004 (Front bell cranck arr).igs

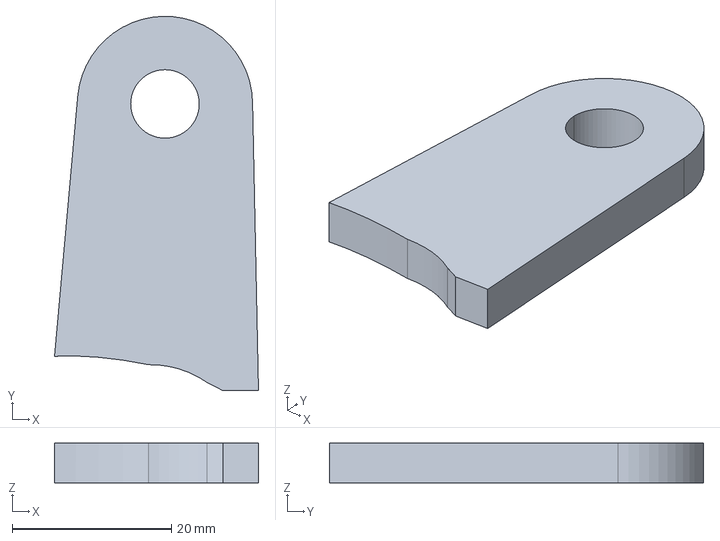
[picture p283: CAD file, 2018-05-24]
SU - Suspension/Chappe de LAS/IGS/SU_0600 (Front Bell Crank)/SU_0600_004 (Front bell cranck arr).igs
25.6 x 47.0 x 5.00 mm
