epsa-team/Vulcanix-v1.0/SU - Suspension/Chappe de LAS/IGS/SU_0800 (Rear Bell Cranck)/SU_0800_005_Bracket_Rear Bell CranckD.igs

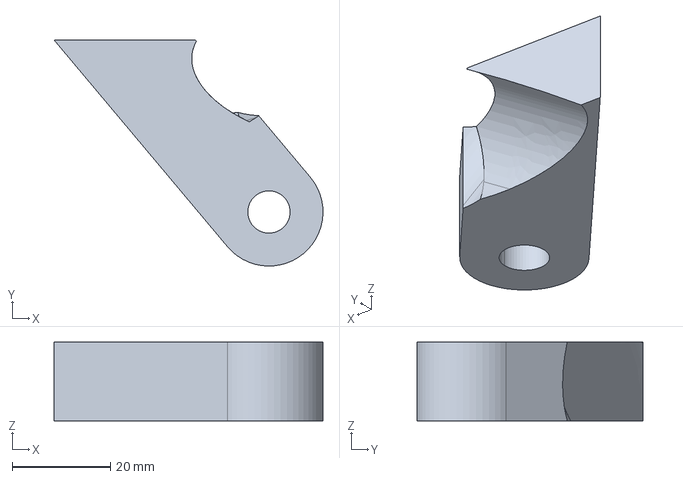
[picture p284: CAD file, 2018-05-24]
SU - Suspension/Chappe de LAS/IGS/SU_0800 (Rear Bell Cranck)/SU_0800_005_Bracket_Rear Bell CranckD.igs
54.7 x 46.0 x 16.0 mm
