epsa-team/Vulcanix-v1.0/SU - Suspension/Cost/07 - LASER CUT/Part4.DXF

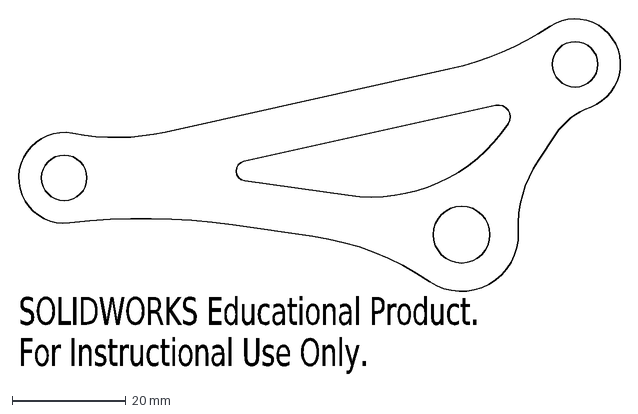
[picture p285: CAD file, 2017-12-07]
SU - Suspension/Cost/07 - LASER CUT/Part4.DXF
SOLIDWORKS Educational Product.
For Instructional Use Only.
