epsa-team/Vulcanix-v1.0/SU - Suspension/SU_A0100 (Upper front A-arms)/ins_avant_gauche_double.igs

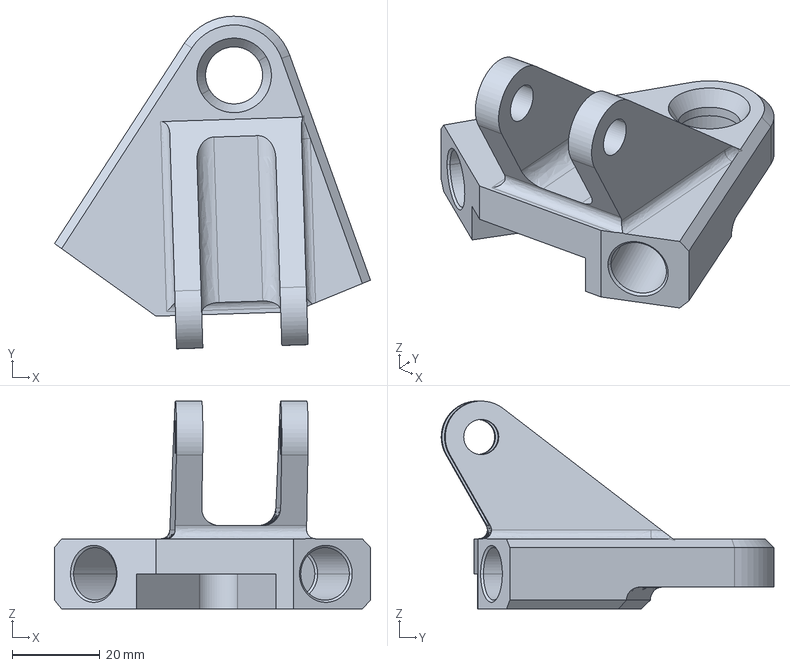
[picture p286: CAD file, 2018-01-11]
SU - Suspension/SU_A0100 (Upper front A-arms)/ins_avant_gauche_double.igs
72.0 x 75.8 x 47.4 mm
