epsa-team/Vulcanix-v1.0/SU - Suspension/SU_A1000 (Front Upright Assy)/Mises en plan/pour usinage/WT_0200_004 (Speed Sensor Spacer).igs

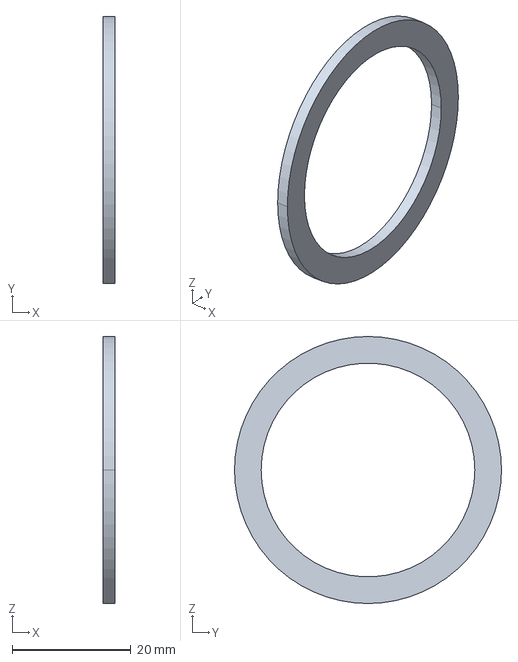
[picture p287: CAD file, 2018-02-08]
SU - Suspension/SU_A1000 (Front Upright Assy)/Mises en plan/pour usinage/WT_0200_004 (Speed Sensor Spacer).igs
2.00 x 45.0 x 45.0 mm
