epsa-team/Vulcanix-v1.0/SU - Suspension/SU_A1100 (Rear Upright Assy)/Mises en plan/pour usinage/fait/SU_1100_005 (Rear Speed Sensor Bracket).igs

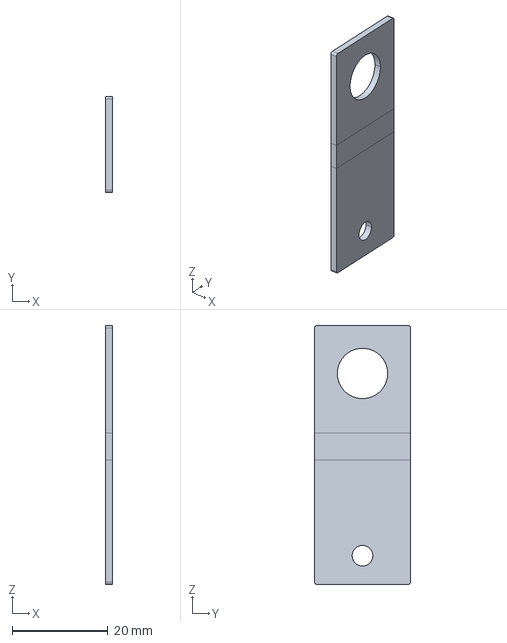
[picture p288: CAD file, 2018-01-31]
SU - Suspension/SU_A1100 (Rear Upright Assy)/Mises en plan/pour usinage/fait/SU_1100_005 (Rear Speed Sensor Bracket).igs
1.50 x 20.0 x 54.0 mm
