epsa-team/Vulcanix-v1.0/SU - Suspension/test en traction/piece pour EPSA/support.igs

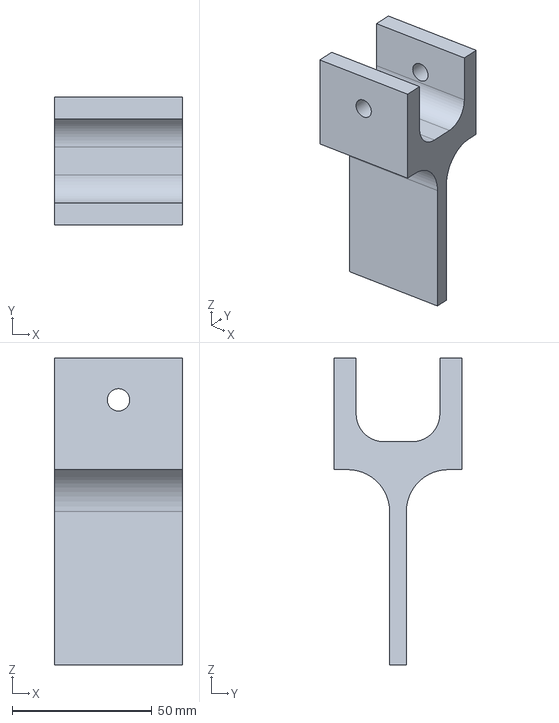
[picture p290: CAD file, 2017-12-05]
SU - Suspension/test en traction/piece pour EPSA/support.igs
46.0 x 46.0 x 110.0 mm
