epsa-team/Vulcanix-v1.0/visserie/M12/rondelle_M12.stp

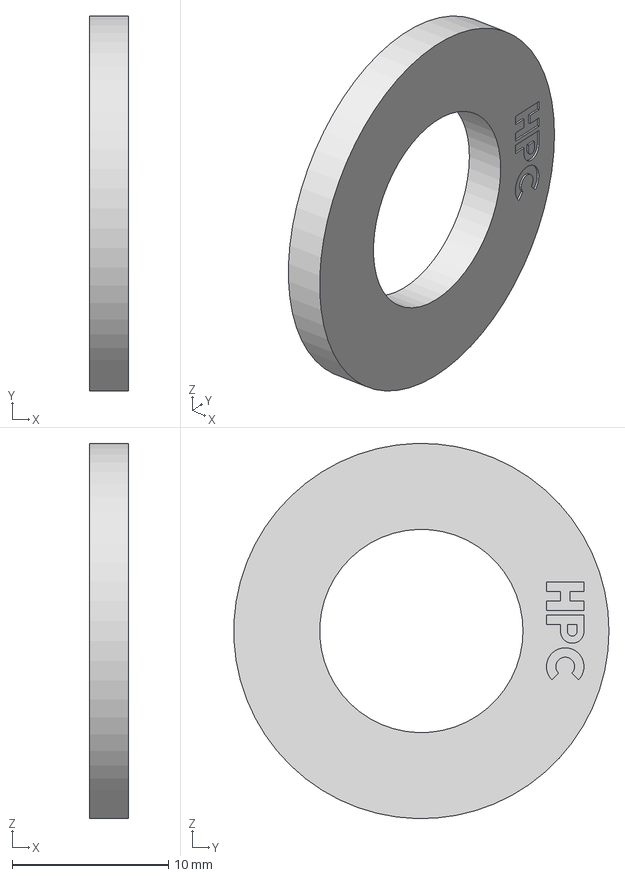
[picture p291: CAD file, 2017-12-09]
visserie/M12/rondelle_M12.stp
2.50 x 24.0 x 24.0 mm
