epsa-team/Vulcanix-v1.0/visserie/M4/HPC_HPCCHC412B/HPC_-_CHC4-12_B_2_14.stp

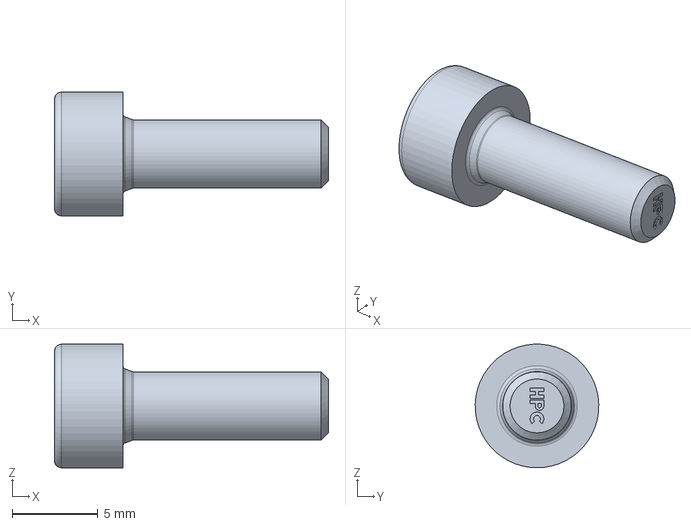
[picture p292: CAD file, 2017-12-09]
visserie/M4/HPC_HPCCHC412B/HPC_-_CHC4-12_B_2_14.stp
16.0 x 7.22 x 7.21 mm
