epsa-team/Vulcanix-v1.0/visserie/M6/Epaulé/31-520-6-40.stp

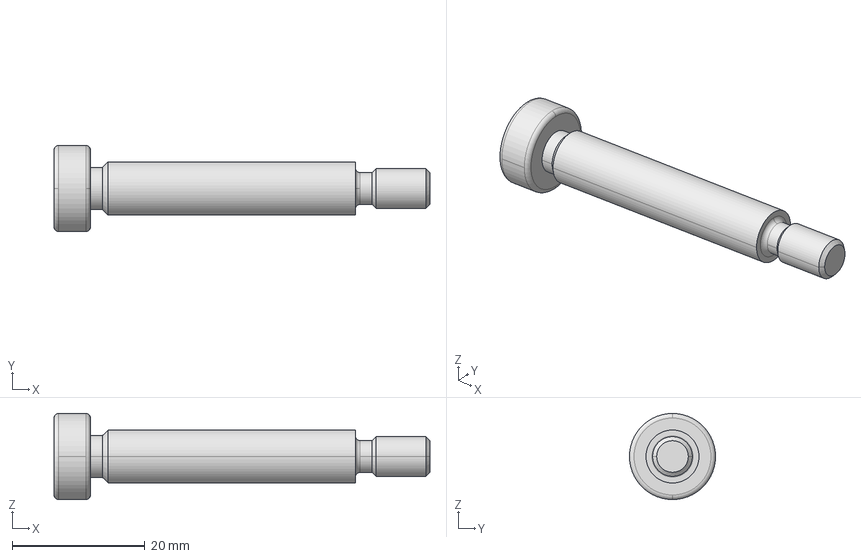
[picture p293: CAD file, 2018-01-09]
visserie/M6/Epaulé/31-520-6-40.stp
56.8 x 13.0 x 13.0 mm
