epsa-team/Vulcanix-v1.0/visserie/M6/vis_chc_M6_30.stp

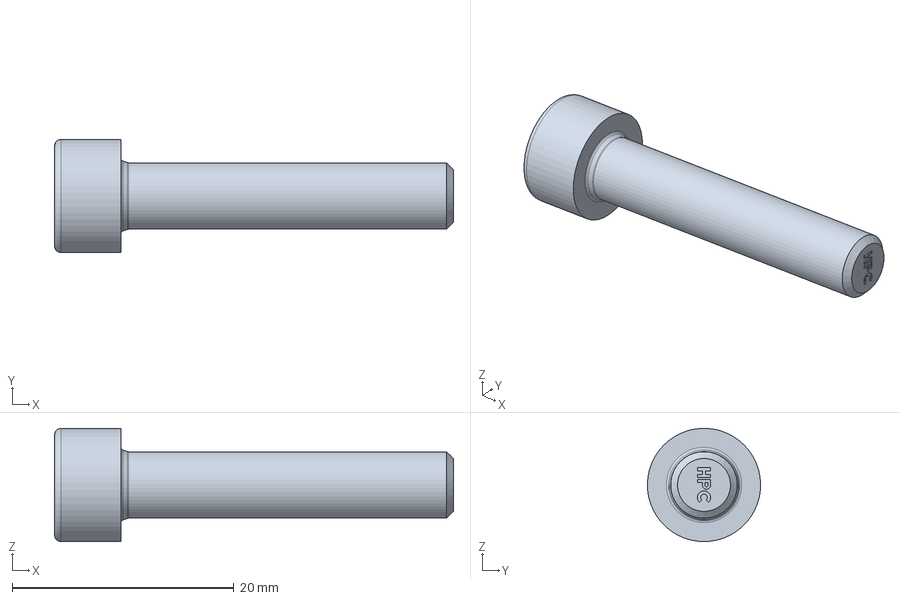
[picture p294: CAD file, 2017-12-09]
visserie/M6/vis_chc_M6_30.stp
36.0 x 10.2 x 10.2 mm
