epsa-team/Vulcanix-v1.0/visserie/M8/ecrou_M8_nilstop.stp

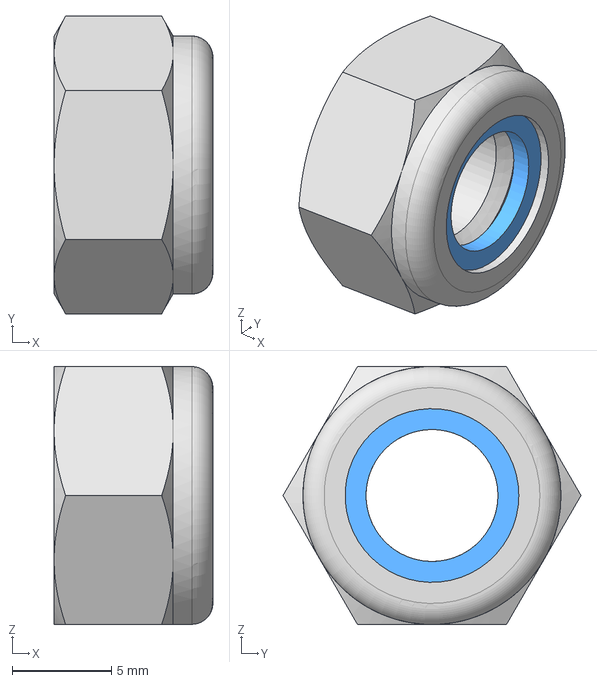
[picture p295: CAD file, 2017-12-09]
visserie/M8/ecrou_M8_nilstop.stp
8.00 x 15.0 x 13.0 mm
