epsa-team/Vulcanix-v1.0/visserie/M8/nouveau dossier/HPC_HPCFHC816SSB/HPC_-_FHC8-16_SS_B_2_14.stp

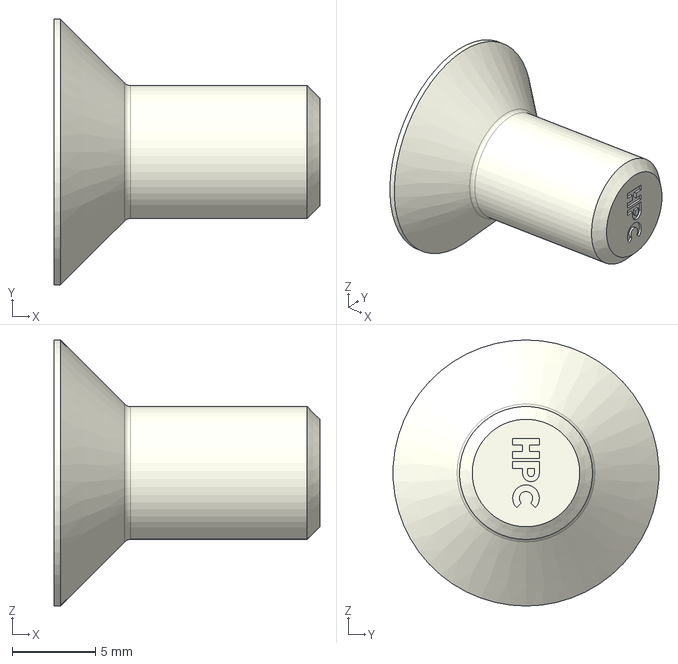
[picture p296: CAD file, 2017-12-09]
visserie/M8/nouveau dossier/HPC_HPCFHC816SSB/HPC_-_FHC8-16_SS_B_2_14.stp
16.0 x 16.0 x 16.0 mm
