epsa-team/Vulcanix-v1.0/ZZ - Autres/Chapes/1,5mm/23- appui de tete sup.igs

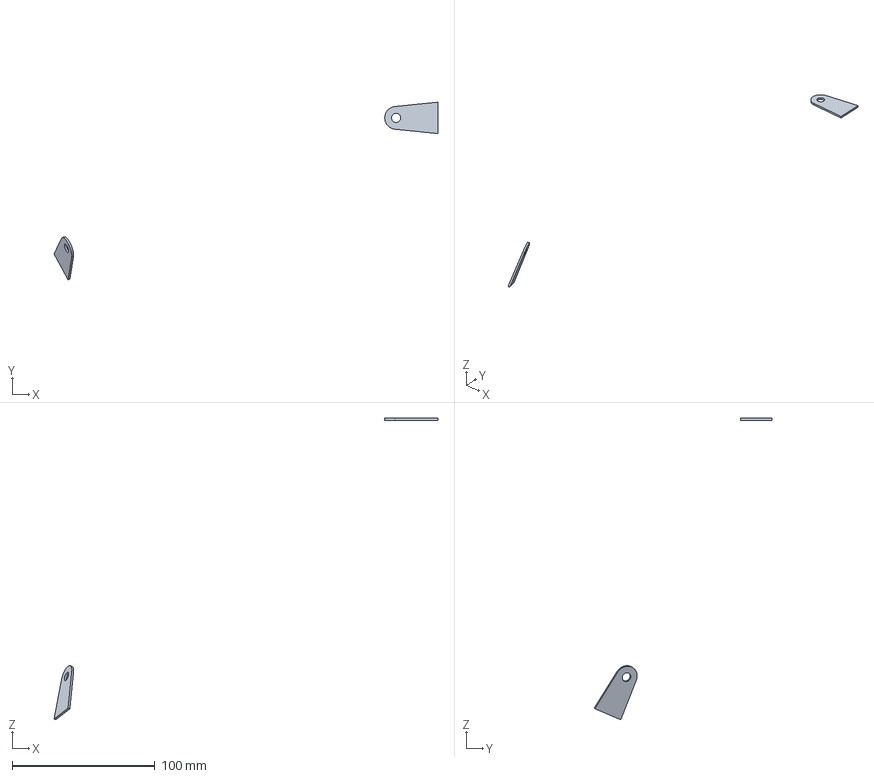
[picture p297: CAD file, 2018-01-09]
ZZ - Autres/Chapes/1,5mm/23- appui de tete sup.igs
268.7 x 124.3 x 211.0 mm
