epsa-team/Vulcanix-v1.0/ZZ - Autres/Chapes/1,5mm/IGS/Bracket_28_Universelle.igs

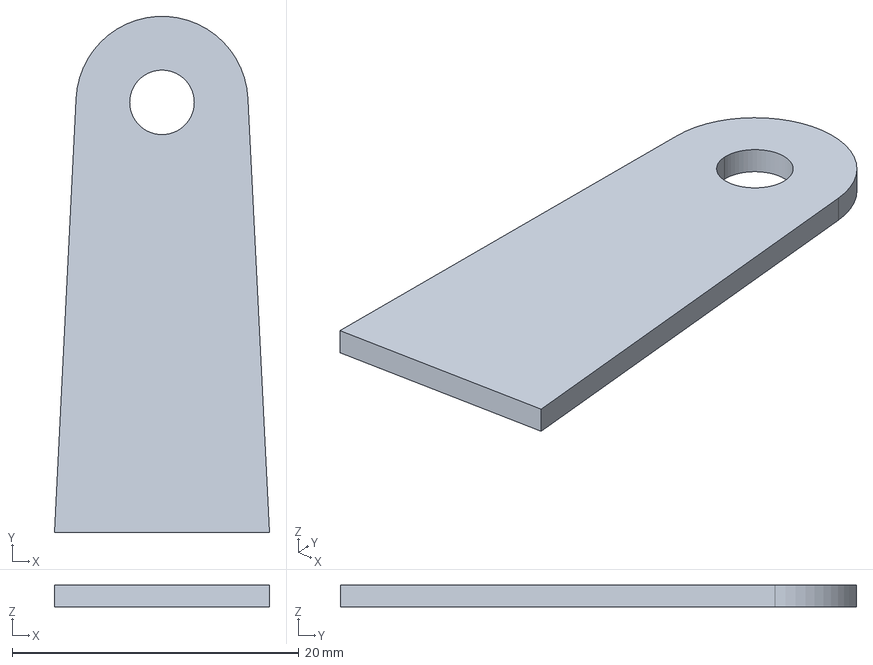
[picture p298: CAD file, 2018-03-24]
ZZ - Autres/Chapes/1,5mm/IGS/Bracket_28_Universelle.igs
15.0 x 36.0 x 1.50 mm
