epsa-team/Vulcanix-v1.0/ZZ - Autres/Chapes/3mm/Igs/Bracket_106_Chain shield sup.igs

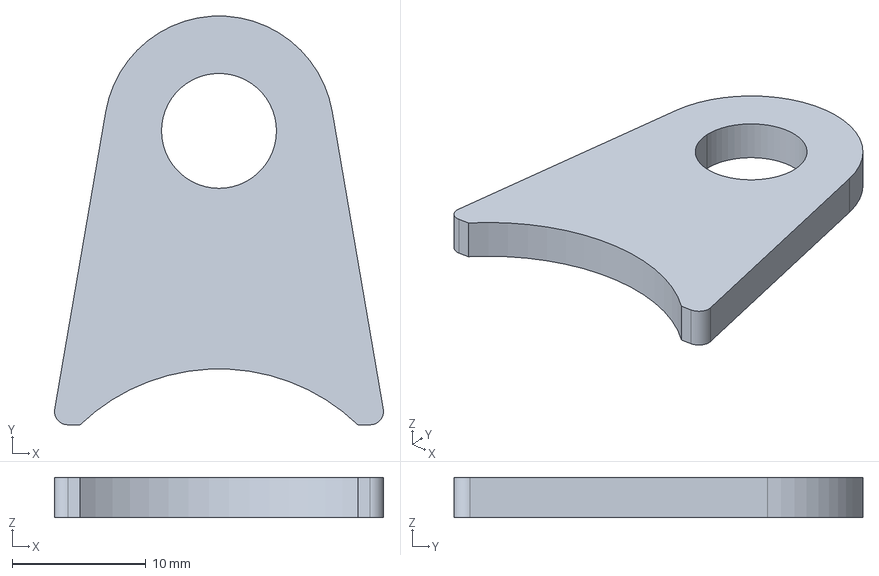
[picture p299: CAD file, 2018-02-25]
ZZ - Autres/Chapes/3mm/Igs/Bracket_106_Chain shield sup.igs
24.6 x 30.6 x 3.00 mm
