epsa-team/Vulcanix-v1.0/ZZ - Autres/Chapes/5mm/IGS/Bracket_201_Moteur.igs

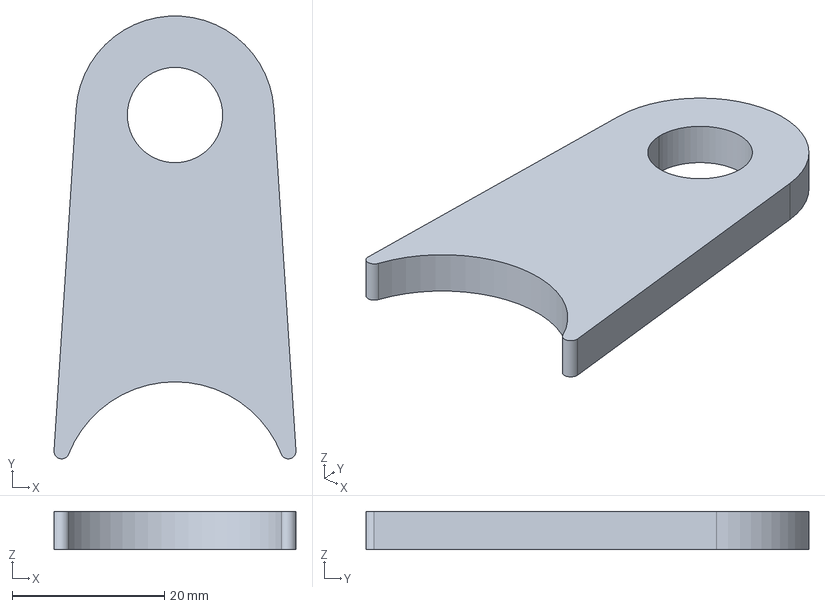
[picture p300: CAD file, 2018-02-25]
ZZ - Autres/Chapes/5mm/IGS/Bracket_201_Moteur.igs
31.7 x 58.1 x 5.00 mm
