epsa-team/Vulcanix-v1.0/ZZ - Autres/Chapes/Autres/poignee embrayage/18B_Bracket_304.igs

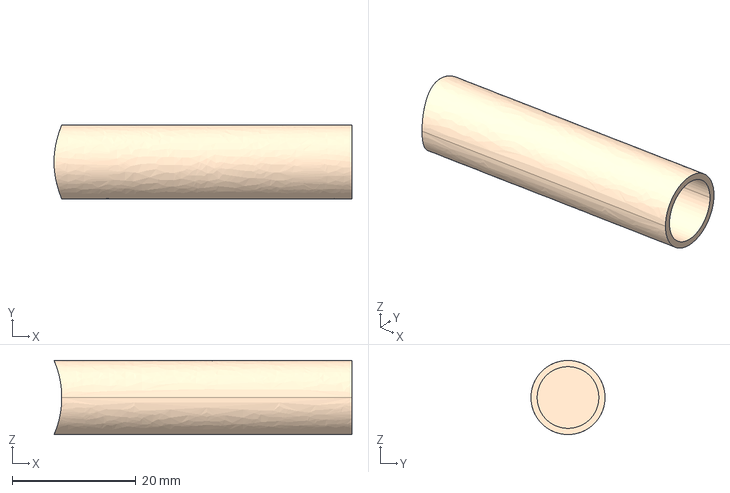
[picture p301: CAD file, 2018-01-10]
ZZ - Autres/Chapes/Autres/poignee embrayage/18B_Bracket_304.igs
48.3 x 12.0 x 12.0 mm
