epsa-team/Vulcanix-v1.0/ZZ - Autres/Chapes/Autres/Tube fixation moteur/Bracket_302_Tube fixation moteur.igs

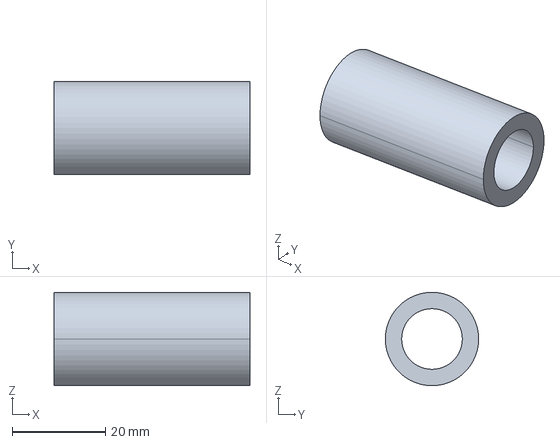
[picture p302: CAD file, 2018-03-07]
ZZ - Autres/Chapes/Autres/Tube fixation moteur/Bracket_302_Tube fixation moteur.igs
42.0 x 20.0 x 20.0 mm
