epsa-team/Vulcanix-v1.0/AA. Mise en plan/A verifier/AMS Expansion Tank/Radiateur Bracket.igs

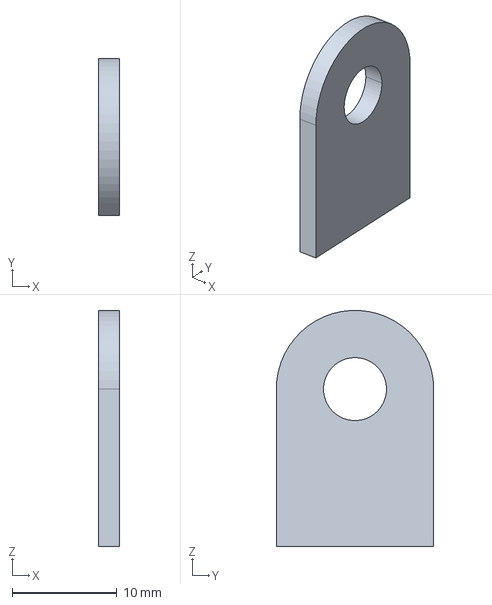
[picture p303: CAD file, 2018-03-11]
AA. Mise en plan/A verifier/AMS Expansion Tank/Radiateur Bracket.igs
2.00 x 15.0 x 22.5 mm
