epsa-team/Vulcanix-v1.0/AA. Mise en plan/A verifier/Benjamin Fond plat/FR_0400_002_BA.igs

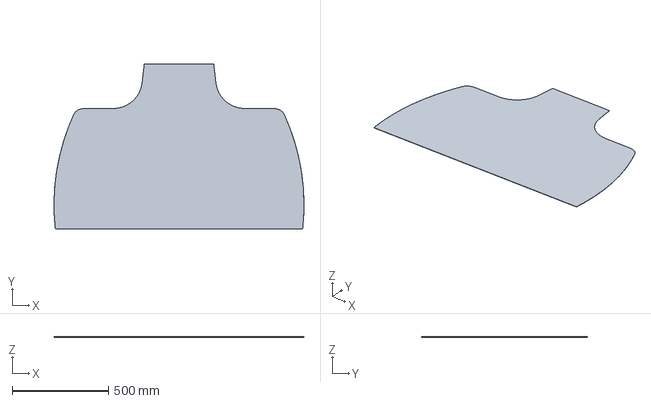
[picture p304: CAD file, 2018-06-12]
AA. Mise en plan/A verifier/Benjamin Fond plat/FR_0400_002_BA.igs
1296.4 x 857.4 x 1.50 mm
