epsa-team/Vulcanix-v1.0/AA. Mise en plan/A verifier/Benjamin Pare-feu V2/Firewall Bottom back.igs

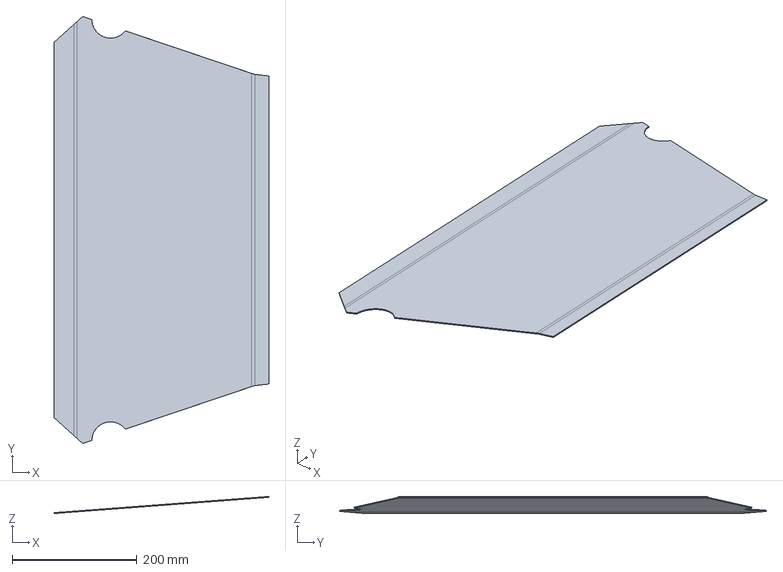
[picture p305: CAD file, 2018-06-12]
AA. Mise en plan/A verifier/Benjamin Pare-feu V2/Firewall Bottom back.igs
344.0 x 683.3 x 27.4 mm
