epsa-team/Vulcanix-v1.0/AA. Mise en plan/A verifier/Benjamin Pédalier/FR_0300_006_BA.igs

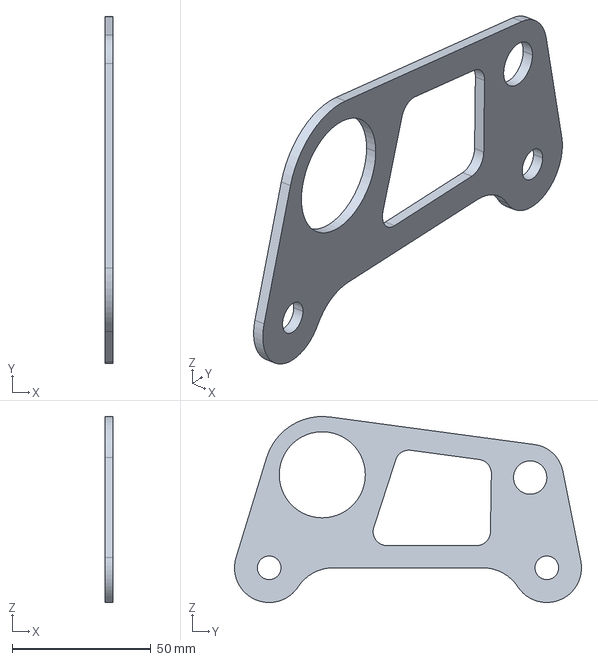
[picture p306: CAD file, 2018-02-25]
AA. Mise en plan/A verifier/Benjamin Pédalier/FR_0300_006_BA.igs
3.00 x 125.0 x 67.0 mm
