epsa-team/Vulcanix-v1.0/AA. Mise en plan/A verifier/Chainshield ADE/EN_1100_005.igs

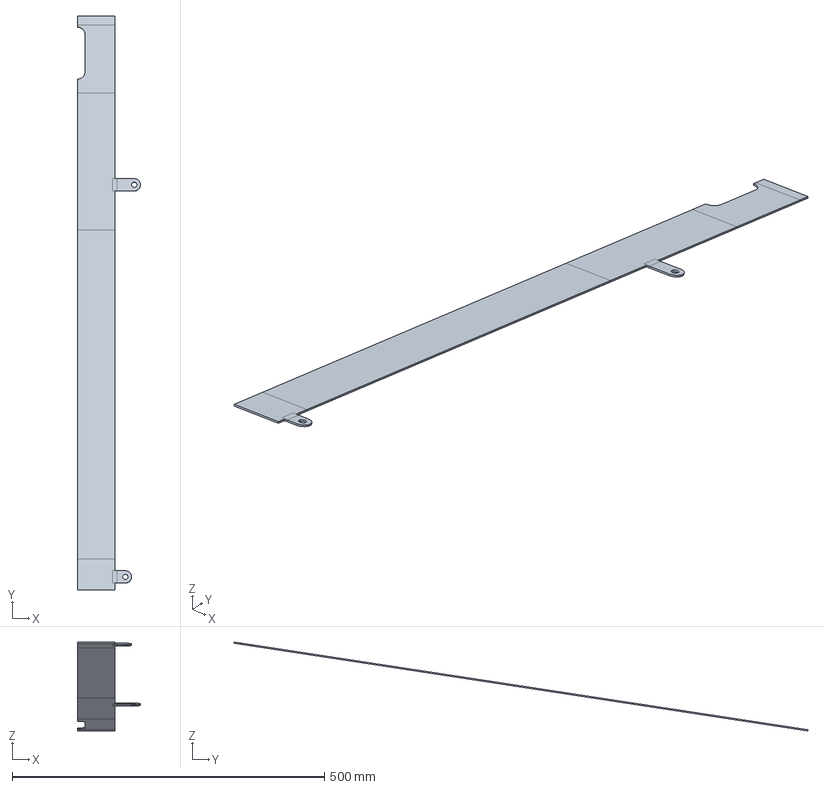
[picture p307: CAD file, 2018-03-11]
AA. Mise en plan/A verifier/Chainshield ADE/EN_1100_005.igs
100.8 x 919.7 x 142.5 mm
