epsa-team/Vulcanix-v1.0/AA. Mise en plan/A verifier/VBS/a verifier/cache_cremaillere_plie.igs

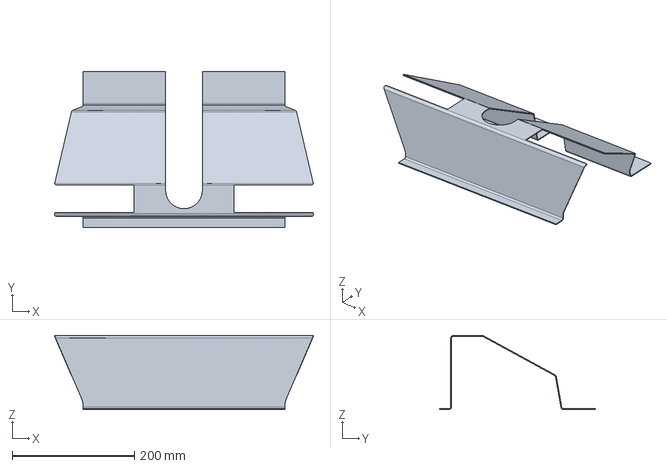
[picture p308: CAD file, 2018-06-25]
AA. Mise en plan/A verifier/VBS/a verifier/cache_cremaillere_plie.igs
424.1 x 256.0 x 121.5 mm
