epsa-team/Vulcanix-v1.0/AA. Mise en plan/suivi commande/Alpentech/Insert_PM_Lower_Front.stp

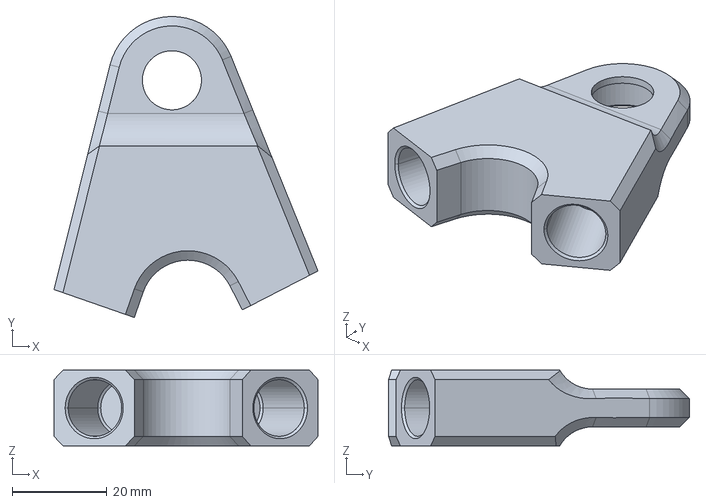
[picture p309: CAD file, 2018-03-12]
AA. Mise en plan/suivi commande/Alpentech/Insert_PM_Lower_Front.stp
55.8 x 63.7 x 16.0 mm
