epsa-team/Vulcanix-v1.0/AA. Mise en plan/Verifie/Prod Boisard/Direction/ST_0600_002 (Bloc serrage cremaillere).igs

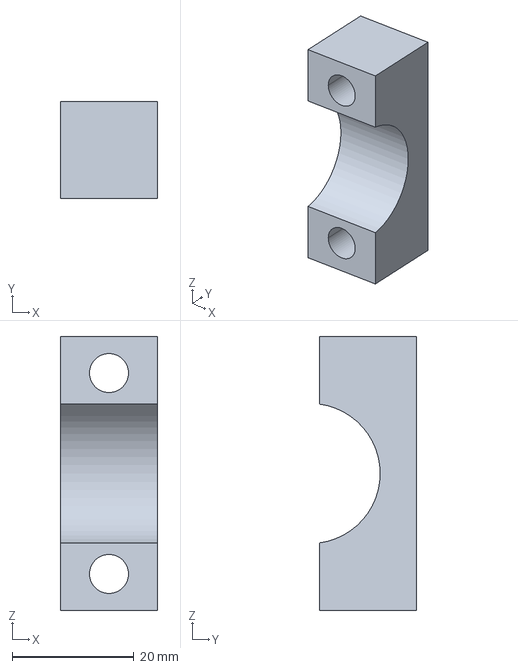
[picture p310: CAD file, 2018-03-11]
AA. Mise en plan/Verifie/Prod Boisard/Direction/ST_0600_002 (Bloc serrage cremaillere).igs
16.0 x 16.0 x 45.0 mm
