epsa-team/Vulcanix-v1.0/AA. Mise en plan/Verifie/Prod Boisard/Roues équipés/Coordonnées portes-moyeux/Porte moyeu avant usinage.SLDPRT

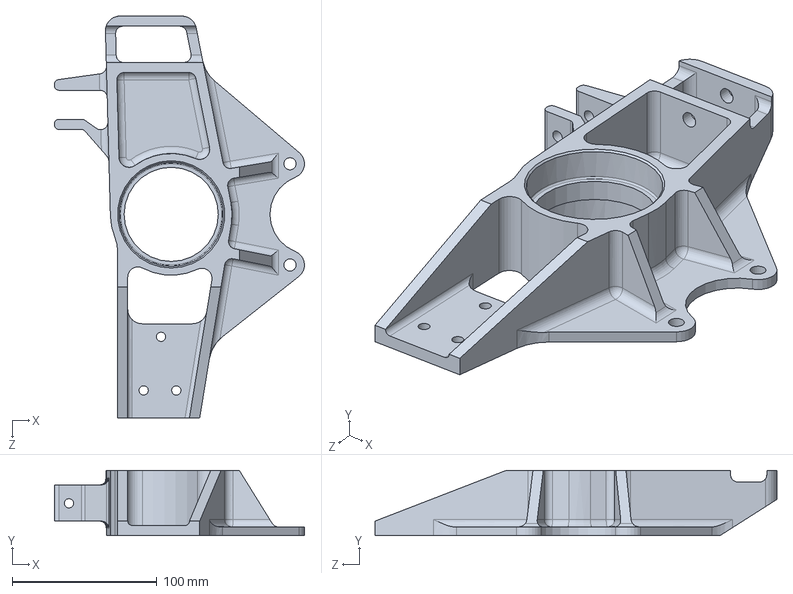
[picture p311: CAD file, 2018-05-24]
AA. Mise en plan/Verifie/Prod Boisard/Roues équipés/Coordonnées portes-moyeux/Porte moyeu avant usinage.SLDPRT
172.5 x 45.0 x 277.4 mm
