epsa-team/Vulcanix-v1.0/AA. Mise en plan/Verifie/Prod Boisard/Roues équipés/SU_1000_003 (Upper Arm Bracket).igs

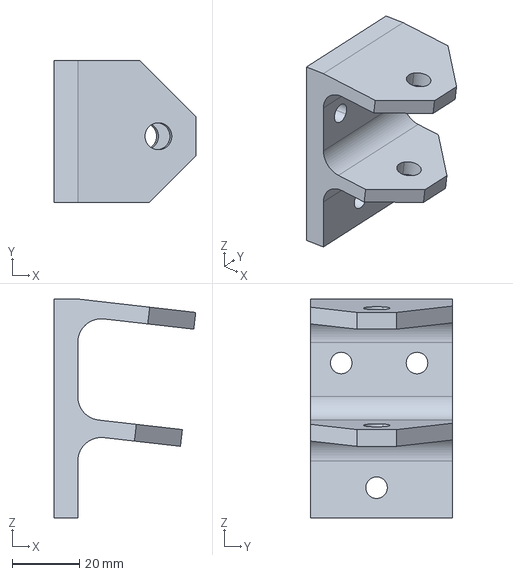
[picture p312: CAD file, 2018-02-06]
AA. Mise en plan/Verifie/Prod Boisard/Roues équipés/SU_1000_003 (Upper Arm Bracket).igs
42.0 x 42.0 x 65.0 mm
