epsa-team/Vulcanix-v1.0/AA. Mise en plan/Verifie/Prod Boisard/Transmission secondaire/EN_0900_007_AA (Porte excentrique droit).igs

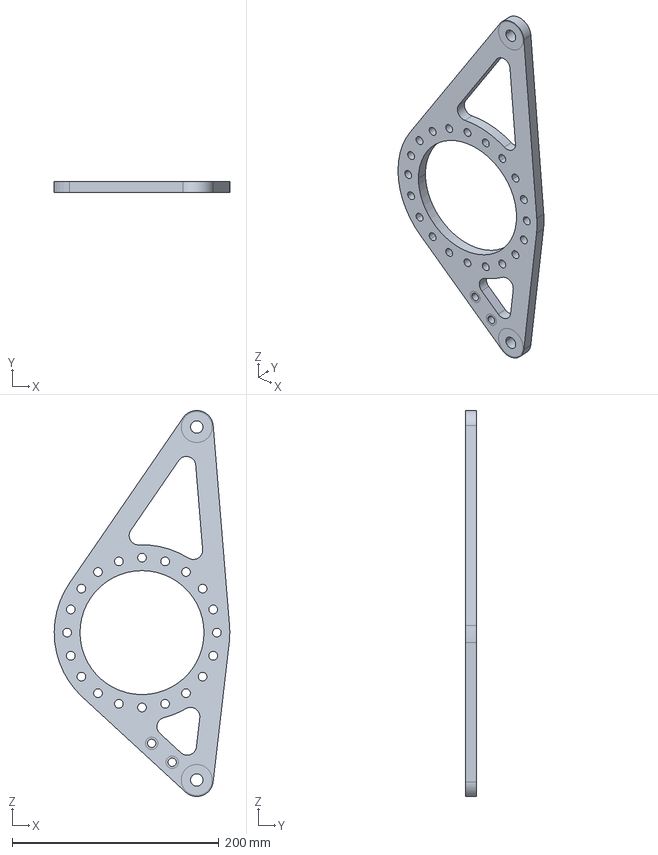
[picture p313: CAD file, 2018-03-11]
AA. Mise en plan/Verifie/Prod Boisard/Transmission secondaire/EN_0900_007_AA (Porte excentrique droit).igs
170.0 x 11.0 x 373.7 mm
