epsa-team/Vulcanix-v1.0/EN - Engine & Powertrain/Carter d'huile/mise en plan/Carter.igs

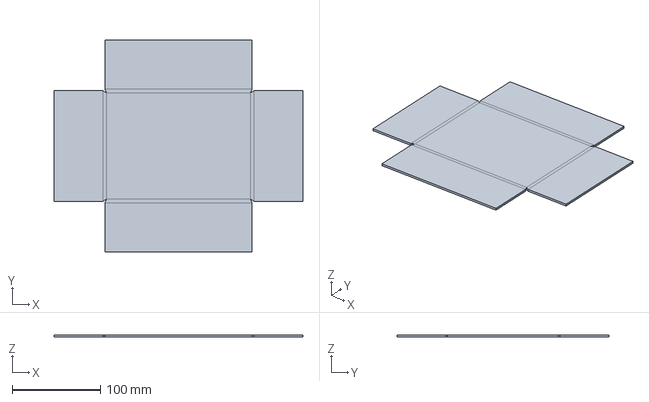
[picture p314: CAD file, 2018-03-11]
EN - Engine & Powertrain/Carter d'huile/mise en plan/Carter.igs
282.7 x 240.1 x 2.50 mm
