epsa-team/Vulcanix-v1.0/EN - Engine & Powertrain/Carter d'huile/Plan_joint_carter.dxf

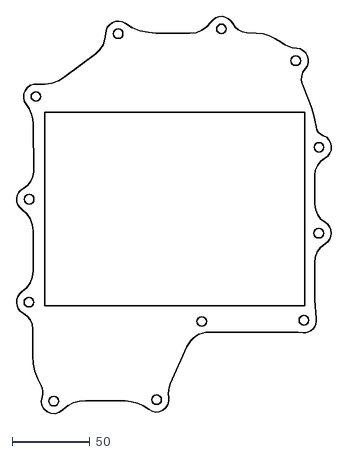
[picture p315: CAD file, 2018-03-07]
EN - Engine & Powertrain/Carter d'huile/Plan_joint_carter.dxf
202.6 x 256.0
