epsa-team/Vulcanix-v1.0/EN - Engine & Powertrain/carter/carter_v7.2/cloison_longi.igs

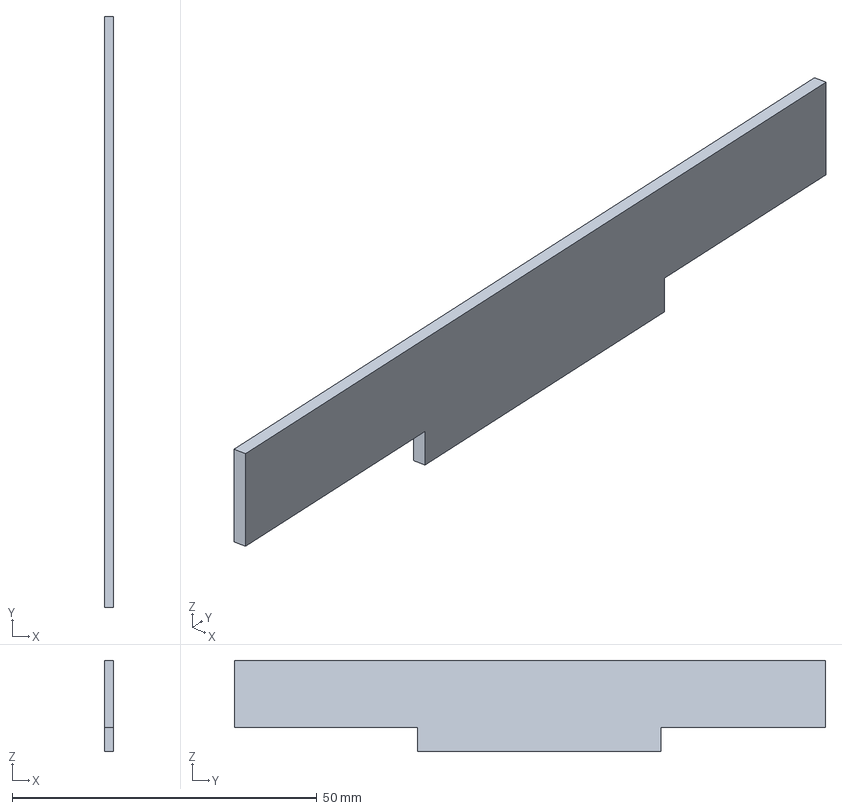
[picture p316: CAD file, 2017-12-11]
EN - Engine & Powertrain/carter/carter_v7.2/cloison_longi.igs
1.50 x 97.0 x 15.0 mm
