epsa-team/Vulcanix-v1.0/EN - Engine & Powertrain/EN_A0300 (Air intake)/Fichiers ARRK/Tubulures d'admission.stp

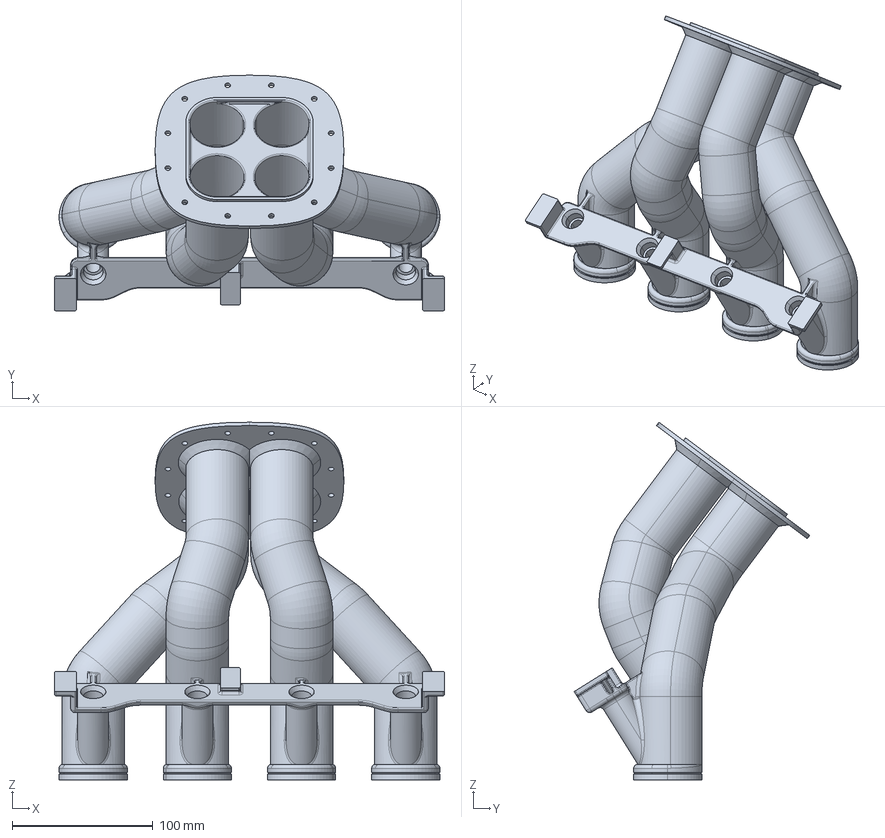
[picture p317: CAD file, 2018-02-07]
EN - Engine & Powertrain/EN_A0300 (Air intake)/Fichiers ARRK/Tubulures d'admission.stp
277.0 x 167.4 x 254.0 mm
