epsa-team/Vulcanix-v1.0/EN - Engine & Powertrain/EN_A0900 (Differential Assy)/mise en plan/EN_0900_004.igs

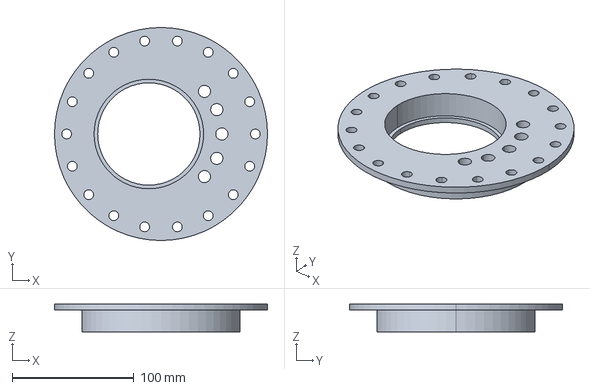
[picture p319: CAD file, 2018-02-04]
EN - Engine & Powertrain/EN_A0900 (Differential Assy)/mise en plan/EN_0900_004.igs
175.0 x 175.0 x 23.0 mm
