epsa-team/Vulcanix-v1.0/FR - Frame & Body/FR_A0100 (Frame)/Firewall V2/igs/Firewall Bottom side.igs

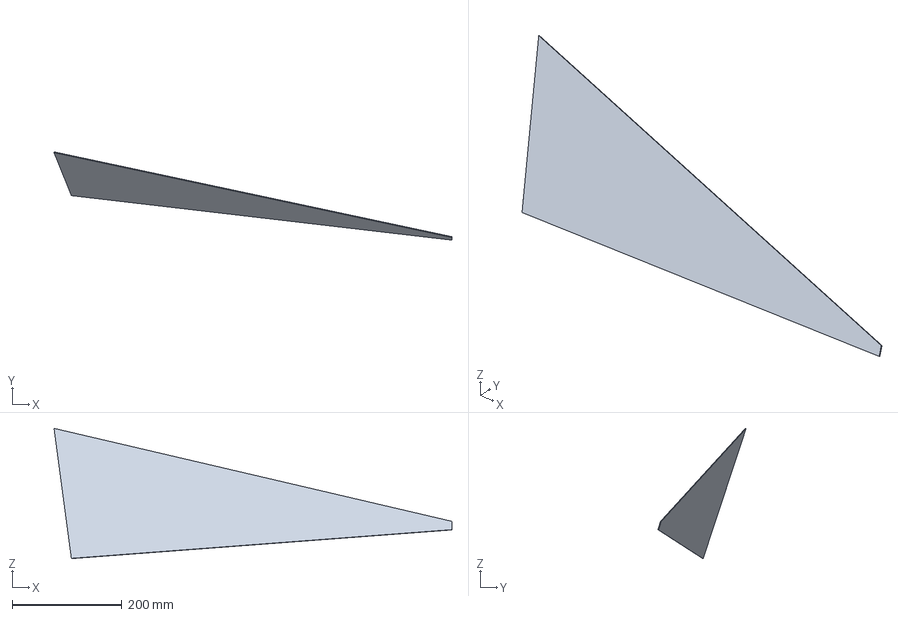
[picture p320: CAD file, 2018-06-12]
FR - Frame & Body/FR_A0100 (Frame)/Firewall V2/igs/Firewall Bottom side.igs
726.6 x 161.1 x 237.8 mm
