epsa-team/Vulcanix-v1.0/FR - Frame & Body/FR_A0100 (Frame)/Mise en plan Firewall/Firewall up.igs

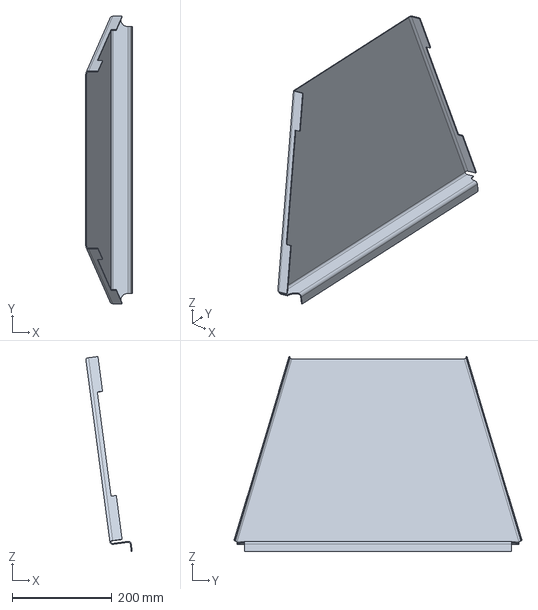
[picture p321: CAD file, 2018-01-31]
FR - Frame & Body/FR_A0100 (Frame)/Mise en plan Firewall/Firewall up.igs
93.3 x 577.0 x 391.3 mm
