epsa-team/Vulcanix-v1.0/FR - Frame & Body/FR_A0100 (Frame)/Prod/37.stp

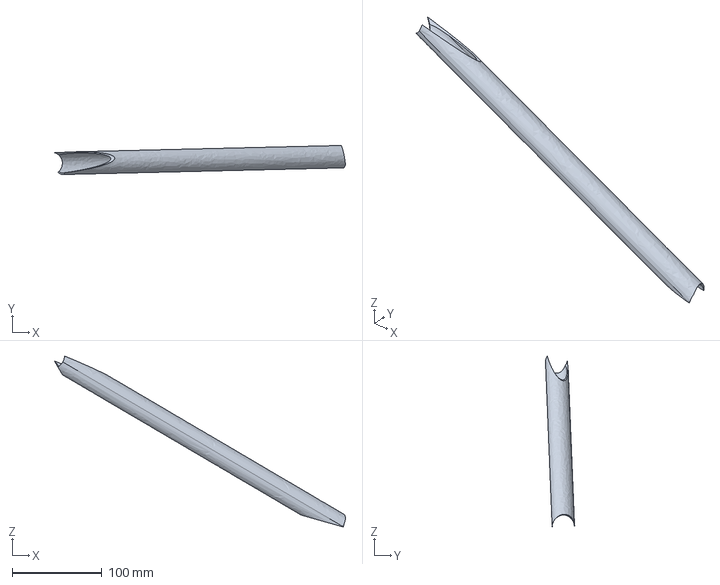
[picture p322: CAD file, 2018-02-08]
FR - Frame & Body/FR_A0100 (Frame)/Prod/37.stp
323.8 x 32.4 x 190.3 mm
