epsa-team/Vulcanix-v1.0/FR - Frame & Body/FR_A0100 (Frame)/Prod/Tubes step/nouveau nom/15x1.5repare/SU_0510_003_2.stp

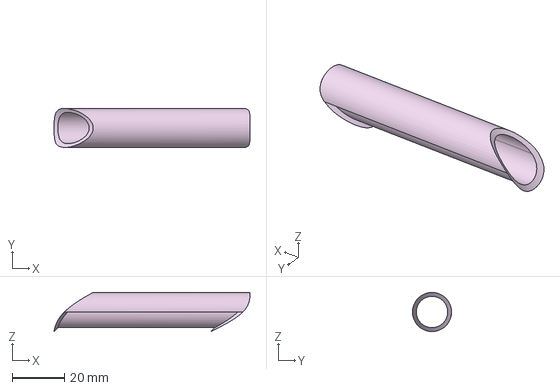
[picture p323: CAD file, 2018-02-08]
FR - Frame & Body/FR_A0100 (Frame)/Prod/Tubes step/nouveau nom/15x1.5repare/SU_0510_003_2.stp
75.1 x 15.0 x 15.0 mm
