epsa-team/Vulcanix-v1.0/FR - Frame & Body/FR_A0100 (Frame)/Prod/Tubes step/nouveau nom/201 biseau.stp

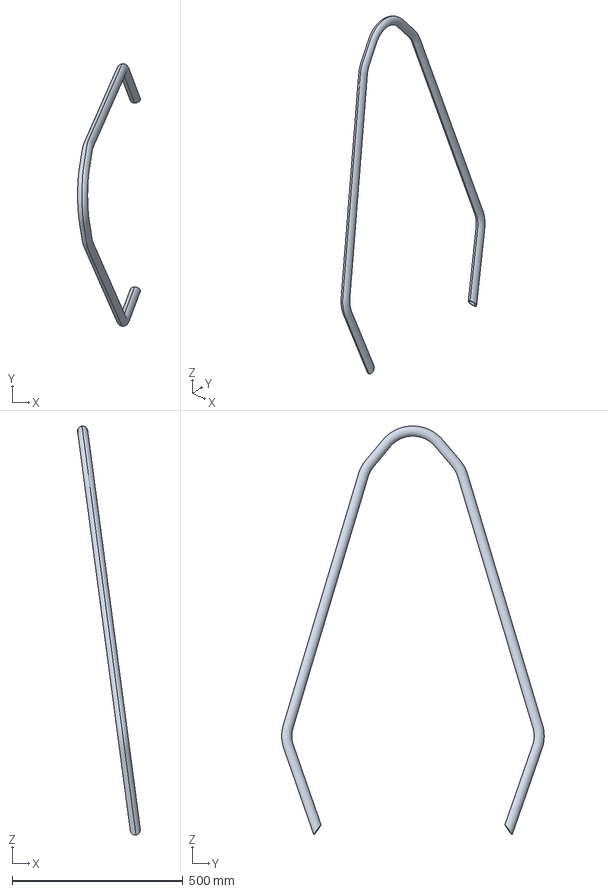
[picture p324: CAD file, 2018-01-17]
FR - Frame & Body/FR_A0100 (Frame)/Prod/Tubes step/nouveau nom/201 biseau.stp
184.1 x 769.9 x 1198.9 mm
