epsa-team/Vulcanix-v1.0/FR - Frame & Body/FR_A0100 (Frame)/Prod/Tubes step/nouveau nom/20x1.5repare/107.stp

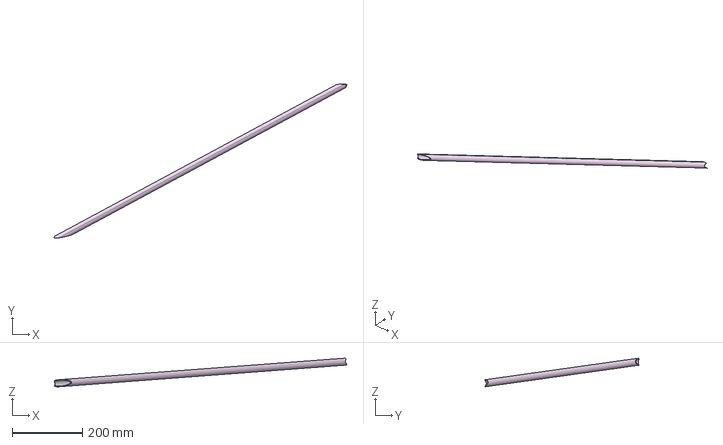
[picture p325: CAD file, 2018-02-08]
FR - Frame & Body/FR_A0100 (Frame)/Prod/Tubes step/nouveau nom/20x1.5repare/107.stp
831.5 x 437.1 x 81.2 mm
