epsa-team/Vulcanix-v1.0/FR - Frame & Body/FR_A0100 (Frame)/Prod/Tubes step/nouveau nom/30x1.5/111.stp

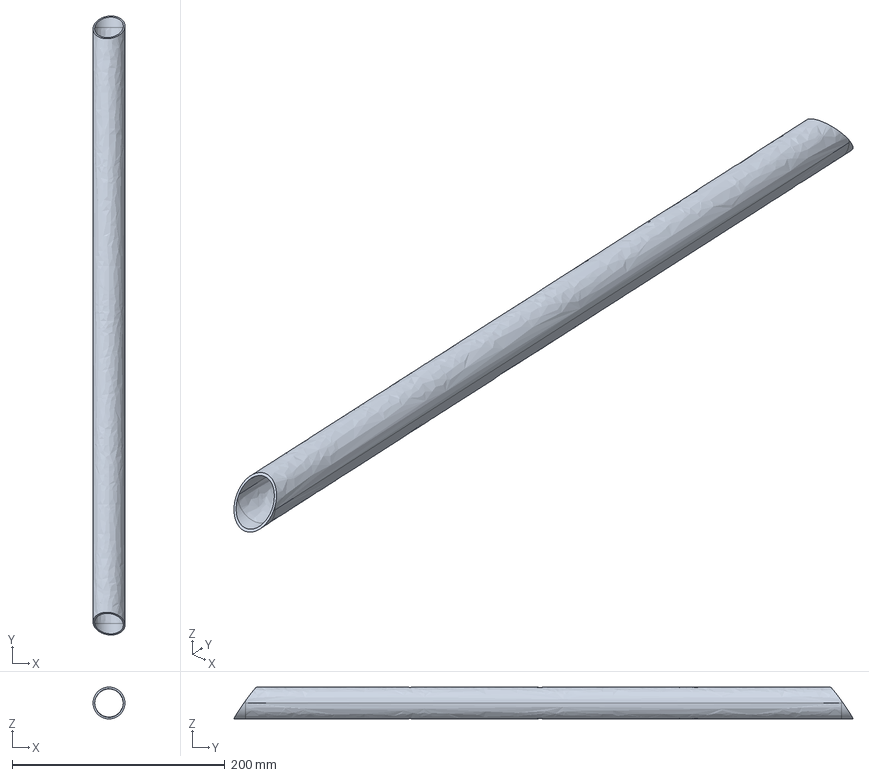
[picture p326: CAD file, 2018-01-17]
FR - Frame & Body/FR_A0100 (Frame)/Prod/Tubes step/nouveau nom/30x1.5/111.stp
30.0 x 581.4 x 30.0 mm
