epsa-team/Vulcanix-v1.0/FR - Frame & Body/FR_A0100 (Frame)/Prod/Tubes step/nouveau nom/30x1.5repare/24.stp

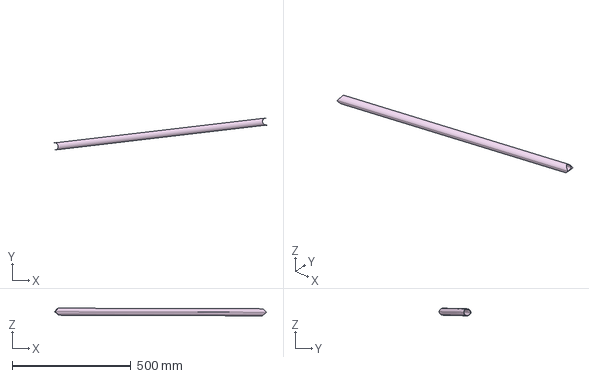
[picture p327: CAD file, 2018-02-08]
FR - Frame & Body/FR_A0100 (Frame)/Prod/Tubes step/nouveau nom/30x1.5repare/24.stp
894.5 x 134.6 x 32.6 mm
