epsa-team/Vulcanix-v1.0/FR - Frame & Body/FR_A0100 (Frame)/Prod/Tubes step/nouveau nom/Tube step EPSA v3.0/15x1.5repare/62.stp

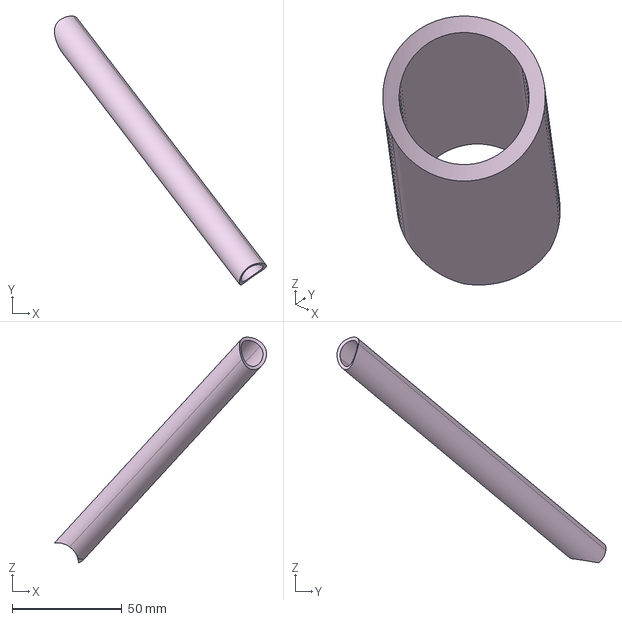
[picture p328: CAD file, 2018-02-08]
FR - Frame & Body/FR_A0100 (Frame)/Prod/Tubes step/nouveau nom/Tube step EPSA v3.0/15x1.5repare/62.stp
96.7 x 122.6 x 102.9 mm
