epsa-team/Vulcanix-v1.0/FR - Frame & Body/FR_A0300 (Pedal Assy)/Mise en plan/1 Usinage/FR_0300_001_BA.igs

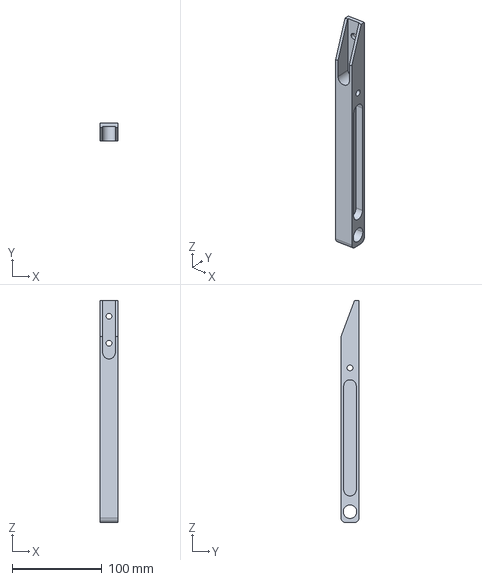
[picture p332: CAD file, 2018-02-04]
FR - Frame & Body/FR_A0300 (Pedal Assy)/Mise en plan/1 Usinage/FR_0300_001_BA.igs
20.0 x 20.0 x 247.0 mm
