epsa-team/Vulcanix-v1.0/FR - Frame & Body/FR_A0300 (Pedal Assy)/Mise en plan/2 Decoupe laser et pliage/FR_0300_004_BA.igs

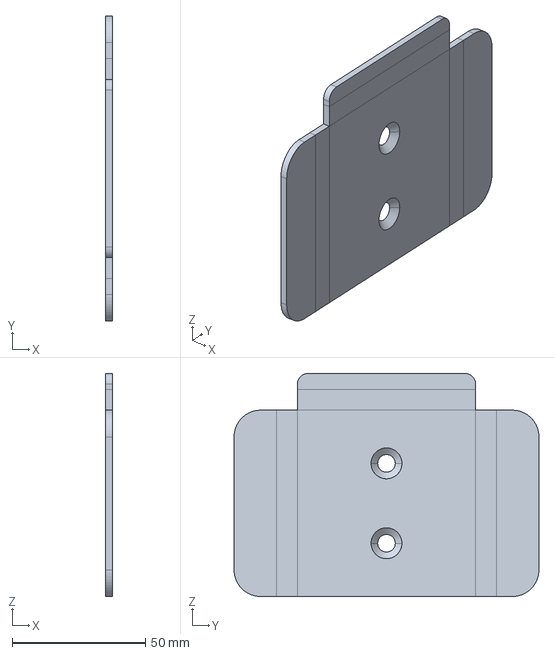
[picture p333: CAD file, 2018-03-11]
FR - Frame & Body/FR_A0300 (Pedal Assy)/Mise en plan/2 Decoupe laser et pliage/FR_0300_004_BA.igs
2.50 x 114.5 x 83.8 mm
