epsa-team/Vulcanix-v1.0/FR - Frame & Body/FR_A0700 (Body)/Fichiers step/Ouies droite et gauche.stp

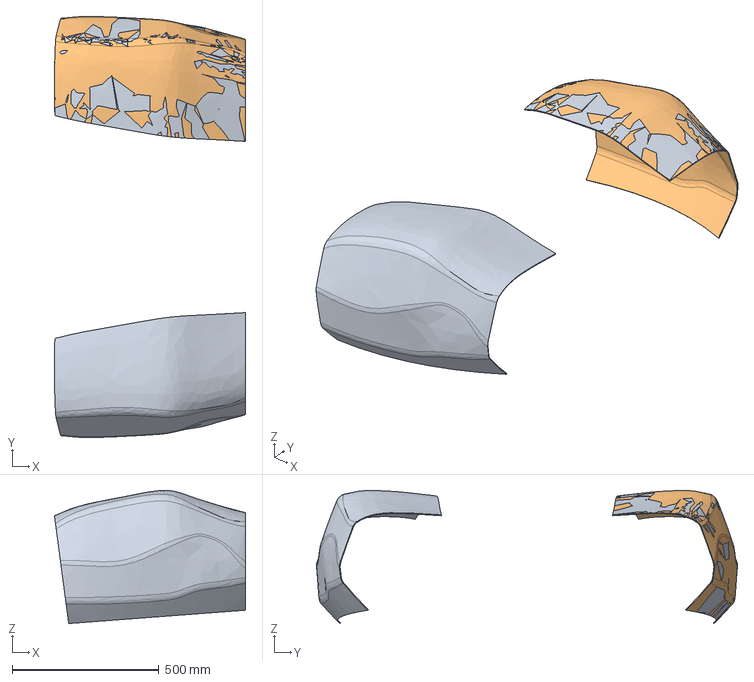
[picture p334: CAD file, 2018-03-26]
FR - Frame & Body/FR_A0700 (Body)/Fichiers step/Ouies droite et gauche.stp
651.5 x 1435.4 x 453.8 mm
