epsa-team/Vulcanix-v1.0/ST - Steering System/ST_A0700 (Steering shaft pivot)/BEARING SKF/HPC - G1-A-16_16 (0°).stp

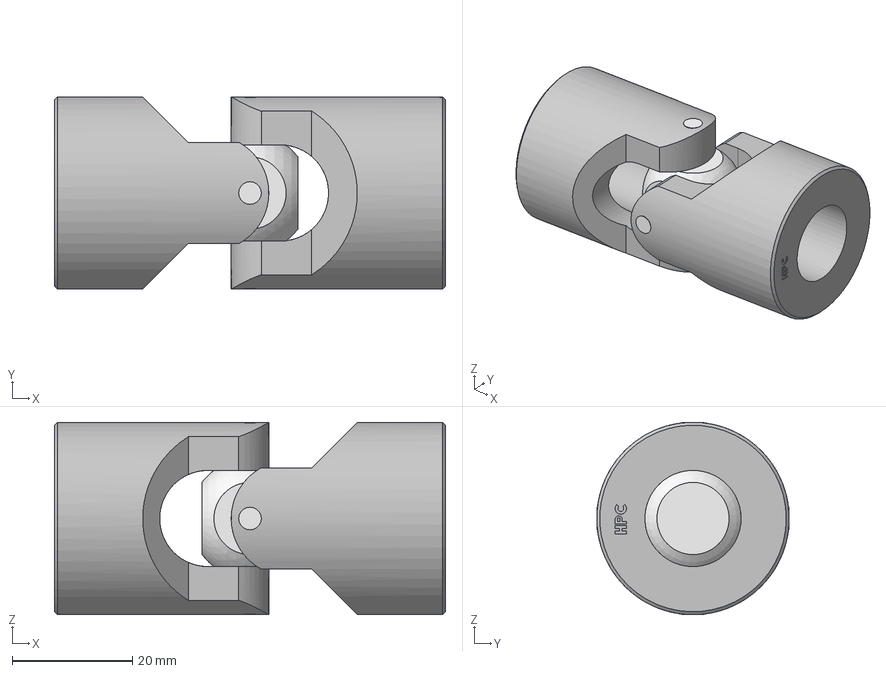
[picture p335: CAD file, 2017-12-05]
ST - Steering System/ST_A0700 (Steering shaft pivot)/BEARING SKF/HPC - G1-A-16_16 (0°).stp
65.0 x 32.0 x 32.0 mm
_HPC - G1-A-16/16 - Fork2
_hpc_G1-A-16/162
_HPC - G1-A-16/16 - Fork1
