epsa-team/Vulcanix-v1.0/SU - Suspension/04 - 3D Printing/UM2_Rear Left Upright.3mf

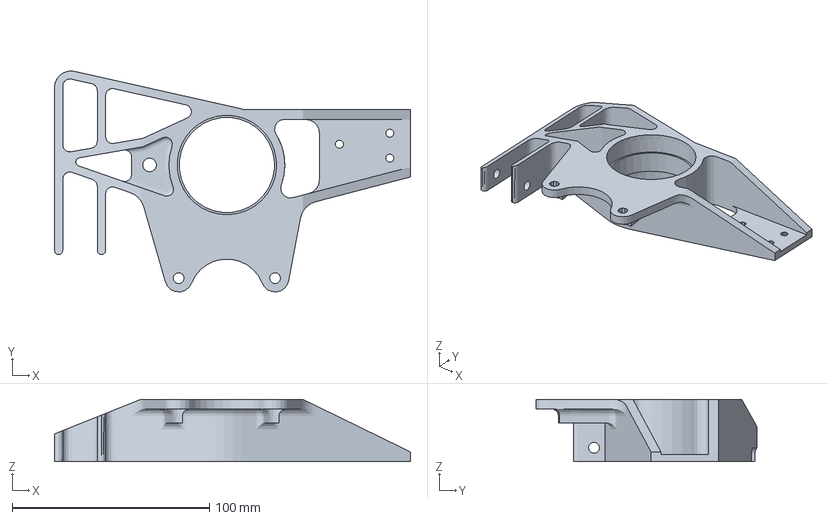
[picture p336: CAD file, 2017-12-07]
SU - Suspension/04 - 3D Printing/UM2_Rear Left Upright.3mf
180.5 x 112.0 x 31.5 mm
