epsa-team/Vulcanix-v1.0/SU - Suspension/Chappe de LAS/Chape Liason au Sol EPSA/SU_0100 (Avant Sup)/IGS/SU_0100_010 (Avant Sup Arriere Sup).igs

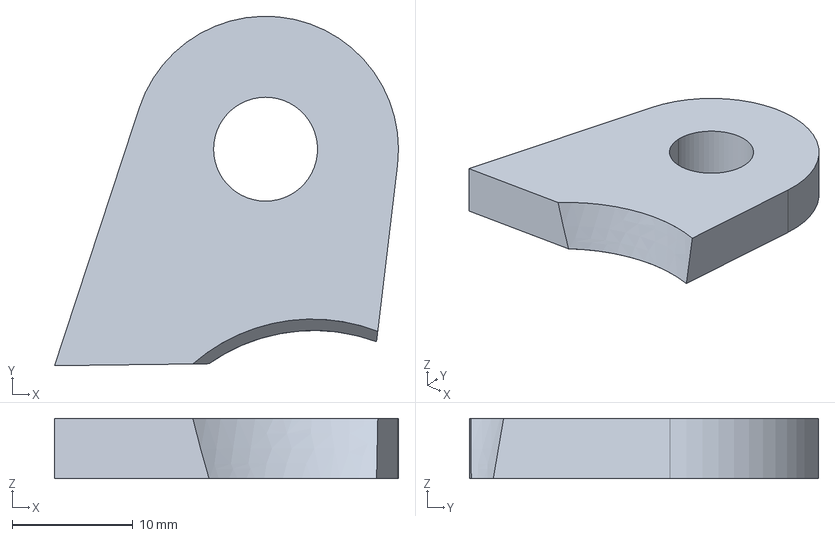
[picture p337: CAD file, 2018-02-12]
SU - Suspension/Chappe de LAS/Chape Liason au Sol EPSA/SU_0100 (Avant Sup)/IGS/SU_0100_010 (Avant Sup Arriere Sup).igs
28.5 x 28.9 x 5.00 mm
