epsa-team/Vulcanix-v1.0/SU - Suspension/Chappe de LAS/Chape Liason au Sol EPSA/SU_0200 (Avant Inf)/IGS/SU_0200_010 (Avant inf Arriere Sup).igs

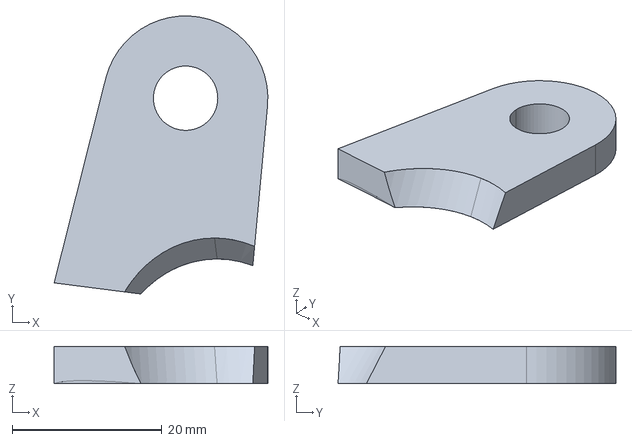
[picture p338: CAD file, 2018-02-12]
SU - Suspension/Chappe de LAS/Chape Liason au Sol EPSA/SU_0200 (Avant Inf)/IGS/SU_0200_010 (Avant inf Arriere Sup).igs
28.6 x 37.2 x 5.00 mm
