epsa-team/Vulcanix-v1.0/SU - Suspension/Chappe de LAS/IGS/SU_0100 (Avant Sup)/SU_0100_011 (Avant Sup Avant InfD).igs

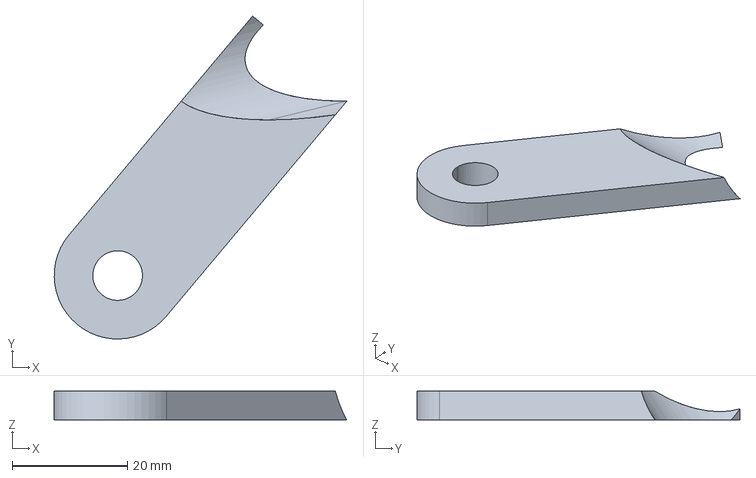
[picture p339: CAD file, 2018-03-05]
SU - Suspension/Chappe de LAS/IGS/SU_0100 (Avant Sup)/SU_0100_011 (Avant Sup Avant InfD).igs
50.7 x 56.0 x 5.00 mm
