epsa-team/Vulcanix-v1.0/SU - Suspension/Chappe de LAS/IGS/SU_0200 (Avant Inf)/SU_0200_012 (Avant Inf Avant SupD).igs

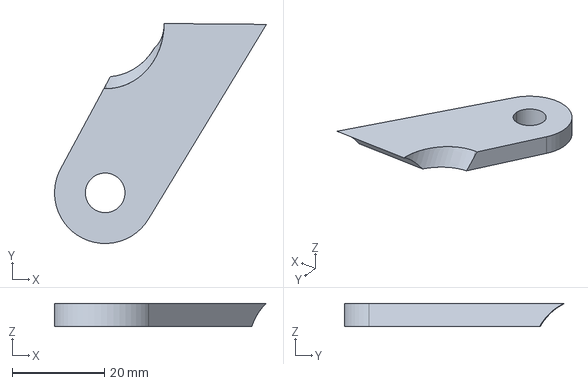
[picture p340: CAD file, 2018-03-05]
SU - Suspension/Chappe de LAS/IGS/SU_0200 (Avant Inf)/SU_0200_012 (Avant Inf Avant SupD).igs
46.0 x 47.8 x 5.00 mm
