epsa-team/Vulcanix-v1.0/SU - Suspension/Chappe de LAS/IGS/SU_0400 (Arriere Inf)/SU_0400_011 (Arriere Inf Avant InfD).igs

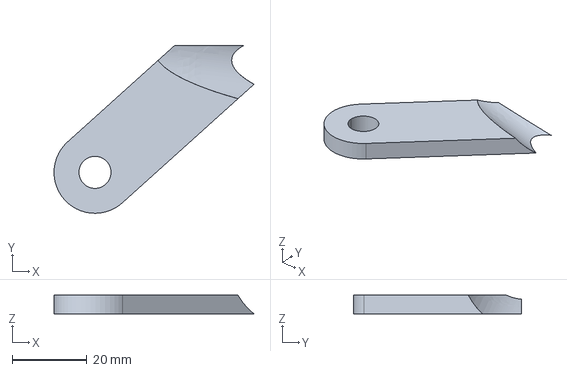
[picture p341: CAD file, 2018-03-05]
SU - Suspension/Chappe de LAS/IGS/SU_0400 (Arriere Inf)/SU_0400_011 (Arriere Inf Avant InfD).igs
53.7 x 45.0 x 5.00 mm
