epsa-team/Vulcanix-v1.0/SU - Suspension/Cost/07 - LASER CUT/SU_14001_FRONT ROCKER .SLDPRT

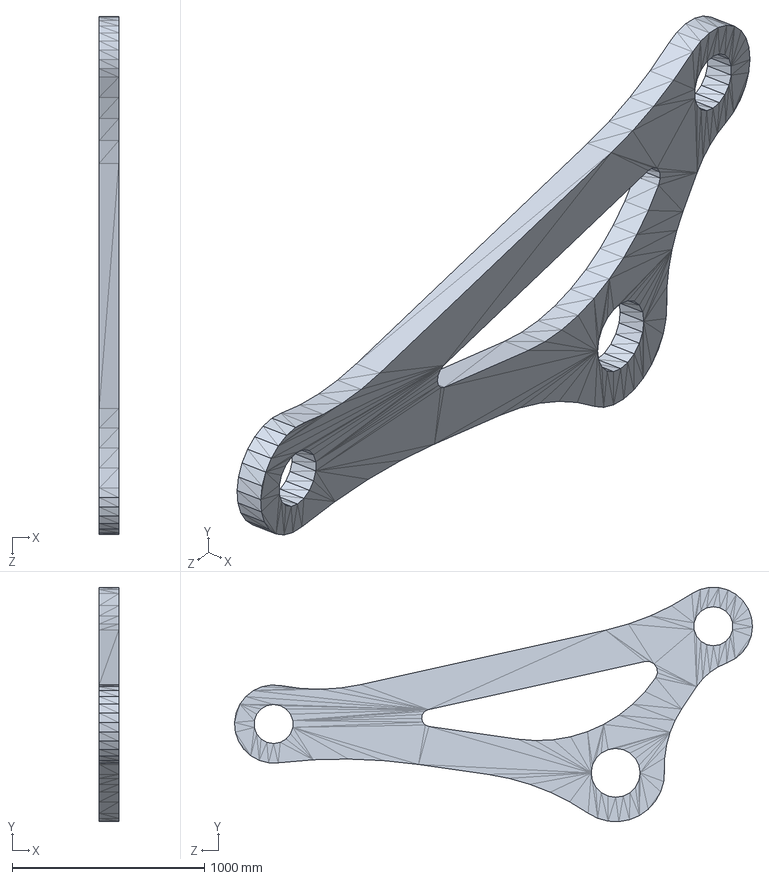
[picture p342: CAD file, 2017-12-07]
SU - Suspension/Cost/07 - LASER CUT/SU_14001_FRONT ROCKER .SLDPRT
101.6 x 1217.6 x 2692.2 mm
