epsa-team/Vulcanix-v1.0/SU - Suspension/SU_A1000 (Front Upright Assy)/Mises en plan/pour usinage/SU_1000_002_add (Upper Arm Wedge add alu).igs

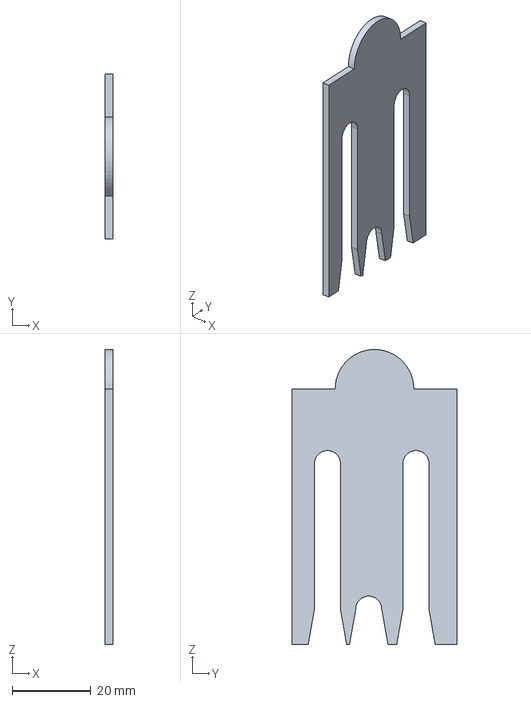
[picture p343: CAD file, 2018-02-07]
SU - Suspension/SU_A1000 (Front Upright Assy)/Mises en plan/pour usinage/SU_1000_002_add (Upper Arm Wedge add alu).igs
2.00 x 42.0 x 75.0 mm
