epsa-team/Vulcanix-v1.0/SU - Suspension/SU_A1100 (Rear Upright Assy)/Mises en plan/pour usinage/SU_1100_002_add (Upper Arm Wedge add).igs

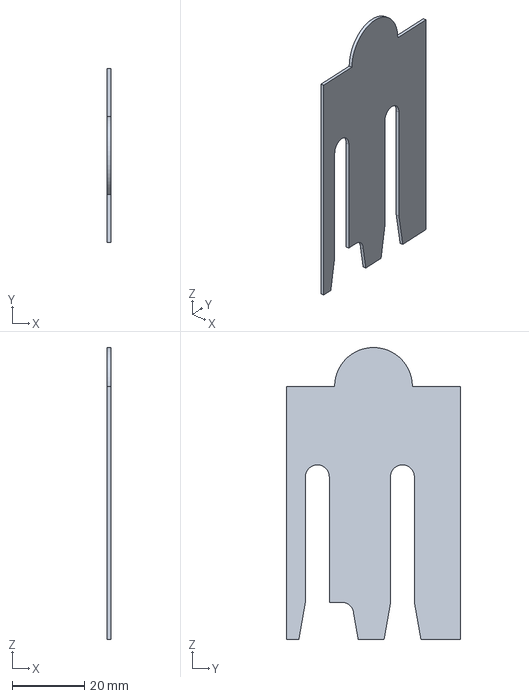
[picture p344: CAD file, 2018-02-07]
SU - Suspension/SU_A1100 (Rear Upright Assy)/Mises en plan/pour usinage/SU_1100_002_add (Upper Arm Wedge add).igs
1.00 x 48.0 x 80.8 mm
