epsa-team/Vulcanix-v1.0/SU - Suspension/test en traction/piece pour EPSA/Insert Triangle test traction simple.igs

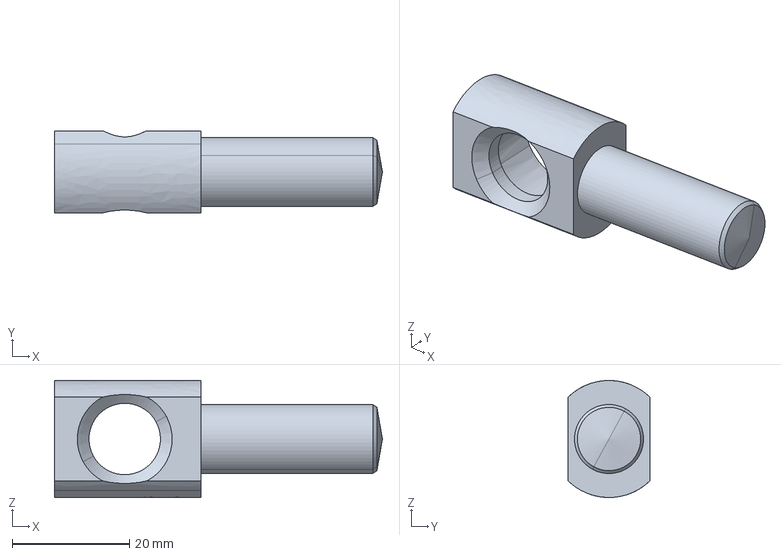
[picture p345: CAD file, 2017-12-05]
SU - Suspension/test en traction/piece pour EPSA/Insert Triangle test traction simple.igs
56.0 x 14.0 x 20.0 mm
