epsa-team/Vulcanix-v1.0/visserie/M12/vis_M12_80.stp

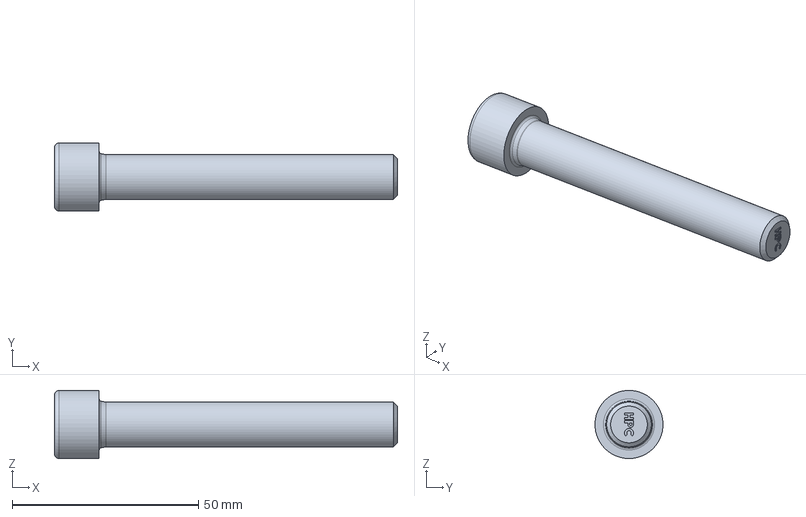
[picture p346: CAD file, 2017-12-09]
visserie/M12/vis_M12_80.stp
92.0 x 18.3 x 18.3 mm
