epsa-team/Vulcanix-v1.0/visserie/M6/vis_chc_M6_20.stp

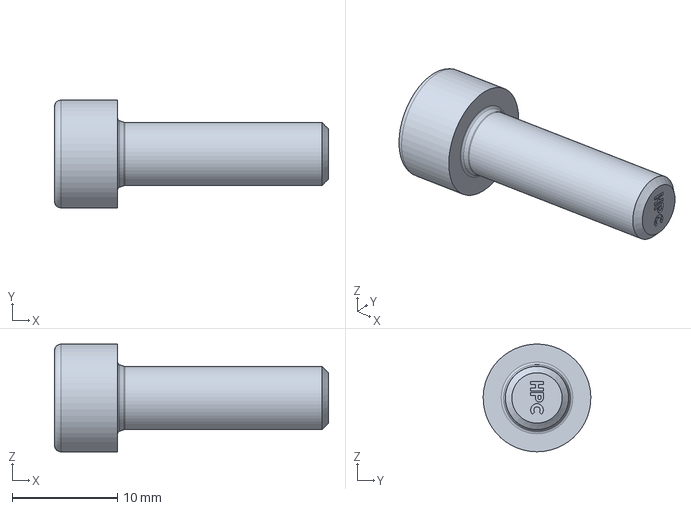
[picture p347: CAD file, 2017-12-09]
visserie/M6/vis_chc_M6_20.stp
26.0 x 10.2 x 10.2 mm
