epsa-team/Vulcanix-v1.0/visserie/M8/rondelle_M8.stp

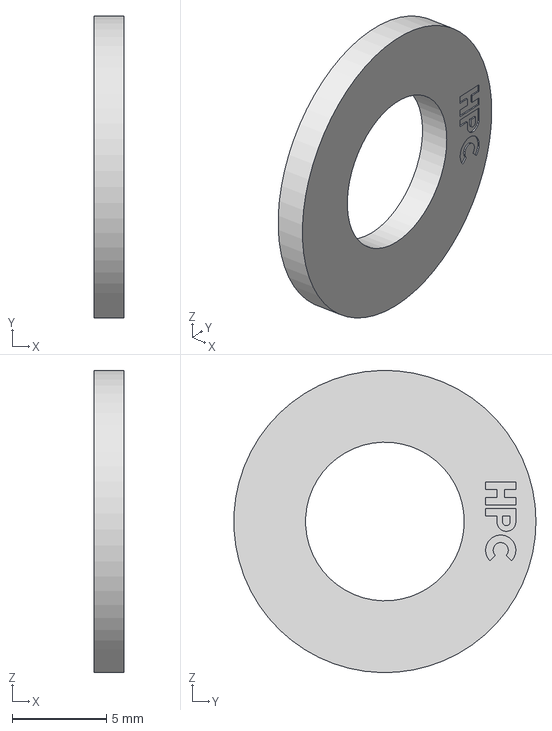
[picture p348: CAD file, 2017-12-09]
visserie/M8/rondelle_M8.stp
1.60 x 16.0 x 16.0 mm
