epsa-team/Vulcanix-v1.0/ZZ - Autres/Chapes/1,5mm/IGS/Bracket_27_Boitier carte avant.igs

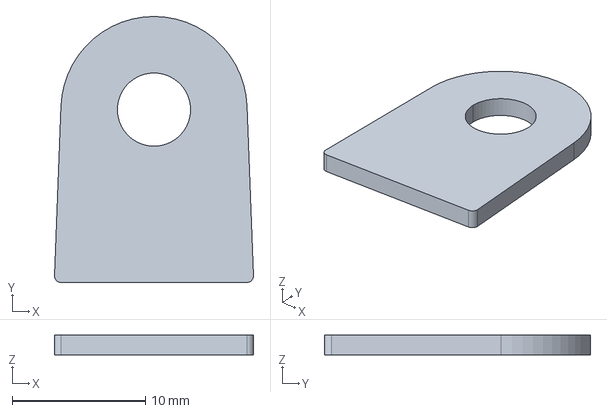
[picture p349: CAD file, 2018-03-12]
ZZ - Autres/Chapes/1,5mm/IGS/Bracket_27_Boitier carte avant.igs
15.0 x 20.0 x 1.50 mm
