epsa-team/Vulcanix-v1.0/ZZ - Autres/Chapes/3mm/Igs/Bracket_119_chain shield inf.igs

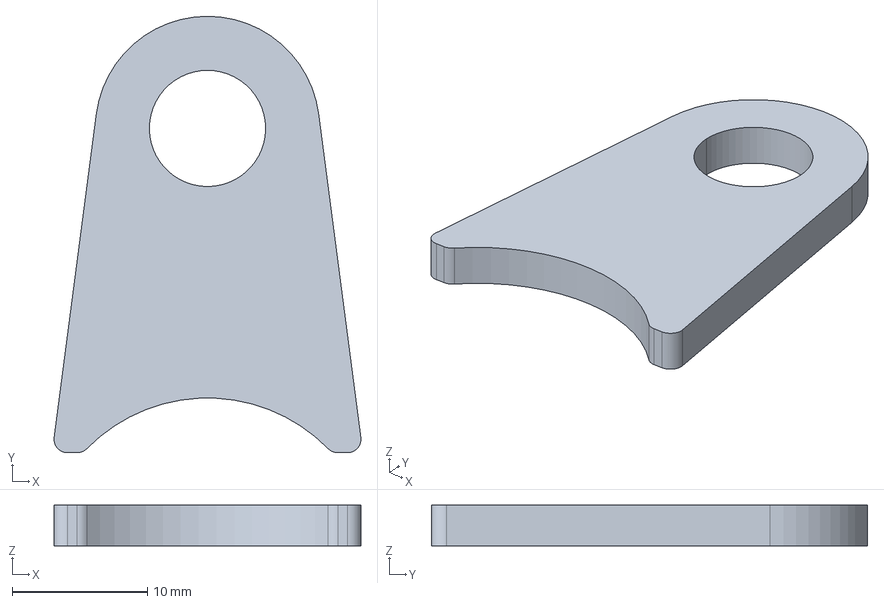
[picture p350: CAD file, 2018-02-25]
ZZ - Autres/Chapes/3mm/Igs/Bracket_119_chain shield inf.igs
22.7 x 32.3 x 3.00 mm
