epsa-team/Vulcanix-v1.0/AA. Mise en plan/A verifier/AMS Expansion Tank/Expansion Tank Bracket.igs

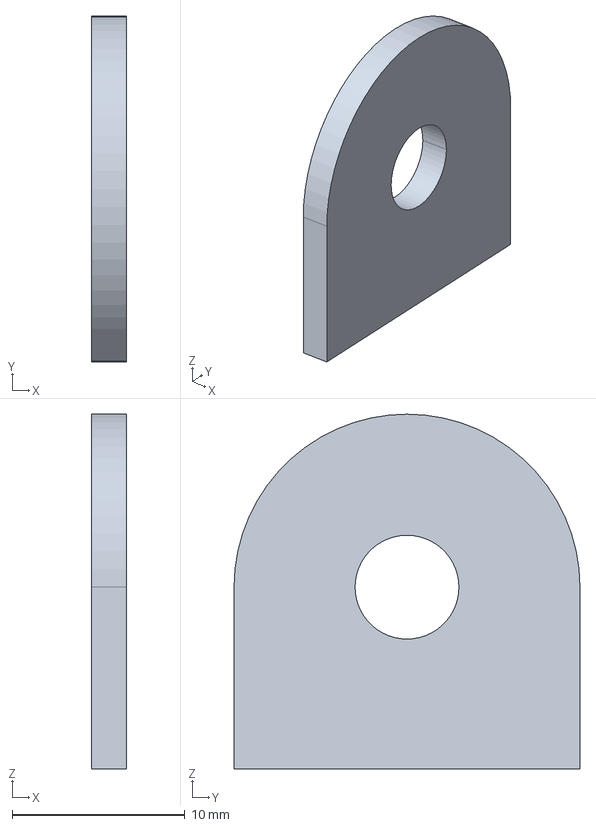
[picture p351: CAD file, 2018-03-11]
AA. Mise en plan/A verifier/AMS Expansion Tank/Expansion Tank Bracket.igs
2.00 x 20.0 x 20.5 mm
