epsa-team/Vulcanix-v1.0/AA. Mise en plan/A verifier/Benjamin Pare-feu V2/Firewall Middle side.igs

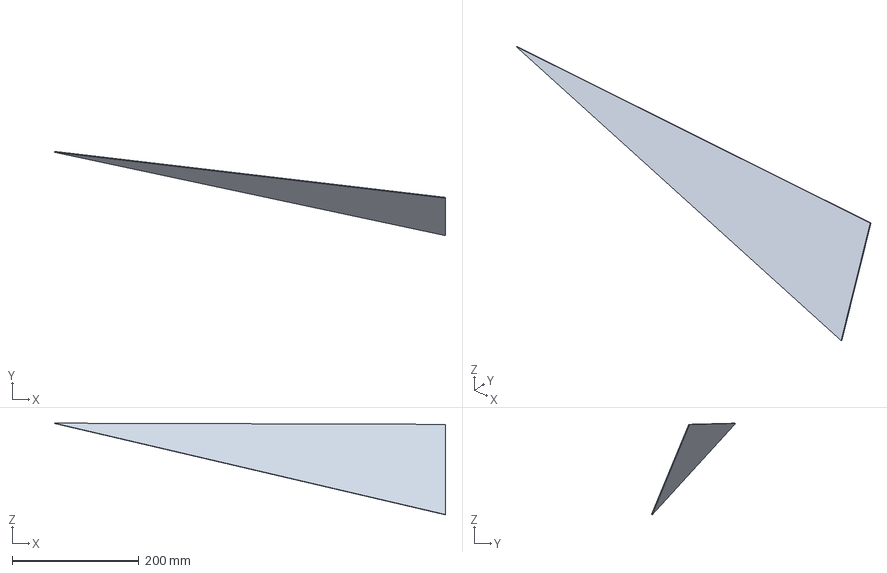
[picture p352: CAD file, 2018-06-12]
AA. Mise en plan/A verifier/Benjamin Pare-feu V2/Firewall Middle side.igs
617.2 x 133.0 x 144.8 mm
