epsa-team/Vulcanix-v1.0/AA. Mise en plan/A verifier/Benjamin Pédalier/FR_0300_004_BA.igs

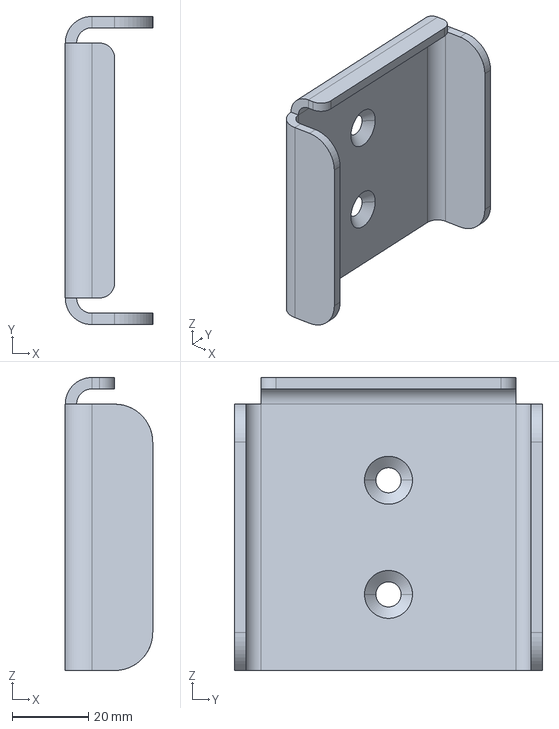
[picture p353: CAD file, 2018-02-25]
AA. Mise en plan/A verifier/Benjamin Pédalier/FR_0300_004_BA.igs
23.0 x 81.0 x 77.0 mm
