epsa-team/Vulcanix-v1.0/AA. Mise en plan/A verifier/VBS/a verifier/Grand_cache_cremaillere.igs

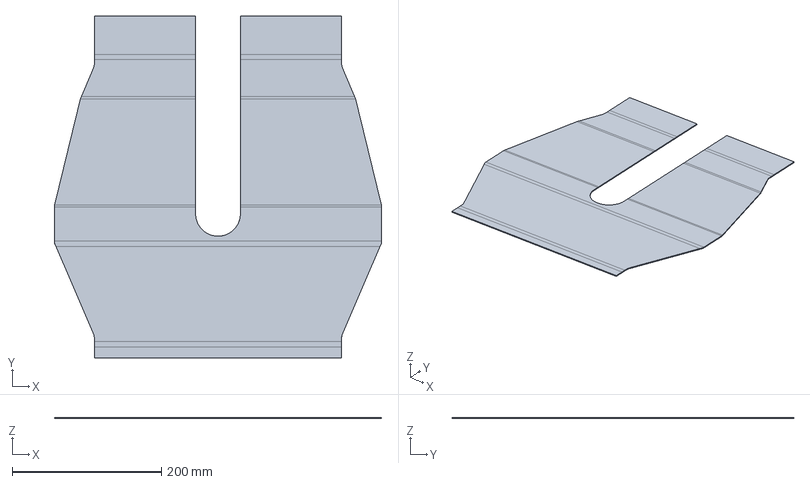
[picture p354: CAD file, 2018-06-13]
AA. Mise en plan/A verifier/VBS/a verifier/Grand_cache_cremaillere.igs
438.8 x 458.2 x 1.50 mm
