epsa-team/Vulcanix-v1.0/AA. Mise en plan/suivi commande/Alpentech/Insert_PM_Up_Front.stp

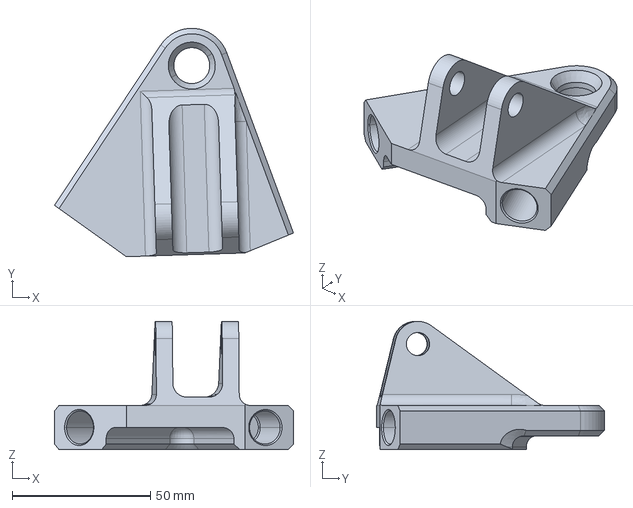
[picture p355: CAD file, 2018-03-12]
AA. Mise en plan/suivi commande/Alpentech/Insert_PM_Up_Front.stp
86.5 x 82.6 x 46.4 mm
