epsa-team/Vulcanix-v1.0/AA. Mise en plan/Verifie/Prod Boisard/Roues équipés/SU_1000_002 (Upper Arm Wedge).igs

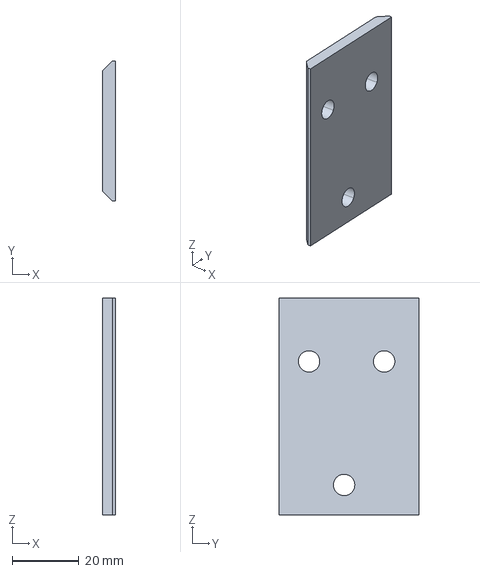
[picture p356: CAD file, 2018-02-06]
AA. Mise en plan/Verifie/Prod Boisard/Roues équipés/SU_1000_002 (Upper Arm Wedge).igs
4.00 x 42.0 x 65.0 mm
