epsa-team/Vulcanix-v1.0/(list of files, cad)

Other CAD files:
AA. Mise en plan/suivi commande/La mache/laser/On rattrape les bêtises de gameiro/WT_0300_007 (Rear Brake Hub).igs
EN - Engine & Powertrain/Carter d'huile/VFinale-Vulcanix/Cloison_Courte_carter.igs
FR - Frame & Body/FR_A0100 (Frame)/Prod/Tubes step/nouveau nom/30x2repare/112.stp
FR - Frame & Body/FR_A0100 (Frame)/Prod/Tubes step/nouveau nom/Tube step EPSA v3.0/30x2repare/112.stp
SU - Suspension/SU_A0200 (Lower front A-arms)/Mise en plan/SU_0200_007.igs
EN - Engine & Powertrain/Carter d'huile/VFinale-Vulcanix/Plaque Soupape Secu.igs
EN - Engine & Powertrain/EN_A0900 (Differential Assy)/porte excentrique droit.igs
FR - Frame & Body/FR_A0100 (Frame)/Prod/Tubes step/direction/ST_2.stp
FR - Frame & Body/FR_A0100 (Frame)/Prod/Tubes step/front_hoop_biseaute.stp
FR - Frame & Body/FR_A0100 (Frame)/Prod/Tubes step/nouveau nom/25x1.5repare/60.stp
FR - Frame & Body/FR_A0100 (Frame)/Prod/Tubes step/suspension/SU_0510_002.stp
SU - Suspension/Chappe de LAS/Chape Liason au Sol EPSA/SU_0300 (Arriere Sup)/IGS/SU_0300_007 (Arriere Sup Avant Inf).igs
SU - Suspension/Chappe de LAS/Chape Liason au Sol EPSA/SU_0400 (Arriere Inf)/IGS/SU_0400_008 (Arriere Inf Avant Sup).igs
SU - Suspension/Chappe de LAS/IGS/SU_0300 (Arriere Sup)/SU_0300_012 (Arriere Sup Avant SupD).igs
SU - Suspension/Chappe de LAS/IGS/SU_0600 (Front Bell Crank)/SU_0600_006 (Front bell cranck avantD).igs
SU - Suspension/Chappe de LAS/IGS/SU_0800 (Rear Bell Cranck)/SU_0800_004_Bracket_Rear Bell Cranck.igs
AA. Mise en plan/Verifie/Prod Boisard/Roues équipés/Coordonnées portes-moyeux/Porte moyeu arrière avec esquisse contours.SLDPRT
AA. Mise en plan/A verifier/Benjamin Pare-feu V2/Firewall Middle horizontal back.igs
AA. Mise en plan/A verifier/Benjamin Pare-feu V2/Firewall Top side.igs
AA. Mise en plan/A verifier/Benjamin Pare-feu V2/Firewall Up back.igs
AA. Mise en plan/A verifier/Benjamin Pare-feu/Firewall - middle side.igs
AA. Mise en plan/A verifier/Benjamin Pare-feu/Firewall - upper side.igs
AA. Mise en plan/A verifier/Benjamin Pare-feu/Firewall middle.igs
AA. Mise en plan/A verifier/Benjamin Pédalier/FR_0300_003_BA.igs
AA. Mise en plan/A verifier/Benjamin Pédalier/FR_0300_010_BA.igs
AA. Mise en plan/A verifier/VBS/a verifier/SU_0600_003.igs
AA. Mise en plan/A verifier/VBS/a verifier/SU_0800_003.igs
AA. Mise en plan/A verifier/VBS/a verifier/cache_cremaillere.igs
AA. Mise en plan/Verifie/Prod Boisard/Roues équipés/Coordonnées portes-moyeux/Face 1 Gros contours avec coordonnées usinage.SLDPRT
AA. Mise en plan/Verifie/Prod Boisard/Roues équipés/Coordonnées portes-moyeux/Porte moyeux arrière filaire avec coordonnées usinage.SLDPRT
AA. Mise en plan/Verifie/Prod Boisard/Roues équipés/SU_1000_001 (Front Left Upright).igs
AA. Mise en plan/Verifie/Prod Boisard/Roues équipés/SU_1000_004 (Brake Caliper Spacer).igs
AA. Mise en plan/Verifie/Prod Boisard/Roues équipés/SU_1100_001 (Rear Upright).igs
AA. Mise en plan/Verifie/Prod Boisard/Roues équipés/SU_1100_003 (Upper Arm Bracket).igs
AA. Mise en plan/Verifie/Prod Boisard/Roues équipés/WT_0200_001 (Front Hub).igs
AA. Mise en plan/Verifie/Prod Boisard/Roues équipés/WT_0200_003_Al (Front Wheel Spacer for Al Rim).igs
AA. Mise en plan/Verifie/Prod Boisard/Roues équipés/WT_0200_005 (Bearing Spacer).igs
AA. Mise en plan/Verifie/Prod Boisard/Roues équipés/WT_0300_001 (Rear Hub).igs
AA. Mise en plan/Verifie/Prod Boisard/Roues équipés/WT_0300_003_Al (Rear Wheel Spacer for Al Rim).igs
AA. Mise en plan/Verifie/Prod Boisard/Roues équipés/WT_0300_004 (Rear Bearing Spacer).igs
AA. Mise en plan/suivi commande/Alpentech/Insert_PM_Lower_Rear.stp
BR - Brake System/BR_0200_001 (Break Disc).CATPart
BR - Brake System/BR_0300_001 (Break Disc).CATPart
EL - Electrical/Boite.CATPart
EL - Electrical/Chapes/Bracket_Earth_batt.CATPart
EL - Electrical/Chapes/Bracket_Earth_ess.CATPart
EL - Electrical/Chapes/Bracket_Earth_ess_sym.CATPart
EL - Electrical/Chapes/Bracket_Earth_tab.CATPart
EL - Electrical/Chapes/bracket_Crash_Sensor.CATPart
EL - Electrical/Chapes/bracket_boitier_carte_haut.CATPart
EL - Electrical/Chapes/bracket_break_light.CATPart
EL - Electrical/Chapes/bracket_master_switch.CATPart
EL - Electrical/Chapes/bracket_power_distribution.CATPart
EL - Electrical/Chapes/bracket_rear_battery.CATPart
EL - Electrical/Chapes/bracket_right_battery.CATPart
EL - Electrical/Chapes/bruh.CATPart
EL - Electrical/EL_0100_001.CATPart
EL - Electrical/EL_0100_002.CATPart
EL - Electrical/EL_0100_003.CATPart
EL - Electrical/EL_0400_001_AA.CATPart
EL - Electrical/EL_A0200/EL_A0200.CATProduct
EL - Electrical/EL_A0200/EL_A0200_001_AA.CATPart
EL - Electrical/EL_A0200/EL_A0200_002_AA.CATPart
EL - Electrical/EL_A0200/EL_A0200_003_AA.CATPart
EL - Electrical/EL_A0300/1554H Box.CATPart
EL - Electrical/EL_A0300/1554H-T GASKET.CATPart
EL - Electrical/EL_A0300/1554H-T Lid.CATPart
EL - Electrical/EL_A0300/EL_0300_001.CATProduct
EL - Electrical/EL_A0300/EL_0300_002_AA.CATPart
EL - Electrical/EL_A0300/EL_0300_003_AA.CATPart
EL - Electrical/EL_A0300/EL_0300_004_AA.CATPart
EL - Electrical/EL_A0300/EL_0300_005_AA.CATPart
EL - Electrical/EL_A0300/EL_A0300.CATProduct
EL - Electrical/EL_A0300/IN-M4 (insert M4-0.7X5.75mm SS).CATPart
EL - Electrical/EL_A0300/IN100 (insert M3-0.5X5.75mm BRASS).CATPart
EL - Electrical/EL_A0300/SC576 (screw M4-0.7X 20mm PN).CATPart
EL - Electrical/EL_A0600/EL_0600_001.CATPart
EL - Electrical/EL_A0600/EL_0600_002.CATPart
EL - Electrical/EL_A0600/EL_0600_003.CATPart
EL - Electrical/EL_A0600/EL_A0600.CATProduct
EL - Electrical/EL_A0700/EL_0700_001.CATPart
EL - Electrical/EL_A0700/EL_0700_002.CATPart
EL - Electrical/EL_A0700/EL_0700_003.CATPart
EL - Electrical/EL_A0700/EL_A0700.CATProduct
EL - Electrical/Tableau de bord/Bouton poussoir Raz motored.CATPart
EL - Electrical/Tableau de bord/Bouton poussoir demarrage.CATPart
EL - Electrical/Tableau de bord/Bouton poussoir.CATPart
EL - Electrical/Tableau de bord/Compte-tour.CATProduct
EL - Electrical/Tableau de bord/LED bleu 5mm.CATPart
EL - Electrical/Tableau de bord/LED holder.CATPart
EL - Electrical/Tableau de bord/LED jaune 5mm.CATPart
EL - Electrical/Tableau de bord/LED rouge 5mm.CATPart
EL - Electrical/Tableau de bord/LED verte 5mm.CATPart
EL - Electrical/Tableau de bord/LED+support bleu.CATProduct
EL - Electrical/Tableau de bord/LED+support jaune.CATProduct
EL - Electrical/Tableau de bord/LED+suppport rouge.CATProduct
EL - Electrical/Tableau de bord/Part168.CATPart
EL - Electrical/Tableau de bord/Support_tdb.CATPart
EL - Electrical/Tableau de bord/Tableau de bord.CATProduct
EL - Electrical/Tableau de bord/afficheur Temp.CATPart
EL - Electrical/Tableau de bord/afficheur rapport.CATPart
EL - Electrical/Tableau de bord/bouton d'arret d'urgence.CATPart
EL - Electrical/Tableau de bord/chape tdb bas.CATPart
EL - Electrical/Tableau de bord/chape tdb haut.CATPart
EL - Electrical/Tableau de bord/derniere maquette/Dernier tdb.CATPart
EL - Electrical/Tableau de bord/inter bistable.CATPart
EL - Electrical/Tableau de bord/support LED compte-tour.CATPart
EL - Electrical/connecteurs/8STA-10.CATPart
EL - Electrical/connecteurs/8STA-12.CATPart
EL - Electrical/connecteurs/8STA-14.CATPart
EL - Electrical/connecteurs/8STA-16.CATPart
EL - Electrical/connecteurs/8STA-18.CATPart
EN - Engine & Powertrain/Carter d'huile/Carter_Vfinale.CATProduct
EN - Engine & Powertrain/Carter d'huile/Carter_huile_en_tole.CATProduct
EN - Engine & Powertrain/Carter d'huile/Cloison_Courte_carter.CATPart
EN - Engine & Powertrain/Carter d'huile/Cloison_Courte_carter_taraudee.CATPart
EN - Engine & Powertrain/Carter d'huile/Cloison_Inferieure_carter.CATPart
EN - Engine & Powertrain/Carter d'huile/Cloison_Longue_carter.CATPart
EN - Engine & Powertrain/Carter d'huile/Dessin_pour_commande.dwg
EN - Engine & Powertrain/Carter d'huile/Dessin_pour_commande.dxf
EN - Engine & Powertrain/Carter d'huile/Plaque Soupape Secu.CATPart
EN - Engine & Powertrain/Carter d'huile/Plaquette vidange.CATPart
EN - Engine & Powertrain/Carter d'huile/Positionnement_carter_huile.CATProduct
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
