epsa-team/Vulcanix-v1.0/AA. Mise en plan/A verifier/PTN/Readme.txt

Les plans pour le support de batterie.
Il manque un trait de symetrie pour le montant (j'ai pas réussi à l'ajouter)
Pour les perçages sur le support, il semble que les trous soient coniques (fraisés ?)
Je sais pas trop comment coter ca proprement, surtout que, de ce que j'ai compris, la pièce va etre decoupé laser...
Faites moi vos remarques :)
Merci !

PTN
