epsa-team/Vulcanix-v1.0/AA. Mise en plan/A verifier/AMS Expansion Tank/Expansion Tank Bracket.pdf

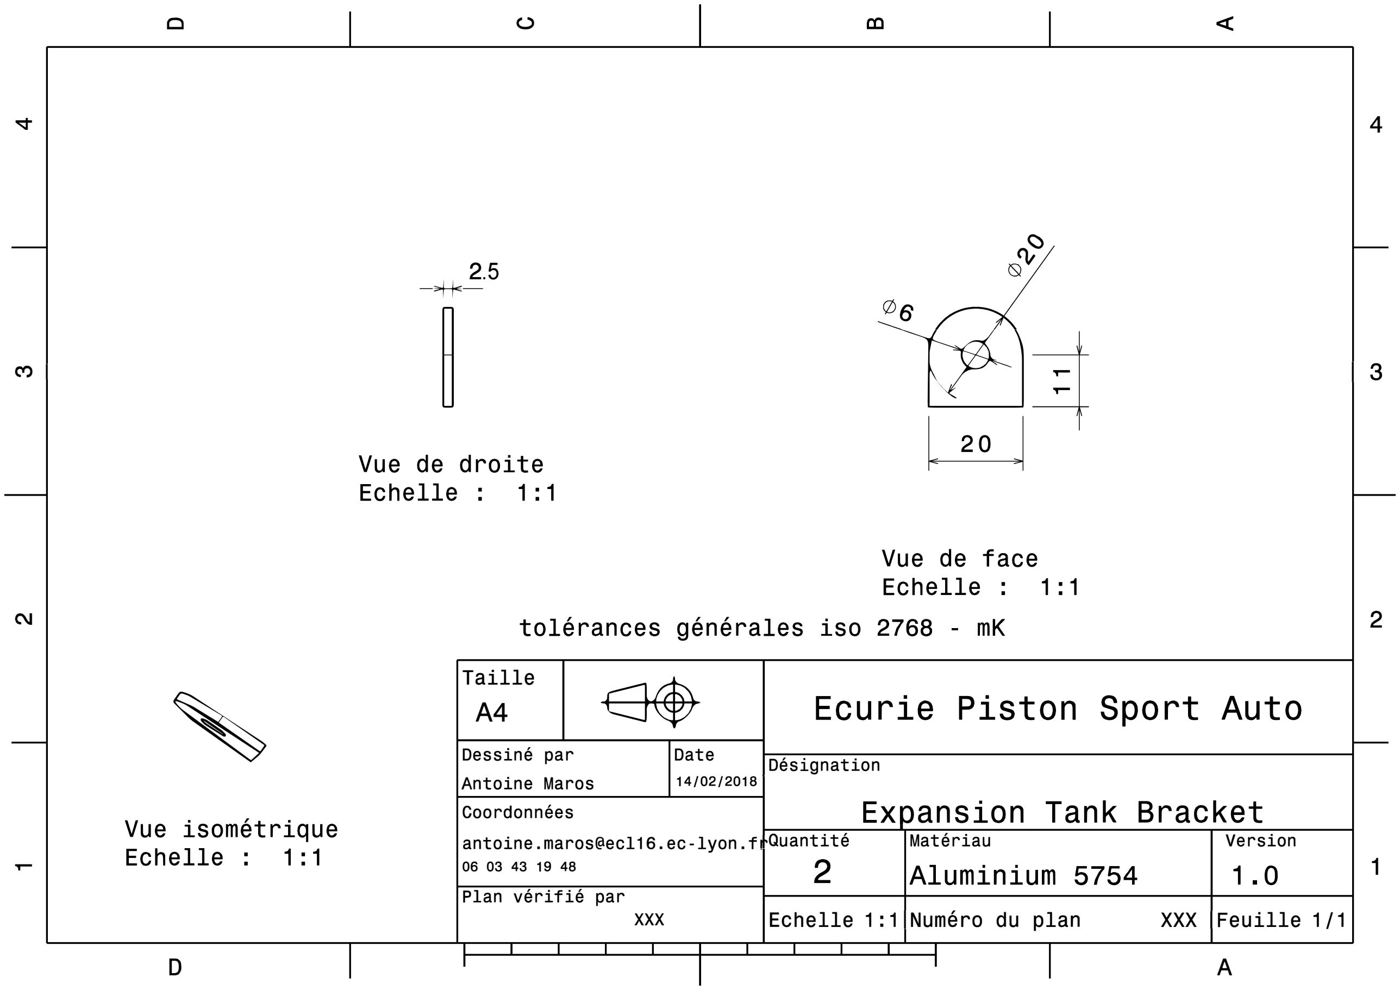
[picture p358: page 1]

v

Ml

C\I

T"""

0

Vue isométrique
Echelle : 1 : 1

D

(.)

* 2.5
1

Vue de droite
Echelle : 1 : 1

cc

<v

c:::,

0

# ltJ

Vue de face
Echelle : 1 : 1
tolérances générales iso 2768 - mK

<(

Taille
A4 | B$ | Ecurie Piston Sport Auto

Dessiné par
Antoine Maros
Coordonnées

Date D

' .

14/0212018 -

esignation

Exoansion Tank Bracket
antoine.maros@ecl16.ec-lyon.ftQuantité | Matériau | Version
06 03 43 19 48 | 2 | Aluminium 5754 | 1 . 0
Plan vérifié par
XXX | Echelle 1 :11Numéro du plan | XXX !Feuille 1/1

A

4

13

2

1
