epsa-team/Vulcanix-v1.0/AA. Mise en plan/A verifier/AMS Expansion Tank/Radiateur Bracket.pdf

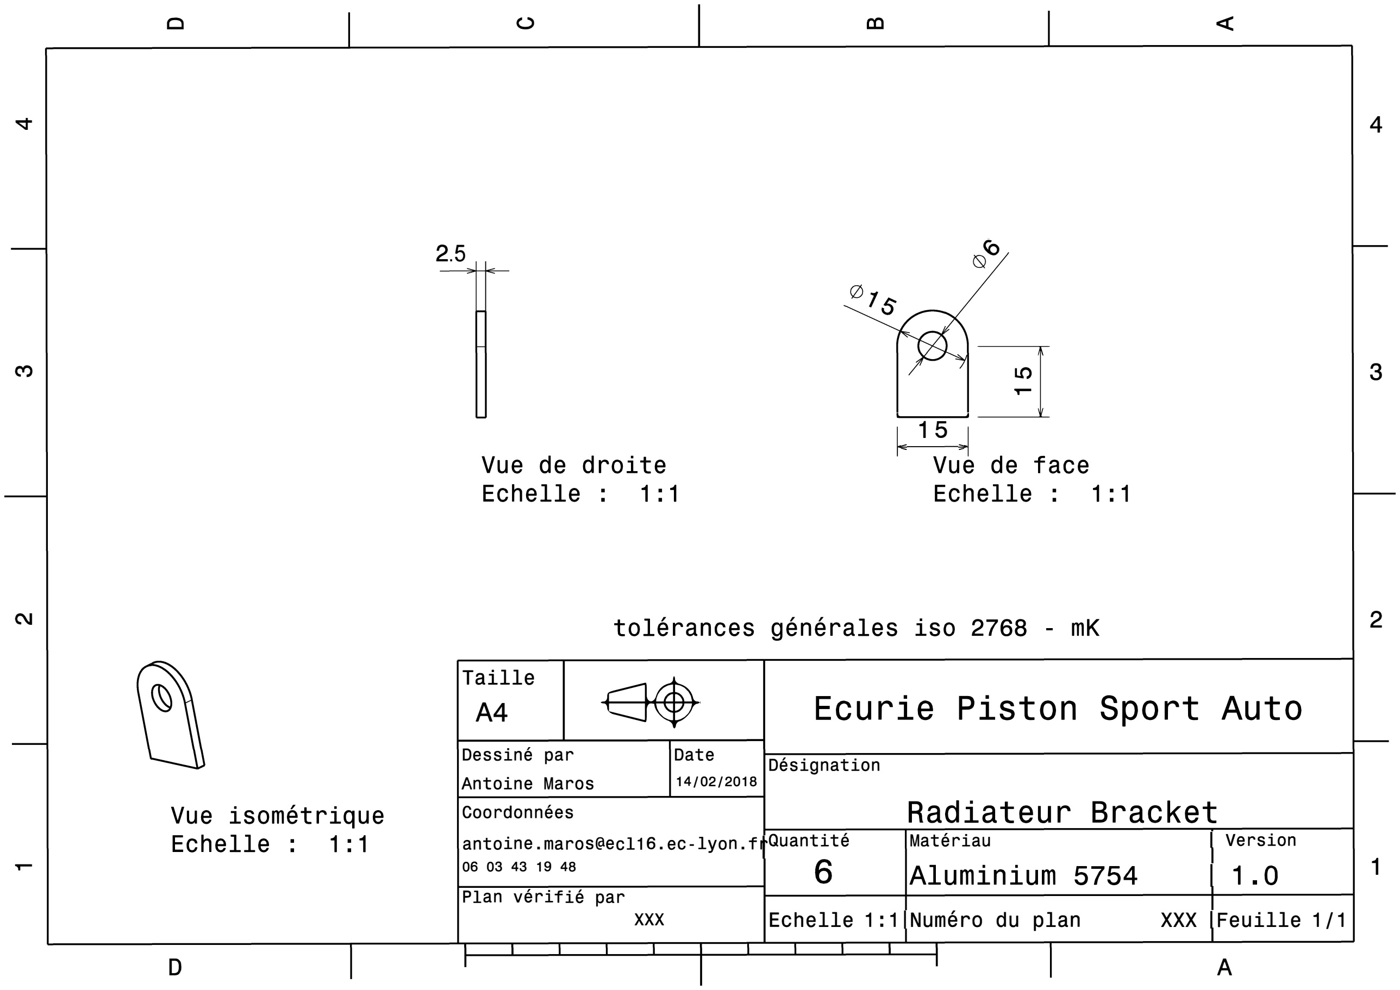
[picture p359: page 1]

v

C")

C\I

T"""

0

Vue isométrique
Echelle : 1 : 1

D

2.5

(.)

Vue de droite
Echelle : | 1 : 1
cc | <(

0

(o
....______, 3

IE 1 5 I Vue de face

Echelle : 1 : 1

tolérances générales iso 2768 - mK

Taille
A4

Dessiné par
Antoine Maros
Coordonnées

B$

Date

14/02/2018

## Ecurie Piston Sport Auto

Désignation

Radiateur Bracket
antoine.maros@ecl16.ec-lyon.ffQuantité | Matériau | I Version
06 03 43 19 48 Plan vérifié par XXX | Aluminium 5754 | 1 1 .O
Echelle 1 :11Numéro du plan | XXX !Feuille 1/1
| | A

4

3

2

1
