epsa-team/Vulcanix-v1.0/AA. Mise en plan/A verifier/Readme.txt

Déposer ici les plans que vous voulez faire vérifier, de préférence en CATdrawing.

N'oubliez pas de prévenir que vous avez déposé quelque chose.
