epsa-team/Vulcanix-v1.0/AA. Mise en plan/A verifier/AMS Expansion Tank/Fond Expansion Tank.pdf

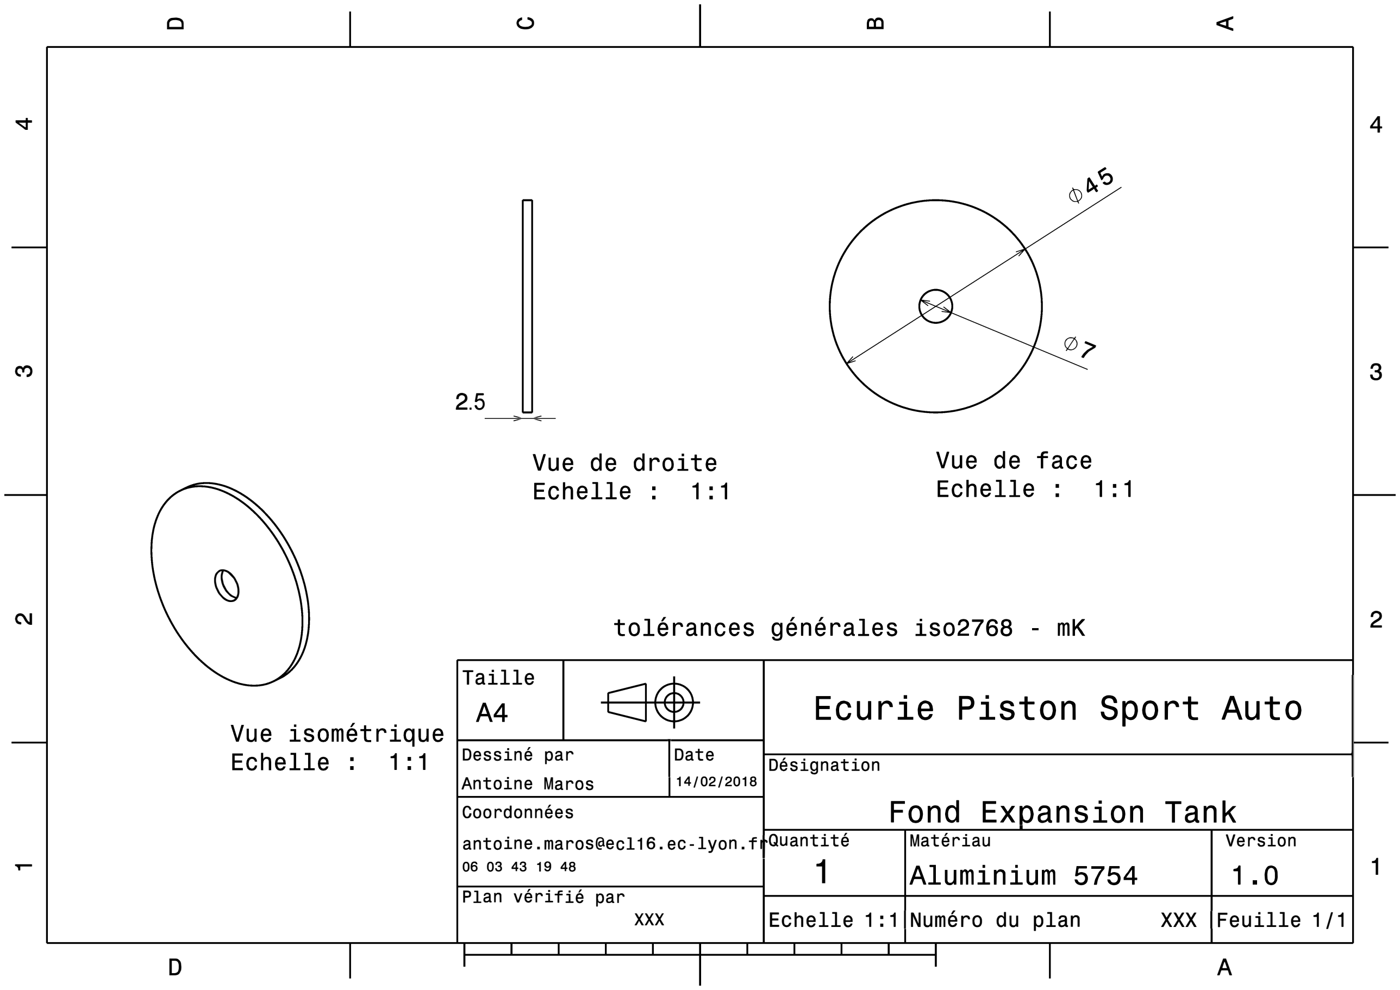
[picture p360: page 1]

0

v

C")

C\I

T"""

D

2.5

(.)

Vue de droite
Echelle : 1 : 1

cc

ot>c

0/

Vue de face
Echelle : 1 : 1

tolérances générales iso2768 - mK

<(

Taille

- 1 : 1 Dessiné par
Antoine M
I Date | 1

aras

D' esignation ·

14/02/2018

Ecurie Piston Sport Auto

Coordonnées | Fond Expansion Tank
antoine.maros@ecl16.ec-lyon.ff
Quantité | Matériau | Version
06 03 43 19 48 | Aluminium 5754 | 1 . 0
Plan vérifié par
XXX | Echelle 1 :11Numéro du plan | XXX !Feuille 1/1

A

4

3

2

1
