epsa-team/Vulcanix-v1.0/SU - Suspension/11 - Test ARB Optimus/MR_calculation.xlsx

Suspension |  |  |  |  | ARB
Position Suspension | Déplacement suspension | Position roue | Déplacement roue | MR | Position Suspension | Déplacement suspension | Angle ARB config milieu | Angle ARB config haute | Angle ARB config basse
145 | -25 | 176.493 | 30.593 | 1.22372 | 145 | -25 | 19.442 | 14.583 | x
152 | -18 | 168.609 | 22.709 | 1.261611111 | 152 | -18 | 13.565 | 11.508 | x
160 | -10 | 158.98 | 13.08 | 1.308 | 160 | -10 | 7.766 | 8.098 | 17.548
167 | -3 | 149.954 | 4.054 | 1.351333333 | 167 | -3 | 2.897 | 4.999 | 8.403
173 | 3 | 141.73 | -4.17 | 1.39 | 173 | 3 | 1.33 | 2.133 | 1.815
180 | 10 | 131.52 | -14.38 | 1.438 | 180 | 10 | 6.445 | 1.584 | 5.287
188 | 18 | 118.986 | -26.914 | 1.495222222 | 188 | 18 | 12.56 | 6.472 | 12.868
195 | 25 | 107.204 | -38.696 | 1.54784 | 195 | 25 | 17.955 | 11.32 | 18.761
