epsa-team/Vulcanix-v1.0/AA. Mise en plan/Verifie/Prod Boisard/Roues équipés/Coordonnées portes-moyeux/plan 1.JPG

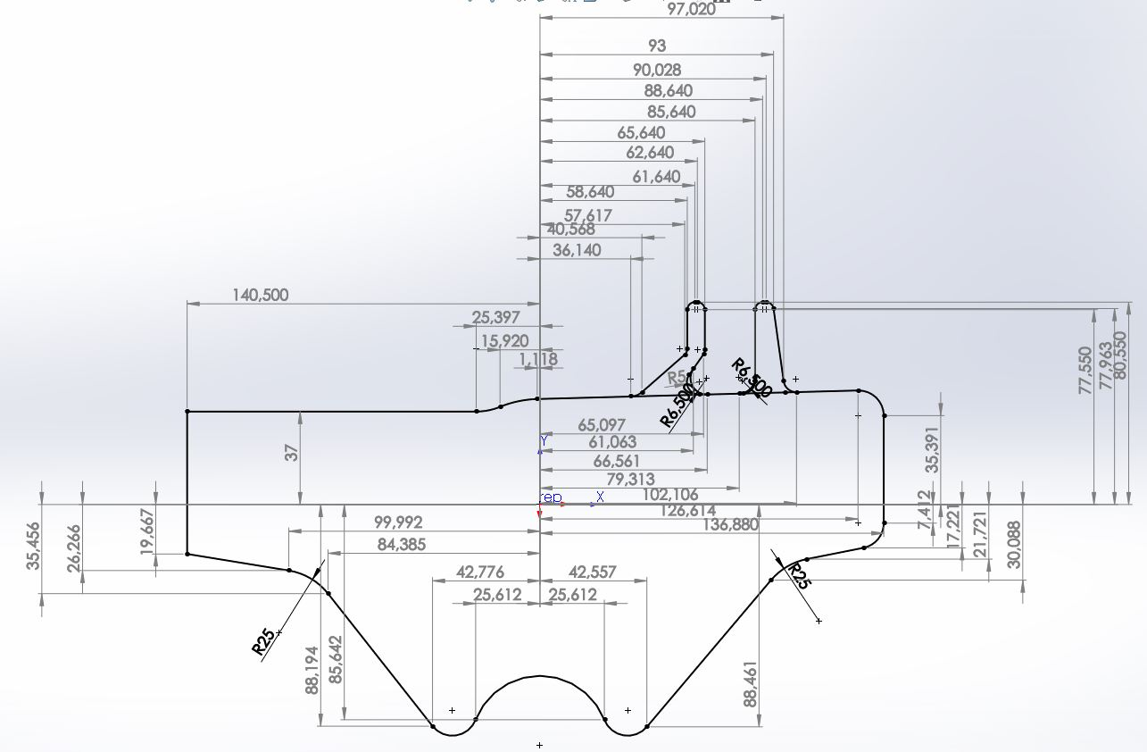
AA. Mise en plan/Verifie/Prod Boisard/Roues équipés/Coordonnées portes-moyeux/plan 1.JPG
