epsa-team/Vulcanix-v1.0/AA. Mise en plan/Verifie/Prod Boisard/Roues équipés/Coordonnées portes-moyeux/plaque frein pm avant 1.JPG

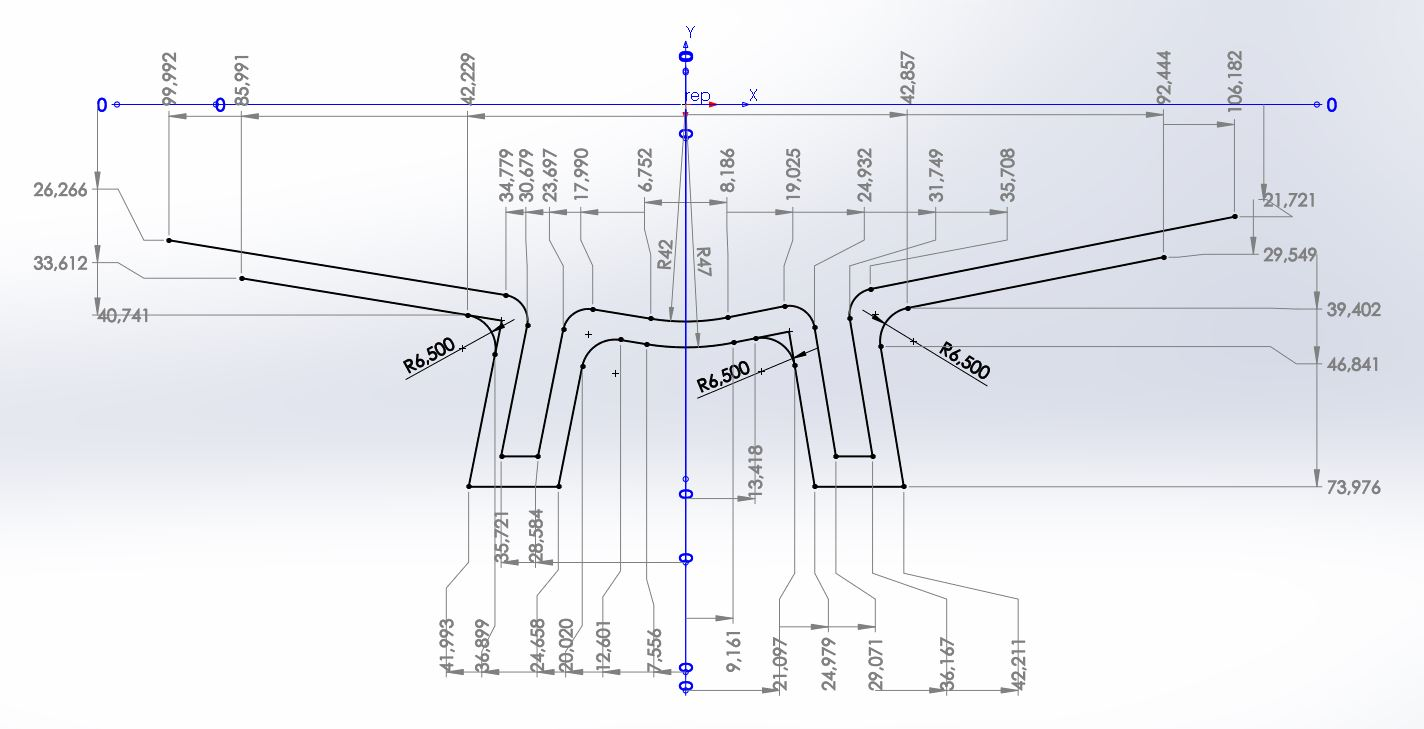
AA. Mise en plan/Verifie/Prod Boisard/Roues équipés/Coordonnées portes-moyeux/plaque frein pm avant 1.JPG
