epsa-team/Vulcanix-v1.0/SU - Suspension/09 - LAS automatique/Results/Figures matlab/Roll - MR.jpg

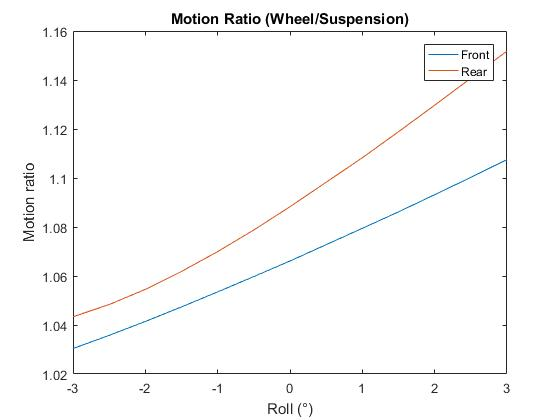
SU - Suspension/09 - LAS automatique/Results/Figures matlab/Roll - MR.jpg
