epsa-team/Vulcanix-v1.0/SU - Suspension/09 - LAS automatique/Results/Figures matlab/Steering - Wheel angle comparison - Touze.jpg

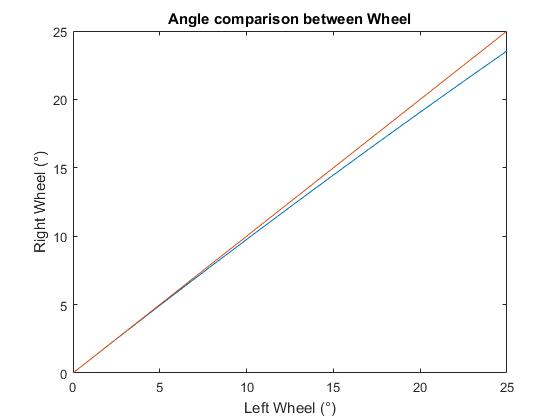
SU - Suspension/09 - LAS automatique/Results/Figures matlab/Steering - Wheel angle comparison - Touze.jpg
