epsa-team/Vulcanix-v1.0/SU - Suspension/test en traction/Courbes/35206658_1071776529641569_137333258621812736_n.jpg

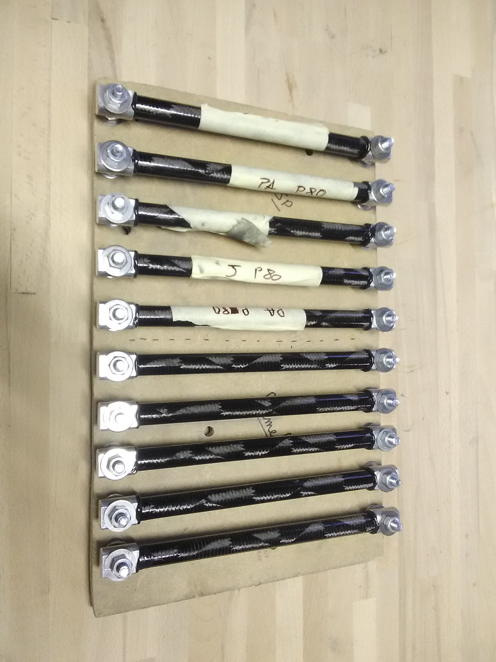
SU - Suspension/test en traction/Courbes/35206658_1071776529641569_137333258621812736_n.jpg
