epsa-team/Vulcanix-v1.0/SU - Suspension/test en traction/Courbes/A_arm_mounting.jpg

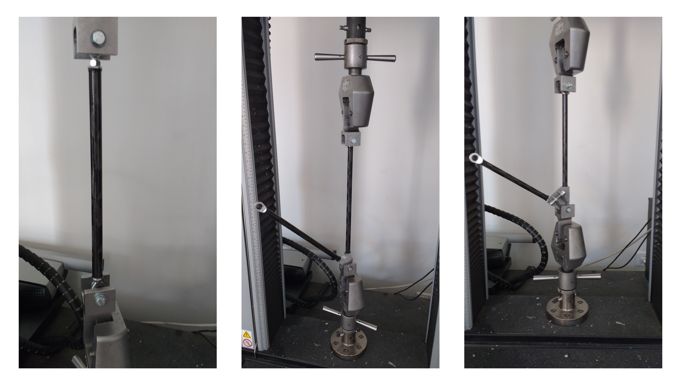
SU - Suspension/test en traction/Courbes/A_arm_mounting.jpg
