epsa-team/Vulcanix-v1.0/SU - Suspension/test en traction/Courbes/afeter_breaking_picture.jpg

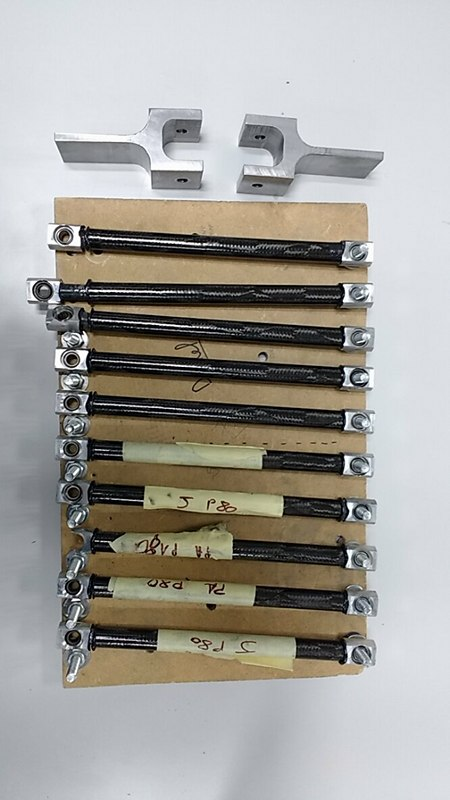
SU - Suspension/test en traction/Courbes/afeter_breaking_picture.jpg
