epsa-team/Vulcanix-v1.0/AA. Mise en plan/A verifier/18M_SU_0700_003.pdf

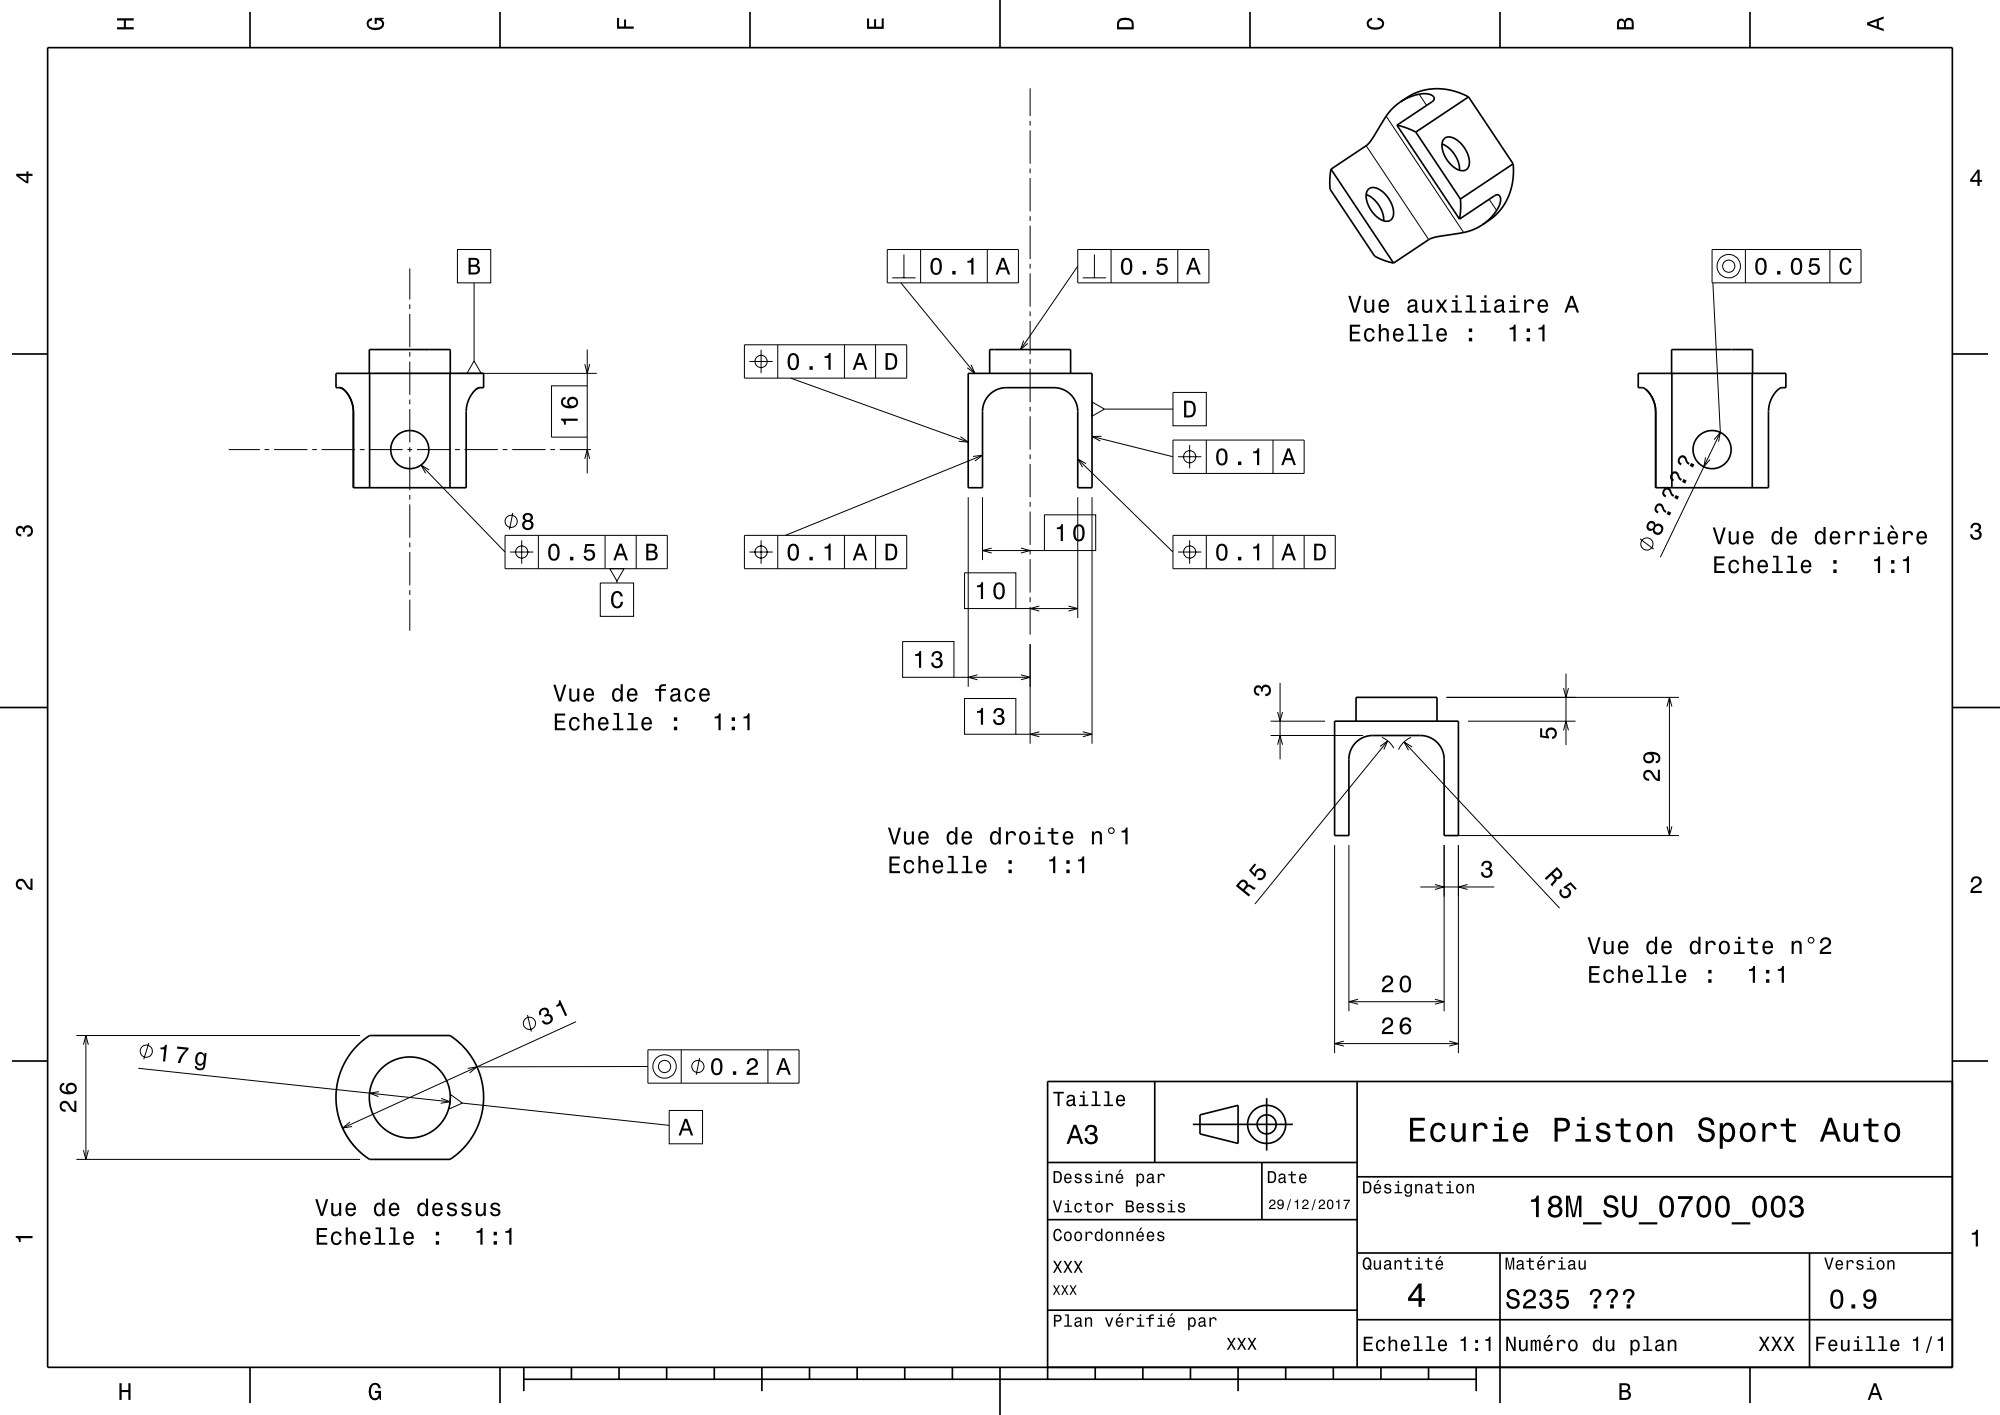
[picture p375: page 1]
