epsa-team/Vulcanix-v1.0/AA. Mise en plan/A verifier/18M_SU_0700_003_corr_arthur.pdf

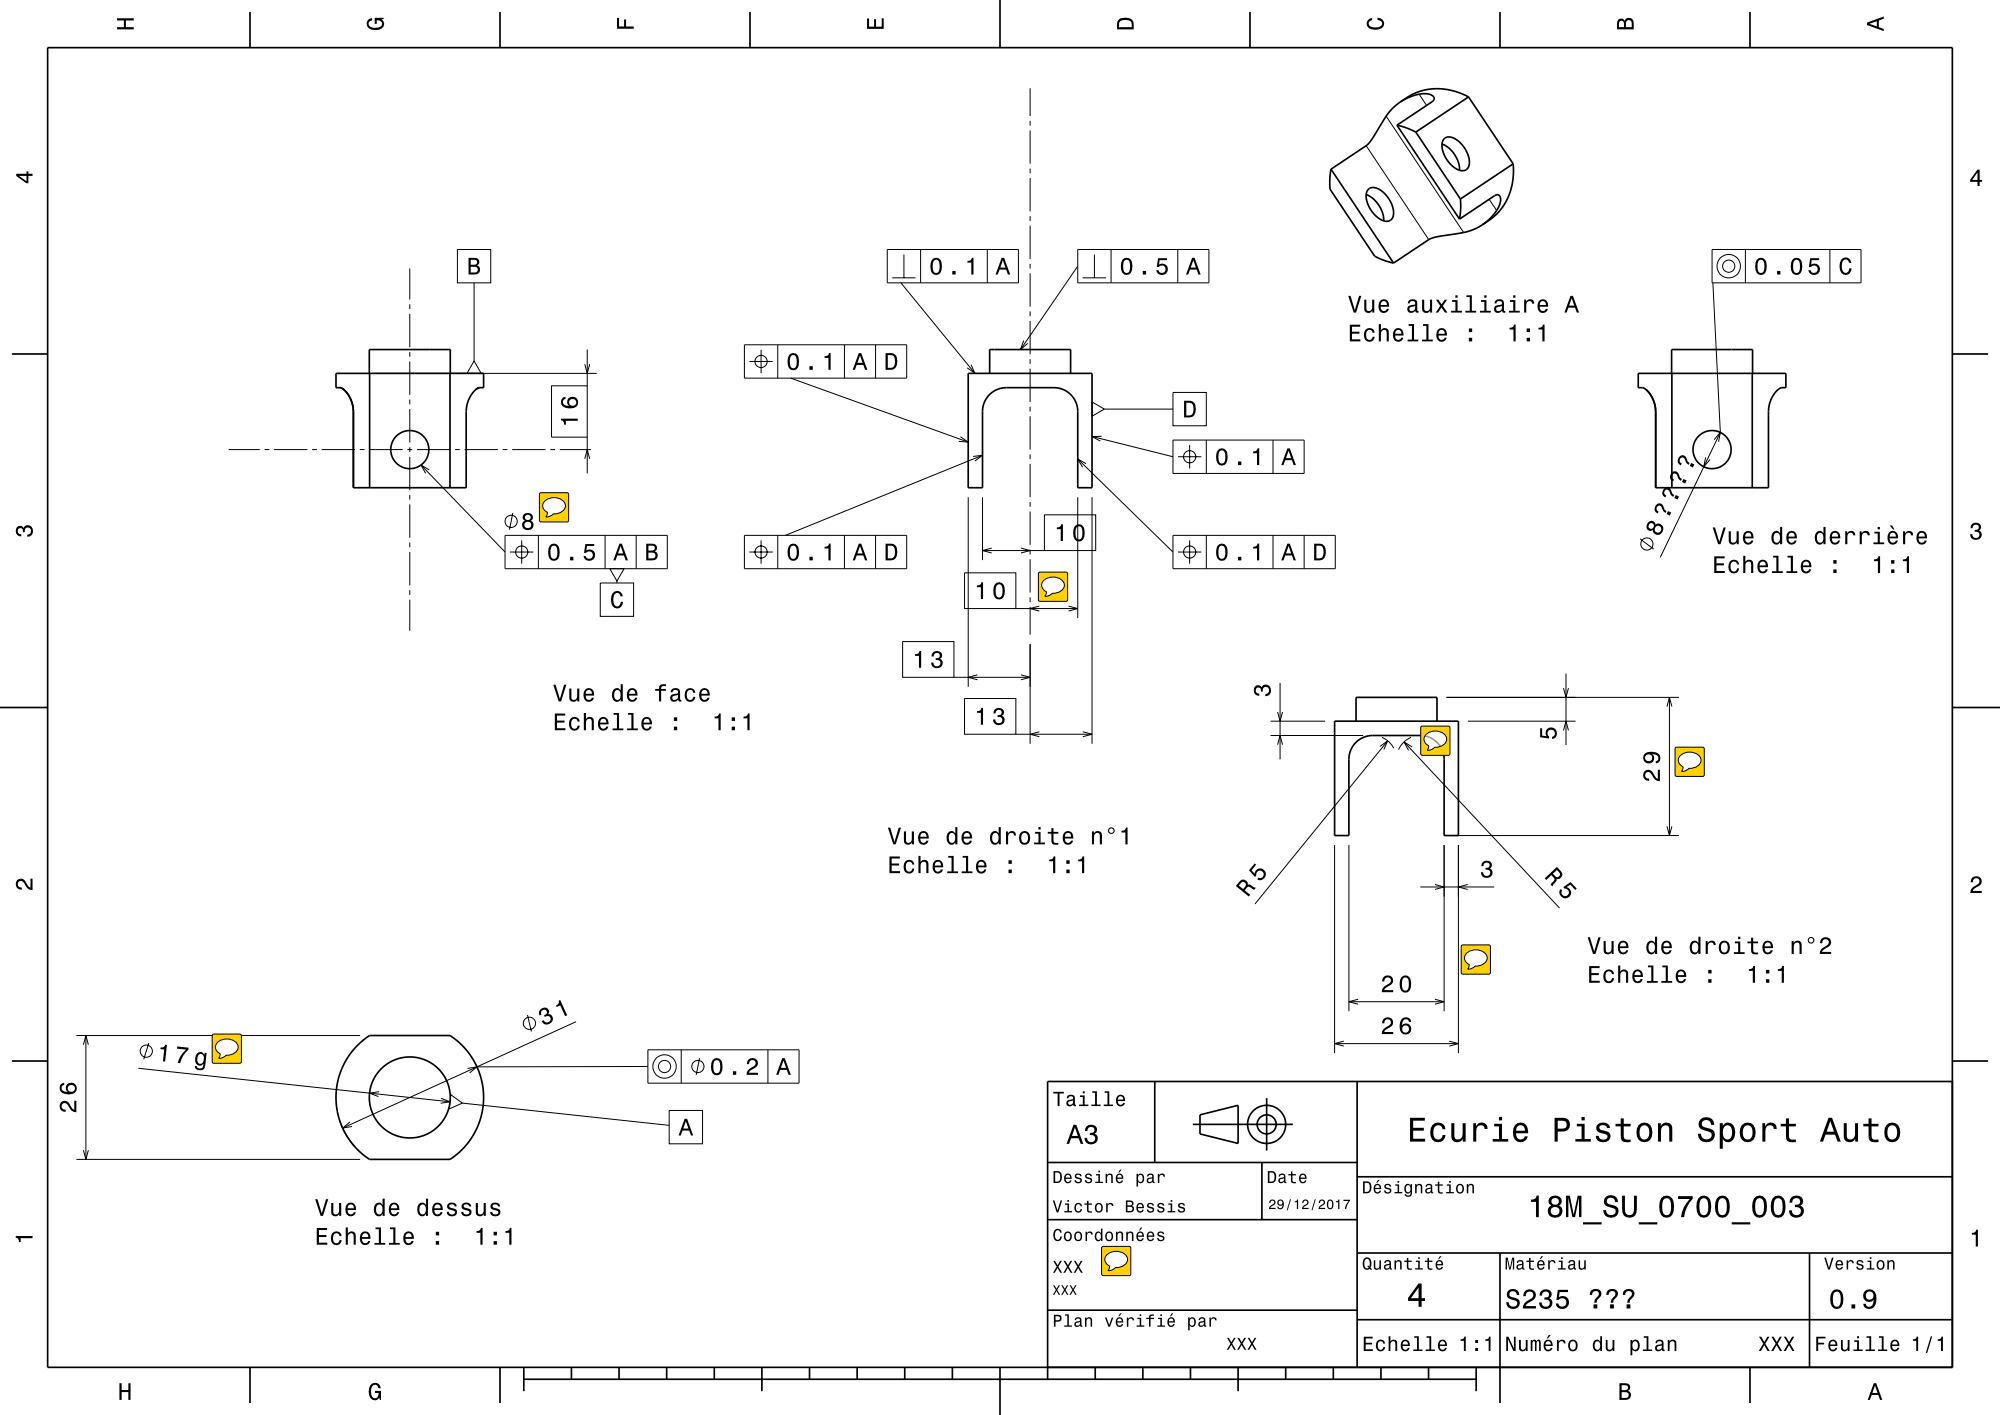
[picture p376: page 1]
