epsa-team/Vulcanix-v1.0/SU - Suspension/test en traction/plan_entretoise.pdf

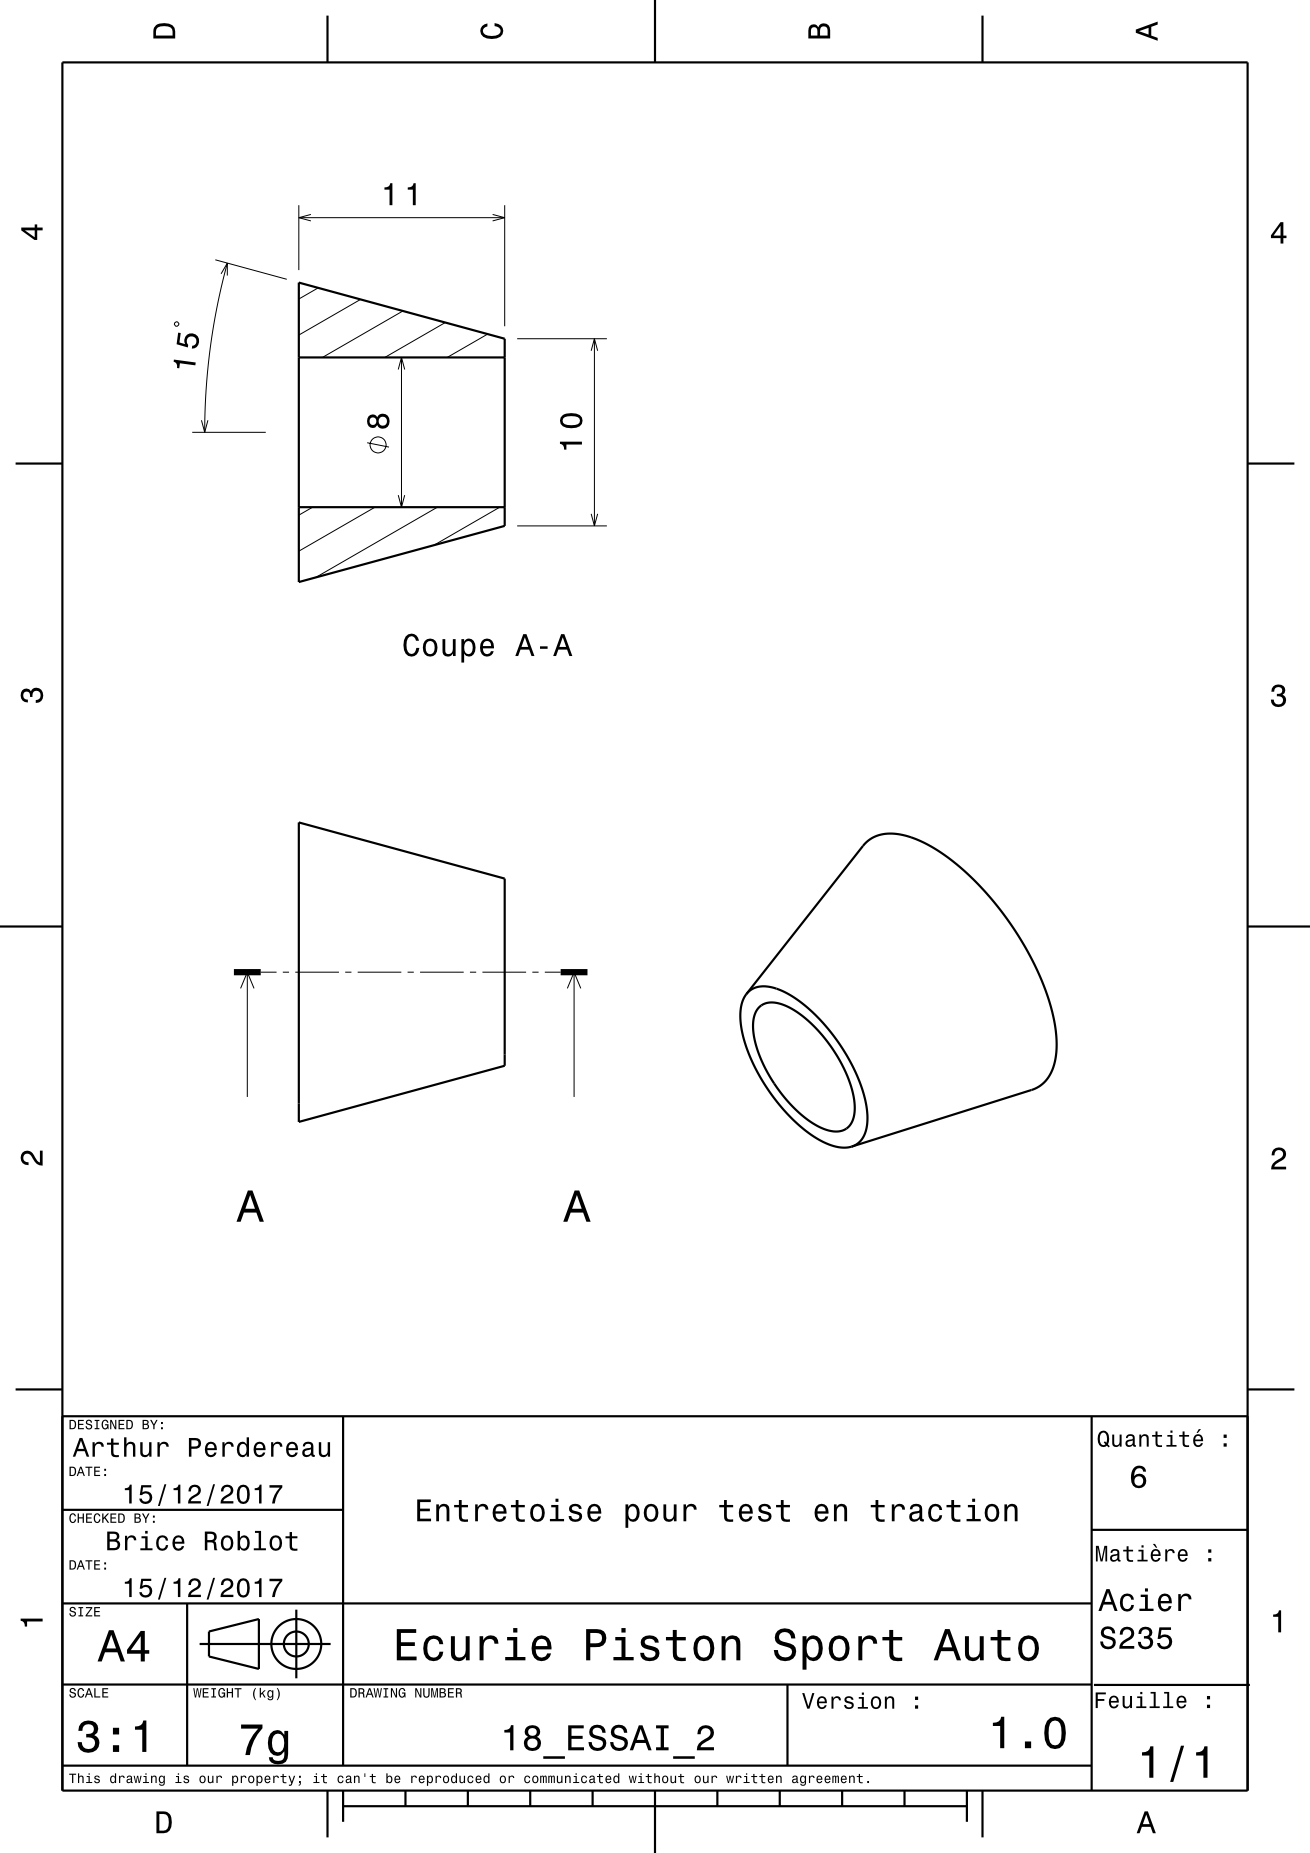
[picture p377: page 1]
