epsa-team/Vulcanix-v1.0/SU - Suspension/test en traction/plan_insert.pdf

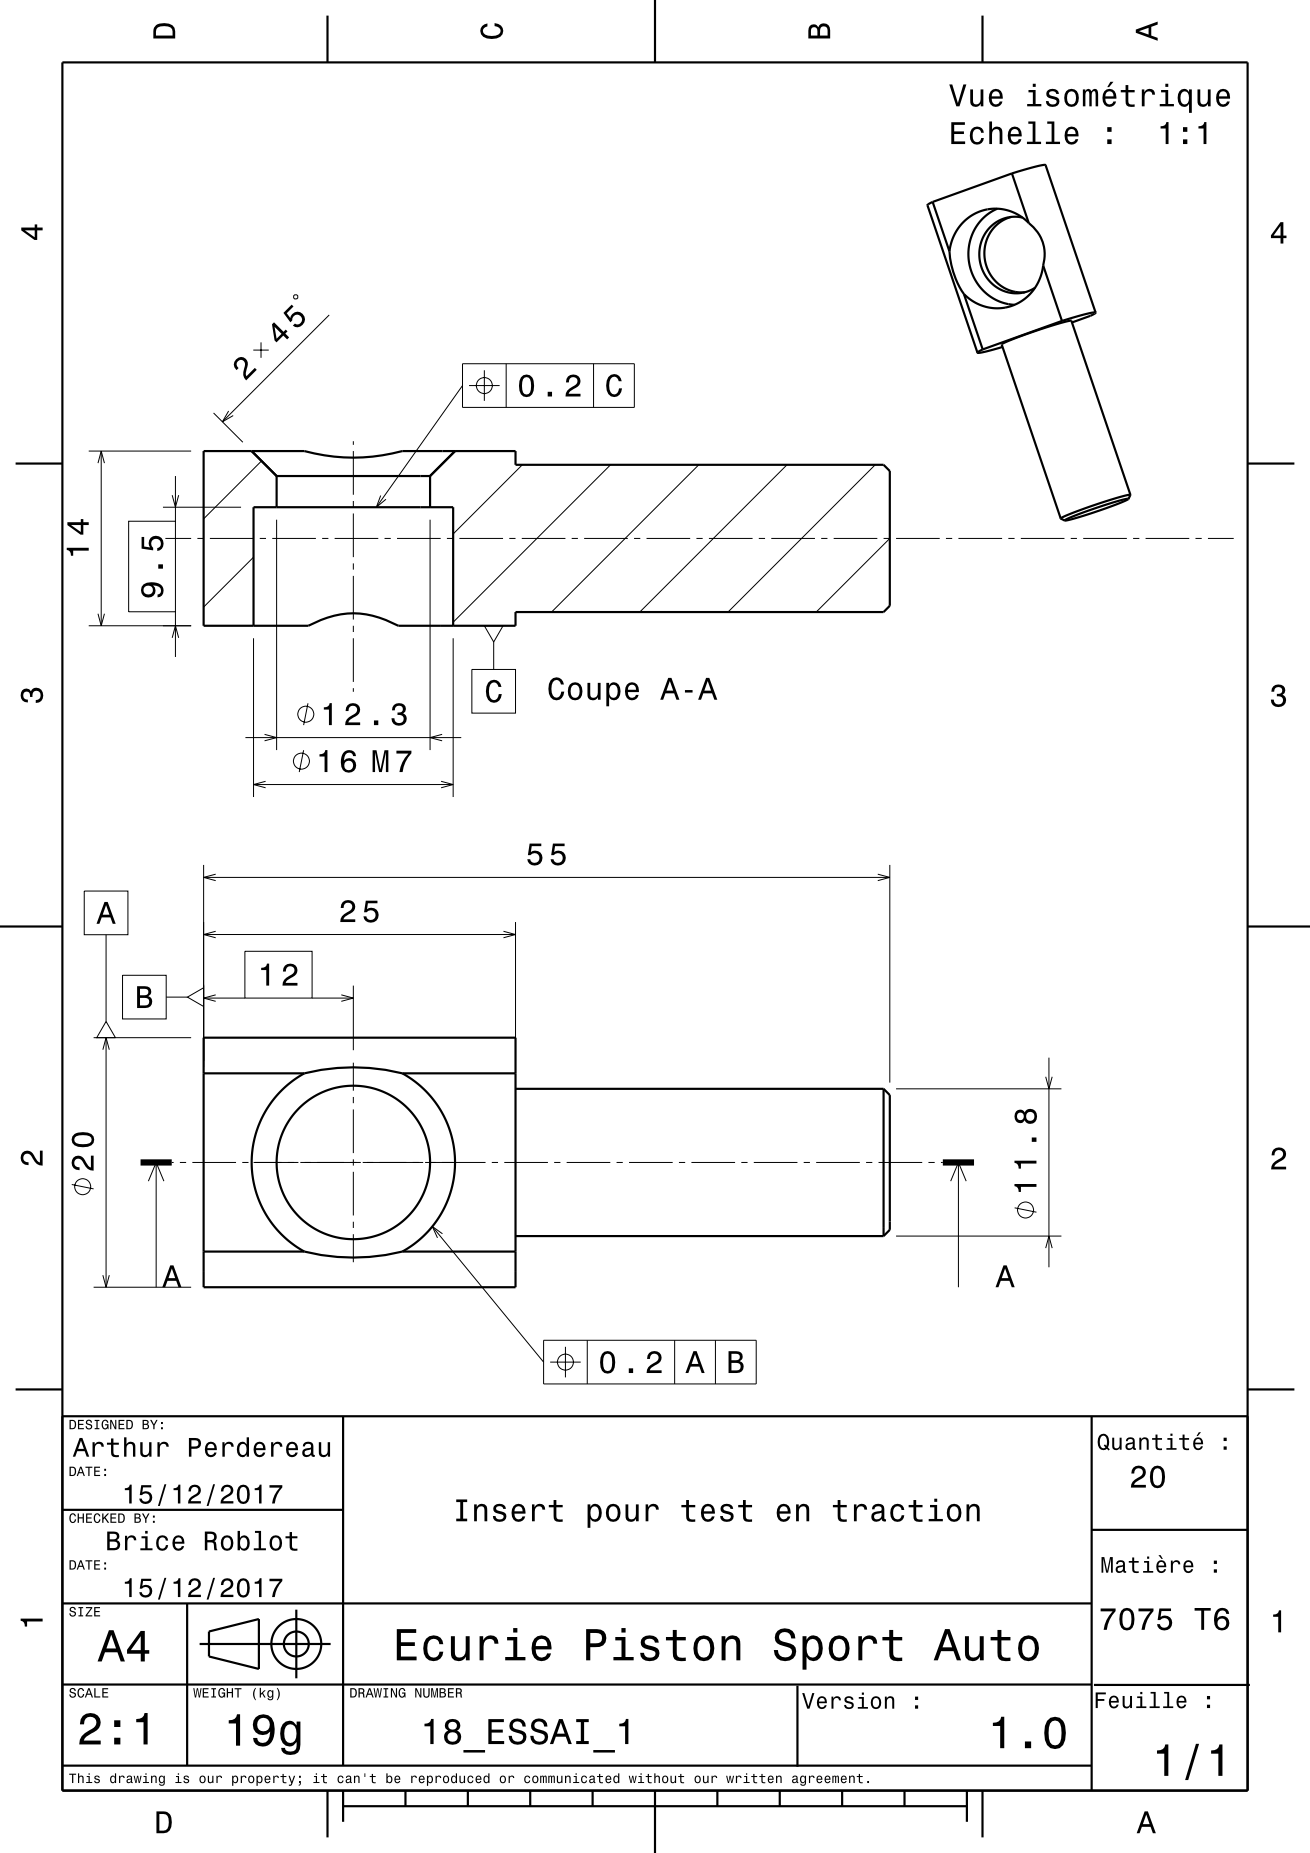
[picture p378: page 1]
