epsa-team/Vulcanix-v1.0/SU - Suspension/test en traction/plan_mors.pdf

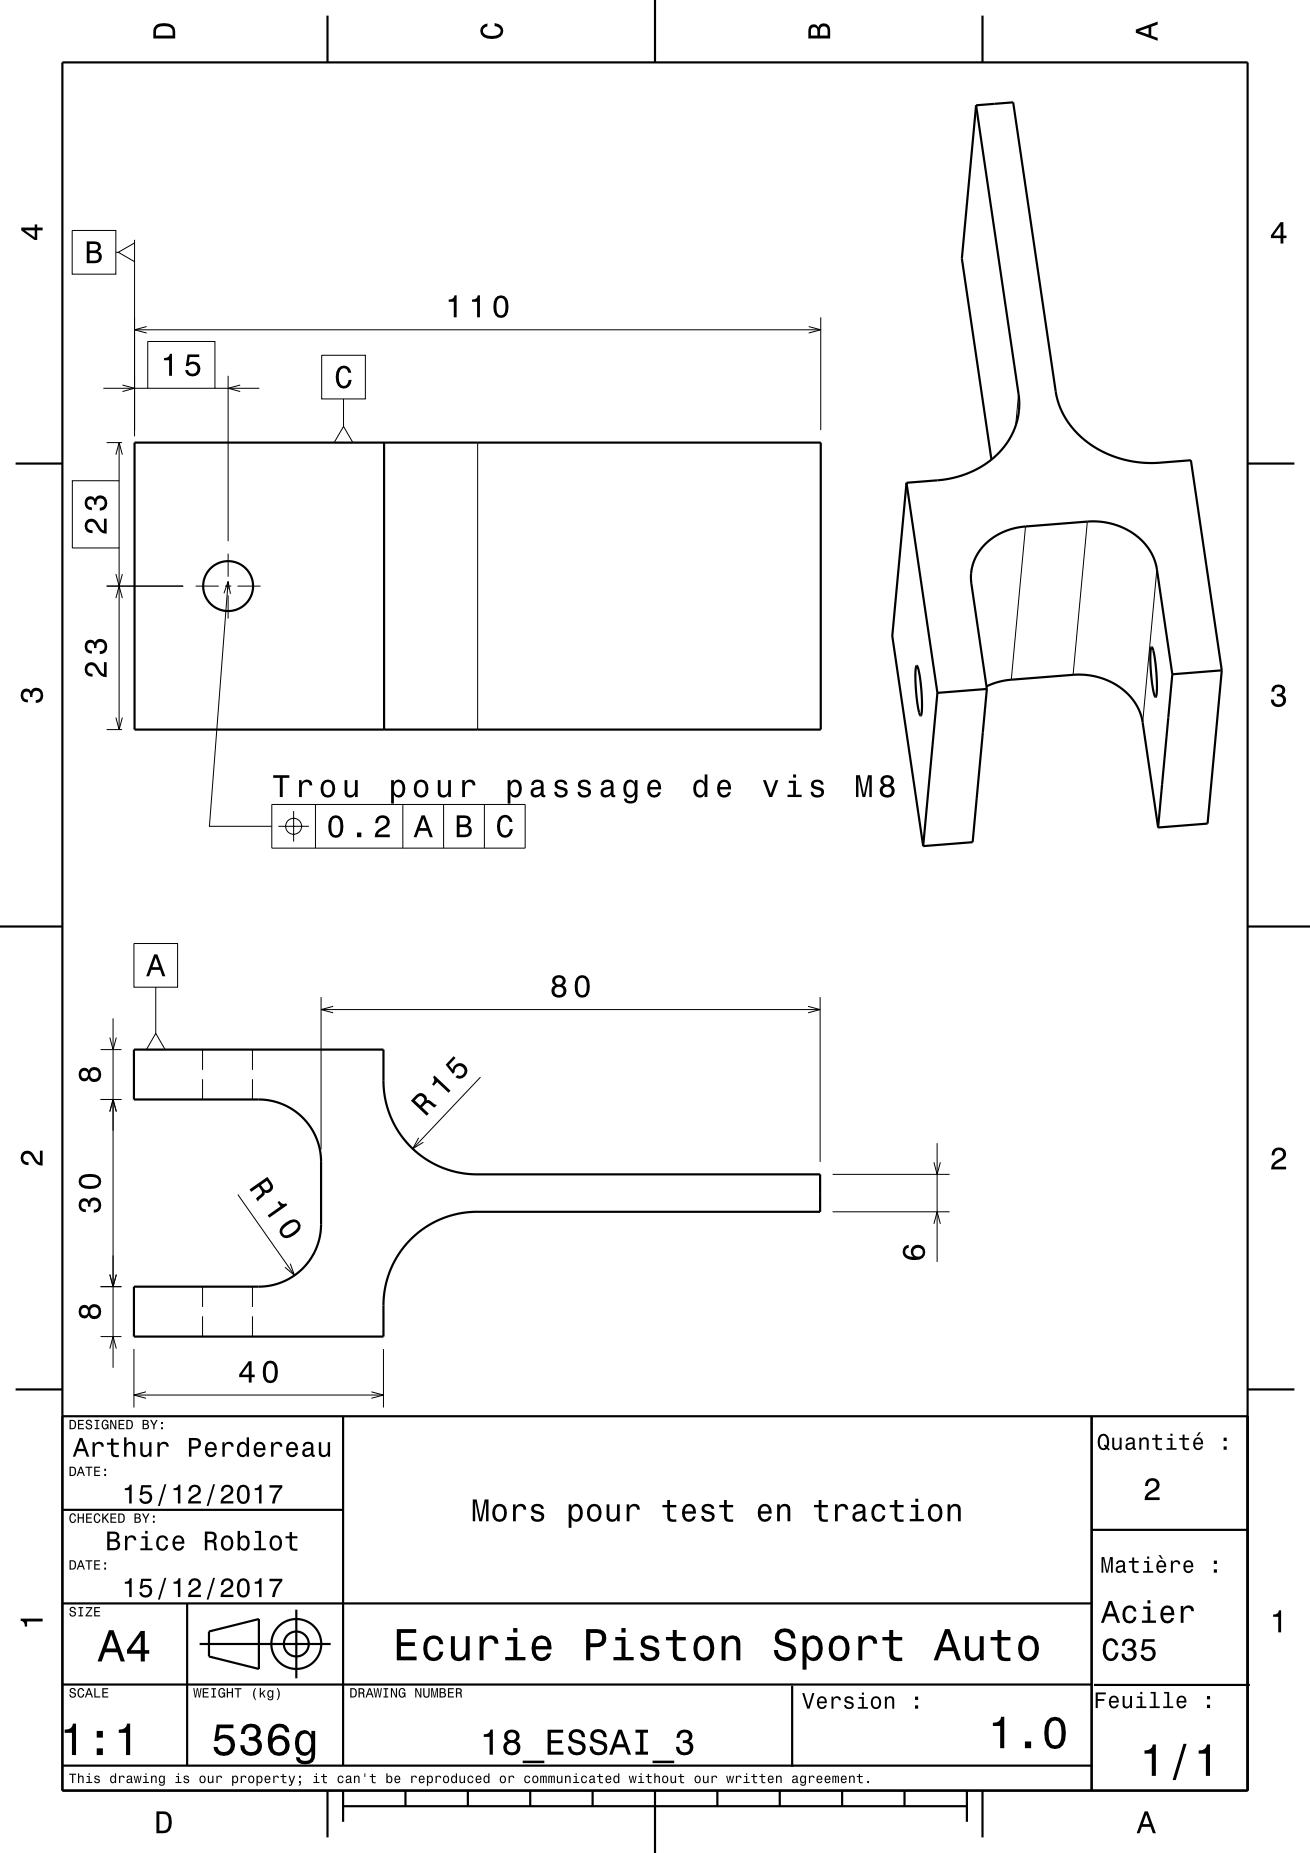
[picture p379: page 1]
