epsa-team/Vulcanix-v1.0/AA. Mise en plan/A verifier/Benjamin Pare-feu V2/Firewall Backtube.pdf

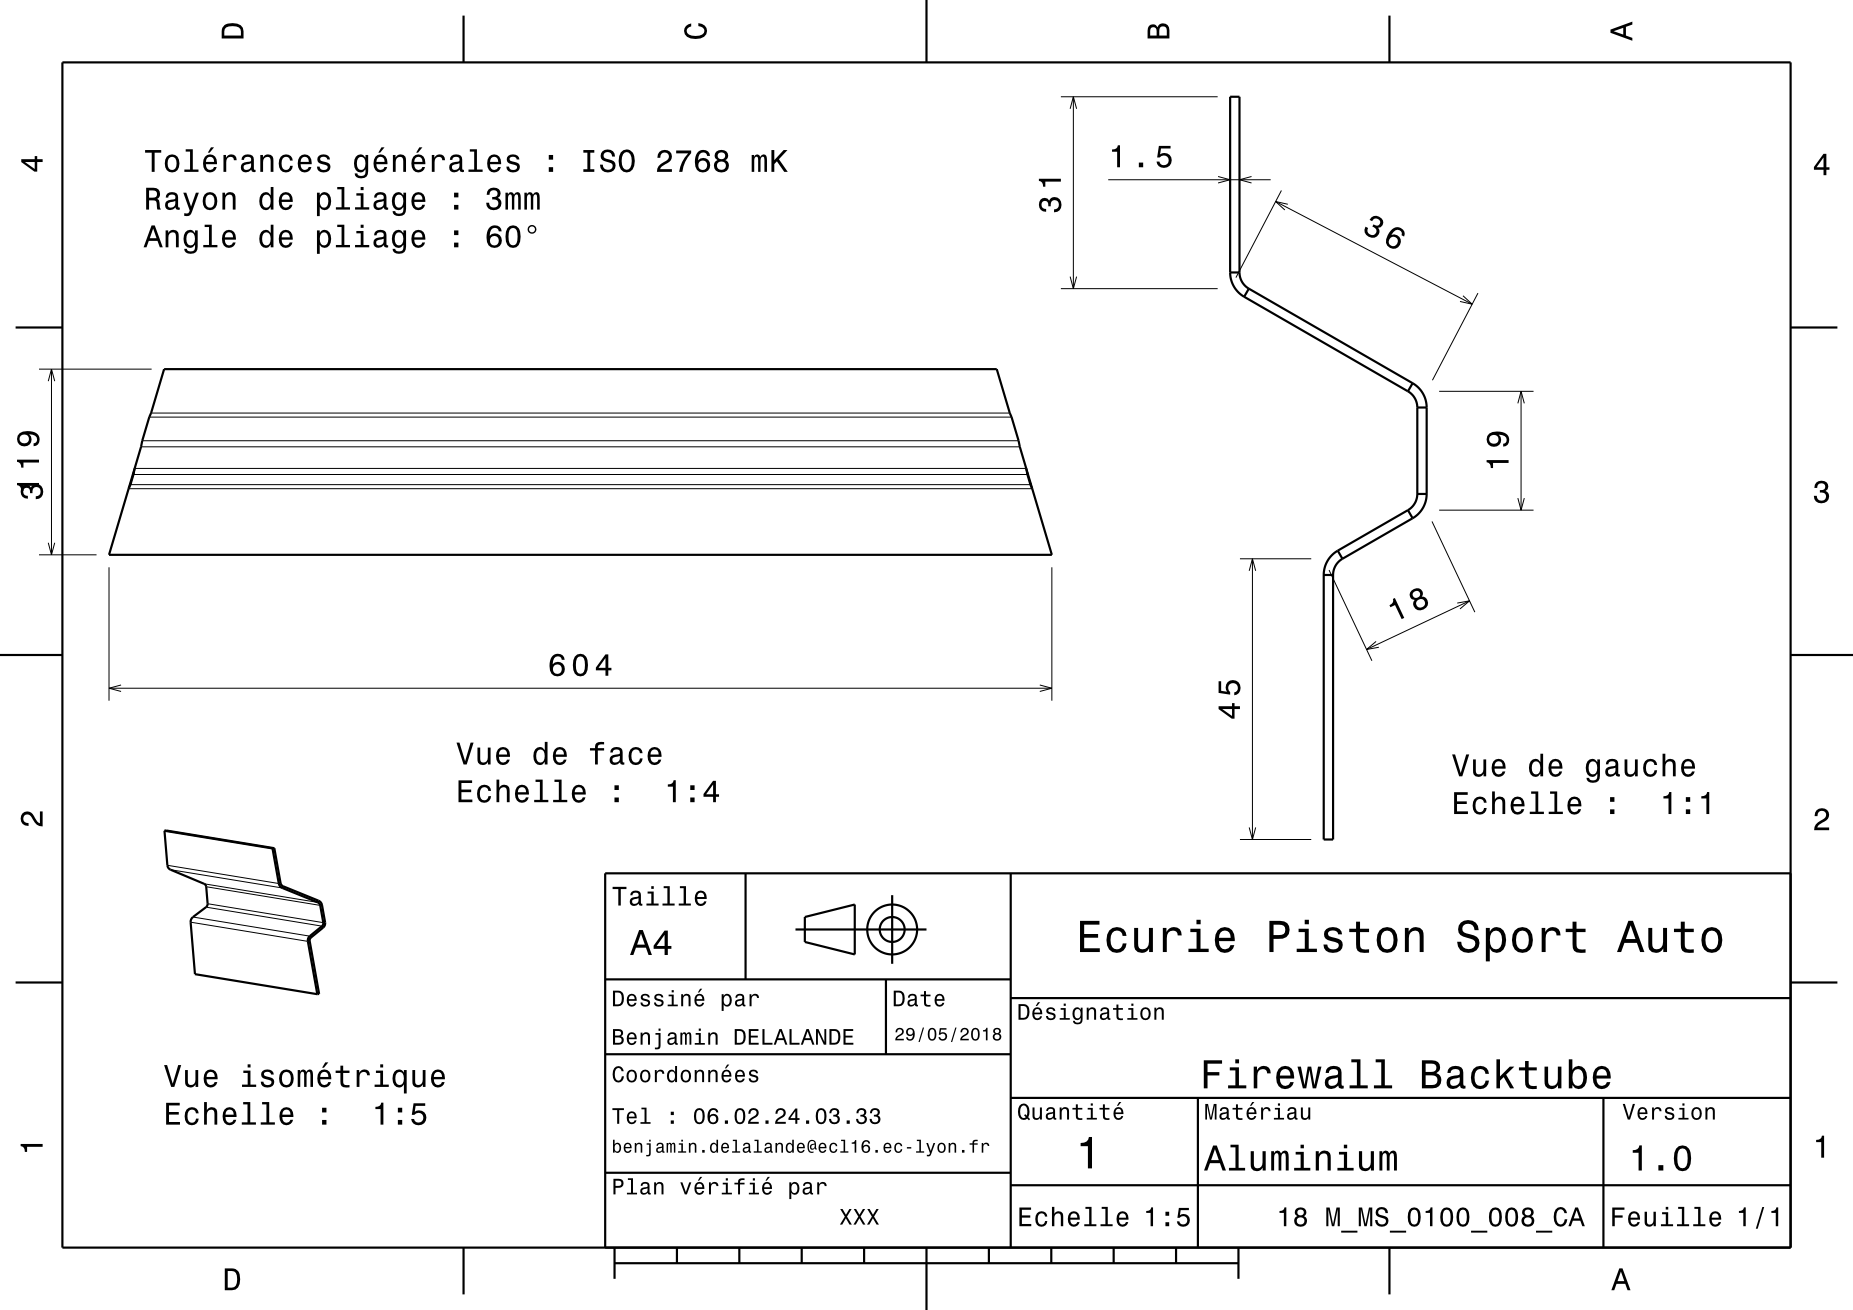
[picture p380: page 1]
