epsa-team/Vulcanix-v1.0/ZZ - Autres/Pushbar v3.0/Plans/Nomenclature_pushbar.pdf

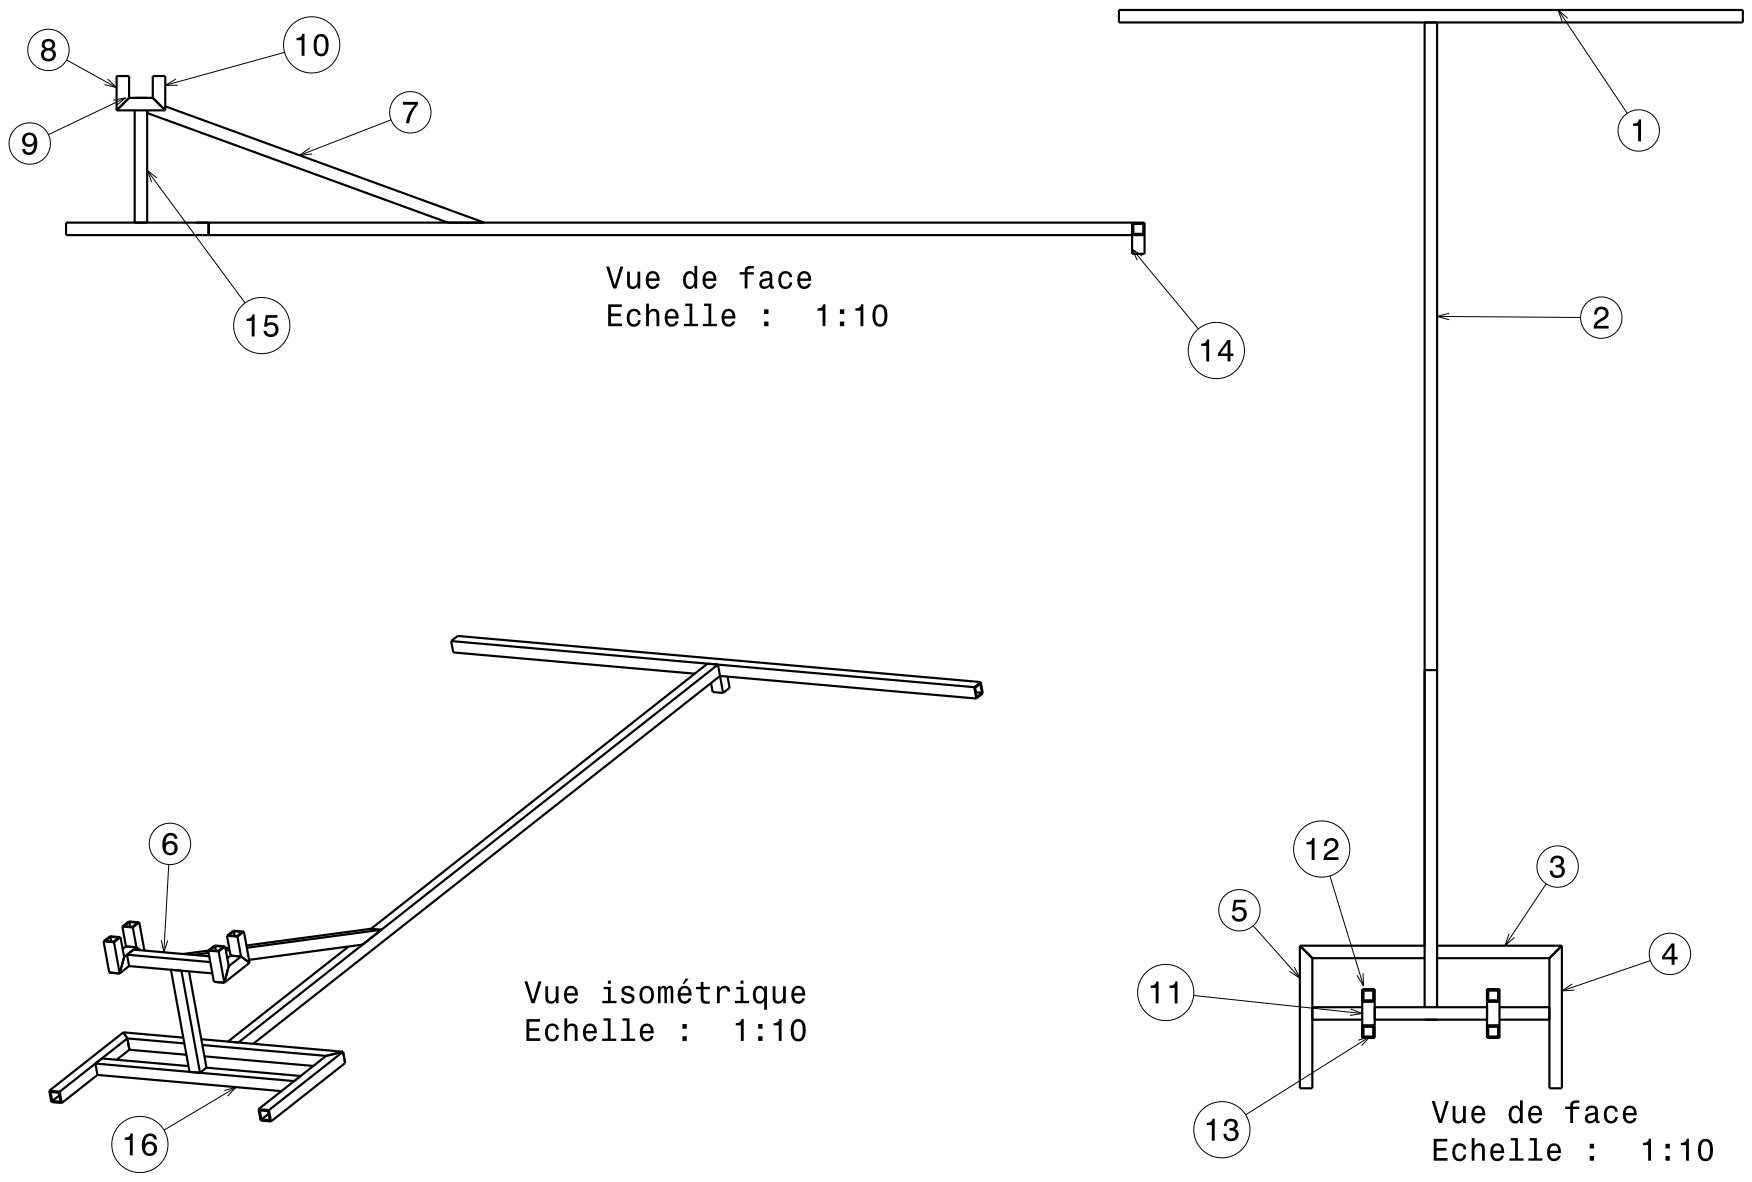
[picture p381: page 1]
