epsa-team/Vulcanix-v1.0/AA. Mise en plan/A verifier/Benjamin Fond plat/FR_0400_001_BA.pdf

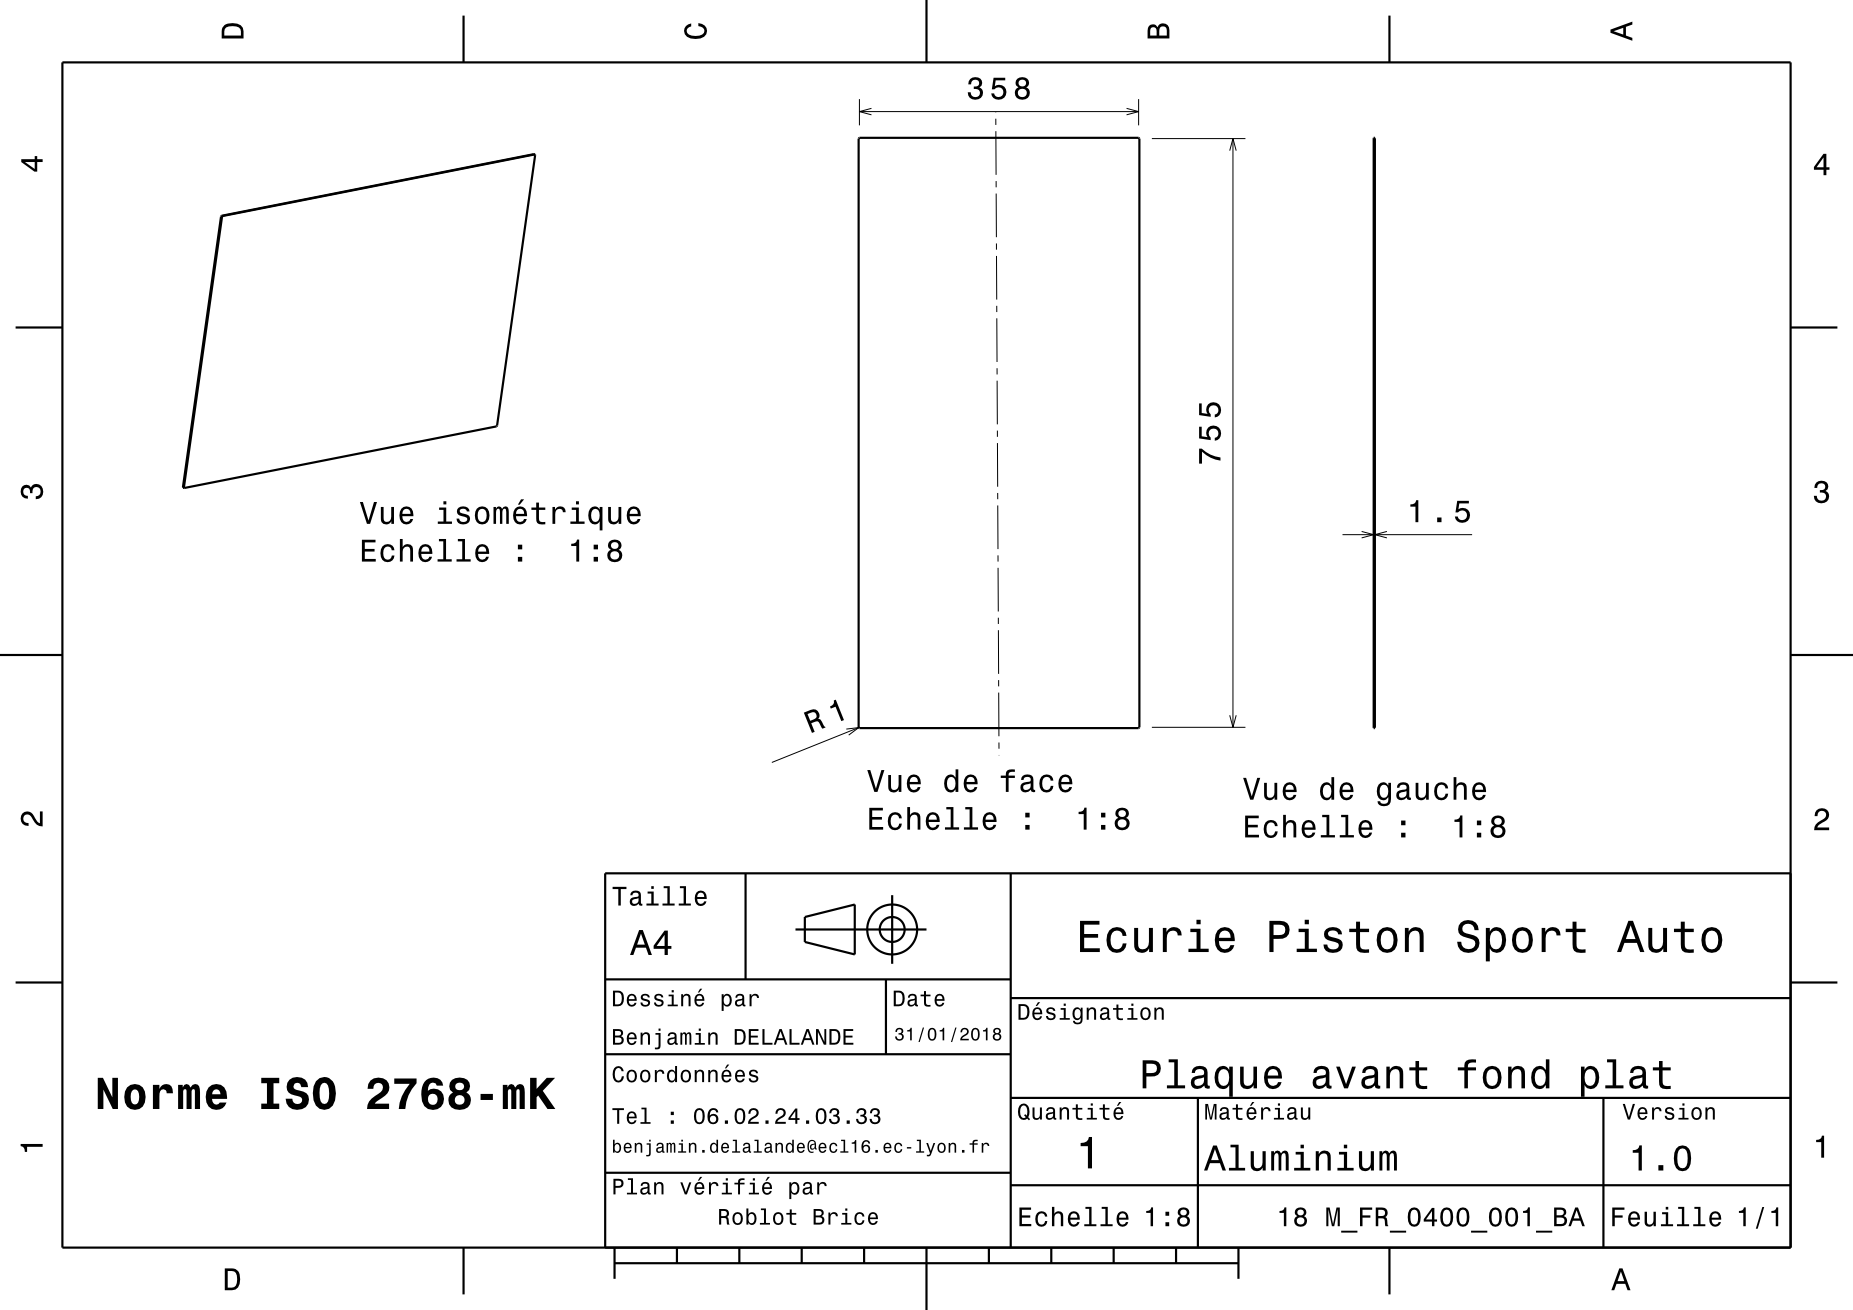
[picture p382: page 1]
