epsa-team/Vulcanix-v1.0/AA. Mise en plan/A verifier/Benjamin Fond plat/FR_0400_002_BA.pdf

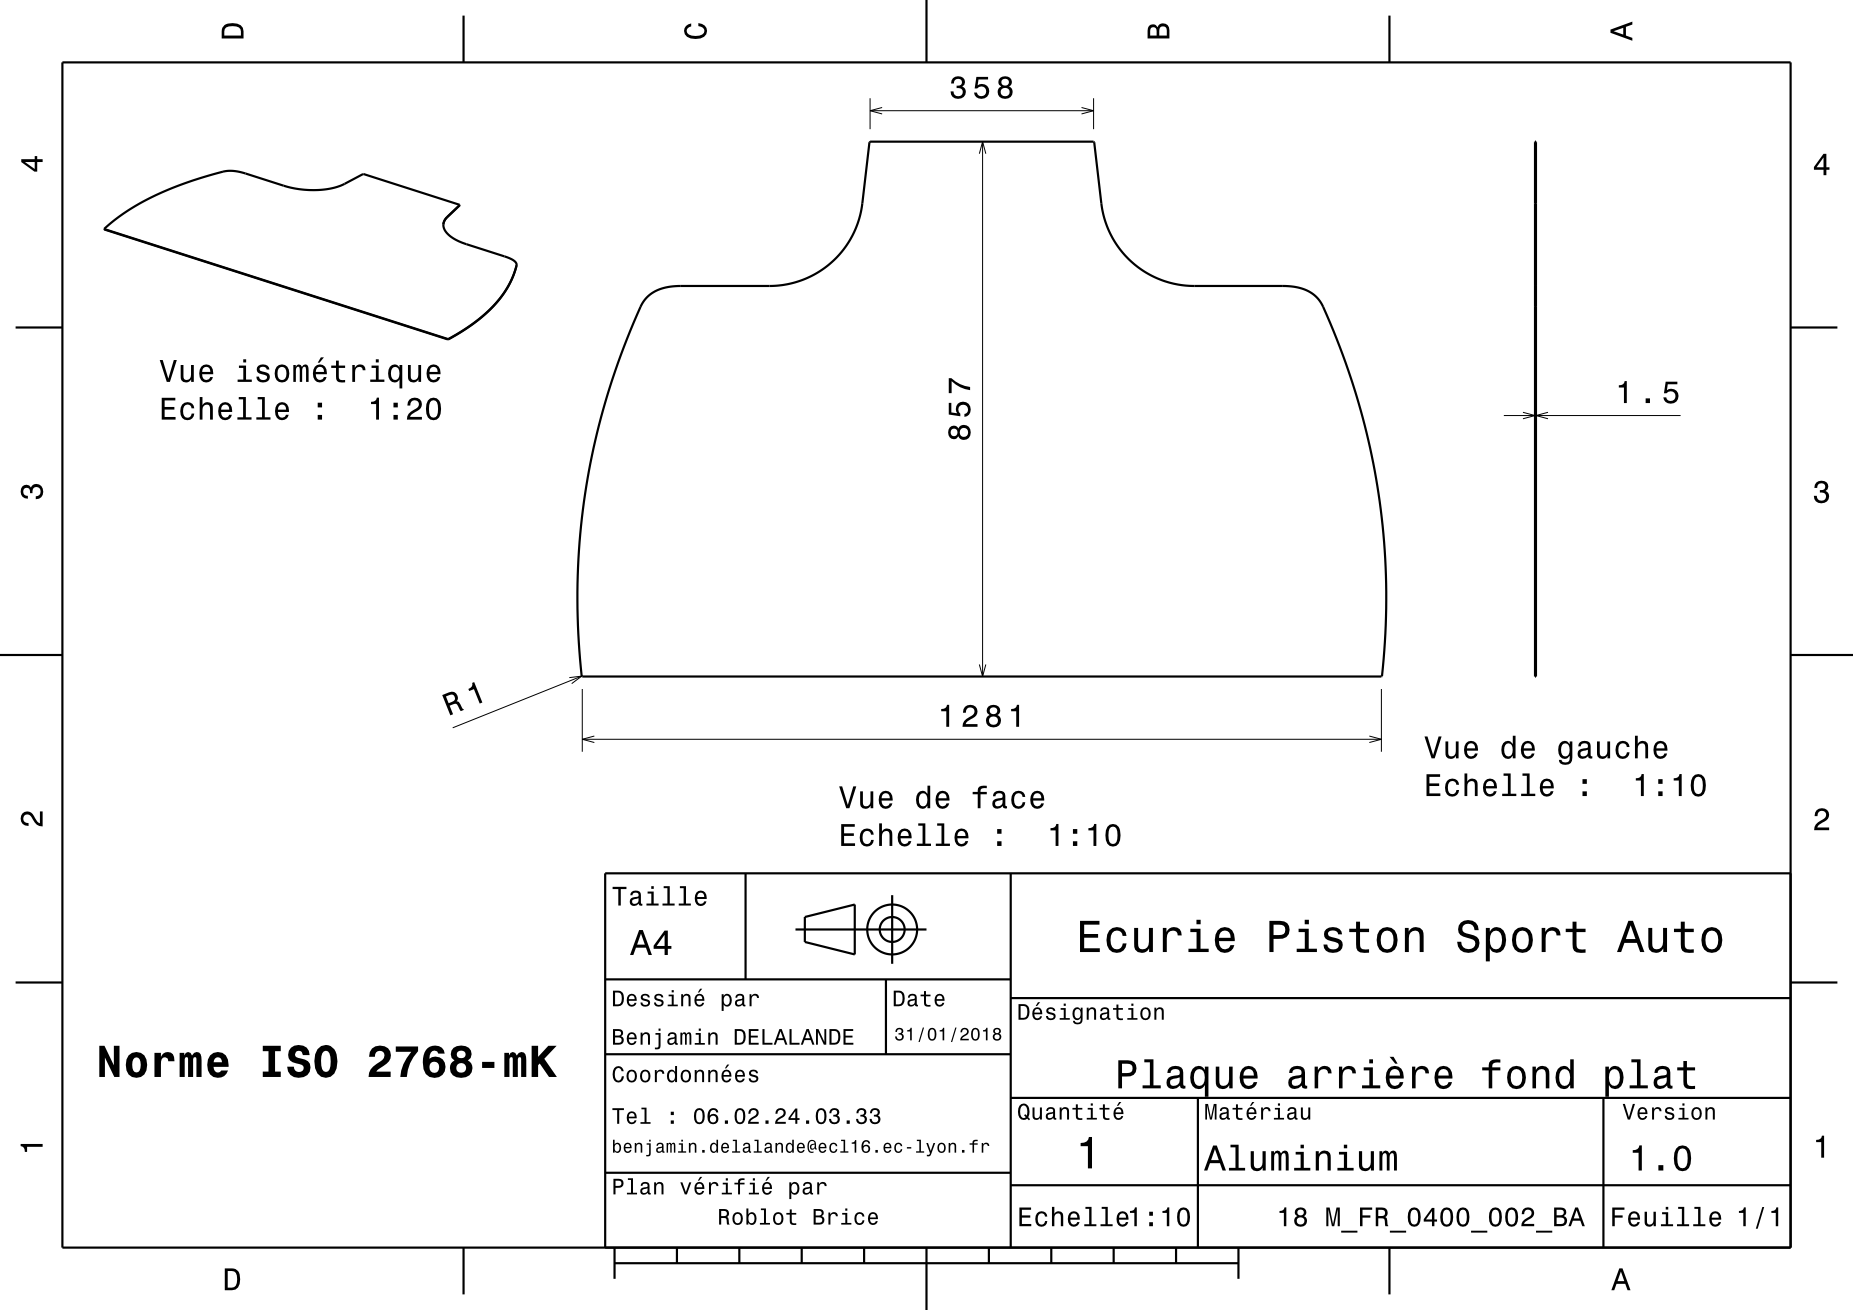
[picture p383: page 1]
