epsa-team/Vulcanix-v1.0/AA. Mise en plan/A verifier/Benjamin Pare-feu V2/Firewall Bottom back.pdf

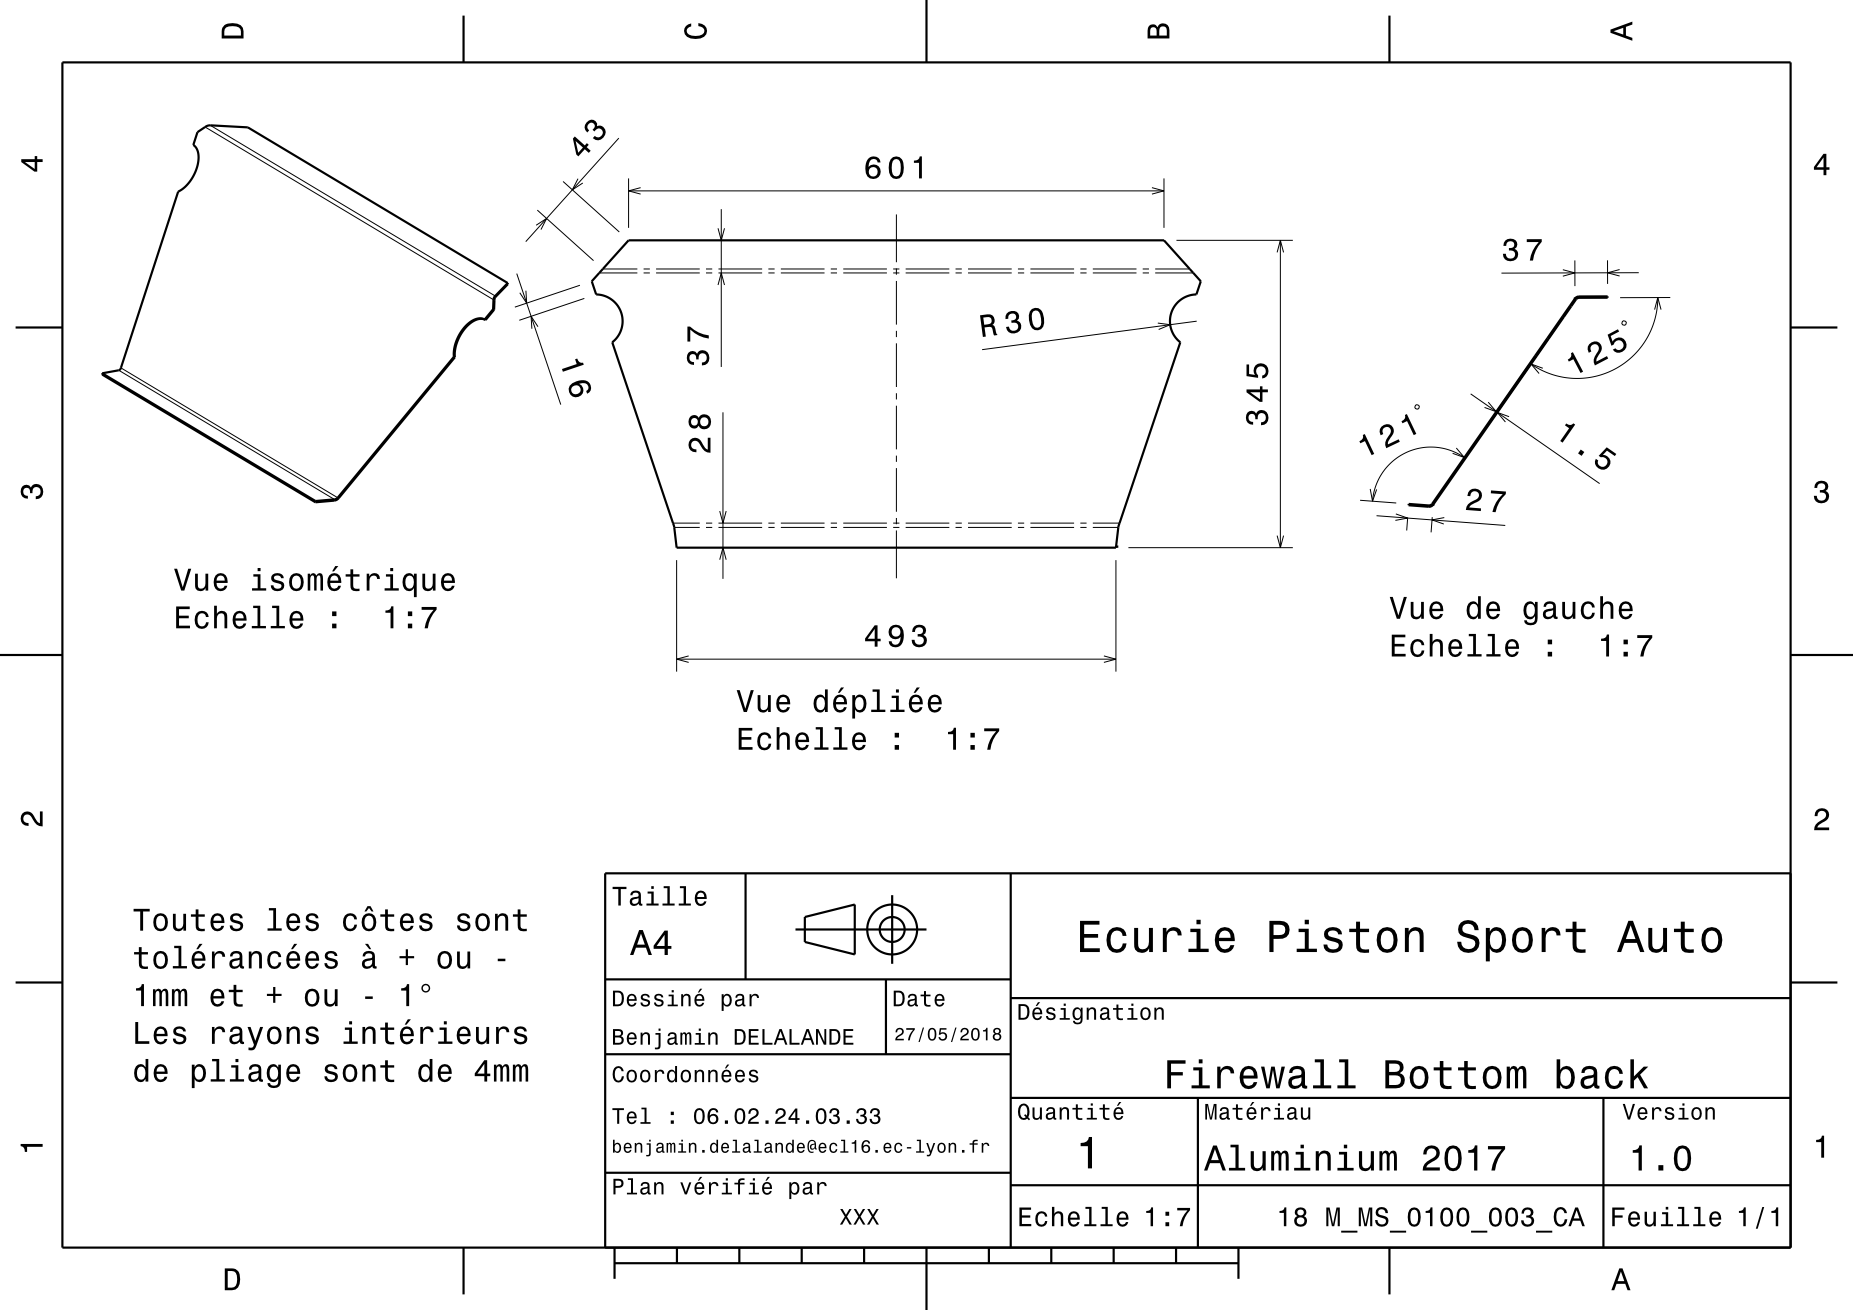
[picture p384: page 1]
