epsa-team/Vulcanix-v1.0/AA. Mise en plan/A verifier/Benjamin Pare-feu V2/Firewall Bottom Side.pdf

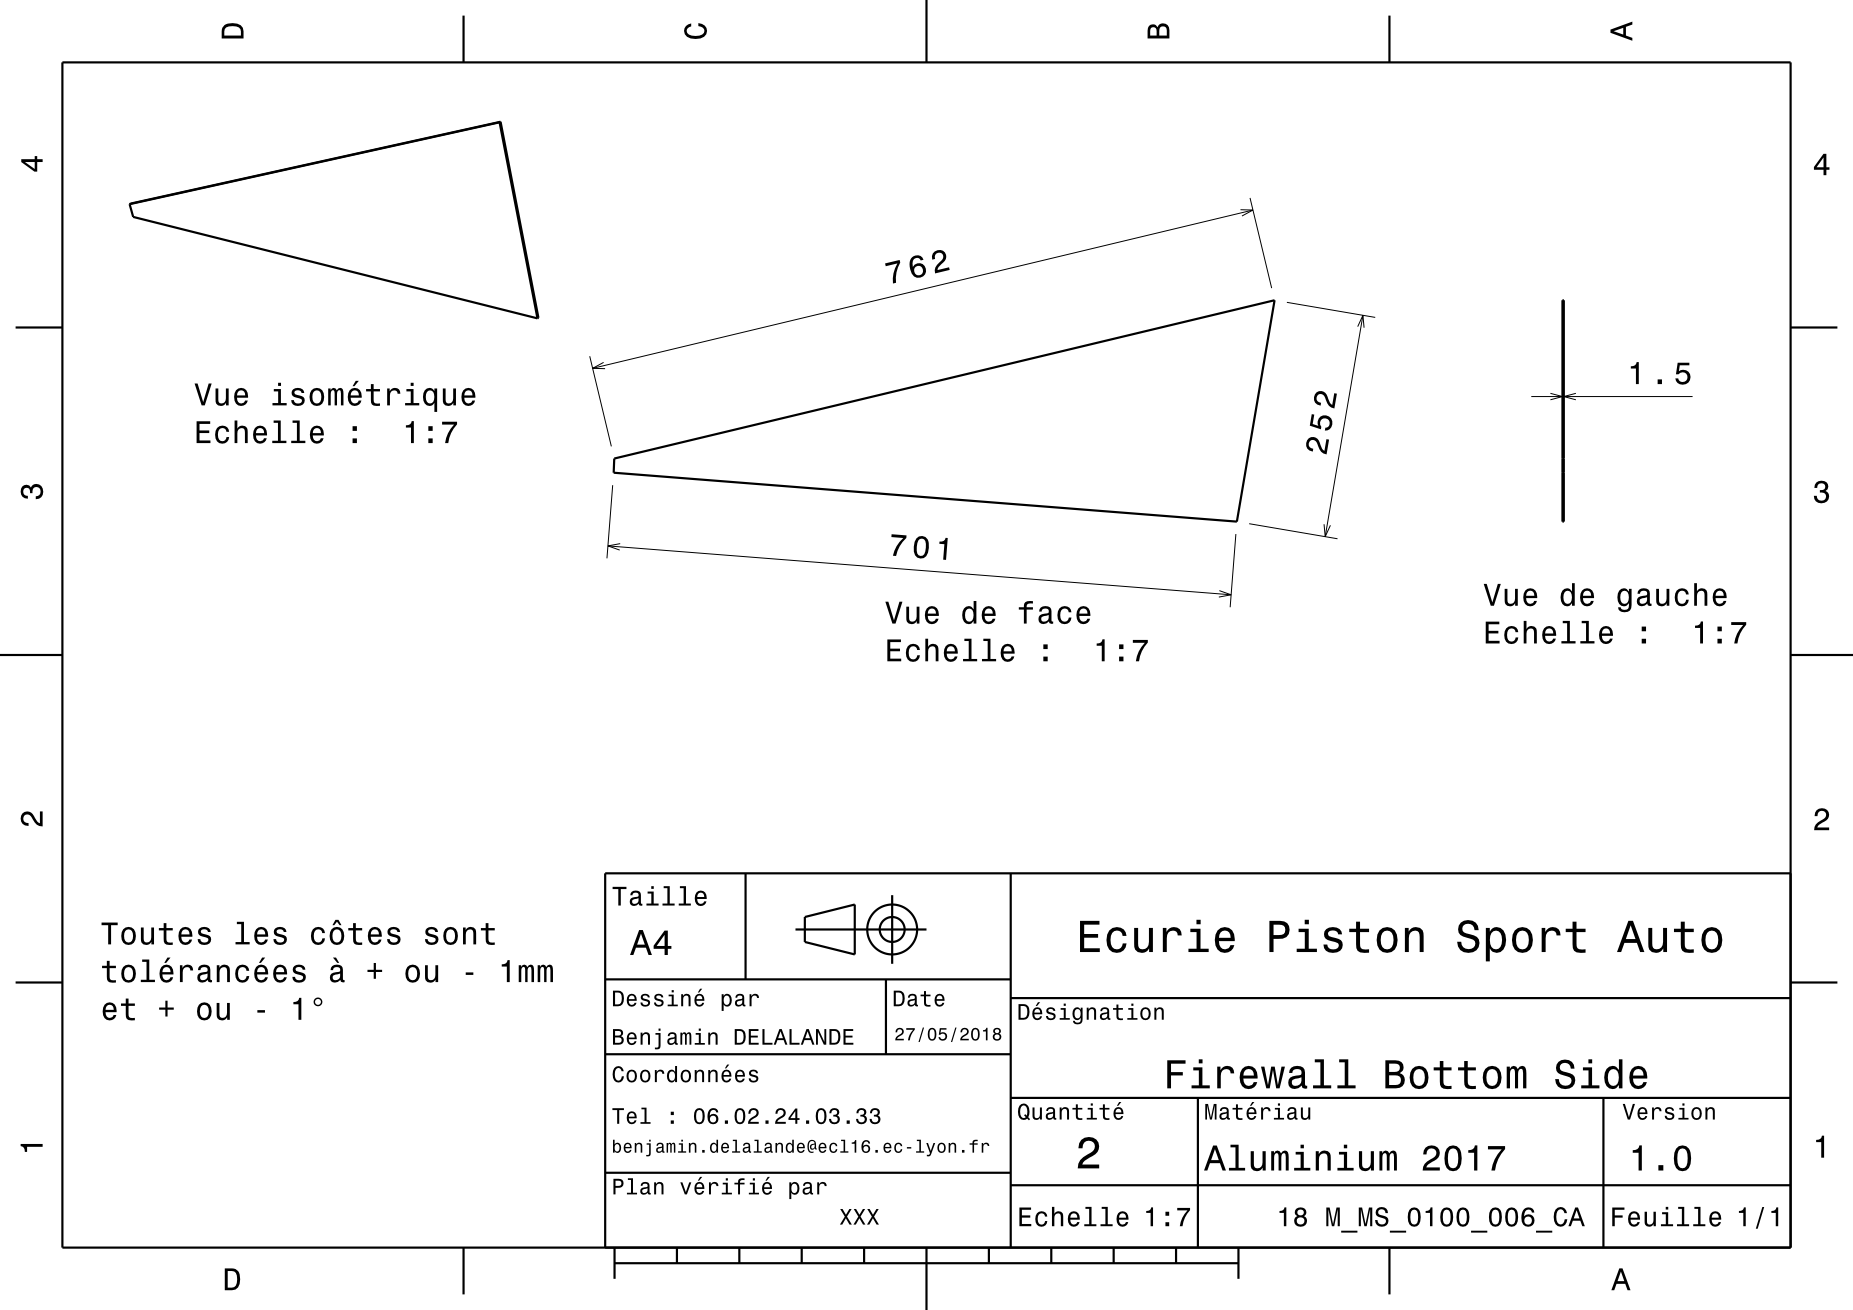
[picture p385: page 1]
