epsa-team/Vulcanix-v1.0/AA. Mise en plan/A verifier/Benjamin Pare-feu V2/Firewall Middle Horizontal back.pdf

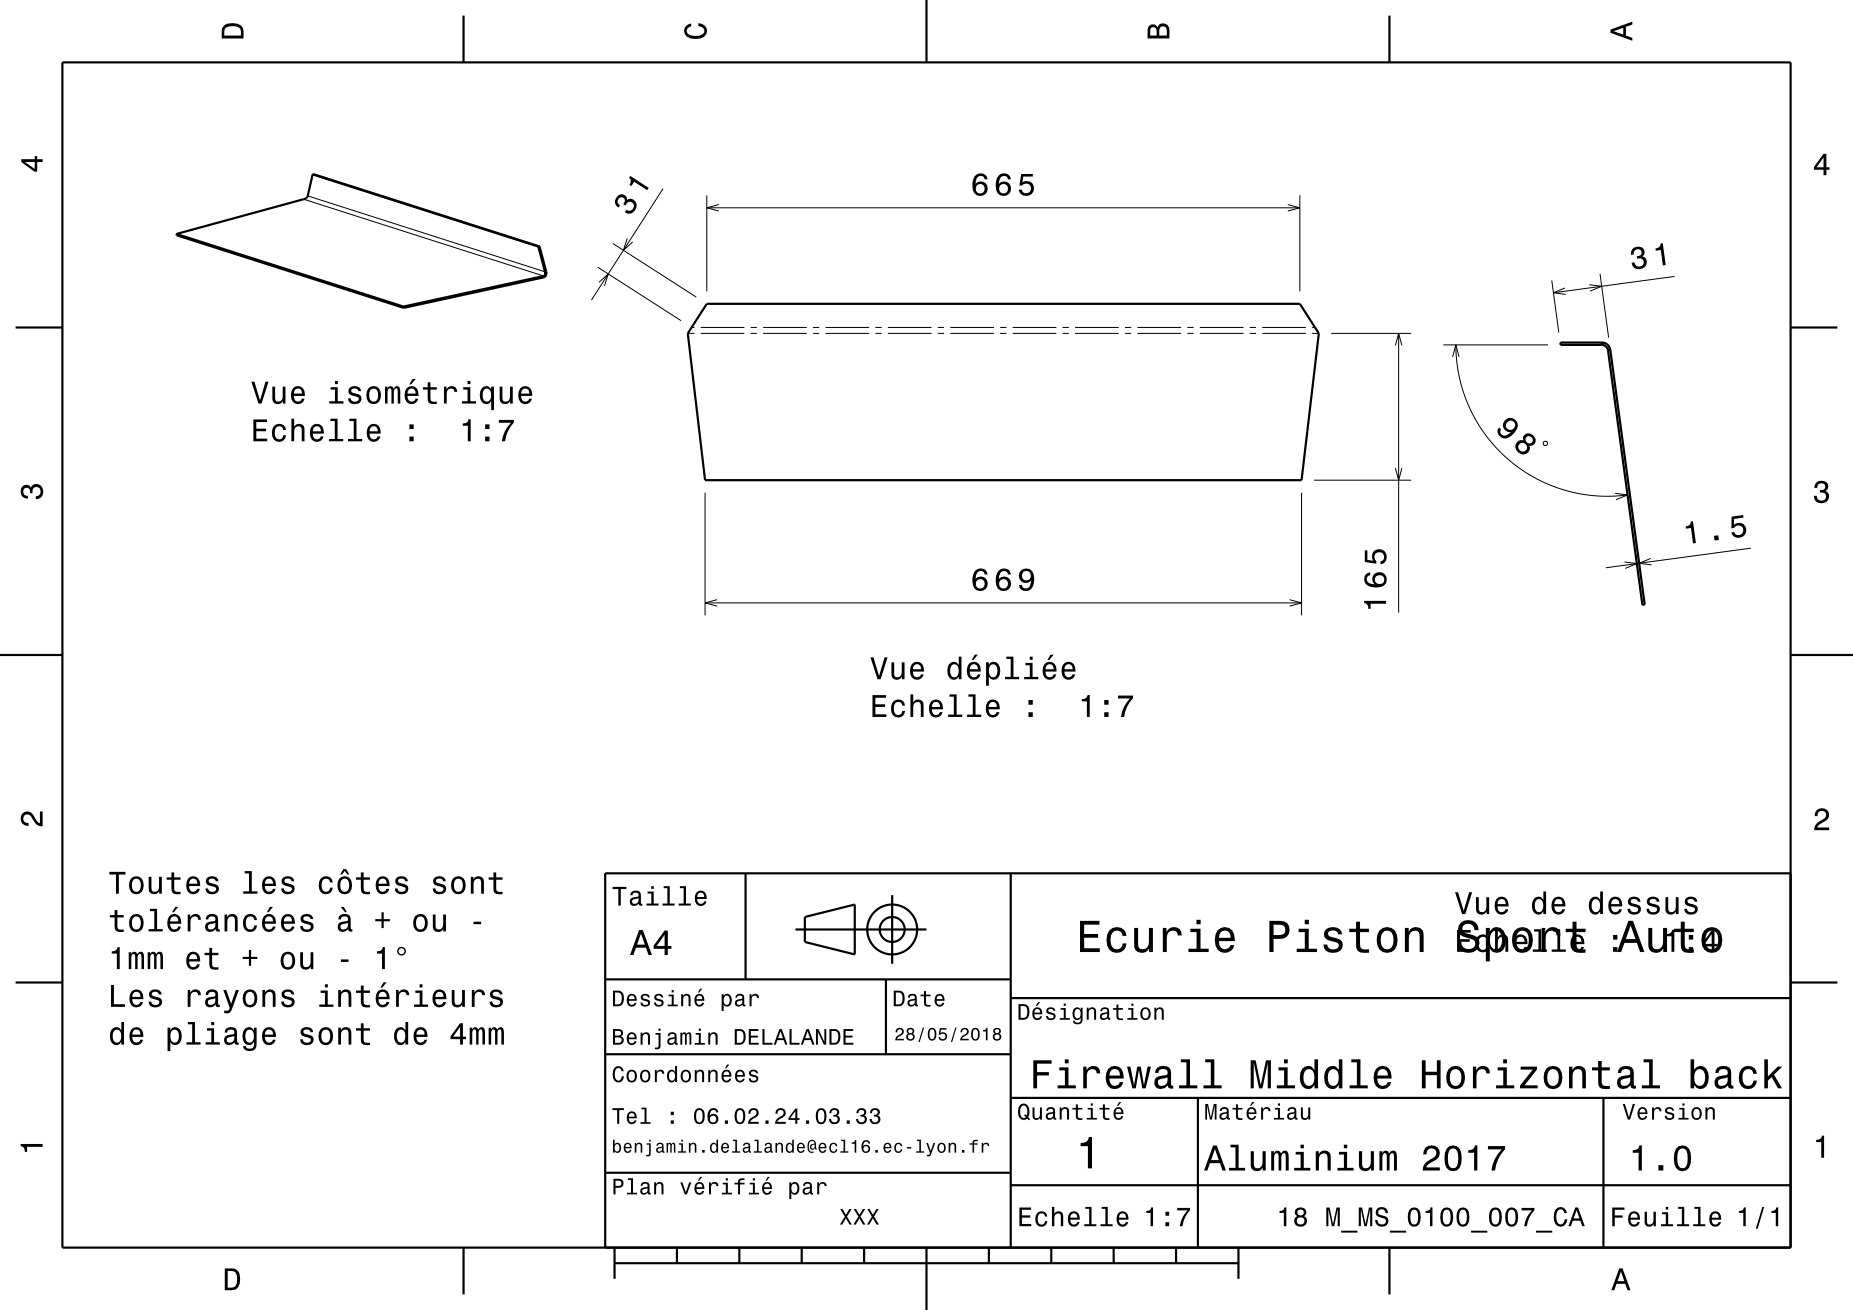
[picture p387: page 1]
