epsa-team/Vulcanix-v1.0/AA. Mise en plan/Verifie/Usinage arbres de transmission ADE/EN_1000_001.pdf

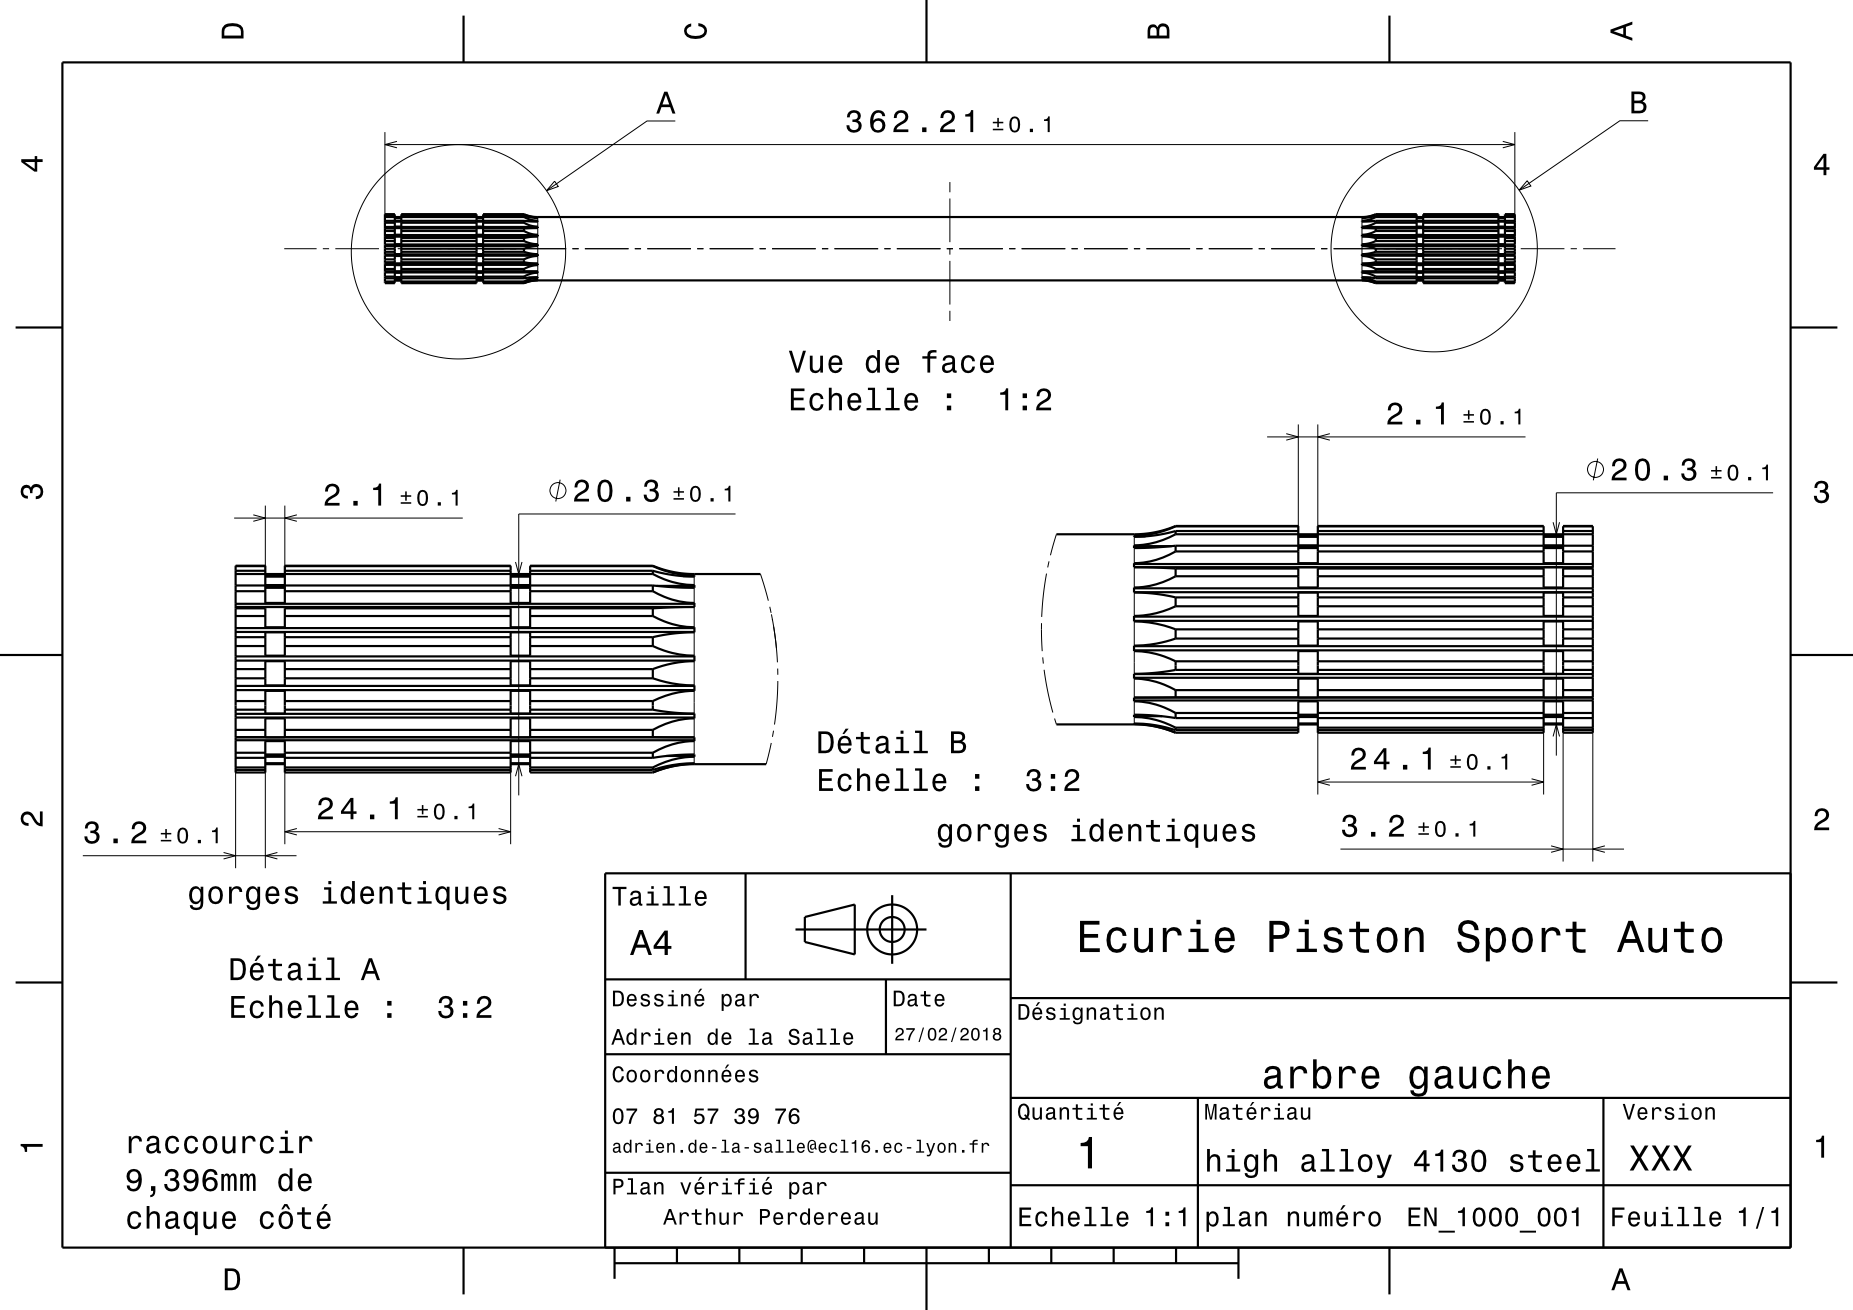
[picture p391: page 1]
