epsa-team/Vulcanix-v1.0/AA. Mise en plan/Verifie/Usinage arbres de transmission ADE/EN_1000_002.pdf

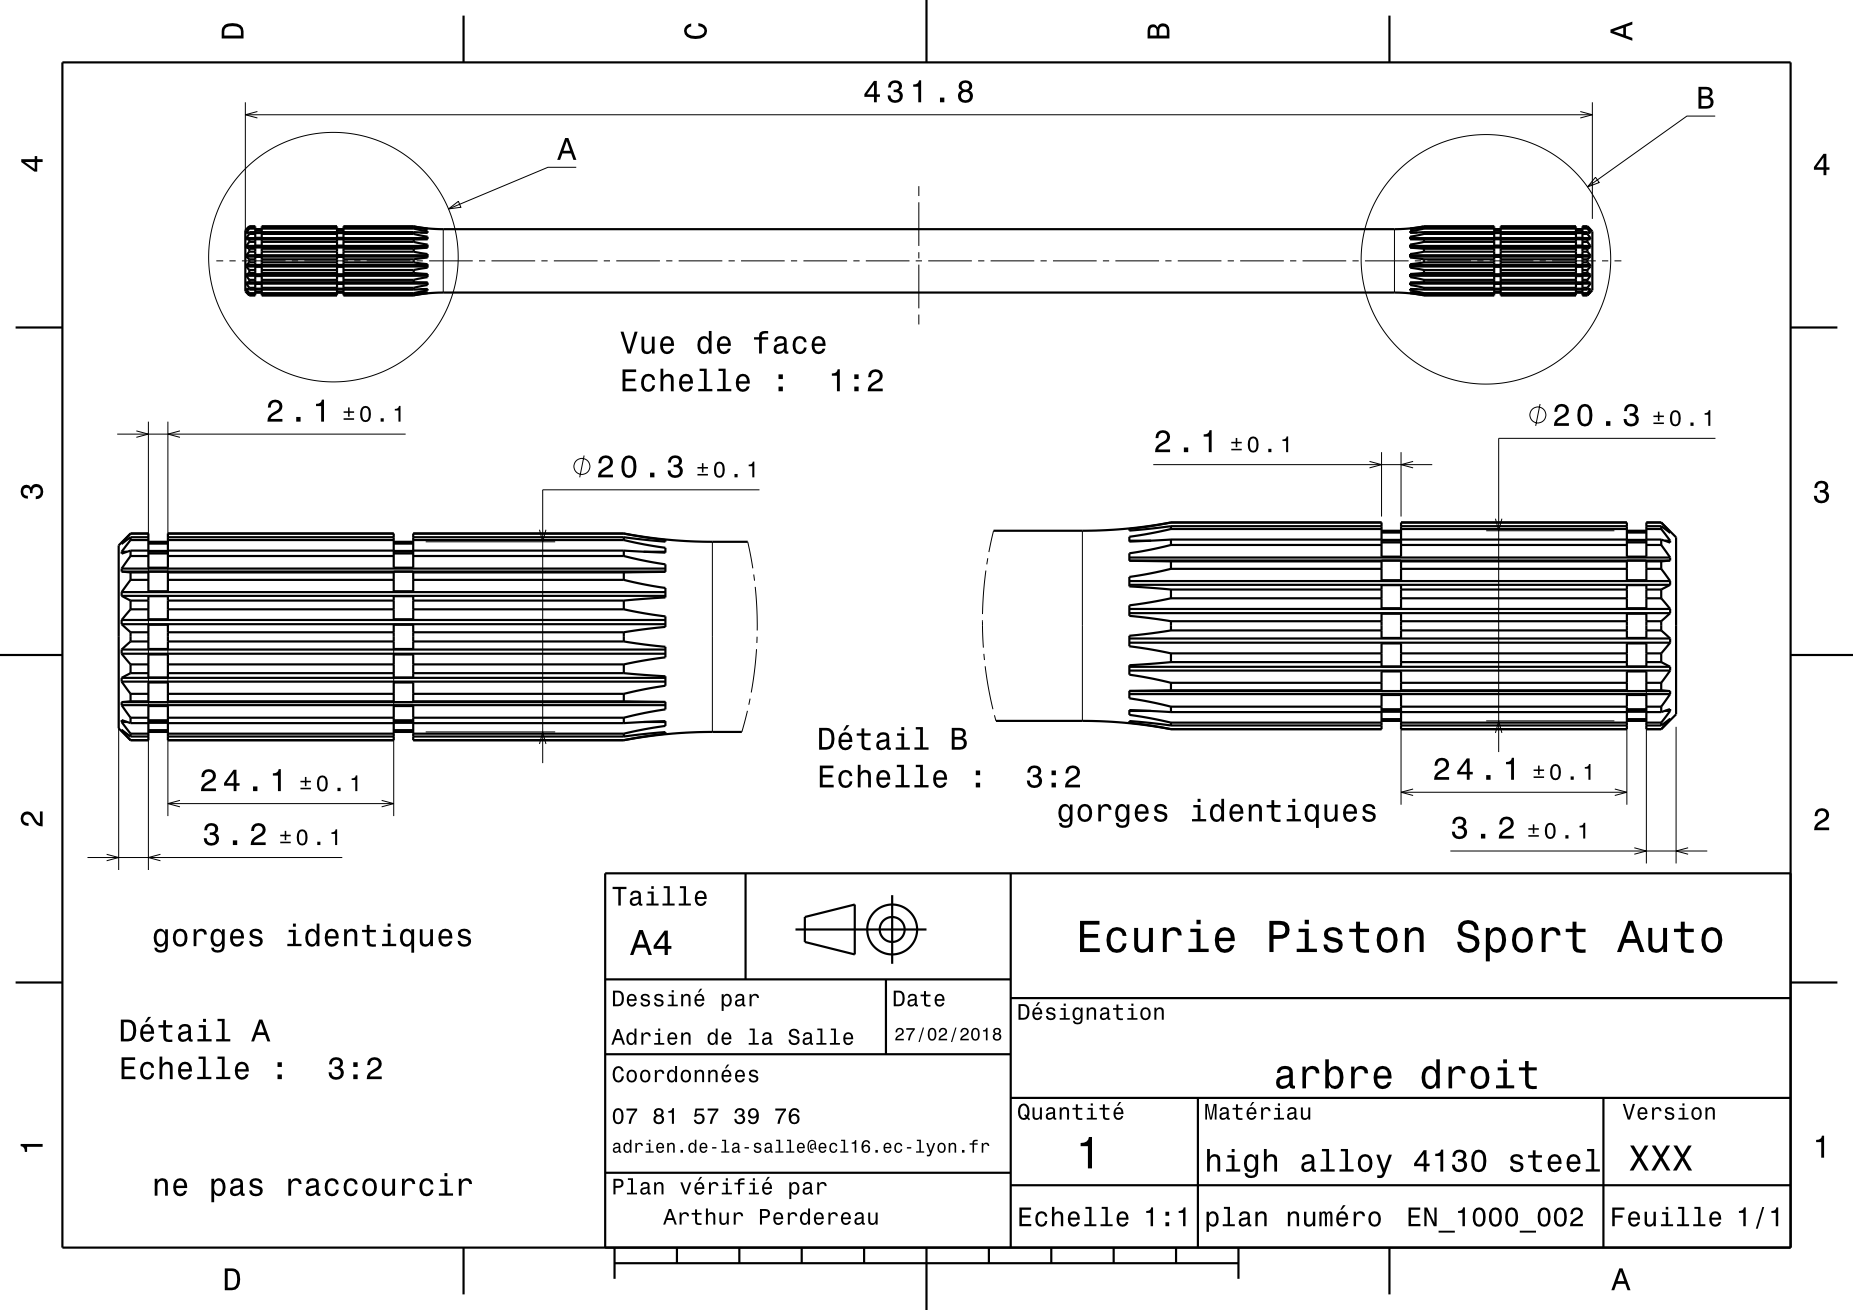
[picture p392: page 1]
