epsa-team/Vulcanix-v1.0/AA. Mise en plan/A verifier/Benjamin Pédalier/FR_0300_018_BA.pdf

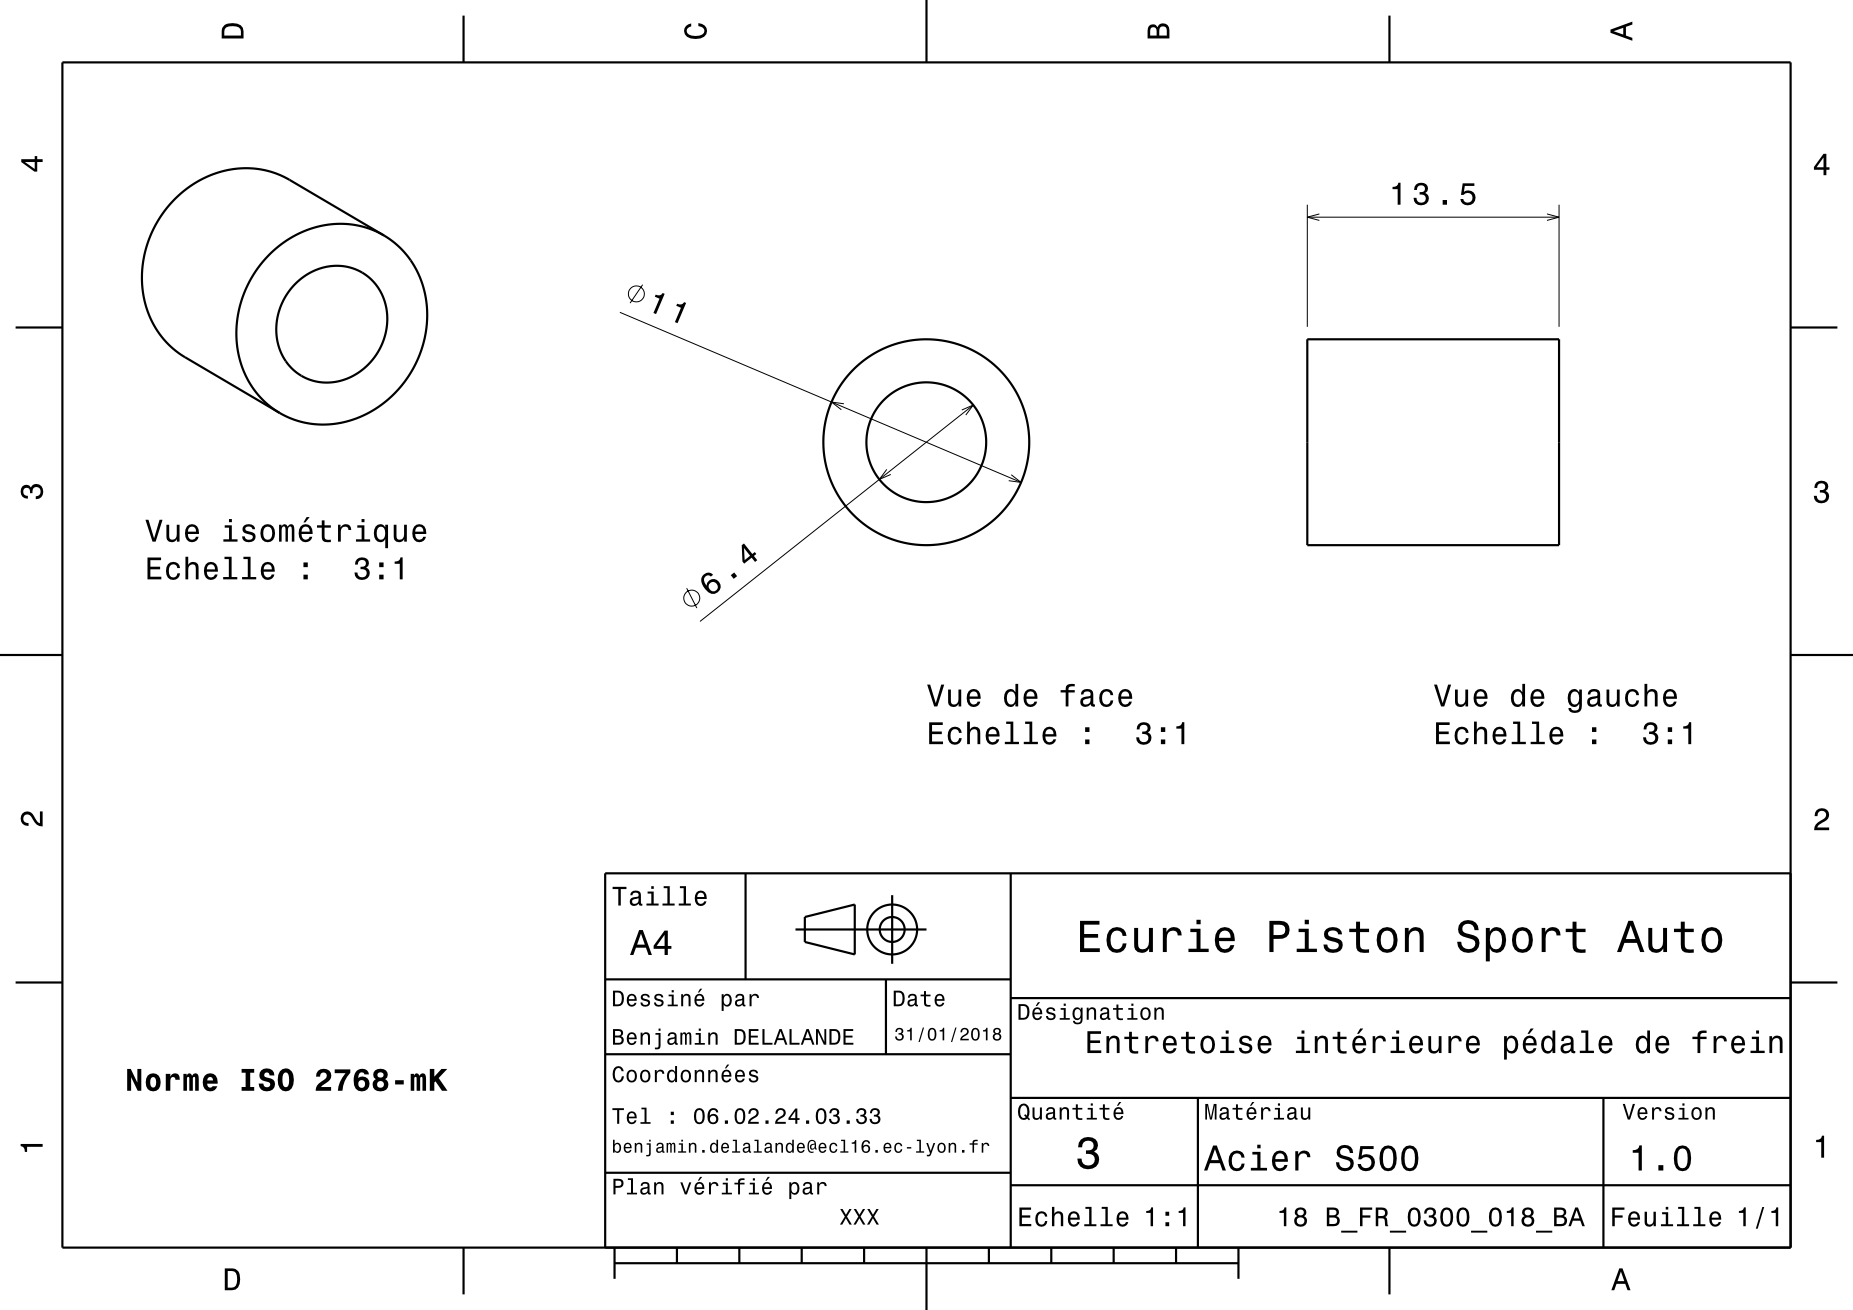
[picture p393: page 1]
