epsa-team/Vulcanix-v1.0/AA. Mise en plan/A verifier/Benjamin Pédalier/FR_0300_027_BA.pdf

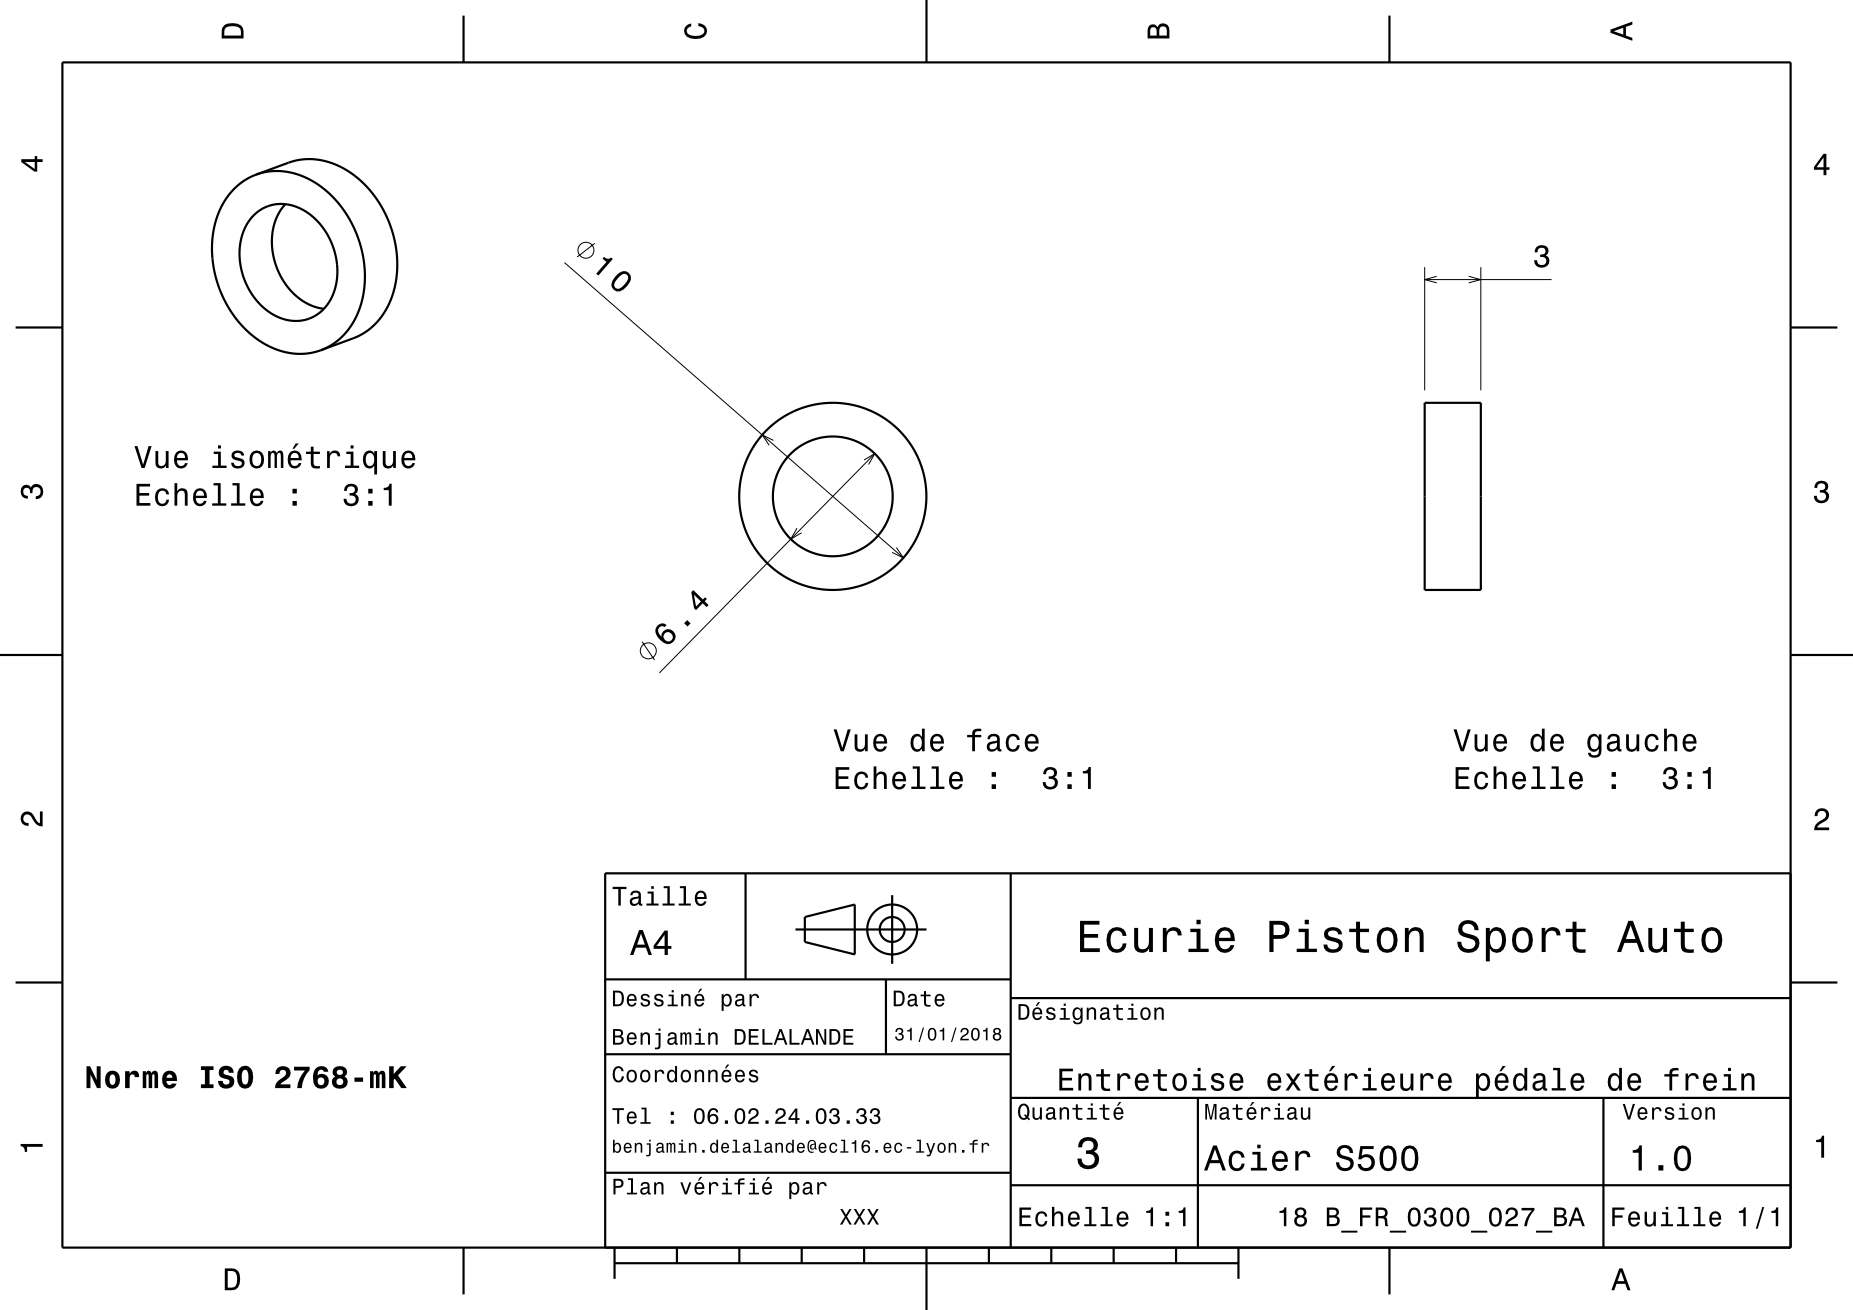
[picture p394: page 1]
