epsa-team/Vulcanix-v1.0/AA. Mise en plan/A verifier/Chainshield ADE/EN_1100_005.pdf

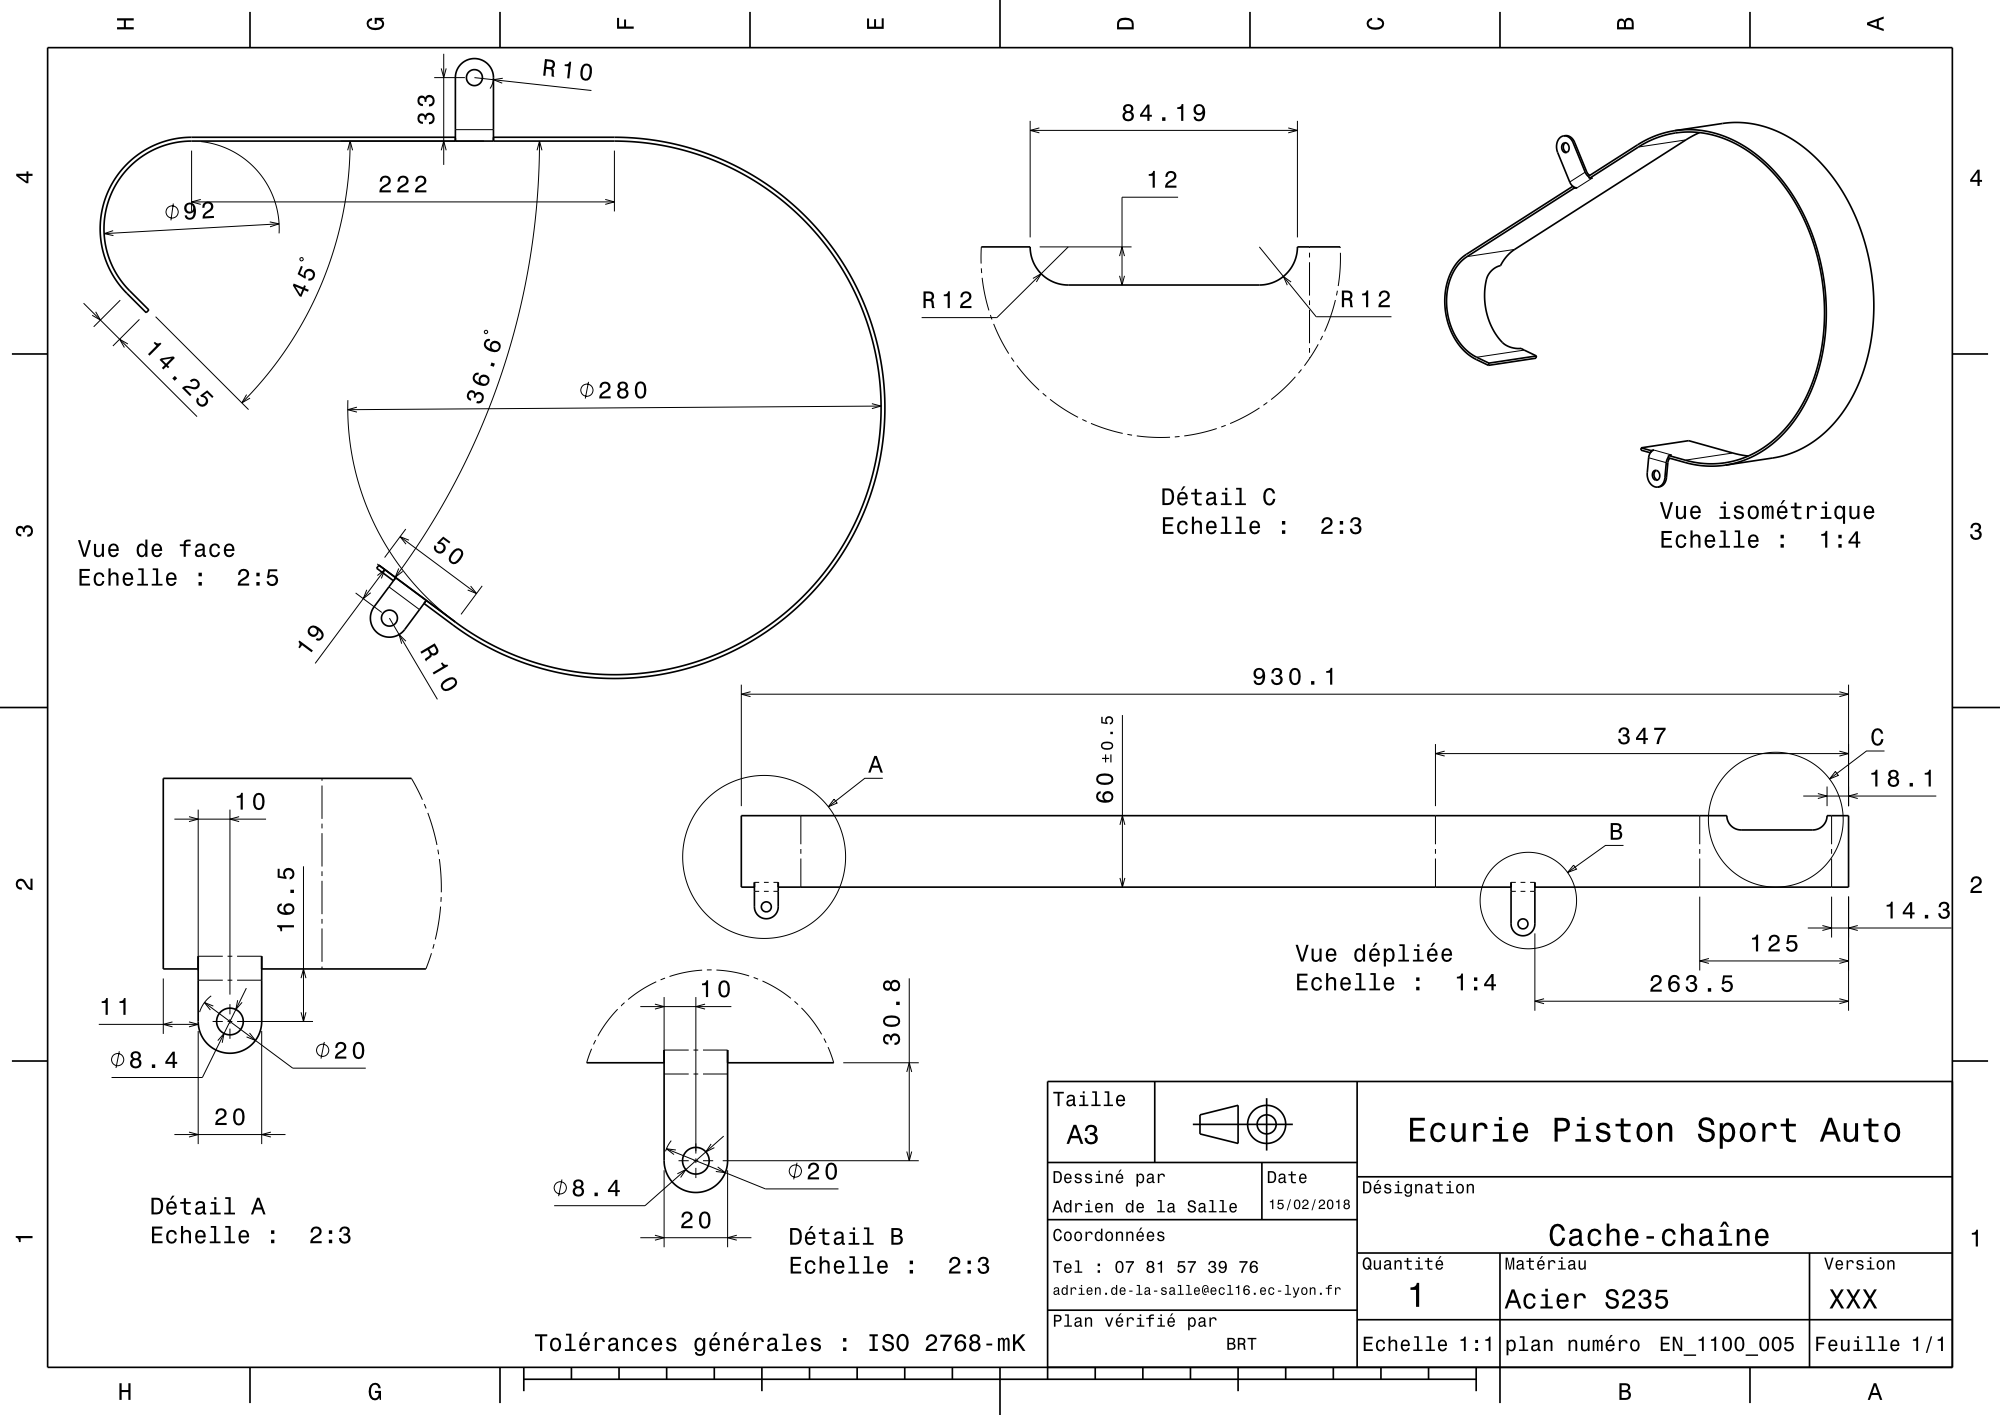
[picture p396: page 1]
