epsa-team/Vulcanix-v1.0/AA. Mise en plan/A verifier/PTN/FuelTankMain.vBrice_Calque_1.pdf

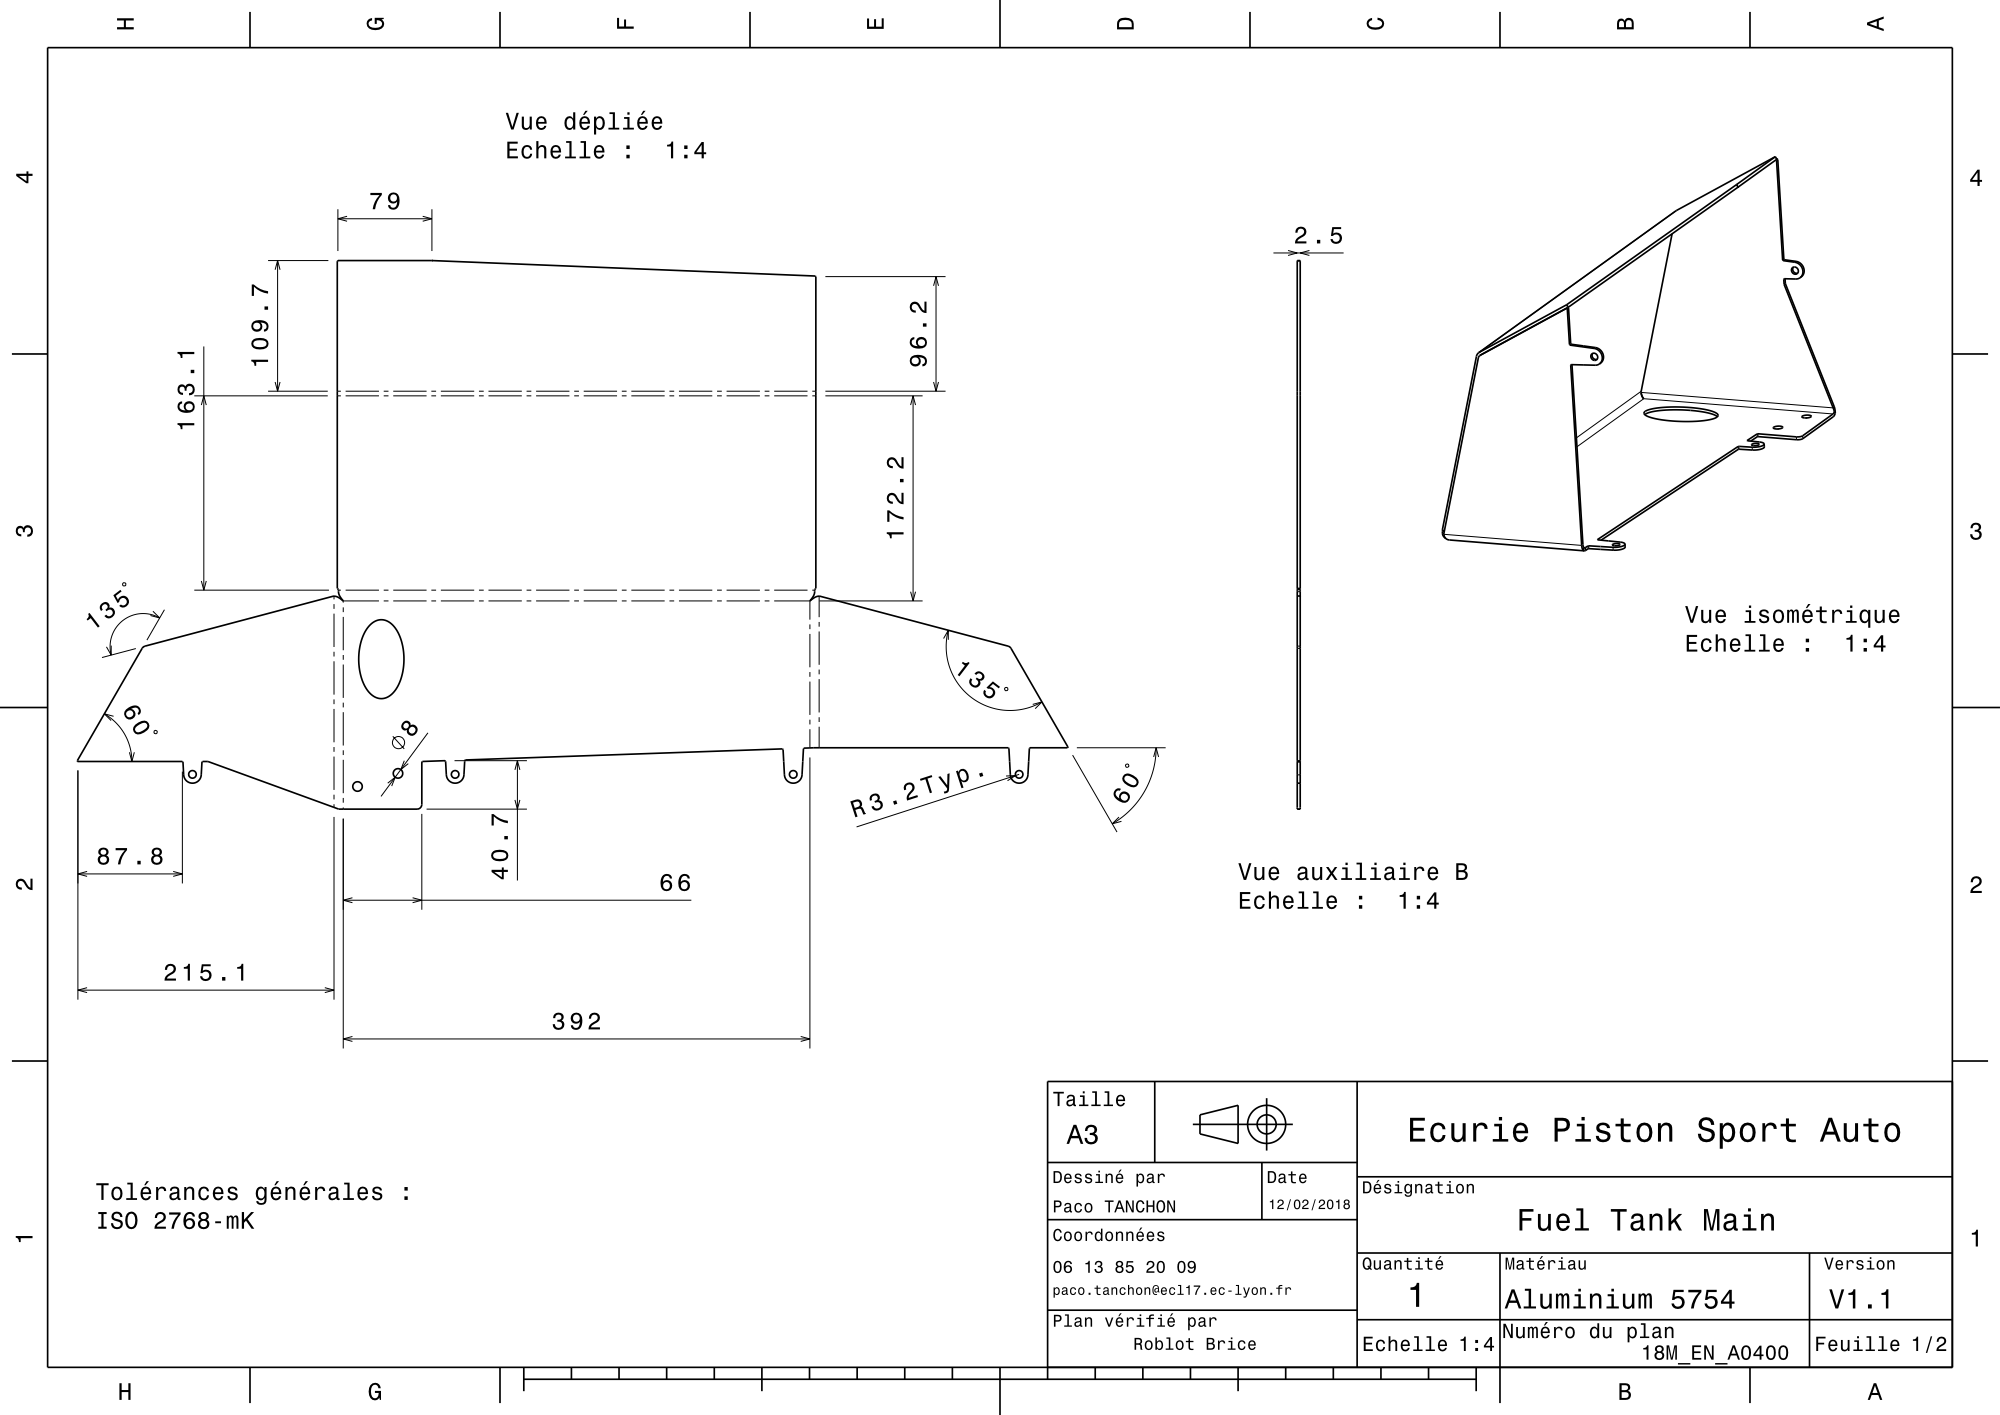
[picture p399: page 1]
