epsa-team/Vulcanix-v1.0/AA. Mise en plan/A verifier/PTN/FuelTankMain.vBrice_Calque_2.pdf

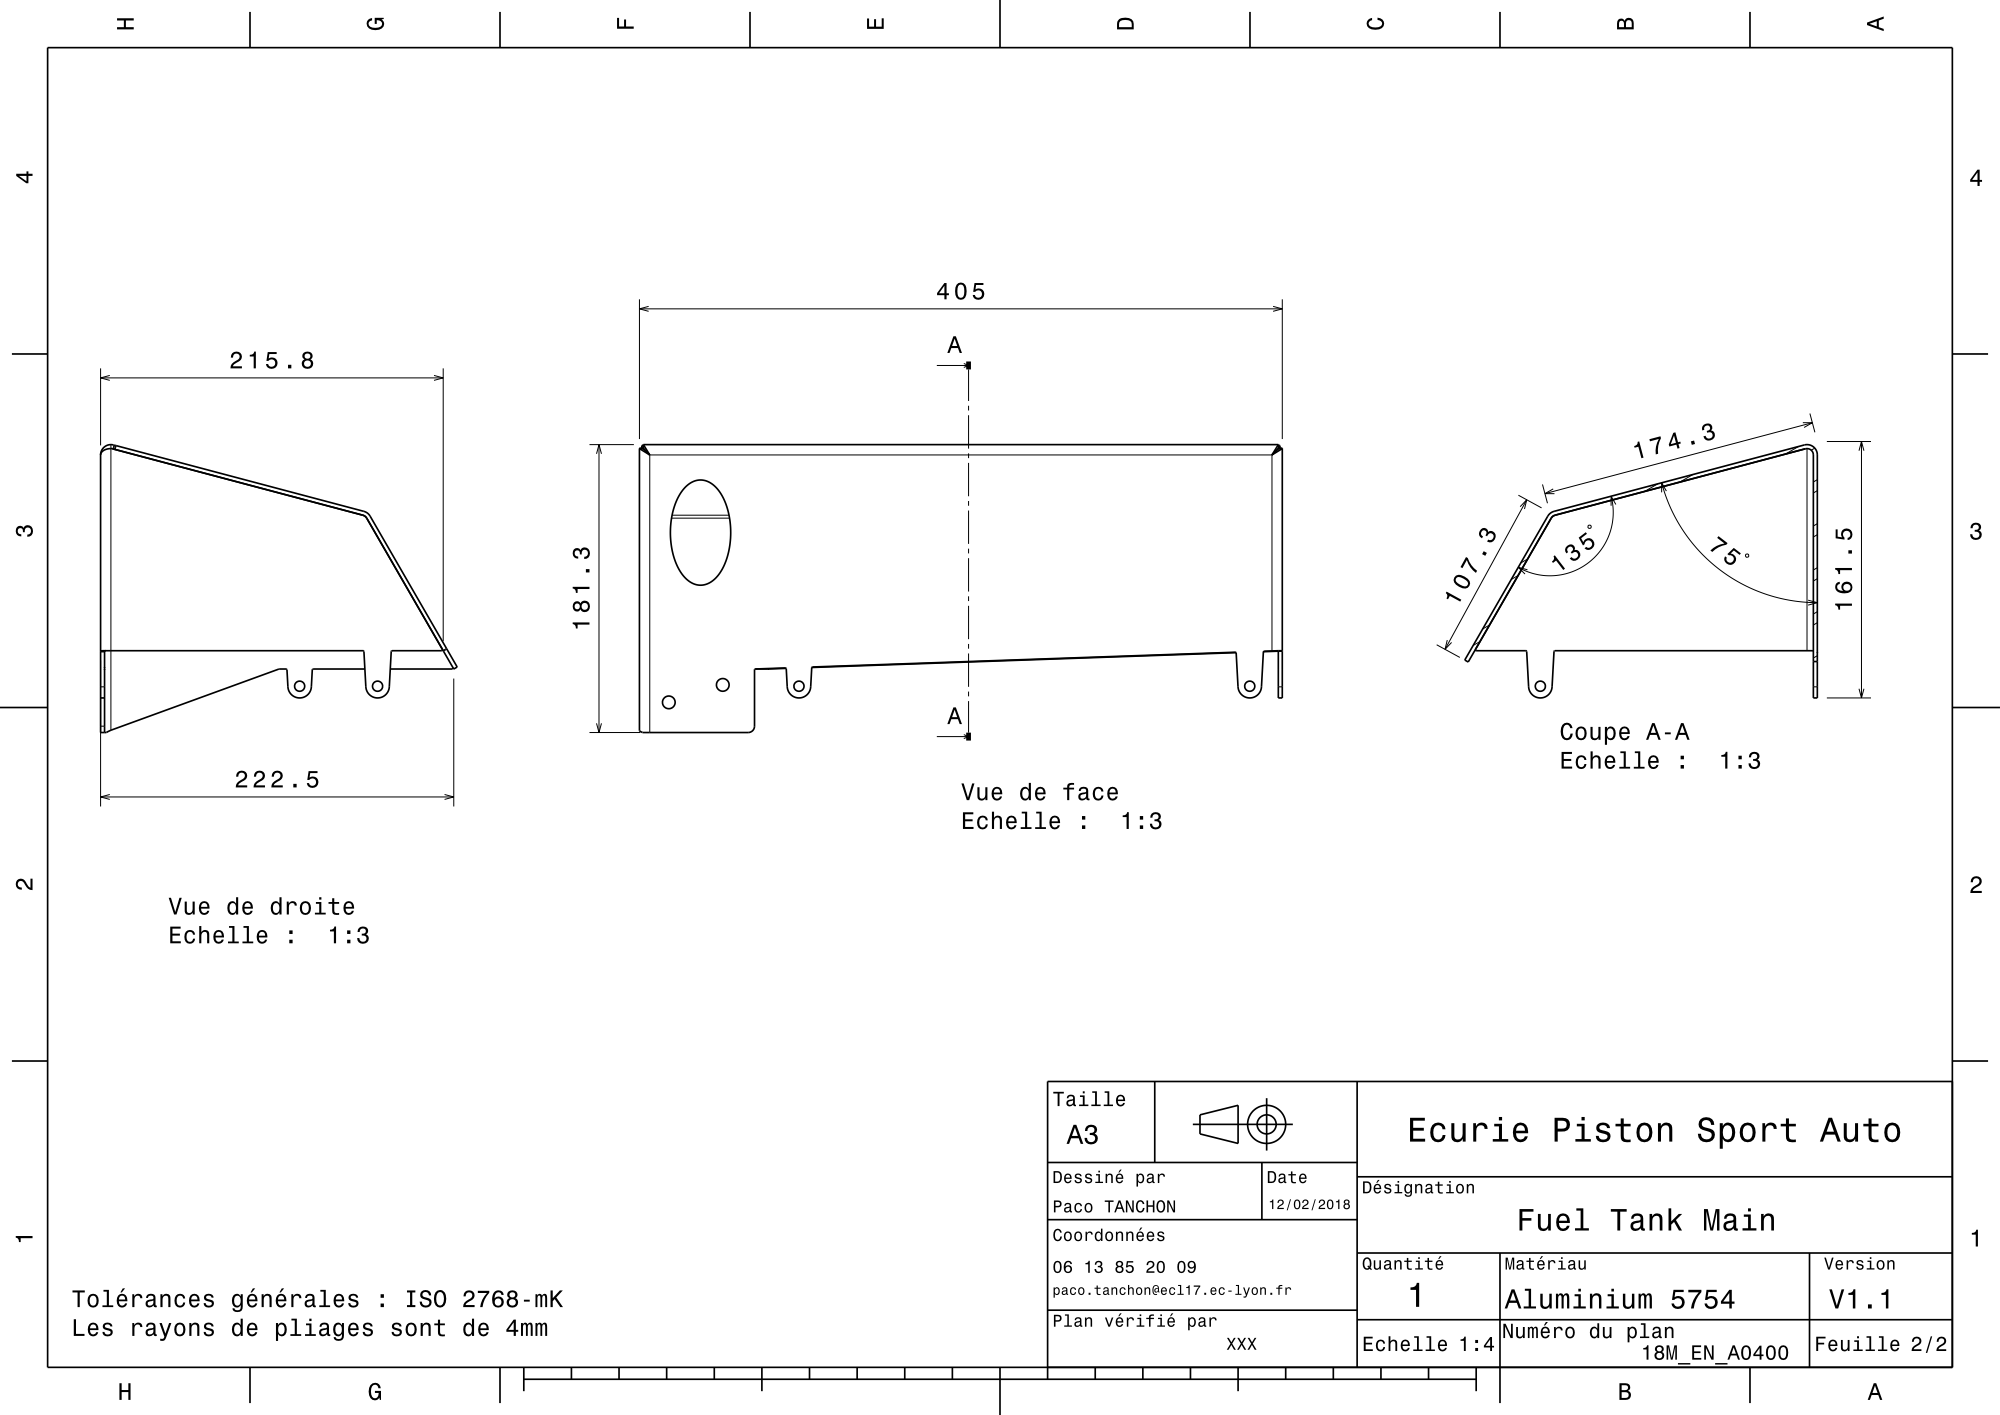
[picture p400: page 1]
