epsa-team/Vulcanix-v1.0/EN - Engine & Powertrain/Carter d'huile/mise en plan/Assemblage Carter Huile.pdf

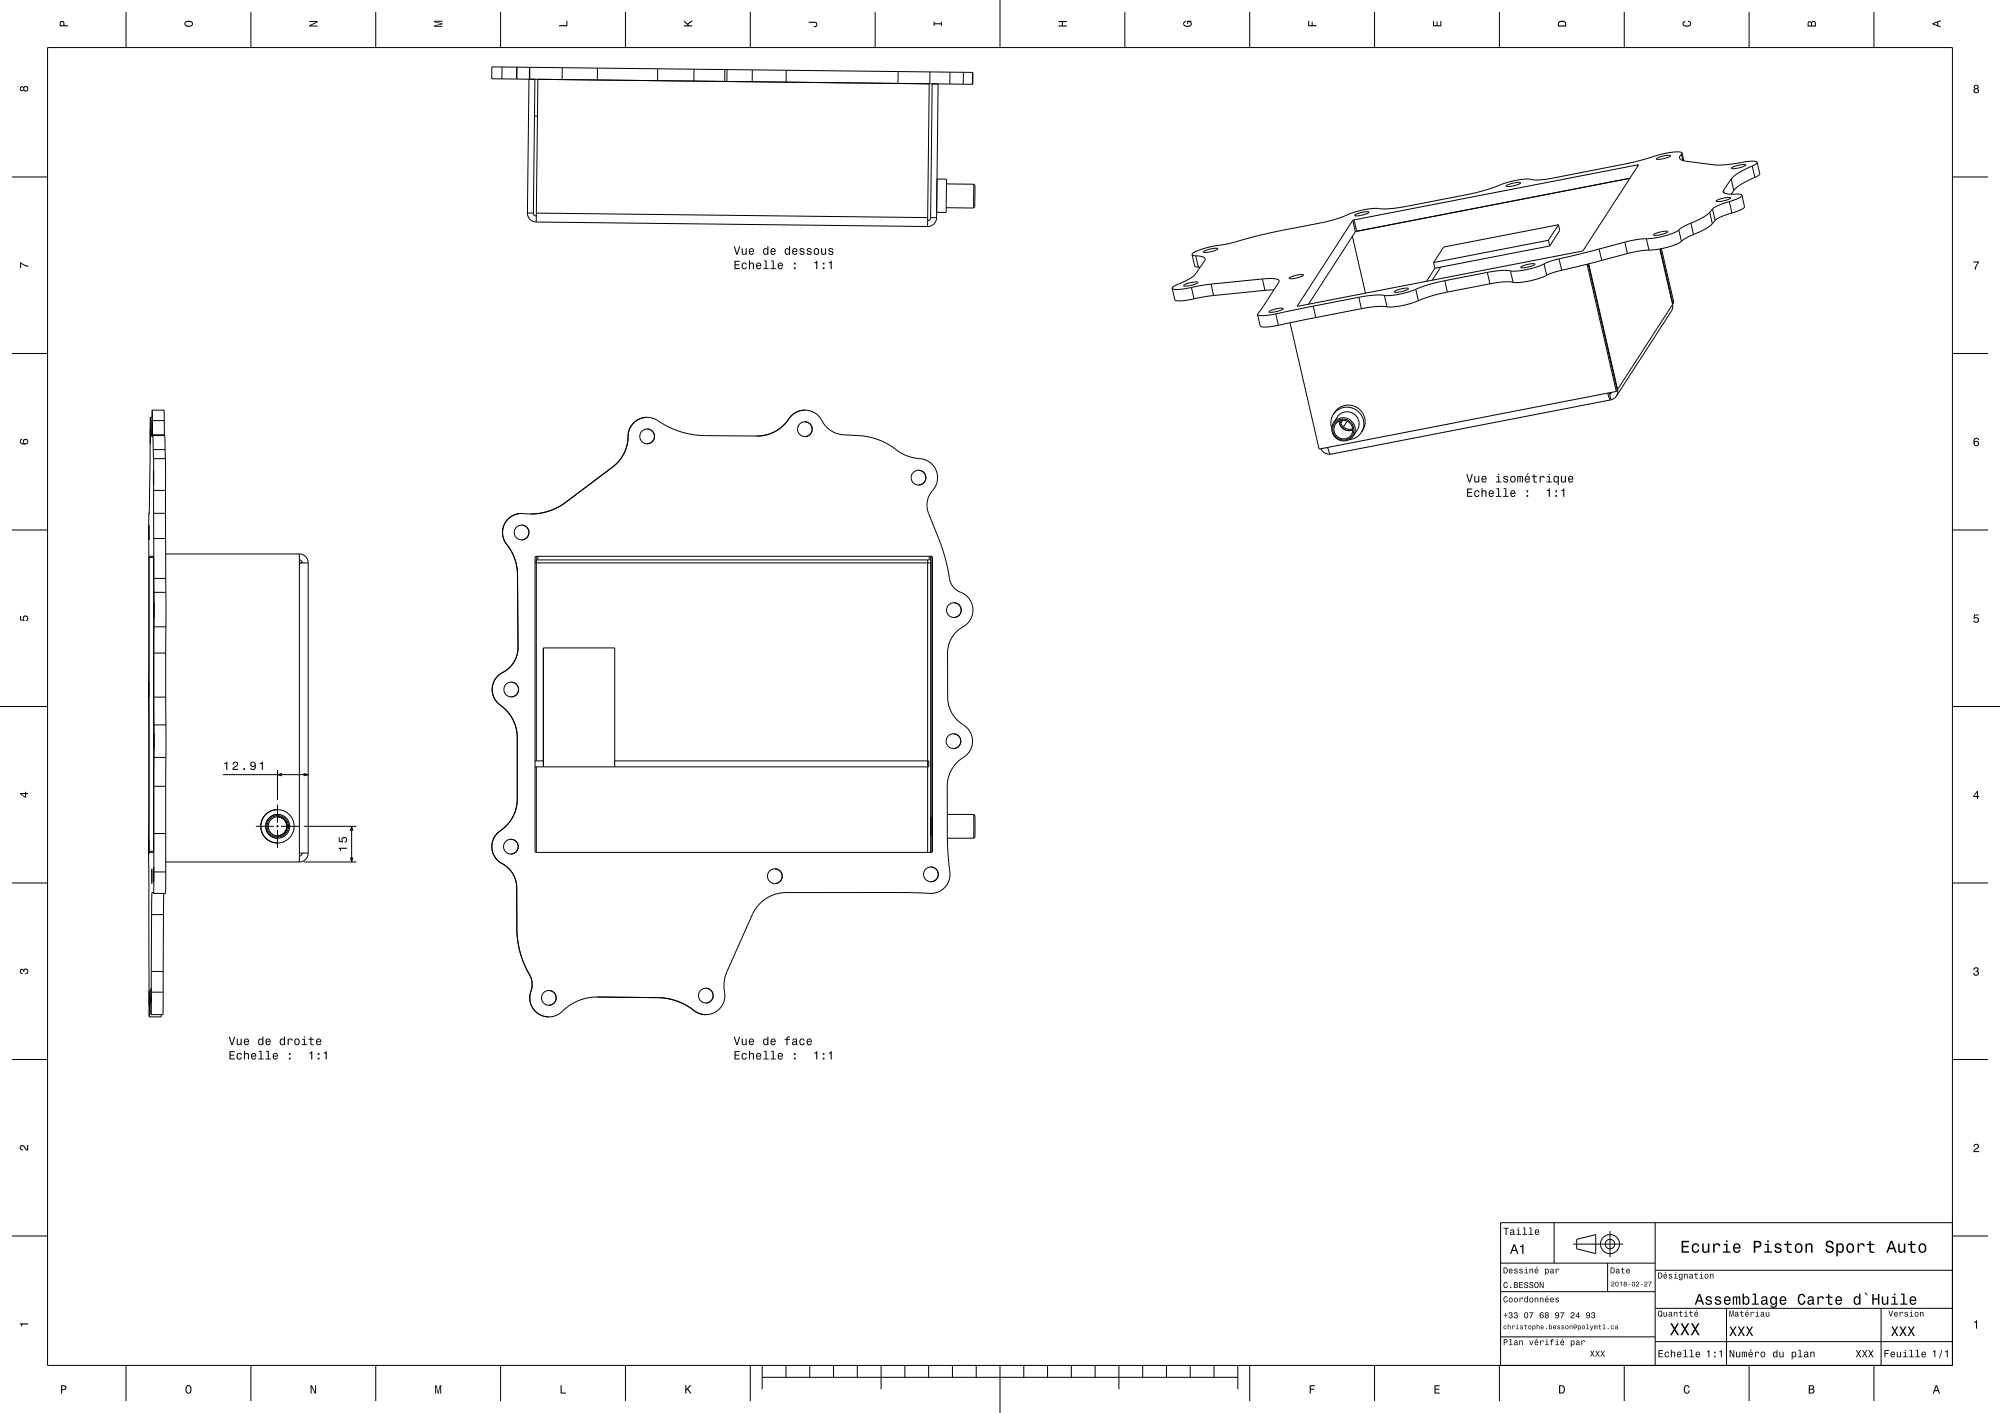
[picture p401: page 1]
