epsa-team/Vulcanix-v1.0/AA. Mise en plan/A verifier/PTN/FuelTankMainv2.pdf

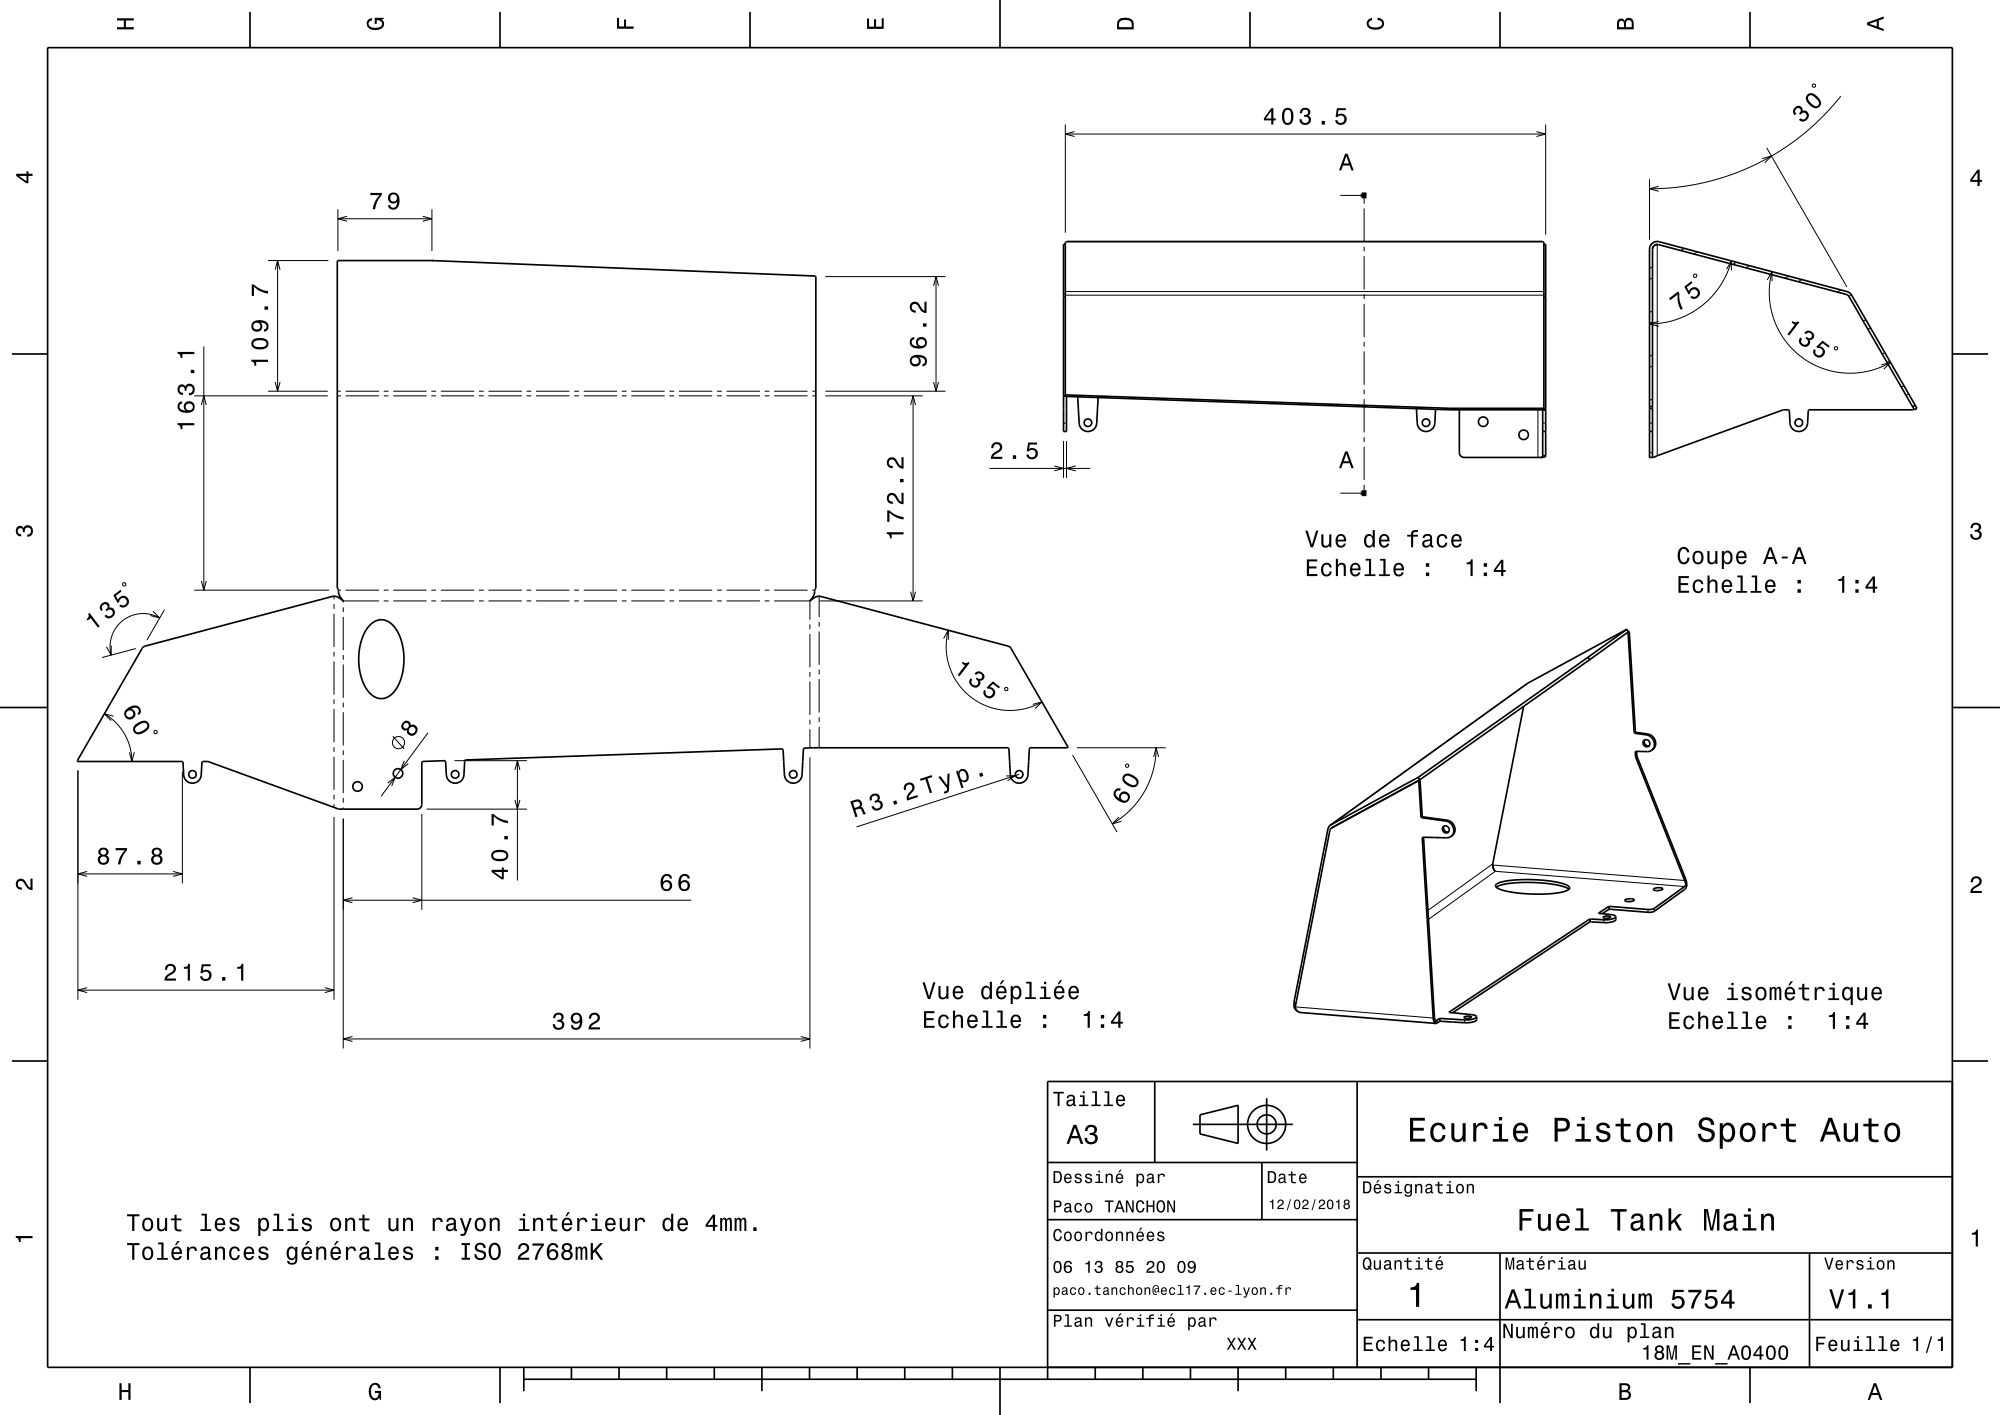
[picture p402: page 1]
