epsa-team/Vulcanix-v1.0/FR - Frame & Body/FR_A0100 (Frame)/Mise en plan pour chassis chapes/Fond plat.pdf

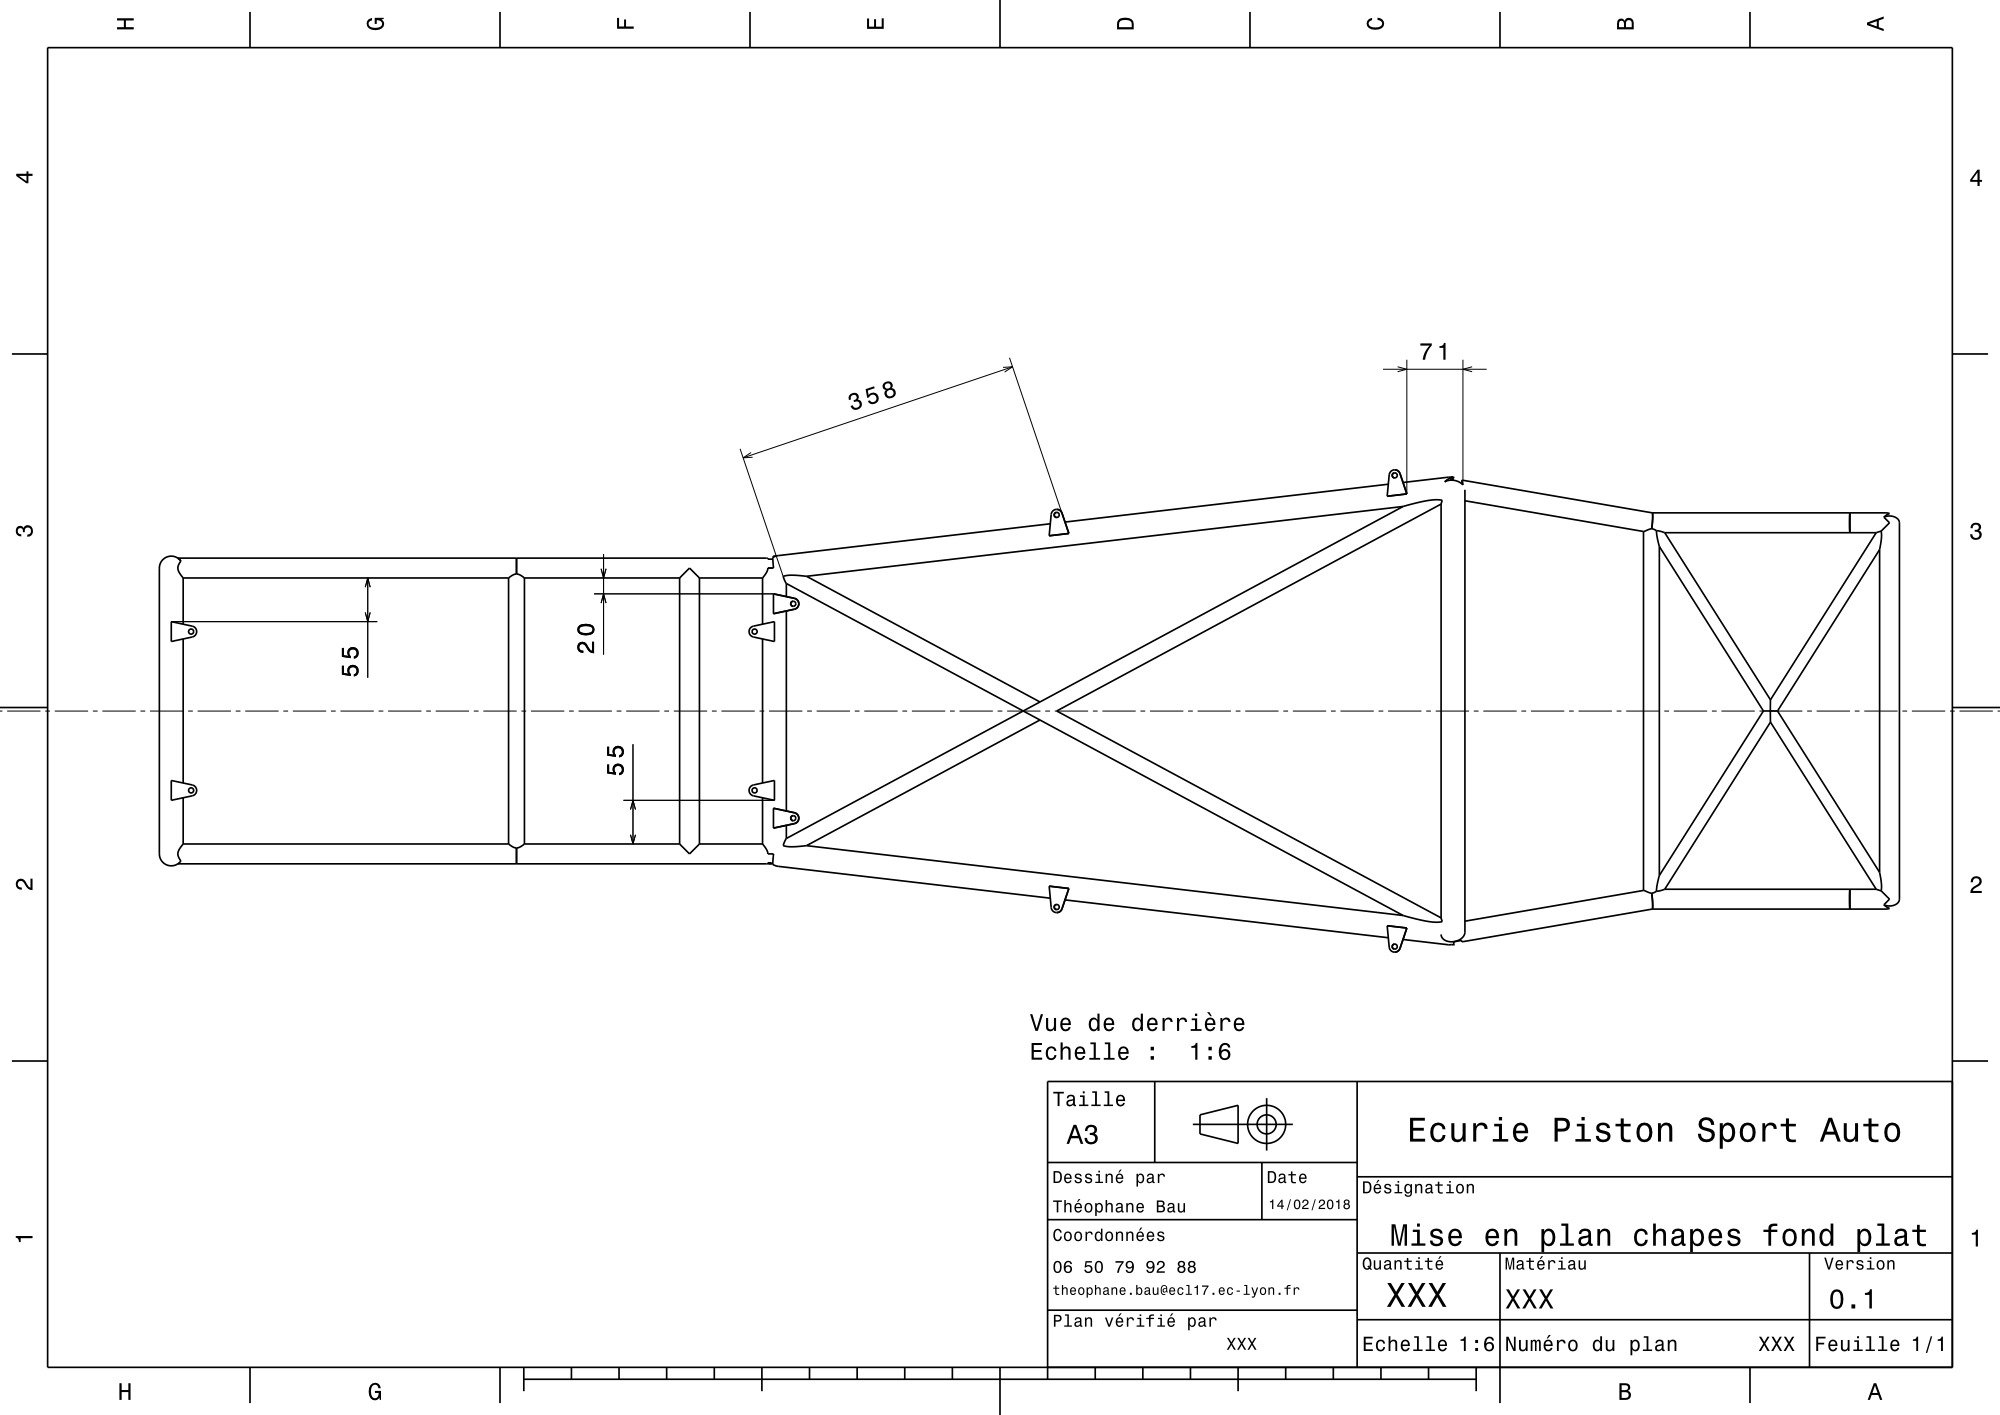
[picture p405: page 1]
