epsa-team/Vulcanix-v1.0/FR - Frame & Body/FR_A0100 (Frame)/Mise en plan pour chassis chapes/mise en plan chapes LAS.pdf

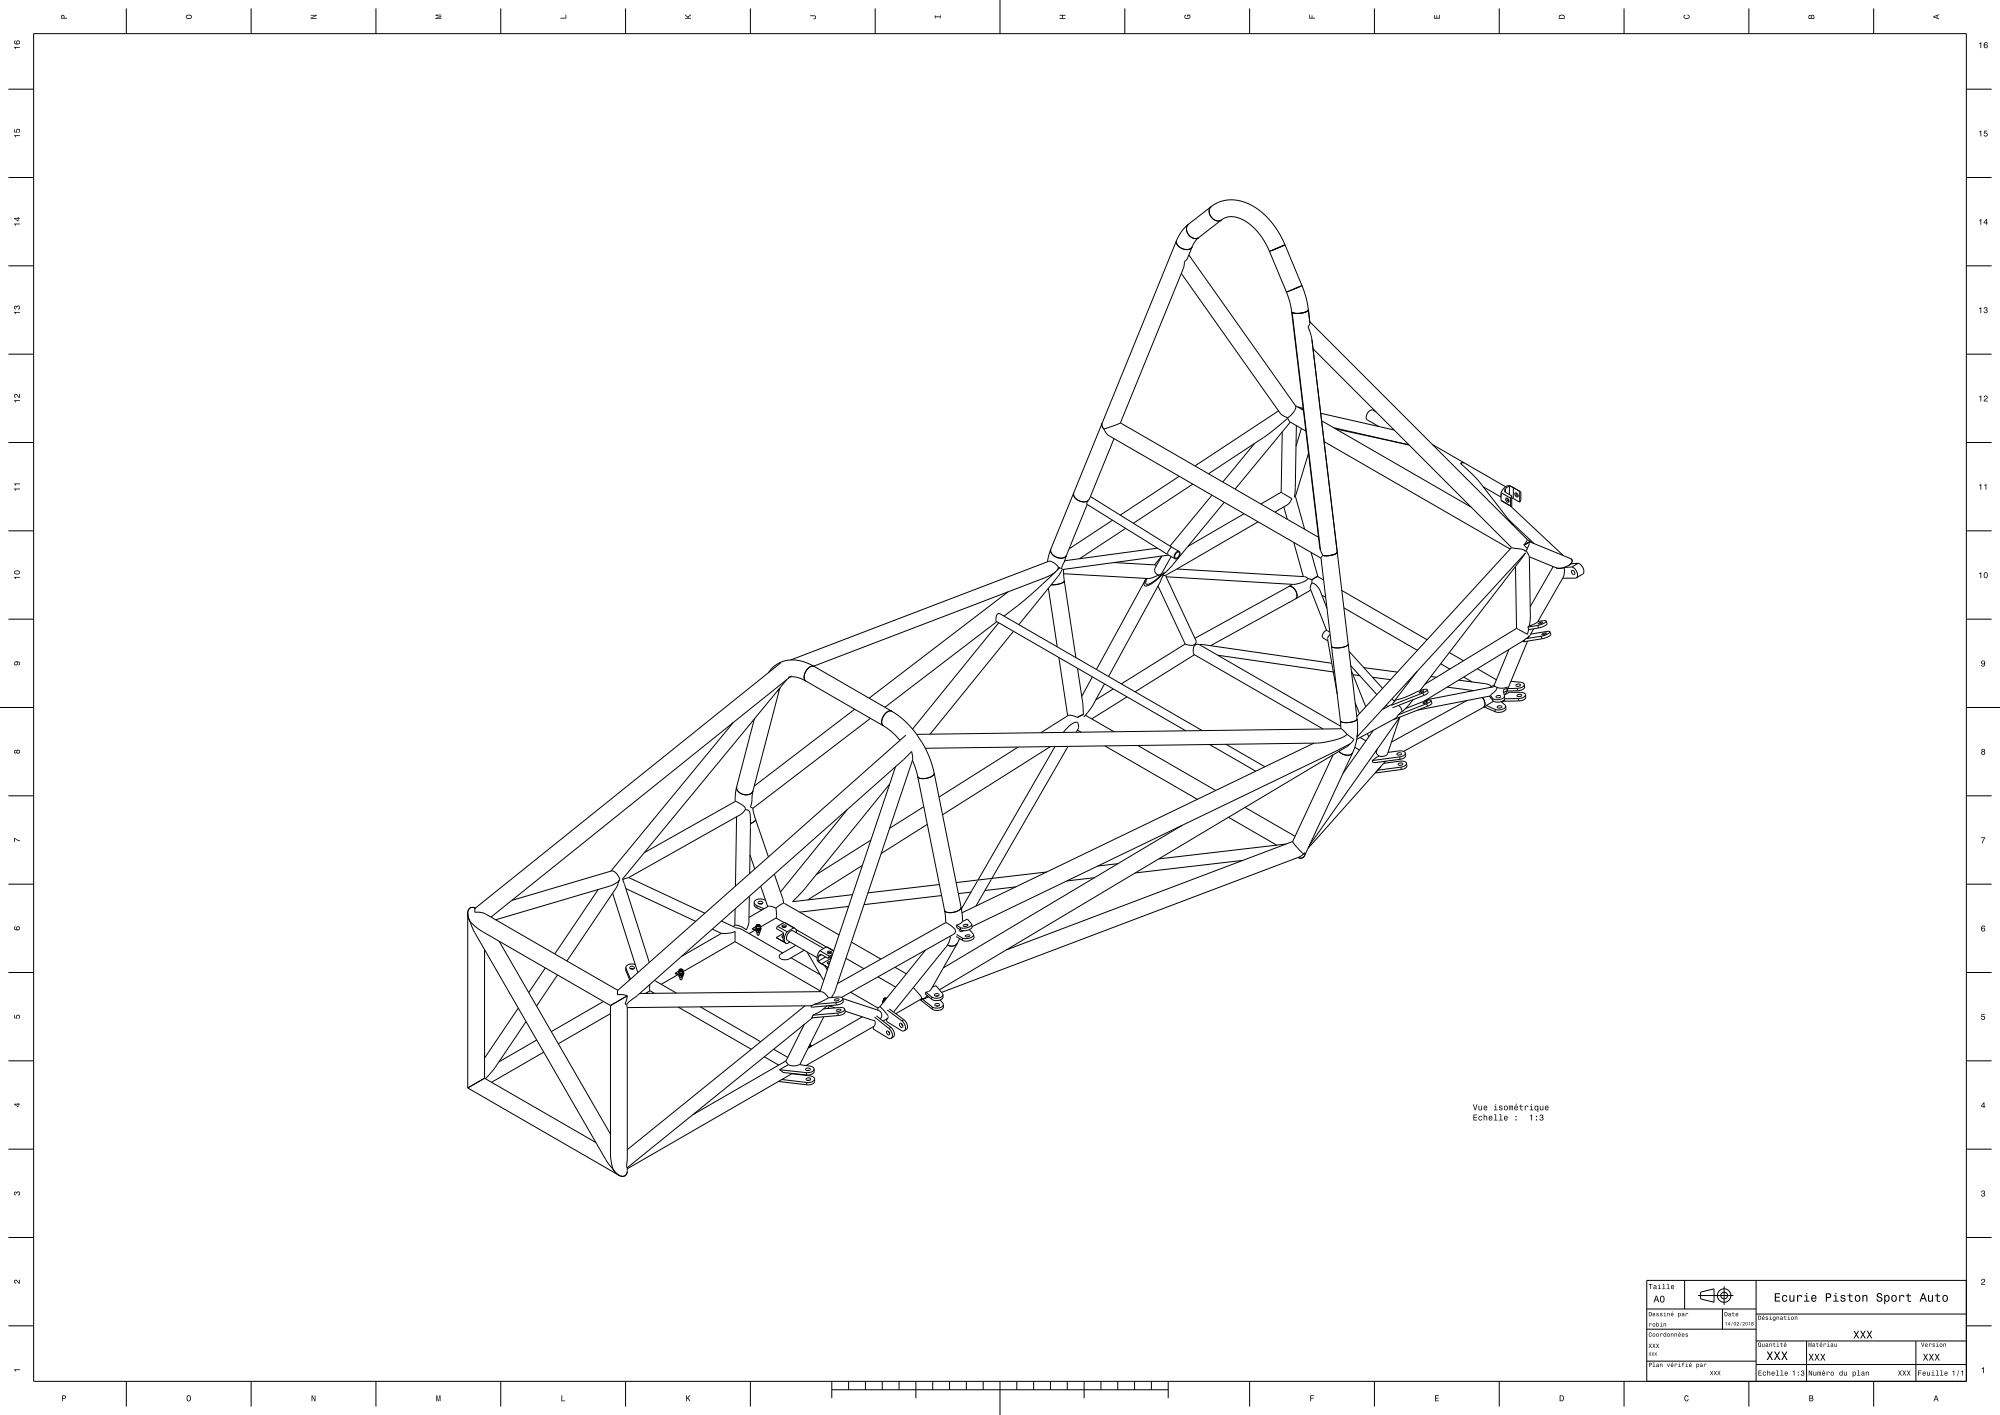
[picture p406: page 1]
