epsa-team/Vulcanix-v1.0/FR - Frame & Body/FR_A0100 (Frame)/Mise en plan pour chassis chapes/Mise en plan pr souder shock mount assy.pdf

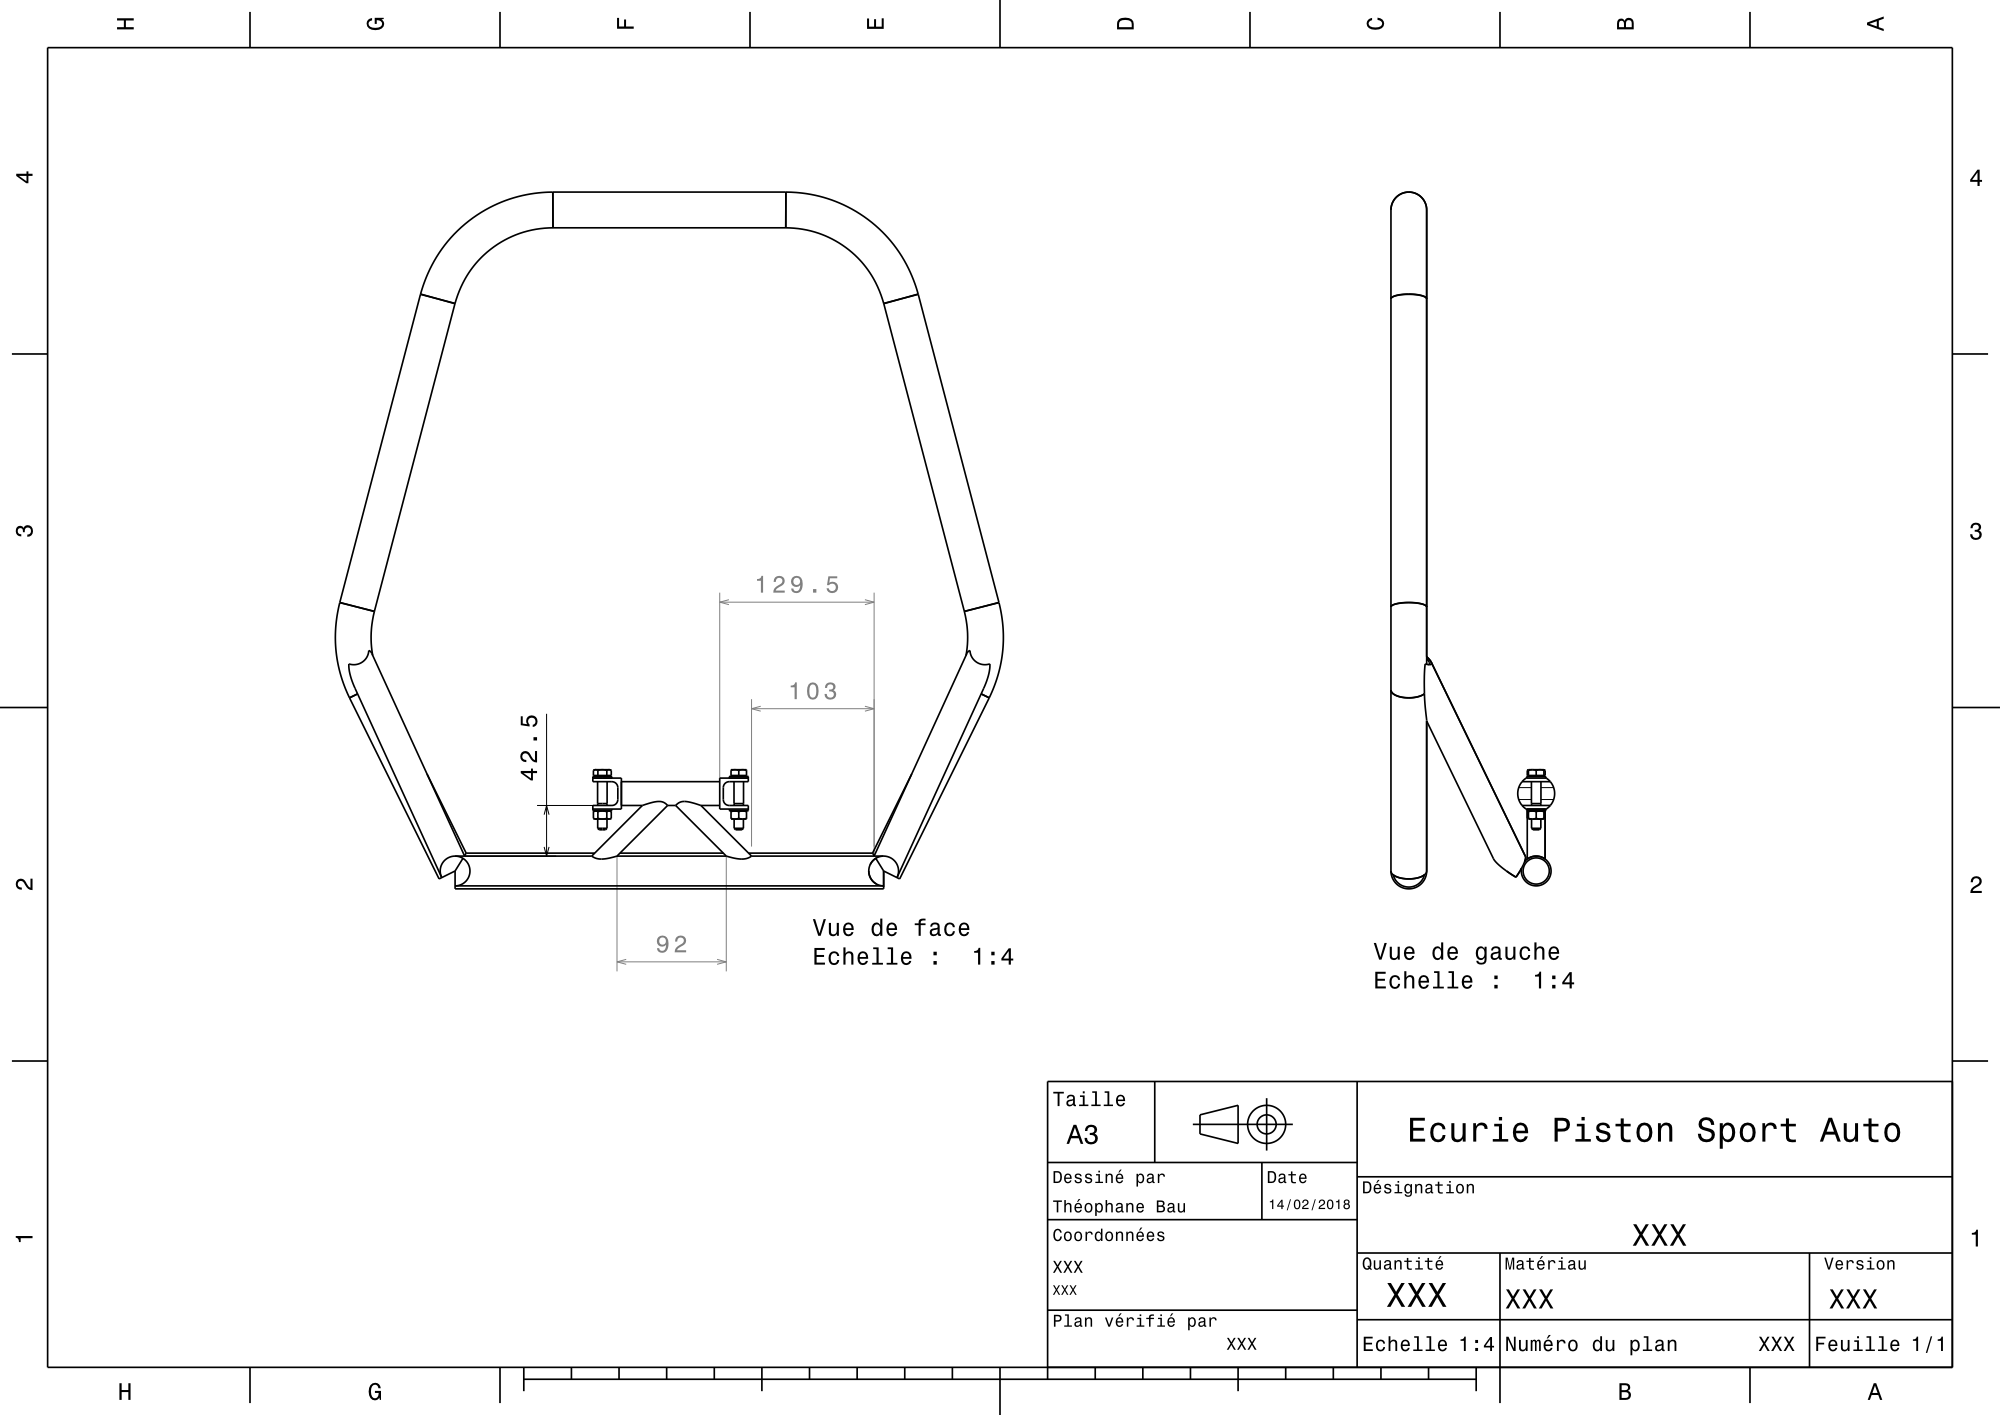
[picture p407: page 1]
