epsa-team/Vulcanix-v1.0/FR - Frame & Body/FR_A0100 (Frame)/Mise en plan pour chassis chapes/plan chassis chape firewall 1.pdf

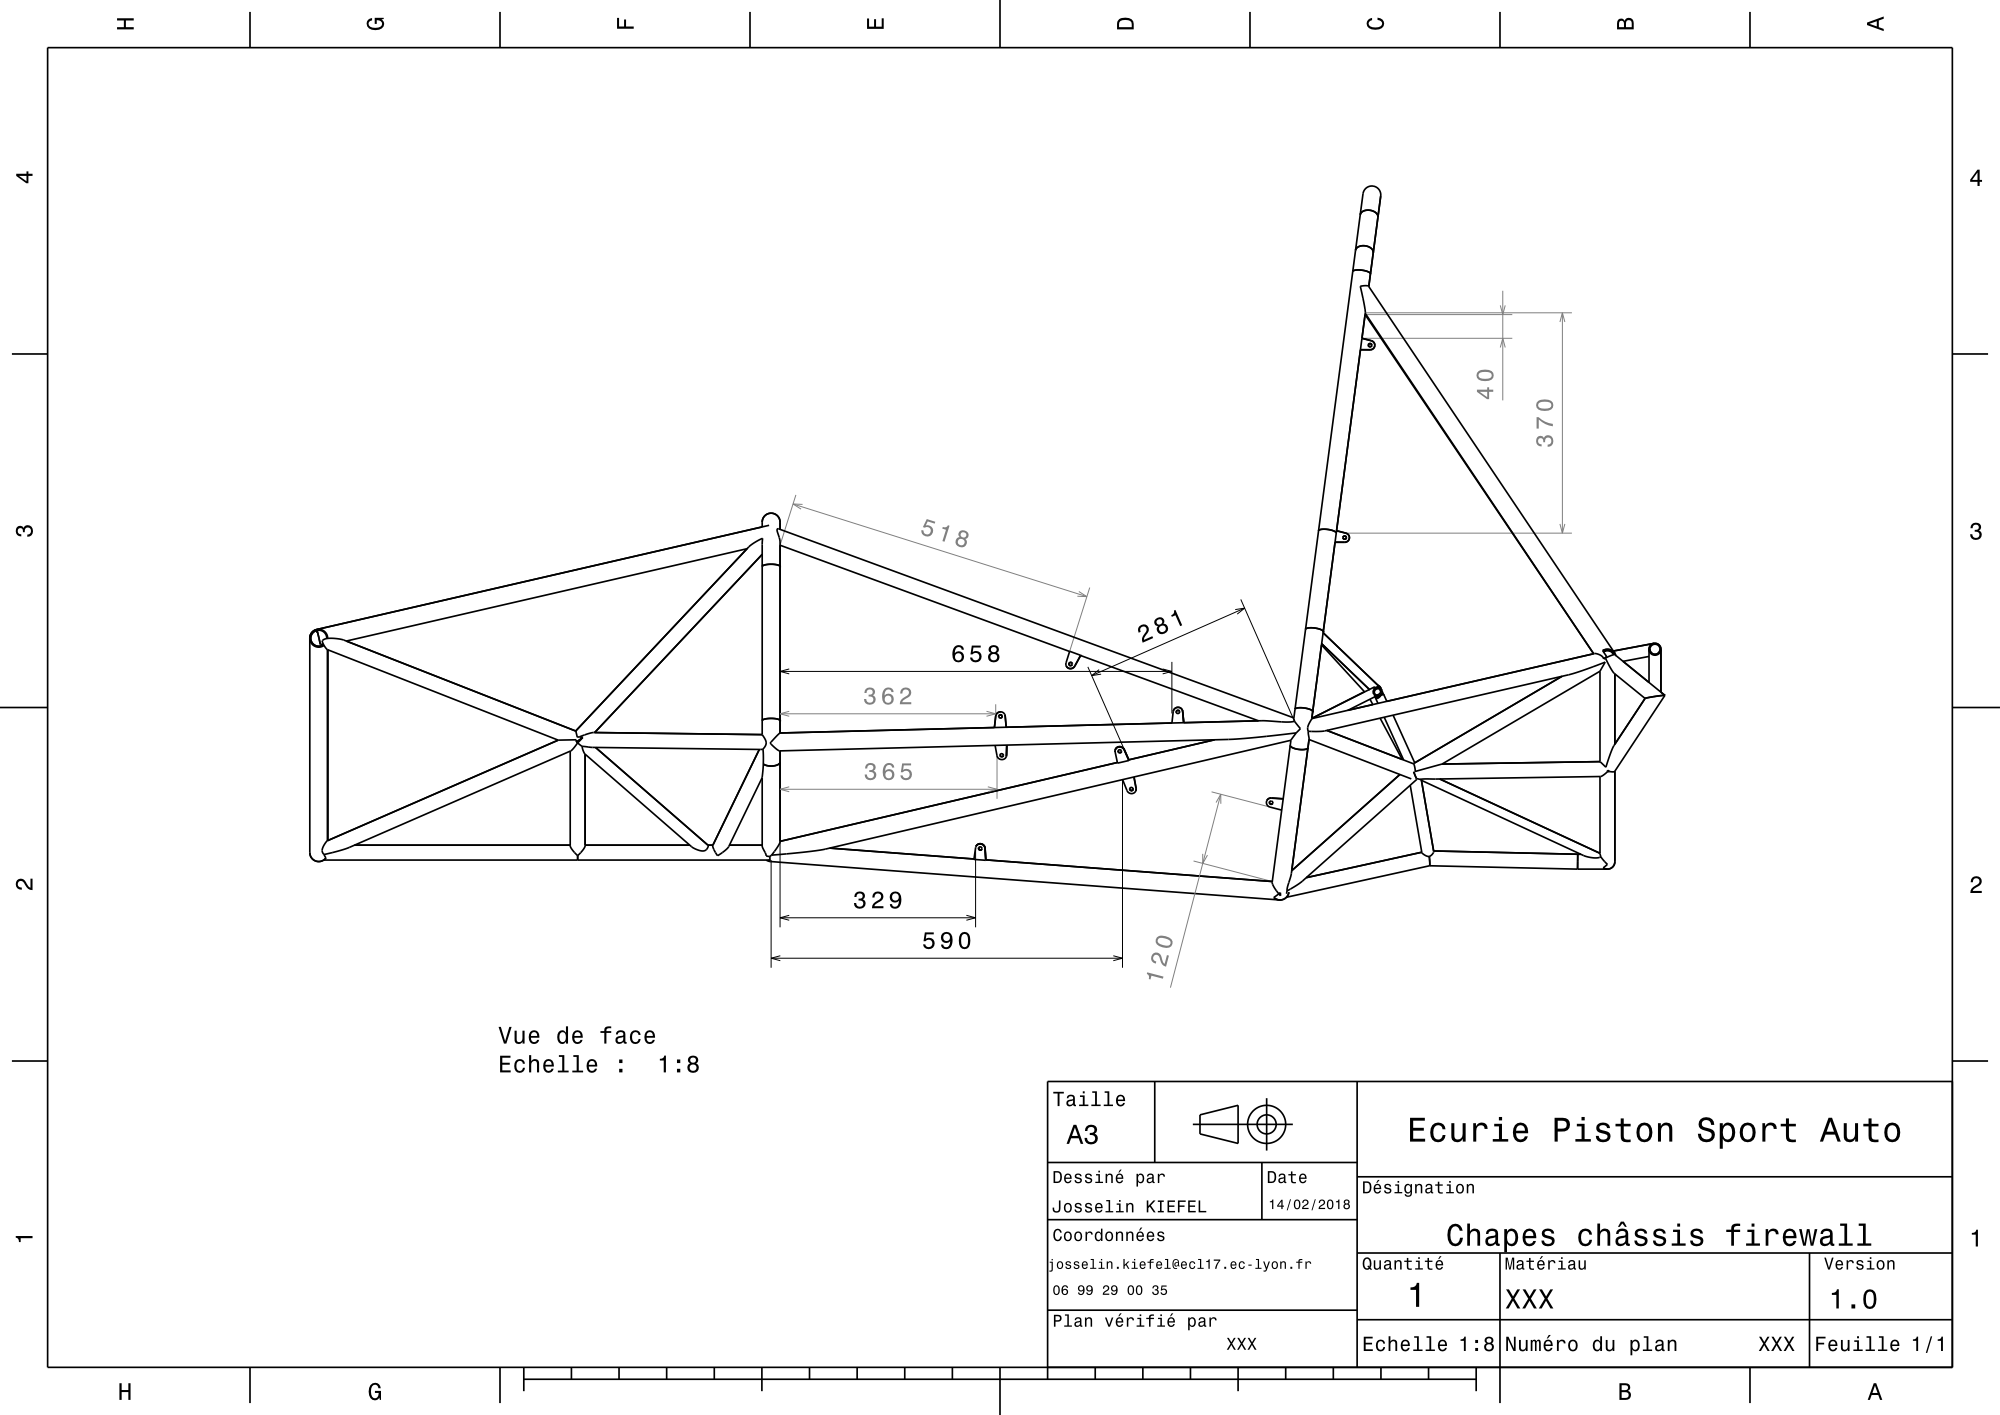
[picture p408: page 1]
