epsa-team/Vulcanix-v1.0/FR - Frame & Body/FR_A0100 (Frame)/Mise en plan pour chassis chapes/plan chassis chape firewall 2.pdf

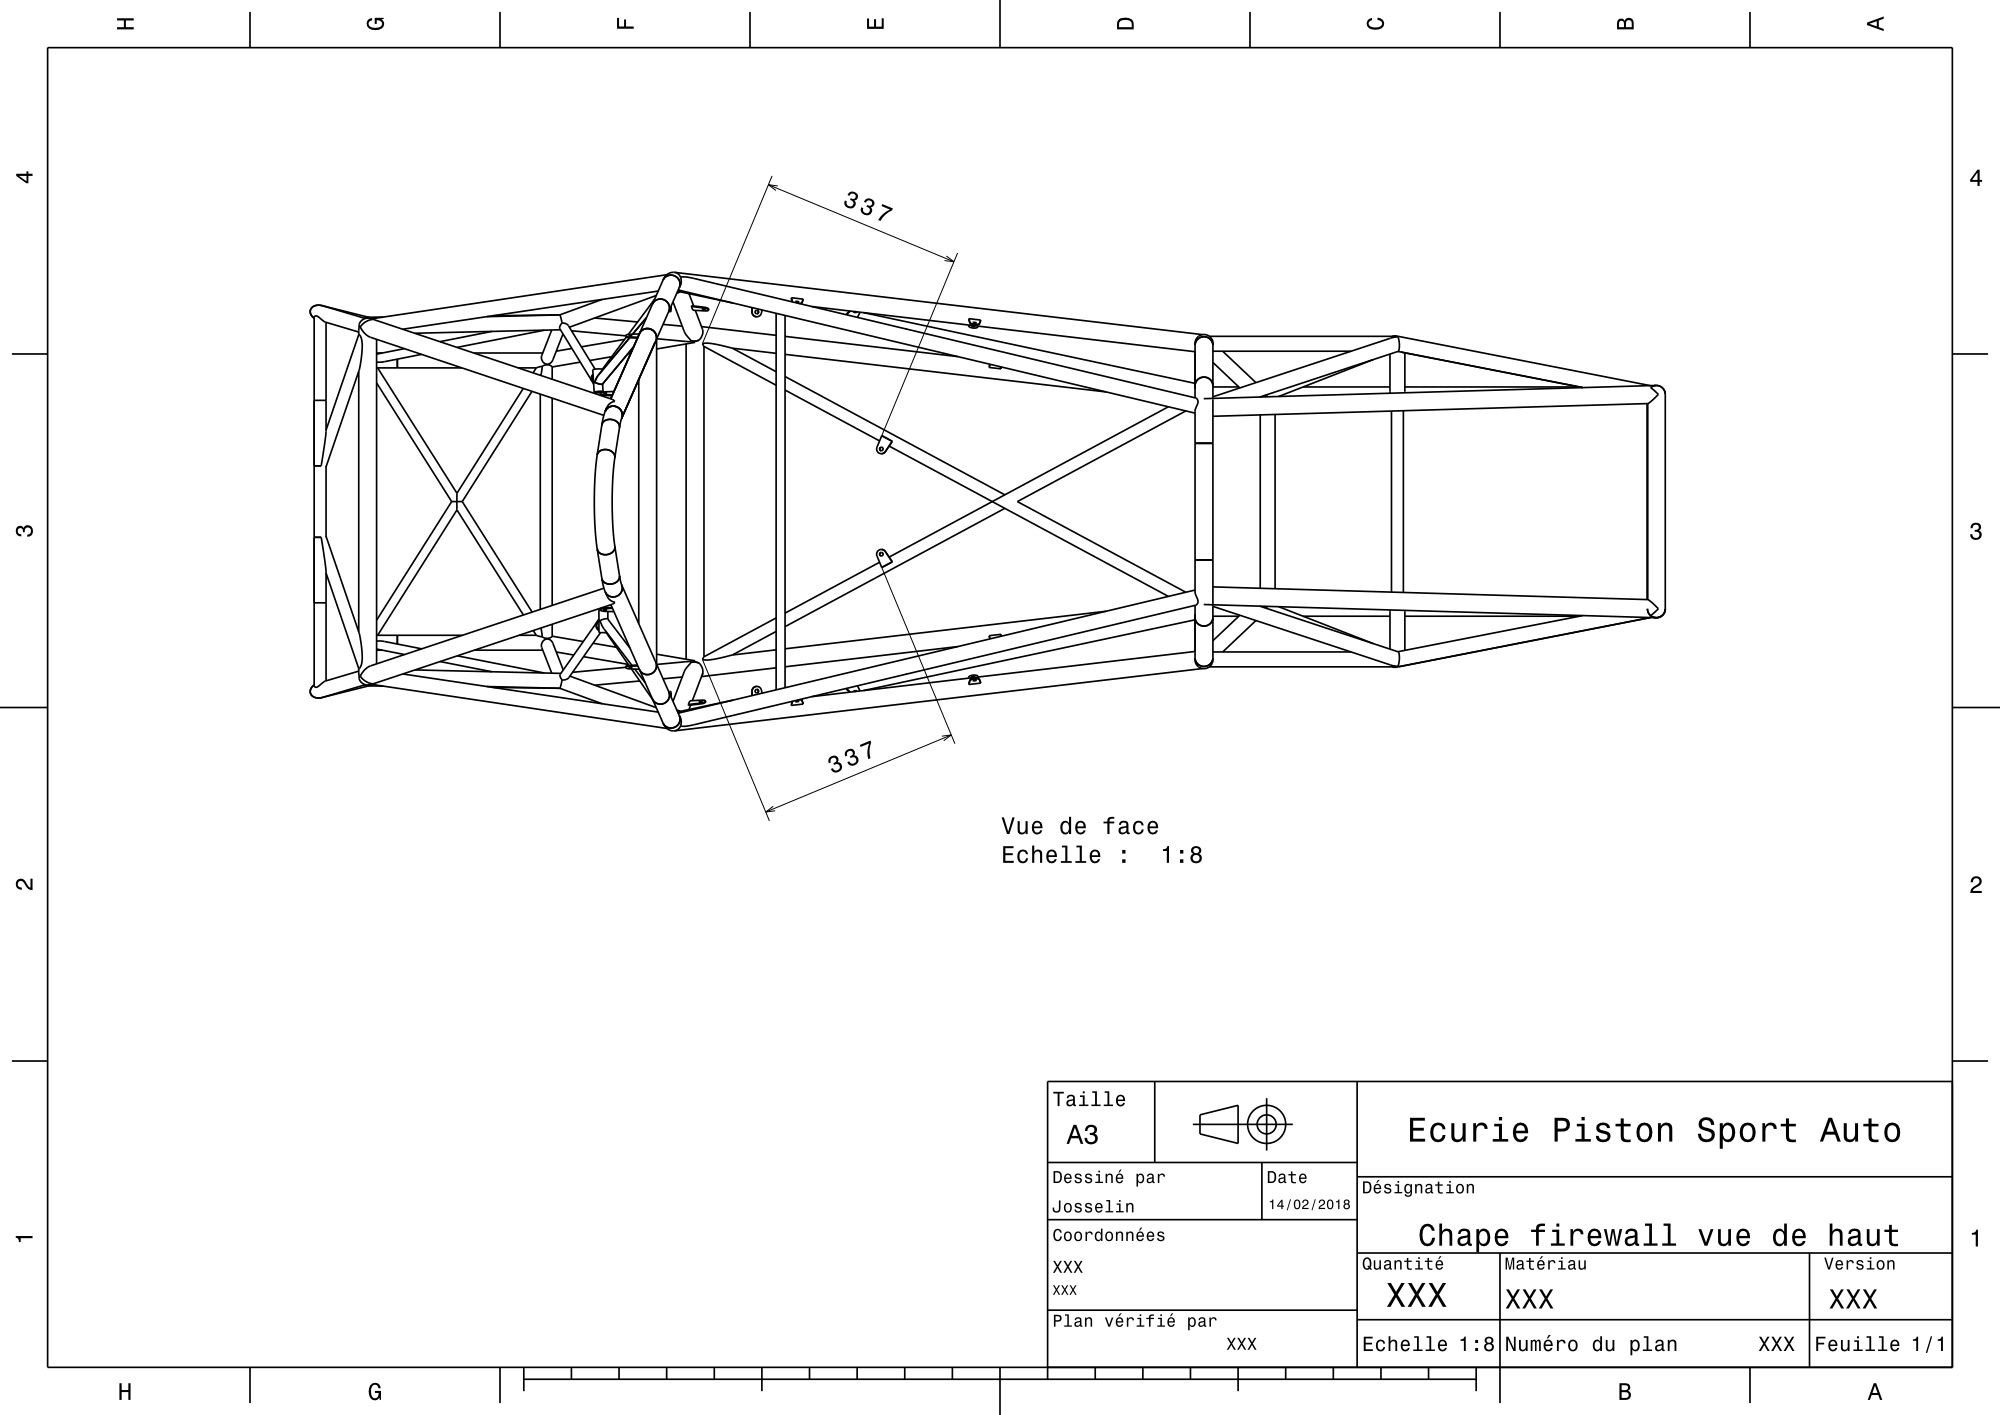
[picture p409: page 1]
