epsa-team/Vulcanix-v1.0/FR - Frame & Body/FR_A0100 (Frame)/Mise en plan pour chassis chapes/plan chassis chape firewall 3.pdf

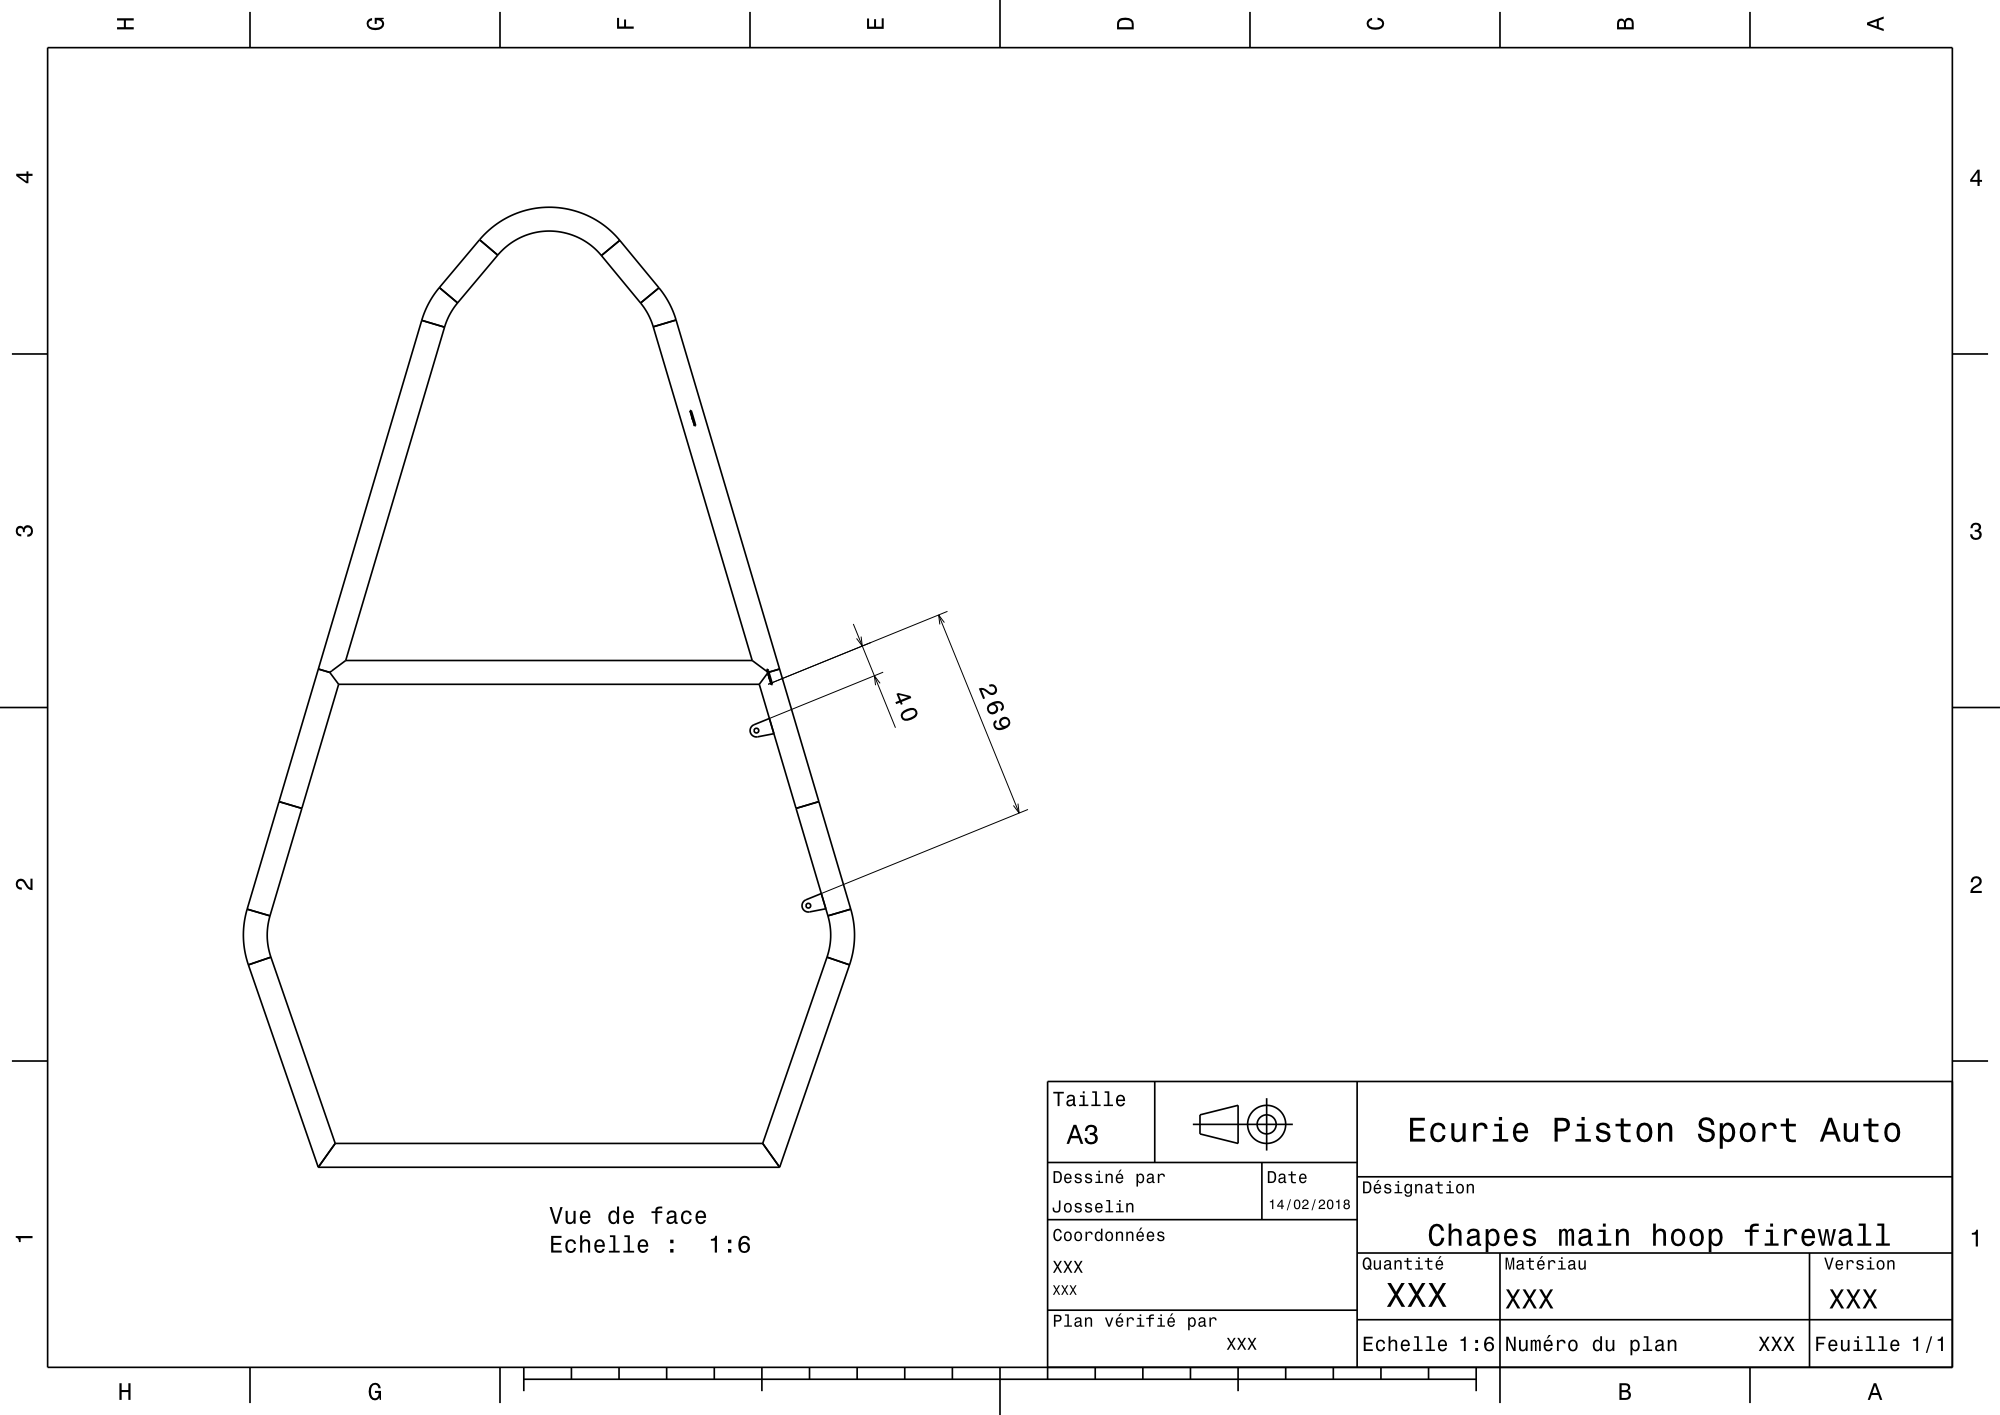
[picture p410: page 1]
