epsa-team/Vulcanix-v1.0/AA. Mise en plan/A verifier/PTN/FuelTankMain.pdf

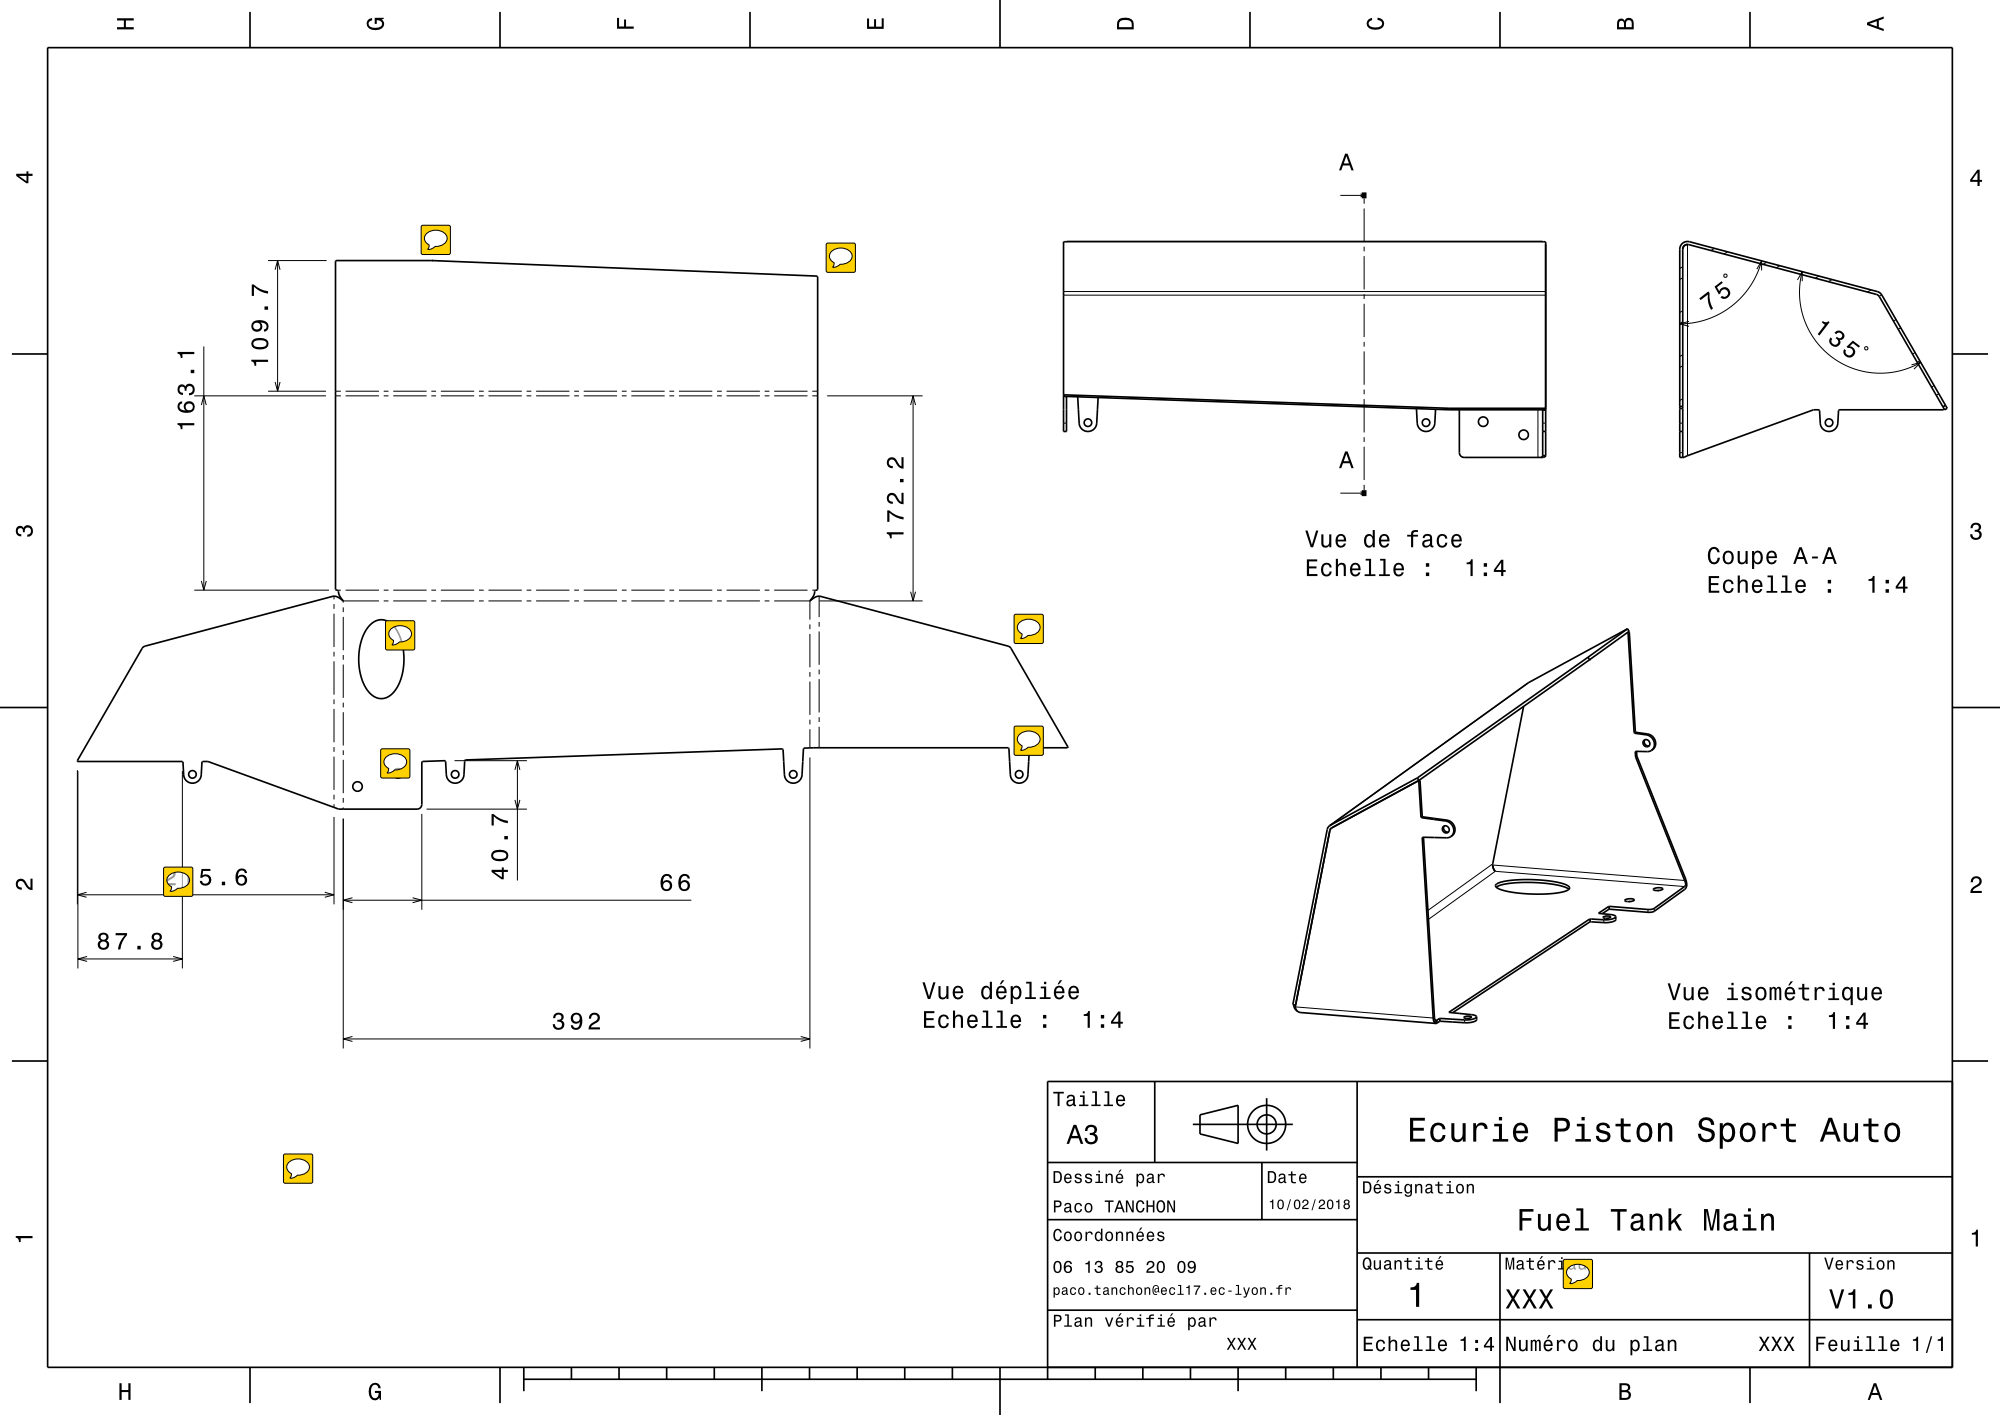
[picture p411: page 1]
