epsa-team/Vulcanix-v1.0/AA. Mise en plan/A verifier/VBS/a verifier/cache_cremaillere.pdf

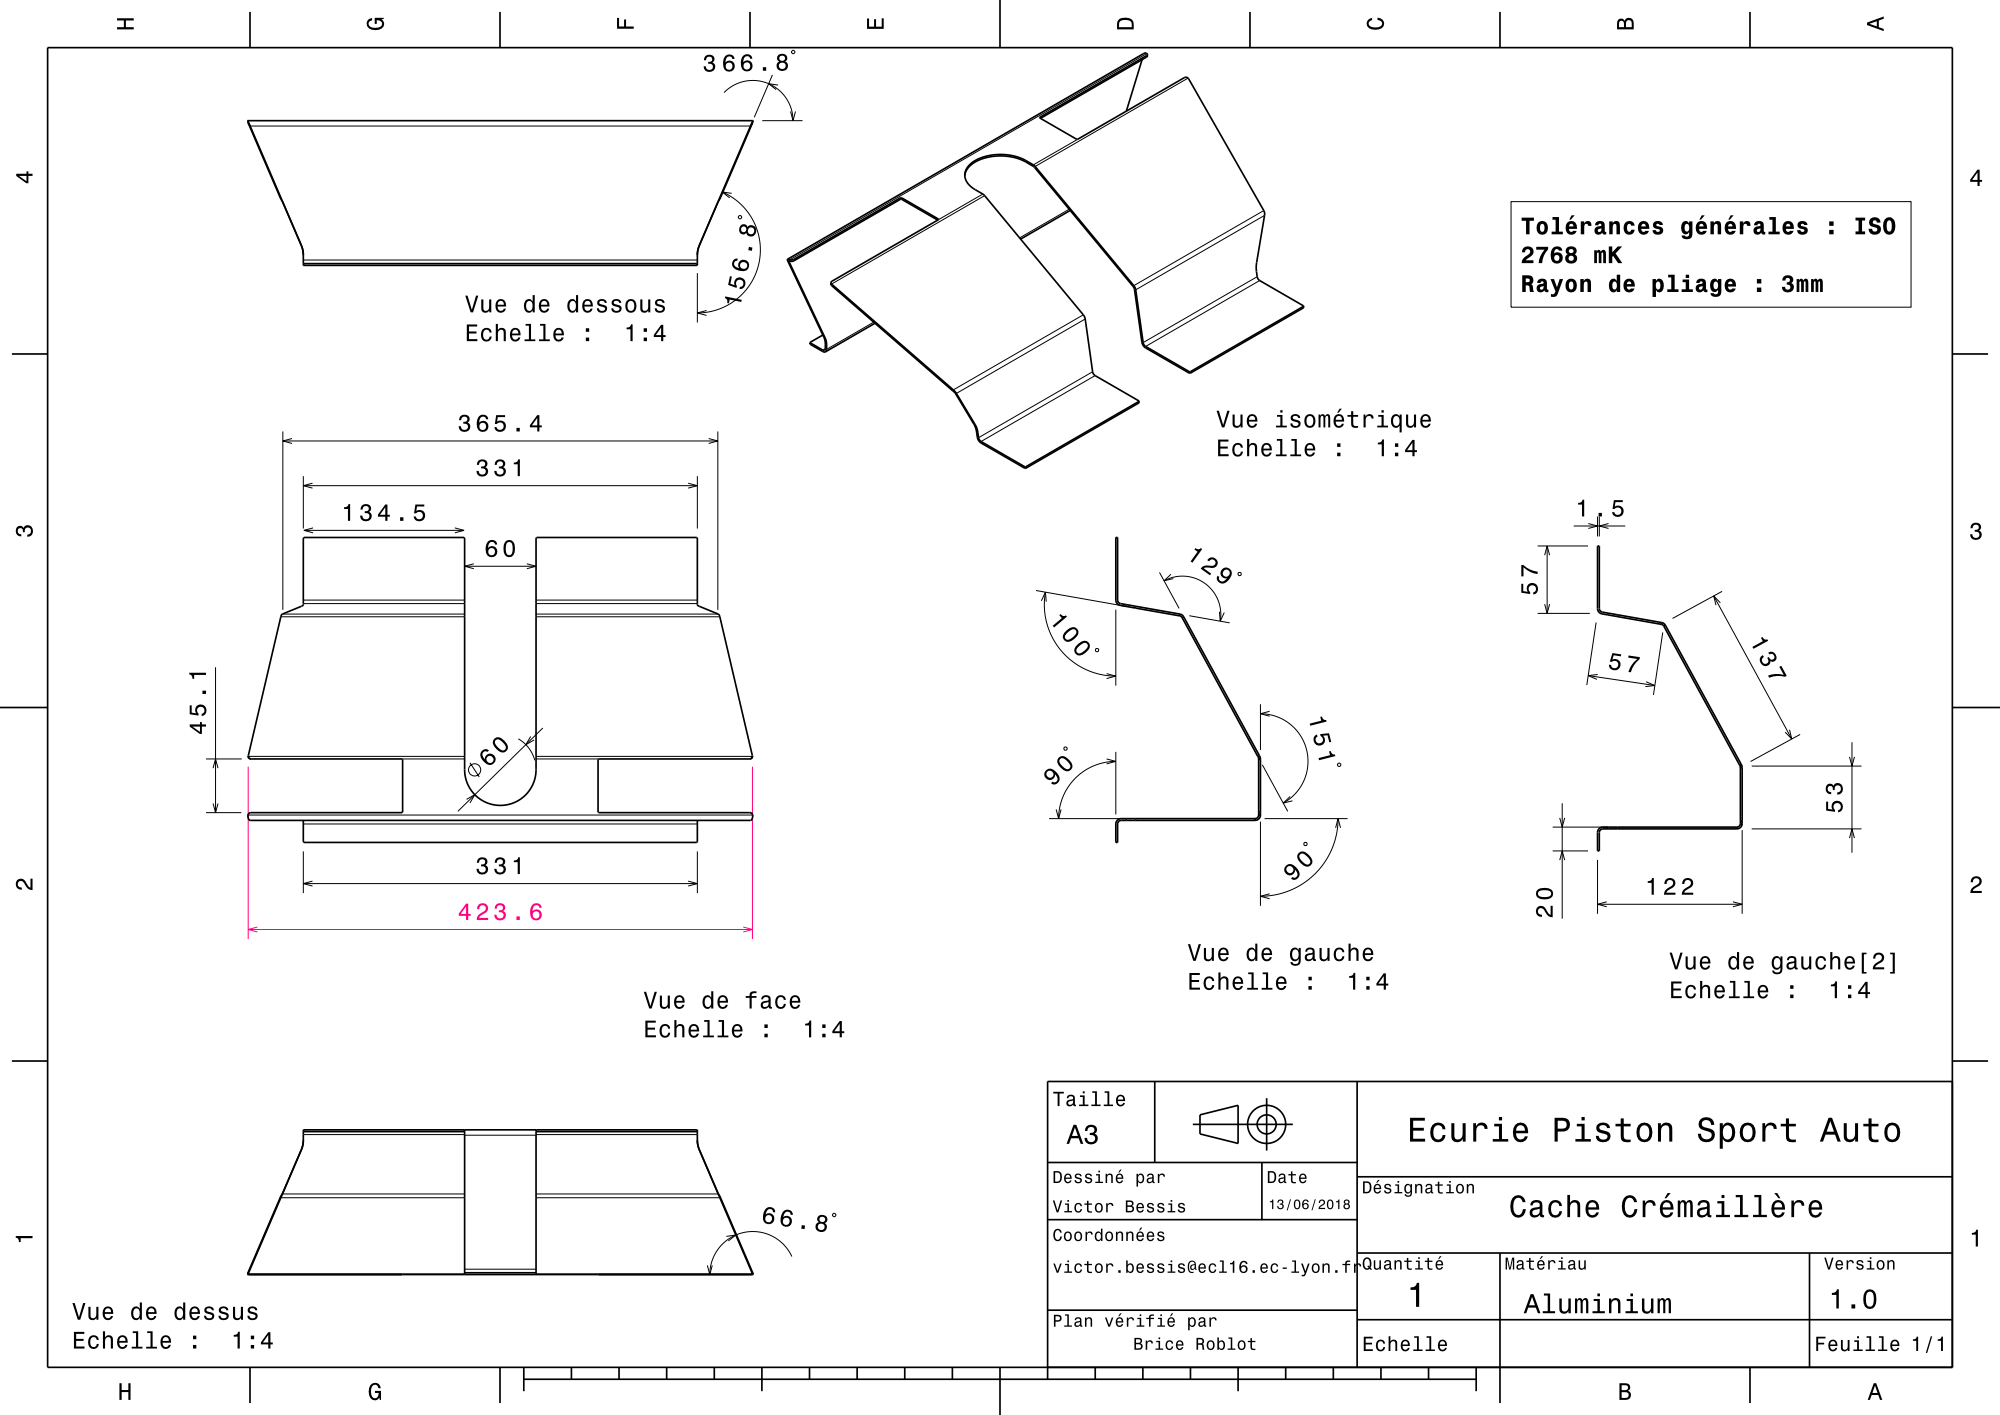
[picture p412: page 1]
