epsa-team/Vulcanix-v1.0/AA. Mise en plan/A verifier/VBS/a verifier/cachecremaillere.pdf

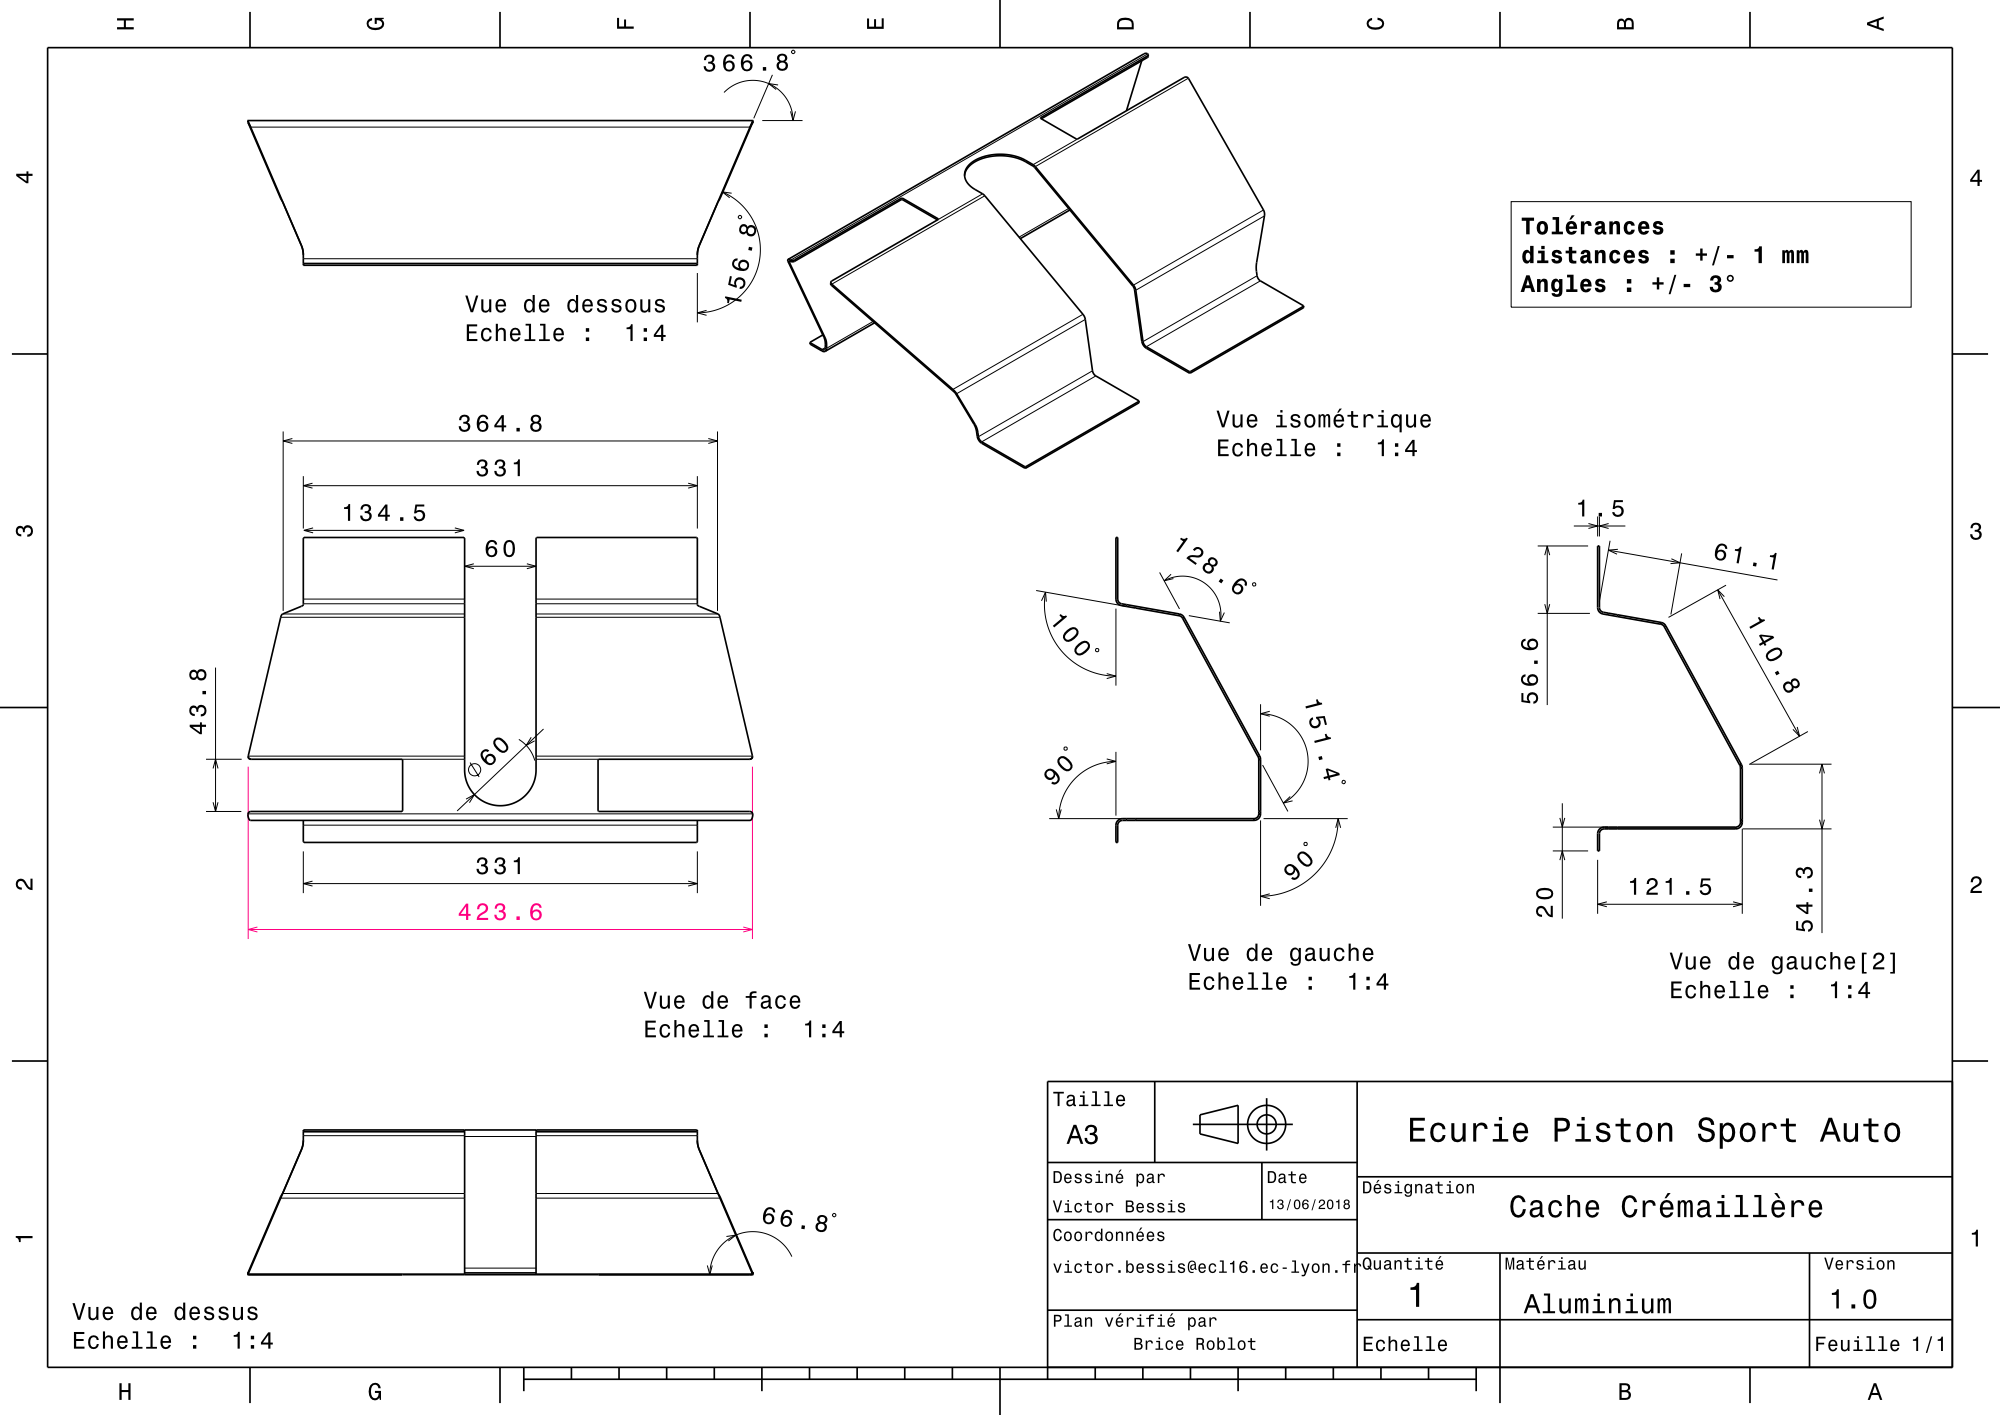
[picture p413: page 1]
