epsa-team/Vulcanix-v1.0/AA. Mise en plan/A verifier/VBS/a verifier/Grand_cache_cremaillere.pdf

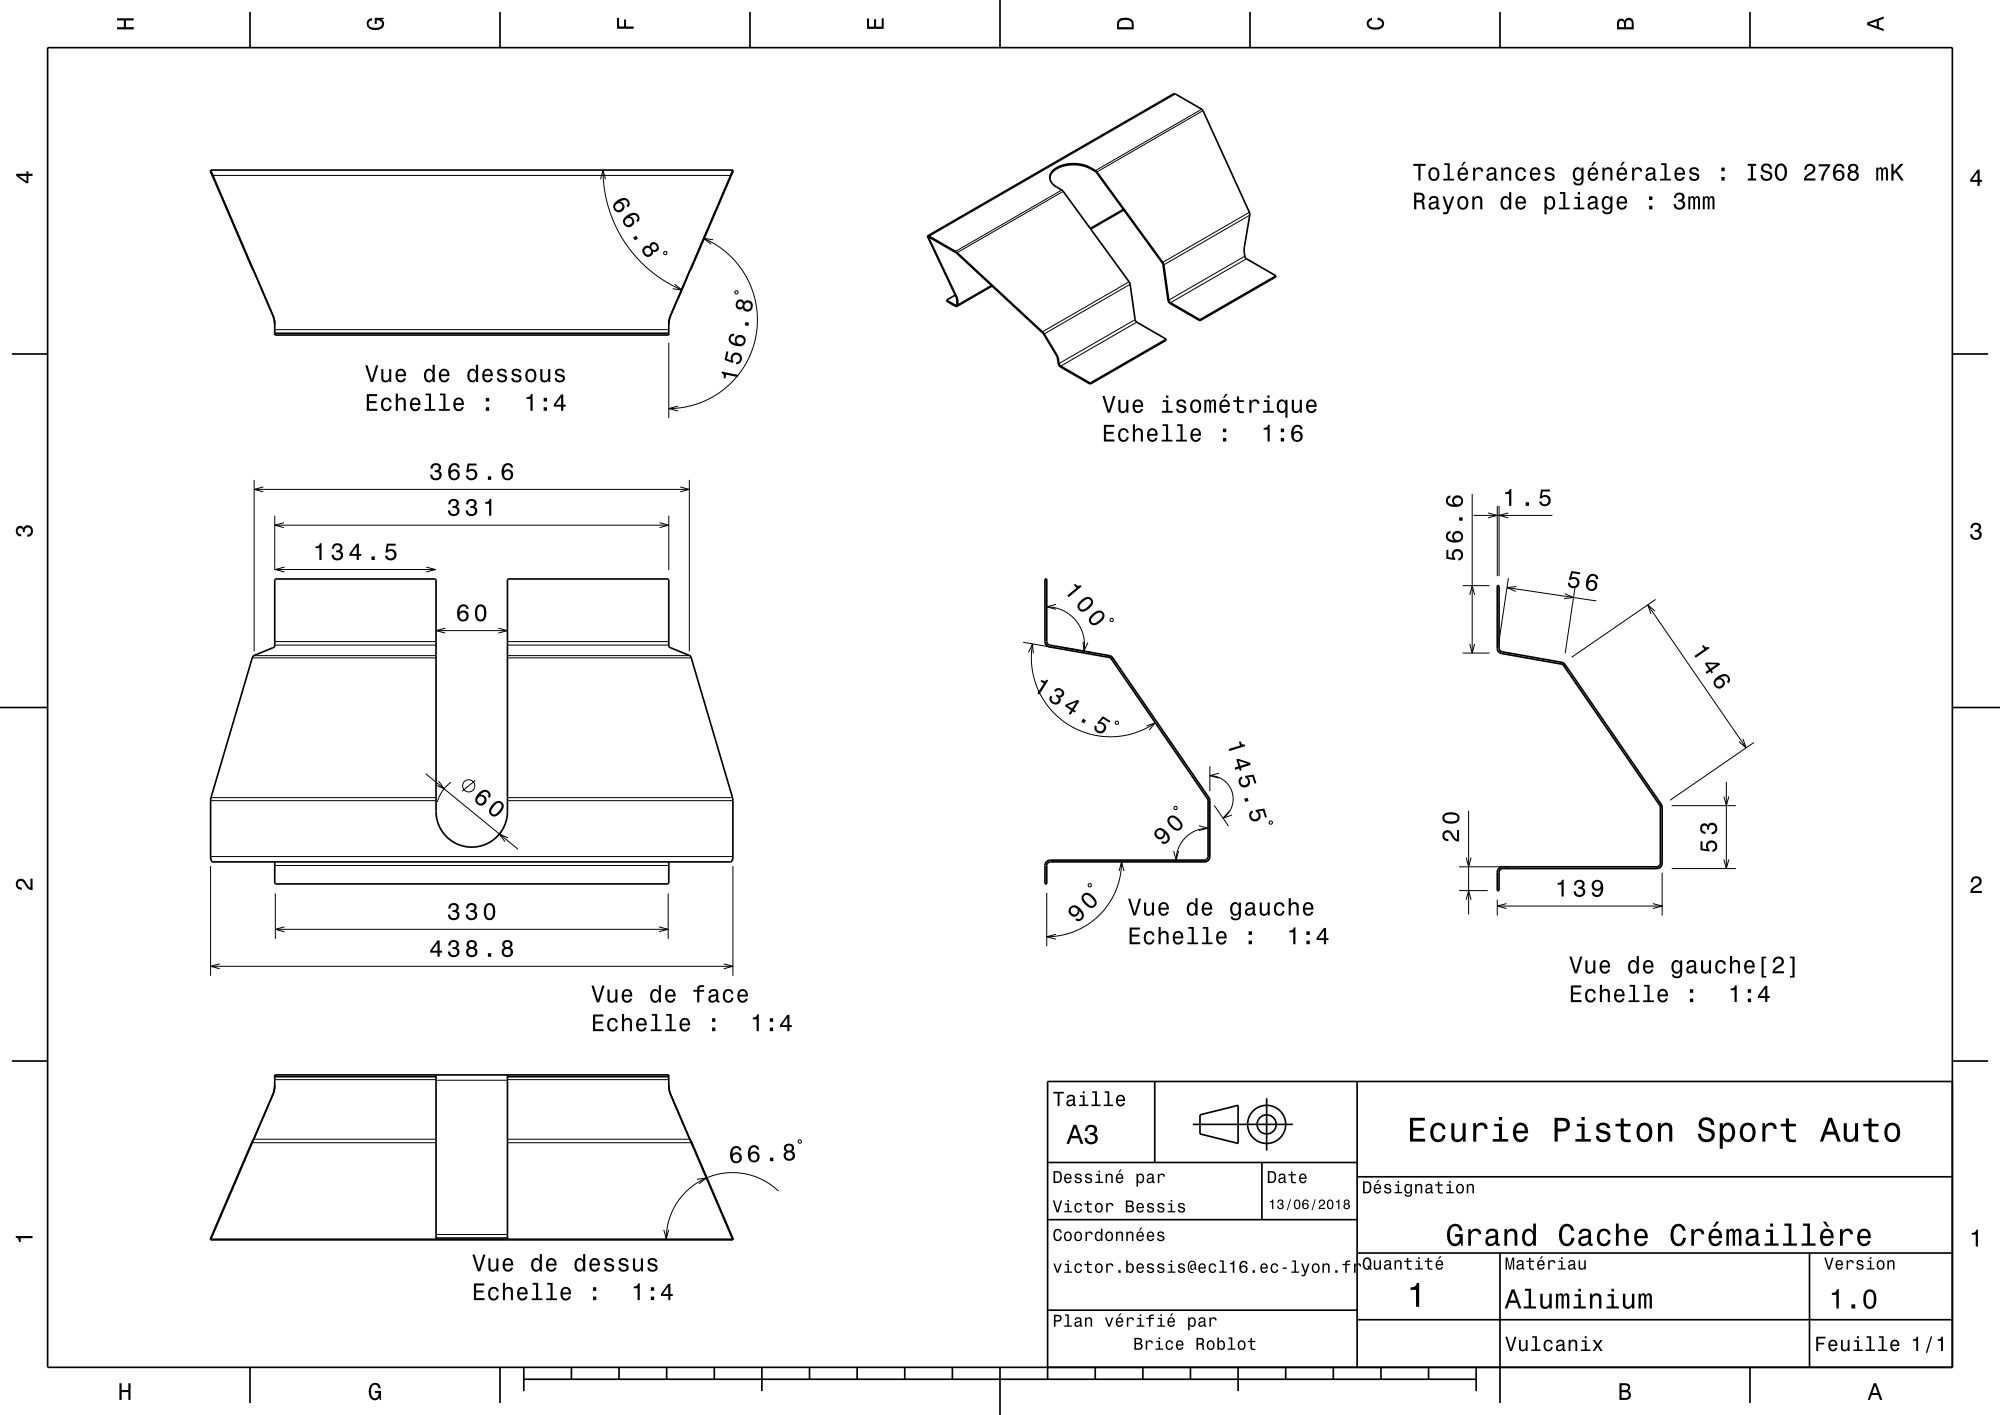
[picture p414: page 1]
