epsa-team/Vulcanix-v1.0/AA. Mise en plan/Verifie/Prod Boisard/Direction/SU_0900_002 (Inserts direction).pdf

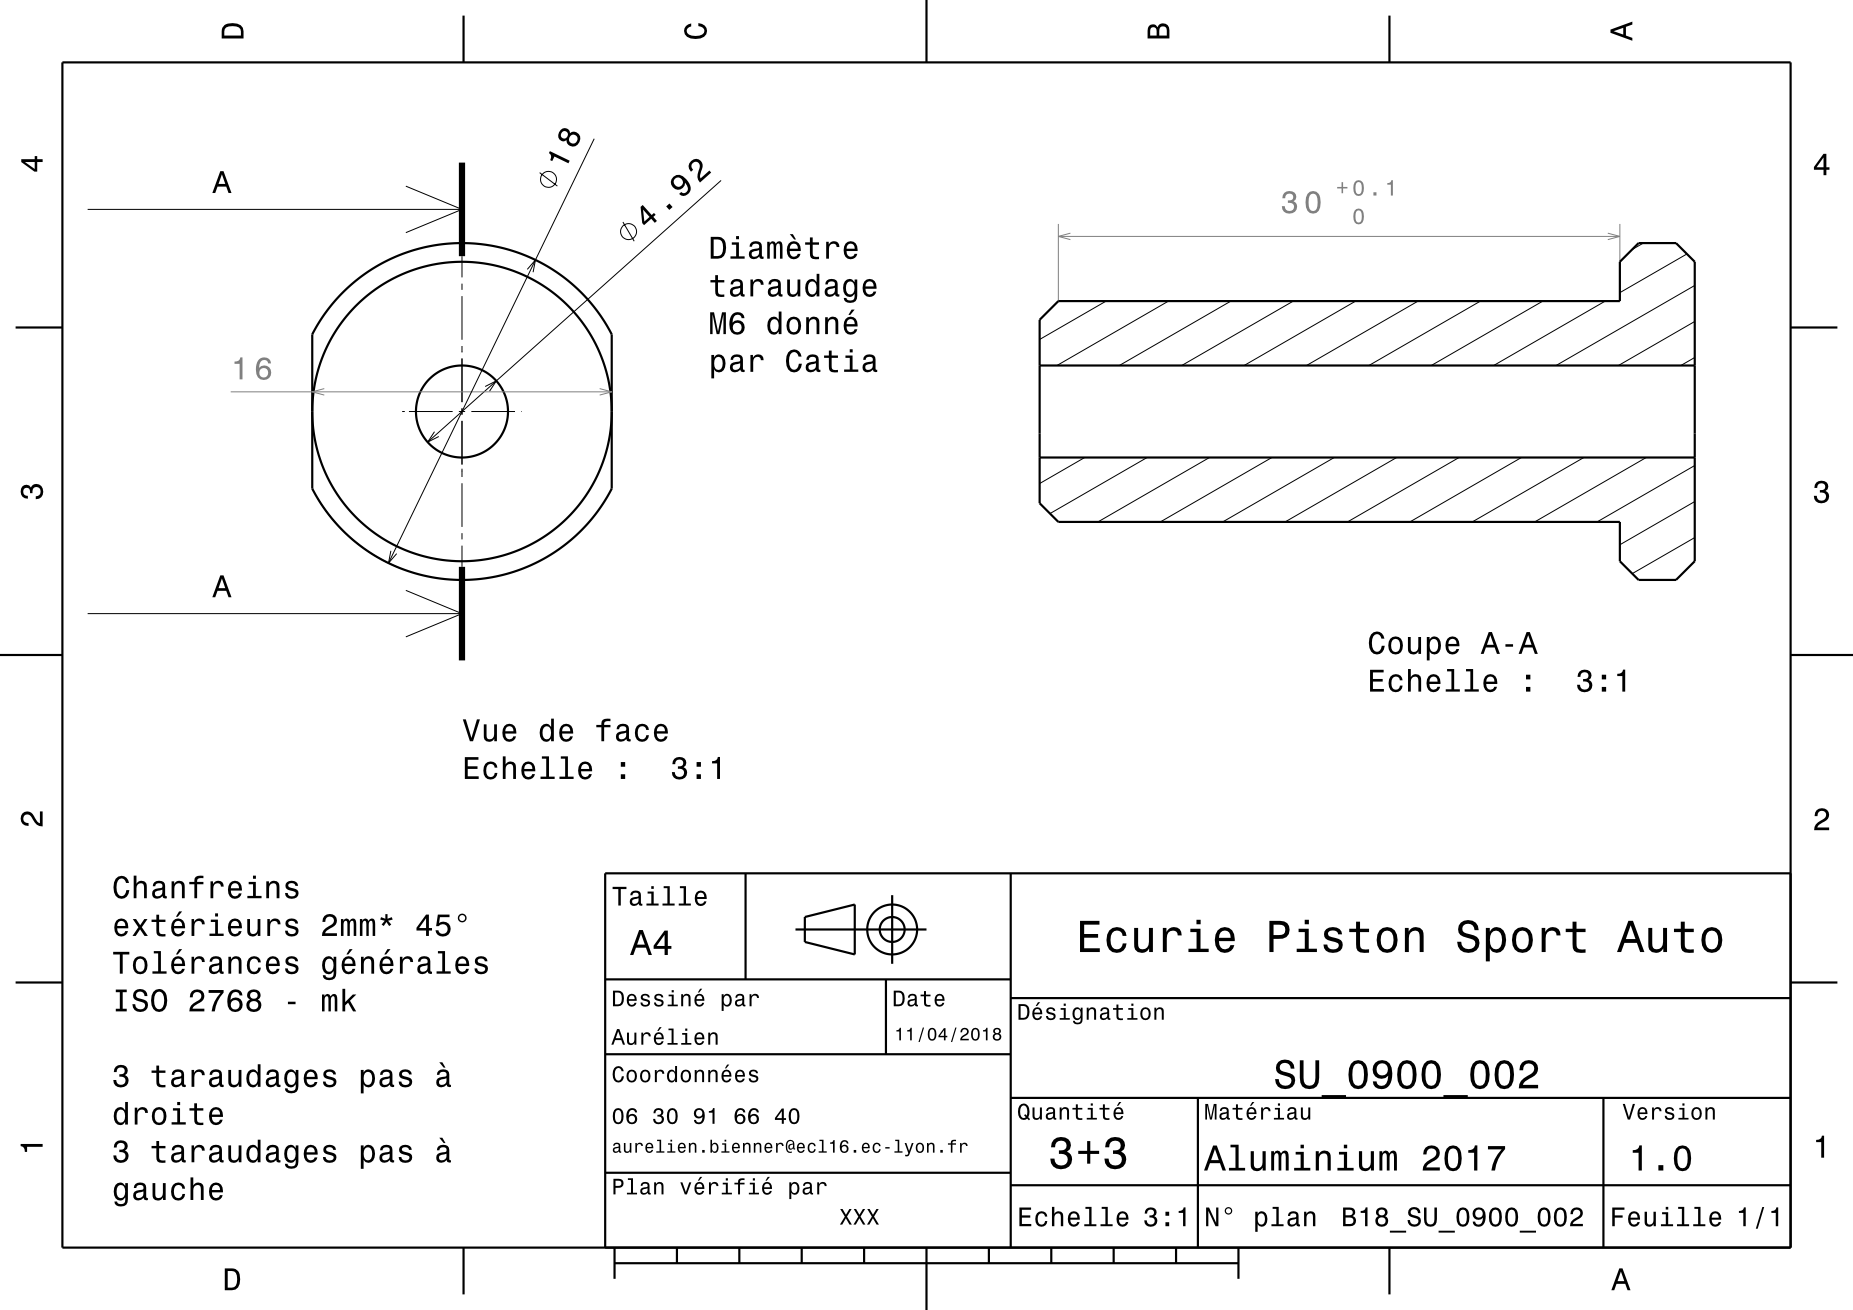
[picture p415: page 1]
