epsa-team/Vulcanix-v1.0/EL - Electrical/Electronics/Shifter/shield puissance.brd

## EAGLE design EL - Electrical/Electronics/Shifter/shield puissance.brd (2017-12-12)

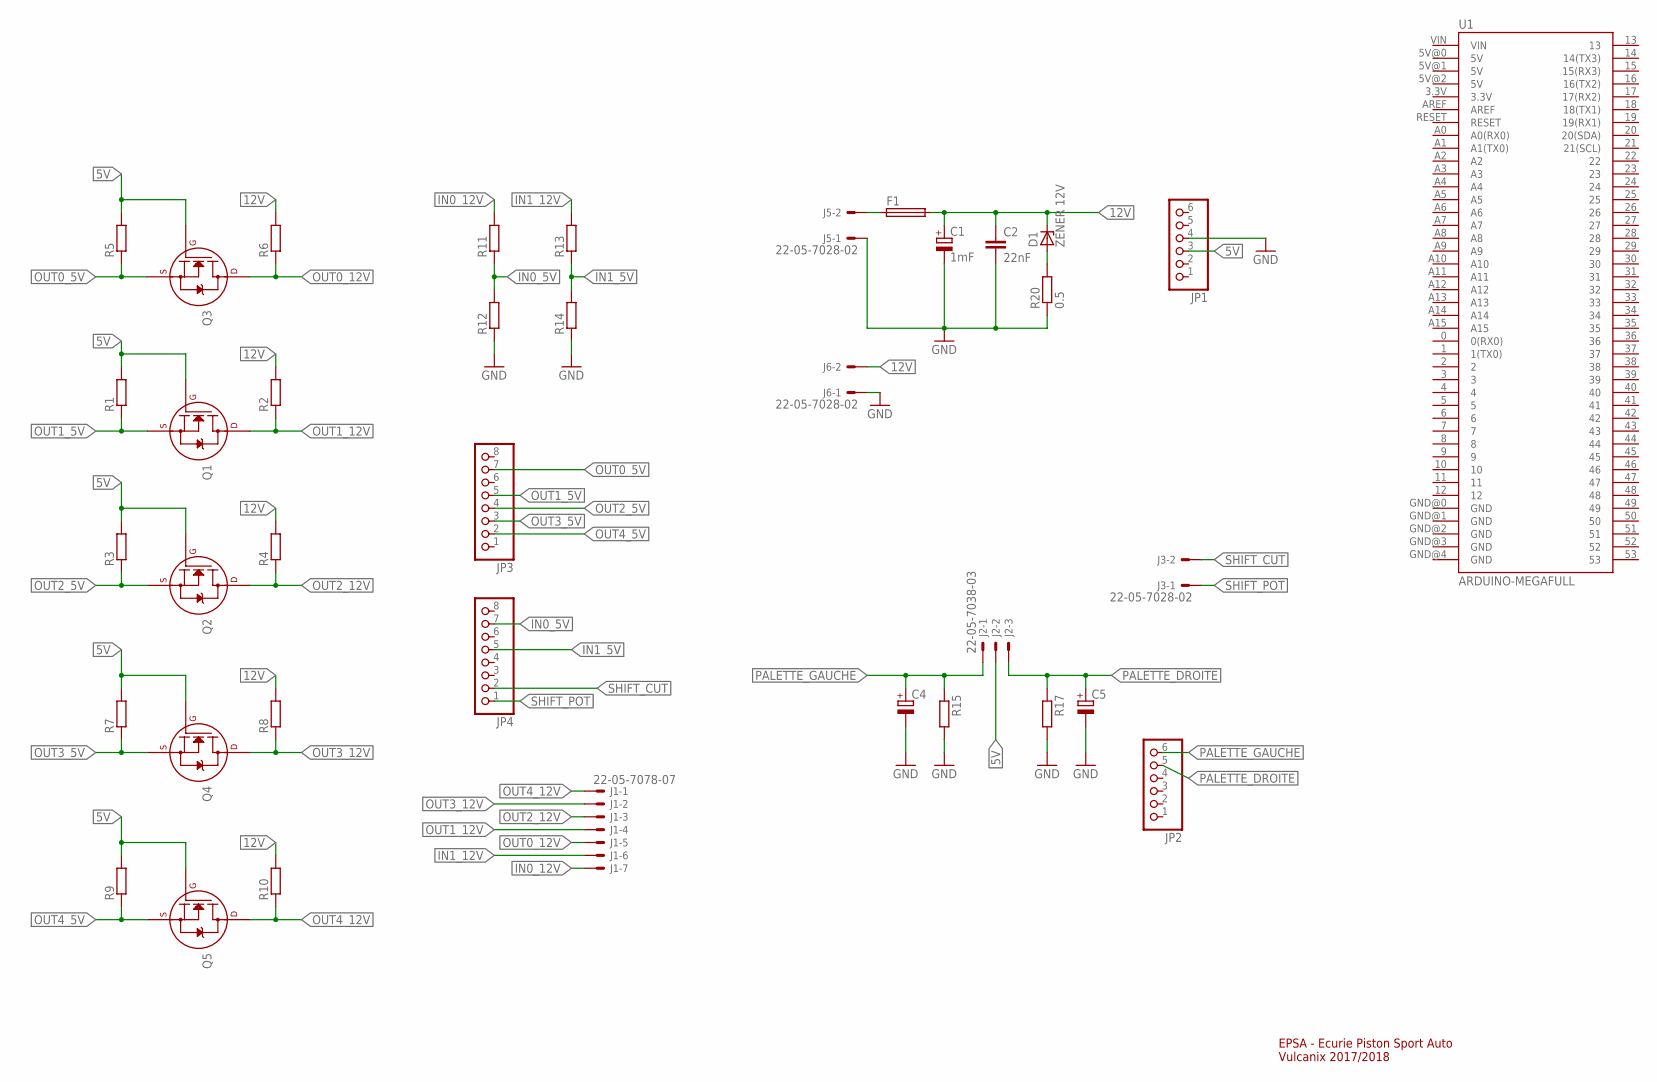
[picture p416: schematic shield puissance.sch]

Parts:
C1: 1mF; E2,5-6E
C2: 22nF; C025-025X050
C4, C5: CPOL-EUE2,5-6E; E2,5-6E
D1: ZENER 12V; DO41Z10
F1: SH25
J1: 22-05-7078-07; 7395-07
J2: 22-05-7038-03; 7395-03
J3, J5, J6: 22-05-7028-02; 7395-02
JP1, JP2: HEADER-1X6; 1X06_OVAL
JP3, JP4: HEADER-1X8; 1X08_OVAL
Q1, Q2, Q3, Q4, Q5: 2N7000_TO92; TO-92
R1, R2, R3, R4, R5, R6, R7, R8, R9, R10, R11, R12, R13, R14, R15, R17: R-EU_0204/7; 0204/7
R20: 0.5; 0309/12
U1: ARDUINO-MEGAFULL; ARDUINO_MEGA

Connections:
5V: J2.2, JP1.3, Q1.2 (G), Q2.2 (G), Q3.2 (G), Q4.2 (G), Q5.2 (G), R1.2, R3.2, R5.2, R7.2, R9.2
12V: C1.+, C2.1, D1.C, F1.2, J6.2, R2.2, R4.2, R6.2, R8.2, R10.2
GND: C1.-, C2.2, C4.-, C5.-, J5.1, J6.1, JP1.4, R12.1, R14.1, R15.2, R17.2, R20.1
IN0_5V: JP4.7, R11.1, R12.2
IN0_12V: J1.7, R11.2
IN1_5V: JP4.5, R13.1, R14.2
IN1_12V: J1.6, R13.2
unnamed: F1.1, J5.2
unnamed: D1.A, R20.2
OUT0_5V: JP3.7, Q3.1 (S), R5.1
OUT0_12V: J1.5, Q3.3 (D), R6.1
OUT1_5V: JP3.5, Q1.1 (S), R1.1
OUT1_12V: J1.4, Q1.3 (D), R2.1
OUT2_5V: JP3.4, Q2.1 (S), R3.1
OUT2_12V: J1.3, Q2.3 (D), R4.1
OUT3_5V: JP3.3, Q4.1 (S), R7.1
OUT3_12V: J1.2, Q4.3 (D), R8.1
OUT4_5V: JP3.2, Q5.1 (S), R9.1
OUT4_12V: J1.1, Q5.3 (D), R10.1
PALETTE_DROITE: C5.+, J2.3, JP2.5, R17.1
PALETTE_GAUCHE: C4.+, J2.1, JP2.6, R15.1
SHIFT_CUT: J3.2, JP4.2
SHIFT_POT: J3.1, JP4.1

Notes on the sheet:
EPSA - Ecurie Piston Sport Auto Vulcanix 2017/2018

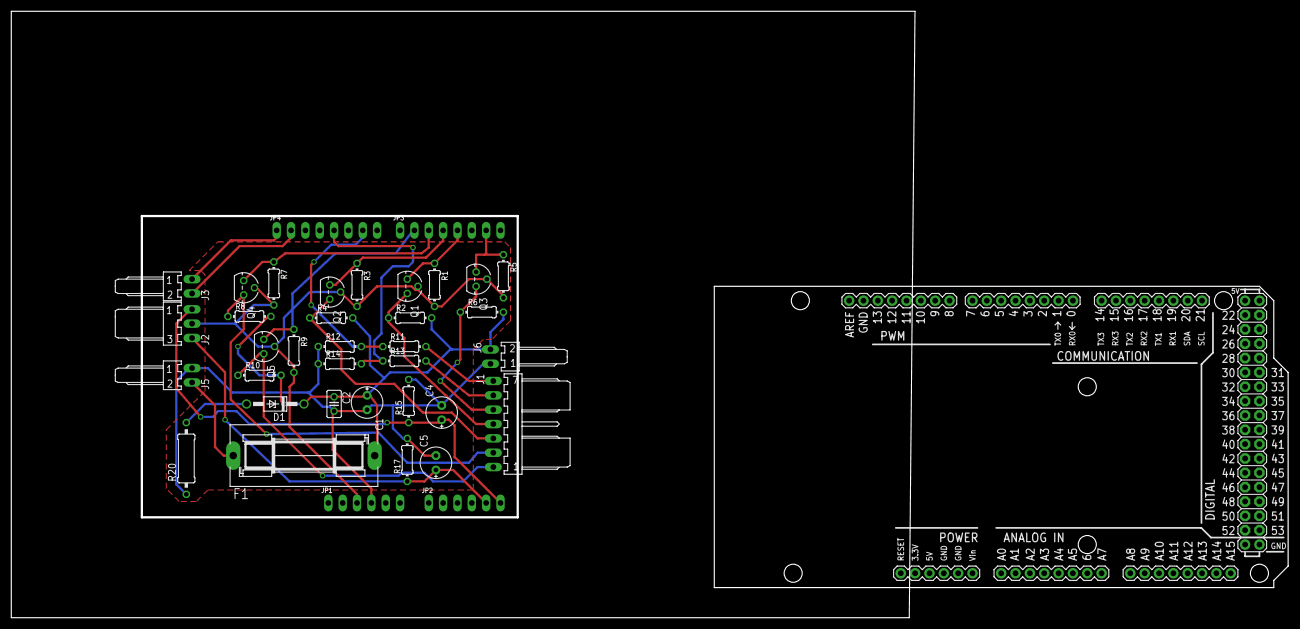
[picture p417: board shield puissance.brd from above]

Board: 2 copper layers, 226.1 x 107.4 mm, 38 parts (0 on the bottom side), 23 nets.
