epsa-team/Vulcanix-v1.0/(commit log)

2017-10-17 Ajout frame filaire
    [FRAME.CATPart]
2017-10-19 Ajout du châssis avec des tubes, et de la maquette finale
    [FRAME.CATPart, Frame_Tubulaire.CATProduct, Shape_027.CATPart, Shape_028.CATPart, Shape_029.CATPart, Shape_030.CATPart, Shape_031.CATPart, Shape_032.CATPart]
2017-10-19 Amélioration du commit précédent
    [FRAME.CATPart, Frame_Tubulaire.CATProduct, Vulcanix.CATProduct]
2017-10-20 Ajout d'autres tubes
    [FRAME.CATPart, Frame_Tubulaire.CATProduct, Shape_027.CATPart, Shape_028.CATPart, Shape_029.CATPart, Shape_030.CATPart, Shape_031.CATPart, Shape_032.CATPart]
2017-10-24 Mise en ligne du pilote
    [pilote.CATProduct]
2017-10-25 ajout chassis tubulaire
    [FRAME.CATPart, Shape_527.CATPart, Shape_528.CATPart, Shape_529.CATPart, Shape_530.CATPart, Shape_531.CATPart, Shape_532.CATPart, Shape_533.CATPart]
2017-11-07 ajout du pilote dans la voiture.
    [Vulcanix.CATProduct, pilote.CATProduct]
2017-11-07 Ajout des pièces du shifter
    [EN_0200_001_MM.CATPart, EN_0200_002_MM.CATPart, EN_0200_003_MM.CATPart, EN_0200_004_AA.CATPart, EN_0200_005_AA.CATPart, KROMAN.CATProduct, Newversion_chassis_final.CATPart, Newversion_chassis_sym_final.CATPart]
2017-11-09 Ajout de la carrosserie
    [FR_0700_000_BA.CATPart, FR_0700_001_BA.CATPart, FR_0700_002_BA.CATPart, FR_0700_003_BA.CATPart]
2017-11-10 Déplacement des fichiers du shifter vers la bonne destination
    [EN_0200_001_MM.CATPart, EN_0200_002_MM.CATPart, EN_0200_003_MM.CATPart, EN_0200_004_AA.CATPart, EN_0200_005_AA.CATPart, FR_0600_000_MM.CATPart, FR_0600_001_MM.CATPart, FR_0600_002_MM.CATPart]
2017-11-10 Siège, volant
    [MS_0400_001_AA.CATPart, ST_0400_001_AA.CATPart, ST_A0400.CATProduct]
2017-11-10 Réarrangement des fichiers
    [FRAME.CATPart, FR_0600_000_MM.CATPart, FR_0600_001_MM.CATPart, FR_0600_002_MM.CATPart, FR_0600_003_MM.CATPart, FR_0600_004_AA.CATPart, FR_0600_005_AA.CATPart, FR_0600_006_MM.CATPart]
2017-11-10 Second réarrangement
    [FRAME.CATPart, FR_0600_000_MM.CATPart, FR_0600_001_MM.CATPart, FR_0600_002_MM.CATPart, FR_0600_003_MM.CATPart, FR_0600_004_AA.CATPart, FR_0600_005_AA.CATPart, FR_0600_006_MM.CATPart]
2017-11-10 Idem que 2 précédents
    [FRAME.CATPart, FR_0600_000_MM.CATPart, FR_0600_001_MM.CATPart, FR_0600_002_MM.CATPart, FR_0600_003_MM.CATPart, FR_0600_004_AA.CATPart, FR_0600_005_AA.CATPart, FR_0600_006_MM.CATPart]
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2017-11-14 ajout du chassis.
    [Firewall.CATPart, Frame_Tubulaire.CATProduct, Shape_052.CATPart, Shape_053.CATPart, Shape_054.CATPart, Shape_055.CATPart, Shape_056.CATPart, Shape_057.CATPart]
2017-11-14 Mise à jour maquette Vulcanix.
    [Shape_527.CATPart, Shape_528.CATPart, Shape_529.CATPart, Shape_530.CATPart, Shape_531.CATPart, Shape_532.CATPart, Shape_533.CATPart, Shape_535.CATPart]
2017-11-15 Ajout Front Suspension Assy
    [SU_05002_AA_Front_Rocker.CATPart, SU_05003_Square Tube 25mm .CATPart, SU_A0500_Shock Front.CATProduct, Symmetry of TTX20 - Base Assembly - 200 - Extended.CATPart, Vulcanix.CATProduct, tubulaire.CATProduct]
2017-11-15 Modif SU-A0500
    [SU_A0500_Shock Front.CATProduct]
2017-11-15 Ajout des assemblages généraux
    [Frame_assy.CATProduct, Powertrain.CATProduct, Steering System.CATProduct, Suspension Assy.CATProduct]
2017-11-15 Mise à jour chassis.
    [FRAME.CATPart, Shape_540.CATPart, Shape_541.CATPart, Shape_563.CATPart, Shape_564.CATPart, Shape_565.CATPart, Shape_566.CATPart, Shape_567.CATPart]
2017-11-16 Amélioration de la maquette
    [FRAME.CATPart, FR_0200_001_MM.CATPart, Frame_assy.CATProduct, Miscellanous, Finish & Assembly.CATProduct, Powertrain.CATProduct, ST_0200_001_MM.CATPart, Standard Impact attenuator.stp, Steering System.CATProduct]
2017-11-16 Ajout filaire triangles + autres
    [BR 0100 001.CATPart, BR A0100.CATProduct, FRAME.CATPart, FR_0200_001_MM.CATPart, FR_0600_000_MM.CATPart, FR_0600_001_MM.CATPart, FR_0600_002_MM.CATPart, FR_0600_003_MM.CATPart]
2017-11-17 Air intake and Throttle body from Atomix
    [EN_A0300.CATProduct, EN_A0300_001_AA.CATPart, EN_A0300_002_AA.CATPart, EN_A0300_003_AA.CATPart, EN_A0300_004_AA.CATPart, EN_A0300_005_AA.CATPart, EN_A0300_006_AA.CATPart, EN_A0300_007_AA.CATPart]
2017-11-17 Amélioration de Vulcanix
    [BR 0100 001.CATPart, BR A0100.CATProduct, Frame_assy.CATProduct, Front Left Suspension.CATProduct, Front Left Upright Upper Arm Bracket.CATPart, Part2.CATPart, Rear Left Suspension.CATProduct, SU 0100 001.CATPart]
2017-11-17 Mise en position de la LAS
    [BR 0100 001.CATPart, BR A0100.CATProduct, FRAME.CATPart, FR_0200_001_MM.CATPart, Firewall.CATPart, Frame_assy.CATProduct, Front Left Suspension.CATProduct, Front Left Upright Upper Arm Bracket.CATPart]
2017-11-19 Importantion du système de carburant de Olympix.
    [Bouchon reservoir.CATPart, Chape_pompe_chassis.CATPart, Part7.CATPart, Produit42.CATProduct, Produit43.CATProduct, Raccord Dash6 Droit.CATPart, Rampe d'injection primaire v4.CATPart, Reference pompe.CATProduct]
2017-11-19 Changement nomenclature Fuel tank + fuel rail + fuel pump + pression regulator.
    [Bouchon reservoir.CATPart, Chape_pompe_chassis.CATPart, EN_0500_001_BA.CATPart, EN_A0400.CATProduct, Part7.CATPart, Produit42.CATProduct, Produit43.CATProduct, Raccord Dash6 Droit.CATPart]
2017-11-19 dépôt des pièces transmission secondaire
    [400-040-0096-00 Quadring3,68.CATPart, 400-090-0006-00 Druckfeder0,5x4x6,5.CATPart, 6010.CATProduct, 6011.CATProduct, 900-050-11013-00 GewindestiftM4.CATPart, DRX00001546.CATPart, DRX00002057.CATPart, DRX00002066.CATPart]
2017-11-20 Position du volant
    [ST_0400_001_AA.CATPart, ST_0400_AA.CATProduct, ST_A0400.CATProduct, Steering System.CATProduct, Vulcanix.CATProduct, WT 0100 004.CATPart, WT A0100.CATProduct]
2017-11-21 Renommage des pièces de l'admission à la bonne nomenclature.
    [EN_0300_001_AA.CATPart, EN_0300_002_AA.CATPart, EN_0300_003_AA.CATPart, EN_0300_004_AA.CATPart, EN_0300_005_AA.CATPart, EN_0300_006_AA.CATPart, EN_0300_007_AA.CATPart, EN_0600_001_MM.CATPart]
2017-11-21 Poignée d'embrayage
    [FR_0500_001_AA.CATPart, FR_0500_002_AA.CATPart, FR_0500_003_AA.CATPart, FR_0500_004_AA.CATPart, FR_0500_005_AA.CATPart, FR_A0500.CATProduct, ST_0300_01_MM.CATPart]
2017-11-21 poignée sur la maquette
    [Frame_assy.CATProduct]
2017-11-21 Ajout amortisseur avant
    [Front Left Shock Absorber.CATProduct, Front Left Suspension.CATProduct, Front shock absorber.CATProduct, Rear Left Suspension.CATProduct, Suspension Assy.CATProduct, Vulcanix.CATProduct]
2017-11-21 Mise à jour front hoop.
    [FRAME.CATPart]
2017-11-21 Nouvelle position pilote + baquet
    [Frame_assy.CATProduct, Shape_531.CATPart, Shape_532.CATPart, Shape_533.CATPart, Shape_535.CATPart, Shape_536.CATPart, Shape_537.CATPart, Shape_538.CATPart]
2017-11-21 Rectifications admission
    [EN_0300_001_AA.CATPart, EN_0600_001_MM.CATPart, EN_0600_002_MM.CATPart, EN_A0600.CATProduct]
2017-11-21 Quick Release sur la maquette
    [ST_0300_01_MM.CATPart, Steering System.CATProduct, Vulcanix.CATProduct]
2017-11-21 EN - assemblages differential + driveshafts + chain set
    [6010.CATProduct, 6011.CATProduct, EN_0900_004_AA.CATPart, EN_0900_005_AA.CATPart, EN_0900_006_AA.CATPart, EN_0900_006_AB.CATPart, EN_0900_007_AA.CATPart, EN_1000_004_AA.CATPart]
2017-11-21 Modifications admission
    [EN_0600_001_MM.CATPart, EN_0600_002_MM.CATPart, EN_A0300.CATProduct, EN_A0600.CATProduct]
2017-11-21 Perçage volant
    [ST_0400_001_AA.CATPart, Steering System.CATProduct]
2017-11-21 Mise à jour cellule arrière.
    [FRAME.CATPart, Shape_542.CATPart, Shape_543.CATPart, Shape_544.CATPart, Shape_545.CATPart, Shape_546.CATPart, Shape_547.CATPart, Shape_548.CATPart]
2017-11-21 AJOUT SU_A1200_REAR_ARB_ASSY
    [SU_12001_ARB_REAR_PLATE.CATPart, SU_12001_ROD_ARB_ARR.CATPart, SU_12003_SHEAR_REAR_PLATE_ARB.CATPart, SU_A1200_REAR_ARB_ASSY.CATProduct]
2017-11-21 Ajout du différentiel dans powertrain
    [Powertrain.CATProduct]
2017-11-22 AJOUT SU - Suspension/SKF BEARING et SU_12004
    [HK_2020.CATProduct, HK_2020_PART1.CATPart, HK_2020_PART2.CATPart, HK_2020_PART3.CATPart, SU_12004_REAR_ARB_SUPPORT.CATPart]
2017-11-22 Modification SU_A1200
    [HK_2020.CATProduct, HK_2020_PART3.CATPart, SU_12001_ARB_REAR_PLATE.CATPart, SU_12003_SHEAR_REAR_PLATE_ARB.CATPart, SU_12004_REAR_ARB_SUPPORT.CATPart, SU_A1200_REAR_ARB_ASSY.CATProduct]
2017-11-22 ajout pièces tripodes oubliées
    [EN_1000_003_AA.CATProduct, EN_1000_003_MM.CATProduct, FSAE Tripod V2.CATPart, FSAE roller_2451.CATPart, Tripod Retainer.CATPart, needle.CATPart]
2017-11-23 Ajout de pieces de la partie electronique. /!\ Pas de materiaux appliqués sur les pieces sous CATIA /!\
    [EL_0100_001.CATPart, EL_0200_001_AA.CATPart, EL_0200_002_AA.CATPart, EL_0400_001_AA.CATPart]
2017-11-23 Rectification d'une erreur de nomenclature
    [EL_0200_002_AA.CATPart, EL_0300_001_AA.CATPart]
2017-11-23 redimensionnement portes-excentriques
    [EN_0900_006_AB.CATPart, EN_0900_007_AA.CATPart]
2017-11-23 correction bug de tripod pas trouvés sur EN_1000 (Driveshaft)
    [EN_A1000.CATProduct]
2017-11-24 mise en position de la transmission
    [EN_0900_006_AB.CATPart, EN_0900_007_AA.CATPart, EN_1100_002_AA.CATPart, EN_A0900.CATProduct, EN_A1000.CATProduct, Frame_assy.CATProduct, Powertrain.CATProduct, Vulcanix.CATProduct]
2017-11-24 ajout du châssis dans la Suspension
    [Front Left Suspension.CATProduct, Rear Left Suspension.CATProduct, Suspension Assy.CATProduct, Vulcanix.CATProduct]
2017-11-24 2ème correction bug tripod
    [EN_A1000.CATProduct, Powertrain.CATProduct]
2017-11-25 positionnement des nouveaux triangles.
    [Front Left Suspension.CATProduct, Suspension Assy.CATProduct, wireframe_arms.CATPart]
2017-11-25 Ajout du shifter dans powertrain
    [EN_A0900.CATProduct, EN_A1000.CATProduct, EN_A1100.CATProduct, Powertrain.CATProduct, circlip.CATPart]
2017-11-25 Ajout Refroidissement
    [EN_1200_001 - Radiator.CATPart, EN_1200_003 - Silentblock.CATPart, EN_1200_004 - Fixing Bar Bottom.CATPart, EN_1200_005 - Chape Radiateur.CATPart, EN_A1200 - Cooling System ASSY.CATProduct]
2017-11-25 ajout radiateur dans powertrain.
    [EN_A0900.CATProduct, EN_A1000.CATProduct, Frame_assy.CATProduct, Powertrain.CATProduct, Suspension Assy.CATProduct, Vulcanix.CATProduct]
2017-11-26 début mise en place cooling
    [EN_A0900.CATProduct, EN_A1000.CATProduct, EN_A1200 - Cooling System ASSY.CATProduct, Powertrain.CATProduct]
2017-11-26 Modification carrosserie
    [FR_0700_000_BA.CATPart, FR_0700_000_CA.CATPart, FR_0700_001_BA.CATPart, FR_0700_001_CA.CATPart, FR_0700_002_BA.CATPart, FR_0700_003_BA.CATPart]
2017-11-26 Ajout des pièces du pédalier
    [FR_0300_000_BA.CATPart, FR_0300_001_BA.CATPart, FR_0300_002_BA.CATPart, FR_0300_003_BA.CATPart, FR_0300_004_BA.CATPart, FR_0300_005_BA.CATPart, FR_0300_006_BA.CATPart, FR_0300_007_BA.CATPart]
2017-11-26 Ajout assemblage pédalier
    [FR_0300_000_BA.CATPart, FR_0300_001_BA.CATPart, FR_0300_002_BA.CATPart, FR_0300_003_BA.CATPart, FR_0300_004_BA.CATPart, FR_0300_005_BA.CATPart, FR_0300_006_BA.CATPart, FR_0300_007_BA.CATPart]
2017-11-26 Ajout pédalier sur la maquette Frame and Body
    [FR_A0300.CATProduct, Frame_assy.CATProduct]
2017-11-26 Modification écartement pédales
    [FR_A0300.CATProduct, Frame_assy.CATProduct]
2017-11-26 Ajout carrosserie sur assemblage Frame and Body
    [FR_0700_000_CA.CATPart, FR_0700_001_CA.CATPart, FR_0700_002_BA.CATPart, FR_0700_003_BA.CATPart, FR_A0300.CATProduct, Frame_assy.CATProduct]
2017-11-26 modif suspension
    [Suspension Assy.CATProduct]
2017-11-26 mise à jour transmission
    [EN_0900_006_AB.CATPart, EN_0900_007_AA.CATPart, EN_1100_002_AA.CATPart, EN_1100_005_AA.CATPart, EN_A0900.CATProduct, EN_A1000.CATProduct, EN_A1100.CATProduct]
2017-11-26 mise à jour transmission2
    [Powertrain.CATProduct]
2017-11-27 début mise en place refroidissement
    [EN_A0900.CATProduct, EN_A1000.CATProduct, EN_A1200 - Cooling System ASSY.CATProduct, Powertrain.CATProduct]
2017-11-27 correction bug cooling
    [Powertrain.CATProduct, Vulcanix.CATProduct]
2017-11-27 MÀJ - SU_FILAIRE_TRIANGLE
    [wireframe_arms.CATPart]
2017-11-27 Modifications sur pédalier (branche pédale d'accel et rails)
    [Chaussure 45.CATPart, FR_0300_000_BA.CATPart, FR_0300_001_BA.CATPart, FR_0300_002_BA.CATPart, FR_0300_003_BA.CATPart, FR_0300_004_BA.CATPart, FR_0300_011_BA.CATPart, FR_0300_012_BA.CATPart]
2017-11-28 Mise à jour Main Hoop et basculeur avant.
    [FRAME.CATPart, Firewall.CATPart, Shape_531.CATPart, Shape_532.CATPart, Shape_533.CATPart, Shape_535.CATPart, Shape_536.CATPart, Shape_537.CATPart]
2017-11-28 Point attache moteur, suspension arrière et main hoop bracing.
    [FRAME.CATPart, Shape_535.CATPart, Shape_536.CATPart, Shape_537.CATPart, Shape_538.CATPart, Shape_539.CATPart, Shape_540.CATPart, Shape_541.CATPart]
2017-11-29 dimensionnement évidemment portes-excentriques EN_0900_006 et EN_0900_007
    [EN_0900_006_AB.CATPart, EN_0900_007_AA.CATPart]
2017-11-29 Mise à jour des maitres cylindres
    [FR_0300_001_BA.CATPart, FR_0300_012_BA.CATPart, FR_0300_014_BA.CATPart, FR_0300_015_BA.CATPart, FR_0300_016_BA.CATPart, FR_0300_017_BA.CATPart, FR_0300_018_BA.CATPart, FR_0300_019_BA.CATPart]
2017-11-29 suppression temporaire cooling
    [EN_1200_001 - Radiator.CATPart, EN_1200_003 - Silentblock.CATPart, EN_1200_004 - Fixing Bar Bottom.CATPart, EN_1200_005 - Chape Radiateur.CATPart, EN_A1200 - Cooling System ASSY.CATProduct]
2017-11-29 Basculeur (car problème pc guillaume)
    [ISO_4014_M8x45_STEEL_GRADE_A_HEXAGON_HEAD_BOLT.CATPart, ISO_4032_M8_STEEL_GRADE_A_HEXAGON_NUT.CATPart, ISO_7089_8x16_STEEL_GRADE_A_NORMAL_SERIES_PLAIN_WASHER.CATPart, ISO_7089_8x16_STEEL_GRADE_A_NORMAL_SERIES_PLAIN_WASHER_New_135.CATPart, SU_0800_001.CATPart, SU_0800_002.CATPart, SU_0800_003.CATPart, SU_A0800.CATProduct]
2017-11-29 Direction, basculeur arrière.
    [ST_0100_001.CATProduct, ST_0200_001_MM.CATPart, ST_0200_002 .CATPart, ST_0200_003.CATPart, ST_0300_002.CATPart, ST_A0200.CATProduct, ST_A0300.CATProduct, SU_0700_002.CATPart]
2017-11-29 création groupe de contrainte : mise en position différentiel / tubulaire
    [Powertrain.CATProduct]
2017-11-29 mise en position differentiel --> compatibilité chapes + design brackets du chainshield
    [EN_0900_006_AB.CATPart, EN_1100_002_AA.CATPart, EN_1100_005_AA.CATPart, EN_A0900.CATProduct, EN_A1000.CATProduct, EN_A1100.CATProduct, Powertrain.CATProduct]
2017-11-29 hiérarchisation des contraintes powertrain
    [Powertrain.CATProduct]
2017-11-29 suppression des tripods housing côté roue dans Powertrain
    [EN_1000_005_AA.CATPart, EN_A1000.CATProduct]
2017-11-29 Mise à jour échappement
    [EN_0200_001_AA.CATPart, EN_0200_004_AA.CATPart, EN_0200_006_AA.CATPart, EN_0200_007_AA.1.CATPart, EN_0200_007_AA.2.CATPart, EN_0200_007_AA.3.CATPart, EN_0200_007_AA.4.CATPart, EN_0200_007_AA.CATProduct]
2017-11-29 ajout chapes chainshield
    [EN_1100_002_AA.CATPart, EN_1100_005_AA.CATPart, EN_1100_006_AA.CATPart, EN_1100_007_AA.CATPart, EN_A1100.CATProduct, Powertrain.CATProduct]
2017-11-29 maj chape chainshield
    [Powertrain.CATProduct]
2017-11-29 Correction des conneries
    [Powertrain.CATProduct]
2017-11-29 Correction V2.0
    [EN_A1000.CATProduct, Frame_assy.CATProduct, Powertrain.CATProduct, Suspension Assy.CATProduct, Vulcanix.CATProduct, tubulaire_pilote_moteur_firewall.CATProduct]
2017-11-29 modif sans importance
    [Frame_assy.CATProduct, Powertrain.CATProduct, Suspension Assy.CATProduct, Vulcanix.CATProduct]
2017-11-29 Modification de la direction.
    [Cardan_1.CATPart, Cardan_2.CATPart, Cardan_3.CATPart, ISO_4014_M6x50_STEEL_GRADE_A_HEXAGON_HEAD_BOLT.CATPart, ISO_4032_M6_STEEL_GRADE_A_HEXAGON_NUT.CATPart, ISO_7089_6x12_STEEL_GRADE_A_NORMAL_SERIES_PLAIN_WASHER.CATPart, ST_0100_001.CATProduct, ST_0200_001_MM.CATPart]
2017-11-30 Mise à jour gueule de loup.
    [Produit1.CATProduct, Produit2.CATProduct, Produit3.CATProduct, Produit4.CATProduct, Produit5.CATProduct, Shape_527.CATPart, Shape_528.CATPart, Shape_529.CATPart]
2017-11-30 Assemblage direction dans chassis.
    [ST_0600_001.CATPart, ST_0600_002.CATPart, ST_A0200.CATProduct, ST_A0600.CATProduct, Steering System assy.CATProduct, vis_complete.CATProduct]
2017-11-30 Ajout de la suspension arrière sur le chassis.
    [Rear_suspension_on_frame.CATProduct]
2017-11-30 AJOUT SU_A1300_FRONT ARB ASSY + PARTS SU_13XX
    [SA_8_C.CATPart, SU_13001_ROCKER FRONT ARB.CATPart, SU_13002_PIVOT FRONT ARB.CATPart, SU_13004_FRONT ARB ROD.CATPart, SU_A13003_ARB SPACER SLEEVE.CATPart, SU_A1300_FRONT ARB ASSY.CATProduct]
2017-11-30 Correction des aneries des tabernak
    [Frame_assy.CATProduct, Powertrain.CATProduct, Produit2.CATProduct, Produit3.CATProduct, SU_13001_ROCKER FRONT ARB.CATPart, SU_13002_PIVOT FRONT ARB.CATPart, SU_A13003_ARB SPACER SLEEVE.CATPart, Shape_532.CATPart]
2017-11-30 AJOUT SU-A1300 DANS VULCANIX CAD
    [Front Left Suspension.CATProduct, SU_A1300_FRONT ARB ASSY.CATProduct, Suspension Assy.CATProduct, tubulaire.CATProduct]
2017-11-30 Maj chapes chainshield (contraintes dans Powertrain)
    [EN_1100_006_AA.CATPart, EN_1100_007_AA.CATPart, EN_A1100.CATProduct, Powertrain.CATProduct]
2017-11-30 MÀJ - SU-ASSY
    [SU_14001_FRONT ROCKER .CATPart, SU_A1300_FRONT ARB ASSY.CATProduct, wireframe_arms.CATPart]
2017-11-30 MÀJ SU-ASSY et Vulcanix CAD
    [Front Left Suspension.CATProduct, SU_14001_FRONT ROCKER .CATPart, Suspension Assy.CATProduct]
2017-11-30 remise en position du moteur
    [EN_A0900.CATProduct, EN_A1000.CATProduct, Powertrain.CATProduct]
2017-11-30 redim chapes chainshield
    [EN_1100_006_AA.CATPart, EN_1100_007_AA.CATPart, Powertrain.CATProduct]
2017-11-30 position échappement
    [EN_A0200.CATProduct, EN_A0900.CATProduct, EN_A1000.CATProduct, Powertrain.CATProduct]
2017-11-30 Modif pédalier (butée, maitres cylindres)
    [3871-482.CATPart, Assemblage branche cale.CATProduct, CP3823-114.CATPart, CP5511-140.CATPart, CP5854-104_fitted.CATPart, CP5854-4M_CP5854-125.CATPart, CP5854-5M_CP5854-136.CATPart, CP7855-107.CATPart]
2017-11-30 MÀJ - SU_ASSY
    [Front Left Suspension.CATProduct, SU_13XX_BELLCRANK GEOMETRY ONLY FOR DESIGN.CATPart, SU_14001_FRONT ROCKER .CATPart, SU_A1300_FRONT ARB ASSY.CATProduct, SU_A1400_FRONT SUSPENSION.CATProduct, Suspension Assy.CATProduct, piston.CATPart, wireframe_arms.CATPart]
2017-11-30 ajout triangle
    [SU_A0200.CATProduct]
2017-11-30 MÀJ _ SU_ASSY
    [SU_13XX_BELLCRANK GEOMETRY ONLY FOR DESIGN.CATPart, SU_14001_FRONT ROCKER .CATPart, SU_A1300_FRONT ARB ASSY.CATProduct, SU_A1400_FRONT SUSPENSION.CATProduct, Suspension Assy.CATProduct]
2017-11-30 ajout roue arrière
    [97135A275_GRADE 8 STEEL NYLON-INSERT LOCKNUT.CATPart, 97135A295_GRADE 8 STEEL NYLON-INSERT LOCKNUT.CATPart, Assemblage upright wireframe.CATProduct, BR 0100 001.CATPart, Brake caliper spacer.CATPart, D4483.CATPart, D4484.CATPart, Front Left Suspension.CATProduct]
2017-11-30 symétrie roue arrière
    [Suspension Assy.CATProduct, Symmetry of 4483 Polaris (20T).CATPart, Symmetry of 97135A275.CATPart, Symmetry of Brake Disc.CATPart, Symmetry of Brake caliper spacer.CATPart, Symmetry of Mg Rim.CATPart, Symmetry of Rear Hub.CATPart, Symmetry of Rear Left Upright.CATPart]
2017-11-30 MÃJ - SU_ASSY
    [SA_8_C.CATPart, SU_13001_ROCKER FRONT ARB.CATPart, SU_13002_PIVOT FRONT ARB.CATPart, SU_13004_FRONT ARB ROD.CATPart, SU_13XX_BELLCRANK GEOMETRY ONLY FOR DESIGN.CATPart, SU_14001_FRONT ROCKER .CATPart, SU_A13003_ARB SPACER SLEEVE.CATPart, SU_A1300_FRONT ARB ASSY.CATProduct]
2017-11-30 PROBLEME TECHNIQUE
    [SA_8_C.CATPart, SU_13001_ROCKER FRONT ARB.CATPart, SU_13002_PIVOT FRONT ARB.CATPart, SU_13004_FRONT ARB ROD.CATPart, SU_14001_FRONT ROCKER .CATPart, SU_A13003_ARB SPACER SLEEVE.CATPart, piston.CATPart]
2017-11-30 Ajout cage à aiguilles et butées à aiguilles sur pédalier
    [AXK_1024_PART1.CATPart, AXK_1024_PART2.CATPart, AXK_1024_PART3.CATPart, AXK_1024_PART4.CATPart, AXK_1024_PART5.CATPart, FR_0300_001_BA.CATPart, FR_0300_010_BA.CATPart, FR_0300_020_BA.CATProduct]
2017-11-30 MAJ _ ARB ASSY
    [Front Left Suspension.CATProduct, Rear Left Wheel.CATProduct, SA_8_C.CATPart, SU_13001_ROCKER FRONT ARB.CATPart, SU_13004_FRONT ARB ROD.CATPart, SU_13005_FRONT ARB.CATPart, SU_13006_FRONT ARB FORK.CATPart, SU_13XX_BELLCRANK GEOMETRY ONLY FOR DESIGN.CATPart]
2017-11-30 MAJ _ SU ASSY
    [Front Left Suspension.CATProduct, Rear Left Wheel.CATProduct, SU_13001_ROCKER FRONT ARB.CATPart, SU_13006_FRONT ARB FORK.CATPart, SU_13007_FRONT ARB FORK_AB.CATPart, SU_13XX_BELLCRANK GEOMETRY ONLY FOR DESIGN.CATPart, SU_A1400_FRONT SUSPENSION.CATProduct, Suspension Assy.CATProduct]
2017-11-30 Modifications de l'admission et intégration sur maquette
    [EN_A0300.CATProduct, Powertrain.CATProduct]
2017-12-01 petite modif
    [EN_A0200.CATProduct, Frame_assy.CATProduct, Powertrain.CATProduct, Vulcanix.CATProduct]
2017-12-01 correction erreur de lien dans air intake
    [EN_0300_003_AA.CATPart, EN_A0300.CATProduct, Powertrain.CATProduct]
2017-12-01 creation assemblage suspension arrière
    [Rear Left Shock Absorber Assy.CATProduct]
2017-12-01 MAJ - ANTI ROLL BAR 2.0
    [GE_6_C.CATProduct, GE_6_Cblr_001_101_spb_ge1.CATPart, GE_6_Cblr_001_101_spb_ge2.CATPart, GE_8_C.CATProduct, GE_8_Cblr_001_101_spb_ge1.CATPart, GE_8_Cblr_001_101_spb_ge2.CATPart, SAKB_6_F.CATPart, SAKB_8_F.CATPart]
2017-12-01 Insertion vis épaulée sur pédalier
    [AXK_1024_PART1.CATPart, AXK_1024_PART2.CATPart, AXK_1024_PART3.CATPart, AXK_1024_PART4.CATPart, AXK_1024_PART5.CATPart, Cylindre repartiteur.CATPart, FR_0300_002_BA.CATPart, FR_0300_015_BA.CATPart]
2017-12-01 Changement position pédalier sur maquette Frame and Body
    [FR_A0300.CATProduct, Frame_assy.CATProduct]
2017-12-01 MAJ SUSPENSION
    [SU_13001_ROCKER FRONT ARB.CATPart, SU_13006_FRONT ARB FORK.CATPart, SU_13008_FORK ROD FRONT ARB ASSY.CATProduct, SU_A1400_FRONT SUSPENSION.CATProduct]
2017-12-01 Ajout chape support de gaine
    [FR_0300_024_BA.CATPart, FR_A0300.CATProduct]
2017-12-01 Suppression chape support gaine pédalier
    [FR_A0300.CATProduct]
2017-12-01 MAJ ARB ASSY
    [SU_13001_ROCKER FRONT ARB.CATPart]
2017-12-01 MAJ SU ASSY
    [Front Left Suspension.CATProduct, Rear Left Wheel.CATProduct, SU_13002_PIVOT FRONT ARB.CATPart, SU_13007_ROCKER INT. FRONT ARB.CATPart, SU_13008_FORK ROD FRONT ARB ASSY.CATProduct, SU_A1400_FRONT SUSPENSION.CATProduct, Suspension Assy.CATProduct]
2017-12-01 Ajout suspension arrière dans l'assemblage de la LAS.
    [Front Left Shock Absorber.CATProduct, Front Left Suspension.CATProduct, Ohlins_variable.CATProduct, Rear Left Wheel.CATProduct, Rear_suspension_on_frame.CATProduct, SU_A1400_FRONT SUSPENSION.CATProduct, Suspension Assy.CATProduct, piston.CATPart]
2017-12-01 MAJ pédalier
    [Axe rotules superieure MC.CATPart, Cylindre repartiteur.CATPart, FR_0300_006_BA.CATPart, FR_0300_013_BA.CATPart, FR_0300_021_BA.CATPart, FR_A0300.CATProduct, Tige support cable.CATPart]
2017-12-01 Suspension arrière dans l'assemblage final.
    [Front Left Suspension.CATProduct, Part181.CATPart, Produit25.CATProduct, Rear Left Wheel.CATProduct, SU_A0700_modifiable.CATProduct, SU_A1400_FRONT SUSPENSION.CATProduct, Suspension Assy.CATProduct, Symmetry of Bague_6mm.CATPart]
2017-12-01 Placement volant.
    [ST_0300_002.CATPart, ST_A0200.CATProduct, ST_A0300.CATProduct, ST_A0600.CATProduct, Steering System assy.CATProduct]
2017-12-01 Déplacement du volant.
    [ISO_7089_6x12_STEEL_GRADE_A_NORMAL_SERIES_PLAIN_WASHER.CATPart, ST_0300_002.CATPart, ST_A0200.CATProduct, ST_A0300.CATProduct, ST_A0600.CATProduct, Steering System assy.CATProduct]
2017-12-01 Modification nom direction.
    [ST_0100_001.CATProduct, ST_0400_AA.CATProduct, ST_A0200.CATProduct, ST_A0300.CATProduct, ST_A0600.CATProduct, Steering System assy.CATProduct]
2017-12-01 Ajout des matériaux.
    [Cardan_1.CATPart, Cardan_2.CATPart, Cardan_3.CATPart, ST_0100_001.CATProduct, ST_0200_001_MM.CATPart, ST_0300_002.CATPart, ST_0400_AA.CATProduct, ST_A0200.CATProduct]
2017-12-02 Gueles de loup.
    [Produit1.CATProduct, Produit2.CATProduct, Produit3.CATProduct, Produit4.CATProduct, Produit5.CATProduct, Shape_531.CATPart, Shape_532.CATPart, Shape_533.CATPart]
2017-12-02 MISE A JOUR IMPORTANTE CELLULE AVANT
    [FRAME.CATPart, Produit1.CATProduct, Produit2.CATProduct, Produit3.CATProduct, Produit4.CATProduct, Produit5.CATProduct, Shape_531.CATPart, Shape_532.CATPart]
2017-12-02 MAJ FRONT ARB ASSY (ASSY FONCTIONNEL !)
    [FRONT ROCKER ARB ASSY.CATProduct, SU_13006_FRONT ARB FORK.CATPart, SU_13008_FORK ROD FRONT ARB ASSY.CATProduct, SU_13XX_BELLCRANK GEOMETRY ONLY FOR DESIGN.CATPart, SU_A1400_FRONT SUSPENSION.CATProduct, Shape_547.CATPart, Suspension Assy.CATProduct]
2017-12-02 Modif direction.
    [ST_0100_001.CATProduct, ST_0200_003.CATPart, ST_A0200.CATProduct, ST_A0600.CATProduct, Steering System assy.CATProduct]
2017-12-02 Mise à jour firewall
    [Firewall.CATPart, tubulaire_firewall.CATProduct]
2017-12-02 MAJ - SUSPENSION
    [FRONT ARB ROD ASSY.CATProduct, FRONT ROCKER ARB ASSY.CATProduct, SAKB_8_F.CATPart, SU_13001_ROCKER FRONT ARB.CATPart, SU_13005_FRONT ARB.CATPart, SU_13006_FRONT ARB FORK.CATPart, SU_13007_ROCKER INT. FRONT ARB.CATPart, SU_13009_ARB END PLATE.CATPart]
2017-12-02 maj contraintes Driveshaft assy et powertrain
    [EN_A1000.CATProduct, Powertrain.CATProduct]
2017-12-02 MAJ _ ASSY SUSPENSION
    [FRONT ARB ROD ASSY.CATProduct, FRONT ROCKER ARB ASSY.CATProduct, SU_13004_FRONT ARB ROD.CATPart, SU_13007_ROCKER INT. FRONT ARB.CATPart, SU_A1400_FRONT SUSPENSION.CATProduct]
2017-12-02 reorganisation contraintes powertrain dans l'arbre
    [Powertrain.CATProduct]
2017-12-02 ajout ressort
    [ressort.CATPart, tableRessort.xls]
2017-12-02 Mise à jour chassis
    [FRAME.CATPart, Produit1.CATProduct, Produit2.CATProduct, Produit3.CATProduct, Produit4.CATProduct, Shape_531.CATPart, Shape_532.CATPart, Shape_533.CATPart]
2017-12-02 PUSH PUSH
    [FRONT ROCKER ARB ASSY.CATProduct, SU_13002_PIVOT FRONT ARB.CATPart, SU_13008_FORK ROD FRONT ARB ASSY.CATProduct, SU_A1400_FRONT SUSPENSION.CATProduct]
2017-12-02 correction erreur
    [EN_0200_031_AA.CATProduct, EN_0200_032_AA.CATProduct, EN_0200_033_AA.CATProduct, EN_0200_051_AA.CATProduct, EN_0200_052_AA.CATProduct, EN_A0200.CATProduct, EN_A0300.CATProduct, EN_A0900.CATProduct]
2017-12-02 MMMH ca bug
    [FRONT ROCKER ARB ASSY.CATProduct, SU_13002_PIVOT FRONT ARB.CATPart]
2017-12-02 Je suis pô à l'aise la
    [FRONT ROCKER ARB ASSY.CATProduct, SU_A1400_FRONT SUSPENSION.CATProduct, Suspension Assy.CATProduct]
2017-12-02 Cellule arriere
    [FRAME.CATPart, Produit2.CATProduct, Produit3.CATProduct, Produit5.CATProduct, Shape_540.CATPart, Shape_541.CATPart, Shape_563.CATPart, Shape_564.CATPart]
2017-12-02 CATIA PLANTE :'(
    [FRONT ROCKER ARB ASSY.CATProduct, SU_13006_FRONT ARB FORK.CATPart, SU_A1400_FRONT SUSPENSION.CATProduct]
2017-12-02 New direction.
    [Cardan_1.CATPart, Cardan_2.CATPart, Cardan_3.CATPart, ISO_4014_M6x50_STEEL_GRADE_A_HEXAGON_HEAD_BOLT.CATPart, ISO_4032_M6_STEEL_GRADE_A_HEXAGON_NUT.CATPart, ISO_7089_6x12_STEEL_GRADE_A_NORMAL_SERIES_PLAIN_WASHER.CATPart, ST_0100_001.CATProduct, ST_0200_001_MM.CATPart]
2017-12-02 CA PUSH. Lahm
    [FRONT ROCKER ARB ASSY.CATProduct, SU_13002_PIVOT FRONT ARB.CATPart, SU_13004_FRONT ARB ROD.CATPart, SU_13006_FRONT ARB FORK.CATPart, SU_13008_FORK ROD FRONT ARB ASSY.CATProduct, SU_A1400_FRONT SUSPENSION.CATProduct]
2017-12-02 Dans le doute je push
    [FRONT ARB ROD ASSY.CATProduct, SU_13004_FRONT ARB ROD.CATPart, SU_13009_ARB END PLATE.CATPart, SU_A1400_FRONT SUSPENSION.CATProduct]
2017-12-02 Mange toi ça Adrien.
    [ST_0100_001.CATProduct, ST_A0200.CATProduct, ST_A0300.CATProduct, ST_A0600.CATProduct, Steering System assy.CATProduct, vis_complete.CATProduct]
2017-12-02 Dans le doute, je commit
    [FRONT ARB ROD ASSY.CATProduct, Front Left Suspension.CATProduct, Rear Left Wheel.CATProduct, SU_13001_ROCKER FRONT ARB.CATPart, SU_13005_FRONT ARB.CATPart, SU_13009_ARB END PLATE.CATPart, SU_A1400_FRONT SUSPENSION.CATProduct, Suspension Assy.CATProduct]
2017-12-02 WARNING PUSH
    [EN_A0200.CATProduct, EN_A0300.CATProduct, EN_A0900.CATProduct, EN_A1000.CATProduct, FRONT ARB ROD ASSY.CATProduct, FRONT ROCKER ARB ASSY.CATProduct, Frame_assy.CATProduct, Front Left Suspension.CATProduct]
2017-12-02 On est pas la pour enfiler des perles ( PS : MAJ SU ASSY )
    [Front Left Suspension.CATProduct, Rear Left Wheel.CATProduct, SU_13XX_BELLCRANK GEOMETRY ONLY FOR DESIGN.CATPart, SU_A1400_FRONT SUSPENSION.CATProduct, Suspension Assy.CATProduct, TEMPLATE .CATPart]
2017-12-02 ON EST PAS LA POUR ENFILER DES PERLES.
    [ST_0200_003.CATPart, ST_A0200.CATProduct, ST_A0600.CATProduct, Steering System assy.CATProduct]
2017-12-02 test v1.5
    [tableRessort.xls]
2017-12-02 MAJ SU - SU
    [Suspension Assy.CATProduct]
2017-12-02 correction bug
    [Frame_assy.CATProduct, ISO_4014_M8x45_STEEL_GRADE_A_HEXAGON_HEAD_BOLT.CATPart, ISO_7089_8x16_STEEL_GRADE_A_NORMAL_SERIES_PLAIN_WASHER.CATPart, ISO_7089_8x16_STEEL_GRADE_A_NORMAL_SERIES_PLAIN_WASHER_New_135.CATPart, Powertrain.CATProduct, SU_A1400_FRONT SUSPENSION.CATProduct, Suspension Assy.CATProduct, Vulcanix.CATProduct]
2017-12-02 Retour du bon chassis !
    [FRAME.CATPart, Produit1.CATProduct, Produit2.CATProduct, Produit3.CATProduct, Produit4.CATProduct, Produit5.CATProduct, Shape_531.CATPart, Shape_532.CATPart]
2017-12-03 J'apprends github
    [FRAME.CATPart]
2017-12-03 Mise à jour des contraintes
    [EN_0200_031_AA.CATProduct, EN_0200_032_AA.CATProduct, EN_0200_033_AA.CATProduct, EN_0200_051_AA.CATProduct, EN_0200_052_AA.CATProduct, EN_A0200.CATProduct, EN_A0300.CATProduct, EN_A0900.CATProduct]
2017-12-03 Changement de fixation transmi sec sur tubulaire --> impact sur PE, chapes, Chainshield
    [EN_0900_006_AB.CATPart, EN_0900_007_AA.CATPart, EN_1100_005_AA.CATPart, EN_1100_006_AA.CATPart, EN_A0200.CATProduct, EN_A0300.CATProduct, EN_A0900.CATProduct, EN_A1000.CATProduct]
2017-12-03 MAJ chapes powertrain
    [EN_1100_006_AA.CATPart, EN_A0200.CATProduct, EN_A0300.CATProduct, EN_A0900.CATProduct, EN_A1000.CATProduct, Powertrain.CATProduct]
2017-12-03 des ptites chapes, des ptites chapes, toujours des ptites chapes
    [EN_1100_006_AA.CATPart, EN_1100_007_AA.CATPart, Powertrain.CATProduct]
2017-12-03 lé chap c rigolo (add chapes excentriccarrier-tubulaire)
    [EN_0900_008_AA.CATPart, EN_0900_009_AA.CATPart, EN_A0200.CATProduct, EN_A0300.CATProduct, EN_A0900.CATProduct, EN_A1000.CATProduct, Powertrain.CATProduct]
2017-12-03 maj portes excentriques anecdotique
    [EN_0900_006_AB.CATPart, EN_0900_007_AA.CATPart]
2017-12-03 Modifications longueurs tubulures admission
    [EN_0300_003_AA.CATPart, EN_0300_003_BA.CATPart, EN_A0300.CATProduct]
2017-12-03 Ajout visserie pédalier
    [210203-6x16.CATPart, 210203-6x40.CATPart, FR_0300_000_BA.CATPart, FR_0300_011_BA.CATPart, FR_0300_018_BA.CATPart, FR_A0300.CATProduct, IS0_10511_M6_STEEL_PREVAILING_TORQUE_TYPE_HEXAGON_THIN_NUT.CATPart, IS0_10511_M8_STEEL_PREVAILING_TORQUE_TYPE_HEXAGON_THIN_NUT.CATPart]
2017-12-03 Ajustements fixation admission
    [EN_0300_003_BA.CATPart, EN_A0300.CATProduct, EN_A0600.CATProduct, Powertrain.CATProduct]
2017-12-03 Test Git.
    [SU_A0700_modifiable.CATProduct, SU_A0800.CATProduct]
2017-12-03 Ajout des chapes sur pédalier
    [Assemblage tubes chassis et pedalier.CATProduct, FR_0300_024_BA.CATPart, FR_0300_025_BA.CATPart, FR_A0300.CATProduct, Tubes chassis.CATPart]
2017-12-03 Placement direction - correction erreur de Git.
    [ST_0100_001.CATProduct, ST_0200_003.CATPart, ST_A0200.CATProduct, ST_A0300.CATProduct, ST_A0600.CATProduct, Steering System assy.CATProduct, Suspension Assy.CATProduct, vis_complete.CATProduct]
2017-12-03 Changement position pédaler par rapport au chassis suite à l'insertion des chapes
    [FR_A0300.CATProduct, Frame_assy.CATProduct]
2017-12-03 Forçage 2000
    [FR_A0300.CATProduct]
2017-12-03 Modif cale bout de pied
    [FR_0300_001_BA.CATPart, FR_0300_002_BA.CATPart, FR_0300_003_BA.CATPart, FR_A0300.CATProduct, IS0_10511_M8_STEEL_PREVAILING_TORQUE_TYPE_HEXAGON_THIN_NUT.CATPart]
2017-12-03 Ajout du Modele du CrashSensor (EL_0100_002_AA)
    [EL_0100_002.CATPart]
2017-12-03 Placement suspensions arrières.
    [Front Left Suspension.CATProduct, Part181.CATPart, Produit25.CATProduct, Rear Left Wheel.CATProduct, SU_0800_003.CATPart, SU_A0800.CATProduct, SU_A1400_FRONT SUSPENSION.CATProduct, Suspension Assy.CATProduct]
2017-12-03 Modif Wireframe
    [wireframe_arms.CATPart]
2017-12-03 Optimisation basculeur avant.
    [SU_14001_FRONT ROCKER .CATPart]
2017-12-03 Essai de résolution problème visserie
    [Assemblage branche cale.CATProduct, FR_0300_001_BA.CATPart, FR_0300_003_BA.CATPart]
2017-12-03 I'm back baby !
    [628_8_2RS1.CATProduct, 628_8_2RS1_PART1.CATPart, 628_8_2RS1_PART2.CATPart, 628_8_2RS1_PART3.CATPart, EXTERNAL CIRCLIP M8.CATPart, FRONT ARB ROD ASSY.CATProduct, FRONT ROCKER ARB ASSY.CATProduct, GE_6_C.CATProduct]
2017-12-03 FEEL THE FORCE AND PUSH !
    [SU_13001_ROCKER FRONT ARB.CATPart, SU_13005_FRONT ARB.CATPart]
2017-12-03 _____ _ _ _____ _ _ | _ \ | | | | / ___/ | | | | | |_| | | | | | | |___ | |_| | | ___/ | | | | \___ \ | _ | | | | |_| | ___| | | | | | |_| \_____/ /_____/ |_| |_|
    [FRONT ARB ROD ASSY.CATProduct, FRONT ROCKER ARB ASSY.CATProduct, Rear Left Wheel.CATProduct, SU_13005_FRONT ARB.CATPart, SU_13009_ARB END PLATE.CATPart, SU_A1400_FRONT SUSPENSION.CATProduct]
2017-12-03 BARRE ANTI ROULIS 3.0
    [FRONT ARB ROD ASSY.CATProduct, FRONT ROCKER ARB ASSY.CATProduct, Rear Left Wheel.CATProduct, SU_13001_ROCKER FRONT ARB.CATPart, SU_13004_FRONT ARB ROD.CATPart, SU_13005_FRONT ARB.CATPart, SU_13009_ARB END PLATE.CATPart, SU_13XX_BELLCRANK GEOMETRY ONLY FOR DESIGN.CATPart]
2017-12-03 Modifs branche pédale de frein
    [FR_0300_001_BA.CATPart, FR_0300_006_BA.CATPart, FR_0300_010_BA.CATPart, FR_A0300.CATProduct]
2017-12-03 TOUZÉ REGARDE Suspension Assy ! Je te call live !
    [SU_A1400_FRONT SUSPENSION.CATProduct]
2017-12-03 Ajout fond plat
    [FR_0400_001_BA.CATPart, FR_0400_002_BA.CATPart]
2017-12-03 Ajout fond plat sur l'assemblage Frame
    [FR_A0300.CATProduct, Frame_assy.CATProduct]
2017-12-03 Remise à jour liens fond plat.
    [Frame_assy.CATProduct]
2017-12-03 ARB 4.0
    [EN_A0200.CATProduct, EN_A0300.CATProduct, EN_A0900.CATProduct, EN_A1000.CATProduct, EN_A1100.CATProduct, Frame_assy.CATProduct, ISO_4014_M6x40_STEEL_GRADE_A_HEXAGON_HEAD_BOLT.CATPart, ISO_4014_M8x40_STEEL_GRADE_A_HEXAGON_HEAD_BOLT.CATPart]
2017-12-03 Modife symétrie suspension, bon thé Christophe !
    [BR 0100 001.CATPart, FRONT ARB ROD ASSY.CATProduct, Front Left Suspension.CATProduct, Rear Left Wheel.CATProduct, SU 0100 001.CATPart, SU_13005_FRONT ARB.CATPart, SU_13008_FORK ROD FRONT ARB ASSY.CATProduct, SU_A1400_FRONT SUSPENSION copie de sécurité.CATProduct]
2017-12-03 Le thé était bon
    [FRONT ARB ROD ASSY.CATProduct, FRONT ROCKER ARB ASSY.CATProduct, SU_13001_ROCKER FRONT ARB.CATPart, SU_13004_FRONT ARB ROD.CATPart, SU_13007_ROCKER INT. FRONT ARB.CATPart, SU_13010_FRONT ARB ROCKER INT PIN.CATPart, SU_A1400_FRONT SUSPENSION.CATProduct]
2017-12-03 A cette heure avancée de la soirée une tisane aurait été plus sage.
    [Chappe_suspension_avant.CATProduct, Tube_20.CATPart, Tube_attache.CATPart, chapeamortisseurarrierevCCN.CATPart]
2017-12-03 JE T'AI BATTU BENJAMIN.
    [Chappe_suspension_avant.CATProduct, Tube_pour_le_principe.CATPart]
2017-12-03 Matte la chappe de suspension avant Christophe !
    [Chappe_suspension_avant.CATProduct, FRONT ROCKER ARB ASSY.CATProduct, Front Left Suspension.CATProduct, Rear Left Wheel.CATProduct, SU_A1400_FRONT SUSPENSION.CATProduct, Suspension Assy.CATProduct, Symmetry of 628_8-2RS1-628_8-2RS1.CATProduct, Symmetry of 628_8-2RS1_PART1-628_8-2RS1_PART1.CATPart]
2017-12-03 Ohh fuck le merge
    [SU_13007_ROCKER INT. FRONT ARB.CATPart, SU_13009_ARB END PLATE.CATPart]
2017-12-03 Je vais me coucher bonne nuit !
    [SU_A1400_FRONT SUSPENSION.CATProduct, Suspension Assy.CATProduct]
2017-12-03 ajout triangle inférieur avant
    [FR_A0300.CATProduct, Frame_assy.CATProduct, Insert Triangle cote chassis v1.1.CATPart, SU_A0200.CATProduct, Vulcanix.CATProduct, ins_av_g_sup_3D.CATPart, ins_av_g_sup_usi.CATPart, triangle inferieur avant 1.CATPart]
2017-12-03 ajout triangle arrière
    [Insert Triangle cote chassis v1.1.CATPart, SU_A0200.CATProduct, SU_A0400.CATProduct, ins_av_g_sup_usi.CATPart, insert arriere gauche inferieur.CATPart, insert avant gauche inferieur.CATPart, triangle inferieur arriere 1.CATPart, triangle inferieur arriere 2.CATPart]
2017-12-03 mise en place des triangles sur suspension assy
    [Chappe_suspension_avant.CATProduct, FRONT ARB ROD ASSY.CATProduct, FRONT ROCKER ARB ASSY.CATProduct, Front Left Suspension.CATProduct, Insert Triangle cote chassis v1.1.CATPart, Part226.CATPart, Part228.CATPart, Part229.CATPart]
2017-12-03 modification porte moyeux, ajout des dernière version.
    [7207_BE_2RZP.CATProduct, 7207_BE_2RZP_PART1.CATPart, 7207_BE_2RZP_PART2.CATPart, 7207_BE_2RZP_PART3.CATPart, 97135A275_GRADE 8 STEEL NYLON-INSERT LOCKNUT.CATPart, Assemblage upright wireframe.CATProduct, BR 0100 001.CATPart, BR A0100.CATProduct]
2017-12-03 J'en ai marre, je vais dormir
    [Chappe_suspension_avant.CATProduct, Front Left Wheel.CATProduct, Rear Left Wheel.CATProduct, Suspension Assy.CATProduct, Symmetry of 7207 BE-2RZP-7207 BE-2RZP.CATProduct, Symmetry of 7207 BE-2RZP_PART1-7207 BE-2RZP_PART1.CATPart, Symmetry of 7207 BE-2RZP_PART2-7207 BE-2RZP_PART2.CATPart, Symmetry of 7207 BE-2RZP_PART3-7207 BE-2RZP_PART3.CATPart]
2017-12-04 GUILLAUME JE SUIS DE RETOUR DE BON MATIN
    [FR_0700_000_CA.CATPart, FR_0700_001_CA.CATPart, FR_0700_003_BA.CATPart]
2017-12-04 Boom ! La carrosserie possède maintenant un critère d'émotion de 2/10 !
    [FR_0700_000_CA.CATPart, FR_0700_001_CA.CATPart, FR_0700_002_BA.CATPart]
2017-12-04 Re-problème fond plat
    [FR_A0300.CATProduct, Frame_assy.CATProduct]
2017-12-04 Trous pour chapes fond plat
    [FR_0400_001_BA.CATPart, FR_0400_002_BA.CATPart]
2017-12-04 MAJ SUSPENSION - BONJOUR
    [7203_BE_2RZP.CATProduct, 7203_BE_2RZP_PART1.CATPart, 7203_BE_2RZP_PART2.CATPart, 7203_BE_2RZP_PART3.CATPart, Chappe_suspension_avant.CATProduct, FRONT ROCKER ARB ASSY.CATProduct, Front Left Wheel.CATProduct, HK_2030.CATProduct]
2017-12-04 Petite modif.
    [SU_0700_002.CATPart, SU_0700_003.CATPart, SU_A0700_modifiable.CATProduct]
2017-12-04 AJOUT SUS
    [AXK_2035___AS_2035.CATProduct, AXK_2035___AS_2035_PART1.CATPart, AXK_2035___AS_2035_PART2.CATPart, AXK_2035___AS_2035_PART3.CATPart, AXK_2035___AS_2035_PART4.CATPart, AXK_2035___AS_2035_PART5.CATPart, FRONT ROCKER ARB ASSY.CATProduct, HK_2030.CATProduct]
2017-12-04 Modifes pour avoir la bonne nomenclature.
    [Chappe_suspension_avant.CATProduct, ISO_4014_M8x45_STEEL_GRADE_A_HEXAGON_HEAD_BOLT.CATPart, ISO_4032_M8_STEEL_GRADE_A_HEXAGON_NUT.CATPart, ISO_7089_8x16_STEEL_GRADE_A_NORMAL_SERIES_PLAIN_WASHER.CATPart, SU_0510_001.CATPart, SU_0510_002.CATPart, SU_0510_003.CATPart, SU_0510_004.CATPart]
2017-12-04 Ajout vis.
    [ISO_4014_M8x45_STEEL_GRADE_A_HEXAGON_HEAD_BOLT.CATPart, ISO_4032_M8_STEEL_GRADE_A_HEXAGON_NUT.CATPart, ISO_7089_8x16_STEEL_GRADE_A_NORMAL_SERIES_PLAIN_WASHER.CATPart, SU_0510_001.CATPart, SU_0510_002.CATPart, SU_0510_003.CATPart, SU_0510_004.CATPart, SU_A510.CATProduct]
2017-12-04 mamamia le merge
    [FRONT ARB ROD ASSY.CATProduct, FRONT ROCKER ARB ASSY.CATProduct, SU_13001_ROCKER FRONT ARB.CATPart, SU_13004_FRONT ARB ROD.CATPart, SU_13005_FRONT ARB.CATPart, SU_13007_ROCKER INT. FRONT ARB.CATPart, SU_13015_SLEEVE M8.CATPart, SU_13XX_BELLCRANK GEOMETRY ONLY FOR DESIGN.CATPart]
2017-12-04 Modife nomenclature, fini de faire du sale.
    [SU_05002_AA_Front_Rocker.CATPart, SU_05003_Square Tube 25mm .CATPart, SU_0500_001.CATProduct, SU_0500_002.CATPart, SU_0700_003.CATPart, SU_A0500.CATProduct, SU_A0500_Shock Front.CATProduct, Symmetry of TTX20 - Base Assembly - 200 - Extended.CATPart]
2017-12-04 Ajout d'un basculeur avant propre.
    [ISO_4014_M8x45_STEEL_GRADE_A_HEXAGON_HEAD_BOLT.CATPart, ISO_4032_M8_STEEL_GRADE_A_HEXAGON_NUT.CATPart, ISO_7089_8x16_STEEL_GRADE_A_NORMAL_SERIES_PLAIN_WASHER.CATPart, ISO_7089_8x16_STEEL_GRADE_A_NORMAL_SERIES_PLAIN_WASHER_New_135.CATPart, SU_0600_001.CATPart, SU_0600_002.CATPart, SU_0600_003.CATPart, SU_A0600.CATProduct]
2017-12-04 MAJ attache moteur
    [FRAME.CATPart, Produit5.CATProduct, Shape_600.CATPart, Shape_601.CATPart, Shape_602.CATPart, Shape_603.CATPart, Shape_604.CATPart, Shape_605.CATPart]
2017-12-04 modification roue
    [Front Left Wheel.CATProduct, WT 0200 001.CATPart, WT 0200 004.CATPart, wireframe_arms.CATPart]
2017-12-04 ARB 5.0 Mamam
    [FRONT ROCKER ARB ASSY.CATProduct, SU_13XX_BELLCRANK GEOMETRY ONLY FOR DESIGN.CATPart, SU_14001_FRONT ROCKER .CATPart, SU_A1400_FRONT SUSPENSION.CATProduct]
2017-12-04 Mise `a jour Suspension Assy
    [FRONT ROCKER ARB ASSY.CATProduct, Front Left Wheel.CATProduct, Rear Left Wheel.CATProduct, Suspension Assy.CATProduct]
2017-12-04 Modif PM arrière pour encombrement
    [Rear Left Upright.CATPart]
2017-12-04 couture chape pour EF Antonio
    [EN_0900_008_AA.CATPart]
2017-12-04 Màj poisition pilote
    [Frame_assy.CATProduct, Front Left Wheel.CATProduct, Powertrain.CATProduct, Rear Left Wheel.CATProduct, Steering System assy.CATProduct, Suspension Assy.CATProduct, Vulcanix.CATProduct, tubulaire_pilote_moteur_firewall.CATProduct]
2017-12-04 Nettoyage SU Assy
    [628_8_2RS1.CATProduct, 628_8_2RS1_PART1.CATPart, 628_8_2RS1_PART2.CATPart, 628_8_2RS1_PART3.CATPart, EXTERNAL CIRCLIP M8.CATPart, NKX_15_Z.CATProduct, NKX_15_Z_PART1.CATPart, NKX_15_Z_PART2.CATPart]
2017-12-04 modification triangle
    [GE_8_C.CATProduct, GE_8_Cblr_001_101_spb_ge1.CATPart, GE_8_Cblr_001_101_spb_ge2.CATPart, Insert Triangle cote chassis v1.1.CATPart, SU_A0200.CATProduct, SU_A0300 Upper Rear Left A-arms.CATProduct, SU_A0400.CATProduct, ins_ar_g_inf_usi.CATPart]
2017-12-04 modif triangle et ajout rotule et embout
    [SA_8_E.CATPart, SI_8_E.CATPart]
2017-12-04 Modif disque capteur vitesse
    [disque_capteur_arriere.CATPart]
2017-12-04 Re coucou
    [WT 0200 001.CATPart]
2017-12-04 Ajout suspension sur wireframe.
    [wireframe_arms.CATPart]
2017-12-04 Dans le doute je push.
    [wireframe_arms.CATPart]
2017-12-04 Modif du nom des points.
    [wireframe_arms.CATPart]
2017-12-04 Rectification chassis
    [FRAME.CATPart, Produit2.CATProduct, Produit3.CATProduct, Produit5.CATProduct, Shape_540.CATPart, Shape_541.CATPart, Shape_563.CATPart, Shape_564.CATPart]
2017-12-04 Lourde modification wireframe suspension.
    [wireframe_arms.CATPart]
2017-12-04 Ajustement attache suspensions
    [FRAME.CATPart, Produit3.CATProduct, Shape_635.CATPart, Shape_636.CATPart, Shape_637.CATPart, Shape_638.CATPart, Shape_639.CATPart, Shape_640.CATPart]
2017-12-04 Chape support gaine sur pédalier
    [FR_0300_006_BA.CATPart, FR_0300_009_BA.CATPart, FR_0300_010_BA.CATPart, FR_0300_024_BA.CATPart, FR_0300_025_BA.CATPart, FR_0300_026_BA.CATPart, FR_A0300.CATProduct, ISO_4014_M6x40_STEEL_GRADE_A_HEXAGON_HEAD_BOLT.CATPart]
2017-12-04 Changement dans frame_assy
    [Assemblage branche cale.CATProduct, Axe rotules superieure MC.CATPart, FR_0300_001_BA.CATPart, FR_0300_003_BA.CATPart, FR_0300_006_BA.CATPart, FR_0300_009_BA.CATPart, FR_0300_024_BA.CATPart, FR_0300_025_BA.CATPart]
2017-12-04 Modif chape support gaine
    [FR_0300_026_BA.CATPart]
2017-12-04 Modif chape
    [FR_0300_026_BA.CATPart]
2017-12-04 Grosse modification suspension Assy.
    [Front Left Wheel.CATProduct, GE_8_C.CATProduct, GE_8_Cblr_001_101_spb_ge1.CATPart, GE_8_Cblr_001_101_spb_ge2.CATPart, Part228.CATPart, Part229.CATPart, Part231.CATPart, Part232.CATPart]
2017-12-04 Modification SU assy.
    [Steering System assy.CATProduct, Suspension Assy.CATProduct, TEMPLATE .CATPart, wireframe_arms.CATPart]
2017-12-04 Nettoyage SU assy.
    [Part181.CATPart, Part226.CATPart, Part228.CATPart, Part229.CATPart, Part231.CATPart, Part232.CATPart, Part258.CATPart, Part264.CATPart]
2017-12-04 Ajout chappe de suspension avant.
    [SU_A510.CATProduct, Suspension Assy.CATProduct]
2017-12-04 ajout d'un point sur drexler tripod housing
    [EN_1000_004_AA.CATPart]
2017-12-05 ajout piece pour test en traction
    [GE_8_C.CATProduct, GE_8_Cblr_001_101_spb_ge1.CATPart, GE_8_Cblr_001_101_spb_ge2.CATPart, Insert Triangle test traction cone.CATPart, Insert Triangle test traction simple.CATPart, Insert Triangle test traction simple.igs, Insert Triangle test traction trou.CATPart, entretoise.CATPart]
2017-12-05 retrait de symétrie
    [Produit25.CATProduct, Produit36.CATProduct, Produit38.CATProduct]
2017-12-05 ajout biellette de pince et direction
    [wireframe_arms.CATPart]
2017-12-05 ménage dans uspension Assy
    [Rear Left Upright.CATPart, S71910_CD_P4A_PART3.CATPart, SU_A0700_modifiable.CATProduct, SU_A0800.CATProduct, SU_A1200_REAR_ARB_ASSY.CATProduct, SU_A510.CATProduct, Suspension Assy.CATProduct, WT 0100 005.CATPart]
2017-12-05 ajout plan triangle + divers
    [SA_8_E.CATPart, SU_1400_001.CATPart, SU_1400_002.CATPart, SU_A1400.CATProduct, ecrou M8 iso 4035.catpart, wireframe_arms.CATPart]
2017-12-05 pushrod avant
    [SU_1400_001.CATPart, SU_1400_002.CATPart, SU_A1400.CATProduct, wireframe_arms.CATPart]
2017-12-05 ajout point milieu tripod Drexler
    [EN_1000_004_AA.CATPart]
2017-12-05 ajout points sur Tripod Polaris (LAS) et MAJ sur Tripod Drexler
    [D4483.CATPart, EN_1000_004_AA.CATPart]
2017-12-05 triangle supérieur avant
    [SU_A0100.CATProduct, ins_avant_gauche_double.CATPart, tube avant triangle sup 2.CATPart, tube avant triangle sup.CATPart, wireframe_arms.CATPart]
2017-12-05 Modification direction + fillaire
    [ST_A0200.CATProduct, ST_A0600.CATProduct, Steering System assy.CATProduct]
2017-12-05 Direction Wireframe
    [wireframe_arms.CATPart]
2017-12-05 Màj volant et pilote.
    [ISO_7089_6x12_STEEL_GRADE_A_NORMAL_SERIES_PLAIN_WASHER.CATPart, Miscellanous, Finish & Assembly.CATProduct, Powertrain.CATProduct, ST_0200_003.CATPart, ST_A0200.CATProduct, ST_A0600.CATProduct, Steering System assy.CATProduct, Vulcanix.CATProduct]
2017-12-05 Maj chassis
    [FRAME.CATPart, Produit3.CATProduct, Produit4.CATProduct, STRMember_509951243112000.CATPart, STRMember_509951244911000.CATPart, STRMember_509951255308000.CATPart, Shape_547.CATPart, Shape_548.CATPart]
2017-12-05 changement de driveshaft left : 17in --> 15in
    [EN_1000_001_AA.CATPart, EN_1000_004_AA.CATPart, EN_A1000.CATProduct]
2017-12-05 déf°droite sur Tripod Polaris
    [D4483.CATPart]
2017-12-05 Merci pour le chassis CDO !
    [RIP ARB Assy.CATProduct, SU_0500_001.CATProduct, SU_0500_003.CATPart, SU_0510_004.CATPart, SU_0600_001.CATPart, SU_0600_002.CATPart, SU_0700_003.CATPart, SU_A0500.CATProduct]
2017-12-05 Modif wireframe.
    [wireframe_arms.CATPart]
2017-12-05 Modif shifter
    [FRAME.CATPart, FR_0400_002_BA.CATPart, Powertrain.CATProduct, Steering System assy.CATProduct, Vulcanix.CATProduct]
2017-12-05 P8 Rear plus haut
    [ins_arriere_gauche_haut_double.CATPart, wireframe_arms.CATPart]
2017-12-05 orga des contraintes des tripods
    [EN_1000_004_AA.CATPart, EN_A1000.CATProduct, FSAE Tripod V2.CATPart]
2017-12-05 Placement Firewall
    [Firewall.CATPart]
2017-12-05 Chappe motoréducteur
    [FR_0600_007_BA.CATPart, FR_0600_008_BA.CATPart]
2017-12-05 mise a jour chape dif assy
    [EN_0900_008_AA.CATPart, EN_0900_009_AA.CATPart, EN_A0200.CATProduct, EN_A0300.CATProduct, EN_A0900.CATProduct, EN_A1000.CATProduct, Powertrain.CATProduct]
2017-12-05 travail de brice
    [ins_arriere_gauche_haut_double.CATPart, ins_avant_gauche_double.CATPart]
2017-12-05 test arbre transmi
    [EN_A0200.CATProduct, EN_A0300.CATProduct, EN_A0900.CATProduct, EN_A1000.CATProduct, Powertrain.CATProduct]
2017-12-05 Driveshaft left positionné ! ATTENTION j'ai dû rendre rigide SU puis flexible Powertrain, puis re flexible SU
    [EN_A0200.CATProduct, EN_A0300.CATProduct, EN_A0900.CATProduct, Frame_assy.CATProduct, Powertrain.CATProduct, ST_A0200.CATProduct, ST_A0600.CATProduct, SU_A0700_modifiable.CATProduct]
2017-12-05 GO JEROME !
    [FR_A0300.CATProduct, Frame_assy.CATProduct]
2017-12-05 AJOUT ST_A0700
    [ST_07001_STEERING UPPER SHAFT.CATPart, ST_A0700_STEERING SHAFT PIVOT.CATProduct, W_61805.CATProduct, W_61805_PART1.CATPart, W_61805_PART2.CATPart, W_61805_PART3.CATPart]
2017-12-05 maj driveshafts
    [EN_1000_004_AA.CATPart, EN_A1000.CATProduct, Vulcanix.CATProduct]
2017-12-05 Ajout Cardan.
    [HPC - CARDAN.CATProduct, ST_A0200.CATProduct, ST_A0600.CATProduct, Steering System assy.CATProduct, _HPC - G1-A-16_16 - Fork1.CATPart, _HPC - G1-A-16_16 - Fork2.CATPart]
2017-12-05 Vite pusher tout avant que Adrien arrive !! ;)
    [ST_0300_002.CATPart, ST_A0200.CATProduct, ST_A0600.CATProduct, Steering System assy.CATProduct]
2017-12-05 Analyse du plenum et essais de modifications
    [EN_0300_001_AA.CATPart, EN_0300_001_BB.CATPart, EN_0300_001_BC.CATPart, EN_0300_001_BD.CATPart, EN_0300_001_BE.CATPart, EN_A0300.CATProduct, Powertrain.CATProduct]
2017-12-05 On est en paul zheng !
    [ST_07001_STEERING UPPER SHAFT.CATPart, ST_A0200.CATProduct, ST_A0600.CATProduct, ST_A0700_STEERING SHAFT PIVOT.CATProduct, Steering System assy.CATProduct]
2017-12-05 ajout chape moteur
    [EN_0100_002_AA.CATPart]
2017-12-05 Tu nous emmerde Adrien !
    [SU_0500_001.CATProduct, SU_0600_003.CATPart, SU_A0500.CATProduct, SU_A510.CATProduct, Suspension Assy.CATProduct, wireframe_arms.CATPart]
2017-12-05 arretez de modif powertrain
    [EN_A0200.CATProduct, EN_A0300.CATProduct, EN_A0900.CATProduct, Powertrain.CATProduct]
2017-12-05 troisiemeFoisque je place cette chape putain
    [EN_A0200.CATProduct, EN_A0300.CATProduct, EN_A0900.CATProduct, Powertrain.CATProduct]
2017-12-05 AJOUT ST_07003
    [SU_07003_STEERING BORE PLATE.CATPart]
2017-12-05 analyse chape moteur
    [EN_0100_002_AA.CATPart]
2017-12-05 on arrête les connerie maintenant !!!!
    [Frame_assy.CATProduct, Powertrain.CATProduct, Rear Left Wheel.CATProduct, SU_A0600.CATProduct, SU_A0700_modifiable.CATProduct, SU_A510.CATProduct, Steering System assy.CATProduct, Suspension Assy.CATProduct]
2017-12-05 ATTENTION MODIF SUR PRESQUE TOUT
    [Frame_assy.CATProduct, Powertrain.CATProduct, SU_A0700_modifiable.CATProduct, SU_A510.CATProduct, Steering System assy.CATProduct, Suspension Assy.CATProduct, Vulcanix.CATProduct]
2017-12-05 Placement préliminaire appui-tête
    [FR_A0300.CATProduct, Frame_assy.CATProduct, MS_0300_001_BA.CATPart, MS_0300_002_BA.CATPart, MS_0300_003_BA.CATPart, MS_0300_004_BA.CATPart, MS_A0300.CATProduct, Symmetry of 2Chape Inferieure Appui Tete.CATPart]
2017-12-05 Appui-tête
    [MS_0300_002_BA.CATPart, MS_A0300.CATProduct]
2017-12-05 ANTONIO, ECOUTE UN PEU
    [Brake caliper spacer.CATPart, Frame_assy.CATProduct, ISO_4762_M8x25_STEEL_HEXAGON_SOCKET_HEAD_CAP_SCREW.CATPart, Powertrain.CATProduct, Steering System assy.CATProduct, Suspension Assy.CATProduct, Vulcanix.CATProduct, WT 0100 005.CATPart]
2017-12-05 AJOUT DANS ST_A0700
    [CIRCLIP M30.CATPart, KMK_5.CATPart, QR Shaft.CATPart, QR Shaft.STEP, ST_07001_STEERING UPPER SHAFT.CATPart, ST_A0700_STEERING SHAFT PIVOT.CATProduct, SU_07002_STEERING BORE.CATPart, SU_07003_STEERING BORE PLATE.CATPart]
2017-12-05 on remet l'appui-tête à l'arrache
    [MS_0300_002_BA.CATPart]
2017-12-05 AJOUT DANS ST_A0700 ! Ps : 3B aprés !!!!
    [ST_07001_STEERING UPPER SHAFT.CATPart, SU_07002_STEERING BORE.CATPart]
2017-12-05 Quasiement fini !!!
    [CIRCLIP M30.CATPart, ST_07001_STEERING UPPER SHAFT.CATPart, ST_A0700_STEERING SHAFT PIVOT.CATProduct, SU_07002_STEERING BORE.CATPart, W_61806.CATProduct, W_61806_PART1.CATPart, W_61806_PART2.CATPart, W_61806_PART3.CATPart]
2017-12-05 Modifs moyeu avant - des bisous
    [Front Bearing Washer.CATPart, Front Left Wheel.CATProduct, WT 0200 001.CATPart]
2017-12-05 driveshaft left positionné sur Vulcanix
    [EN_A0200.CATProduct, EN_A0300.CATProduct, EN_A0900.CATProduct, EN_A1000.CATProduct, Frame_assy.CATProduct, Front Left Wheel.CATProduct, Powertrain.CATProduct, ST_A0200.CATProduct]
2017-12-05 Modifs PM avant - j'espère que ça marche
    [Front Left Upright.CATPart, Front Left Wheel.CATProduct]
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2017-12-06 non v2.0
    [SU_A0100.CATProduct]
2017-12-06 mise en ligne commit
    [EN_0800_01 - Radiator.CATPart, EN_0800_03 - Chape.CATPart, EN_0800_04 - Silentblock Bottom.CATPart, EN_0800_05 - Silentblock Top.CATPart, EN_A0800 - Cooling System.CATProduct, Powertrain.CATProduct]
2017-12-06 Modifs PM avant, faites pas chier avec mon PM
    [Front Bearing Washer.CATPart, Front Left Upright.CATPart, Front Left Wheel.CATProduct, Upper Arm Bracket.CATPart, Upper Arm Wedge.CATPart, WT 0200 001.CATPart, WT 0200 004.CATPart]
2017-12-06 qui lit encore les descriptions de toute manière ?
    [EN_A0800 - Cooling System.CATProduct]
2017-12-06 Encore des modifs
    [Rear Left Upright.CATPart, Rear Left Wheel.CATProduct, Speed Sensor Bracket.CATPart]
2017-12-06 Appui-tête v2.0
    [MS_0300_001_BA.CATPart, MS_0300_002_BA.CATPart, MS_0300_003_BA.CATPart, MS_0300_004_BA.CATPart, MS_A0300.CATProduct, Symmetry of 2Chape Inferieure Appui Tete.CATPart, Symmetry of Chape Superieure Appui Tete.CATPart]
2017-12-06 driveshaft right 21in --> 15in
    [EN_1000_002_AA.CATPart, EN_A1000.CATProduct]
2017-12-06 bon ba du coup 15in --> 17in
    [EN_1000_002_AA.CATPart, EN_A1000.CATProduct]
2017-12-06 Driveshafts placés en bonne approximation
    [EN_A1000.CATProduct, Frame_assy.CATProduct, Front Left Wheel.CATProduct, ISO_4762_M8x25_STEEL_HEXAGON_SOCKET_HEAD_CAP_SCREW.CATPart, Powertrain.CATProduct, Rear Left Wheel.CATProduct, SU_A0200.CATProduct, SU_A510.CATProduct]
2017-12-06 fait chier les branches
    [tube avant triangle sup.CATPart]
2017-12-06 nouvel échappement, je sais il y a des collisions
    [EN_0200_006_AA.CATPart, EN_0200_031_AA.CATProduct, EN_0200_032_AA.CATProduct, EN_0200_033_AA.CATProduct, EN_0200_034_AA.CATProduct, EN_0200_051_AA.CATProduct, EN_0200_052_AA.CATProduct, EN_A0200.CATProduct]
2017-12-06 appui-tête version lol.mdr
    [FR_A0300.CATProduct, Frame_assy.CATProduct, MS_0300_002_BA.CATPart, MS_0300_003_BA.CATPart, MS_0300_004_BA.CATPart, MS_A0300.CATProduct, Symmetry of 2Chape Inferieure Appui Tete.CATPart, Symmetry of Chape Superieure Appui Tete.CATPart]
2017-12-06 je vais te battre Cristophe
    [SU_A0100.CATProduct]
2017-12-06 mise en position cooling
    [EN_A0200.CATProduct, EN_A0300.CATProduct, EN_A0800 - Cooling System.CATProduct, EN_A0900.CATProduct, EN_A1000.CATProduct, Powertrain.CATProduct]
2017-12-06 contraintes masquées
    [EN_A0800 - Cooling System.CATProduct, Powertrain.CATProduct]
2017-12-06 triangle avant
    [SU_A0100.CATProduct, SU_A1400.CATProduct]
2017-12-06 ajout chape susp ça part au RU
    [chape sus tri arr inf gauche avant sup.CATPart]
2017-12-06 assemblage pour antonio
    [chassis + triangle.CATProduct]
2017-12-06 triangle avant : OK
    [Front Bearing Washer.CATPart, Front Left Upright.CATPart, Front Left Wheel.CATProduct, KM_7.CATPart, MB_7.CATPart, SA_8_E.CATPart, SU_0500_001.CATProduct, SU_A0200.CATProduct]
2017-12-06 chapes suspension arriere inferieure carai
    [chape sus tri arr inf gauche arri inf.CATPart, chape sus tri arr inf gauche arri sup.CATPart, chape sus tri arr inf gauche avant inf.CATPart, chape sus tri arr inf gauche avant sup.CATPart, chassis + triangle.CATProduct]
2017-12-06 Ajout tube d'attache direction.
    [ST_0200_003.CATPart, ST_A0200.CATProduct, ST_A0600.CATProduct, ST_A0700_STEERING SHAFT PIVOT.CATProduct, Steering System assy.CATProduct, steering_tube_lateral.CATPart, steering_tube_longi.CATPart]
2017-12-06 Je ne sais plus quoi écrire
    [Produit3.CATProduct, Produit4.CATProduct, Shape_649.CATPart, Shape_650.CATPart, Tubes.CATProduct]
2017-12-06 Coucou c'est lourd
    [Rear Left Upright.CATPart]
2017-12-06 des fucking chapes
    [chape sus tri arr inf gauche arri inf.CATPart, chape sus tri arr inf gauche avant inf.CATPart, chape sus tri arr inf gauche avant sup.CATPart, chape sus tri arr sup gauche arri inf.CATPart, chape sus tri arr sup gauche arri sup.CATPart, chape sus tri arr sup gauche avant inf.CATPart, chape sus tri arr sup gauche avant sup.CATPart, chape sus tri avant inf gauche avant inf.CATPart]
2017-12-06 MAJ point triangle chassis
    [FRAME.CATPart, Produit2.CATProduct, Produit3.CATProduct, Produit4.CATProduct, Produit5.CATProduct, Shape_540.CATPart, Shape_541.CATPart, Shape_563.CATPart]
2017-12-06 insert areedafzedcdcd
    [SU_A0100.CATProduct, SU_A0300 Upper Rear Left A-arms.CATProduct, ins_arr_gauche_double_suspen.CATPart, ins_avant_gauche_double.CATPart]
2017-12-06 more chapes
    [chape sus tri avant inf gauche avant inf.CATPart, chassis + triangle.CATProduct]
2017-12-06 Chappes autour shifter
    [FR_0600_001_MM.CATPart, FR_0600_002_MM.CATPart, FR_0600_007_BA.CATPart, FR_0600_008_BA.CATPart, FR_A0600.CATProduct, ecrou_6pans_m4_nylstop.CATPart, rondelle_plate_m4.CATPart, silentbloc_m4.CATPart]
2017-12-06 ya que un p à chape
    [chape sus tri arr sup gauche arri inf.CATPart, chape sus tri arr sup gauche arri sup.CATPart, chassis + triangle.CATProduct]
2017-12-06 Modification suspension avant.
    [SU_0500_001.CATProduct, SU_0600_003.CATPart, SU_A0200.CATProduct, SU_A0500.CATProduct, SU_A0600.CATProduct, SU_A1400.CATProduct, SU_A510.CATProduct, Steering System assy.CATProduct]
2017-12-06 Déso master chape
    [FR_A0600.CATProduct]
2017-12-07 Modification complète Suspension Avant.
    [SU_0500_001.CATProduct, SU_0510_001.CATPart, SU_0510_002.CATPart, SU_0510_003.CATPart, SU_0510_004.CATPart, SU_0600_003.CATPart, SU_A0500.CATProduct, SU_A0600.CATProduct]
2017-12-07 bon c tout pour ajd
    [SU_0800_004-chapeArriere.CATPart, SU_0800_004-chapeAvant.CATPart, chape sus tri arr inf gauche arri inf.CATPart, chape sus tri avant inf gauche arr inf.CATPart, chape sus tri avant inf gauche arr sup.CATPart, chape sus tri avant sup gauche arr inf.CATPart, chapeStandard - Copie (2).CATPart, chapeStandard - Copie (3).CATPart]
2017-12-07 création biellettes de pince et de pushrod arrière
    [SU_0900_001.CATPart, SU_0900_002.CATPart, SU_1500_001.CATPart, SU_1500_002.CATPart, SU_A0900.CATProduct, SU_A1500.CATProduct, ecrou M8 iso 4035.catpart]
2017-12-07 tie rod en position
    [SU_0900_001.CATPart, SU_0900_002.CATPart, SU_A0200.CATProduct, SU_A0900.CATProduct, SU_A1400.CATProduct, SU_A510.CATProduct, Suspension Assy.CATProduct, ecrou M8 iso 4035.catpart]
2017-12-07 création bielette de pince
    [ST_0500_001.CATPart, ST_0500_002.CATPart, ST_A0500.CATProduct, ecrou M8 iso 4035.catpart]
2017-12-07 Toujours plus de puissance
    [97135A275_GRADE 8 STEEL NYLON-INSERT LOCKNUT.CATPart, BR 0100 001.CATPart, Brake caliper spacer.CATPart, D4483.CATPart, Frette_Vulcanix.CATPart, ISO 4762 SCREW M8x25 STEEL HEXAGON SOCKET HEAD CAP.1.CATPart, ISO_4762_M8x25_STEEL_HEXAGON_SOCKET_HEAD_CAP_SCREW.CATPart, Rear Bearing Washer.CATPart]
2017-12-07 ST_A0700 - C'est moi qui est les cles Brice
    [ST_07001_STEERING UPPER SHAFT.CATPart, ST_A0700_STEERING SHAFT PIVOT.CATProduct, SU_07003_STEERING BORE PLATE.CATPart, SU_07005_STEERING END PLATE.CATPart]
2017-12-07 Cricri arrête les fautes dans le GIT
    [97135A275_GRADE 8 STEEL NYLON-INSERT LOCKNUT.CATPart, BR 0100 001.CATPart, Brake caliper spacer.CATPart, D4483.CATPart, Frette_Vulcanix.CATPart, ISO 4762 SCREW M8x25 STEEL HEXAGON SOCKET HEAD CAP.1.CATPart, ISO_4762_M8x25_STEEL_HEXAGON_SOCKET_HEAD_CAP_SCREW.CATPart, Rear Bearing Washer.CATPart]
2017-12-07 ST_A0700
    , ,
    (\____/)
    (_oo_)
    (O)
    __||__ \)
    []/______\[] /
    / \______/ \/
    / /__\
    (\ /____\
    [M8 NYLON NUT.CATPart, M8 WASHER.CATPart, M8x14 CHC BOLT.CATPart, M8x18 CHC BOLT.CATPart, ST_A0700_STEERING SHAFT PIVOT.CATProduct, SU_07005_STEERING END PLATE.CATPart, Steering System assy.CATProduct]
2017-12-07 ST_A0700 _ /_'. _ _ \ / '-. < ``-.;),--'` '--.</()`--. / |/-/`'._\ |/ |=| |_| ~` |-| ~~ ~ ~~ ~~ __|=|__ ~~ ~~ .-'` |_| ``""-._ ~~ ~~.' |=| O '-. ~ | `"""` <|\ \ ~ ~ \ |\ | ~~ jgs '-.__.--._ |/ .-' ~~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
    [ST_07001_STEERING UPPER SHAFT.CATPart, ST_A0700_STEERING SHAFT PIVOT.CATProduct, SU_07002_STEERING BORE.CATPart, SU_07003_STEERING BORE PLATE.CATPart, SU_07005_STEERING END PLATE.CATPart]
2017-12-07 Ajout fillaire assemblé
    [Assy.CATProduct, Body.CATPart, Front Left Upright.CATPart, Front Lower A Arm.CATPart, Front Upper A Arm.CATPart, Rear Left Upright.CATPart, Rear Lower A Arm.CATPart, Rear Upper A Arm.CATPart]
2017-12-07 Shifter ++
    [FR_0600_009_AA.CATPart, FR_A0600.CATProduct, vis_chc_m4x20.CATPart, vis_chc_m4x25.catpart]
2017-12-07 triangle arrière
    [SU_A0100.CATProduct, SU_A0200.CATProduct, SU_A0300 Upper Rear Left A-arms.CATProduct, SU_A510.CATProduct, Suspension Assy.CATProduct, ins_avant_gauche_double.CATPart]
2017-12-07 chape basCULeur
    [Rear_suspension_on_frame.CATProduct, SU_0800_004-chape.CATPart, SU_0800_004-chapeArriere.CATPart, chape sus tri arr inf gauche arri inf.CATPart, chassis + triangle.CATProduct]
2017-12-07 modif forme portes-exc --> abaissement du diff
    [EN_0900_006_AB.CATPart, EN_0900_007_AA.CATPart, EN_A0900.CATProduct]
2017-12-07 Ajout fixations admission/moteur
    [EN_0300_005_AA.CATPart, EN_0300_008_AA.CATPart, EN_A0300.CATProduct]
2017-12-07 AJOUT 3D PRINTING
    [Front Left Upright.stl, Part4.DXF, Rear Left Upright.stl, ST_A0700_STEERING SHAFT PIVOT.CATProduct, SU_07002_STEERING BORE.CATPart, SU_14001_FRONT ROCKER .DXF, SU_14001_FRONT ROCKER .SLDPRT, SU_14001_FRONT ROCKER .igs]
2017-12-07 Ajout triangles arrières mobiles.
    [Front Left Wheel.CATProduct, GE_8_C.CATProduct, Rear Left Wheel.CATProduct, SU_A0200.CATProduct, SU_A0300 Upper Rear Left A-arms.CATProduct, SU_A0400.CATProduct, SU_A0900.CATProduct, SU_A510.CATProduct]
2017-12-07 modif contraintes chain set
    [EN_1100_005_AA.CATPart, EN_A1100.CATProduct]
2017-12-07 1 de plus
    [FR_A0600.CATProduct]
2017-12-07 Triangles avant mobiles.
    [Front Left Wheel.CATProduct, Rear Left Wheel.CATProduct, SU_0500_001.CATProduct, SU_0500_002.CATPart, SU_A0100.CATProduct, SU_A0200.CATProduct, SU_A0300 Upper Rear Left A-arms.CATProduct, SU_A0500.CATProduct]
2017-12-07 Je sais pas ce que vous faites
    [Rear Left Wheel.CATProduct]
2017-12-07 Fini les push
    [FR_0600_009_AA.CATPart]
2017-12-07 Merci de prévenir avant de travailler sur les roues SVP
    [Rear Left Upright.CATPart, Rear Left Wheel.CATProduct, Upper Arm Bracket.CATPart, Upper Arm Wedge.CATPart]
2017-12-07 Ajout Meca Master
    [MECAmaster - [Steering System assy].CATProduct, QR Shaft.CATPart, ST_0200_003.CATPart, ST_0400_001_AA.CATPart, ST_07001_STEERING UPPER SHAFT.CATPart, ST_A0200.CATProduct, ST_A0600.CATProduct, ST_A0700_STEERING SHAFT PIVOT.CATProduct]
2017-12-07 biellette direction
    [BR 0100 001.CATPart, Brake caliper spacer.CATPart, Front Left Wheel.CATProduct, ST_0500_001.CATPart, ST_A0500.CATProduct, SU_A0200.CATProduct, SU_A0300 Upper Rear Left A-arms.CATProduct, SU_A0900.CATProduct]
2017-12-07 OKAY contraintes Powertrain rétablies !
    [EN_0900_007_AA.CATPart, EN_1100_005_AA.CATPart, EN_A0200.CATProduct, EN_A0300.CATProduct, EN_A0800 - Cooling System.CATProduct, EN_A0900.CATProduct, EN_A1000.CATProduct, EN_A1100.CATProduct]
2017-12-07 Las avant mobile.
    [ST_A0500.CATProduct, SU_A0200.CATProduct, SU_A0300 Upper Rear Left A-arms.CATProduct, SU_A0900.CATProduct, SU_A1400.CATProduct, SU_A510.CATProduct, Suspension Assy.CATProduct, wireframe_arms.CATPart]
2017-12-07 creation double Lug joint
    [ChapeDoubleJointDessus.CATPart, DoubleJoint.CATProduct, SU_0600_004-chape.CATPart, SU_0800_004-chape.CATPart, chapeDjoint.CATPart]
2017-12-07 trouage portes-excentriques pour chape jacking bar et rajout matière
    [EN_0900_006_AB.CATPart, EN_0900_007_AA.CATPart]
2017-12-07 Revert "MECA"
    This reverts commit 61b4d787b06863ea56383bf7100e077fa616d4d2.
    [MECAmaster - [Steering System assy].CATProduct, QR Shaft.CATPart, ST_0200_002 .CATPart, ST_0200_003.CATPart, ST_0300_002.CATPart, ST_0300_01_MM.CATPart, ST_0400_001_AA.CATPart, ST_0400_AA.CATProduct]
2017-12-07 Revert "Ajout Meca Master"
    This reverts commit 6afc8013e18def265040d38b46edcfcd93f02d8d.
    [MECAmaster - [Steering System assy].CATProduct, QR Shaft.CATPart, ST_0200_003.CATPart, ST_0400_001_AA.CATPart, ST_07001_STEERING UPPER SHAFT.CATPart, ST_A0200.CATProduct, ST_A0600.CATProduct, ST_A0700_STEERING SHAFT PIVOT.CATProduct]
2017-12-07 Appuitête toujours
    [Chape Inferieure Appui-Tete.CATPart, Chape Superieure Appui-Tete.CATPart, FR_A0300.CATProduct, Firewall.CATPart, Frame_assy.CATProduct, MS_A0300.CATProduct]
2017-12-07 échappement
    [EN_0200_006_AA.CATPart, EN_0200_031_AA.CATProduct, EN_0200_032_AA.CATProduct, EN_0200_033_AA.CATProduct, EN_0200_034_AA.CATProduct, EN_0200_051_AA.CATProduct, EN_0200_052_AA.CATProduct, EN_A0200.CATProduct]
2017-12-07 Commit A-Arms backup solutions steel
    [Insert_PM_acier.CATProduct, Insert_chassis_acier.CATProduct, demi cible capteur vitesse roue v1.0.CATPart, demi cible capteur vitesse roue v1.1.CATPart, insert colle triangle v2.CATPart, montant suspension avant.CATPart, plaque insert chassis v2.CATPart, plaque retenue rotule v2.CATPart]
2017-12-07 couture portes-excentriques
    [EN_0900_006_AB.CATPart, EN_0900_007_AA.CATPart]
2017-12-07 Coucou le nouveau point de direction
    [Front Left Upright.CATPart, Front Left Wheel.CATProduct]
2017-12-07 chapes Triangle
    [chape sus tri avant sup gauche arr inf.CATPart, chape sus tri avant sup gauche arr sup.CATPart, chape sus tri avant sup gauche avant inf.CATPart, chape sus tri avant sup gauche avant sup.CATPart, chapeStandard - Copie (2).CATPart, chapeStandard - Copie (3).CATPart, chapeStandard - Copie.CATPart, chassis + triangle.CATProduct]
2017-12-07 Modif carrossage avant à -2°
    [7207_BE_2RZP.CATProduct, Front Left Upright.CATPart, Front Left Wheel.CATProduct, Upper Arm Bracket.CATPart, Upper Arm Wedge.CATPart]
2017-12-07 Bracket seat
    [Frame_assy.CATProduct, MS_0400_002_AA.CATPart]
2017-12-07 Les bonnes chappes de l'appuitete
    [Chape Superieure Appui-Tete.CATPart, FR_A0300.CATProduct, FR_A0500.CATProduct, Firewall.CATPart, Frame_assy.CATProduct, MS_A0300.CATProduct]
2017-12-07 repositionnement arbres de transmission suite à l'abaissement du différentiel
    [EN_0200_032_AA.CATProduct, EN_0200_033_AA.CATProduct, EN_0200_051_AA.CATProduct, EN_A0200.CATProduct, EN_A0300.CATProduct, EN_A0800 - Cooling System.CATProduct, EN_A0900.CATProduct, EN_A1000.CATProduct]
2017-12-07 AH puis tête
    [FR_A0300.CATProduct, Firewall.CATPart, Frame_assy.CATProduct, MS_0300_001_BA.CATPart, MS_0300_002_BA.CATPart, MS_A0300.CATProduct]
2017-12-08 triangle arriere
    [SU_A0300 Upper Rear Left A-arms.CATProduct, tube triangle arr sup 1.CATPart, tube triangle arr sup 2.CATPart]
2017-12-08 rear pushrod
    [SU_A1500.CATProduct]
2017-12-08 Enregistrement préventif
    [Front Left Upright.CATPart, Front Left Wheel.CATProduct, Upper Arm Bracket.CATPart, Upper Arm Wedge.CATPart]
2017-12-08 Push aussi préventif
    [Frame_assy.CATProduct, MS_0400_002.CATPart, MS_0400_002_AA.CATPart]
2017-12-08 Tu as de la chance Reedom
    [Front Left Upright.CATPart, Front Left Wheel.CATProduct, Upper Arm Bracket.CATPart, Upper Arm Wedge.CATPart]
2017-12-08 Un peu oui...
    [FR_A0300.CATProduct, Frame_assy.CATProduct, MS_0400_002.CATPart]
2017-12-08 Safe again
    [FR_0400_002_BA.CATPart, FR_A0300.CATProduct, Frame_assy.CATProduct, MS_0400_002.CATPart, MS_0400_003.CATPart, MS_0400_004.CATPart, MS_0400_005.CATPart]
2017-12-08 chapes basculeur
    [Rear Left Wheel.CATProduct, ST_A0500.CATProduct, SU_0600_004-chape.CATPart, SU_0800_004-chape.CATPart, SU_A0200.CATProduct, SU_A0300 Upper Rear Left A-arms.CATProduct, SU_A0900.CATProduct, SU_A1400.CATProduct]
2017-12-08 ça passe large ! brice tu penses quoi de l'intégration du capteur sur le pm avant ?
    [Front Left Upright.CATPart, Front Left Wheel.CATProduct, MB_7.CATPart, Upper Arm Bracket.CATPart, Upper Arm Wedge.CATPart, WT 0200 001.CATPart, WT 0200 004.CATPart, disque_capteur_avant.CATPart]
2017-12-08 Revert "chapes basculeur"
    This reverts commit 9b695dfe0f2971bc6be83a7169b254354b662bf9.
    [Rear Left Wheel.CATProduct, ST_A0500.CATProduct, SU_0600_004-chape.CATPart, SU_0800_004-chape.CATPart, SU_A0200.CATProduct, SU_A0300 Upper Rear Left A-arms.CATProduct, SU_A0900.CATProduct, SU_A1400.CATProduct]
2017-12-08 Arrêtez de faire n'imp svp
    [Front Left Wheel.CATProduct, WT 0200 004.CATPart, stud m12.CATPart]
2017-12-08 En fait c'est pourri la fixation de ces capteurs
    [Front Left Upright.CATPart, Front Left Wheel.CATProduct, Upper Arm Bracket.CATPart]
2017-12-08 Fin chapes siège
    [Frame_assy.CATProduct, MS_0400_003.CATPart, MS_0400_004.CATPart, MS_0400_005.CATPart]
2017-12-08 J'espère que les triangles passent en encombrement
    [Front Left Upright.CATPart, Front Left Wheel.CATProduct, Upper Arm Bracket.CATPart, Upper Arm Wedge.CATPart]
2017-12-08 chapes Tri avant
    [chape sus tri avant sup gauche avant sup.CATPart]
2017-12-08 des modifs des modifs toujours des modifs
    [Rear Left Wheel.CATProduct, Upper Arm Bracket.CATPart, WT 0300 001.CATPart, WT 0300 004.CATPart]
2017-12-08 Coucou GTI
    [Front Left Wheel.CATProduct, disque_capteur_avant.CATPart]
2017-12-08 support crash sensor
    [EL_0100_002.CATPart, Suport Crash Sensor.CATPart, chape sus tri avant sup gauche arr sup.CATPart, chape sus tri avant sup gauche avant inf.CATPart, chassis electrique.CATProduct, chassis.CATProduct]
2017-12-08 Ajouts points pour FEA PM avant
    [Front Left Upright.CATPart, Front Left Wheel.CATProduct]
2017-12-08 Ajout batterie + support
    [EL_0200_001_AA.CATPart, EL_0200_002_AA.CATPart, EL_0200_003_AA.CATPart, EL_A0200.CATProduct, Frame_assy.CATProduct]
2017-12-08 Push battery
    [EL_A0200_001_AA.CATPart, EL_A0200_002_AA.CATPart, EL_A0200_003_AA.CATPart, Frame_assy.CATProduct, bracket_rear_battery.CATPart]
2017-12-08 Commit battery assemblée
    [FR_0400_001_BA.CATPart, FR_A0300.CATProduct, Frame_assy.CATProduct, bracket_right_battery.CATPart]
2017-12-08 Modifs pédalier
    [AXK_1024_PART1.CATPart, AXK_1024_PART2.CATPart, AXK_1024_PART3.CATPart, AXK_1024_PART4.CATPart, AXK_1024_PART5.CATPart, Cylindre repartiteur.CATPart, FR_0300_001_BA.CATPart, FR_0300_003_BA.CATPart]
2017-12-08 ajout jacking bar avec ses chapes
    [EN_0900_008_AA.CATPart, EN_0900_009_AA.CATPart, EN_0900_010_AA.CATPart, EN_0900_011_AA.CATPart, EN_0900_012_AA.CATPart, EN_A0200.CATProduct, EN_A0300.CATProduct, EN_A0800 - Cooling System.CATProduct]
2017-12-08 mini maj contraintes chapes powertrain
    [Powertrain.CATProduct]
2017-12-08 différentiation nombre de trous excentriques - portes excentriques --> on passe de 20 configs à 180 configs pour tendre la chaîne
    [EN_0900_004_AA.CATPart, EN_0900_005_AA.CATPart, EN_0900_006_AB.CATPart, EN_0900_007_AA.CATPart, EN_A0900.CATProduct, EN_A1100.CATProduct]
2017-12-08 MAJ taille chain shield
    [EN_1100_002_AA.CATPart, EN_1100_005_AA.CATPart, EN_1100_006_AA.CATPart, EN_A0200.CATProduct, EN_A0300.CATProduct, EN_A0800 - Cooling System.CATProduct, EN_A0900.CATProduct, EN_A1000.CATProduct]
2017-12-08 Usinage arbres de transmission et placement final sur Vulcanix
    [BR 0100 001.CATPart, EN_0800_04 - Silentblock Bottom.CATPart, EN_1000_001_AA.CATPart, EN_1000_002_AA.CATPart, EN_A1000.CATProduct, FR_A0300.CATProduct, Frame_assy.CATProduct, Front Left Wheel.CATProduct]
2017-12-09 bonne nuit
    [Frame_assy.CATProduct, Vulcanix.CATProduct]
2017-12-09 correction position cooling
    [EN_A0800 - Cooling System.CATProduct]
2017-12-09 Ajout coffret électronique arrière
    [EL_0300_001_AA.CATPart, EL_0300_001_AA.IGS, EL_0300_002_AA.CATPart, EL_0300_002_AA.IGS, EL_A0300.CATProduct]
2017-12-09 Push avoid collision with engine
    [Frame_assy.CATProduct, bracket_rear_battery.CATPart, bracket_right_battery.CATPart]
2017-12-09 FEA front upright
    [Front Left Upright.CATPart, Wireframe upright assembly.CATProduct]
2017-12-09 géométrie chain shield + abaissement jacking bar
    [EN_0900_006_AB.CATPart, EN_0900_007_AA.CATPart, EN_0900_010_AA.CATPart, EN_0900_011_AA.CATPart, EN_0900_012_AA.CATPart, EN_1100_005_AA.CATPart, EN_A0900.CATProduct]
2017-12-09 Allègemement chassis
    [Produit3.CATProduct, Tubes.CATProduct, tubulaire.CATProduct]
2017-12-09 regulateur pression + pompe à essence + visserie
    [EN_0500_002.CATProduct, EN_0500_003.CATProduct, HPC_-_CHC4-12_B_2_14.stp, HPC_-_FHC8-16_SS_B_2_14.stp, Produit42.CATProduct, Produit43.CATProduct, Reference pompe.CATProduct, chape fin pompe.CATProduct]
2017-12-09 Modification support crash sensor
    [Suport Crash Sensor.CATPart]
2017-12-09 dépôt Analysis des porte-exentriques
    [EN_0900_006_AB.CATPart, EN_0900_007_AA.CATPart]
2017-12-09 Mise en place crash sensor sur frame assy
    [FR_A0300.CATProduct, Frame_assy.CATProduct, Suport Crash Sensor.CATPart, bracket_Crash_Sensor.CATPart, chassis electrique.CATProduct, chassis.CATProduct]
2017-12-09 push préventif
    [Front Left Wheel.CATProduct, WT 0200 001.CATPart]
2017-12-09 Push également préventif
    [Frame_assy.CATProduct, bracket_Crash_Sensor.CATPart]
2017-12-09 J'adore faire des diapos
    [Front Bearing Washer.CATPart, Front Left Upright.CATPart, Front Left Wheel.CATProduct, Rear Left Upright.CATPart, Rear Left Wheel.CATProduct, Speed Sensor Caliper.CATPart, Upper Arm Bracket.CATPart, Upper Arm Wedge.CATPart]
2017-12-09 Push exhaust
    [EN_0200_032_AA.CATProduct, EN_0200_033_AA.CATProduct, EN_0200_051_AA.CATProduct, EN_A0200.CATProduct]
2017-12-09 Arrière contrait.
    [Suspension Assy.CATProduct]
2017-12-09 des trucs
    [BR 0100 001.CATPart, Frette_Vulcanix.CATPart, Frette_Vulcanix_avant.CATPart, Front Left Wheel.CATProduct, Rear Left Upright.CATPart, Rear Left Wheel.CATProduct, Tripod housing spacer.CATPart, WT 0100 005.CATPart]
2017-12-09 Exhaust en cours
    [EN_0200_004_AA.CATPart, EN_0200_006_AA.CATPart, EN_0200_031_AA.CATProduct, EN_0200_032_AA.CATProduct, EN_0200_033_AA.CATProduct, EN_0200_051_AA.CATProduct, EN_0200_052_AA.CATProduct, EN_A0200.CATProduct]
2017-12-09 Ajout modèle régulateur
    [EL_0100_001_AA.CATPart]
2017-12-09 Exhaust again...
    [EN_0200_008_AA.CATPart, EN_0200_032_AA.CATProduct, EN_0200_033_AA.CATProduct, EN_0200_051_AA.CATProduct, EN_A0200.CATProduct]
2017-12-09 Fuel tank push
    [Catchcan 2.CATPart, Catchcan.CATPart, Chape 1.CATPart, Chape 2.CATPart, Chape 3.CATPart, Chape 4.CATPart, Chape U3.CATPart, Chape U4.CATPart]
2017-12-09 Mise en position fuel tank
    [Chape 1.CATPart, Chape 2.CATPart, Chape 3.CATPart, Chape 4.CATPart, Chape U4.CATPart, EN_A0200.CATProduct, EN_A0400.CATProduct, EN_A0800 - Cooling System.CATProduct]
2017-12-09 Resolution collision avec firewall
    [EN_A0400.CATProduct]
2017-12-10 Mise en position regulateur
    [EN_A0400.CATProduct, Powertrain.CATProduct]
2017-12-10 Ajout feu stop
    [EL_0100_001_AA.CATPart, Electrical.CATProduct, Vulcanix.CATProduct]
2017-12-10 Ajout des 3 chapes de masse
    [Bracket_Earth_batt.CATPart, Bracket_Earth_ess.CATPart, Bracket_Earth_tab.CATPart, FR_A0300.CATProduct, Frame_assy.CATProduct, MS_0400_002.CATPart]
2017-12-10 Modif fuel tank + remise à jour nomenclature Electrical
    [EL_0100_001.CATPart, EL_0100_001_AA.CATPart, EL_0100_003.CATPart, EL_0300_001_AA.CATPart, EN_A0400.CATProduct, Electrical.CATProduct, Powertrain.CATProduct, main.CATPart]
2017-12-10 Placement DTA
    [Powertrain.CATProduct]
2017-12-10 Push placement boite cartes motored
    [EL_0300_001_AA.CATPart, EL_0300_001_AA.STEP, EL_0300_002_AA.CATPart, EL_0300_002_AA.STEP, EL_A0300.CATProduct, Powertrain.CATProduct]
2017-12-10 Légère modif Vulcanix
    [Vulcanix.CATProduct]
2017-12-10 analyse chape jacking bar
    [EN_0900_010_AA.CATPart, EN_0900_011_AA.CATPart, EN_A0900.CATProduct, Powertrain.CATProduct]
2017-12-10 modif diverse
    [Front Left Wheel.CATProduct, Rear Left Upright.CATPart, Rear Left Wheel.CATProduct, ST_A0500.CATProduct, SU_A0200.CATProduct, SU_A0300 Upper Rear Left A-arms.CATProduct, SU_A0900.CATProduct, SU_A1400.CATProduct]
2017-12-10 respect règlement chain shield + réajustement cut driveshaft
    [EN_1000_001_AA.CATPart, EN_1000_002_AA.CATPart, EN_1100_001_AA.CATPart, EN_1100_002_AA.CATPart, EN_1100_003_AA.CATPart, EN_1100_005_AA.CATPart]
2017-12-10 découpe chainshield forme moteur
    [EN_1100_005_AA.CATPart, EN_A1100.CATProduct]
2017-12-10 Commit catch can
    [Catchcan 2.CATPart, Catchcan.CATPart, ChapeCC.CATPart, ChapeCC2.CATPart, ChapeCC3.CATPart, EN_0500_004.CATProduct]
2017-12-10 pushrod arrière
    [Frette_Vulcanix.CATPart, Front Left Wheel.CATProduct, Rear Left Wheel.CATProduct, ST_A0500.CATProduct, SU_1500_001.CATPart, SU_A0200.CATProduct, SU_A0300 Upper Rear Left A-arms.CATProduct, SU_A0900.CATProduct]
2017-12-10 Ajout catch_can mais pb collisions
    [ChapeCC.CATPart, ChapeCC2.CATPart, ChapeCC3.CATPart, EN_0500_004.CATProduct, FR_0400_001_BA.CATPart, FR_0400_002_BA.CATPart, Frame_assy.CATProduct]
2017-12-10 Résolution pb collision catch can
    [EN_0900_010_AA.CATPart, EN_A0200.CATProduct, EN_A0300.CATProduct, EN_A0400.CATProduct, EN_A0800 - Cooling System.CATProduct, EN_A0900.CATProduct, EN_A1000.CATProduct, FR_A0600.CATProduct]
2017-12-10 pull rod avant
    [Front Left Wheel.CATProduct, Rear Left Wheel.CATProduct, SA_8_E.CATPart, ST_A0500.CATProduct, SU_1400_001.CATPart, SU_A0100.CATProduct, SU_A0200.CATProduct, SU_A0300 Upper Rear Left A-arms.CATProduct]
2017-12-10 Modificatiions supplémentaires du plenum et analyses
    [EN_0300_001_AA.CATPart, EN_0300_001_AB.CATPart, EN_0300_001_CA.CATPart, EN_0300_001_CB.CATPart, EN_0300_002_AA.CATPart, EN_0300_004_AA.CATPart, EN_0300_007_AA.CATPart, EN_0300_008_AA.CATPart]
2017-12-10 Modification chappe suspension avant.
    [SU_0510_001.CATPart, SU_0510_002.CATPart]
2017-12-10 break light
    [EL_0100_003.CATPart, Frame_assy.CATProduct, bracket_break_light.CATPart]
2017-12-10 Analyse bracket upper arm Rear upright
    [Upper Arm Bracket.CATPart]
2017-12-10 chape break light
    [FR_A0300.CATProduct, Frame_assy.CATProduct, bracket_break_light.CATPart]
2017-12-10 Chappe de suspension avant qui claque vénère.
    [SU_0510_001.CATPart, SU_0510_002.CATPart, SU_0510_003.CATPart, SU_A510.CATProduct]
2017-12-10 Last but not least
    [EN_A0400.CATProduct, Powertrain.CATProduct]
2017-12-10 chape basculeur essai N
    [Front Left Wheel.CATProduct, Rear Left Wheel.CATProduct, ST_A0500.CATProduct, SU_A0200.CATProduct, SU_A0300 Upper Rear Left A-arms.CATProduct, SU_A0900.CATProduct, SU_A1500.CATProduct, SU_A510.CATProduct]
2017-12-10 Ajout chape suspension arrière.
    [SU_0510_001.CATPart, SU_A0700_modifiable.CATProduct, SU_A510.CATProduct]
2017-12-10 Suspension assy.
    [Front Left Wheel.CATProduct, Rear Left Wheel.CATProduct, ST_0600_001_unique.CATPart, SU_A0200.CATProduct, SU_A0300 Upper Rear Left A-arms.CATProduct, SU_A0700_modifiable.CATProduct, SU_A0900.CATProduct, SU_A1400.CATProduct]
2017-12-11 cooling avec chapes
    [EN_0800_01 - Radiator.CATPart, EN_0800_03 - Chape.CATPart, EN_0800_04 - Silentblock Bottom.CATPart, EN_0800_05 - Silentblock Top.CATPart, EN_0800_06 - Fixing Bar.CATPart, EN_0800_07 - Chape Frame Top.CATPart, EN_0800_08 - Chape Chassis Bottom.CATPart, EN_0800_09 - Chape Frame Fixing Bar.CATPart]
2017-12-11 modif cooling
    [EN_0800_01 - Radiator.CATPart, EN_0800_06 - Fixing Bar.CATPart, EN_A0800 - Cooling System.CATProduct]
2017-12-11 Modif pédalier
    [Assemblage tubes chassis et pedalier.CATProduct, FR_0300_000_BA.CATPart, FR_0300_001_BA.CATPart, FR_0300_003_BA.CATPart, FR_0300_004_BA.CATPart, FR_0300_006_BA.CATPart, FR_0300_007_BA.CATPart, FR_0300_010_BA.CATPart]
2017-12-11 Basculeurs avant et arrière.
    [ISO_4014_M8x45_STEEL_GRADE_A_HEXAGON_HEAD_BOLT.CATPart, ISO_4032_M8_STEEL_GRADE_A_HEXAGON_NUT.CATPart, SU_A0600.CATProduct, SU_A0800.CATProduct]
2017-12-11 Modif side impact et ajout du tube baquet
    [FRAME.CATPart, Produit3.CATProduct, Produit4.CATProduct, Produit5.CATProduct, Shape_655.CATPart, Shape_656.CATPart, Shape_657.CATPart, Shape_658.CATPart]
2017-12-11 Volant plus bas.
    [ST_0200_003.CATPart, ST_0600_001_unique.CATPart, ST_0600_002.CATPart, ST_A0200.CATProduct, ST_A0500.CATProduct, ST_A0600.CATProduct, ST_A0700_STEERING SHAFT PIVOT.CATProduct, Steering System assy.CATProduct]
2017-12-11 Bre bre bre
    [ST_0600_001_unique.CATPart, ST_A0200.CATProduct, ST_A0600.CATProduct, ST_A0700_STEERING SHAFT PIVOT.CATProduct, Steering System assy.CATProduct]
2017-12-11 Dans le doute
    [Front Left Wheel.CATProduct, ST_0200_003.CATPart, ST_0600_002.CATPart, ST_A0200.CATProduct, ST_A0600.CATProduct, ST_A0700_STEERING SHAFT PIVOT.CATProduct, Steering System assy.CATProduct, WT 0100 006.CATPart]
2017-12-11 Modification de la maquette pour faire jolie
    [EN_A0800 - Cooling System.CATProduct, Frame_assy.CATProduct, Front Left Wheel.CATProduct, Powertrain.CATProduct, Rear Left Wheel.CATProduct, ST_0600_001_unique.CATPart, ST_A0200.CATProduct, ST_A0500.CATProduct]
2017-12-11 Modif cellule arrirère
    [FRAME.CATPart, Produit2.CATProduct, Produit3.CATProduct, Produit4.CATProduct, Produit5.CATProduct, Shape_540.CATPart, Shape_541.CATPart, Shape_563.CATPart]
2017-12-11 carrosserie modif
    [FR_0700_001_CA.CATPart]
2017-12-11 le cours de chimie est nul
    [SU_0600_004-chape.CATPart, chape sus tri arr sup gauche avant inf.CATPart]
2017-12-11 Beaucoup trop de prises dans ces amphis
    [EN_0800_06 - Fixing Bar.CATPart, EN_0800_07 - Chape Frame Top.CATPart, EN_0800_08 - Chape Chassis Bottom.CATPart, EN_0800_09 - Chape Frame Fixing Bar.CATPart, EN_0800_10 - FIxation Frame Expansion Tank.CATPart, EN_0800_11 - Expansion Tank.CATPart, EN_0800_12 - Fixation Expansion Tank.CATPart, EN_A0800 - Cooling System.CATProduct]
2017-12-11 modif cel arriere
    [FRAME.CATPart, Produit3.CATProduct, Produit4.CATProduct, Produit5.CATProduct, Shape_564.CATPart, Shape_567.CATPart, Shape_572.CATPart, Shape_573.CATPart]
2017-12-11 p'tites modifs mamène
    [FRAME.CATPart, Produit2.CATProduct, Produit3.CATProduct, Produit4.CATProduct, Produit5.CATProduct, Shape_540.CATPart, Shape_541.CATPart, Shape_563.CATPart]
2017-12-11 Carrosserie plus jolie
    [FR_0700_001_CA.CATPart]
2017-12-11 Modif pour le refroidissement
    [FRAME.CATPart, Produit1.CATProduct, Produit2.CATProduct, Produit3.CATProduct, Produit4.CATProduct, Produit5.CATProduct, Shape_533.CATPart, Shape_535.CATPart]
2017-12-11 C'est la merde
    [Front Left Upright.CATPart]
2017-12-11 Belle carrosserie à regarder, faites par le dirlo de projet
    [FR_0700_001_CA.CATPart]
2017-12-11 ajout carter
    [carter.CATProduct, carter.igs, cloison.CATPart, cloison_carter.CATProduct, cloison_longi.CATPart, cloison_longi.igs, cloison_transversale_carter.igs, corps_cloison_carter.CATPart]
2017-12-11 Modif pour pas casser des culs
    [Front Left Upright.CATPart]
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2017-12-11 Hack de Lahm
    [ST_0200_003.CATPart, ST_0600_001_unique.CATPart, ST_A0200.CATProduct, ST_A0600.CATProduct, ST_A0700_STEERING SHAFT PIVOT.CATProduct, Steering System assy.CATProduct]
2017-12-11 chassis v.9999999999.0
    [FRAME.CATPart, Produit3.CATProduct, Produit4.CATProduct, Produit5.CATProduct, Shape_564.CATPart, Shape_567.CATPart, Shape_572.CATPart, Shape_573.CATPart]
2017-12-11 cooling gone wrong
    [EN_0800_01 - Radiator.CATPart, EN_A0800 - Cooling System.CATProduct]
2017-12-11 Modif fond plat
    [FR_0400_001_BA.CATPart, FR_0400_002_BA.CATPart, FR_0400_003_BA.CATPart, FR_0400_004_BA.CATPart]
2017-12-11 Ajout de quelques chapes du fond plat
    [FR_0400_004_BA.CATPart, FR_A0300.CATProduct, Frame_assy.CATProduct]
2017-12-11 Des vis
    [Front Left Wheel.CATProduct, ISO_4762_M6x30_STEEL_HEXAGON_SOCKET_HEAD_CAP_SCREW.CATPart, ISO_4762_M8x50_STEEL_HEXAGON_SOCKET_HEAD_CAP_SCREW.CATPart, ISO_4762_M8x50_STEEL_HEXAGON_SOCKET_HEAD_CAP_SCREW_New_26.CATPart, ISO_4762_M8x55_STEEL_HEXAGON_SOCKET_HEAD_CAP_SCREW.CATPart, Upper Arm Bracket.CATPart, Upper Arm Wedge.CATPart]
2017-12-11 chapes las c la galere
    [chape sus tri arr inf gauche arri inf.CATPart, chape sus tri arr sup gauche avant inf.CATPart, chape sus tri arr sup gauche avant sup.CATPart, chape sus tri avant sup gauche arr inf.CATPart]
2017-12-11 Toujours plus de vis
    [Front Left Wheel.CATProduct, ISO_4762_M8x50_STEEL_HEXAGON_SOCKET_HEAD_CAP_SCREW_New_26.CATPart, ISO_7089_6x12_STEEL_GRADE_A_NORMAL_SERIES_PLAIN_WASHER.CATPart, vis_chc_M6_40.CATPart]
2017-12-11 Ajout modèles master switch + powerbox
    [EL_0100_004.CATPart, EL_A0500.CATProduct]
2017-12-11 Chape de direction.
    [ST_0600_001_unique.CATPart, ST_A0200.CATProduct, ST_A0600.CATProduct, ST_A0700_STEERING SHAFT PIVOT.CATProduct, Steering System assy.CATProduct]
2017-12-11 ça part
    [DoubleJoint.CATProduct, FR_A0300.CATProduct, Frame_assy.CATProduct]
2017-12-11 H-18 les enfants, on est larges.
    [EN_0800_C01.CATPart, EN_0800_C02.CATPart, EN_0800_C03.CATPart, EN_A0800 - Cooling System.CATProduct]
2017-12-12 diff dans powertrain
    [EN_0900_006_AB.CATPart, EN_0900_010_AA.CATPart, EN_0900_011_AA.CATPart, EN_0900_012_AA.CATPart, EN_1000_004_AA.CATPart, EN_A0200.CATProduct, EN_A0300.CATProduct, EN_A0400.CATProduct]
2017-12-12 position finale du radiateur
    [EN_0800_03 - Chape.CATPart, EN_0800_06 - Fixing Bar.CATPart, EN_0800_07 - Chape Frame Top.CATPart, EN_0800_08 - Chape Chassis Bottom.CATPart, EN_0800_09 - Chape Frame Fixing Bar.CATPart, EN_0800_C02.CATPart, EN_0800_C03.CATPart, EN_0800_C04.CATPart]
2017-12-12 mise en place contraintes cooling powertrain
    [EN_A0800 - Cooling System.CATProduct, Powertrain.CATProduct]
2017-12-12 vase d'expansion
    [EN_0800_03 - Silentblock Bottom.CATPart, EN_0800_04 - Silentblock Top.CATPart, EN_0800_05 - Fixing Bar.CATPart, EN_0800_06 - Expansion Tank - Small.CATPart, EN_0800_06 - Expansion Tank.CATPart, EN_0800_10 - FIxation Frame Expansion Tank.CATPart, EN_0800_11 - Expansion Tank.CATPart, EN_0800_12 - Fixation Expansion Tank.CATPart]
2017-12-12 ajout vis cooling
    [EN_0800_01 - Radiator.CATPart, EN_0800_04 - Silentblock Bottom.CATPart, EN_0800_05 - Fixing Bar.CATPart, EN_0800_05 - Silentblock Top.CATPart, EN_0800_06 - Expansion Tank - Small.CATPart, EN_0800_06 - Fixing Bar.CATPart, EN_0800_C01.CATPart, EN_0800_C03.CATPart]
2017-12-12 insert avant
    [Part223.CATPart, Part230.CATPart, Part231.CATPart, Part264.CATPart, Part267.CATPart, Part269.CATPart, Part270.CATPart, Part300.CATPart]
2017-12-12 Fin vis avant
    [Front Left Upright.CATPart, Front Left Wheel.CATProduct, ISO_4762_M6x30_STEEL_HEXAGON_SOCKET_HEAD_CAP_SCREW.CATPart, ISO_4762_M8x60_STEEL_HEXAGON_SOCKET_HEAD_CAP_SCREW.CATPart, Upper Arm Bracket.CATPart, Upper Arm Wedge.CATPart]
2017-12-12 Master vis
    [7207_BE_2RZP.CATProduct, BR 0100 001.CATPart, Brake caliper spacer.CATPart, Front Bearing Washer.CATPart, Front Left Wheel.CATProduct, KM_7.CATPart, MB_7.CATPart, Speed Sensor Caliper.CATPart]
2017-12-12 Mousses diverses
    [Chape Inferieure Harnais.CATPart, FR_0700_003_BA.CATPart, FR_A0300.CATProduct, Frame_assy.CATProduct, Mousse roll bar padding.CATPart, MousseEpaules.CATPart, MousseEpauleslongues.CATPart, Symmetry of 2Chape Inferieure Appui Tete.CATPart]
2017-12-12 modif position vase d'expansion
    [EN_0800_01 - Radiator.CATPart, EN_0800_04 - Silentblock Bottom.CATPart, EN_0800_05 - Silentblock Top.CATPart, EN_0800_06 - Expansion Tank - Small.CATPart, EN_0800_06 - Fixing Bar.CATPart, EN_0800_C01.CATPart, EN_0800_C02.CATPart, EN_0800_C03.CATPart]
2017-12-12 Head restreint
    [MS_0300_001_BA.CATPart, MS_A0300.CATProduct]
2017-12-12 allongement portes-excentriques
    [EN_0900_006_AB.CATPart, EN_0900_007_AA.CATPart]
2017-12-12 Ajout support master switch
    [EL_0100_004.IGS, EL_0600_001.CATPart, EL_0600_002.CATPart, EL_0600_003.CATPart, EL_A0600.CATProduct]
2017-12-12 correction bureau
    [FR_A0300.CATProduct, Frame_assy.CATProduct, chape sus tri arr inf gauche arri inf.CATPart, chassis + triangle.CATProduct]
2017-12-12 Thèse en vis
    [Rear Left Upright.CATPart, Rear Left Wheel.CATProduct, Tripod housing spacer.CATPart, Upper Arm Bracket.CATPart, Upper Arm Wedge.CATPart, WT 0300 001.CATPart, disque_capteur_arriere.CATPart]
2017-12-12 doublejoint en phase de test
    [DoubleJoint.CATProduct, FR_A0300.CATProduct, Frame_assy.CATProduct, chapeDjoint.CATPart]
2017-12-12 Rig cel arrière
    [FRAME.CATPart, Produit4.CATProduct, STRMember_509951243112000.CATPart, STRMember_509951244911000.CATPart, STRMember_509951255308000.CATPart, Shape_662.CATPart, Shape_663.CATPart, Shape_664.CATPart]
2017-12-12 épaulements excentriques
    [EN_0900_004_AA.CATPart, EN_0900_005_AA.CATPart]
2017-12-12 maj épaulements
    [EN_0900_004_AA.CATPart, EN_0900_005_AA.CATPart]
2017-12-12 tjr des roulements
    [EN_0900_004_AA.CATPart, EN_0900_005_AA.CATPart]
2017-12-12 Ajout tableau de bord
    [Bouton poussoir Raz motored.CATPart, Bouton poussoir demarrage.CATPart, Bouton poussoir.CATPart, Compte-tour.CATProduct, LED bleu 5mm.CATPart, LED holder.CATPart, LED jaune 5mm.CATPart, LED rouge 5mm.CATPart]
2017-12-12 double lug joint
    [ChapeDoubleJointDessus.CATPart, DoubleJoint.CATProduct, FR_A0300.CATProduct, Frame_assy.CATProduct, chapeDjoint.CATPart]
2017-12-12 Aurélien tu aurais pu mettre les bonnes vis au moins
    [ISO_4762_M6x35_STEEL_HEXAGON_SOCKET_HEAD_CAP_SCREW.CATPart, Rear Left Upright.CATPart, Rear Left Wheel.CATProduct, Upper Arm Bracket.CATPart, Upper Arm Wedge.CATPart]
2017-12-12 Vive les boulons
    [Front Left Wheel.CATProduct, Rear Left Upright.CATPart, Rear Left Wheel.CATProduct, Upper Arm Bracket.CATPart, Upper Arm Wedge.CATPart]
2017-12-12 EN_A0900 (differential Assy) correctement contraint (avec épaulements roulements)
    [EN_0900_010_AA.CATPart, EN_0900_011_AA.CATPart, EN_0900_012_AA.CATPart, EN_A0900.CATProduct]
2017-12-12 position tableau de bord
    [Steering System assy.CATProduct]
2017-12-12 Petites modifs + repositionnement correct sur Powertrain
    [EN_0300_001_CB.CATPart, EN_0300_002_AA.CATPart, EN_A0300.CATProduct, Powertrain.CATProduct]
2017-12-12 MAJ ST
    [Steering System assy.CATProduct]
2017-12-12 Volant palettes
    [Proshift.CATPart, ST_0400_AA.CATProduct]
2017-12-12 WTF MAN
    [FRAME.CATPart, ST_07001_STEERING UPPER SHAFT.CATPart, ST_A0200.CATProduct, ST_A0600.CATProduct, ST_A0700_STEERING SHAFT PIVOT.CATProduct, SU_07002_STEERING BORE.CATPart, SU_07004_BEARING SPACER.CATPart, Tableau de bord.CATProduct]
2017-12-12 divers chape siege
    [FR_0400_003_BA.CATPart, FR_0400_004_BA.CATPart, FR_A0300.CATProduct, Frame_assy.CATProduct, MS_0400_003.CATPart, MS_0400_005.CATPart]
2017-12-12 Je sais plus
    [Front Left Upright.CATPart, Front Left Wheel.CATProduct]
2017-12-12 Faites de la place pour les palettes
    [ST_A0200.CATProduct, ST_A0600.CATProduct, ST_A0700_STEERING SHAFT PIVOT.CATProduct, Steering System assy.CATProduct]
2017-12-12 chapes miscellaneous
    [Chape Inferieure Appui-Tete.CATPart, Chape Inferieure Harnais.CATPart, Chape Superieure Appui-Tete.CATPart, Frame_assy.CATProduct, MS_0400_002.CATPart, MS_0400_003.CATPart, MS_0400_004.CATPart, MS_0400_005.CATPart]
2017-12-12 ajout chape masse
    [Bracket_Earth_ess_sym.CATPart]
2017-12-12 contraintes un peu mieux sur powertrain
    [EN_A0200.CATProduct, EN_A0300.CATProduct, EN_A0400.CATProduct, EN_A0800 - Cooling System.CATProduct, EN_A0900.CATProduct, EN_A1000.CATProduct, FR_A0600.CATProduct, Powertrain.CATProduct]
2017-12-12 mini maj contraintes powertrain
    [EN_A0800 - Cooling System.CATProduct, Powertrain.CATProduct, transmission secondaire.CATProduct]
2017-12-12 modif nulle
    [MousseEpauleslongues.CATPart]
2017-12-12 On récupère Powertrain :) bientôt disponible dans vos bacs ...
    [EN_A0200.CATProduct, EN_A0300.CATProduct, EN_A0400.CATProduct, EN_A0800 - Cooling System.CATProduct, EN_A0900.CATProduct, EN_A1000.CATProduct, FR_A0600.CATProduct, Powertrain.CATProduct]
2017-12-12 c'est mieux
    [EN_A0200.CATProduct, EN_A0300.CATProduct, EN_A0400.CATProduct, EN_A0800 - Cooling System.CATProduct, EN_A0900.CATProduct, EN_A1000.CATProduct, FR_A0600.CATProduct, Powertrain.CATProduct]
2017-12-12 push powertrain
    [EN_A0200.CATProduct, EN_A0300.CATProduct, EN_A0400.CATProduct, EN_A0800 - Cooling System.CATProduct, EN_A0900.CATProduct, EN_A1000.CATProduct, EN_A1100.CATProduct, FR_A0600.CATProduct]
2017-12-12 Modification volant.
    [ST_0600_001_unique.CATPart, ST_A0200.CATProduct, ST_A0600.CATProduct, ST_A0700_STEERING SHAFT PIVOT.CATProduct, Steering System assy.CATProduct, wireframe_arms.CATPart]
2017-12-12 Création side firewall
    [Firewall - lower side.CATPart, Firewall - middle side.CATPart, Firewall - upper side.CATPart]
2017-12-12 Modification tube du shaft pivot.
    [ST_0200_003.CATPart, ST_A0200.CATProduct, ST_A0600.CATProduct, ST_A0700_STEERING SHAFT PIVOT.CATProduct, Steering System assy.CATProduct, Symmetry of ST_A0500.CATProduct, steering_tube_lateral.CATPart, steering_tube_longi.CATPart]
2017-12-12 encore des chapes
    [Chape Standard.CATPart, FR_0400_003_BA.CATPart, FR_0400_004_BA.CATPart]
2017-12-12 ajout du siege dans frame
    [FR_A0300.CATProduct, Frame_assy.CATProduct]
2017-12-12 replacement du siege
    [Chape Standard.CATPart, FR_A0300.CATProduct, Frame_assy.CATProduct]
2017-12-12 MAJ plasma gazeuse: le siège est mtn dans frame assy
    [Vulcanix.CATProduct]
2017-12-12 plus besoin de l'assembly missellaneous
    [FR_A0300.CATProduct, Frame_assy.CATProduct, baquet_taille_6.CATPart]
2017-12-12 chape bocal
    [FR_0300_002_BA.CATPart, FR_0300_029_BA.CATPart, FR_0300_030_BA.CATPart, FR_A0300.CATProduct]
2017-12-12 position Tdb
    [Steering System assy.CATProduct, Support_tdb.CATPart, Tableau de bord.CATProduct]
2017-12-12 chape siege c la pls
    [Chape Standard.CATPart, Frame_assy.CATProduct, chape desous baquet.CATPart, chape dessous siege.CATPart]
2017-12-12 modif materiau
    [FR_0300_029_BA.CATPart]
2017-12-12 materiau bocal
    [FR_0300_030_BA.CATPart, FR_0300_031_BA.CATPart]
2017-12-12 allongement chaîne
    [EN_1100_002_AA.CATPart]
2017-12-12 ai ai ai
    [Frame_assy.CATProduct, Front Left Wheel.CATProduct, Rear Left Wheel.CATProduct, ST_A0500.CATProduct, SU_0600_004-chape.CATPart, SU_0800_004-chape.CATPart, SU_A0200.CATProduct, SU_A0300 Upper Rear Left A-arms.CATProduct]
2017-12-12 modification sus assy.
    [Front Left Shock Absorber.CATProduct, RIP ARB Assy.CATProduct, Rear Left Shock Absorber Assy.CATProduct, Rear_suspension_on_frame.CATProduct, Suspension Assy.CATProduct, Symmetry of 4483 Polaris (20T).CATPart, Symmetry of 97135A275.CATPart, Symmetry of Bague_6mm.CATPart]
2017-12-12 on est pas couché
    [Front Left Upright.CATPart]
2017-12-13 Hihi hoho hehe
    [Front Left Wheel.CATProduct, HPC - CARDAN.CATProduct, Part212.CATPart, Part213.CATPart, Part214.CATPart, Part260.CATPart, Part270.CATPart, Part276.CATPart]
2017-12-13 haha baba gaga
    [Front Left Wheel.CATProduct, Produit40.CATProduct, Rear Left Wheel.CATProduct, ST_A0500.CATProduct, SU_A0200.CATProduct, SU_A0300 Upper Rear Left A-arms.CATProduct, SU_A0600.CATProduct, SU_A0900.CATProduct]
2017-12-13 modif chape break light
    [FR_A0300.CATProduct, Frame_assy.CATProduct, bracket_break_light.CATPart]
2017-12-13 mas chape crash sensor
    [Frame_assy.CATProduct, bracket_Crash_Sensor.CATPart]
2017-12-13 Début renomage pour faire plaiz à lahm
    [Rear Left Upright.CATPart, Rear Left Wheel.CATProduct, SU_1100_001 (Rear Upright).CATPart, SU_1100_002 (Upper Arm Wedge).CATPart, SU_1100_003 (Upper Arm Bracket).CATPart, Upper Arm Bracket.CATPart, Upper Arm Wedge.CATPart, WT 0100 005.CATPart]
2017-12-13 Ajout matériaux.
    [SU_0500_001.CATProduct, SU_0500_002.CATPart, SU_0500_003.CATPart, SU_0700_001.CATPart.CATProduct, SU_0700_003.CATPart, SU_A0500.CATProduct, SU_A0700.CATProduct, SU_A0700_modifiable.CATProduct]
2017-12-13 Contraintes siège baquet
    [FRAME.CATPart, FR_A0300.CATProduct, Frame_assy.CATProduct]
2017-12-13 meilleures contraintes baquet
    [Frame_assy.CATProduct, baquet_taille_6.CATPart]
2017-12-13 Contraintes baquet encore meilleures
    [FR_A0300.CATProduct, Frame_assy.CATProduct, baquet_taille_6.CATPart]
2017-12-13 remise en place de la chaîne
    [EN_1100_005_AA.CATPart, EN_A0200.CATProduct, EN_A0300.CATProduct, EN_A0400.CATProduct, EN_A0800 - Cooling System.CATProduct, EN_A0900.CATProduct, EN_A1000.CATProduct, EN_A1100.CATProduct]
2017-12-13 maj pliage chainshield
    [EN_1100_005_AA.CATPart]
2017-12-13 de même
    [EN_1100_005_AA.CATPart]
2017-12-13 POPOPOOOO i'm done with chainset
    [EN_1100_005_AA.CATPart, EN_A0900.CATProduct, EN_A1000.CATProduct, EN_A1100.CATProduct, transmission secondaire.CATProduct]
2017-12-13 plaque support appui-tête
    [MS_0300_002_BA.CATPart]
2017-12-13 nouveaux inserts
    [Insert Triangle cote chassis v2.CATPart, SU_A0200.CATProduct]
2017-12-13 réglage bug chapes
    [EN_1100_006_AA.CATPart, EN_1100_007_AA.CATPart, EN_A0200.CATProduct, EN_A0300.CATProduct, EN_A0400.CATProduct, EN_A0800 - Cooling System.CATProduct, EN_A0900.CATProduct, EN_A1000.CATProduct]
2017-12-13 chape 1 siege
    [FR_A0300.CATProduct, Frame_assy.CATProduct, chape desous baquet.CATPart]
2017-12-13 chainset réglé
    [EN_A0900.CATProduct, EN_A1000.CATProduct, Powertrain.CATProduct, transmission secondaire.CATProduct]
2017-12-13 remise en place de la las
    [FR_0300_031_BA.CATPart, ISO_4014_M6x30_STEEL_GRADE_A_HEXAGON_HEAD_BOLT.CATPart, ISO_7089_6x12_STEEL_GRADE_A_NORMAL_SERIES_PLAIN_WASHER.CATPart, MS_A0300.CATProduct, Powertrain.CATProduct, SU_A0600.CATProduct, SU_A0800.CATProduct, SU_A510.CATProduct]
2017-12-13 chape 2 desous chassis v1.0 versioné par PSO
    [FR_A0300.CATProduct, Frame_assy.CATProduct]
2017-12-13 cration sleeve joint2
    [Frame_assy.CATProduct, baquet_taille_6.CATPart, sleeve joint.CATPart]
2017-12-13 ajout amortisseur
    [ISO_4014_M8x45_STEEL_GRADE_A_HEXAGON_HEAD_BOLT.CATPart, ISO_7089_8x16_STEEL_GRADE_A_NORMAL_SERIES_PLAIN_WASHER.CATPart, SU_0700_001.CATPart.CATProduct, SU_A0700.CATProduct, Suspension Assy.CATProduct]
2017-12-13 modif support battery
    [EL_A0200_002_AA.CATPart]
2017-12-13 placement partiel de la batterie
    [EL_A0200.CATProduct, FR_A0300.CATProduct, Frame_assy.CATProduct]
2017-12-13 modif triangle
    [SU_0100_005.CATPart, SU_0200_005.CATPart, SU_A0100.CATProduct, SU_A0200.CATProduct, ins_avant_gauche_double.CATPart]
2017-12-13 Réparation des contraintes.
    [Front Left Wheel.CATProduct, Part297.CATPart, Produit40.CATProduct, Rear Left Wheel.CATProduct, ST_A0500.CATProduct, SU_0700_001.CATPart.CATProduct, SU_1100_002 (Upper Arm Wedge).CATPart, SU_1100_003 (Upper Arm Bracket).CATPart]
2017-12-13 Rahh tu m'as fait chier Brice !
    [SA_8_E.CATPart, SI_8_E.CATPart]
2017-12-13 désolé LAHM
    [SU_0100_005.CATPart, SU_0300_005.CATPart, SU_0400_005.CATPart, SU_A0300 Upper Rear Left A-arms.CATProduct, SU_A0400.CATProduct, Suspension Assy.CATProduct]
2017-12-13 amélioration insert avant inf double
    [ins_avant_gauche_double.CATPart]
2017-12-13 modif chape haut radiateur
    [EN_0800_04 - Silentblock Bottom.CATPart, EN_0800_05 - Silentblock Top.CATPart, EN_0800_C01.CATPart, EN_A0800 - Cooling System.CATProduct]
2017-12-13 modif de mes horreur
    [ins_arr_gauche_double_suspen.CATPart, ins_avant_gauche_double.CATPart]
2017-12-13 Matière jante.
    [WT 0100 005.CATPart, WT 0100 006.CATPart]
2017-12-13 Ajout matière triangles.
    [GE_8_C.CATProduct, GE_8_Cblr_001_101_spb_ge1.CATPart, GE_8_Cblr_001_101_spb_ge2.CATPart, SA_8_E.CATPart, ST_0500_001.CATPart, ST_0500_002.CATPart, ST_A0500.CATProduct, SU_0200_005.CATPart]
2017-12-14 MAJ cylindre répartiteur pédalier
    [FR_0300_012_BA.CATPart, FR_0300_018_BA.CATPart, FR_0300_031_BA.CATPart, FR_A0300.CATProduct, ISO_4014_M6x30_STEEL_GRADE_A_HEXAGON_HEAD_BOLT.CATPart, ISO_7089_6x12_STEEL_GRADE_A_NORMAL_SERIES_PLAIN_WASHER.CATPart]
2017-12-14 Ajustement des ouïes
    [FR_0700_001_CA.CATPart]
2017-12-14 powertrain chainshield
    [EN_A0900.CATProduct, EN_A1000.CATProduct, EN_A1100.CATProduct, transmission secondaire.CATProduct]
2017-12-14 truc de merde réglé
    [EN_1100_005_AA.CATPart, EN_A0200.CATProduct, EN_A0300.CATProduct, EN_A0400.CATProduct, EN_A0800 - Cooling System.CATProduct, EN_A0900.CATProduct, EN_A1000.CATProduct, EN_A1100.CATProduct]
2017-12-14 contraintes propres dans driveshaft assy
    [EN_A1000.CATProduct]
2017-12-14 Revert "Modif fond plat"
    This reverts commit 51c49767d480a7960fd87ad350254562ea886ae3.
    [FR_A0300.CATProduct, Frame_assy.CATProduct, MS_A0300.CATProduct]
2017-12-14 pareil mais mieux
    [EN_A1000.CATProduct]
2017-12-14 Replacement fond plat
    [FR_0700_001_CA.CATPart, FR_0700_002_BA.CATPart, FR_0700_003_BA.CATPart, FR_A0300.CATProduct, Frame_assy.CATProduct]
2017-12-14 materiaux chapes
    [EN_0800_C01.CATPart, EN_0800_C02.CATPart, EN_0800_C03.CATPart, EN_0800_C04.CATPart]
2017-12-14 le bon merge
    [EN_A1000.CATProduct, EN_A1100.CATProduct]
2017-12-14 détail
    [EN_A0200.CATProduct, EN_A0300.CATProduct, EN_A0400.CATProduct, EN_A0800 - Cooling System.CATProduct, EN_A0900.CATProduct, EN_A1000.CATProduct, FR_A0600.CATProduct, Powertrain.CATProduct]
2017-12-14 2eme chape battere
    [EL_A0200.CATProduct, EL_A0200_002_AA.CATPart, FR_A0300.CATProduct, Frame_assy.CATProduct, bracket_rear_battery.CATPart, bracket_rear_battery2.CATPart, bracket_right_battery.CATPart]
2017-12-14 fucking batterie placee
    [EL_A0200.CATProduct, EL_A0200_002_AA.CATPart, FR_A0300.CATProduct, Frame_assy.CATProduct, bracket_right_battery.CATPart]
2017-12-14 ajout de points d'esquisse sur Symmetry of Polaris
    [Symmetry of 4483 Polaris (20T).CATPart]
2017-12-14 chapes derriere siège
    [FR_A0300.CATProduct, Frame_assy.CATProduct, Symmetry of seat bracket - rear.CATPart, Symmetry of seat bracket - under .CATPart, bracket_rear_battery2.CATPart, bracket_right_battery.CATPart, chape arriere baquet.CATPart, chape desous baquet.CATPart]
2017-12-14 Rennomage en cours
    [7207_BE_2RZP.CATProduct, BR 0100 001.CATPart, Brake caliper spacer.CATPart, Front Bearing Washer.CATPart, Front Left Upright.CATPart, Front Left Wheel.CATProduct, KM_7.CATPart, MB_7.CATPart]
2017-12-14 Ajout chapes carrosserie
    [FRAME.CATPart, FR_A0300.CATProduct, Frame_assy.CATProduct, Symmetry of FR_0700_004_BA.CATPart, Symmetry of FR_0700_005_BA.CATPart, Symmetry of FR_0700_006_BA.CATPart, Symmetry of FR_0700_007_BA.CATPart]
2017-12-14 chanfrein vis tete fraisée
    [210203-6x16.CATPart, FR_0300_003_BA.CATPart, FR_0300_004_BA.CATPart, FR_A0300.CATProduct]
2017-12-14 cut driveshafts
    [EN_1000_001_AA.CATPart, EN_1000_002_AA.CATPart]
2017-12-14 Ménage
    [97135A295_GRADE 8 STEEL NYLON-INSERT LOCKNUT.CATPart, BR 0100 001.CATPart, BR_0200_001 (Break Disc).CATPart, D4484.CATPart, ISO 4762 SCREW M8x25 STEEL HEXAGON SOCKET HEAD CAP.1.CATPart, ISO_4762_M8x25_STEEL_HEXAGON_SOCKET_HEAD_CAP_SCREW.CATPart, WT 0100 005.CATPart, WT 0100 006.CATPart]
2017-12-14 Bon presque tout est renommé et mis dans les bon dossiers
    [Assemblage upright wireframe.CATProduct, Front Left Wheel.CATProduct, Rear Left Wheel.CATProduct, S71910_CD_P4A.CATProduct, S71910_CD_P4A_PART1.CATPart, S71910_CD_P4A_PART2.CATPart, S71910_CD_P4A_PART3.CATPart, Symmetry of Rear Left Upright.CATPart]
2017-12-14 Push by Raphael
    [EN_0200_001_AA.CATPart, EN_0200_004_AA.CATPart, EN_0200_006_AA.CATPart, EN_0200_007_AA.1.CATPart, EN_0200_007_AA.2.CATPart, EN_0200_007_AA.3.CATPart, EN_0200_007_AA.4.CATPart, EN_0200_007_AA.CATProduct]
2017-12-14 nouveaux points dans esquisses tripod housing
    [D4483.CATPart, EN_1000_004_AA.CATPart, Symmetry of 4483 Polaris (20T).CATPart]
2017-12-14 ajout chape suspension
    [Front Left Wheel.CATProduct, Rear Left Wheel.CATProduct, ST_A0500.CATProduct, SU_A0200.CATProduct, SU_A0300 Upper Rear Left A-arms.CATProduct, SU_A0600.CATProduct, SU_A0700.CATProduct, SU_A0900.CATProduct]
2017-12-14 ajout entretoise
    [SU_0200_006.CATPart, SU_A0200.CATProduct]
2017-12-14 points de mesure
    [D4483.CATPart, Symmetry of 4483 Polaris (20T).CATPart]
2017-12-14 Là on a du sérieux niveau arbres de transmission !
    [EN_1000_001_AA.CATPart, EN_1000_002_AA.CATPart]
2017-12-15 legere modif chape triangle+symetrie
    [Symmetry of chape sus tri arr inf gauche arri inf.CATPart, Symmetry of chape sus tri arr inf gauche arri sup.CATPart, Symmetry of chape sus tri arr inf gauche avant inf.CATPart, Symmetry of chape sus tri arr inf gauche avant sup.CATPart, Symmetry of chape sus tri arr sup gauche arri inf.CATPart, Symmetry of chape sus tri arr sup gauche arri sup.CATPart, Symmetry of chape sus tri arr sup gauche av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]
2017-12-15 Chape fond plat
    [FR_0400_002_BA.CATPart, FR_0400_003_BA.CATPart, FR_0400_004_BA.CATPart, Frame_assy.CATProduct]
2017-12-15 Matériau chape fond plat
    [FR_0700_004_BA.CATPart, FR_0700_005_BA.CATPart, FR_0700_006_BA.CATPart, FR_0700_007_BA.CATPart, FR_A0300.CATProduct, Frame_assy.CATProduct, Symmetry of FR_0400_003_BA.CATPart, Symmetry of FR_0700_004_BA.CATPart]
2017-12-15 adaptation fond plat aux ouies
    [FR_0400_002_BA.CATPart, Frame_assy.CATProduct]
2017-12-15 fait chier
    [entretoise.CATPart]
2017-12-15 trous LAS dans carrosserie
    [FR_0700_002_BA.CATPart, FR_0700_003_BA.CATPart]
2017-12-15 Nettoyage des conneries de R**d*m
    [EL_A0300.CATProduct, Powertrain.CATProduct]
2017-12-15 Chape carrosserie (uniformisation)
    [FR_0700_006_BA.CATPart, FR_0700_007_BA.CATPart, FR_A0300.CATProduct, Frame_assy.CATProduct, Symmetry of FR_0700_006_BA.CATPart, Symmetry of FR_0700_007_BA.CATPart]
2017-12-15 modif symétrie nez carrosserie
    [FR_0700_000_CA.CATPart]
2017-12-15 dessin tech
    [entretoise.CATPart]
2017-12-15 Autocollants carrosserie
    [FR_0700_000_CA.CATPart, FR_A0700.CATProduct]
2017-12-15 Frame assy carrosserie
    [FR_A0700.CATProduct, Frame_assy.CATProduct]
2017-12-15 Règlage problème pièce perdue dans Vulcanix
    [EN_A0200.CATProduct, EN_A0300.CATProduct, EN_A0400.CATProduct, EN_A0800 - Cooling System.CATProduct, EN_A0900.CATProduct, EN_A1000.CATProduct, FR_A0600.CATProduct, Frame_assy.CATProduct]
2017-12-15 C'est la PLS la mise en plan
    [Front Left Wheel.CATProduct, SU_1000_001 (Front Left Upright).CATPart, SU_1000_002 (Upper Arm Wedge).CATPart, SU_1000_003 (Upper Arm Bracket).CATPart]
2017-12-15 Ouies et fond plat dépassant des roues rectifiés
    [FR_0400_002_BA.CATPart, FR_0700_001_CA.CATPart]
2017-12-15 ça avance tranquillement
    [Front Left Wheel.CATProduct, SU_1000_001 (Front Left Upright).CATPart, SU_1000_002 (Upper Arm Wedge).CATPart, SU_1000_003 (Upper Arm Bracket).CATPart]
2017-12-16 modif chape biellete arriere+biellete avant
    [Front Left Wheel.CATProduct, Rear Left Wheel.CATProduct, ST_A0500.CATProduct, SU_0600_004-chape.CATPart, SU_A0200.CATProduct, SU_A0300 Upper Rear Left A-arms.CATProduct, SU_A0600.CATProduct, SU_A0700.CATProduct]
2017-12-16 chape bielete sus avant, faut encore ajuster le placement
    [SU_0600_004-chape.CATPart, SU_0800_004-chape.CATPart, Symmetry of chape biellete sus avant inf.CATPart, Symmetry of chape biellete sus avant sup.CATPart, chape biellete avant inf.CATPart, chape biellete avant sup.CATPart, chassis + triangle.CATProduct]
2017-12-16 Modifs sur le nez, le critère d'émotion remonte à 2/10
    [FR_0700_000_CA.CATPart]
2017-12-16 Changement butée pédale d'accel : c'est pas top, ça sent le coup de perceuse brice
    [FR_0300_002_BA.CATPart, FR_A0300.CATProduct, ISO_4014_M6x60_STEEL_GRADE_A_HEXAGON_HEAD_BOLT.CATPart]
2017-12-16 modifs mineures
    [SU_1000_001 (Front Left Upright).CATPart]
2017-12-16 pédalier
    [FR_0300_018_BA.CATPart, FR_0300_027_BA.CATPart, FR_A0300.CATProduct]
2017-12-16 couleurs pédalier
    [FR_A0300.CATProduct]
2017-12-16 Faut bien taffer
    [Front Left Wheel.CATProduct, SU_1000_001 (Front Left Upright).CATPart, SU_1000_002 (Upper Arm Wedge).CATPart, SU_1000_003 (Upper Arm Bracket).CATPart, SU_1100_001 (Rear Upright).CATPart, WT_0200_001 (Front Hub).CATPart]
2017-12-17 Modifs entretoises roulements
    [7207_BE_2RZP.CATProduct, BR_0300_001 (Break Disc).CATPart, Front Bearing Washer.CATPart, Front Left Wheel.CATProduct, KM_7.CATPart, MB_7.CATPart, Rear Bearing Washer.CATPart, Rear Left Wheel.CATProduct]
2017-12-17 J'adore mettre les capteurs de vitesses :(
    [ISO_4762_M5x16_STEEL_HEXAGON_SOCKET_HEAD_CAP_SCREW.CATPart, ISO_7089_5x10_STEEL_GRADE_A_NORMAL_SERIES_PLAIN_WASHER.CATPart, ISO_8675_M10x1_STEEL_GRADE_C_HEXAGON_METRIC_FINE_THIN_NUT.CATPart, Locknut M5.CATPart, Rear Bearing Washer.CATPart, Rear Left Wheel.CATProduct, S71910_CD_P4A.CATProduct, SU_1100_001 (Rear Upright).CATPart]
2017-12-17 Placement side firewall (part1)
    [FRAME.CATPart, FR_A0300.CATProduct, Firewall - upper side.CATPart, Frame_assy.CATProduct, tubulaire.CATProduct]
2017-12-17 Ajout matériau
    [FR_0600_009_AA.CATPart]
2017-12-17 Ajustement épaisseur chape avant nez à 1,5mm
    [FR_0700_007_BA.CATPart]
2017-12-17 Placement side firewall (part2)
    [FRAME.CATPart, FR_A0300.CATProduct, Firewall - lower side.CATPart, Firewall - middle side.CATPart, Firewall - upper side.CATPart, Frame_assy.CATProduct, sleeve joint.CATPart, tubulaire.CATProduct]
2017-12-17 wow much brackets
    [Bracket Firewall.CATPart, FR_0200_001_MM.CATPart, FR_A0300.CATProduct, Frame_assy.CATProduct, Symmetry of FR_0700_007_BA.CATPart]
2017-12-17 Suppression pièce pédalier
    [FR_0300_019_BA.CATPart]
2017-12-17 Ajout chape té de répartition circuit de freinage
    [FR_0300_019_BA.CATPart, FR_0300_026_BA.CATPart, FR_A0300.CATProduct]
2017-12-17 chapes chapes chapes
    [FR_0700_004_BA.CATPart, FR_0700_005_BA.CATPart, FR_0700_006_BA.CATPart, FR_0700_007_BA.CATPart, FR_A0300.CATProduct, Firewall - lower side.CATPart, Frame_assy.CATProduct, baquet_taille_6.CATPart]
2017-12-17 TOUJOURS PLUS DE CHAPES
    [Frame_assy.CATProduct, baquet_taille_6.CATPart]
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2017-12-18 Commit commit
    [Rear Bearing Washer.CATPart]
2017-12-18 maj chape basculeur
    [Front Left Wheel.CATProduct, Rear Left Wheel.CATProduct, SU_0800_004-chape.CATPart, SU_1100_002 (Upper Arm Wedge).CATPart, SU_1100_003 (Upper Arm Bracket).CATPart, SU_A0200.CATProduct, SU_A0300 Upper Rear Left A-arms.CATProduct, SU_A0600.CATProduct]
2017-12-18 Problème
    [Rear Left Wheel.CATProduct, SU_1100_001 (Rear Upright).CATPart, SU_1100_002 (Upper Arm Wedge).CATPart, SU_1100_003 (Upper Arm Bracket).CATPart, Tripod housing spacer.CATPart, disque_capteur_arriere.CATPart]
2017-12-18 positionnement regulateur pression
    [EN_A0200.CATProduct, EN_A0300.CATProduct, EN_A0400.CATProduct, EN_A0800 - Cooling System.CATProduct, EN_A0900.CATProduct, EN_A1000.CATProduct, FR_A0600.CATProduct, Powertrain.CATProduct]
2017-12-18 positionement pompe essence
    [Chape_pompe_chassis.CATPart, EN_0500_002.CATProduct, EN_A0200.CATProduct, EN_A0300.CATProduct, EN_A0400.CATProduct, EN_A0800 - Cooling System.CATProduct, EN_A0900.CATProduct, EN_A1000.CATProduct]
2017-12-18 chape shifter
    [Chape_pompe_chassis.CATPart, FR_0600_009_AA.CATPart, FR_A0600.CATProduct, Powertrain.CATProduct, chape regulateur de pression2.CATPart]
2017-12-18 chape tdb
    [Compte-tour.CATProduct, ST_A0200.CATProduct, ST_A0600.CATProduct, ST_A0700_STEERING SHAFT PIVOT.CATProduct, Steering System assy.CATProduct, Support_tdb.CATPart, Tableau de bord.CATProduct, chape tdb bas.CATPart]
2017-12-18 fin des chapes tdb inchallah
    [Part168.CATPart, ST_A0200.CATProduct, ST_A0600.CATProduct, ST_A0700_STEERING SHAFT PIVOT.CATProduct, Steering System assy.CATProduct, Support_tdb.CATPart, Tableau de bord.CATProduct]
2017-12-18 Chapes harnais.
    [Oeillet.CATPart, chape superieure Harnais.CATPart, chape superieure.CATPart]
2017-12-18 je ne sais pas ce que je push
    [FRAME.CATPart, Produit5.CATProduct, Shape_563.CATPart, Shape_570.CATPart, Shape_572.CATPart, Shape_573.CATPart, Shape_578.CATPart, Shape_579.CATPart]
2017-12-18 Moi je Push pour Confiture
    [Shape_635.CATPart, Shape_637.CATPart, Shape_640.CATPart, Shape_641.CATPart]
2017-12-18 gueules de loup
    [FRAME.CATPart, Shape_660.CATPart, Shape_661.CATPart, Tubes.CATProduct, tubulaire.CATProduct]
2017-12-18 Modification tube.
    [ST_A0200.CATProduct, ST_A0600.CATProduct, ST_A0700_STEERING SHAFT PIVOT.CATProduct, Steering System assy.CATProduct, steering_tube_lateral.CATPart]
2017-12-18 Toujours plus de tubes de confiture
    [Shape_533.CATPart, Shape_535.CATPart, Shape_536.CATPart, Shape_537.CATPart, Shape_538.CATPart, Shape_539.CATPart, Shape_660.CATPart, Shape_661.CATPart]
2017-12-18 Ya plus d'boulot
    [Shape_551.CATPart, Shape_595.CATPart]
2017-12-18 Réservoir.
    [main.CATPart]
2017-12-18 MAJ gueules de loup
    [Produit2.CATProduct, Produit3.CATProduct, Produit4.CATProduct, Produit5.CATProduct, Shape_528.CATPart, Shape_533.CATPart, Shape_536.CATPart, Shape_538.CATPart]
2017-12-18 nouveau tdb
    [Produit2.CATProduct, ST_A0200.CATProduct, ST_A0600.CATProduct, ST_A0700_STEERING SHAFT PIVOT.CATProduct, Steering System assy.CATProduct, Support_tdb.CATPart, Tableau de bord.CATProduct, Tubes.CATProduct]
2017-12-18 Firewall en full sheet
    [firewall_sheet.CATPart]
2017-12-18 anti intrusion plate
    [FR_A0300.CATProduct, Frame_assy.CATProduct, anti intrusion plate.CATPart]
2017-12-18 Push de sécurité
    [firewall_sheet.CATPart]
2017-12-18 Petite larme à l'oeil alors que je m'apprete à pusher pour la dernière fois. J'ai passé de bons moment sur ce vieux github. Adieux
    [FR_A0300.CATProduct]
2017-12-18 Merde, cette fois c'est la dernière
    [FR_A0300.CATProduct]
2017-12-18 MAJ firewall
    [Chape Inferieure Appui-Tete.CATPart, Chape Superieure Appui-Tete.CATPart, FR_A0300.CATProduct, Firewall - lower side.CATPart, Firewall - middle side.CATPart, Firewall - upper side.CATPart, Frame_assy.CATProduct, sleeve joint.CATPart]
2017-12-18 maj chape basculeur avant
    [Front Left Wheel.CATProduct, Rear Left Wheel.CATProduct, ST_A0500.CATProduct, SU_0600_004-chape arr.CATPart, SU_0600_004-chape avant.CATPart, SU_A0200.CATProduct, SU_A0300 Upper Rear Left A-arms.CATProduct, SU_A0600.CATProduct]
2017-12-18 Je sais pas ce qu'il s'est passé
    [Rear Left Wheel.CATProduct, disque_capteur_arriere.CATPart]
2017-12-18 materiaux chapes+ collier silencieux
    [EN_0200_007_AA.CATProduct, EN_0200_008_AA.CATPart, EN_0200_009_AA- colier silencieux.CATPart, EN_0200_032_AA.CATProduct, EN_0200_033_AA.CATProduct, EN_0200_034_AA.CATProduct, EN_0200_051_AA.CATProduct, EN_0800_C01.CATPart]
2017-12-18 fin tdb
    [Produit1.CATProduct, Produit2.CATProduct, Produit3.CATProduct, ST_A0200.CATProduct, ST_A0600.CATProduct, ST_A0700_STEERING SHAFT PIVOT.CATProduct, Shape_531.CATPart, Shape_544.CATPart]
2017-12-18 Mise à jour contraintes, vous avez fait du sale les mec
    [FR_A0300.CATProduct, Firewall - lower side.CATPart, Frame_assy.CATProduct, Produit4.CATProduct, Shape_536.CATPart, Shape_539.CATPart, Shape_540.CATPart, Shape_556.CATPart]
2017-12-18 Mise à jour contraintes
    [Steering System assy.CATProduct]
2017-12-18 sauvetage de mort
    [Shape_528.CATPart, Shape_533.CATPart, Shape_536.CATPart, Shape_538.CATPart, Shape_539.CATPart, Shape_543.CATPart, Shape_544.CATPart, Shape_545.CATPart]
2017-12-18 pas le temps de niaiser
    [Shape_528.CATPart, Shape_533.CATPart, Shape_536.CATPart, Shape_538.CATPart, Shape_539.CATPart, Shape_543.CATPart, Shape_544.CATPart, Shape_545.CATPart]
2017-12-18 Rah faites chier
    [Front Left Wheel.CATProduct, Insert Triangle cote chassis v1.1.CATPart, Rear Left Wheel.CATProduct, ST_A0500.CATProduct, SU_0800_004-chape.CATPart, SU_A0200.CATProduct, SU_A0300 Upper Rear Left A-arms.CATProduct, SU_A0600.CATProduct]
2017-12-18 ble ble ble
    [Front Left Wheel.CATProduct, Produit40.CATProduct, Rear Left Wheel.CATProduct, ST_A0500.CATProduct, SU_0600_004-chape arr.CATPart, SU_0600_004-chape avant.CATPart, SU_0700_001.CATPart.CATProduct, SU_A0200.CATProduct]
2017-12-19 J'écrase tout
    [Produit2.CATProduct, Produit3.CATProduct, Produit4.CATProduct, Produit5.CATProduct, Shape_532.CATPart, Shape_536.CATPart, Shape_539.CATPart, Shape_540.CATPart]
2017-12-19 debut chape air intake
    [EN_0300_001_CB.CATPart, EN_A0200.CATProduct, EN_A0300.CATProduct, EN_A0400.CATProduct, EN_A0800 - Cooling System.CATProduct, EN_A0900.CATProduct, EN_A1000.CATProduct, FR_A0600.CATProduct]
2017-12-19 Passage en force
    [Shape_600.CATPart, Shape_601.CATPart, Shape_602.CATPart, Shape_604.CATPart, Shape_605.CATPart, Shape_606.CATPart, Shape_608.CATPart, Shape_609.CATPart]
2017-12-19 C'était n'imp' ce soir sur le git. Un peu de tenu svp. Des bisous <3
    [Produit3.CATProduct, Produit4.CATProduct, Produit5.CATProduct, Shape_548.CATPart, Shape_549.CATPart, Shape_550.CATPart, Shape_551.CATPart, Shape_553.CATPart]
2017-12-19 correction par brice
    [FR_A0300.CATProduct, Frame_assy.CATProduct, MS_A0300.CATProduct, Oeillet.CATPart, Symmetry of Chape Inferieure Harnais.CATPart, Symmetry of Oeillet.CATPart, Symmetry of chape superieure.CATPart, chape superieure Harnais.CATPart]
2017-12-19 Revert "Chapes du harnais push push"
    This reverts commit ee4951b4cdad1007befb421bebdbf32d485e20ed.
    [FR_A0300.CATProduct, Frame_assy.CATProduct, MS_A0300.CATProduct, Oeillet.CATPart, Symmetry of Chape Inferieure Harnais.CATPart, Symmetry of Oeillet.CATPart, Symmetry of chape superieure.CATPart, chape superieure Harnais.CATPart]
2017-12-19 Modifs admission + barettes fixation chassis
    [EN_0300_001_CB.CATPart, EN_0300_002_AA.CATPart, EN_0300_003_CB.CATPart, EN_0300_009_AA.CATPart, EN_A0300.CATProduct, HPC_-_CHC4-12_B_2_14.CATPart]
2017-12-19 Chapes harnais
    [Chape Inferieure Appui-Tete.CATPart, Chape Superieure Appui-Tete.CATPart, Frame_assy.CATProduct, MousseEpaules.CATPart, Symmetry of Chape Inferieure Harnais.CATPart, Symmetry of MousseEpaules.CATPart, Symmetry of chape superieure.CATPart]
2017-12-19 Chapes harnais 2
    [FR_A0300.CATProduct, Frame_assy.CATProduct, MousseEpaules.CATPart, MousseEpauleslongues.CATPart, Symmetry of MousseEpaules.CATPart, Symmetry of chape superieure.CATPart, chape superieure Harnais.CATPart]
2017-12-19 Mousses et oeillet appui-tête
    [FR_A0300.CATProduct, Frame_assy.CATProduct, MousseEpaules.CATPart, MousseEpauleslongues.CATPart, Symmetry of MousseEpaules.CATPart, Symmetry of Oeillet.CATPart]
2017-12-19 Modifs pipes d'admission
    [EN_0300_003_CB.CATPart, EN_0300_008_AA.CATPart, EN_0300_009_AA.CATPart, EN_A0300.CATProduct, Powertrain.CATProduct]
2017-12-19 Poignée d'embrayage colorée
    [FR_0500_001_AA.CATPart, FR_0500_002_AA.CATPart, FR_0500_005_AA.CATPart, FR_A0500.CATProduct, Frame_assy.CATProduct, ISO_4032_M6_STEEL_GRADE_A_HEXAGON_NUT.CATPart]
2017-12-19 chie fteur
    [FR_0600_007_BA.CATPart, FR_0600_008_BA.CATPart, FR_0600_009_AA.CATPart]
2017-12-19 chape admission + organization de qq contraintes pour lahm
    [Chape_pompe_chassis.CATPart, EN_0300_009_AA.CATPart, EN_A0200.CATProduct, EN_A0300.CATProduct, EN_A0400.CATProduct, EN_A0800 - Cooling System.CATProduct, EN_A0900.CATProduct, EN_A1000.CATProduct]
2017-12-19 visserie appui-tête
    [HPC_-_FHC8-16_SS_B_2_14.CATPart, MS_0300_002_BA.CATPart, MS_A0300.CATProduct, _HPC - FHC8-16_SS_B.1.2.CATPart, _HPC - FHC8-16_SS_B.1.CATPart]
2017-12-19 replacement chape support bocaux frein
    [FR_A0300.CATProduct]
2017-12-19 chapes propres
    [EN_0800_04 - Silentblock Bottom.CATPart, EN_0800_C01.CATPart, EN_0800_C02.CATPart, EN_0800_C03.CATPart, EN_0800_C04.CATPart, EN_A0800 - Cooling System.CATProduct]
2017-12-19 Ya pleins de tubes
    [Shape_579.CATPart, Shape_580.CATPart, Shape_582.CATPart, Shape_583.CATPart, Shape_584.CATPart, Shape_585.CATPart, Shape_587.CATPart, Shape_588.CATPart]
2017-12-19 Epaisseur de mousse
    [Mousse roll bar padding.CATPart]
2017-12-19 Modif firewall
    [Firewall.CATPart]
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2017-12-19 position brake light plus propre+contraintes
    [Frame_assy.CATProduct]
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2017-12-19 Le bon merge des familles (ajout vis dans chainset)
    [EN_A1100.CATProduct, ISO_4014_M10x45_STEEL_GRADE_A_HEXAGON_HEAD_BOLT.CATPart, ISO_8675_M10x1_STEEL_GRADE_C_HEXAGON_METRIC_FINE_THIN_NUT.CATPart]
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2017-12-19 Vis dans differential assy
    [EN_A0900.CATProduct, ISO 4762 SCREW M8x25 STEEL HEXAGON SOCKET HEAD CAP.1.CATPart, ISO_4034_M8_STEEL_GRADE_C_HEXAGON_HEAD_NUT.CATPart, ISO_4762_M8x30_STEEL_HEXAGON_SOCKET_HEAD_CAP_SCREW.CATPart, ecrou_M8_nilstop.CATPart, rondelle_M8.CATPart]
2017-12-19 prudence est mère de sureté
    [Shape_545.CATPart]
2017-12-19 Modifs pour passage boulons
    [Admission complete.CATProduct, EN_0300_001_CB.CATPart, EN_A0300.CATProduct, EN_A0600.CATProduct]
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2017-12-19 modif support batterie, chapes et positionement
    [EL_A0200.CATProduct, EL_A0200_002_AA.CATPart, EL_A0200_003_AA.CATPart, Frame_assy.CATProduct, bracket_rear_battery.CATPart]
2017-12-19 chape tableau de bord
    [ST_A0200.CATProduct, ST_A0600.CATProduct, ST_A0700_STEERING SHAFT PIVOT.CATProduct, Steering System assy.CATProduct, Tableau de bord.CATProduct, bracket_rear_battery.CATPart, chape tdb bas.CATPart, chape tdb haut.CATPart]
2017-12-19 on y est presque
    [EL_0300_001_AA.CATPart, EN_0200_008_AA.CATPart, EN_0500_004.CATProduct, EN_A0200.CATProduct, EN_A0300.CATProduct, EN_A0400.CATProduct, EN_A0800 - Cooling System.CATProduct, EN_A0900.CATProduct]
2017-12-19 tdb compte tour je vais casser le git
    [Steering System assy.CATProduct, Support_tdb.CATPart, Tableau de bord.CATProduct]
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2017-12-19 encore modifs epaisseurs pour standardiser
    [Chape Inferieure Appui-Tete.CATPart, Chape Superieure Appui-Tete.CATPart, EN_1100_006_AA.CATPart, EN_1100_007_AA.CATPart, air intake bracket.CATPart]
2017-12-19 ajustement de contraites et epaisseur de chape
    [Frame_assy.CATProduct, bracket_rear_battery.CATPart]
2017-12-19 faut bien consommer les 20 litres au 100
    [Dessous_propre.CATPart, EN_A0400.CATProduct]
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2017-12-20 Support latéral pédale d'accel
    [FR_0300_010_BA.CATPart, FR_A0300.CATProduct]
2017-12-20 Chape support té de répartition pédalier
    [FR_0300_019_BA.CATPart, FR_0300_026_BA.CATPart, FR_A0300.CATProduct]
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2017-12-20 modif master switch assy
    [EL_0600_002.CATPart]
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2017-12-20 Encore plus de boîtes
    [EL-40115-PDB.STEP, EL_0100_004.CATPart, EL_0100_004.IGS, EL_0700_001.CATPart, EL_0700_002.CATPart, EL_A0700.CATProduct]
2017-12-20 Changement de la boîte motored. J'espère que je casse pas tout
    [EL_A0300.CATProduct, EN_A0200.CATProduct, EN_A0300.CATProduct, EN_A0400.CATProduct, EN_A0800 - Cooling System.CATProduct, EN_A0900.CATProduct, EN_A1000.CATProduct, FR_A0600.CATProduct]
2017-12-20 ajout igs Porte excentrique
    [porte excentrique droit.igs, porte excentrique gauche.igs]
2017-12-21 Push de la mort
    [FRAME_prod.CATPart, Produit1.CATProduct, Produit10.CATProduct, Produit2.CATProduct, Produit3.CATProduct, Produit4.CATProduct, Produit5.CATProduct, Produit6.CATProduct]
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2017-12-21 Tube 942, manque un côté (gros noeud)
    [Shape_942.CATPart]
2017-12-21 Shape 943 (manque côté gros noeud)
    [Shape_943.CATPart]
2017-12-21 GDL Shape 958 (autre coté)
    [Shape_958.CATPart]
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2017-12-21 Ajout du master switch assy
    [EL_0600_002.CATPart, EL_A0600.CATProduct, EN_A0200.CATProduct, EN_A0300.CATProduct, EN_A0400.CATProduct, EN_A0800 - Cooling System.CATProduct, EN_A0900.CATProduct, EN_A1000.CATProduct]
2017-12-21 Revert "Ajout du master switch assy"
    This reverts commit 51043e424e26759250a5f3c35f1f0909f40c976c.
    [EL_0600_002.CATPart, EL_A0600.CATProduct, EN_A0200.CATProduct, EN_A0300.CATProduct, EN_A0400.CATProduct, EN_A0800 - Cooling System.CATProduct, EN_A0900.CATProduct, EN_A1000.CATProduct]
2017-12-21 Gueule de loups infâme -> shape 952
    [Shape_952.CATPart]
2017-12-21 Je force le master switch
    [EL_0600_002.CATPart, EL_A0600.CATProduct, Powertrain.CATProduct]
2017-12-21 La 953 est bonne
    [Shape_953.CATPart]
2017-12-21 Rectif 953 et perfect 954
    [Shape_953.CATPart, Shape_954.CATPart]
2017-12-21 Shape_936 - PAS FAIT LE NOEUD DE LA MORT
    [Shape_936.CATPart]
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2017-12-21 Shape_937 - SAUF LE NOEUD DE LA MORT
    [Shape_937.CATPart]
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2017-12-21 Ajout vis dans differential assy
    [EN_A0900.CATProduct]
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2017-12-21 Shape 974 et 976
    [Shape_974.CATPart, Shape_976.CATPart]
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2017-12-21 vous abusez les push
    [EN_A0400.CATProduct, main.CATPart, triangle_plie.CATPart]
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2017-12-21 Shape 974 975 976 977 (croix du fond)
    [Shape_974.CATPart, Shape_975.CATPart, Shape_976.CATPart, Shape_977.CATPart]
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2017-12-21 nouveaux tubes support moteur
    [Shape_970.CATPart, Shape_971.CATPart, Shape_972.CATPart]
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2017-12-21 Push noeuds avant suspensions
    [Shape_919.CATPart, Shape_922.CATPart, Shape_924.CATPart]
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2017-12-21 VOUS N'ETES PAS PRETS
    [840.stp, 850.stp, 862.stp, 896.stp, 897.stp, 899.stp, 900.stp, 901.stp]
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2017-12-21 toujours plus de stp
    [911_1.stp, 913.stp, 916.stp]
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2017-12-22 correction 948
    [Shape_948.CATPart]
2017-12-22 946 : doit retirer la petite merde qui pend
    [Shape_946.CATPart]
2017-12-22 correction 984 petite merde aussi - vérification de tous les stp déposés jusqu'à maintenant - stp 948 - ce nom de commit est beaucoup trop long
    [948.stp, Shape_984.CATPart]
2017-12-22 push stp - pas de petite merde sur 946 (?)
    [946.stp, 955.stp, 977.stp, 981.stp, 983.stp]
2017-12-22 correction 946
    [946.stp, Shape_946.CATPart]
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2017-12-22 correction 916 + stp
    [916.stp, 917_1.stp, Shape_916.CATPart]
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2017-12-22 modif gueules de loup
    [Shape_940.CATPart, Shape_949.CATPart, Shape_951.CATPart]
2017-12-22 suppression tube en trop
    [Produit6.CATProduct, Shape_912.CATPart, Shape_913.CATPart, Shape_914.CATPart, Shape_915.CATPart, Shape_992.CATPart, Shape_993.CATPart, Shape_994.CATPart]
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2017-12-22 Revert "symétrie"
    This reverts commit 16d5d4b8ba8239b924a85d32803b0d1572924e18.
    [tubulaire_prod.CATProduct]
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2017-12-23 nouveaux step et modif 920
    [101.stp, 102.stp, 103.stp, 104.stp, 105.stp, 106.stp, 107.stp, 108.stp]
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2017-12-23 more and more stp
    [34.stp, 35.stp, 36.stp, 37.stp, 38.stp, 39.stp, 40.stp, 41.stp]
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2017-12-23 Push Push Push le réservoir
    [main.CATPart]
2017-12-23 Changement de la masse de la batterie (hyper important) et détail de l'élec
    [EL_0300_003_AA.CATPart, EL_0300_004_AA.CATPart, EL_0300_005_AA.CATPart, EL_A0200_001_AA.CATPart, EL_A0300.CATProduct]
2017-12-23 Alors comme ça Touze veut du M4 ? bah voila
    [91290A193_BLACK-OXIDE CLASS 12.9 SOCKET HEAD CAP SCREW.CATPart, 94645A101_ZINC-PLATED CLASS 10 STL NYLON-INSERT LOCKNUT.CATPart, Front Left Wheel.CATProduct, ISO_7089_4x9_STEEL_GRADE_A_NORMAL_SERIES_PLAIN_WASHER.CATPart, SU_1000_001 (Front Left Upright).CATPart, SU_1000_002 (Upper Arm Wedge).CATPart, SU_1000_003 (Upper Arm Bracket).CATPart]
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2017-12-23 les step sont presque fini
    [201.stp]
2017-12-24 Petites modifs des familles
    [Front Left Wheel.CATProduct, ISO_4017_M6x40_STEEL_GRADE_A_HEX_HEAD_SCREW.CATPart, ISO_4762_M4x16_STEEL_HEXAGON_SOCKET_HEAD_CAP_SCREW.CATPart, Rear Left Wheel.CATProduct, SU_1000_001 (Front Left Upright).CATPart, SU_1000_002 (Upper Arm Wedge).CATPart, SU_1000_003 (Upper Arm Bracket).CATPart, SU_1100_001 (Rear Upright).CATPart]
2017-12-24 Je suis vraiment pas convaincu par ce ****** de montage de capteur de vitesse avant
    [Front Left Wheel.CATProduct, Front Speed Sensor Bracket.CATPart]
2017-12-25 Joyeux noel les enfants
    [SU_1000_001 (Front Left Upright).CATPart]
2017-12-25 ça attaque la mise en plan
    [WT_0200_001 (Front Hub).CATPart]
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2017-12-26 ce putain de front hoop est enfin finit
    [202.stp, FRAME_prod.CATPart, dessin pour definition front hoop.CATProduct, front hoop.CATPart]
2017-12-27 déplacement des tubes en step
    [1.stp, 10.stp, 101.stp, 102.stp, 103.stp, 104.stp, 105.stp, 106.stp]
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2017-12-27 modif longueur en plus
    [FRAME_prod.CATPart, Shape_991.CATPart, dessin pour definition front hoop.CATProduct, front hoop.CATPart]
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2017-12-28 Grosse update MEP PM avant presque terminé
    [SU_1000_001 (Front Left Upright).CATPart]
2017-12-28 MAJ trous de passage
    [SU_1000_004 (Brake Caliper Spacer).CATPart]
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2017-12-31 Correction de mes erreurs --'
    [Assy.CATProduct, Body.CATPart, Front Left Upright.CATPart, Front Left Wheel.CATProduct, Front Lower A Arm.CATPart, Front Upper A Arm.CATPart, GE_8_C.CATProduct, GE_8_Cblr_001_101_spb_ge1.CATPart]
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2017-12-31 Vous n'avez rien vu.
    [1554H Box.CATPart, 1554H-T GASKET.CATPart, 1554H-T Lid.CATPart, EL_0300_001.CATProduct, EL_A0300.CATProduct, IN-M4 (insert M4-0.7X5.75mm SS).CATPart, IN100 (insert M3-0.5X5.75mm BRASS).CATPart, SC576 (screw M4-0.7X 20mm PN).CATPart]
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2017-12-31 Ajout de la boîte du tableau de bord
    Placement pifométrique. Vous trouvez pas qu'elle est un peu grosse cette boîte ?
    [EL_A0700.CATProduct, Powertrain.CATProduct]
2018-01-04 MISE EN PLAN - ST_07001
    [ST_07001_STEERING UPPER SHAFT.CATPart]
2018-01-04 MISE EN PLAN - ST_07002
    [ST_A0700_STEERING SHAFT PIVOT.CATProduct, SU_07002_STEERING BORE.CATPart]
2018-01-04 SU_1000_001-Verif-CBN => C'est pour toi Arthur !
    [ST_A0700_STEERING SHAFT PIVOT.CATProduct]
2018-01-05 Maudit soit le règlement et son crash sensor
    J'essaie un autre truc pour fixer le crash sensor
    [Frame_assy.CATProduct, MS_A0300.CATProduct]
2018-01-05 chape power distribuition box, ça part
    [EN_A0200.CATProduct, EN_A0300.CATProduct, EN_A0400.CATProduct, EN_A0800 - Cooling System.CATProduct, EN_A0900.CATProduct, EN_A1000.CATProduct, FR_A0600.CATProduct, Powertrain.CATProduct]
2018-01-06 Enfin le capteur propre pour GTI ;)
    [Front Left Wheel.CATProduct, Front Speed Sensor Bracket.CATPart, disque_capteur_avant.CATPart]
2018-01-06 Pratique le wifi dans les TGV
    [Brake caliper spacer.CATPart, Rear Left Wheel.CATProduct, Tripod housing spacer.CATPart, disque_capteur_arriere.CATPart]
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2018-01-07 Push la fat mise en plan
    [SU_1100_001 (Rear Upright).CATPart]
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2018-01-09 crash sensor sor sor sor
    [EL_A0200.CATProduct, EL_A0200_001_AA.CATPart, FR_A0300.CATProduct, Frame_assy.CATProduct, Powertrain.CATProduct, bracket_Crash_Sensor.CATPart, bracket_master_switch.CATPart]
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2018-01-09 Création du dossier de l'ancien différentiel EN_0900_001_AB
    [Achskegelrad Formula Student 2008 - 2009-oa3.CATPart, Achskegelrad Formula Student 2008 - 2009.CATPart, Anlaufscheilbe 001-oa7.CATPart, Anlaufscheilbe 001.CATPart, Aussenlamelle 001 2010-oa4.CATPart, Aussenlamelle 001 2010-oa5.CATPart, Aussenlamelle 001 2010-oa6.CATPart, Aussenlamelle 001 2010.CATPart]
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2018-01-09 suppression du DGL ajustable dans les dossier Github
    [400-040-0096-00 Quadring3,68.CATPart, 400-090-0006-00 Druckfeder0,5x4x6,5.CATPart, 900-050-11013-00 GewindestiftM4.CATPart, DRX00001546.CATPart, DRX00002057.CATPart, DRX00002066.CATPart, DSD-100-900-0007-00_ZYLINDERSCHRAUBE_DIN4762_M6x14.CATPart, DSD-100-900-0011-00_SCHEIBE_DIN7092_6-300.CATPart]
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2018-01-09 DIvers fuck les chapes jpp
    [01- Colling system back.igs, 02- admission- air intake bracket.igs, 11 - bracket_master_switch.igs, 13 - bocaux equipe de frein.igs, 14- T de repartition (freinage).igs, 23- appui de tete sup.igs, Chape Superieure Appui-Tete.CATPart, EN_0800_C04.CATPart]
2018-01-09 mise en plan oklm
    [SU_0700_003.CATPart]
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2018-01-09 Pour Confiture - La Bise
    [201 (Main Hoop).DXF, 201 (Main Hoop).SLDASM, 201 (Main Hoop).sldprt]
2018-01-09 Revert "Pour Confiture"
    This reverts commit 6fe4b2a38a8ef8d55434576f7e8ce4a87a47aefe.
    [201 (Main Hoop).DXF, 201 (Main Hoop).SLDASM, 201 (Main Hoop).sldprt]
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2018-01-09 MAJ + ajout élargisseurs Mg/Al
    [Front Left Wheel.CATProduct, Rear Left Wheel.CATProduct, WT_0200_003 (Front Wheel Spacer).CATPart, WT_0200_003_Al (Front Wheel Spacer for Al Rim).CATPart, WT_0200_003_Mg (Front Wheel Spacer for Mg Rim).CATPart, WT_0300_001 (Rear Hub).CATPart, WT_0300_003 (Rear Wheel Spacer).CATPart, WT_0300_003_Al (Rear Wheel Spacer for Al Rim).CATPart]
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2018-01-10 igs + dossiers organisation
    [Bracket 16- Nez avant.igs, Bracket 17- Nez arriere.igs, Bracket 18- Ouie avant.igs, Bracket 19- Ouie arriere.igs]
2018-01-10 crash sensor pls GTI
    [bracket_Crash_Sensor.CATPart]
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2018-01-10 MEP chape poignée d'embrayage
    [18B_Bracket_304.igs]
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2018-01-10 bracket crash sensor alleluia GTI c pour toi <3
    [EL_0100_002.CATPart, FR_0400_002_BA.CATPart, FR_A0300.CATProduct, Frame_assy.CATProduct, bracket_Crash_Sensor.CATPart]
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2018-01-10 FAIT CHIER LE RESERVOIR
    [Dessous_propre.CATPart, main.CATPart]
2018-01-10 Apprend à faire du sheetmetal design Lahm !
    [main.CATPart]
2018-01-11 méplat sur tie rod
    [SU_0900_002.CATPart]
2018-01-11 MISE EN PLAN MAIN HOOP POUR CDO
    [201 (Main Hoop).SLDDRW, 201 (Main Hoop).SLDPRT]
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2018-01-11 reservoir de mes couilles
    [EN_A0400.CATProduct, main.CATPart]
2018-01-11 essaie pour la mache
    [ins_avant_gauche_double.igs]
2018-01-12 Mais, vous savez, moi je ne crois pas qu'il y ait de bonne ou de mauvaise situation. Moi, si je devais résumer ma vie aujourd'hui avec vous, je dirais que c'est d'abord des rencontres, Des gens qui m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
    [Bracket Firewall low tube.CATPart, Frame_assy.CATProduct, Shape_538.CATPart, Shape_574.CATPart, Symmetry of Bracket firewall low tube.CATPart, Symmetry of Chape Inferieure Harnais.CATPart, Symmetry of Firewall Bracket 1.CATPart, Symmetry of Firewall Bracket 2.CATPart]
2018-01-12 Tu t'es beaucoup trop chauffé Benjamin !
    [Catchcan 2.CATPart, EN_A0200.CATProduct, EN_A0300.CATProduct, EN_A0400.CATProduct, EN_A0800 - Cooling System.CATProduct, EN_A0900.CATProduct, Powertrain.CATProduct, engine et carter.CATProduct]
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2018-01-14 derniere modif crash sensor bracket
    [Bracket 21- Firewall.igs, Bracket 6- Crash Sensor.igs, bracket_Crash_Sensor.CATPart]
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2018-01-15 Lahm il est serrein sur sa M4
    [SU_1000_001 (Front Left Upright).CATPart]
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2018-01-16 Mise en plan chappe de suspension
    [SU_0700_003.CATPart]
2018-01-16 chapes de 1,5 - beacoup
    [Bracket 10- master_switch.igs, Bracket 11 - bracket_master_switch.igs, Bracket 11- Firewall.igs, Bracket 116- Pompe vers tubulaire.igs, Bracket 12- Firewall appui tete.igs, Bracket 4- break_light.igs, Bracket 5- battery.igs, Bracket 8- chape tdb haut.igs]
2018-01-16 Comment Lahm il s'est fait calmé par le directeur !
    [SU_1000_001 (Front Left Upright).CATPart]
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2018-01-17 tdb mise en place
    [Steering System assy.CATProduct, Support_tdb.CATPart, Tableau de bord.CATProduct]
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2018-01-17 Mise en plan chain shiel sup
    [Bracket 106- Chain shield sup.igs, EN_1100_006_AA.CATPart]
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2018-01-18 Pour Confiture Mise en plan 201-202 Biseau
    [201 biseau.SLDPRT, 202 biseau.SLDPRT]
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2018-01-20 Disque capteur vitesse bon pour l'arrière
    [Rear Left Wheel.CATProduct, SU_1100_002 (Upper Arm Wedge).CATPart, SU_1100_003 (Upper Arm Bracket).CATPart, disque_capteur_arriere.CATPart]
2018-01-23 chape las + retour Mache
    [chape sus tri avant inf gauche arr sup.CATPart, chape sus tri avant sup gauche arr inf.CATPart, chassis + triangle.CATProduct]
2018-01-29 MAJ PM arrière pour usinage cannelures
    [Rear Left Wheel.CATProduct, WT_0300_001 (Rear Hub).CATPart]
2018-01-29 pression regulator et moteur
    [Bracket_201_Moteur.igs, EN_0100_002_AA.CATPart, chape pour drawing.CATPart, chape regulateur de pression2.CATPart]
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2018-01-30 modif support master switch
    [EL_0600_002.CATPart]
2018-01-30 correction master switch
    [EL_0600_002.CATPart, EL_A0600.CATProduct]
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2018-01-30 mise en plan frame
    [FRAME_prod.CATPart, Shape_1024.CATPart, Shape_1025.CATPart, Shape_1064.CATPart, dessin pour definition front hoop.CATProduct]
2018-01-30 Mise en plan main
    [main hoop.CATPart]
2018-01-31 Chape direction avec congés.
    [ST_0600_001_unique.CATPart]
2018-01-31 Mise en plan Firewall
    [Firewall up.CATPart]
2018-01-31 Plan chape speed sensor avant
    [Front Left Wheel.CATProduct, Front Speed Sensor Bracket.CATPart, SU_1000_002 (Upper Arm Wedge).CATPart, SU_1000_003 (Upper Arm Bracket).CATPart, SU_1000_005 (Front Speed Sensor Bracket).CATPart]
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2018-01-31 correction mache (non terminé)
    [Bracket 8- chape tdb haut.igs, Bracket 9- chape tdb bas.igs, chape tdb bas.CATPart, chape tdb haut.CATPart]
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2018-01-31 Modif firewall pour guillaume
    [Firewall Bracket 6.CATPart, Firewall bottom.CATPart]
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2018-01-31 encore des chapes de las
    [EN_0100_003_AA.CATPart, chape sus tri avant inf gauche arr sup.CATPart]
2018-01-31 chape capteur de vitesse
    [SU_1000_005 (Front Speed Sensor Bracket).CATPart]
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2018-01-31 Mise en plan lattéral châssis
    [Shape_1023.CATPart, Shape_1034.CATPart, Shape_1035.CATPart, Shape_1059.CATPart, Shape_1060.CATPart, Shape_1061.CATPart, Shape_1062.CATPart, Shape_1080.CATPart]
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2018-02-01 ajout chainshield version sheet metal
    [EN_1100_005 sheet.CATPart]
2018-02-01 Modif trous de passage
    [Chape_propre 1.CATPart, Chape_propre 2.CATPart, EN_A0400.CATProduct, main.CATPart]
2018-02-01 Suppression des collisions dans les inserts de triangles.
    [Insert Triangle cote chassis v1.1.CATPart, Insert Triangle cote chassis v2.CATPart, SU_A0100.CATProduct, SU_A0200.CATProduct, SU_A0300 Upper Rear Left A-arms.CATProduct, SU_A0400.CATProduct, triangle inferieur arriere 1.CATPart, triangle inferieur arriere 2.CATPart]
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2018-02-06 cache chaine 2 mm + MEP porte exc gauche
    [EN_1100_005 sheet.CATPart]
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2018-02-06 Plan infinis de chapes
    [chape sus tri avant inf gauche arr sup.CATPart, chape sus tri avant sup gauche arr inf.CATPart, chape sus tri avant sup gauche arr sup.CATPart, chape sus tri avant sup gauche avant inf.CATPart, chape sus tri avant sup gauche avant sup.CATPart, chassis + triangle.CATProduct]
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2018-02-06 inchallah ça fait pas la merde
    [filaire_triangle.CATProduct, wireframe_arms.CATPart]
2018-02-06 Exemple gabarit de LAS
    [arret_tube_longi.CATPart, entretoise.CATPart, montage gabari test.CATProduct, tige.CATPart, triangle.CATPart]
2018-02-07 modif disque 1mm arrière
    [Rear Left Wheel.CATProduct, WT_0300_005 (Tripod Housing Spacer).CATPart, WT_0300_005 (Tripod Housing Spacer).igs, WT_0300_006 (Rear Speed Sensor Disc).CATPart]
2018-02-07 Cache crémaillère fini !
    [94645A101_ZINC-PLATED CLASS 10 STL NYLON-INSERT LOCKNUT.CATPart, Chape_cache_cremaillere.CATPart, ISO_4017_M6x40_STEEL_GRADE_A_HEX_HEAD_SCREW.CATPart, ISO_4762_M4x16_STEEL_HEXAGON_SOCKET_HEAD_CAP_SCREW.CATPart, ISO_4762_M8x40_STEEL_HEXAGON_SOCKET_HEAD_CAP_SCREW.CATPart, ISO_7089_4x9_STEEL_GRADE_A_NORMAL_SERIES_PLAIN_WASHER.CATPart, ISO_7089_4x9_STEEL_GRADE_A_NORMAL_SERIES_PLAIN_WASHER_New_678.CAT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]
2018-02-07 Petite modif pour tableau synthethique
    [FR_0700_001.CATPart, FR_0700_002.CATPart, FR_A0700.CATProduct, Front Left Wheel.CATProduct, Rear Left Wheel.CATProduct, ST_A0500.CATProduct, SU_1000_002 (Upper Arm Wedge).CATPart, SU_1000_003 (Upper Arm Bracket).CATPart]
2018-02-07 modif mep PE + modif géométrie chainshield
    [EN_1100_005 sheet changement diam.CATPart]
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2018-02-07 Placement un peu meilleur du boitier avant
    [EL_A0700.CATProduct, Powertrain.CATProduct]
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2018-02-07 Adrien : Chainshield easy à plier
    [EN_1100_005 sheet changement diam.CATPart]
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2018-02-07 Mise en plan elements admission
    [Admission complete.CATProduct, Boite à air.stp, Boulon attache moteur.CATProduct, Boulon attaches chassis-plenum 1.CATProduct, Boulon fond plenum.CATProduct, Capteur.CATPart, EN_0300_0012_AA.CATPart, EN_0300_0012_AB.CATPart]
2018-02-07 plan plan et IGS
    [SU_1100_002_add (Upper Arm Wedge add alu).igs, SU_1100_002_add (Upper Arm Wedge add).CATPart, SU_1100_002_add (Upper Arm Wedge add).igs]
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2018-02-08 Add files via upload
    reparation tubes 30x1.5
    [1.stp, 101.stp, 102.stp, 103.stp, 106.stp, 111.stp, 119.stp, 2.stp]
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2018-02-08 nouveau tube 37 sans merde
    [37.stp, Shape_943.CATPart, tubulaire_prod.CATProduct]
2018-02-08 le push avec 300000000000000 de tubes
    [1.stp, 10.stp, 101.stp, 102.stp, 103.stp, 104.stp, 105.stp, 106.stp]
2018-02-09 Modif mise en plan + igs chapes 3 mm
    [Bracket 101- Power distribution box.igs, Bracket 104- Differential assy tube sup.igs, Bracket 106- Chain shield.igs, Bracket 107- Cooling system up.igs, Bracket 108- Cooling system down.igs, Bracket 109- Expansion tank.igs, Bracket 110- Regulateur de pression.igs, Bracket 111- Pedalier tube avant.igs]
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2018-02-10 Verif plan + igs
    [Bracket_104_differential assy tube sup.igs, Bracket_107_cooling system up.igs, Bracket_110_ Regulateur de pression.igs, Bracket_113_Pedalier support gaine.igs, Bracket_114_Siege dessous.igs, Bracket_115_Siege arriere.igs, Bracket_116_Pompe vers tubulaire_1.igs, Bracket_118_Shifter.igs]
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2018-02-10 Sleeve joint après correction APU
    [sleeve joint.CATPart]
2018-02-11 Correction plans frettes de freins
    [Front Left Wheel.CATProduct, Rear Left Wheel.CATProduct, WT_0200_007 (Front Brake Hub).CATPart, WT_0200_007 (Front Break Hub).CATPart, WT_0300_007 (Rear Brake Hub).CATPart, WT_0300_007 (Rear Break Hub).CATPart]
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2018-02-11 nouvelle chappe de LAS
    [Symmetry of chape sus tri arr inf gauche arri inf.CATPart, Symmetry of chape sus tri arr inf gauche avant inf.CATPart, Symmetry of chape sus tri arr inf gauche avant sup.CATPart, Symmetry of chape sus tri avant sup gauche arr inf.CATPart, Symmetry of chape sus tri avant sup gauche arr sup.CATPart, chape sus tri avant inf gauche arr inf.CATPart, chape sus tri avant inf gauche arr sup.CATPart, chap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]
2018-02-12 suspension assy qui fonctionne
    [SU_A0100.CATProduct, SU_A0200.CATProduct, SU_A0300 Upper Rear Left A-arms.CATProduct, SU_A0700.CATProduct, SU_A1400.CATProduct, SU_A1500.CATProduct, Suspension Assy.CATProduct, chassis + triangle.CATProduct]
2018-02-12 Maj Admission, logos plenum et capteur
    [ARRK.CATPart, ARRK.CATProduct, Admission complete.CATProduct, Capteur.CATPart, EN_0300_0012_AB.CATPart, EN_0300_002_BA.CATPart, EN_0300_003_DA.CATPart, EN_0300_009_AA.CATPart]
2018-02-12 j'en ai raz le bol
    [SU_0100_007 (Avant Sup Avant Inf).igs, SU_0100_008 (Avant Sup Avant Sup).igs, SU_0200_007.igs, SU_0200_008 (Avant Inf Avant Sup).igs, SU_0200_009 (Avant inf Arriere Inf).igs, SU_0200_010 (Avant inf Arriere Sup).igs, chape sus tri avant inf gauche arr inf.CATPart, chape sus tri avant inf gauche arr sup.CATPart]
2018-02-12 foutu plan de merde
    [SU_0100_009 (Avant Sup Arriere Inf).igs, SU_0100_010 (Avant Sup Arriere Sup).igs, SU_0400_007 (Arriere Inf Avant Inf).igs, SU_0400_008 (Arriere Inf Avant Sup).igs, SU_0400_009 (Arriere Inf Arriere Inf).igs, chape sus tri arr inf gauche arri inf.CATPart, chape sus tri arr inf gauche avant sup.CATPart, chape sus tri avant sup gauche arr inf.CATPart]
2018-02-12 encore de la merdasse
    [SU_0300_010 (Arriere Sup Arriere Sup).igs, SU_0400_010 (Arriere Inf Arriere Sup).igs, chape sus tri arr inf gauche arri sup.CATPart, chape sus tri arr sup gauche arri sup.CATPart]
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2018-02-13 début correction Mep porte-exc + vérif dimension chainshield sur le Part
    [EN_1100_005 sheet changement diam.CATPart]
2018-02-13 fuck les plans+ MAJ xape adrien
    [Bracket_106_Chain shield sup.igs, Bracket_119_chain shield inf.igs, EN_1100_006_AA.CATPart, EN_1100_007_AA.CATPart, Symmetry of chape sus tri avant inf gauche avant sup2.CATPart]
2018-02-13 Verif avant envoi ARRK
    [EN_0300_006_AA.CATPart, EN_A0300.CATProduct]
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2018-02-14 Mise en plan pour soudure chapes + pushbar
    [SQU30x2.CATPart, Shape_01.CATPart, Shape_02.CATPart, Shape_03.CATPart, Shape_04.CATPart, Shape_05.CATPart, Shape_06.CATPart, Shape_07.CATPart]
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2018-02-14 un autre push de la mort
    [Bracket_104_differential assy tube sup.igs, Bracket_105_differential assy tube inf.igs, Bracket_106_Chain shield sup.igs, Bracket_107_cooling system up.igs, Bracket_108_cooling system_pliee.igs, Bracket_110_ Regulateur de pression.igs, Bracket_111_Pedalier tube avant.igs, Bracket_112_Pedalier tube arriere.igs]
2018-02-15 petit détail chainshield (diamètre trous de passage)
    [EN_1100_005 sheet changement diam.CATPart]
2018-02-15 MEP Chainshield (à vérifier)
    [EN_1100_005 le vrai.CATPart, EN_1100_005 sheet changement diam.CATPart, EN_1100_005 sheet.CATPart]
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2018-02-15 Bon ok ça part en BE
    [Symmetry of chape sus tri arr inf gauche avant sup.CATPart]
2018-02-16 Gabarit de suspension avant + cache crémaillère légèrement modifié
    [Encoche_arrondie.CATPart, Encoche_arrondie_et_arret.CATPart, arret_trans_sus.CATPart, cache_cremaillere.CATPart, gabarit_support_SU_avant.CATProduct, renfort.CATPart]
2018-02-18 Cachez ces contraintes que je ne saurai voir
    Réparation des conneries faites par les mecs qui bossent sur le réservoir
    [EL_A0300.CATProduct, EN_0500_002.CATProduct, EN_0500_003.CATProduct, EN_A0200.CATProduct, EN_A0300.CATProduct, EN_A0400.CATProduct, EN_A0800 - Cooling System.CATProduct, EN_A0900.CATProduct]
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2018-02-18 plan B triangles acier
    [Wireframe_Front_Upper_Arm.CATPart, Wireframe_Rear_Lower_Arm.CATPart, Wireframe_Rear_Upper_Arm.CATPart, chape_arriere.CATPart, filaire et tube.CATProduct]
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2018-02-21 Toujours plus de connecteurs, carte avant
    [EL_0700_003.CATPart, EL_A0700.CATProduct]
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2018-02-27 Mashallah c'est pas chibré
    [Dessous_propre.CATPart, main.CATPart]
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2018-02-27 Congets de mes couilles.
    [Dessous_propre.CATPart, EN_A0400.CATProduct, main.CATPart, triangle_plie.CATPart]
2018-02-27 Gabarit de direction de Nicolas
    [Gabrait_soudure_direction.CATProduct, plaque_avant.CATPart, plaque_droite.CATPart, plaque_gauche.CATPart, plaque_intermediaire.CATPart, plaque_intermediaire_bis.CATPart, plaque_volant.CATPart]
2018-02-27 Gabarit las avant inf.
    [Triangle_front_down.CATPart, arret_tube_longi.CATPart, gabarit_LAS_front_down.CATProduct]
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2018-02-28 La LAS auto est opérationnelle sur GIT
    [Front_Lower_A_Arm_Front_Rod.CATPart, Front_Lower_A_Arm_Rear_Rod.CATPart, Front_Push_Rod.CATPart, Front_Rocker.CATPart, Front_Upper_A_Arm_Front_Rod.CATPart, Front_Upper_A_Arm_Rear_Rod.CATPart, Rear_Lower_A_Arm_Front_Rod.CATPart, Rear_Lower_A_Arm_Rear_Rod.CATPart]
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2018-02-28 MAJ Powertrain : positionnement final des chapes du chainshield
    [EN_A0200.CATProduct, EN_A0300.CATProduct, EN_A0400.CATProduct, EN_A0900.CATProduct, FR_A0600.CATProduct, Powertrain.CATProduct, engine et carter.CATProduct, transmission secondaire.CATProduct]
2018-02-28 simplification géométrie Chainshield + MEP finale
    [EN_1100_005 le vrai.CATPart, EN_A0200.CATProduct, EN_A0300.CATProduct, EN_A0400.CATProduct, EN_A0900.CATProduct, EN_A1100.CATProduct, FR_A0600.CATProduct, Powertrain.CATProduct]
2018-02-28 Correction MEP Porte-excentriques
    [EN_0900_006_AB.CATPart]
2018-03-02 test de reboot de la mort
    [Dessous_propre.CATPart, EL_A0300.CATProduct, EL_A0700.CATProduct, EN_0500_002.CATProduct, EN_0500_003.CATProduct, EN_0900_006_AB.CATPart, EN_1100_005 le vrai.CATPart, EN_A0200.CATProduct]
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2018-03-03 correction de mes erreurs
    [Dessous_propre.CATPart, EL_A0300.CATProduct, EL_A0700.CATProduct, EN_0500_002.CATProduct, EN_0500_003.CATProduct, EN_0900_006_AB.CATPart, EN_1100_005 le vrai.CATPart, EN_A0200.CATProduct]
2018-03-05 Placement du Master Switch
    [EL_0600_001.CATPart, EL_0600_002.CATPart, EL_0600_003.CATPart, EL_A0600.CATProduct, EN_A0200.CATProduct, EN_A0300.CATProduct, EN_A0400.CATProduct, EN_A0800 - Cooling System.CATProduct]
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2018-03-05 Placement de la nouvelle master switch
    [Powertrain.CATProduct]
2018-03-05 update des igs
    voila on teste le githud desktop
    [SU_0100_011 (Avant Sup Avant InfD).igs, SU_0100_012 (Avant Sup Avant SupD).igs, SU_0100_013 (Avant Sup Arriere InfD).igs, SU_0100_014 (Avant Sup Arriere SupD).igs, SU_0200_011 (Avant Inf Avant InfD).igs, SU_0200_012 (Avant Inf Avant SupD).igs, SU_0200_013 (Avant inf Arriere InfD).igs, SU_0200_014 (Avant inf Arriere SupD).igs]
2018-03-05 Rereplacement du master switch
    [Powertrain.CATProduct]
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2018-03-06 chapes Reservoir
    MEP e igs
    [Bracket_22_fuel tank L.igs, Bracket_23_fuel tank Rear L.igs, Bracket_24_fuel tank Rear R.igs, Bracket_25_fuel tank R.igs, Chape_propre 1.CATPart, Chape_propre 2.CATPart, Chape_propre 3.CATPart]
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2018-03-06 chapes divers
    mep igs et la mere de naldo
    [18B_Bracket_304.igs, Chape_propre 4.CATPart]
2018-03-06 chapes
    igs plan, cash cremailliere
    [Bracket_26_Cash Cremailliere.igs, Bracket_302_Tube fixation moteur.igs, EN_0100_003_AA.CATPart, FR_0700_002.CATPart, bracket_boitier_carte_haut.CATPart]
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2018-03-07 Ajout Carter dhuile
    Ajout Carter d'huile
    [Carter_Vfinale.CATProduct, Carter_huile_en_tole.CATProduct, Carter_plie.CATPart, Cloison anti degaugeage plus maintien crepine.CATPart, Cloison_Courte_carter.CATPart, Cloison_Courte_carter_taraudee.CATPart, Cloison_Inferieure_carter.CATPart, Cloison_Longue_carter.CATPart]
2018-03-07 MEP - Tank a gas
    [Dessous_propre.CATPart, Dessous_propre.igs, triangle_plie.igs]
2018-03-07 Vulcanix Finale Carter
    Mise a jour carter
    [Cloison_Courte_carter.igs, Cloison_Courte_carter_taraudee.CATPart, Cloison_Courte_carter_taraudee.igs, Cloison_Inferieure_carter.CATPart, Cloison_Inferieure_carter.igs, Cloison_Longue_carter.CATPart, Cloison_Longue_carter.igs, EN_A0400.CATProduct]
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2018-03-07 Gabarits de ses morts
    [Front Left Wheel.CATProduct, GE_8_Cblr_001_101_spb_ge1.CATPart, GE_8_Cblr_001_101_spb_ge2.CATPart, Insert Triangle cote chassis v1.1.CATPart, Plaque_dessus.CATPart, Rear Left Wheel.CATProduct, S71910_CD_P4A_PART1.CATPart, S71910_CD_P4A_PART2.CATPart]
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2018-03-07 plans alu à souder cooling
    [EN_0800_06 - Expansion Tank.CATPart, Expansion Tank Bracket.igs, Fond Expansion Tank.igs, Radiateur Bracket.igs]
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2018-03-08 MIP gabarits de LAS
    [FR_A0700.CATProduct, Front Left Wheel.CATProduct, GE_8_Cblr_001_101_spb_ge1.CATPart, GE_8_Cblr_001_101_spb_ge2.CATPart, Insert Triangle cote chassis v1.1.CATPart, Rear Left Wheel.CATProduct, SA_8_E.CATPart, ST_A0500.CATProduct]
2018-03-08 Ahah tu t'arrètes jamais !
    [Front Left Wheel.CATProduct, Rear Left Wheel.CATProduct, SA_8_E.CATPart, ST_A0500.CATProduct, SU_A0100.CATProduct, SU_A0200.CATProduct, SU_A0300 Upper Rear Left A-arms.CATProduct, SU_A0600.CATProduct]
2018-03-09 Correction erreur Su Assy
    [Front Left Wheel.CATProduct, Rear Left Wheel.CATProduct, ST_A0500.CATProduct, SU_0700_001.CATPart.CATProduct, SU_A0100.CATProduct, SU_A0200.CATProduct, SU_A0300 Upper Rear Left A-arms.CATProduct, SU_A0600.CATProduct]
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2018-03-10 Mep insert PM avant inf + modif largeur insert
    [insert avant inferieur double.CATPart]
2018-03-10 Mep Inset PM avant haut
    [ins_avant_gauche_double.CATPart]
2018-03-10 Mep insert avant haut 2
    [ins_avant_gauche_double.CATPart]
2018-03-10 Cartouche + modif insert sup arr PM
    [insertion.CATPart]
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2018-03-11 new triangles avant sup
    [Insert Triangle cote chassis v1.1.CATPart, SU_A0100.CATProduct, ins_avant_gauche_double.CATPart, tube avant triangle sup 2.CATPart, tube avant triangle sup.CATPart]
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2018-03-11 correction d'erreur
    [SU_A0100.CATProduct, WT_0200_007 (Front Brake Hub).igs, WT_0300_007 (Rear Brake Hub).igs, ins_avant_gauche_double.CATPart, tube avant triangle sup 2.CATPart]
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2018-03-12 Départ Prod tube fixation moteur
    [18B_FR_0100_002_AC (Sleeve Joint).igs]
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2018-03-12 Modif insert rear up
    [insertion.CATPart]
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2018-03-12 Chapes sa mere
    c presque fini
    [Bracket_27_Boitier carte avant.igs, EN_0200_007_AA.CATProduct, EN_0200_031_AA.CATProduct, EN_0200_032_AA.CATProduct, EN_0200_033_AA.CATProduct, EN_0200_034_AA.CATProduct, EN_0200_051_AA.CATProduct, EN_0200_052_AA.CATProduct]
2018-03-13 nomenclature kit de montage
    [nomenclature_kit_de_montage.xlsx]
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2018-03-14 Rectifications support de master switch
    [EL_0600_002.CATPart, EL_A0600.CATProduct]
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2018-03-15 bracekt basculeur avant
    brah
    [SU_0600_004-chape arr.CATPart, SU_0600_004-chape avant.CATPart]
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2018-03-18 Aux grands maux les grands remèdes
    [Bouton poussoir Raz motored.CATPart, Bouton poussoir demarrage.CATPart, Bouton poussoir.CATPart, CIRCLIP M30.CATPart, FRAME.CATPart, HPC - CARDAN.CATProduct, ISO_4014_M6x50_STEEL_GRADE_A_HEXAGON_HEAD_BOLT.CATPart, ISO_4762_M6x35_STEEL_HEXAGON_SOCKET_HEAD_CAP_SCREW.CATPart]
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2018-03-19 Almost done XAP
    voila quoi
    [SU_0600_006 (Front bell cranck avantD).igs, SU_0600_006-chape arrD.CATPart, SU_0600_007 (Front bell cranck avantD).igs, SU_0600_007-chape avantD.CATPart, Symmetry of chape biellete sus avant inf.CATPart, Symmetry of chape biellete sus avant sup.CATPart]
2018-03-20 envoie chaine shield roulé
    [EN_1100_005 roule.igs]
2018-03-20 ajustement position chapes sur maquette Powertrain
    [EN_A0200.CATProduct, EN_A0300.CATProduct, EN_A0400.CATProduct, EN_A0900.CATProduct, FR_A0600.CATProduct, Powertrain.CATProduct, engine et carter.CATProduct, transmission secondaire.CATProduct]
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2018-03-21 ajout trou pour les cartes élec
    [Support_tdb.CATPart]
2018-03-21 test svg pour Bob
    [gab_h_plaque.CATPart, part1.CATPart]
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2018-03-22 Auto stash before merge of "master" and "origin/master"
    [WT_0300_007 (Rear Brake Hub).igs]
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2018-03-25 Gabarit de manchon de direction fini
    [PCMF_081007_5_E.CATPart, ST_A0600.CATProduct, ST_A0700_STEERING SHAFT PIVOT.CATProduct, SU_A0800.CATProduct, Steering System assy.CATProduct, Tableau de bord.CATProduct, arret_glob.CATPart, arret_longi.CATPart]
2018-03-26 new plan la mache
    [entretoise_8x6.CATPart, insert_M6.CATPart]
2018-03-26 Révision contraintes Transmission secondaire
    [EN_A0900.CATProduct, EN_A1000.CATProduct, EN_A1100.CATProduct, transmission secondaire.CATProduct]
2018-03-26 gabarits chapes + révision position chapes
    [EN_1100_005 le vrai.CATPart, EN_A0200.CATProduct, EN_A0300.CATProduct, EN_A0400.CATProduct, EN_A0900.CATProduct, EN_A1000.CATProduct, EN_A1100.CATProduct, FR_A0600.CATProduct]
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2018-03-26 more gabarit (+jacking bar)
    [EN_A0900_avec_gabarit_chapes.CATProduct, gab_jack.CATProduct, gab_jack_d.CATPart, gab_jack_d_test.CATPart, gab_jack_g.CATPart, gab_jack_g_test.CATPart, separateur_gab_jack.CATPart]
2018-03-26 Je suis le seul con à faire mon cost.. ?
    [FR_A0300.xlsx]
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2018-03-27 copie du cost dans SU_A0100
    [cost_SU_A0100.xlsx]
2018-03-27 Go cost assy 1
    [EL_A0001.xlsx]
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2018-03-27 COST DRIVETRAIN : 30%
    [cost_drivetrain.xlsx]
2018-03-27 Une belle merde ce pédalier
    [FR_A0300.xlsx]
2018-03-27 COST DRIVETRAIN : A0900 fini (33%)
    [cost_drivetrain.xlsx]
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2018-03-27 Cost fond plat : Très bon choix l'aluminium par rapport au carbone
    [FR_A0300.xlsx, FR_A0400.xlsx]
2018-03-27 COST DRIVETRAIN : début A_1000 (Driveshaft ) --> Process tripod housing à revoir
    [cost_drivetrain.xlsx]
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2018-03-28 COST DRIVETRAIN : 60% (revoir axles) + reste Chain set
    [cost_drivetrain.xlsx]
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2018-03-29 Plans utilisés pour l'usinage pour la postérité
    [Face 1 Gros contours avec coordonnées usinage.SLDPRT, Porte moyeu arrière avec esquisse contours.SLDPRT, Porte moyeu avant usinage.SLDPRT, Porte moyeux arrière filaire avec coordonnées usinage.SLDPRT, SU_1100_001 (Rear Upright).SLDPRT, cotesXY_usinage.xlsx]
2018-03-29 Comment je visite les tréfonds de CATIA avec ce projet ...
    [Suspension_Wireframe.CATProduct]
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2018-03-31 COST DRIVETRAIN : on y croit !
    [cost_drivetrain.xlsx]
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2018-03-31 COST DRIVETRAIN : Differential Assy + Driveshaft Assy terminés (reste Chain Set)
    [cost_drivetrain.xlsx]
2018-04-01 COST DRIVETRAIN : 100%
    [cost_drivetrain.xlsx]
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2018-04-02 COST DRIVETRAIN : correction remarques CME
    [cost_drivetrain.xlsx]
2018-04-03 N truc de chapes mais normalement c les derniers
    LALALALA
    [SU_0600_004 (Front bell cranck arr).igs, SU_0600_004-chape arr.CATPart, SU_0600_004-chape avant.CATPart, SU_0600_005 (Front bell cranck avant).igs, SU_0600_006 (Front bell cranck avantD).igs, SU_0600_006-chape arrD.CATPart, SU_0600_007 (Front bell cranck avantD).igs, SU_0600_007-chape avantD.CATPart]
2018-04-03 Gabarit chapes basculeur arrière
    [gab_basc_ar.CATProduct, maintient.CATPart, tube_ar.CATPart]
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2018-04-12 C'est ok lahm normalement
    [Front_Lower_A_Arm_Front_Rod.CATPart, Front_Lower_A_Arm_Rear_Rod.CATPart, Front_Push_Rod.CATPart, Front_Rocker.CATPart, Front_Upper_A_Arm_Front_Rod.CATPart, Front_Upper_A_Arm_Rear_Rod.CATPart, LAS_auto.xls, Left_Wireframe_Front_Lower_Arm.CATPart]
2018-04-12 Déchibrage de l'espace temps
    [Front_Lower_A_Arm_Front_Rod.CATPart, Front_Lower_A_Arm_Rear_Rod.CATPart, Front_Push_Rod.CATPart, Front_Rocker.CATPart, Front_Upper_A_Arm_Front_Rod.CATPart, Front_Upper_A_Arm_Rear_Rod.CATPart, LAS_auto.xls, Left_Wireframe_Front_Lower_Arm.CATPart]
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2018-04-25 Cost MS au complet [ne pas modifier !!]
    [Cost_MS.xlsx]
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2018-04-26 Cost ESR admission + throttle
    [EN_A0300.xlsx, EN_A0400.xlsx]
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2018-04-26 COST EN (pas terminé - ne pas modifier)
    [Cost_EN.xlsx]
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2018-04-29 Cost MS corrigé par CME et PAT
    [Cost_MS_cor_CME_et_PAT.xlsx]
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2018-04-29 Cost JLE corrigé par RMT
    [ST_A0300_cor_RMT.xlsx]
2018-04-29 Cost EN modifié (c'est pour toi Emilien ;) )
    [Cost_EN_v2.xlsx]
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2018-04-29 La fin approche !
    [Bon_cost_steering.xlsx]
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2018-04-30 Il m'entraine...au bout de la nuit....le...cost de minuit !
    [SU_A0800.xlsx]
2018-04-30 Gabarits arbres de transmission
    [Gab_axe_L.CATProduct, Gab_axe_R.CATProduct, gab_axe_L.CATPart, gab_axe_R.CATPart]
2018-04-30 Cost report EN_A001 and EN_A005
    Cost report engine (not finished) and fuel tank (finished)
    [EN_A0100.xlsx, EN_A0500.xlsx]
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2018-04-30 Cost Engine
    Modifs cost
    [EN_A0100.xlsx, EN_A0500.xlsx]
2018-04-30 Presque fini... Juste couleurs à changer
    Reste couleur à changer
    [EN_A0100.xlsx, EN_A0500.xlsx, EN_A0600.xlsx]
2018-04-30 Fin cost EN_A001, EN_A005 et EN_A006
    Modif couleurs pour coller au template
    [EN_A0100.xlsx, EN_A0500.xlsx]
2018-04-30 Cost catch can
    Omg
    [EN_A0700.xlsx]
2018-04-30 Cost direction fini à 2 pièces près
    [Bon_cost_steering.xlsx]
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2018-05-01 Merci pour ce moment <3 (Cost des suspensions fini)
    [SU_A1400.xlsx, SU_A1500.xlsx]
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2018-05-01 MAJ finale Cost Admission
    [Cost_EN_v2.xlsx]
2018-05-01 Cost Julien sur SU
    [cost_SU_A0100.xlsx, cost_SU_A0200.xlsx, cost_SU_A0300.xlsx, cost_SU_A0400.xlsx]
2018-05-01 Cost JLE corrigé VERSION v2
    [ST_A0300_cor_RMT_v2.xlsx]
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2018-05-02 Le cost avance un peu...
    [EL_A0001.xlsx]
2018-05-02 Cost FR avec images (cor RMT)
    [Cost_FR.xlsx]
2018-05-02 Avec plans inserts. Reedom : images déjà compressé
    [cost_SU_A0100.xlsx, cost_SU_A0200.xlsx, cost_SU_A0300.xlsx, cost_SU_A0400.xlsx]
2018-05-02 Ajout des images de Benji
    [Cost_MS_cor_CME_et_PAT.xlsx]
2018-05-02 Cost moyeu avant et roue
    [WT A0100 (Wheel Assembly).xlsx, WT A0200 (Front Hub Assembly).xlsx]
2018-05-02 Cost WT [pas terminé] → il manque WT_A0300 !
    [Cost_WT.xlsx]
2018-05-03 Ajout EN_A0100→reste à ajouter EN_A0500 à EN_A0800
    [Cost_EN_v2.xlsx]
2018-05-03 Jtravaille sur cost SU donc n'allez pas dessus
    Cost mamene
    [Cost_SU_PasTerminé.xlsx, cost_SU_A0100.xlsx]
2018-05-03 COST Su de mes couilles
    [cost_SU_A0100.xlsx]
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2018-05-03 Cost_SU...
    Merci Lazure pour le travail
    [Cost_SU_PasTerminé.xlsx]
2018-05-03 Cost FR totalement terminé
    [Cost_FR_cor_CME.xlsx]
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2018-05-03 Cost FR terminé- external et internal spacer suppr
    [Cost_FR_cor_CME.xlsx]
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2018-05-03 Cost BR cor RMT
    [Cost_BR.xlsx]
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2018-05-03 Cost EN fini cor RMT
    [Cost_EN_v2.xlsx]
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2018-05-04 Cost SU pas terminé
    [Cost_SU_PasTerminé.xlsx]
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2018-05-04 Cost SU jusqu'à 7
    [SU_A0500.xlsx, SU_A0600.xlsx]
2018-05-04 Cost_SU jusquà assy 9
    [SU_A0800.xlsx, SU_A1400.xlsx]
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2018-05-04 Cost BR complètement fini (cor CME et liens ok)
    [Cost_BR_CME.xlsx]
2018-05-04 Cost EN fini (cor CME + qtité process 2 EN81 cor)
    [Cost_EN_v2_CME.xlsx]
2018-05-04 Su + steering (en cours)
    [Cost_steering_le_bon_ABR avec noms.xlsx]
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2018-05-04 Assemblage break + travail wheels
    [Cost_BR_CME.xlsx, Cost_WT.xlsx]
2018-05-04 Cost global + wheel
    [Cost_WT.xlsx]
2018-05-04 Cost EL fini - cor RMT
    [Cost_EL.xlsx]
2018-05-04 Cost steering final avec liens refaits (RMT)
    [Cost_steering_le_bon_ABR avec noms.xlsx]
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2018-05-04 Cost WT fini - cor RMT et ABR
    [Cost_WT_v2.xlsx]
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2018-05-04 BOM officiellement envoyée à la compèt
    [081_EcoleCentraleDeLyon_FSAEI_CR_BOM.xlsx]
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2018-05-08 Le retour de la LAS auto
    [Rear_Rocker.CATPart, Rear_Upper_A_Arm_Front_Rod.CATPart, Steering_column.CATPart, Suspension_Frame_points.CATPart, Suspension_Wireframe.CATProduct, Wireframe_Rear_Upper_Arm.CATPart, steering_box.CATPart, steering_spline.CATPart]
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2018-05-12 Mise à jour arbres de transmission. Plans et maquette CATIA
    [D4630.CATPart, EN_1000_001_AA.CATPart, EN_1000_002_AA.CATPart, EN_A1000.CATProduct]
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2018-05-24 Pare feu sa mere
    [FR_A0300.CATProduct, Firewall Bottom back.CATPart, Firewall Middle horizontal back.CATPart, Firewall bottom.CATPart, Frame_assy.CATProduct, MS_A0300.CATProduct]
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2018-05-28 Qui ose sacager le GIT ?
    [FR_A0300.CATProduct, Firewall Bottom back.igs, Firewall Bottom left side.igs, Firewall Middle back.CATPart, Firewall Middle back.igs, Firewall Middle horizontal back.igs, Firewall Middle left side.igs, Firewall Top left side.igs]
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2018-05-29 Resolution probleme double fond plat
    [EN_A0200.CATProduct, EN_A0300.CATProduct, EN_A0400.CATProduct, EN_A0900.CATProduct, EN_A1000.CATProduct, EN_A1100.CATProduct, FR_A0300.CATProduct, FR_A0600.CATProduct]
2018-05-29 Résolution probleme carrosserie double
    [EN_A0200.CATProduct, EN_A0300.CATProduct, EN_A0400.CATProduct, EN_A0900.CATProduct, EN_A1000.CATProduct, EN_A1100.CATProduct, FR_0700_000_CA.CATPart, FR_0700_001_CA.CATPart]
2018-05-29 recallage arbres pour les vues
    [EN_1000_004_AA.CATPart, EN_A0900.CATProduct, EN_A1000.CATProduct, EN_A1100.CATProduct, Powertrain.CATProduct, transmission secondaire.CATProduct]
2018-05-29 Pare feu raccord tube
    [FR_A0300.CATProduct, Firewall BackTube.CATPart, Firewall BackTube.igs, Frame_assy.CATProduct, MS_A0300.CATProduct]
2018-05-29 Ok position chapes chainshield sur Vulcanix
    [EN_A0900.CATProduct, EN_A1000.CATProduct, EN_A1100.CATProduct, Powertrain.CATProduct, transmission secondaire.CATProduct]
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2018-05-29 replacement des led du tdb
    [Tableau de bord.CATProduct]
2018-05-30 renoie prod pare fue
    [Firewall Bottom left side.CATPart, Firewall Bottom left side.igs, Firewall Bottom side.igs, Firewall Middle back.CATPart, Firewall Middle back.igs, Firewall Middle left side.CATPart, Firewall Middle left side.igs, Firewall Middle side.igs]
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2018-06-03 Les repères jaunes ça dégage et la direction est presque droite
    [EN_A0200.CATProduct, EN_A0300.CATProduct, EN_A0400.CATProduct, EN_A0900.CATProduct, EN_A1100.CATProduct, FR_A0300.CATProduct, FR_A0600.CATProduct, Frame_assy.CATProduct]
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2018-06-23 Elle est enfin la !
    [CIR.CATPart, CIR_roue.CATPart, Ground.CATPart, Point.CATPart, Suspension_Frame_points.CATPart, Suspension_Wireframe.CATProduct, Suspension_Wireframe_Ground.CATProduct]
2018-06-24 Voila enfin les courbes
    [Bump.xlsx, Ground.CATPart, Left_Wireframe_Front_Upright.CATPart, Left_Wireframe_Front_Wheel.CATPart, Roll.xlsx, Steering.xlsx, Suspension_Wireframe.CATProduct, Wireframe_Front_Wheel.CATPart]
2018-06-25 correction des erreurs
    [Firewall BackTube plie.igs, Firewall BackTube.CATPart, cache_cremaillere.CATPart, cache_cremaillere_grand.CATPart, cache_cremaillere_grand_plie.igs, cache_cremaillere_plie.igs]
2018-06-26 arduino dans boite avant
    [1554H-T Lid.CATPart, EL_0300_002_AA.CATPart, EL_0700_002.CATPart, EL_0700_003.CATPart, EL_A0700.CATProduct]
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2018-08-14 Ajout courbes test traction
    [Specimen_RawData_1.csv, Specimen_RawData_10.csv, Specimen_RawData_1prime.csv, Specimen_RawData_2.csv, Specimen_RawData_2prime.csv, Specimen_RawData_3.csv, Specimen_RawData_3prime.csv, Specimen_RawData_4.csv]
2018-08-15 Check list voiture essais
    [Check_liste_voiture.xlsx]
2018-08-21 Test cinématiques ARB pour Optimus
    [ARB_ASSY.CATProduct, ARB_rod.CATPart, Basculeur.CATPart, FRONT ARB ROD ASSY.CATProduct, Insert Triangle cote chassis v1.1.CATPart, Insert Triangle cote chassis v2.CATPart, MR_calculation.xlsx, Piece1.12.CATPart]
2018-12-16 le retour de vulcanix
    [EN_A0200.CATProduct, FRAME.CATPart, FR_0700_000_CA.CATPart, FR_A0700.CATProduct, Frame_assy.CATProduct, Front Left Wheel.CATProduct, Part165.CATPart, Powertrain.CATProduct]
